czy0126/CZY/hardware/dcx_mech/placement_top.png

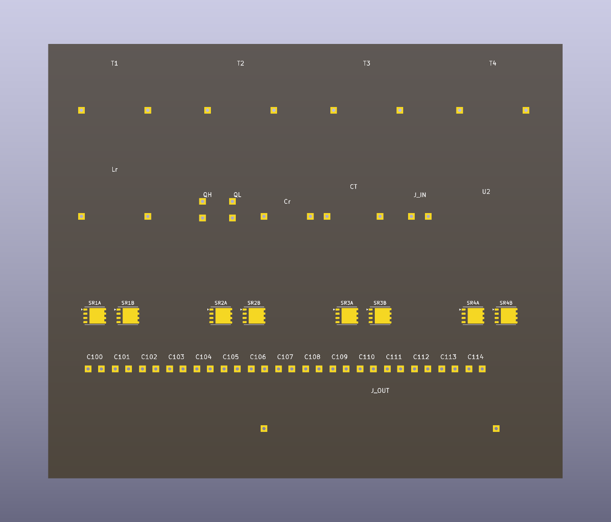
hardware/dcx_mech/placement_top.png
