czy0126/CZY/docs/D1_EXECUTION_KIT/README.md

# D1 可执行工程参考包（更新至 2026-11-05）

**对象**：CZY 48 V→约 2 V、24:1 LLC-DCX、100/120 A 高输出实验样机。**设计取舍（2026-11-04更新）**：成本不设上限；D1首样100A级/总高目标≤16mm，D2 120A级/≤16mm，原≤10mm目标转D3优化；器件SOA、绝缘、保护、制造和证据可信度不放松。

> 本目录是工作指南与可填写模板，不是新一轮同义审核。基准 main@79eee331fa5848ebad91e9712e180345d5f57814。现有 83 逻辑位号、61 个占位位号、五磁件物理脚号/DOT 待签、原生 GUI ERC 与有网络的主 PCB 缺失；制造闸门 NOT_FOR_FAB。仿真不是硬件连续额定。

## 2026-11-05 D0 新增保护原理图实物封装与模拟安全复核

[33 原生保护验证板封装、低电流钳位与十路门极检测评审](33_D0原生保护验证板复核与停工准则.md)：直接修复TL431LP在KiCad生成器、原生原理图、BOM与netlist中的TO-92/SOT-23封装不一致；新增 `tools/test_d0_oem_package_mapping.py` 回归。`tools/d0_analog_preflight.py --require-qualified` 对已知门极SUM残压漏检、BZX84C3V0低电流Zener标称不适用、快速通道灵敏度及模拟时序进行**量化否决**。ERC全绿不等于实物电气过关；D0仍无真正PCB，D1仍NOT_FOR_FAB。

## 五磁件24物理端子供应商回件自动检查（新增工具）

[30 磁件真实端子/DOT/厂图回件校验](30_磁件24端子回件自动审核.md)：新增 `tools/magnetic_vendor_map_audit.py`、可生成的24行完整回件模板、重复/漏报焊盘与极性反例测试；强制保留原生CAD已有黄金网与模型DOT，不得用逻辑端子名代替厂家实体脚号。报告绑定回件与合同的 SHA-256（`input_sha256` / `contract.sha256`），**合同一改旧报告即失效，必须重跑**；审核前还会从原生黄金网表与极性记录重建合同，`golden_net`/`polarity` 对不上即拒绝（`INVALID_PACKET`），报告另存 `contract_sources` 供复核。**自动校验永不等于实际焊盘/CT相位签核或投板许可。**

## D0 十路真实波形采集与自动验收（新增工具）

[29 D0 十路门极同步波形证据验收](29_D0十路门极同步波形证据验收.md)：新增 `tools/d0_gate_capture_audit.py`（严格12列、10路VGS独立检查、采样分辨率、故障后保持/再导通、限值和仪器证据、SHA-256报告），以及错误波形回归测试、待填写限值和列头模板。**只验证输入CSV的数字波形，不证明波形源自实物；制造闸门与器件SOA不会自动升级。** 直接支持 [Issue #36](https://github.com/czy0126/CZY/issues/36) 后续台架工作。

[31 D0 多仪器同步对齐与重采样](31_D0多仪器同步对齐与重采样.md)：新增 `tools/d0_scope_sync_align.py`，把多台示波器的记录按各自触发沿搬到共同时间轴，强制重采样网格不细于最粗原始间隔、不外推、不猜测时轴偏差，输出第29章可直接消费的12列CSV。**只检查声明的同步预算是否被采样分辨率支持；物理同时性、探头skew与波形来源仍为 false。** 模板见 [d0_scope_sync_manifest_TEMPLATE.json](templates/d0_scope_sync_manifest_TEMPLATE.json)。

[32 D0 采集证据链绑定](32_D0采集证据链绑定.md)：新增 `tools/d0_evidence_chain.py`，校验对齐报告、12列CSV、限值配置与门极审计报告确为同一次采集：逐项比对 SHA-256 与 `case_id`，复核网格是否满足审计分辨率/前窗/后窗，检查触发阈值与原点样点不落入迟滞带，并用同一 CSV+配置**重新运行审计**要求提交报告逐项可复现。**链一致不等于波形真实、不等于物理同时性，也不等于硬件通过；`CHAIN_CONSISTENT_AUDIT_REJECTED` 是物理发现而非工具故障。**

## 2026-11-04 本轮程序修补与 D0 实物交付

[28 十路保护引脚/网络反例回归、阶段审批闸门与文献驱动的实物计划](28_保护映射复核与下一轮真实交付.md)：修复交换 SR 缓冲通道、复用输出网、错误芯片管脚及分阶段制造批准伪通过；附可执行的 D0 控制板、ELP38/43 询样、原生 PCB 与100A阶梯实测的验收卡。**这是自动化审计增强，并非硬件已完成。**

## 2026-11-04 活跃阶段目标与不重复阻塞决策

[27 分阶段目标、16mm磁件路线与止损](27_分阶段目标_磁件宽高替代与止损.md)：D0十路控制保护，D1 48V/100A级/≤16mm，D2 120A级/≤16mm，D3 ≤10mm薄型优化。ELP38裸芯最大12.35mm，三匝保守B初筛0.232T，剩余3.65mm**不等于完整装配合格**。Bage配对已运行满320µs，停止反复数值扫参，转到实际保护与磁件询样；制造仍NOT_FOR_FAB。

## 2026-11-04 B组2fF软轨配对首次跑满320µs

[26 2fF软轨配对跑满320µs与v3_3逐位比对](26_B组2fF软轨配对跑满320us与逐位比对.md)：控制与候选都保存320µs、故障前均值差0.000000mV；0–220µs七项指标对v3_3逐位相同，候选在220–320µs仍逐位相同、控制首个差异在228.884µs。候选1.8V比较器早触发29.6725µs，Ipri峰−54.78%、SR正向峰−54.37%、I²t−95.44%。**四条判据中三条满足，独立器件SOA审查未完成，整体不通过，仍NOT_FOR_FAB。**

## 2026-11-03 自动生成的61位号原生CAD ECO施工表

[14 原生CAD操作与封装替换任务](14_原生CAD逐位号ECO执行表.md) · [61位号ECO CSV](templates/vendor_native_cad_eco_61.csv)：依据真实原生网表、临时库、候选料号生成，明确R3的0603→2512、R1/R2功能核对、C5/REG/VDD电容改值和10项特殊物料。脚本 `python tools/vendor_native_cad_eco.py --check` 检查清单与当前资料同步；**全为 NOT_APPLIED，绝非已完成EDA修改**。

## 2026-11-04 B组最新1/2/5fF实跑证据决策

[23 三档B组配对全部不完整，改验证Bage单项机理](23_PROT03三档数值收敛最新审核与下一步.md)：2fF不是未做而是控制264.515µs在Bage求解失败，5fF也仅235.890µs，且效果非单调。机器可读决策源于实际提交的JSON，不再诱导重复上次失败的扫参。

## 2026-11-04 精确定位B组数值停算的行为模型硬轨

[22 一次只修一个Bage硬轨的四份成对诊断deck](22_B组Bage行为源收敛修复与两组配对试验.md)：保留原v3_3历史，新增v3_4单行Bage 9.9–10V软轨与1/2fF的B两侧配对源，生成器硬性约束修改范围。运行脚本默认dry-run。**该实验已于2026-11-04实跑2fF，结果见[第26章](26_B组2fF软轨配对跑满320us与逐位比对.md)。**

## 2026-11-03 50V保护效果与试验优先级审计

[21 A组严格配对零峰值改善、B组下一步必须2fF严格配对](21_50V保护A组无峰值收益与B组优先验证.md)。A组实际320µs/0mV记录显示原边和SR峰值都是0%下降，只减少0.677%的SR正向I²t；B组1fF早触发有潜力，但对照仍是253–255µs的部分记录，严禁直接宣告通过。新增脚本从承诺的JSON自动给出下一步B2fF实跑命令，并恒不放开硬件制造闸门。

## 2026-11-03 磁芯厚度与磁通约束实际排查

[20 TDK五套平面磁芯原厂高度与Lr磁通双约束筛查](20_低矮磁件Lr原厂尺寸磁通双约束审核.md)：ELP32+I32芯体9.5mm但Amin128mm²故障B超0.248T；面积满足的ELP38/ELP43裸芯厚度12.05/13.60mm已超10mm整机目标；标准五套无一同时满足，须定制低矮磁件并取得100℃L(I)、整机叠高及24实物端子。自动检查`python tools/lr_core_geometry_screen.py --check`。

## 2026-11-03 第二轮P0方案完善：SR原生DIS、真实延迟、成对收敛与上电硬保护

[17 NCP4306八只原生DIS控制器替代](17_NCP4306原生停机SR替代及时序计算.md)：onsemi 2026 Rev9官方引脚TRIG/DIS高有效、最大16.5ns传递但最多80ns触发消隐；8路实际SR门极/漏极/回流真实网络映射以及8/10/12V×25/50/100/200pF关断边沿粗估，失压默认高必须有本地10k上拉。*替代* UCC24624，不是额外并联，未画CAD。

[18 50V 12个严格配对收敛诊断deck](18_50V成对数值收敛扫参与执行.md)：2fF、5fF、10fF数值选项在候选/控制中完全一致，使用`run_d1_50v_matched_cases.ps1 -Variant shunt_2f`执行（明确UNRUN）。`--check`核对只改`.options`。

[19 上电硬保护与软启动后快速保护双层状态机](19_冷启动永不屏蔽硬过流与自动化测试.md)：从厂家找到带POR的TI TLV3211DCKR比较器候选，完整11条件故障真值表、4096组合单元测试。硬故障/CT失效/偏置失压必须无条件关闭全部10门；实际比较器、阈值、锁存、PCB仍未实施。

## 2026-11-03 P0 真实保护接口与50V仿真执行包

[15 十路独立故障关断接口及验收卡](15_十路硬件故障关断接口及实施验收.md)：4片TI UCC27524ADR作为8只SR的带EN缓冲方案候选；现有R8从VCC12常上拉RUN会阻止真正失效安全，增加18条故障注入、现有8个门极逐针和默认低判定。**未实际画入原生EDA**。

[16 50V严格配对批量复现和保全](16_50V严格配对故障实跑与归档.md)：`pwsh -File tools/run_d1_50v_matched_cases.ps1`先干跑；安装ADI LTspice后带`-Execute -RunId`再生成原RAW/LOG/SHA。此前匹配控制停在250–255µs，现有结果不满足完整窗口，不能当作已通过。旧批处理另补`-ascii`与ASCII解码器格式一致。

## 2026-11-03 原生功能网表的定量自动复核

发现 **R1/R2 在旧BOM与原生网表的RT/DT位号对应互换**；原生 `U1.1` 为DT、`U1.2` 为RT，因此已按原生连接把`R1`重新定义为5.36kΩ DT、`R2`为976Ω RT，更新61行候选、RFQ和两项测试，加入制造闸门 `controller_rt_dt_roles_match_native_netlist` 防止错误值经纯引脚检查漏过。原生可编辑工程仍未人工GUI审核，保持NOT_FOR_FAB。

## 2026-11-03 专项修复：R3额定功率与耐脉冲选型

旧0805 0.125W方案在48V/120A故障前已消耗0.1257W，**不能再列为可用R3**。新提出 [Vishay CRCW251210R0FKEHHP 1.5W/2512](13_候选器件额定与原厂证据复核.md)，原厂系列PDF和准确订货号已有证据。原候选矩阵51个位号的覆盖数不变，**但R3必须修改封装，故障脉冲、启动、温度与原生PCB未签核**。

启动脉冲已由 `tools/startup_burden_pulse.py` 从冷启动 `I(Lr)` 按 CT 变比推导（峰值 0.579W @ 1.287ms、能量 0.7786mJ，是故障脉冲能量的 6.35 倍；对 1.5W 候选 0.386×P70、超 P70 0 µs）。**这是推导量**：冷启动 deck 不保存负载节点，直接确认仍需一条存 `V(ocd)`/`V(ocm)` 的冷启动 raw，重复故障与板温也未测。

## 2026-11-03 增补：逐器件可核验原厂资源

已提交 [11 原厂标准阻容 51/61 候选](11_原厂实证与逐位号候选.md)（含 15 个准确 MPN、[全 61 位号逐项表](templates/vendor_candidate_matrix_61.csv)、可复现检查脚本）和 [12 高裕量 SR/磁芯替代与官方模型索引](12_高裕量原厂替代与模型下载.md)。**51 个已有原厂料号，只代表候选资料齐全，不代表实测、电路/封装、采购或投板签核。**

```bash
python tools/verify_vendor_candidate_matrix.py --check
python -m pytest tools/test_verify_vendor_candidate_matrix.py -q
```

## 2026-11-03 增补二：原厂 SOA/Zth 数字化与八只 SR 筛查

[11](11_原厂实证与逐位号候选.md) 的第 3 条已从"待确认"推进到"已确认到什么程度"：
`tools/vendor_soa.py` 把 `references/datasheets/bsc010n04ls6.pdf` 第 6 页的 6 条 SOA 曲线和单脉冲 Zth
从矢量数据里读出来（`design/v3/power_priority/vendor_soa_digitized.json`），
`tools/sr_soa_screen.py` 再在三条故障 raw 上逐管比对（`sr_soa_screen.json`）。

结论分三份，不能合并：**第一象限**逐点占用率 ≤6.52 %；**第三象限**是故障应力主体，而原厂图只画
`VDS>0`，**没有判据**，只能记录实测 −292.61 A/15.54 V（48 V）与 −303.50 A/15.46 V（50 V cshunt）；
**热**按管芯探针 190.7/214.2 W 经 Zth 卷积得 1.84–1.88 K 温升，但模型 TJ 钉在 25 °C、无热反馈。
所以本包**仍然不写"已通过器件 SOA"**：缺的是第三象限的厂家判据与逐器件热签核。

## 最短启动路线

1. **先跑检查**（Windows，仓库根目录）：
       python -m pip install -r requirements.txt
       python tools/ci_check.py
       python tools/d1_fabrication_gate.py
       python tools/d1_fabrication_gate.py --require-release
   最后一行当前**应返回非零**，表示不可投板，不是软件 CI 失败。禁止手工把 JSON 的 release_approved 改成 true。
2. **按任务领取输出**：已经存在的 hardware/dcx_main/d1_delivery_tasks.csv 是正式任务卡；此包提供判据/外部资料/数据回填。优先 P0：主桥+八 SR 独立故障关断、真实五磁件端子图、61 个占位件、GUI ERC、有网 PCB。
3. **先拿厂家真数据**：不要拿论文参考 BOM 充作选定料号。将 templates/supplier_reply.csv 和 templates/magnetic_terminal_map.csv 发给供应商。任何未知项填写 PENDING，不允许靠逻辑网名补造真实焊盘。
4. **当天做出可审证据**：每项成果必须有原文件、同版本哈希、可复现步骤、审核人、通过/失败判据。把故障和电压/电流证据写入 templates/simulation_run_register.csv 复制件，原始 RAW 不进入 Git，需妥善存档并记录 SHA256。
5. **以实际门槛流转**：A0 规格→A1 有效原生原理图→A2 带网 PCB/DFM→A3 限能磁件和保护首样→A4 主样机→A5 额定及冷却；允许 RFQ/PCB 规划并行，绝不能绕过 P0 做整机上电。

## 目录导航（按角色，不重复看全部旧审核）

| 最先需要的人 | 第一份文件 | 具体完成物 |
|---|---|---|
| 项目负责人/文献检索 | 01_权威资料与文献索引.md | 证据等级与原厂 URL、论文参数的适用边界 |
| EDA 画板 | 02_嘉立创原生CAD闭环.md | 原生可编辑项目→全网表→ERC→PCB 同步→DRC/投板包 |
| 采购/器件 | 03_器件选型与询样.md | 61 占位签核、原厂规格、供货/尺寸/容差 |
| 磁件/机械 | 04_磁件端子及低矮结构.md | 24 逻辑端→厂家真实脚号、DOT、Z 轴公差链 |
| 电路/保护 | 05_独立硬件故障关断.md | 主桥+8SR fail-low、启动屏蔽/复位与 SOA |
| 仿真 | 06_LTspice批量复现.md | 同窗同源、完整 RAW 与“未收敛”否决规则 |
| 数值/效率 | 07_能量守恒与损耗.md | 统一能量预算、互感储能、可追溯步长 |
| 台架/实验 | 08_首样上电与数据记录.md | 磁件首件、控制验证、限能故障和热稳态矩阵 |
| 架构优化 | 09_性能优先架构对照.md | 现有 V3、平面磁件、堆叠式供电的相同口径 A/B |
| 每天的负责人 | templates/*.csv | 直接填写实际证据，不修改原始模板 |

## 一次交付应当包含

- 实物设计的 EDA 原文件和原生导出网表；每个未核实脚号均在审表显示 PENDING。
- BOM 的唯一 MPN、原厂 PDF 版本/日期、真实焊盘与 3D 高度、额定参数；未获实测或资料的值不能标 VERIFIED。
- 单次试验记录：原 deck SHA、RAW SHA/外部存放位置、log、分析脚本、窗口、求解器、峰值、失压/恢复、审核结论。
- 风险和更改：ECO 说明变比/电容 ESR/Lr 变化对其他工件的影响，不只改一份 CSV。
- **不把文献 40V→1V 或 500A 作为当前 48V→2V 的已达成指标。**

## 当前绝对不能写的结论

- “100/120 A 连续通过”；“投板就绪”；“完整 50 V 基座故障波形”；“已通过器件 SOA”。
- “0.2 W 能量账本闭合”；“10 mm 机械/冷板已签核”；“61 个占位有真实料号”。
- “理想 0.05Ω 门极钳位就是能够量产的关断方式”。

### 文件来源

本目录链接资料均为原厂/论文入口，不复制受版权保护的完整论文、手册。文献与手册规格需按真实已采购料号和修订版二次核对。工程数值来自 CZY 当时受控记录，不是外部事实。

## 一键生成完整 RFQ 请求清单

执行 `python tools/d1_reference_kit.py --check` 检查种子文件是否与当前原生设计记录同步；需要重新生成时使用 `--write`。 [61 位号物料需求](templates/supplier_seed_61.csv) 和 [五磁件 24 脚需求](templates/magnetic_terminal_seed_24.csv) 均自动从现有 JSON 生成，并保留 PENDING；它们是对供应商的请求，不是供应商已提供的证据。真实回件请另存，不要修改此自动生成种子表。
