czy0126/CZY/design/v3/当前候选基线_2026-11-01.md

# 当前候选基线（v3）— 2026-11-01

状态：**单一当前候选，未投板、未硬件验证。** 本文件冻结"现在按什么数字设计"，
并把每个数字的证据等级写清楚；它不是投板批准，也不能替代首样测试。

## 0 证据等级（全文只用这四类）

| 等级 | 含义 | 本基线中的典型来源 |
|---|---|---|
| `SIM_MEASURED` | 同一 deck、同一窗口的 raw 积分/测量 | `energy_ledger_100a.json`、`operating_point_100a.json` |
| `ENG_ESTIMATE` | 由模型/手册推导，未用 raw 签核 | 磁件损耗、热阻矩阵、Cout 选型 |
| `HW_MEASURED` | 首样实测 | **目前 0 条**；上电检查表与首件记录都是空白模板 |
| `UNVERIFIED` | 已知假设，尚无证据 | ESL、瞬态、接点电阻、磁芯热阻 |

规则：任何对外引用必须带等级；`ENG_ESTIMATE` 不得写成 `SIM_MEASURED`，
`HW_MEASURED` 为空时不得宣称"已验证额定"。

## 1 冻结量

| 项目 | 冻结值 | 等级 | 证据 |
|---|---|---|---|
| 拓扑/变比 | 48 V → 2 V，24:1，四只 3:1:1，原边串联 | 设计定义 | `design/v3/magnetics/magnetics_design.json` |
| 连续输入包络 | 46 / 48 / 50 V（100 A 点） | `SIM_MEASURED` | `output_100a`：1.803 / 1.886 / 1.970 V |
| 54 V 边界 | 仅记录 5 min，不作连续额定 | `UNVERIFIED` | `首样验证与额定值判定_2026-10-31.md` §3 |
| 空载输出 | 46/48/50 V → 1.917 / 2.000 / 2.083 V（= Vin/24） | `ENG_ESTIMATE` | 固定比，无闭环 |
| 100 A 输出电压 | 1.887 V @ 48 V，等效 Rout 1.135 mΩ | `SIM_MEASURED` | `operating_point_100a.json:vout_avg_v`；`magnetics_design.json:r_out_equiv_ohm` |
| 200 W 与 100 A 同时成立 | 需 Vin ≥ 50.72 V | `ENG_ESTIMATE` | `magnetics_design.json:vin_for_200w` |
| 输出纹波（冻结 4 mF deck） | **22 周期实测 49.7 mVpp** @100 A/48 V；10 µs 窗口只有 38.3 mVpp（漏掉慢包络，不得引用） | `SIM_MEASURED` | `operating_point_100a.json:vout_pp_mv`；ledger 日志 `VOUT_RIP` |
| 输出纹波（冻结设计 7.05 mF + 0.92 µH） | **22 周期实测 42.8 mVpp**，100.1 A；设计目标 ≤50 mVpp ⇒ 余量 **7.2 mV**。这才是与本表冻结 Cout 同一配置的纹波 | `SIM_MEASURED` | `operating_point_100a_cout7m.json:vout_pp_mv`、`iout_from_v_a` |
| 输出纹波（未配平 1.0 µH 外置 + 7.05 mF） | 22 周期实测 36.1 mVpp，99.7 A；L 越大纹波越小，这是灵敏度点，不是推荐工作点 | `SIM_MEASURED` | `operating_point_100a_phys.json` |
| 负载瞬态 | **未定义、未仿真**（无 ±ΔV/恢复时间判据） | `UNVERIFIED` | — |
| Cout 数量/料号 | 15 × KEMET A720V477M2R5APE003（470 µF/3 mΩ/2.5 V/1.9 mm），7.05 mF，0.2 mΩ | `ENG_ESTIMATE`（检索摘要，未读 datasheet） | `cout_bank.json` |
| Cout 主导约束 | 容量 9 只 / RMS 5 只 / ESR 15 只 ⇒ 由 ESR 决定 | `ENG_ESTIMATE` | 同上 |
| Cout ESR 口径 | 0.2 mΩ 是模型运行值，**不是规格**；按 0.1 mΩ 要 30 只 | 设计决定 | `cout_bank.json:caveats` |
| Cout ESL | **未建模、未选型** | `UNVERIFIED` | — |
| Lr 口径 | **1 µH 是折算总感**（外置 + 变压器漏感）；deck 的 `LR_TOTAL=.92u` 是外置部分，加模型漏感 0.08 µH = 1.00 µH 总感。首件漏感实测后按 `L_ext = 1.00 µH − L_meas` 配平 | 设计定义 + `ENG_ESTIMATE` | `lr_design.json:tank`；`test_lr_design.py` 对回 deck 的 K/LP |
| Lr 选型 | 3 匝（fast/slow OC 都过），气隙 1.444 mm，Isat 120.9 A；物理 deck 实测后 3 匝成为唯一可行，见下面"Lr 饱和结论" | `ENG_ESTIMATE` | `lr_design.json` |
| 谐振腔调谐 | 总感 1.00 µH × 620 nF ⇒ 202.1 kHz，高于 200.6 kHz 时钟 0.75 %；若外置件按名义 1.0 µH 进场（总感 1.08 µH）则 194.6 kHz，**低于时钟** ⇒ 必须配平 | 设计规则（项目自选） | `lr_design.json:tank` |
| Lr 稳态峰值 | 13.88 A（不是 Lr 的电流规格） | `SIM_MEASURED` | `i(Lr)` 窗口峰值的绝对值 |
| 冷启动峰值（冻结 deck：0.92 µH / 4 mF） | 36.07 A | `SIM_MEASURED` | `lr_design.json:peaks_a` |
| 冷启动峰值（物理配置：1.0 µH / 7.05 mF） | 22.53 A | `SIM_MEASURED` | `lr_design.json:physical_peaks` |
| 故障峰值（冻结 deck） | 65 A（OC 13 µs）/ 73.68 A（OC 51.3 µs），线性模型 | `SIM_MEASURED` + 模型限制 | 同上；饱和后 di/dt 更高 |
| 故障峰值（物理配置实测，0–8 ms 全程） | **84.02 A** @外置 1.0 µH（OC 5.5998 ms 动作）；配平窗口另一端 **104.17 A** @外置 0.875 µH（OC 5.5963 ms） | `SIM_MEASURED` + 线性模型 | `lr_design.json:physical_peaks`；`cold_oc_phys.log`、`cold_oc_lrmin.log` |
| Lr 饱和结论 | 2 匝在 84.02 / 104.17 A 下是 0.323 T / 0.351 T，**都越过 Bsat（0.310 T）**，Isat 80.6 A 被超过 ⇒ 不可行；3 匝 0.215 T / 0.234 T ≤ 0.9·Bsat（0.279 T）⇒ 唯一可行 | `SIM_MEASURED`（电流）+ `ENG_ESTIMATE`（判据） | 同上 |
| 饱和判据 | `B = L·I/(N·Ae) ≤ 0.9·Bsat`，用故障峰值 | 设计规则 | `lr_design.json` |
| 输出路径预算 | 设计基准 0.15 mΩ；铜排 34.5 µΩ 后每处接点 ≤57.8 µΩ | `ENG_ESTIMATE` | `connector_budget.json` |
| 接点电阻 | 50 µΩ 只是占位假设；首件四线法实测 | `UNVERIFIED` | `connector_budget.json` |
| 磁件高度（0.5 mm 沉槽） | 标称 9.10 mm，最坏 9.44 mm，余量 0.56 mm | `ENG_ESTIMATE`（用胶/标签最大厚度） | `magnetics_design.json:height` |
| 磁件高度（平铺） | 最坏 9.94 mm，余量 0.06 mm，仅样机 | `ENG_ESTIMATE`（同上，用胶/标签最大厚度） | 同上 |
| 加 0.5 mm 压板 | 最坏 10.44 mm，**超 10 mm，不可用** | `ENG_ESTIMATE`（同上） | 同上 |
| 冷板机械边界 | 总高 ≤10 mm；磁件占位 31.75 × 25.4 mm；**板外形/安装孔未冻结** | 设计约束 + `UNVERIFIED` | `磁件设计包_2026-10-31.md` |
| CT 负载 | 10 Ω，`Rd1` 10 kΩ，实测过流门槛 24.2 A | `SIM_MEASURED` | `ct_design.json`、`oc_network_ct10.json` |
| 100 A 模型端口效率 | 94.47 %（188.258/199.283 W）；**deck 不含磁芯损耗**，不含输出路径与偏置 | `SIM_MEASURED` | `energy_ledger_100a.json` |
| 磁芯损耗估计 | 0.353 W（N97，B²f² 上界，4 只合计） | `ENG_ESTIMATE` | `magnetics_design.json:loss_at_100a/p_core_w` |
| 100 A 变流器效率（含磁芯） | 93.06 %（14.037 W 损耗，仍不含输出路径/偏置） | `ENG_ESTIMATE` | `magnetics_design.json:efficiency_at_converter_pct` |
| 公布效率口径 | 92.33 % 含磁芯估计、0.15 mΩ 输出路径与 0.75 W 偏置 | `ENG_ESTIMATE` | `magnetics_design.json:loss_at_100a/efficiency_pct` |
| 100 A 能量账 | Pin−Pout 11.025 W；逐项损耗 11.117 W；残差 −0.091 W | `SIM_MEASURED` | `energy_ledger_100a.json` |
| 100 A 含储能闭合 | 端口 + 驱动 0.205 W − 损耗 − 储能端点差 0.232 W ⇒ 单点读数 −0.118 W（周期平均读数 −0.222 W），效率 94.31 % | `SIM_MEASURED` | 同上 `balance.closure_residual_w`、`efficiency` |
| 闭合的分辨极限 | 单点：单周期残差 sd 5.02 W ⇒ 16 周期标准误 1.26 W，需约 632 个周期；周期平均：sd 1.96 W ⇒ 标准误 0.506 W，需约 96 个周期（本 raw 只有 24 个） | `SIM_MEASURED` | 同上 `balance.resolution` |
| 100 A 含储能闭合（相位对齐 133 周期） | 单点 **+0.384 W**、周期平均 **+0.326 W**；周期平均标准误 0.157 W ⇒ **这个窗口能分辨 0.2 W，而读数在目标外** | `SIM_MEASURED` | `energy_ledger_100a_phase_aligned.json:balance`，见 §2.3 |
| 时钟/谐振腔相位 | 200.622 kHz vs 202.131 kHz，拍频 1509 Hz；首个相位对齐窗口 133 个门极周期 = 662.9 µs | 设计规则（工具计算） | `balance.resolution.phase_alignment` |
| 5 ns vs 2 ns 步长对照 | 损耗 11.117→11.141 W（+0.22 %）收敛；闭合残差 −0.118→+0.404 W **不收敛**；`V(out)` 端点差 7.6 mV | `SIM_MEASURED` | 同上 `step_check` |

## 2 100 A 能量账的读法（Issue #3 与 #6）

- 窗口：37.52–117.36 µs（raw 轴；显示轴 +880 µs），16 个门极周期，5 ns 最大步长。
- `Pin(source)` 取 48 V × mean(I(Rin))；`Pout = mean(Vout²/RL)`，不是 `Vout_avg²/RL`。
- SR 沟道+体二极管：pair 1 实测 1.835 W/对，×4 = 7.340 W（模型四组对称，硬件未必）。
- CT 整流桥 0.097 W + 负载电阻 0.089 W，合计 0.186 W，是此前缺的最后一项。
- **驱动能量在端口之外**：SR 门极 B 源不取 `Vreg`（I(Vreg)≈0），理想驱动输出约 0.205 W；
  真实偏置必须提供它，但模型没有计。`Vaux` 同理约 0.0002 W。
- **储能端点差 0.232 W 单独报告**，不并入上面那个 −0.091 W 残差；把它计入得到的是
  "含储能闭合残差" −0.118 W。两个数不是同一个量，引用时必须写明是哪一个。

### 2.1 三个效率口径必须分开引用（Issue #6）

| 口径 | 数值 | 包含什么 | 等级 |
|---|---|---|---|
| 端口电气效率 `port_pct` | 94.47 % | 只含 deck 元素；变压器没有磁芯损耗元件 | `SIM_MEASURED` |
| 储能校正诊断比值（**不是效率**） | 94.31 % | 基于端口、驱动、储能端点构造的诊断值；守恒未收敛，不代表设备效率 | `SIM_MEASURED`（仅诊断） |
| 工程损耗预算 | 93.06 %（14.037 W，**已包含 0.75 W 偏置估算**）；92.33 %（再计 0.15 mΩ 输出路径） | 磁件铜损与磁芯损耗、SR、辅助电源等多项独立工程估算；不是从端口效率单独加磁芯损耗得到 | `ENG_ESTIMATE` |

第二行**仅为包含储能项的守恒诊断**，由于原始数据只有 16 周期、窗口端点和步长未收敛，
当前状态为 `NOT_CLOSED`，不得称为“完整守恒验证”，也不得将其当作硬件效率。
唯一有明确端口定义的仿真效率是第一行 94.47 %，但它也不是经硬件验证的效率。

### 2.2 闭合残差没有达到 0.2 W 的分辨率（Issue #6，未关闭）

- 16 周期的含储能闭合残差，**单点读数**是 −0.118 W，落在 0.2 W 目标内——
  但**周期平均读数**是 **−0.222 W，已经超出目标**。两个读数差 0.10 W，说明 −0.118 W 里
  有相当一部分是"恰好停在这个采样点"的运气，状态因此仍是 `NOT_CLOSED`。
  两个读数不一致时，`closure_reason` 会写明是不一致，而不是挑一个好看的引用。
- 单周期残差的标准差是 5.02 W，16 周期的标准误 1.26 W；要把标准误压到 0.2 W
  需要约 632 个周期，而本 raw 只有 24 个门极周期。16 周期的均值落在目标内，
  是正负相消的结果，不是分辨率。
- 原因是时钟与谐振腔**不可通约**：200.622 kHz 对 202.131 kHz，拍频 1509 Hz。
  最短的相位对齐窗口是 **133 个门极周期 = 662.9 µs**（相位误差 <0.1°），
  能量账用的 16 个周期只是它的 12 %。
- 5 ns / 2 ns 对照：损耗 11.117→11.141 W（+0.22 %），而 `V(out)` 在窗口末端的采样值
  差 7.6 mV（4 mF × 1.87 V × 7.6 mV ≈ 57 µJ，折算到 44.9 µs 窗口约 1.3 W），
  闭合残差因此由 −0.118 W 翻到 **+0.404 W，超出目标**。
  **原先这条写的是"问题在端点采样、不在积分"，那是错的**——见 [[#2.4]]：
  端口积分本身在 5 ns 与 2 ns 之间就动了 0.39 W，比损耗清单的 0.02 W 大 16 倍。
- 结论：`closure_status = NOT_CLOSED`。0.2 W 目标不动，**不得为了让状态变绿而放宽目标**。
- **"周期平均端点"已实现进工具**（`averaged_storage_terms()`，见 `tools/energy_ledger_100a.py`）：
  每个储能项在端点所在的那个门极周期内取梯形平均。一个门极周期 4.9845 µs 与一个谐振周期
  4.9473 µs 只差 0.75 %，所以谐振频率分量被 `|sinc(π·f_tank/f_gate)| ≈ 0.0075` 压掉约 130 倍。
  它把单周期残差的 sd 从 5.02 W 降到 **1.96 W**（16 周期窗口、15 个可用点）。
- 于是两件事都变了：16 周期窗口上两个读数一个在目标内、一个在目标外（见上）；
  而分辨 0.2 W 所需的周期数从 632 降到 **96**——相位对齐窗口 133 个周期就够。
  实跑结果是 sd 1.803 W、标准误 **0.157 W**（132 个点），比按 16 周期外推的
  0.171 W 还好一点。这个窗口已经跑过，见 [[#2.3]]。
- 不更新 `thermal_precheck.json` 的 7.338 W：它与本账的 7.340 W 差 0.03 %，
  两者都来自同一 deck；改数字只会引入两套口径。也不改 `magnetics_design.json`
  的 92.33 %，因为那是含磁芯估计、输出路径与偏置的公布口径，与模型端口效率不是同一个量。
- **94.47 % 与 93.06 % 采用不同边界**：前者为当前 deck 的电气端口比值，不含磁芯损耗；
  后者是 14.037 W 的工程损耗预算，除 0.353 W 磁芯损耗外，还包含重新估算的铜损与
  **0.75 W 偏置功率**等项。两者差额不能仅用 0.353 W 磁芯解释，也不能把工程估算当成同一 raw 的直接测量。

### 2.3 相位对齐窗口已跑：残差在目标外（Issue #6）

> **先读 §2.4。** 本节的"分辨得了 0.2 W"指**周期间的随机误差**；步长带来的系统性差异
> 比它大（16 周期窗口上 5 ns 与 2 ns 相差 0.38 W）。本节所有数字都是 **5 ns** 跑出来的。

`ledger_aligned` 变体（`tools/make_physical_decks.py`，只把 `.tran` 的 **Tstop** 从
1000 µs 改到 1550 µs，880 µs 起始点不动）已跑完：LTspice 404 s，raw 2.44 GB。
账本窗口是 raw 轴 2.63–665.61 µs（显示轴 +880 µs），**133 个门极周期 = 663.0 µs**，
相位误差约 0.14°。

| 量 | 133 周期（对齐窗口） | 16 周期（§2.2） |
|---|---|---|
| `Pin(source)` | 199.783 W | 199.283 W |
| `Pout` | 188.894 W | 188.258 W |
| `Pin − Pout` | 10.889 W | 11.025 W |
| 列示损耗合计 | 10.731 W | 11.117 W |
| 简单残差 | **+0.157 W** | −0.091 W |
| 储能端点差 | −0.021 W | +0.232 W |
| 含储能闭合残差（单点） | **+0.384 W** | −0.118 W |
| 含储能闭合残差（周期平均） | **+0.326 W** | −0.222 W |
| 周期平均标准误 | **0.157 W（可分辨 0.2 W）** | 0.506 W（不可分辨） |

- **这次不是"分辨不了随机误差"，是"测到了、而且超了"——但只对 5 ns 成立。**
  周期平均读数 +0.326 W，标准误 0.157 W，分辨 0.2 W 只需 82 个周期；单点读数 +0.384 W
  的标准误是 0.334 W（需 372 个周期），所以两个读数都指向目标外。
  这是相对"周期间散布"的分辨率；**步长没有计入**，见 [[#2.4]]。
- **短窗口的读数由停在哪一相决定。** 同一条 raw 上三种窗口：8 个周期 +0.999 W、
  12 个周期 +0.368 W、133 个周期 +0.384 W（单点）。端点储能差在 8 周期时是
  −0.315 W、12 周期时 +0.279 W、133 周期时 −0.021 W——µs 尺度的摆动就是全部原因。
- **16 周期窗口把损耗算高了 0.386 W（3.5 %）**：11.117 W 对 10.731 W。两者是同一 deck、
  同一区间附近的不同窗口，所以 §1 里 11.117 W 那一行应读作"16 周期窗口值"，
  不能当作稳态损耗。
- **CT 不再"补齐缺口"**：`Pin − Pout − 非 CT 损耗` 在这个窗口是 **0.344 W**，
  而 CT 整流桥 + 负载只有 0.186 W；16 周期窗口上同一量是 0.094 W，所以当时看起来
  CT 正好是最后一块。这是物理结果、随窗口变，已从 `checks` 移到
  `results.ct_terms_account_for_the_gap_before_ct`，并把差值写进 `gap_before_ct_w`。
  **这不是放宽闸门**：`checks` 只留报告不变量（结构、定义、状态与结果的一致性），
  物理量一律进 `results`，否则一次诚实的"没有闭合"会读成"工具坏了"。
- 结论：`closure_status` 仍是 `NOT_CLOSED`，但理由从"窗口分辨不了"变成
  **"窗口分辨得了，残差 +0.33 W 在目标外"**。0.2 W 目标不动；要闭合，
  要么找到这 0.33 W 的去处（模型里未建模的损耗），要么承认模型边界不完整。
- 复算：
  ```bash
  /d/ADI/LTspice/LTspice.exe -b -ascii sim/v3/sr_tank_dual_v33_ss_1ms_100a_aligned.cir
  python tools/energy_ledger_100a.py --raw sim/v3/sr_tank_dual_v33_ss_1ms_100a_aligned.raw \
      --periods 133 --no-step-check --json design/v3/stage_f/energy_ledger_100a_phase_aligned.json
  ```
  该 JSON 已纳入 v3 manifest；raw 2.44 GB（十进制，= 2.27 GiB）不入 Git。

### 2.4 步长检验：周期平均没有消掉 5 ns / 2 ns 的差异（Issue #6）

§2.2 的结论曾经是"5 ns / 2 ns 的差异来自端点采样"。周期平均（`averaged_storage_terms()`）
就是为端点采样做的，但它消掉的是**"窗口停在哪一相"**，不是**步长本身**。
同一个 16 周期窗口、同一副 deck，只改 `.tran` 的最大步长（`ledger` 5 ns 对 `ledger2n` 2 ns），
两边都用当前工具重算，周期平均读数如下：

| 量 | 5 ns | 2 ns | Δ |
|---|---|---|---|
| `Pin − Pout` | +11.0254 W | +10.6355 W | **−0.3898 W** |
| 列示损耗合计 | +11.1168 W | +11.1412 W | +0.0244 W |
| 储能速率（单点） | +0.2321 W | −0.7040 W | −0.9361 W |
| 储能速率（周期平均） | +0.3362 W | −0.4580 W | **−0.7941 W** |
| 驱动（端口外） | +0.2053 W | +0.2057 W | +0.0004 W |
| 闭合残差（单点） | −0.1183 W | +0.4040 W | +0.5223 W |
| 闭合残差（周期平均） | −0.2223 W | +0.1580 W | **+0.3803 W** |

- **端口项才是两个大移动量之一**：它移动 0.3898 W，是损耗清单（0.0244 W）的 **16 倍**。
  原先 `step_check.note` 写"端口与损耗是梯形积分、会收敛；储能项不收敛"——这句只对了一半，
  而错的那一半正好是大项。工具现在不再做这个断言，改为把实测的 Δ 写进 `note`。
- 两项大误差部分相消：端口少 0.39 W、周期平均储能多 0.79 W，闭包因此只移动 0.38 W。
  0.38 W 仍是 0.2 W 目标的近两倍。
- **所以 `sem_w` 只描述周期间的随机散布，不是总不确定度。** §2.3 那句"0.157 W 足以分辨
  0.2 W"在只计随机误差时成立；把步长算进去，同一窗口的读数在 5 ns 与 2 ns 之间差 0.38 W。
  引用"分辨得了"时必须同时说明它没有包含步长。
- 两次运行的窗口端点相差 **67.5 ns**（更小的步长落在不同的点上；跨度只差 0.085 %）。
  端点能量差因此摆动约 0.9 W，这是储能项移动的直接来源。
- `step_check` 现在同时比较单点与周期平均两个读数，并把实测 Δ 写进 `note`；
  `tools/test_energy_ledger_100a.py` 锁住"两者必须都在、且移动量都要出现在 note 里"。

### 2.5 对齐窗口也跑了 2 ns：闭合结论站住，损耗清单没站住（Issue #6）

§2.3 的 +0.33 W 是 5 ns 跑出来的，而 §2.4 说明 16 周期窗口上 5 ns / 2 ns 能让闭合残差
移动 0.38 W。所以 `ledger_aligned2n`（只把 `.tran` 步长改成 2 ns，**同一个 133 周期窗口**）
跑完后，必须重新回答"这个残差是不是步长伪影"。答案是**分裂的**：

| 量 | 5 ns | 2 ns | Δ |
|---|---|---|---|
| `Pin − Pout`（端口项） | +10.8888 W | +11.4228 W | **+0.5340 W** |
| 列示损耗合计 | +10.7313 W | +11.3563 W | **+0.6250 W（5.8 %）** |
| 储能速率（单点） | −0.0213 W | −0.0465 W | −0.0252 W |
| 储能速率（周期平均） | +0.0373 W | −0.0418 W | −0.0791 W |
| 闭合残差（单点） | +0.3844 W | +0.3186 W | −0.0658 W |
| **闭合残差（周期平均）** | **+0.3258 W** | **+0.3139 W** | **−0.0119 W** |
| `V(out)` 终点 | 1.872238 V | 1.868846 V | −3.39 mV |

- **闭合结论加强**：两个步长都在 0.2 W 之外（+0.326 / +0.314 W），相差只有 0.012 W。
  所以"133 周期窗口测到约 +0.33 W 的缺口"不是 5 ns 的伪影，可以照原样引用。
  对比 §2.4：**同一次步长比较在 16 周期窗口上移动 0.38 W**——相位对齐把这个敏感性消掉了，
  这正是它存在的理由。
- **但"损耗清单已收敛"不能一般化**。16 周期窗口上它只移动 0.024 W，133 周期窗口上是
  **0.625 W（5.8 %）**。同一对 deck、同一对步长，结论随窗口翻转。原因未测量（需要逐项
  分解 2 ns 的损耗清单才能定位，尚未做）。**所以任何单个损耗项都不应引用得比 0.6 W 更细**，
  效率 94.47 % 的分子分母因此带约 0.3 个百分点的不确定度——这不会推翻 CAD 方向，
  但足以禁止把它写成"已签核效率"。
- 两个大项**同向且接近相消**：端口 +0.534 W、损耗 +0.625 W，闭合只动 −0.012 W。
  换句话说，闭合残差在这一对步长上"稳"，是因为两个误差互相抵消，不是因为每一项都收敛。
  **不能把"闭合稳定"当成"每一项都准"的证据。**
- 复算：
  ```bash
  python tools/energy_ledger_100a.py --raw sim/v3/sr_tank_dual_v33_ss_1ms_100a_aligned.raw \
      --periods 133 --compare-raw sim/v3/sr_tank_dual_v33_ss_1ms_100a_aligned2n.raw \
      --json design/v3/stage_f/energy_ledger_100a_phase_aligned.json
  ```
  两条 raw 分别是 2.44 GB 与 2.25 GB，都不入 Git。

### 2.6 第三步 1 ns 跑完了：没有平台，而且不收敛的**只有 SR 一项**（Issue #6）

§2.5 留了一个"原因未测量"：2 ns 的损耗清单比 5 ns 高 0.625 W，但闭合只动 0.012 W。
补第三段 `ledger_aligned1n`（`aligned2n` 再只改 `.tran` 步长 2n→1n；**876.993 s、3.78 GB**）
后，同一 133 周期窗口的三段是：

| 量 | 5 ns | 2 ns | 1 ns | 第一段 Δ | **第二段 Δ** |
|---|---:|---:|---:|---:|---:|
| `Pin − Pout`（端口项） | +10.8888 W | +11.4228 W | +10.1261 W | +0.5340 W | **−1.2967 W** |
| 列示损耗合计 | +10.7313 W | +11.3563 W | +9.9804 W | +0.6250 W | **−1.3759 W** |
| 其中 `sr_channel_body_x4` | 6.9540 W | 7.5753 W | 6.2047 W | +0.6213 W | **−1.3707 W** |
| 其余 12 项合计 | 3.7773 W | 3.7810 W | 3.7757 W | +0.0037 W | −0.0053 W |
| 储能速率（周期平均） | +0.0373 W | −0.0418 W | +0.0439 W | −0.0791 W | +0.0857 W |
| 闭合残差（单点） | +0.3844 W | +0.3186 W | +0.2947 W | −0.0658 W | −0.0239 W |
| **闭合残差（周期平均）** | **+0.3258 W** | **+0.3139 W** | **+0.3095 W** | **−0.0119 W** | **−0.0044 W** |

- **没有平台，也不该把它叫"常数误差"**。工具自己的判据是"最后一段远小于第一段才是平台"；
  这里的最后一段是前一段的 **2.2 倍，方向还相反**（+0.625 → −1.376 W）。这是**振荡**，
  所以 1 ns 不是"更准的那个值"，也**不能**由三段外推。**唯一可以说的是：损耗清单在这三个步长上
  没有收敛。**
- **不收敛的全部是 SR 一项。**其余 12 项合计在三段之间只动 0.004 W；`sr_channel_body_x4`
  一段就动了 1.371 W，占损耗移动量的 **99.6 %**。§2.5 那句"原因未测量"到此可以写死：
  步长敏感性来自 SR 通道+体二极管这一个积分，不来自整张清单。
- **闭合结论仍然站住，而且比 §2.5 更强**：周期平均 0.3258 / 0.3139 / 0.3095 W，最后一段只动
  0.0044 W，三段都在 0.2 W 之外。**+0.31…+0.33 W 的缺口照原样引用**，
  `results.closure_period_averaged_within_0p2_w` 仍为 `false`。
- **但"闭合稳"依旧靠两个大项相消**，第三段给的是更硬的证据：端口与损耗在第二段里**同向**移动
  约 1.3 W，剩下 0.004 W。所以：
  - **单个损耗项的可引用精度从 0.6 W 放宽到约 1.4 W**——SR 那项是它自身 7.3 W 的 19 %。
    94.47 % 的效率因此只能引到 **±0.3 个百分点**（1.30 W / 199.8 W ≈ 0.65 %，取半），
    写成"已签核效率"仍然不行。**这两个数只覆盖 5/2/1 三点**；加上 0.5 ns 后是
    **2.3 W / ±1 个百分点**（§2.8）。
  - 反过来说，**12 项里有 11 项是收敛的**（|Δ| ≤ 0.034 W）。只有 SR 这一项不能逐位引用，
    别把整张清单一起判死。
- **"能分辨 0.2 W"必须带限定词**：这 133 周期窗口的单点读数 `window_resolves_0p2_w` 是
  `false`（`sem_w` 0.334 W，需 372 周期）；能分辨的是**周期平均**读数（`sem_w` 0.157 W，
  需 82 周期）。§2.3 起的所有闭合引用用的都是后者。
- 1 ns 那一段的 `V(out)` 终点没有记录（`step_check.terms` 只存 a/b 两端），
  所以本表不列该行；不要拿 §2.5 的 1.8688 V 去代。
- 复算：
  ```bash
  python tools/energy_ledger_100a.py --raw sim/v3/sr_tank_dual_v33_ss_1ms_100a_aligned.raw \
      --periods 133 --compare-raw sim/v3/sr_tank_dual_v33_ss_1ms_100a_aligned2n.raw \
      --also-raw sim/v3/sr_tank_dual_v33_ss_1ms_100a_aligned1n.raw \
      --json design/v3/stage_f/energy_ledger_100a_phase_aligned.json
  ```
  三条 raw 分别是 2.44 GB / 2.25 GB / 3.78 GB，都不入 Git。

> **本条"闭合稳定"只对 5/2/1 三点成立**：第四步 0.5 ns 把它移动了 0.214 W，见 §2.8。
> 单独引用本节的 0.0044 W 会读成一个并不存在的平台。

### 2.7 SR 电流/损耗的量纲、步长与外部驱动功率专项排查（Issue #6）

§2.6 把"不收敛"定位到 `sr_channel_body_x4` 一个积分，但没回答三件事：这个积分的量纲和符号对不对、
它内部到底是哪一段在动、以及闭合式里的外部驱动功率 `drv` 与损耗清单是否同一个边界。
`tools/sr_loss_audit.py` 把三者都测了（`design/v3/stage_f/sr_loss_audit.json`），**没有改预算、没有翻状态**。

**量纲与符号：两条精确恒等式在六个窗口上都成立。**

| 恒等式 | 含义 | 实测残差 |
|---|---:|---:|
| `I(VSa*) = I(Ld)` | 0 V 检测源就是封装漏极电流 | ≤ 1.1e-6 A |
| `v(di,si)·I(Ld) = v·I(Bch) + v·I(Dbd) + v·I(Cds) − v·I(Cgd)` | 导通两支 + 两个电容支 | ≤ 3.7e-4 W（每只 0.91 W） |
| `driver_output = gate_pin + Rgs + Cpin` | 栅极节点 KCL | ≤ 1.5e-4 W |

体二极管正向压降 0.714–0.723 V、六个窗口全部一致——这是量纲合法的独立证据：
平均电流是 `q_fwd/span`，写成 `q_fwd·periods/span` 会读出 5 mV 并**通过所有符号检查**。

**不收敛的是体二极管正向导通，不是沟道**（133 周期窗口，x8）：

| 量 | 5 ns | 2 ns | 1 ns | 跨三步移动 |
|---|---:|---:|---:|---:|
| 沟道 `v·I(Bch)` | 2.8916 W | 2.8642 W | 2.8957 W | **0.0315 W** |
| 体二极管正向 | 4.1923 W | 4.8207 W | 3.4271 W | **1.3935 W** |
| 体二极管反向恢复 | −0.1300 W | −0.1096 W | −0.1182 W | 0.0204 W |
| 合计 | 6.9540 W | 7.5753 W | 6.2047 W | 1.3706 W |

正向项解释了 SR 移动量的 **101.7 %**（沟道反向抵掉一点），且正向电荷每只每周期
3.635 / 4.153 / 2.992 µC 同向摆动——是**断续导通区间的时序伪影**，
不是"梯形积分误差"，也不能再笼统写成"SR 八路都不收敛"。

**闭合式多算了外部驱动功率的两个汇（边界记账错误）。**
`loss_main` 排除 `sr_gate_resistor_x8`，`SR_CH3` 的 `Rgs`（10 kΩ）又从不在任何损耗项里，
而 `driver_w()` 把 `drv` 整个加进闭合式。于是闭合残差里净多出 `Rg + Rgs + Cpin`：

| 量 | 5 ns | 2 ns | 1 ns |
|---|---:|---:|---:|
| `Rg`（器件模型 1 Ω 栅阻，x8） | 0.1815 W | 0.1815 W | 0.1812 W |
| `Rgs`（10 kΩ，x8） | 0.0360 W | 0.0355 W | 0.0372 W |
| `Cpin` 边沿项 | −7.0e-7 W | −8.2e-7 W | −1.7e-7 W |
| **修正量** | **0.2175 W** | **0.2170 W** | **0.2184 W** |
| 原闭合（周期平均） | +0.3258 W | +0.3139 W | +0.3095 W |
| 原闭合（单点） | +0.3844 W | +0.3186 W | +0.2947 W |
| **修正后（周期平均）** | **+0.1084 W** | **+0.0969 W** | **+0.0911 W** |
| 修正后（单点） | +0.1669 W | +0.1016 W | +0.0763 W |

修正量跨三步只差 **0.0014 W**，所以它去掉的是一个**常数性边界错误**，
不改变步长敏感性（修正后周期平均仍跨 0.0173 W，与原 0.0164 W 相当）。
修正后三段都在 0.2 W 内。

**但这不是"数值收敛"，`closure_status` 一律保持 `NOT_CLOSED`：**
- SR 损耗清单本身仍不收敛（上表正向项 1.39 W），所以 §2.5/§2.6 关于逐项精度的结论不变。
- 16 周期窗口修正后仍是 −0.4392 / −0.0591 W，跨步长移动 **0.380 W**，**仍然不能用**。
- 本工具不改 `energy_ledger_100a.py` 的 `loss_main` 定义：那会把已发布的"列示损耗合计"
  整体抬高 0.217 W，连带挪动 94.4 % 一类效率口径，属于需要单独决定的事。

**顺带查出一个候选 deck 的参数绑定缺陷。** 111 A 候选跑的是 `Cout 7.05m`、`LR_TOTAL=1u`，
而 `storage_arrays()` 固定用母 deck 的 `COUT_F=4e-3`、`LR_H=0.92e-6`。
按 deck 实际值修正后 111 A 闭合从 +0.5586 → **+0.6947 W**（单点），
再减驱动汇 0.2186 W 得 **+0.4761 W（周期平均 +0.4884 W）**，仍在 0.2 W 之外。
所以驱动项修正**不是**"让数字变绿"的操作。已发布的 `energy_ledger_48v_110a.json`
仍带未修正的储能项，引用时必须说明。

复算（六条 raw；都要本地存在）：

```bash
python tools/sr_loss_audit.py --json design/v3/stage_f/sr_loss_audit.json
python -m pytest tools/test_sr_loss_audit.py -q
```

### 2.8 第四步 0.5 ns：仍然没有平台，闭合的"稳"塌了（Issue #6 / E6-3）

E6-3 的原话是"再跑一个 ≤0.5 ns 的变体，看最后一段会不会收缩"。`aligned0p5n` 只在
`aligned1n` 上改 `.tran` 的步长（**664.881 s、3.65 GB**；三份 deck 除 `.tran` 行外逐字节相同，
`.save` 块的 md5 也相同）。答案是**不会收缩**：

| 量（133 周期） | 5 ns | 2 ns | 1 ns | 0.5 ns | 第三段 Δ |
|---|---:|---:|---:|---:|---:|
| `Pin − Pout`（端口项） | +10.8888 | +11.4228 | +10.1261 | **+9.4109** | **−0.7152 W** |
| 列示损耗合计 | +10.7313 | +11.3563 | +9.9804 | **+9.0525** | **−0.9278 W** |
| 其中 `sr_channel_body_x4` | 6.9540 | 7.5753 | 6.2047 | **5.2722** | **−0.9324 W** |
| 其余 12 项合计 | 3.7773 | 3.7810 | 3.7757 | 3.7803 | +0.0046 W |
| 储能速率（周期平均） | +0.0373 | −0.0418 | +0.0439 | +0.0430 | −0.0009 W |
| 闭合残差（单点） | +0.3844 | +0.3186 | +0.2947 | **+0.5364** | +0.2418 W |
| **闭合残差（周期平均）** | **+0.3258** | **+0.3139** | **+0.3095** | **+0.5233** | **+0.2138 W** |
| 损耗残差（`residual_w`） | 0.1575 | 0.0665 | 0.1457 | **0.3584** | +0.2127 W |

- **不是平台**：工具判据是"最后一段远小于第一段"。第三段（−0.715 / −0.928 W）虽然比第二段
  （−1.297 / −1.376 W）小，但仍是**第一段（+0.534 / +0.625 W）的 1.34 / 1.49 倍且反向**。
  幅度不随步长单调收缩，所以 0.5 ns 不是"更准的那个值"，四段也**不能外推**。
  **"再减一步就能看到平台"到此证伪**：要判收敛必须**先把工作点钉住**（恒流负载或闭环 Vout）
  再比，不是继续减步长——四档 `V(out)` 窗口均值差 19.2 mV、SR 门极导通时间差 141.7 ns，
  它们不是同一点上的四次离散化；后处理换求积规则也已排除（同一 raw 内 0.80 %
  对跨档 86 %，见 `stage_f/sr_step_operating_point.json`）。
  **恒流负载已经试过，它钉住的是电流不是 `V(out)`**：5 ns 档复现电阻档到 0.3 %（证明替身忠实），
  但同样 100 A 下 0.5 ns 档仍高 **15.1 mV**，5→0.5 ns 的端点损耗差保留 **98.9 %**
  （不是四档 2.3 W 摆幅，恒流只跑了两个端点；`stage_f/sr_step_operating_point_csink.json`）。
  所以"钉住工作点"只剩**闭环 `V(out)`** 一条路，而那是一个新 deck，不是换负载。
- **闭合的"稳"是三点巧合**：5/2/1 三点只差 0.016 W，是因为端口项与损耗项同向移动、
  几乎抵消；第四段这个抵消失败 0.214 W，闭合残差直接到 **+0.5233 W**，
  同时损耗残差第一次越过 0.2 W（**0.3584 W**）。所以 §2.5/§2.6 的 +0.33 W 缺口**不能**
  再写成"稳定"，只能写成"5/2/1 三点读数、步长不确定度不小于 0.21 W"。
- **`sem_w` 与步长误差是两回事**：§2.3 引用的周期平均 `sem_w` 0.157 W 只含周期间随机散布，
  不含步长；而步长这一项在这条 raw 上就有 0.21 W 量级。凡引用"能分辨 0.2 W"必须带这句。
- **不收敛的仍然只有 SR 一项**（其余 12 项四段摆幅合计 0.105 W，最大单项 `cout_esr` 0.048 W），
  但它的摆幅按四段算是 **2.303 W**（7.5753 → 5.2722），因此"单个损耗项的可引用精度约 1.4 W"
  应改为 **约 2.3 W**；损耗合计的四段摆幅也是 2.30 W，约为 200 W 输入的 1.2 %，
  94.47 % 的效率只能引到 **±1 个百分点**。
- `closure_status` 仍是 **NOT_CLOSED**，`aligned_closure_after_within_budget_period_averaged`
  由 `true` 变为 `false`；**0.2 W 门限未改**，这条 run 的效率仍不可引用。
- 第四段的 `V(out)` 终点**没有记录**（`step_check.terms.vout_end_v` 只存 a/b 两端），
  所以上表不列该行，也不要拿 1 ns 的 1.8688 V 去代。

复算：

```bash
python tools/energy_ledger_100a.py --raw sim/v3/sr_tank_dual_v33_ss_1ms_100a_aligned.raw \
    --periods 133 --compare-raw sim/v3/sr_tank_dual_v33_ss_1ms_100a_aligned2n.raw \
    --also-raw sim/v3/sr_tank_dual_v33_ss_1ms_100a_aligned1n.raw \
    --also-raw sim/v3/sr_tank_dual_v33_ss_1ms_100a_aligned0p5n.raw \
    --json design/v3/stage_f/energy_ledger_100a_phase_aligned.json
```

四条 raw 分别是 2.44 / 2.25 / 3.78 / 3.65 GB，都不入 Git。

### 2.9 四组 SR 的对称性只有 pair 1 / pair 4 能测（Issue #6 / E6-4）

`sr_channel_body_x4` 与 `secondary_copper` 都是把 **pair 1 的数字乘 4**。这个缩放能否成立，
取决于四组是否真的均流。ledger deck 只保存了 **pair 1 与 pair 4** 的端子电流
（`I(VSa1)`/`I(VSb1)`/`I(VSa4)`/`I(VSb4)`），pairs 2/3 **没有任何探针**，只能记
**UNKNOWN**。`sr_loss_audit.py:group_symmetry()` 对每一列算 `pair4/pair1` 的 RMS 比与
I²R 比（133 周期对齐窗口，与 §2.8 同一窗口）：

| 列 | a 半 `isa4/isa1` | b 半 `isb4/isb1` | 最大 I²R 偏差 |
|---|---:|---:|---:|
| 5 ns | 1.000000 | 1.000000 | 0 % |
| 2 ns | 1.000000 | 1.000000 | 0 % |
| **1 ns** | **0.979267** | **1.019734** | **4.10 %** |
| 0.5 ns | 1.000000 | 1.000000 | 0 % |

- 四组在 deck 里**逐项相同**（同一 `LP/9`、`Rser=0.15m`、`K=0.999`、同一 `SR_DEVICE` 与
  `SR_TIMING`），所以理想解必须给出 1。三列是**精确的 1.000000**（不是"接近 1"），
  说明那三列在数值上就是对称解；1 ns 列不是。
- 1 ns 列**不是总电流错了**：a 半低 2.1 %、b 半高 2.0 %，两半比值的乘积 0.99859，
  两半的二次平均只比 pair1 低 0.03 %；循环分量 `rms(isa1 − isa4) = 0.71 A`
  （时间加权；对约 20 A 的组电流是 3.6 %）。这是**并联支路之间的电流重分配**，
  不是某组真的多带了负载。
- 为什么会重分配：四组副边在 `out` 上并联，回路电阻只有几个毫欧
  （绕组 0.15 mΩ ×2 + 11 V 下 SR 沟道 0.891 mΩ ×2 ≈ **2.08 mΩ**），而两支路节点都在 ~2 V。
  求解器的相对容差按 2 V 节点算约 2 mV，落到 2.08 mΩ 上就是约 **1 A**——实测 0.71 A
  只对应 **1.49 mV** 的支路差。所以**分配比是数值自由度，不是物理量**；1 ns 列只是没有
  落回对称解，而 5/2/0.5 ns 落回了。旁证：仓库里其余 **7 条 raw**（16 周期 5/2 ns、
  111 A、48 V/50 V 的 110/120 A 候选）`pair4/pair1` **全部**给出 1.000000，
  只有这一条 1 ns 例外。
- 对 x4 缩放的含义：pair1 比两半平均值低 **2.04 %（RMS）**，即 `4 × pair1` 的 I²R 项
  低约 **4.0 %**；1 ns 列该项 6.2047 W 对应约 **0.25 W** 的潜在偏差，与 0.2 W 闭合预算
  同量级。这**不改变** §2.8 的"无平台"结论（SR 项四段摆 2.30 W），但任何逐项引用都要带
  这个界，不能写成"四组均流"。
- **不得**把这行写成"均流已验证"：它只说明"在这个模型里，pair 4 与 pair 1 在 5/2/0.5 ns
  上逐位相同、在 1 ns 上反向差 2 %"。真实板上的漏感、铜阻、门极延迟全部不在 deck 里。
- pairs 2 与 3 仍是 **UNKNOWN**，除非 ledger deck 给全部八路 SR 加电流探针（会改变
  `.save` 的变量数）。E6-4 的"能做的部分"到此为止，结论是**有界的未知**，不是"对称性通过"。

复算：

```bash
python tools/sr_loss_audit.py --json design/v3/stage_f/sr_loss_audit.json
python tools/ledger_issue6_triage.py   # E6-4 记录由前一份 JSON 派生
```

## 3 轻量 CI（Issue #4 关闭项）

```bash
python -m pytest tools -q          # 全量离线测试
python tools/ci_check.py           # 测试 + 重新生成 v3 manifest 并逐项比对
python tools/ci_check.py --skip-tests   # 只查生成文件是否过期
```

- `.github/workflows/ci.yml` 在 `windows-latest` 上跑 `python tools/ci_check.py`。
- raw 文件不入 Git（ledger raw 424 MB）；CI 容忍 `.raw` 缺席，但 raw 存在时
  仍比对 size/mtime，重新生成会失败。`test_energy_ledger_100a` 对 raw 缺席用 `skipif`。
- manifest 的 `generated` 日期不参与比对（换一天不算漂移）。
- 任何生成文件（`board_netlist.csv`、极性 CSV、上电检查表、ledger JSON、manifest）
  被改动后未重跑工具，CI 红。

## 4 未冻结 / 不得引用为结论

1. 负载瞬态（±ΔV、恢复时间）与启动鲁棒性：没有判据，也没有仿真。
2. Cout 的 ESL、偏置/温度/寿命后的容量与 ESR：料号数据是检索摘要，未读 datasheet。
3. 80 K/W 热阻、磁芯/绕组热阻、冷板换热系数：量级估计。
4. 输出路径接点电阻：无数据，首件四线法实测。
5. 四组均流：模型对称，`iout_spread` 近零不是均流证据。
6. 100 A 连续：热预检"可行但取决于铜面积/冷却"，必须首样热稳态签核。
7. 54/60 V 运行：60 V 只作为自举二极管反压假设，不是输入包络。
8. 纹波目标 ≤50 mVpp 是项目自选、不是产品规格，而且模型 49.7 mVpp 只剩 0.27 mV 余量；
   若升为硬指标，Cout 数量/ESR 或开关策略必须重做，不能靠四舍五入"通过"。
9. 100 A 能量账的闭合**尚未在 0.2 W 上被分辨**：−0.118 W 是 16 周期均值，
   而该窗口的标准误是 1.26 W，一旦换步长就变成 +0.404 W。不得引用为"能量账已闭合"，
   也不得把它当作 94 % 效率已被守恒验证。

## 5 阶段状态（Issue #4 的 A–E）

| 阶段 | 交付物 | 仓库中的位置 | 状态 |
|---|---|---|---|
| A 规格与证据 | 输出包络、关键 deck、损耗账本、BOM | 本文件 §1；`manifest_current_candidate.json`；`energy_ledger_100a.json`；`bom_draft.csv` | 软件可完成部分已交付；仍开放：动态响应判据、首件漏感/ESL |
| B 控制板 + 磁件首件 | T1–T7 协议、DOT 极性记录、磁件回填 | `上电检查表.md`、`winding_polarity.csv`、`first_article_polarity_record.csv`（空白模板） | **未开始：硬件** |
| C 主实验板 | 原生原理图/PCB/DRC/装配/热机械剖面 | `board_netlist.csv` 只有逻辑网表，**不是 DRC 结论** | **未开始：硬件** |
| D 额定验证 | 10/25/50/75/100 A × Vin 边界、温度、四组电流、保护恢复、含偏置效率 | `上电检查表.md` 的 S3/S4 步骤 | **未开始：硬件** |
| E 二版优化 | 按实测热源与损耗排序 | — | **未开始：硬件** |

禁止的捷径（与 Issue #4 原文一致）：把 0 映射错误的网表当 PCB/DRC 通过；把理想对称模型的
四组均流当实测；把短时 100 A 当连续额定；把 92.33 % 工程预算当硬件效率。

## 6 变更规则

- 改任何冻结量：先改生成工具/JSON，再重跑本文件引用的工具，最后更新本表。
- 不得为了让测试通过而放宽判据或预算；残差超 0.2 W 时写"数值限制"，不改目标。
- 新增 `HW_MEASURED` 行必须附首件记录路径；没有记录就保持空白。

## 7 对外措辞（Issue #6）

可以写：

> 在 100 A、48 V 的同一窗口内，模型**端口电气效率**为 94.47 %（deck 不含磁芯损耗）。
> 在相位对齐的 133 个门极周期窗口（663 µs）内，**含储能闭合残差**为 +0.33 W
> （周期平均；单点 +0.38 W）。该窗口的周期平均标准误是 0.157 W，**足以分辨 0.2 W，
> 而读数超出目标**——也就是说，模型在这个精度下**没有**闭合，缺口约 0.3 W。
> 16 周期窗口的 −0.118 W 不能作为闭合证据：同一窗口中位相偏 8 个周期就变成
> +0.999 W，它的标准误是 1.26 W。

不得写（都曾出现过，已撤回）：

- "能量账已闭合在 0.2 W 内"——均值落进目标不等于分辨到目标。
- "94.47 % 已通过能量守恒验证"——那是未含磁芯损耗的电气端口值。
- "92.33 % 是变流器效率"——那是含磁芯估计、0.15 mΩ 输出路径与 0.75 W 偏置的工程预算，
  不是测量，也不是硬件效率。
- 把短时 100 A 的模型结果写成"已验证的连续 100 A 效率"。
