czy0126/CZY/design/v3/A6_机械剖面_2026-11-01.md

# A6 机械剖面：10 mm 到底量的是什么 — 2026-11-01

> 数据源：`hardware/dcx_mech/placement_report.json` 的 `section` 块
> 生成器：`tools/main_board_mechanical.py::mechanical_section()`
> 判据：`tools/test_main_board_mechanical.py`（`Issue #12` 一节）
> 上游：`A5_机械布置_2026-11-01.md`（X/Y 摆得下，Z 放不下）

## 1 Issue #12 的第一个问题不是"多高"，是"量到哪"

`A5` 给出三组数字：平面 9.94 mm、加沉槽 9.44 mm、加压块 10.44 mm。三个都对，
但**它们量的不是同一件事**，而"≤10 mm"没有规定量到哪。所以先定基准面：

> **Z 基准：PCB 顶面 Z = 0，向上为正。**
> 本文所有数字都是**模块相对这个面**的高度，不含 TIM、不含冷板、不含紧固件。

这个基准不是新发明的，是摆放表原本就在用的：`PARTS` 里每个 `h_mm_worst` 都是从
PCB 顶面往上量的。把它写出来，只是让"10 mm"从一句口号变成一个可以互相比对的口径。

## 2 剖面上有什么

### 2.1 基准面以上（向上）

| 项 | 标称 | 最坏 | 证据等级 | 说明 |
|----|-----:|-----:|---|---|
| ELP32 磁芯对（B66287 半对 ×2） | 9.50 mm | **9.80 mm** | datasheet | 已含研磨气隙，9.8 是 TDK 的最大值 |
| 胶层 | 0.05 mm | **0.08 mm** | **ASSUMED** | 本仓库没有胶的规格书，最大值是假设 |
| 标签 | 0.05 mm | 0.06 mm | **ASSUMED** | 可选；不做标签直接省掉 0.06 mm |
| 压块 | 0.50 mm | **0.50 mm** | **DESIGN** | 五只裸磁芯不能悬空；形式和厚度都还没定 |

### 2.2 基准面以下（向下）

| 项 | 厚度 | 证据等级 | 说明 |
|----|-----:|---|---|
| 沉槽 | −0.50 mm | **DESIGN** | 尚未与 PCB 厂确认 0.5 mm 沉槽工艺 |
| 沉槽下剩余介质 | 1.10 mm | **DESIGN** | 1.6 mm 板厚减沉槽；FR-4 介质承担结构支撑与绝缘；电流须通过连续铜层、过孔或铜排 |

沉槽不是免费的：1.1 mm 剩余 FR-4 需要承担机械支撑与绝缘，**不能**承担 SR 电流。PCB 厂必须提供沉槽后的铜层与过孔可用性和电气连续性；磁件固定和整机散热详细分析按项目决策暂缓，不等于豁免保护及安全约束。

### 2.3 基准面以上还没有定义的东西

以下四项**在本仓库里不存在任何数据**，报告里列为 `undefined_above_the_stack`，
并在 `definitions` 里把含它们的 D 情形留成 `null`：

- TIM / 导热垫厚度与压缩量
- 冷板或散热器离板面高度
- 紧固件头部 / 螺纹嵌件凸出
- 板弯与压块变形（装配态，不是零件公差）

## 3 结论：沉槽只是把压块买回来

| 情形 | 相对 PCB 顶面最坏高度 | 对 10 mm 的余量 | 含义 |
|---|---:|---:|---|
| A 平面（无沉槽、无压块） | 9.94 mm | **+0.06 mm** | 名义上"过"，实际没有余量 |
| A+ 加压块、不加沉槽 | 10.44 mm | **−0.44 mm** | 超；这是 A5 报的那个失败情形 |
| B 加 0.5 mm 沉槽、不加压块 | 9.44 mm | +0.56 mm | 能过，但磁芯没被压住 |
| C 加 0.5 mm 沉槽、加 0.5 mm 压块 | **9.94 mm** | **+0.06 mm** | 回到原点 |
| D 含 TIM 与冷板 | **未定义** | — | 需要结构专业输入，留空 |

**C = A。** 0.5 mm 的沉槽和 0.5 mm 的压块正好相抵，净余量还是那 60 µm。
这不是巧合可以掩盖的事实：**沉槽不是额外余量，它是让"压住磁芯"这个必要条件
回到原点的代价。**

所以 A5 里那句"必须进沉槽"是对的，但只说了一半。完整的话是：

> 进沉槽能容纳压块，但余量不增反平；要真正拿到余量，只有三条路——
> 减胶/去标签（最多 0.06 mm）、把压块做进磁芯窗口而不是叠在上面、
> 或者接受 >10 mm。

这条由 `test_the_pocket_only_buys_back_the_clamp` 锁死：`C` 与 `A` 之差必须在
1 µm 内相等。如果有人删掉压块让 `C` 变小，这条测试会红。

### 3.1 沉槽本身要什么（Issue #12 第 2 条）

沉槽不是免费的竖直偏移，是一次铣削腔体。它同时**拿走 20 % 的板面积**、把最重零件的
底面压到 **1.1 mm 介质**上、并且只在**一面**开槽——这三点各自都要有人签字。

| 项 | 数值 | 怎么来的 |
|----|-----:|---|
| 单只沉槽面积 | 806.4 mm² | ELP32 外形 31.75 × 25.4 mm |
| 五只合计 | 4032.2 mm² | 板面积 20305.0 mm² 的 **19.9 %** |
| 深 | 0.5 mm | 设计选择 |
| 剩余介质 | **1.1 mm**（1.0–1.2） | 1.6 mm 板厚减 0.5 mm 深、再计 ±0.1 mm 腔体公差 |
| 磁芯占用 y | 7.3–64.7 mm | T1–T4、Lr 的摆放 |
| 100 A 输出通道 y | 82–116 mm | SR 行到 J_OUT |

**沉槽与 100 A 平面不冲突**（64.7 < 82）。这一条是**核对过的非问题**，不是没想过：
把变压器往上挪 20 mm 就会撞上，而现在没有任何东西会提醒下一个人。

### 3.2 还没定义的五件事

- **叠层**：沉槽只削顶层还是进到内层？内层铺铜要不要让开？
- **绝缘**：N97 是 MnZn 铁氧体，不能直接压在裸铜上；需要的绝缘等级没定。
- **绕组引出**：引出方式与沉槽边缘的爬电距离。
- **压块反作用**：压磁芯的力最终落在 1.1 mm 的介质上。
- **板弯**：单面开槽使叠层不对称，而板弯**直接进高度预算**——它正是 §2.3 里
  列为"未定义"的那一项。

### 3.3 要问制造商的三句话

1. 1.6 mm FR4 上 0.5 mm 深、31.75 × 25.4 mm 的腔体能否做，公差多少？
2. 腔体底部的铜（如有）是否保留，最小介质层厚是多少？
3. 单面五处腔体对板弯的典型值是多少？

`pocket_requirements()` 的 `manufacturability.status` 现在是 **"未询问"**，
`gate` 写着"制造商书面确认前不得冻结"。**没有人问过，所以也没有人能说它能做。**

## 4 输出电气路径修正：四组 25 A 不等于一组 100 A

**本轮纠错：旧版“1.333 mΩ、13.33 W”的整机路径结论不成立。** 它把四组 SR 中电阻最大的单组铜路径（1.188 mΩ）当作 100 A 全部流经的串联路径；实际设计有四组并联，各自电流不同。这个错误曾直接推动“必须舍弃当前 PCB 铜方案”的结论，应撤回。

以 **每组恰好 25 A** 的示例，先对支路计功率，再从全机 100 A 折算等效电阻：

\[
P_{\mathrm{plane}} = \sum_{k=1}^4 I_k^2R_k,\qquad
R_{\mathrm{plane,eq}} = \frac{P_{\mathrm{plane}}}{(\sum I_k)^2}
=\frac{\sum R_k}{16}\quad (I_k=25\ \mathrm{A}) .
\]

> 这只是固定等分电流下的等效阻抗。**四组电流均分尚未由 PCB 寄生、控制器时序或实测保证**，且“方块数矩形近似”不是任何任意二维导体的严格上界或下界。

当前 A5 平面按 2 oz、100 °C 的**电阻率场景**（仅用于电气敏感性，热设计本轮暂停）。方块电阻为 **0.324 mΩ/方块**；过去把整机 0.15 mΩ 预算直接换算成 **0.46 个方块**并与*一组*支路相比较，属于错误的同类量比较，现已撤回。每组修正后仍有以下局部模型参数：

| 组 | 电流假设 | 方块数 | 局部支路 R | 支路 I²R |
|---|---:|---:|---:|---:|
| SR1 | 25 A | 3.67 | 1.188 mΩ | 0.743 W |
| SR2 | 25 A | 1.14 | 0.368 mΩ | 0.230 W |
| SR3 | 25 A | 0.94 | 0.304 mΩ | 0.190 W |
| SR4 | 25 A | 0.94 | 0.304 mΩ | 0.190 W |
| **四组总计** | **100 A** | — | **折算 0.135 mΩ** | **1.352 W** |

将**未验证**的铜排约 0.045 mΩ、两个接点占位合计 0.100 mΩ 另计，系统示例为 **0.281 mΩ，约 2.806 W @100 A**。模型中的整机内部输出折算阻抗约为 **1.135 mΩ**，不能与单组局部电阻作直接一比一相加；并不是旧版的 1.333 mΩ / 13.33 W。

### 4.1 版图选项的电气敏感性

| 层铜 / 接点假设不变 | 最差局部支路 R | 平衡电流下整条路径等效 R | 100 A 等效 I²R |
|---|---:|---:|---:|
| 2 oz、现状 80 mm 铜排 | 1.188 mΩ | 0.281 mΩ | 2.81 W |
| 2 oz、铜排覆盖四组 | 0.304 mΩ | 0.221 mΩ | 2.21 W |
| 4 oz、现状 80 mm 铜排 | 0.594 mΩ | 0.213 mΩ | 2.13 W |
| 4 oz、铜排覆盖四组 | 0.152 mΩ | **0.183 mΩ** | **1.83 W** |

“设计路径预算 0.15 mΩ”是旧版自行设置的效率假设，而非器件物理上限。**用户允许在保证电气应力和安全条件的前提下，适当增加损耗以争取更高输出电流/功率。** 因此 0.183–0.281 mΩ 可以作为需要进一步研究的电阻候选，而不是因为超过 0.15 mΩ 就直接否决；不能把增加损耗等同于允许超越 MOS、磁件、CT、Cr、Cout 的额定。

**优先行动**：先把输出铜排覆盖四组 SR，降低最差局部电阻与预计均流差异；再用真实铜层、过孔与 Kelvin 接点数据执行多支路电阻网络计算／PCB 求解。按本阶段证据，**不签核路径电阻、均流、100 A 连续与额定输出功率**。

### 4.2 铜层与介质的功能必须分开

沉槽后的 1.1 mm **FR-4 介质不导电**，其作用是机械支撑与电绝缘；SR 回流经由铜层、过孔或铜排，需明确哪些铜层在 0.5 mm 机械铣槽后仍保持完整，避免切断回流回路。结构/热扩展设计后续处理，但这项基础电气连续性检查不能推迟。

### 4.3 新的更高输出候选

详见 `design/v3/power_priority/scenarios.json` 与 `tools/high_output_sweep.py`。以原 48 V / ~100 A 电气工作点线性化（**并非运行过新的 LTspice**），48 V、110 A、外部路径 0.15 mΩ 估计负载端约 **1.859 V / 204.5 W**；允许路径增至 0.30 mΩ 时会增加损耗并稍减负载功率。50 V、110 A 路径 0.15 mΩ 场景约 **213.6 W**，同样只能视为候选。后续必须进行真实负载扫频、保护、电容纹波及磁件非线性测试。

## 5 未签核声明

Issue #12 的关闭条件是"A6 机械剖面可投产"。**现在不是。** 本轮以电气设计和可制造性为优先，完整热设计**暂缓**；不得据此批准超额定电流或连续额定运行。 具体缺：

| 缺什么 | 影响 | 需要谁 |
|---|---|---|
| TIM / 冷板 / 紧固件定义 | D 列无法填，10 mm 无法对系统签核 | 结构 |
| 0.5 mm 沉槽的工艺确认 | 沉槽可能做不出来或代价很高 | PCB 厂 |
| 剩余介质强度与导电铜层回路连续性 | 可能因热/机械约束而否决沉槽 | PCB 厂 + 结构 |
| 五只磁芯的固定方式（压块 or 灌封 or 支架） | 决定向上那一项的真实厚度 | 结构 |
| CT / Cr / J_IN / QH-QL 的真实 MPN | 高度与形状都还是占位 | 采购/选型 |
| 100 A 输出路径的铺铜与接点 | 与 `connector_budget.json` 的两个口径不一致 | 版图 |

最后一行不是新问题：`CLAUDE.md` 已记着 0.1 mΩ 是自选指标、磁件包按 0.15 mΩ 算，
`connector_budget.py` 报 `feasible: false`。A6 要做的是把这条**在机械剖面上**说清楚——
铜排 80 mm 走完 34.5 µΩ 之后，每处接点上限 57.8 µΩ，而接点电阻在本环境无数据可查。

## 6 这一节能被证伪吗

`tools/test_main_board_mechanical.py` 的四条：

| 测试 | 它防的是什么 |
|---|---|
| `test_the_section_states_a_datum_and_leaves_the_undefined_as_none` | 有人把 D 填上一个想象出来的数，让"≤10 mm"看起来签核过了 |
| `test_the_pocket_only_buys_back_the_clamp` | 有人悄悄删掉压块或放大沉槽，让余量变好看 |
| `test_the_section_agrees_with_the_magnetics_height_stack` | 剖面表与 `magnetics_design.json` 各算各的、悄悄分叉 |
| `test_the_report_carries_the_section` | 文档引用的数不在 `placement_report.json` 里 |

输出路径那一节的五条在 `tools/test_output_path_budget.py`：

| 测试 | 它防的是什么 |
|---|---|
| `test_the_geometry_comes_from_the_placement_not_a_constant` | 挪了 J_OUT 而差距不变——工具已经不再读板，只在重印一个常数 |
| `test_only_the_groups_outside_the_busbar_have_a_neck` | 把"第 1 组没铜排"从散文变成几何断言 |
| `test_a_wider_busbar_equalises_the_groups` | 加宽铜排确实把散布拉到 1.00——这是给版图的指令 |
| `test_no_option_closes_the_design_basis` | 有人把接点项悄悄删掉，让表格变绿 |
| `test_the_joint_term_is_carried_as_unverified` | 占位值被当成实测值引用 |

第三条是**活的**：`mechanical_section()` 自己把胶层/标签/磁芯加一遍，然后与
`magnetics_design.json` 的 `flat_no_pocket` 比对，不一致就 `SystemExit`，而不是
打印一个和 JSON 打架的数。测试里把 `GLUE_MAX_MM` 改大 0.05 mm，必须抛错。
