czy0126/CZY/design/v3/A5_机械布置_2026-11-01.md

# A5 机械布置（1:1 摆放研究）— 2026-11-01

> 产物：`hardware/dcx_mech/power_stage_placement.kicad_pcb`
> 生成器：`tools/main_board_mechanical.py`　判据：`tools/test_main_board_mechanical.py`
> 图：`placement_1to1.svg`（1:1，可按真实尺寸打印）、`placement_top.png`（3D 顶视）

## 1 这是摆放研究，不是布好的板

板上**没有网络、没有走线**，每个焊盘都是悬空的——这是 A5 的预期状态，不是缺陷。
它回答的是加速计划里放在布线之前那个问题：**这些东西到底放不放得下，高度问题落在哪。**

`kicad-cli pcb drc --severity-all` 在提交的板子上给 **0 条违规**，但它只保证摆放能保证的
两件事：外框互不侵占（courtyard 不重叠）、以及没有无法解析的封装库（封装库解析不了时
KiCad 把它当黑盒，连外框都不查）。

## 2 板框与分区

板框 **155.0 × 131.0 mm**，35 个件，最小间隙 **0.9 mm**（C110/C111，输出电容阵内）。
自 0,0 向下五排：

| 排 | 内容 | 位置 | 为什么在这 |
|----|---|---|---|
| 1 | T1–T4 | y ≈ 20，x = 20/58/96/134 | 四组等距，四个副边回路在几何上同构——均流靠对称，不靠调 |
| 2 | Lr、QH/QL、Cr、CT、J_IN、U2 | y ≈ 52 | 原边自左向右按功率流向 |
| 3 | SR1A–SR4B | y ≈ 82 | 每对直接在自己的变压器下方，副边回路短 |
| 4 | C100–C114 | y ≈ 98 | 输出电容排在 SR 与铜排之间 |
| 5 | J_OUT | y ≈ 116 | 100 A 从板边离开 |

排布本身是可读参数：改 `tools/main_board_mechanical.py` 的 `parts()` 一行即可，
板框由最外沿 + 5 mm 自动算出（`board_rect()`），越界由测试报错。

## 3 高度：X/Y 放得下，Z 放不下

这是 A5 唯一的硬结论，也是它值得先做的原因。

| 情形 | 最坏高度 | 对 10 mm 的余量 | 结论 |
|---|---|---|---|
| 平面（无沉槽、无压块） | **9.94 mm** | **+0.06 mm** | 名义上"过"，实际没有余量 |
| 加 0.5 mm 压块 | **10.44 mm** | **−0.44 mm** | 超 |

9.94 与 10 之间的 60 µm 比胶层、标签、磁芯自身平面度**每一项**都小。所以平面方案不是
"刚好过关"，是巧合。而五只散装磁芯不压住不行，压块一加就超。

⇒ **T1–T4 与 Lr 必须进沉槽。** Lr 用的是和变压器**同一只** ELP32 磁芯
（`lr_design.json`），所以只给变压器开沉槽的图纸会在首件上翻车——`test_the_lr_shares_the_transformer_core_so_it_shares_the_pocket`
就是锁这条的。

高度数值不在这里重算：`flat_no_pocket` / `with_0.5mm_clamp` 来自
`design/v3/magnetics/magnetics_design.json` 的 `height`，报告里原样引用，
改母工具而不改本文的 `test_baseline_doc.py` 会红。

第二个用户是 **J_IN**：一个 10.0 mm 的接线端子自己就把预算用光（报告中
`height.at_limit_refs`）。选型时它和磁芯共享同一个 10 mm，而不是各自 10 mm。

## 4 每个外形尺寸的证据等级

| 等级 | 含义 | 本板的件 |
|---|---|---|
| `generated-json` | 读自本仓库工具的 JSON | T1–T4、Lr（ELP32 31.75×25.4×9.5/max 9.8）、Cout 高度 1.9、J_OUT 铜排 80×20×2 |
| `kicad-library` | KiCad 官方封装自带尺寸 | SR1A–SR4B（PG-TDSON-8，courtyard 7.36×5.64，体高 1 mm） |
| `datasheet` | 数据手册的封装表，取**最大值** | QH/QL（CSD19531Q5A / VSONP DQJ）：D1 5.00 × E 6.10 × A 1.10 mm，见 `csd19531q5a.txt` 第 9 页 Q5A Package Dimensions |
| `PROVISIONAL` | **没有人选型**，尺寸是占位 | **CT 20×15×8、Cr 18×6×6、J_IN 10×10×10、U2 控制区 12×12×3** |

`PROVISIONAL` 的四项在 `placement_report.json` 的 `provisional` 里单独列出，
也在板文件的 `title_block` 注释里写死——图看起来完整不等于 BOM 完整。

另有 `land_pattern_provisional`：QH/QL 的体尺寸来自 BOM，但 KiCad 没有 SON 5×6 的
标准封装，板上是画的占位焊盘，**不是可投产的 land pattern**。

### 4.1 唯一借用的官方封装是 vendored 的（Issue #11）

SR1A–SR4B 用 `Package_SON:Infineon_PG-TDSON-8_6.15x5.15mm`。它**不是**由本工具生成，
因此复制进 `hardware/stock_footprints/`，来源/版本/sha256/许可写在同一目录的 `PROVENANCE.md`。
生成器不再指向任何用户目录——写死 `C:\Users\<user>\…\KiCad\10.0` 会让 GitHub Runner 上
"A5 工件能否重建"这条回归测试失败，而板子本身没有问题。
`test_regeneration_needs_no_kicad_install` 把 `KICAD_CLI`、`LOCALAPPDATA`、`PROGRAMFILES`
全部清空后重生成，逐字节比对提交的 `.kicad_pcb`——**没有 KiCad 也能复现**才是修复。

注意这只封装的 `descr` 指向 **BSC520N15NS3**（150 V），BOM 里是 **BSC010N04LS6**（40 V）。
用它只是为了拿到 PG-TDSON-8 外壳的真实外形与 courtyard；`land_pattern_provisional` 这句话
在换器件前必须重新核。

### 4.2 DRC 的"0 条"以前没查 courtyard

KiCad 对 `missing_courtyard` 的默认严重度是**忽略**，所以旧板子的 DRC 报告里
`ignored_checks` 是 5 项，一个 courtyard 都没有也会报 0 条。`project_file()` 现在把它提到
**error**，`test_the_courtyard_check_can_fail` 用一个"删掉一个 courtyard"的变体证明这条检查
真的会红（已验证）；`test_the_committed_drc_report_checked_courtyards` 保证提交的 `drc.json`
出自一次"开着这条检查"的运行。
因此现在这句可以写得更强：**35 个封装全部有 courtyard，且 KiCad 检查过它们**。

## 5 已知缺口（A6 之前必须解决的）

1. CT、Cr、J_IN 未选型 → 外形与高度都可能变，板框和沉槽会跟着变。
2. QH/QL 无官方封装。**体尺寸已按 datasheet 第 9 页取最大值**（5.00×6.10×1.10）；还差
   land pattern——datasheet 的推荐焊盘是图（Figure 2 那类），文本提取不到，板上仍是占位焊盘。
3. 变压器**端子位置**未定：ELP32 封装上的两个焊盘只是"这里要出线"，不是绕组的真实出线位置。
4. 铜排接点电阻仍是 UNVERIFIED 占位（见 `connector_budget.json`），板上宽度按 20×2 画，
   接点方式（螺接/焊接）未定。
5. 全部件都在顶层——若最终需要双面贴装，本布置作废重排。

## 6 复现

```bash
python tools/main_board_mechanical.py            # 只重生成 pcb / 封装库 / 报告
python tools/main_board_mechanical.py --check    # 另出 SVG + PNG，并跑 kicad-cli DRC
python -m pytest tools/test_main_board_mechanical.py -q
```

`--check` 需要本机 KiCad 10.0（`C:\Users\27792\AppData\Local\Programs\KiCad\10.0`，
不在 PATH 里）。CI 无 KiCad 时，`test_the_committed_svg_is_drawn_at_one_to_one` 与
`test_the_committed_board_is_what_the_table_produces` 仍在跑——它们在提交物上判定，不依赖工具链。

## 7 下一步

A6 布线顺序在本布置上确定：**先定 100 A 输出路径**（SR → Cout → 铜排），再定原边换流回路，
最后才是控制。理由与 `connector_budget.py` 一致——输出路径的接点电阻是唯一"算不出来、
只能首件四线法测"的量，它决定铜排长度能不能保住。
