czy0126/CZY/design/v3/power_priority/PROT_SOA表_2026-11-03.md

# 48 V/50 V 逐只 SR 保护/SOA 筛选表（2026-11-03）

> 证据等级：**SIMULATED_ONLY / NOT_RATED / NO_VENDOR_SOA**。
> 本表**不产生新 raw**：每个数字都从已提交的记录里复制，并由工具校验。
> 它是 D4 交付物"完整 48/50 V 保护/反向电流/SOA 表"的**筛选清单**，
> 不是通过/不通过判定，也不是器件 SOA 签核。

## 1. 为什么需要这张表

在它之前，逐器件的 `Vgs`/`Vds`/`Id` 证据分散在三份八探针记录
（`sr_fault_probe_{48v_120a,48v_120a_cshunt,50v_120a_cshunt}.json`）和七份候选对照记录里，
没有一个文件能回答"**哪一只器件、在哪一次运行里承受了最大应力**"。
ELE-10 与 PROT-02 的验收都要求逐只 `Vgs/Vds/Id`，D4 又要求把 48 V 与 50 V 放在同一张表里。

`tools/protection_soa_table.py` 生成
`design/v3/power_priority/protection_soa_table.json`：15 组运行 × 8 只器件。

## 2. 两种窗口，**不能混着差**

| 来源 | `window` | 含义 |
|---|---|---|
| `sr_fault_probe_*.json` | `post_trip` | 只统计 OC 动作**之后**的保存采样 |
| `protection_candidate_*.json` | `saved_window` | 统计**整个**保存窗口 |

所以同一台 deck 的 `min_drain_v` 在两种窗口下不同：48 V 基座探针是 −2.825 V（post-trip），
候选记录里的 `compare_base` 是 −4.890 V（全窗）。**不要拿这两列相减**，也不要把
285.01 A（post-trip 正向峰）与 292.61 A（全窗正向峰）当成"同一台机器跑了两次"。

## 3. 每组运行的最坏器件

| 运行 | 窗口 | 最大正向峰 A | 器件 | 最大反向峰 A | 最低 Vds V | 末端门极高 |
|---|---|---:|---|---:|---:|---|
| 48 V 探针（基座） | post-trip | 285.01 | 4a | 10.602 | −2.825 | 1a–4a |
| 48 V 探针（cshunt） | post-trip | 284.37 | 1a | 9.947 | −2.731 | **1b–4b** |
| 50 V 探针（cshunt） | post-trip | 300.22 | 1a | **11.100** | −3.213 | 无 |
| 48 V 候选 A（对照基座） | 全窗 | 292.61 | 4a | 未记录 | −4.890 | 1a–4a |
| 48 V 候选 A | 全窗 | 292.58 | 4a | 未记录 | −4.899 | 无 |
| 48 V 候选 B（对照基座） | 全窗 | 292.61 | 4a | 未记录 | −4.890 | 1a–4a |
| 48 V 候选 B | 全窗 | **138.25** | 2a | 未记录 | −1.900 | 无 |
| 50 V 候选 A（对照基座） | 全窗 | 303.50 | 1a | 未记录 | −5.005 | 无 |
| 50 V 候选 A | 全窗 | **304.96** | 1b | 未记录 | **−5.127** | 无 |
| 50 V 候选 B（对照基座） | 全窗 | 303.50 | 1a | 未记录 | −5.005 | 无 |
| 50 V 候选 B | 全窗 | 139.35 | 3a | 未记录 | −2.466 | 无 |
| 50 V 候选 A（thrmute 对照基座，**截断**到 250.151 µs） | 全窗（截断） | 304.96 | 1b | 未记录 | −5.127 | 2a/3b/4a |
| 50 V 候选 A（thrmute 对照） | 全窗（截断） | 304.96 | 1b | 未记录 | −5.127 | 无 |
| 50 V 候选 B（thrmute 对照基座，**截断**到 254.980 µs） | 全窗（截断） | **305.01** | 4b | 未记录 | −5.123 | 1b/2b/3a/4a |
| 50 V 候选 B（thrmute 对照） | 全窗（截断） | 139.35 | 3a | 未记录 | −2.466 | 无 |

全局最大正向峰：**305.01 A**，50 V 候选 B 的 thrmute 对照基座、器件 `4b`。
它来自**截断到 254.980 µs** 的记录，但峰值出现在 209.95 µs，落在覆盖段内；
全窗（320 µs）记录的对应最大值是 303.50 A（母 deck 基座）/ 304.96 A（候选 A）。
**这两个数不能相减**：它们来自不同的基座与不同的求解器路径（§5.6）。

## 4. 这张表里能读出的四件事

1. **末端门极状态是运行相关的，不是电路属性**：48 V 基座锁 A 相、48 V cshunt 锁 B 相、
   50 V cshunt 末端全低。候选 A/B 的十只门极末端全部低于 0.1 mV（最大 3.5e-5 V）。
   两个 thrmute 对照基座又给出两种末态：A 停在 2a/3b/4a、B 停在 1b/2b/3a/4a，
   而它们各自的候选仍是全低。这复现了主 CLAUDE.md 已经记录的"同电路加 1 fF 会翻转锁存相位"，
   此处按器件逐只给出。
2. **反向电流只在探针运行里可直接读**：9.95–11.10 A。候选对照工具没有保存反向峰，
   表中为 `null`（`unrecorded_fields` 显式列出），**不是 0**。
3. **候选 B 把最坏正向峰从 ~303 A 压到 139 A**，同时把最低 Vds 从 −5.13 V 收到 −2.47 V；
   这与其 I²t 下降一致，不是单一指标的巧合。
4. **50 V 候选 A 的峰值略高于基座**（304.96 对 303.50 A）：与 §5.2 的结论相同，
   来自故障前工作点偏移（非配对对照），不是钳位造成的。

## 5. 不能从这张表得出的结论

- **没有厂家 SOA 曲线**：`vendor_soa_available = false`。路线图里的 380 A 是
  "单只 303.93 A × 1.25"的**询样筛选目标**，不是本表的判据。没有脉宽、结温、
  封装电流能力与 Vds 工况，峰值本身不能判定器件安全。
- **反向电流不能按门极电压拆成体二极管/沟道**：这是端口测量量。第二轮审核已撤回
  "门压低于 2 V ⇒ 反向电流全走体二极管"的推理；表中 `reverse_current_components_resolved = false`。
- **未屏蔽负对照被有意排除**：`prot_b_unarmed` 在启动冲击就锁死，整窗记录的是停机变换器，
  把它当"故障应力"会显著低估。
- 50 V 全部行来自 `cshunt=1e-15` 子变体；50 V 基座仍在 296.929 µs 塌缩。
- **`50v_prot_{a,b}_ctrl` 两组的基座行是截断记录**：thrmute 对照停在
  250.151 µs（A）/ 254.980 µs（B），候选行是在同一公共切片上重算的，
  所以 `reached_declared_window = false`、`solver_prefix_only = true`，
  `paired_change_can_be_attributed_to_protection` 也是 **false**（配对成立但窗口不完整）。
  这四行是全表里唯一“故障前 0.000 mV 配对”的 50 V 行，但**不能**据此引用全窗收益。
- 所有电流都来自线性/行为模型，不是硬件测量；模型缺 UCC24624 standby 与真实 SOA。

## 6. 复现

```bash
python tools/protection_soa_table.py      # 写 design/v3/power_priority/protection_soa_table.json
python -m pytest tools/test_protection_soa_table.py -q
```

工具不读 raw（只读已提交的 JSON），所以不需要本地有 GB 级波形；
`source_sha256` 记录每份来源的哈希，来源被改动时 `the_committed_table_is_current` 会红。
