czy0126/CZY/design/v3/power_priority/50V120A_损耗差额与步长_2026-11-02.md

# 50 V/120 A 的 0.499 W 差额与步长敏感性（ELE-09，2026-11-02）

> 状态：**SIMULATED_ONLY / NOT_CLOSED**。0.2 W 门限**未改动**。
> **结论：0.499 W 不是短窗伪影**——133 周期相位对齐窗口给出 0.4921 W（§5），
> 缺口稳定、可分辨（sem 0.050 W）。§6 进一步排除了"漏掉一个耗散元件"：
> 未计入的两个电阻合计 ≤1 mW，剩下能容纳缺口的只有端口读数边界与行为模型积分误差。
> 效率不可引用。
> 机器可读证据：`energy_ledger_50v_120a_steps.json`（5 ns 与 2 ns 两列账本）、
> `sr_loss_audit_50v_120a_steps.json`（同两列 SR 分解与门极边界修正）、
> `energy_ledger_50v_120a_aligned.json`（133 周期判定窗口）。
> 相位对齐的 133 周期判定 run 见 §5，deck 为
> `sim/v3/sr_tank_dual_v33_ss_1ms_vin50_i120_cin_aligned.cir`。

## 1. 问题

ELE-06 的 22 周期账本给出：端口损耗 `Pin − Pout = 15.5473 W`，
分项损耗合计 `15.0487 W`，差额 **0.4986 W**，而目标是 0.2 W。
这不是一个小数字：它相当于 232 W 输出的 0.22 %。问题不是"能不能凑到 0.2 W"，
而是**这个差额属于哪一类**：

1. 漏掉了一个真实的损耗项（模型或账本边界）；
2. 数值/积分误差（步长、窗长、端点采样）；
3. 端口项本身对输出直流电平过于敏感（`Pout = mean(Vout²/RL)`）。

## 2. 同窗同模型的 5 ns / 2 ns 对照

两个 deck 只有 `.tran` 的最大步长不同（`5n` 对 `2n`），`VIN=50`、`RL=16.3 mΩ`、
`Tstart=880 µs` 完全相同；因此窗口、周期数（22）与端口参数都一致。
`step_check` 由 `deck_difference()` 校验，只有步长不同才允许比较。

| 量（22 周期） | 5 ns | 2 ns | Δ（2 ns − 5 ns） |
|---|---|---|---|
| `Pin = 50·mean(I(Rin))` | 247.4212 W | 247.6608 W | **+0.2396 W** |
| `Pout = mean(Vout²/RL)` | 231.8739 W | 231.7039 W | **−0.1700 W** |
| 端口损耗 `Pin − Pout` | 15.5473 W | 15.9569 W | **+0.4096 W** |
| 分项损耗合计 | 15.0487 W | 15.1491 W | **+0.1004 W** |
| 损耗残差 | **0.4986 W** | **0.8078 W** | **+0.3092 W** |
| 窗口平均 `V(out)` | 1.944070 V | 1.943357 V | **−0.713 mV** |

**关键读法**：残差移动 0.309 W，但分项只移动 0.100 W；端口项移动 0.410 W。
其中 `Pin` 的变化（+0.240 W）与 `Pout` 的变化（−0.170 W）几乎同向叠加。
`Pout` 的 −0.170 W 完全由 −0.713 mV 的平均输出电压解释
（`2·V·ΔV/RL ≈ −0.170 W`），不是积分格式的变化。

也就是说，**在 22 周期窗口上，残差主要由"输出直流电平读数"决定，而不是由某个漏项决定**。
这个窗口有一个等效输出电阻：`ΔPout/ΔILoad ≈ −0.3 mΩ` 量级的灵敏度，
足以让 0.7 mV 的读数差造出 0.17 W。

### 2.1 分项里那 0.100 W 是什么

`loss_items` 逐项（2 ns − 5 ns）：

| 项 | Δ / W |
|---|---|
| `sr_channel_body_x4` | **+0.08683** |
| `lp_series` | +0.00342 |
| `cout_esr` | +0.00259 |
| `sh` / `sl` | +0.00190 / +0.00148 |
| `secondary_copper` | +0.00153 |
| `lr` | +0.00142 |
| `dl` / `dh` | +0.00134 / −0.00147 |
| `cr_esr` | +0.00085 |
| 其余（`rin`、CT 两项） | ≤ +0.0003 |

SR 一项占分项移动量的 **86.5 %**，与 100 A 对齐窗口上"只有 SR 体二极管正向项
不收敛"的结论一致（见 CLAUDE.md）。`sr_loss_audit` 把它拆开：

| SR 项（22 周期） | 5 ns | 2 ns | Δ |
|---|---|---|---|
| 沟道 `v·I(Bch)` | 3.96864 W | 3.97502 W | +0.00638 |
| 体二极管正向 | 6.15455 W | 6.23430 W | **+0.07975** |
| 体二极管反向 | −0.18917 W | −0.18848 W | +0.00070 |
| **SR 合计** | **9.93402 W** | **10.02085 W** | **+0.08683** |

逐周期看，SR 合计的步长差均值 +0.0869 W、**rms 0.2363 W**（22 个周期），
即这个单项本身在周期之间就有约 ±0.24 W 的散布。22 周期窗口的平均值
因此只能分辨到约 `2·sem` 量级，而 `sem` 与本窗的周期散布一起把 0.2 W 的分辨率吃掉了。

## 3. 门极边界修正与储能参数修正

`energy_ledger_100a.py` 的损耗清单排除 `sr_gate_resistor_x8`（`main_loss_names()`），
而闭合式里的 `driver_w` 是整个外部驱动输入。边界内的 `Rg`（器件模型 1 Ω）与
`Rgs`（10 kΩ）因此被多算一次。`sr_loss_audit.py` 把这两项单独算出来：

| 量 | 5 ns | 2 ns |
|---|---|---|
| 边界内栅极吸收（`Rg + Rgs + Cpin`） | 0.21738 W | 0.21732 W |
| 储能参数修正（deck `Cout=7.05 mF` / `LR=1 µH` 对工具 `4 mF` / `0.92 µH`） | −0.02331 W | −0.14942 W |

修正后的闭合残差（`closure` 是 `port + driver − loss − Δstored`）：

| 读数 | 5 ns | 2 ns | Δ |
|---|---|---|---|
| 单点储能 | 0.4301 W | 0.4531 W | +0.0230 W |
| **周期平均储能** | **0.4961 W** | **0.4883 W** | **−0.0078 W** |

**这才是 ELE-09 的实质结论**：把两个已知的记账错误修正后，闭合残差在 5 ns 与 2 ns 之间
只移动 0.008 W（周期平均），而它的水平仍然是 **约 0.49 W**——超出 0.2 W 门限 2.4–2.5 倍。
所以：

- 0.499 W **不是**漏掉的一个分项：分项清单已经逐项核对，修正后没有新项能补上 0.49 W；
- 0.499 W **也不是** 5 ns 的伪影：2 ns 给出同样的数；
- `closure_status` 保持 **NOT_CLOSED**，效率不能从这条 run 引用。

单点读数的移动（+0.023 W）大于周期平均的移动（−0.008 W），与"单点储能端点带采样抖动"
一致；报告引用周期平均那个数。

## 4. 与 100 A 对齐窗口的异同

100 A 的 133 周期对齐窗口上，周期平均闭合残差是 +0.3258 W（5 ns）对 +0.3139 W（2 ns），
只移动 0.0119 W；本 50 V/120 A 的 22 周期窗口给出 +0.4961 / +0.4883 W，移动 0.0078 W。
两处的**闭合残差都步长稳定**，但 50 V 的缺口更大（约 0.49 W 对 0.33 W）。
两处的**分项清单**都不稳定，且不稳定的都是 SR 项——50 V 是 `sr_channel_body_x4` 的
0.087 W（22 周期），100 A 是同一项的 1.4 W（133 周期 5/2/1 三段）；补上 0.5 ns 段后
100 A 那项的摆幅是 **2.30 W**（7.5753 → 5.2722 W），而且四段**仍无平台**
（见 `design/v3/当前候选基线_2026-11-01.md` §2.8）。

22 周期窗口与 133 周期窗口的差别不在"能不能算"，而在"能不能分辨"：
本窗 `resolution.sem_w = 0.098 W`（22 个单周期残差，sd 0.460 W），
窗口均值只能分辨约 0.20 W；`period_averaged.sem_w = 0.028 W`（21 个点）。
所以 0.49 W 的缺口本身远大于分辨率，但**它随步长移动的部分**（0.008 W）不可引用，
这正是 §3 只留下 0.49 W 这个结论的原因。

## 5. 133 周期相位对齐判定 run

`phase_alignment()` 给出 50 V/120 A 最短对齐窗口：
门极 200.622 kHz 与谐振腔 202.131 kHz 的拍频 1509.02 Hz ⇒ **133 个门极周期 = 662.94 µs**，
相位误差 0.14°。`vin50_i120_cin_aligned` 变体只把 `.tran` 的 Tstop 从 1000u 改到 1550u，
`Tstart=880u`、`VIN=50`、`RL=16.3m`、最大步长 5 ns 全部不动，所以它采样的是同一个
已稳定的工作点，只是窗口从 22 个周期拉长到 133 个。该 deck 于 2026-11-02 跑完：
**459.978 s、raw 2.266 GB、80 变量、保存轴 0–670 µs**（raw 头 `Tstart=880 µs`）。

这条 run 的目的是把"短窗端点/相位伪影"与"真实缺口"分开。结果写入
`energy_ledger_50v_120a_aligned.json`：

| 量（均为 5 ns） | 22 周期 / 110 µs | **133 周期 / 663 µs** | Δ |
|---|---|---|---|
| `Pin = 50·mean(I(Rin))` | 247.4212 W | 247.3480 W | −0.0732 W |
| `Pout = mean(Vout²/RL)` | 231.8739 W | 231.7345 W | −0.1394 W |
| 端口损耗 | 15.5473 W | 15.6135 W | +0.0662 W |
| 分项损耗合计 | 15.0487 W | 15.1215 W | +0.0728 W |
| **损耗残差** | **0.4986 W** | **0.4921 W** | **−0.0065 W** |
| `driver_w`（端口外） | 0.2061 W | 0.2061 W | 0.0000 W |
| 单点储能差折算 | 0.0339 W | 0.0008 W | −0.0331 W |
| 闭合残差（单点） | 0.6708 W | 0.6973 W | +0.0265 W |
| 闭合残差（周期平均） | 0.7131 W | 0.6984 W | −0.0147 W |
| 分辨率 `sem_w` | 0.098 W | **0.0499 W** | — |

**判定：0.499 W 不是短窗伪影。** 窗口拉长 6 倍后，端口项与分项各自移动 +0.066 / +0.073 W
（同向、几乎抵消），而 ELE-09 要核对的量——端口减分项——只移动 **−0.0065 W（−1.3 %）**。
长窗的 `sem_w` 是 0.0499 W（`periods_for_target` = 9，窗口有 133 个周期），
即这个窗口**能够分辨 0.2 W**，而读数 0.4921 W 在门限外 2.4 倍。所以差额既不是端点相位，
也不是积分窗长，而是**稳定的账本/模型边界差**。

两点必须同时读到：

- 长窗只有 **5 ns** 一列（仓里没有 50 V/120 A 的 aligned 2 ns 伴随 deck），所以"步长稳定"
  只由 §3 的 22 周期 5/2 ns 对支持，不能当作长窗上的独立验证；
- 长窗的闭合残差（0.698 W 周期平均）比 22 周期的 0.496 W 大，原因是两窗的平均输出电压不同
  （`Pout` 折算 1.9435 V 对 1.9441 V），且 `driver_w` 0.2174 W 是闭合式里的一整项。
  把 §3 的两个修正同样用到长窗上（门极边界 0.2174 W，储能参数修正在此 span 上约 −0.0003 W），
  得到约 **0.481 W**——与 22 周期的 0.4961 W 同量级。**不同窗口的闭合残差不可直接相减**，
  能跨窗口比较的是损耗残差。

因此 0.2 W 门限不动，`closure_status` 仍是 **NOT_CLOSED**，这条 run 的效率不可引用；
缺口的物理来源已按 §7 清点：deck 里没有能容纳 0.49 W 的未计入元件（上限约 1 mW），
所以它不是漏项；剩余候选只有端口读数边界与行为模型积分误差两类，不能靠换窗口消掉。

> 判定所用 raw 为 `sim/v3/sr_tank_dual_v33_ss_1ms_vin50_i120_cin_aligned.raw`
> （459.978 s、2.266 GB、80 变量、保存轴 0–670 µs）。重算命令见 §6。

## 6. 电阻性元件清点：0.49 W 不是"漏掉一个元件"

§5 留下的开放项是"是否有未建模的损耗进入端口"。这一节把 deck 本身清点完：
任何能产生导通损耗的元件，要么被 `loss_terms()` 的某一项测到，要么有一条量化到
mW 级的排除理由。`tools/test_loss_inventory_is_complete.py` 把这张表锁住——
新增或改名一个耗散元件而不更新映射，测试直接红（已验证：加一行 `Rsnub` 会被报出）。

| 元件 | deck 行 | 账本项 / 排除理由 |
|---|---|---|
| `Rin` 1 mΩ | `Rin vin0 vin 1m` | `rin`（实测 0.0628 W） |
| `Cr` 3 mΩ | `Cr ... Rser=3m` | `cr_esr` |
| `Cout` 0.2 mΩ | `Cout ... Rser=0.2m` | `cout_esr` |
| `Lr` 5 mΩ | `Lr ... Rser=5m` | `lr` |
| `Lp1–Lp4` 各 3 mΩ | 四只串联 | `lp_series`（4×3 mΩ） |
| `Lsa*/Lsb*` 各 0.15 mΩ | 八只半绕组 | `secondary_copper`（pair1 实测 ×4） |
| `SH/SL` `Ron=8m` | `.model PRI_SW` | `sh` / `sl` |
| `DH/DL` 体二极管 | `.model BODY_P` | `dh` / `dl` |
| SR 体二极管 `RS=1m` | `sr_device_v3.lib` | 已含在 `sr_channel_body`（测的是二极管两端电压） |
| CT 整流管 `Rs=.3` | `.model DSCH` | `ct_bridge_diodes`（按每只管子两端电压测） |
| `Rbur` 10 Ω | `Rbur ocd ocm 10` | `ct_burden_resistor` |
| `Rload` | `Rload out sgnd {RL}` | `Pout = mean(Vout²/RL)` |
| **`Cin` 5 mΩ** | `Cin ... Rser=5m` | **未计**：本 run 同一条 raw 实测 `I(Cin)` 交流 RMS **0.3493 A** ⇒ **0.61 mW** |
| **`Cbt` 50 mΩ** | `Cbt ... Rser=.05` | **未计**：模型里没有电荷经过它（`Bgh` 只读 `V(hb,sw)` 的值） |
| `Rgh/Rgl/RgsH/RgsL` | 门极网络 | 由理想 B 源驱动，能量不经端口 |
| `SR_TIMING` 的 `Rg`/`Rgs` | 时序库内部 | 同上（外部驱动） |
| `Rdt/Rrt` 5.36k/976 | 控制器外围 | 由 `Vaux` 供电 |
| `Rf/Rd1/Rd2` 1k/10k/24k | OC 滤波 | 只走约 20 µA 直流 ⇒ 约 14 µW |
| `Rss_dc` 1 GΩ | 占位 | 可忽略 |

**两个未计入的电阻加起来不超过 1 mW，而缺口是 492 mW——相差约 800 倍。**
所以 0.49 W 不可能是"清单漏了一个耗散元件"。

能容纳 0.49 W 的只剩两类，而且两类都已经被本族数据量到过同量级：

1. **端口读数边界**。§2 已经量到：22 周期窗口上 5→2 ns 只让平均 `V(out)` 动 −0.713 mV，
   `Pout` 就动 −0.170 W；按同一灵敏度（`2·V/RL = 236 W/V`），0.49 W 只对应约
   **2.1 mV** 的平均输出电压读数差。长窗把窗口拉长 6 倍并不能保证这 2 mV。
2. **行为模型的积分误差**。同一个 `sr_channel_body_x4` 在 100 A 的四段步长上摆
   **2.30 W**（§4），比 0.49 W 大 4.7 倍。

因此正确写法是：**0.49 W 属于端口/数值边界，不是未建模的物理损耗**。它既不能证明
"账本已闭合"，也不能反过来证明"有一个真实损耗被漏掉"。0.2 W 门限、`NOT_CLOSED`
与"效率不引用"三条都不变。要真正判定，得**先把工作点钉住**再
做步长比较：100 A 的四档本来就落在四个略有差别的工作点上（`V(out)` 窗口均值差 19.2 mV、
SR 门极导通时间差 141.7 ns），而同一 raw 内换求积规则只让二极管电荷动 0.80 %、跨档却差 86 %
（`design/v3/stage_f/sr_step_operating_point.json`）——所以"重新积分"不会收敛，继续减步长也已被证伪。
**恒流负载试过了**：它能把 `I_out` 钉在同一个 100 A（5 ns 档与电阻档逐项相差不到 0.3 %，
说明替身忠实），但 0.5 ns 档仍高 15.1 mV，5→0.5 ns 的端点损耗差保留 98.9 %
（`sr_step_operating_point_csink.json`；只跑了两个端点，不是四档 2.3 W 摆幅）——钉住的是电流，
不是 `V(out)`。真正能钉住工作点的只剩闭环 `V(out)`，那是另一个 deck，不在本记录范围内。

## 7. 复现

```bash
# 22 周期两列账本（5 ns 与 2 ns 只有 .tran 步长不同）
python tools/energy_ledger_100a.py \
  --raw sim/v3/sr_tank_dual_v33_ss_1ms_vin50_i120_cin.raw --periods 22 \
  --vin 50 --rl 0.0163 --compare-raw sim/v3/sr_tank_dual_v33_ss_1ms_vin50_i120_cin_2n.raw \
  --json design/v3/power_priority/energy_ledger_50v_120a_steps.json
python tools/sr_loss_audit.py --case candidate_50v_120a candidate_50v_120a_2ns \
  --compare candidate_50v_120a candidate_50v_120a_2ns \
  --json design/v3/power_priority/sr_loss_audit_50v_120a_steps.json

# 133 周期相位对齐判定窗口（5 ns；无 2 ns 伴随 deck）
python tools/energy_ledger_100a.py \
  --raw sim/v3/sr_tank_dual_v33_ss_1ms_vin50_i120_cin_aligned.raw --periods 133 \
  --vin 50 --rl 0.0163 --no-step-check \
  --json design/v3/power_priority/energy_ledger_50v_120a_aligned.json
```
