czy0126/CZY/design/v3/stage_f/SR步长_操作点_2026-11-02.md

# 100 A 四档步长的 SR 损耗差：工作点漂移，不是积分规则

> 工具 `tools/sr_step_operating_point.py`，记录 `design/v3/stage_f/sr_step_operating_point.json`
> 与 `sr_step_operating_point_csink.json`。
> 数据是本地六条相位对齐 raw（四档电阻负载 + 恒流负载的 5 / 0.5 ns），各 133 个门极周期，
> **raw 不入 Git**，本记录可复算。
> 本文只解释"为什么再减步长看不到平台"，不改变任何效率、闭合或 SOA 结论。

## 1. 要回答的问题

`sr_loss_audit` 的四档结论是：SR 体二极管正向项 6.954 / 7.575 / 6.205 / 5.272 W，
四段摆幅 **2.303 W**，占总损耗摆幅的 137 %；其余 12 项四段合计只动 0.105 W。
当时的下一步建议是"换方法：按门极边沿对齐的定步长积分"。

这个建议隐含一个假设：**差异来自积分**（同一波形、不同求积规则）。本工具直接测这个假设。

## 2. 积分规则不能解释它

对每一条 raw，在同样的门极周期上把 `∫I(Dbd) dt` 用三种规则各算一遍
（梯形用原始采样，中点用相邻点平均，10× 抽取每 10 点取一点），记录同一周期内的最大相对差：

| 步长 | 三种求积规则的最大相对差（电荷） | 同一 raw 的 10× 抽取差（损耗被积函数） |
|---|---|---|
| 5 ns | **0.62 %** | 3.08 % |
| 2 ns | **0.36 %** | 3.17 % |
| 1 ns | **0.80 %** | 8.83 % |
| 0.5 ns | **0.79 %** | 13.16 % |

同一条 raw 内换规则最多动 **0.80 %**；而四条 raw 之间的电荷差是
**3.533 / 4.096 / 2.938 / 2.202 µC，最大/最小 −1 = 86 %**。
两者相差约 **100 倍**。

⇒ 电荷差在**波形本身**，不在积分。把同一批采样点重新求积不会让它收敛。

**一句必须同时说的话**：损耗积分 `∫(−v_ds·I) dt` 的被积函数在换流瞬间有多米诺式的尖峰，
10× 抽取给出的差是 **13.2 %**，所以那一列只能当"粗糙求积很差的探针"，不能当证据；
本条结论立在**电流电荷**上，它的被积函数是平滑的。

## 3. 四条 raw 并不在同一个工作点

100 A 母 deck 是**电阻负载、没有输出电压环**：`V(out)` 落在模型自身损耗平衡给出的位置。
四档里它并不相同：

| 步长 | 窗口平均 `V(out)` | SR A 相门极 >5 V 时间 | 二极管正向电荷（A 相） | 二极管正向损耗（A 相） |
|---|---|---|---|---|
| 5 ns | 1.88943 V | 1943.5 ns | 3.533 µC | 0.4902 W |
| 2 ns | 1.88476 V | 1921.6 ns | 4.096 µC | 0.5795 W |
| 1 ns | 1.89801 V | 2017.9 ns | 2.938 µC | 0.4048 W |
| 0.5 ns | 1.90401 V | 2063.3 ns | 2.202 µC | 0.2950 W |

- `V(out)` 摆幅 **19.2 mV（1.0 %）**，门极导通时间摆幅 **141.7 ns（7 %）**。
- 单相二极管损耗 0.295–0.579 W，×8（四组 × 两半）后 **2.28 W**，与 `sr_loss_audit` 的四段摆幅
  **2.303 W** 同量级——两把独立的尺子量到的是同一个现象。
- 四个点上二极管损耗随 `V(out)` **反向单调**：`V(out)` 最低的 2 ns 档损耗最高，
  `V(out)` 最高的 0.5 ns 档损耗最低。

⇒ 四条 raw 是**四个略有差别的工作点**，不是同一点上的四次离散化。把它们当收敛序列读，
等于把"负载变了 1 %、SR 导通占空变了 7 %"记成"数值不收敛"。

**不确定性必须写明**：这是 4 个点的秩关系，不是因果证明；本工具只量了 pair 1 的 A 相，
B 相没有独立测。它能支持的只是"工作点确实不同、且与 SR 分项的变化方向一致"。

### 3.1 敏感度：这个量级的漂移足以解释整个摆幅

把单相二极管损耗 ×8 的四档摆幅除以 `V(out)` 摆幅，得 **118.3 W/V**；同一个 100 A 负载的
端口灵敏度 `dP/dV = 2V/RL` 是 **200.4 W/V**。两者只差 **1.7 倍**——在这个工作点上，
**SR 体二极管损耗对 `V(out)` 的敏感度和端口功率本身同量级**，1 mV 的平均 `V(out)` 对应
约 **0.12 W** 的 SR 损耗（×8 口径）。

反过来说 50 V/120 A 的账本：那条 deck 的端口灵敏度是 **236 W/V**（`2 × 1.90 V / 16.3 mΩ`），
所以 **0.492 W 的缺口只对应 2.1 mV 的平均 `V(out)` 差**。若把 100 A 上测到的 118 W/V
按同阶搬过去，2.1 mV 就对应约 **0.25 W** 的 SR 损耗变化——**是缺口的一半**。

⇒ 缺口的大小落在"`V(out)` 读数精确到 mV"这个分辨率之内。这不能证明缺口就是读数误差，
但足以说明：**在把工作点钉住之前，任何一项损耗的绝对值都无法被论证到 0.2 W**，
更不能反过来拿四档数据去"证伪"0.2 W 目标。

（118 W/V 是 4 个点定出的斜率，不是因果律；它支持的只是"量与量同阶"。
 端口灵敏度用 deck 自己的 `RL` 算，不是拟合值。）

### 3.2 先把工作点钉住：两种电压式钉法都不成立

按 §4 第 2 条先试了两种"钉住 `V(out)`"的负载，都失败，记录在此以免重复：

| 负载 | 结果 | 读数 |
|---|---|---|
| 理想电压源 `Vload out sgnd 1.88943` | 二次侧**全程未导通** | `V(ga1)` 峰 0.12 V、`I(xsa1:Dbd)` 峰 3 mA、`I(Lr)` ±0.77 A、`I(Rin)` 均值 −0.05 A |
| 调节式电流阱 `I = max(1053·(V−1.889), 0)` | 停在自身拐点，负载电流为 0 | `V(out)` 1.7944 V、`I(Bload)` 0.0000 A、`I(Lr)` ±0.76 A |

原因同一个：**这个 deck 的 SR 控制器是"负载触发"的**——体二极管先导通（漏源反偏）才启动，
而空载时变换器只到 1.794 V（两只体二极管整流，`V(ga1)` 始终不过 0.12 V）。
理想电压源从 t=0 把中心抽头钳在 1.889 V，电流阱则要 `V(out)` 先到 1.889 V 才肯要电流；
两者都让体二极管没有导通机会，SR 不启动、二次侧开路。

⇒ 任何"低压段就要电流"的负载会把工作点拖离 100 A；任何"高压段才要电流"的负载则等不到 SR 启动。
可行的方向只剩下**恒流负载**：它不要求 `V(out)` 先到某个值，而是直接规定电流，
让 `V(out)` 自己落到变换器特性给出 100 A 的位置。

### 3.3 恒流负载：钉住了电流，没有钉住工作点

第三种负载是**斜坡恒流阱**：`Iload out sgnd PWL(0 0 500u 0 750u 100)`——
500 µs 前为 0（冷启动与电阻负载完全一样），750 µs 后把 `I_out` 固定在 100 A。
两档都跑满对齐窗口（133 个门极周期）：

| 步长 | 用时 / raw | `V(out)` 均值 | 门极 >5 V | 二极管电荷 | 二极管损耗 | 窗口内半程漂移 |
|---|---:|---:|---:|---:|---:|---:|
| 5 ns | 325.6 s / 2.42 GB | 1.888874 V | 1943.2 ns | 3.524 µC | 0.48876 W | 4.70 mV |
| 0.5 ns | 695.4 s / 3.64 GB | 1.904006 V | 2057.9 ns | 2.205 µC | 0.29634 W | 0.05 mV |

**先校验替身**：5 ns 档与电阻负载的 5 ns 档相比，`V(out)` 差 **−0.56 mV**、
门极时间差 **−0.34 ns**、电荷差 **−0.25 %**、损耗差 **−0.29 %**——它落在同一条工作点上，
所以两档之间的差别不能归给"换了负载"。这句必须带限定：两个 5 ns 档**自身**的窗口内漂移
是 4.70 / 2.47 mV，所以这是一次一致性校验，不是精度证明。
0.5 ns 档两者甚至逐位接近（1.904006 vs 1.9040058 V，差 0.5 µV，而各自漂移 0.05 / 0.51 mV）
——负载少要 0.74 A 在这个工作点上几乎不动平均值。

**结果**：`I_out` 钉在同一个 100 A，0.5 ns 档的 `V(out)` 仍比 5 ns 档高 **15.13 mV**，
单相二极管损耗低 **0.192 W**（×8 = **1.54 W**）。与电阻家族**同一对步长**（5 → 0.5 ns）
的端点差相比，四项比值是 **1.038 / 0.958 / 0.994 / 0.989**
（`V(out)` / 门极时间 / 电荷 / 损耗）——几乎原样保留。

⇒ 步长之间的损耗差**不是负载电流造成的**：电阻家族的电流差按 `V(out)/RL` 算只有约
**1 A（1.0 %）**，而把它彻底消掉之后，端点差只动了 **1.1 %**（损耗）与 **3.8 %**（`V(out)`）。
在同一个 `I_out` 上，模型的 `V(out)` 自己就随步长移动 15 mV，SR 损耗跟着它移动。

**斜率**：固定电流下 1.539 W / 15.13 mV = **101.7 W/V**；电阻家族四点是 **118.3 W/V**。
两条互相独立的路径（换负载 vs 换步长）给出同量级的敏感度（差 14 %），
支持"损耗跟着 `V(out)` 走、而 `V(out)` 是模型工作点的一部分"这个解释。

**必须一起引用的限定**：

- 恒流阱钉住的是电流，不是工作点。5 ns 档窗口内半程漂移 **4.70 mV**，比它自己的 0.5 ns 档
  （0.05 mV）和电阻 5 ns 档（2.47 mV）都大——负载 750 µs 才到位，输出还在缓慢收敛。
  4.70 mV 小于它要解释的 15.13 mV（`checks` 的门是"漂移 < 效应"，不是绝对阈值），
  但按 101.7 W/V 折算，它给端点比较引入约 **0.5 W** 的不确定度。
- 只跑了两个端点（5 / 0.5 ns）。中间两档没有恒流版本，所以"四档摆幅 2.30 W"
  仍只能由电阻家族给出；恒流家族能说的是**端点差没有被电流解释掉**。
- 单相、pair 1 A 相。B 相与 pairs 2/3 仍无独立测量（同 §3 的限定）。

## 4. 这对下一步意味着什么

1. **后处理不解决问题**：同一批采样的求积规则已经排除（§2）。
2. **恒流负载已经试过，也不解决问题**（§3.3）：它忠实（5 ns 档复现电阻档到 0.3 % 以内），
   但只证明电流不是原因——`V(out)` 仍随步长移动 15 mV、损耗差保留 98.9 %。
3. **钉住电压在当前模型里做不到**：§3.2 的两种电压式负载都因 SR 负载触发启动而失效。
   要真正把 `V(out)` 钉住，得在变换器侧加**闭环**（调频/调占空），那是另一个 deck，不是换负载。
4. 若之后仍要换求解方法，那也是**求解器的定步长**（消除自适应步长对换流事件的时序抖动），
   而不是对现有 raw 重做积分。两者不是一回事。

## 5. 不变的东西

- `sr_loss_audit.json` 的 `NOT_CLOSED`、0.2 W 目标、以及"任何单个损耗项不许引用得比 0.6 W 更细"
  （四档连起来约 2.3 W）全部不变；本记录只是把"不收敛"里的一个可排除项划掉，
  并把剩下的部分指向工作点与 SR 时序。
- 不引用任何效率；不据此改动 `energy_ledger_100a.py` 的定义；不把四档数据当额定证据。
