czy0126/CZY/design/v3/power_priority/50V110A_120A_实测_2026-11-02.md

# 50 V / 110 A 与 50 V / 120 A 的首次 LTspice 仿真测量 — 2026-11-02

> **证据说明：全部数值来自 LTspice 行为模型的波形与端口计算，不是 PCB、样机或器件实测。** 文件名沿用本目录既有的“实测”用词以便检索；对外统一称“仿真测量”。两份 deck 的头注仍是 `UNRUN, NO HW RATING`——生成器每次从母 deck 重建它们，运行证据只存在于本文和 JSON。
> 工作点：`operating_point_50v_110a.json`、`operating_point_50v_120a.json`
> 应力：`stress_50v_110a.json`、`stress_50v_120a.json`
> 效率/闭合：`energy_ledger_50v_110a.json`、`energy_ledger_50v_120a.json`
> 闭合边界审计：`sr_loss_audit_50v_110a.json`、`sr_loss_audit_50v_120a.json`
> Cr：`cr_stress_50v_110a.json`、`cr_stress_50v_120a.json`
> 锁死：`tools/test_operating_point_50v.py`

## 1 这次跑的是什么

两份探针 deck 都以 48 V 高输出母 deck 为母本，**只改 `.param VIN/RL`**，`.save` 块整块换成 100 A 账本 deck 的那一块（80 变量，含 `I(Cin)`/`I(Rin)`）：

| 工况 | deck | `.param` | `.tran` | 运行时长 | raw |
|---|---|---|---:|---:|---:|
| 50 V / 110 A | `sim/v3/sr_tank_dual_v33_ss_1ms_vin50_i110_cin.cir` | `VIN=50 RL=17.8m` | `0 1000u 880u 5n uic` | **208.138 s** | **404 618 104 B** |
| 50 V / 120 A | `sim/v3/sr_tank_dual_v33_ss_1ms_vin50_i120_cin.cir` | `VIN=50 RL=16.3m` | `0 1000u 880u 5n uic` | **213.785 s** | **409 962 124 B** |

提取窗口都是最后 22 个门极周期（raw 时间轴 7.63–117.30 µs；显示偏移 880 µs）：

| 量 | 50 V / 110 A | 50 V / 120 A |
|---|---:|---:|
| 工作点窗口（`extract_op_point`） | 7.6356–117.2976 µs | 7.6380–117.3045 µs |
| 账本/应力窗口（对齐到门极周期） | 7.6292–117.2913 µs | 7.6316–117.2982 µs |
| 频率 | **200.6165 kHz** | **200.6081 kHz** |

两个窗口都是“最后 22 个完整门极周期”，但端点相差几微秒：工作点工具从末尾回推周期边界，账本工具要求窗口两端落在门极边沿上。**同一张表里不要混用两套端点**——算 `Pout`/闭合时用的都是账本窗口。120 A 的 `stress_50v_120a.json` 与 `cr_stress_50v_120a.json` 首次生成时误用了工作点窗口，已在 2026-11-02 按账本窗口重跑；本文 §3 的数值与重跑后的 JSON 一致。

**“110 A”/“120 A”是负载电阻的目标，不是结果。** 17.8 mΩ / 16.3 mΩ 由线性外推选出，实际输出分别是 **109.64 A / 119.27 A**。`test_the_record_carries_the_measured_current_not_the_target` 在这一族上禁止把它们写成 110.0 A / 120.0 A。

`✶ Insight ─────────────────────────────────────`
50 V 下 Vout 比 48 V 高（1.9516 V 对 1.8786 V），所以同一只 17.8 mΩ 负载得到的是 109.6 A 而不是 111 A：LLC 近似定比，输入升 2 V 会把输出也抬起来。选负载电阻时必须用实测 Vout 回代，否则“120 A 目标”会系统性偏低。
`─────────────────────────────────────────────────`

## 2 工作点

| 量 | 48 V / 111.2 A | **50 V / 109.6 A** | 48 V / 121.7 A | **50 V / 119.3 A** |
|---|---:|---:|---:|---:|
| Vout 平均 | 1.8786 V | **1.9516 V** | 1.8737 V | **1.9441 V** |
| Iout（avg(Vout)/RL） | 111.16 A | **109.64 A** | 121.67 A | **119.27 A** |
| Pout（avg(Vout²/RL)） | 208.835 W | **213.992 W** | 227.978 W | **231.874 W** |
| 输出纹波（22 周期） | 41.21 mVpp | **45.41 mVpp** | — | **41.04 mVpp** |
| I(Lr) RMS | 10.267 A | **10.168 A** | — | **11.059 A** |
| I(Lr) 峰值 | 14.351 A | **14.479 A** | — | **15.426 A** |
| 每组 Iout（pair 1） | 27.753 A | **27.357 A** | — | **29.819 A** |
| 每组 Irms（pair 1） | 30.641 A | **30.340 A** | — | **33.022 A** |
| SR 正向峰值 / 只 | 42.99 A | **43.29 A** | — | **46.12 A** |
| SR 反向峰值 / 只 | 5.341 A | **5.422 A** | — | **5.569 A** |

两组仪器之和 ×2 与 `avg(Vout)/RL` 的差：110 A 为 −0.20 %、120 A 为 +0.005 %。**这个差不是均流**，`iout_spread` 只有 5×10⁻⁹ %，因为模型四组结构对称。−0.20 % 的残差里含 CT 整流桥+负载从 `Vout` 取走的约 0.1 A，重建只数了四路 SR 电流，两者本来就不完全同口径。

输出纹波**不是负载的单调函数**：120 A 的 41.04 mVpp 反而低于 110 A 的 45.41 mVpp。四组同相驱动，纹波与门极/谐振拍频的相对相位有关，所以不能按“电流更大→纹波更大”外推。110 A 的 45.41 mVpp 离自选的 50 mV 目标只剩 4.6 mV 余量，这一点在引用时必须写明。

## 3 逐项应力

| 项 | 50 V / 110 A | 50 V / 120 A | 判据 | 结论 |
|---|---:|---:|---|---|
| SR Vds 最大 / 最小 | **+5.699 / −1.292 V** | **+5.516 / −1.290 V** | 40 V | 14 %，不是瓶颈 |
| SR 栅源 | **−0.672 … +10.958 V** | **−0.685 … +10.948 V** | ±20 V | 正常 |
| SR 每只损耗（八只合计 ÷ 8） | **1.094 W** | **1.242 W** | 热设计暂缓 | 通道 0.419 + 体二极管 0.675 |
| SR 八只合计 | **8.754 W** | **9.934 W** | — | 对称假设，只有 pair 1 有仪器 |
| OC 引脚 `V(oc)` 最大 | **0.628 V** | **0.682 V** | Level-1 1 V | 62.8 % / 68.2 % |
| Cr 峰值 | **43.79 V** | **45.00 V** | 100 V | 2.28× / 2.22× |
| Cr 峰峰 | **37.61 V** | **40.05 V** | — | |
| Cr 电流 RMS | **10.168 A** | **11.059 A** | ≤9.67 / 8.18 mΩ 保 1 W | 与 I(Lr) 同 |
| Cout 纹波 RMS | **52.48 A** | **56.75 A** | 15 只 bank 175 A（件数据未核实） | ESR 仍是选型主导 |
| Cout 纹波峰值 | 132.9 A | 143.2 A | — | |
| 原边稳态磁通（2 匝） | **0.0557 T** | **0.0593 T** | 0.9·Bsat = 0.279 T | 稳态，不含故障 |
| 输入平均电流 | **4.543 A** | **4.948 A** | — | 端子/母排按此与峰值校核 |
| 半桥输入电流 AC RMS | **5.826 A** | **6.294 A** | — | `I(Rin) − I(Cin)`，去均值 |
| Cin 自身 AC RMS | **0.336 A** | **0.347 A** | — | **不能当选型依据**：源阻抗 1 mΩ，纹波走电源 |

几点口径必须写清楚：

1. **`sr_vds` 是保存的漏极节点电压**。本族 deck 里每只 SR 的源极都是公共 `sgnd`（`Xsa1 da1 ga1 sgnd SR_DEVICE`），所以 `V(a1)` 就是 Vds；不要把它再减 `V(out)`。`stress_*.json` 里的 `reference` 字段锁住这个前提。
2. **OC 脚不是 `V(ovl1)`**。日志里 `ovl_cur` 读到 1.553 V（110 A）/ 1.311 V（120 A），那是同一组两路 SR 同时正向导通的**安培数**，不是过流脚；真正的过流节点是 `V(oc)`，两个工况都低于 1 V 门槛。
3. **Cin 的 0.336 A 是模型假象**。20 µF 在 200 kHz 是 40 mΩ，而电源串的是 1 mΩ，纹波几乎全走电源。输入电容选型要用半桥电流 AC RMS **5.826 A / 6.294 A**，不是 Cin 支路电流。与 48 V/100 A 的 5.316 A 同一定义。
4. **Cout 纹波由四路 SR 电流重建**，pair 2/3 按对称 ×2。采信 RMS 前已校验重建均值与 `avg(Vout)/RL`（见 §2）。

## 4 效率与闭合

| 量 | 50 V / 110 A | 50 V / 120 A |
|---|---:|---:|
| `Pin = 50 × mean(I(Rin))` | **227.150 W** | **247.421 W** |
| `Pin` 扣 `I(Rin)²·1 mΩ` | 227.097 W | 247.358 W |
| `Pout = mean(Vout²/RL)` | **213.992 W** | **231.874 W** |
| **仿真端口效率** | **94.207 %** | 93.716 %（**不可引用**） |
| 损耗清单合计（含 CT 两项） | 13.104 W | 15.049 W |
| `Pin − Pout` | 13.158 W | 15.547 W |
| 损耗残差（清单 vs 端口） | **+0.054 W** | **+0.499 W** |

**两个工况的损耗残差不是一个量级，不能只报 110 A 那个。** 120 A 的 +0.499 W 超出 0.2 W 目标（`results.loss_residual_within_0p2_w = false`）；它不是闭合残差，而是“已知损耗项加起来还不够解释端口差”。**账本自己的 `limits` 因此写着“loss residual exceeds 0.2 W; do not quote an efficiency from this run”**——表里 93.716 % 只作定位用，不构成可引用的效率。可能的缺口来源是未建模项（磁芯、SR 封装/PCB）或窗口内某项的系统误差；本文不猜。

ELE-09 随后做了同窗 5/2 ns 对照：22 周期残差随**端口项**移动 +0.410 W，分项清单只移动 +0.100 W（其中 SR 项 +0.087 W）；修正门极边界与储能参数后，闭合残差在 5 ns / 2 ns 分别为 **0.496 / 0.488 W（周期平均）**，步长稳定但仍在 0.2 W 外。因此 0.499 W 不是漏掉的某个分项，也不是 5 ns 伪影。详见 `50V120A_损耗差额与步长_2026-11-02.md` 与 `energy_ledger_50v_120a_steps.json`。

含储能的闭合残差按三个边界分别列出（单位 W）：

| 边界 | 50 V / 110 A 单点 / 周期平均 | 50 V / 120 A 单点 / 周期平均 |
|---|---:|---:|
| 账本工具（母 deck 常数 4 mF / 0.92 µH） | **+0.506 / +0.581** | **+0.671 / +0.713** |
| 按 deck 实际 `Cout=7.05m`、`LR_TOTAL=1u` 修正 | **+0.698 / +0.780** | **+0.648 / +0.714** |
| 再扣除门极边界 `Rg/Rgs/CPin`（实测 0.2174 W） | **+0.480 / +0.563** | **+0.430 / +0.496** |

三个边界都远在 0.2 W 之外，`closure_status` 保持 **`NOT_CLOSED`**。修正量由 `sr_loss_audit.py --case candidate_50v_*` 从 deck/raw 读出后线性叠加，不是手算：

```
python tools/sr_loss_audit.py --case candidate_50v_110a \
  --json design/v3/power_priority/sr_loss_audit_50v_110a.json
```

**为什么必须分三行**：账本工具把候选 deck 的储能按母 deck 的 4 mF / 0.92 µH 积分，而候选跑的是 7.05 mF / 1 µH；这一步差 0.19 W 左右，不能忽略。门极边界是另一个记账口径（`loss_main` 不含栅阻，`driver_w` 却计入整个驱动源）。三行不是同一个物理量，引用必须写明是哪一行。

**对外引用：110 A 只写 94.2 %；120 A 不引用效率**（它的损耗残差自己就超 0.2 W）。理由还包括 22 周期窗口的逐周期残差 sd 是 1.871 W / 0.460 W、标准误 0.399 W / 0.098 W，且两个数都不含磁芯损耗、输出铜排/接点、偏置完整归属与结温。

## 5 50 V 专项检查

- **Cr 直流偏置**：`mean(v_Cr) = mean(V(sw))` 实测 **24.98 V / 25.03 V**，正好是 VIN/2。峰值为 43.79 V / 45.00 V。**表里的 100 V 是 `cr_stress.py` 的默认参考耐压 `V_RATED_V`，不是已选器件的规格**；实际件的耐压定下来后必须用 `--v-rated` 重算，2.28× / 2.22× 只是“对 100 V 参考”。约束仍是 200 kHz 的 ESR/发热，不是耐压。
- **输入端子**：平均 4.543 A / 4.948 A，半桥 AC RMS 5.826 A / 6.294 A。50 V 只比 48 V 高 4.2 %，输入端子的电流等级没有跳变，但 120 A 比 110 A 高约 8 %。
- **OC 余量**：0.628 V / 0.682 V 对 1 V 门槛，分别余 37 % / 32 %。这个余量随负载电流近似线性收缩；120 A 已到 68 %。
- **磁通**：按项目口径 `B = L·I/(N·Ae)`，`L` 取 1.0 µH（`lr_design.py` 的 `paired_flux` 用它跑的那只 `external_lr_h`，CORE `Ae=1.3e-4 m²`、2 匝），稳态峰值给出 **0.0557 T / 0.0593 T**，离 0.279 T 判据仍远（约 20 %）。**故障峰值不在本文范围内**——冷启动故障见 `48V120A_冷启动与故障_2026-11-02.md`；50 V 稳态初始化后的故障已跑（9.15×、trip 39.92 µs、原边峰 101.26 A、SR 303.93 A），但**求解器在 296.929 µs 塌缩、只有前缀**，见 `48V120A_稳态初始化故障_2026-11-02.md`。
- **输入电压裕度**：deck 的 `VIN=50` 是理想源；没有输入浪涌、线缆压降或 OVP 行为。50 V 不是额定输入，只是本轮工况。

## 6 不能下的结论

1. **不是硬件效率**：含外部输出路径 0.15 mΩ 时，50 V/119.27 A 会多耗约 2.1 W（换算，不是模型）；磁芯损耗也没有元件。
2. **不是 120 A 额定**：没有热数据、没有故障工况、没有真实均流、没有 SR 结温；SR 八只 9.93 W 仍是 27 °C 参数。
3. **不是 50 V 输入认证**：输入电容、端子温升、浪涌与保持时间都没有模型。
4. **账本未闭合**：三个边界都超 0.2 W；损耗清单在 120 A 自己也没对上（+0.499 W）。

## 7 复现

```bash
python tools/extract_op_point.py sim/v3/sr_tank_dual_v33_ss_1ms_vin50_i110_cin.raw \
  --rl 0.0178 --periods 22 --pairs 1 4 \
  --json design/v3/power_priority/operating_point_50v_110a.json
python tools/steady_stress.py --raw sim/v3/sr_tank_dual_v33_ss_1ms_vin50_i110_cin.raw \
  --from-us 7.629195812563637 --to-us 117.2912676221502 --vin 50 --rl 0.0178 \
  --json design/v3/power_priority/stress_50v_110a.json
python tools/energy_ledger_100a.py --raw sim/v3/sr_tank_dual_v33_ss_1ms_vin50_i110_cin.raw \
  --vin 50 --rl 0.0178 --periods 22 --no-step-check \
  --json design/v3/power_priority/energy_ledger_50v_110a.json
python tools/cr_stress.py --raw sim/v3/sr_tank_dual_v33_ss_1ms_vin50_i110_cin.raw \
  --from-us 7.629195812563637 --to-us 117.2912676221502 \
  --json design/v3/power_priority/cr_stress_50v_110a.json
```

120 A 把 `17.8e-3→16.3e-3`；工作点窗口换成 7.6380–117.3045 µs，账本/应力/Cr 窗口换成 7.6316–117.2982 µs。`.raw` 不入 Git（各约 0.4 GB）。

## 8 这一节能被证伪吗

`tools/test_operating_point_50v.py` 锁住：

| 测试 | 它防的是什么 |
|---|---|
| `test_the_record_carries_the_measured_current_not_the_target` | 把目标 110/120 A 写成结果 |
| `test_output_power_is_the_true_mean_of_the_square` | 用 `Vout_avg²/R` 冒充 `avg(Vout²/R)` |
| `test_the_oc_pin_is_below_the_trip_and_above_zero` | 把 `V(ovl1)` 当过流脚，或把 OC 写成已跳闸 |
| `test_the_cout_ripple_is_rebuilt_with_a_checked_mean` | 重建符号/比例错了还采信 RMS |
| `test_the_closure_is_reported_as_not_closed_at_every_boundary` | 只报账本那一行，或把门极边界当成“已闭合” |
| `test_the_fifty_volt_decks_are_the_mother_deck_plus_vin_and_rl` | 50 V deck 漂变成另一个电路 |
