czy0126/CZY/design/v3/power_priority/48V110A_实测_2026-11-01.md

# 48 V / 110 A 候选的首次 LTspice 仿真测量 — 2026-11-01

> **2026-11-02 数值审核纠错（已重算，替换旧短窗口统计）：** 原 `tools/energy_ledger_100a.py` 的候选工况总窗口正确使用本工况 VIN/RL，但 `window_terms()`、逐周期 `residual_noise()` 和 `averaged_residual_noise()` 没有透传 VIN/RL，误用基准 **18.9 mΩ**。修正版脚本已把 VIN/RL 透传到全部子窗口与统计量，并在保留原始 `.raw` 的本机重跑本记录的 JSON（`diagnostic_integrity.status = RECOMPUTED_WITH_REQUESTED_VIN_RL`）。重算后短窗残差为 **+0.174 W（22 周期）/ +0.715 W（8 周期）/ +0.477 W（12 周期）**，逐周期 sd 0.729 W、sem 0.155 W；旧 +22 W “缺口”是 RL 泄漏造成的假象，作废。端到端口径 `Pin/Pout`、主窗损耗与闭合残差未变，账本仍 `NOT_CLOSED`（+0.559 W，周期平均 +0.591 W）。

> **证据说明：全部数值来自 LTspice 仿真模型的波形/端口计算，并非实际 PCB 或样机测量。文件名保留历史“实测”用词以兼容已有引用；对外统一称“仿真测量”。**
> 记录：`design/v3/power_priority/operating_point_48v_110a.json`
> 提取：`python tools/extract_op_point.py sim/v3/sr_tank_dual_v33_ss_1ms_vin48_i110.raw --rl 0.0169 --periods 22 --pairs 1 4`
> 锁死：`tools/test_operating_point_110a.py`
> 效率记录：`design/v3/power_priority/energy_ledger_48v_110a.json`（探针 deck `..._vin48_i110_cin.cir`，**只差 `.save` 块**，241.213 s、486.8 MB）
> 锁死：`tools/test_energy_ledger_48v_110a.py`
> 上游：`docs/D1_电气优先_增输出与设计整改_2026-11-01.md`（P0-高输出验证）

## 1 这次跑的是什么

deck 是 `sim/v3/sr_tank_dual_v33_ss_1ms_vin48_i110.cir`：以 `_phys` 物理 deck 为母本，
**只改 `.param VIN/RL`**，控制器、SR 行为、Lr/Cr、保护、启动模型一行没动
（`tools/test_make_high_output_decks.py` 锁住这一点）。头注仍写着
`UNRUN, NOT HARDWARE RATED` —— 那不是漏更新，是生成器每次从母 deck 重建该文件，
而测试要求这行必须存在。**运行证据因此只能放在本文与 JSON 里，不能写进 deck 头。**

| 项 | 值 |
|----|----|
| `.tran` | `0 1000u 880u 5n uic`（显示窗口 880–1000 µs，raw 轴 0–120 µs） |
| 运行时长 | **243.053 s** |
| raw | **359 MB**、248 757 点、59 变量（Git 忽略） |
| 提取窗口 | 22 个门极周期，raw 轴 7.643–117.308 µs |
| 频率 | 200.611 kHz |

## 2 仿真工作点

| 量 | 100 A（`_phys`） | **本次** | 比 |
|----|---:|---:|----:|
| Vout 平均 | 1.8844 V | **1.8786 V** | −0.31 % |
| Iout（avg(Vout)/RL） | 99.70 A | **111.16 A** | 1.115× |
| Pout（avg(Vout²/RL)） | 187.89 W | **208.83 W** | 1.111× |
| 输出纹波 | 36.07 mVpp | **41.21 mVpp** | 1.143× |
| I(Lr) RMS | 9.254 A | **10.267 A** | 1.109× |
| I(Lr) 峰值 | 12.979 A | **14.351 A** | 1.106× |
| 每组 Iout | 24.929 A | **27.753 A** | 1.113× |
| 每组 Irms | 27.592 A | **30.641 A** | 1.111× |
| SR 正向峰值 | 38.826 A | **42.986 A** | 1.107× |
| SR 反向峰值 | 5.221 A | **5.341 A** | 1.023× |

**"110 A" 是负载电阻的目标，不是结果。** 16.9 mΩ 由线性外推（假定 1.8586 V）选出，
实际输出 1.8786 V，于是负载电流是 **111.16 A**。要跑正好 110 A 得用 17.08 mΩ；
本记录报的是 111.2 A，`test_the_record_carries_the_target_and_not_just_a_round_number`
不允许把它写成 110.0 A。

两组仪器（pair 1 / pair 4）之和 ×2 = 111.01 A，与独立测量 111.16 A 差 −0.14 %，
这是**对称求和的比例校验**，不是均流结果（`iout_spread` 1e-9 %，模型对称）。

## 3 逐项应力

| 项 | 本次 | 100 A | 判据 | 结论 |
|----|-----:|-----:|---|---|
| SR 正向峰值 / 只 | 42.99 A | 38.83 A | 手册 Table 1 `ID 285 A` | 15 %，不是瓶颈 |
| SR 每半边 RMS | 21.65 A | 19.50 A | — | 进损耗，见下 |
| SR 单只损耗 | **934.6 mW** | 853.3 mW | 热设计暂缓 | 通道 432.3 + 体二极管 479.7 + Rg 22.6 |
| SR 八只合计（×8 对称） | **7.48 W** | 6.83 W | — | `thermal_precheck` 的 7.338 W 来自**冻结 deck** 的 `sr_channel_body_x4`，不是同一个 deck/窗口 |
| SR 漏源电压 | +5.43 / −1.287 V | 同量级 | 40 V | −1.29 V 是换流期体二极管正压 |
| SR 栅源 | −5.905 … +7.705 V | −5.707 / +7.523 | ±20 V | 负压在 110 A 下更负 0.20 V |
| Cr 峰值 / 峰峰 | **42.74 / 37.48 V** | 41.36 / 34.73 | 100 V | 2.34× |
| Cr RMS | 10.267 A | 9.454 A | ≤11.2 mΩ bank ESR 保 1 W | 随电流线性 |
| Cout 纹波 RMS | **52.08 A** | 47.41 A | 15 只 bank 175 A（件数据未核实） | ESR 仍是选型主导 |
| I(Lr) 峰值磁通 | 0.0368 T | 0.0333 T | 0.9·Bsat = 0.279 T | 稳态，不含故障 |
| OC 引脚 V(oc) | **0.636 V** | 0.570 V | Level-1 `VOC` = 1 V | 63.6 %，约 22.5 A 原边峰值触发 |

`✶ Insight ─────────────────────────────────────`
`V(ovl1)` 在日志里读到 **1.510 V**，而 Level-1 过流门槛是 1 V —— 看起来像"110 A 已经跳闸"。
它其实不是过流脚：deck 第 191 行 `Bovl1 ovl1 0 V=min(max(-I(VSa1),0),max(-I(VSb1),0))`，
量的是**同一组两路 SR 同时正向导通的电流（安培）**。真正的过流节点是 `V(oc)`，本次 0.636 V。
两者混读会得出完全相反的结论。
`─────────────────────────────────────────────────`

**SR 损耗为什么要拿同一条工具、逐 deck 比**：`sr_energy_ledger.py` 在**冻结 deck** 的 16 周期窗口上给
单只通道+体二极管 917.5 mW，正是账本里 `sr_channel_body_x4 = 7.338 W` 的八分之一；
同一工具在 `_phys` 的 100 A 窗口上给 830.7 mW，110 A 上给 912.0 mW。三个数差 10 % 是**deck 与窗口的差别**
（4 mF 对 7.05 mF 的换流不同），不是工具不一致。所以 `thermal_precheck` 的 0.917 W/只
不能搬到 110 A 名下，本表的三列必须成对读。

## 4 效率：仿真端口计算值及其精度边界

`_phys` 及其派生 deck 都不保存 `I(Rin)`/`I(Cin)`，所以本轮另做了一份**探针 deck**：
电路与 `..._vin48_i110.cir` 逐字节相同，只有 `.save` 块整块换成 100 A 账本 deck 的那一块
（`test_the_probe_circuit_is_the_candidate_circuit` 比对两份 LTspice 日志的 `.meas` 行，
`vout_avg`/`ipri_pk`/`ifwd_a1` 等逐字相同）。同一 22 周期窗口：

| 量 | 值 |
|----|----:|
| `Pin = 48 × mean(I(Rin))` | **220.914 W** |
| `Pin` 扣掉 `I(Rin)²·1 mΩ`（进桥后） | 220.859 W |
| `Pout = mean(Vout²/RL)`，`RL=16.9 mΩ` | **208.835 W** |
| **仿真端口效率** | **94.53 %** |
| 损耗清单合计（13 项，不含栅阻与 pair 1 重复项） | 11.905 W |
| `Pin − Pout` | 12.079 W |
| 损耗残差 | **0.174 W** |

`Pout` 与 `extract_op_point` 的 208.83494 W 差 3×10⁻⁵ W —— 两个工具、同一窗口，这是窗口与 `RL`
没写错的正向证据。损耗清单按元件拆开：

| 项 | W | 备注 |
|----|----:|---|
| 原边 Lr 铜阻 | 0.527 | 实测 I²R |
| 原边四只串联绕组电阻 | 1.265 | 实测 I²R |
| QH/QL 通道（8 mΩ×2） | 0.930 | 实测导通区间 |
| QH/QL 体二极管 | 0.015 | |
| Cr ESR | 0.316 | |
| Cout ESR（0.2 mΩ） | 0.527 | |
| 副边铜阻（×4 对称） | 0.563 | **对称假设** |
| **SR 八只通道+体二极管** | **7.493** | pair 1 实测 ×4，**对称假设** |
| CT 整流桥 + 负载电阻 | 0.214 | 模型里存在，端口之外也接在 Vout 上 |
| 输入串联电阻 | 0.054 | |

端口之外还有两项：**SR 栅阻八只 0.181 W** 与驱动源输出 0.2075 W，它们由 ideal 源供电、
不经过 `Rin`（与 100 A 账本同一处理）。所以 `loss_total_w` 不含栅阻，`Pin − Pout` 也不含。

**这个 94.53 % 有三条不能跨的口径线：**

1. **94.47 %** 是 100 A 冻结 deck 的端口效率，**不是**本 deck 的效率；本 deck 在 111 A 下的**模型端口计算效率**是 94.53 %。
2. **92.33 %** 是公布的工程预算，含 0.353 W 磁芯估计、0.15 mΩ 输出路径与 0.75 W 偏置。
   deck 里没有磁芯损耗元件，本表也**没有**输出铜排——把 94.53 % 与 92.33 % 并列比较是错的。
3. 若把储能端点差算进来，效率是 94.68 %（`closure_including_storage_pct`），那是另一个数。

**它不能撑到第四位有效数字。**同一窗口逐周期残差 sd 0.729 W、标准误 0.155 W（22 个点），
即窗口只能把 0.2 W 目标分辨到 ±0.31 W（2σ）。所以引用 94.5 %，不要引用 94.532 %。
更要紧的是 **`closure_status` = `NOT_CLOSED`**：含储能的闭合残差 +0.559 W（周期平均 +0.591 W），
在 0.2 W 目标之外。损耗清单那 0.174 W 只说明"本窗口的清单与 `Pin−Pout` 对得上"，
**不说明账本闭合**——一次 0.2 W 内的残差在这条 raw 上可以是正负相消。

SR 单只需要单独说一句：账本给通道+体二极管 **936.7 mW/只**，§3 的 934.6 mW 由另一条路径得
（912.0 + 栅阻 22.6），两者差 2.7 %，落在同族窗口间 16–23 % 的周期离散度内。
**不要把两个工具的分项拆法混用**：本账本的 `sh`/`sl` 是**原边** QH/QL，不是 SR。

## 5 仍然没有测到的两件事

1. **外部输出路径**。deck 里 `RL=16.9 mΩ` 就是全部负载，没有铜排与接点。
   按 0.15 mΩ 补上，111.16 A 会多耗 1.85 W，负载端约 207 W；按 A6 的 0.281 mΩ 示例则为
   111²×0.281m ≈ 3.5 W 额外损耗。这些是**换算**，不是模型结果。
2. **热与故障**。热设计按路线图 P1 暂缓；本 deck 没有跑 110 A 的冷启动或短路，
   故障峰值仍只有 100 A deck 的 84.02 A 那组数据。**94.53 % 不含结温**：SR 八只 7.49 W
   分到各只 0.94 W 是 27 °C 参数下的值，RDS(on) 随温度上升后这一项会更大。

## 6 与线性外推的差别

`scenarios.json` 对 48 V / 110 A / 0.15 mΩ 的线性估计是 **1.8586 V / 204.5 W**。
本次实测 111.16 A 时负载端 **1.8786 V / 208.83 W**（无外部路径）；补上 0.15 mΩ 后约
1.860 V / **207 W**，比外推高约 1.2 %。差别来自外推把电流按目标 110.0 A 固定，
而 LLC 输出近似定比，电流随实际电压一起漂移。**结论方向一致，量级一致，
但这不构成"线性模型已被验证"——只是一次点的吻合。**

## 7 结论

**等级：SIMULATED_ONLY / NOT_RATED。** 48 V、111.16 A、208.835 W、94.53% 不包含外部铜排和接点、磁芯损耗、辅助供电完整归属与实际器件温度；能量账本仍 `NOT_CLOSED`。不得作为整机硬件效率、200 W 连续额定或样机已完成的证据。

- 在**这个行为模型（非硬件）**里，48 V / 111 A 是可运行工作点：SR、Cr、Cout、OC、磁通都没碰到判据线。
- 端口效率 **94.53 %** 现在是由模型输入/输出波形计算得到的仿真量（`Pin` 220.914 W 来自探针 deck），但账本**未闭合**
  （含储能 +0.559 W），且不含磁芯损耗、输出铜排与结温。
- 它**不是额定**：无热数据、无故障工况、无输出路径、无真实均流、无磁芯损耗。
  deck 头注保持 `UNRUN` 的意义就在这里。
- 120 A 候选**当时没有运行**，按路线图的要求应先看 110 A 结果再决定；本结果不构成放行。
  （2026-11-02 补记：48 V / 120 A 候选已跑，负载端 121.67 A / 227.98 W、端口效率 94.227 %、
  账本仍 `NOT_CLOSED`，见 `design/v3/power_priority/48V120A_实测_2026-11-02.md`。）
- 下一个真正卡住 110 A 的是**热**（SR 单只 0.93 W、八只 7.48 W 且只在 pair 1 上有仪器）
  与**输出路径均流**，不是器件电流。

## 8 这一节能被证伪吗

`tools/test_operating_point_110a.py` 的五条：

| 测试 | 它防的是什么 |
|---|---|
| `test_the_record_carries_the_target_and_not_just_a_round_number` | 把目标 110 A 写成实测值 |
| `test_the_two_measured_pairs_scale_to_the_whole_load` | ×2 对称假设被当成独立证据，或符号/比例写错 |
| `test_output_power_is_the_true_mean_of_the_square` | 用 `Vout_avg²/R` 冒充 `avg(Vout²/R)` |
| `test_raising_the_load_current_raises_every_stress_column` | 把 100 A 的应力数字抄到 110 A 名下 |
| `test_the_record_does_not_claim_a_rating` | 往 JSON/deck 里塞 `rating` 或 `efficiency` 字段 |

效率记录另由 `tools/test_energy_ledger_48v_110a.py` 的五条锁住（效率住在**另一个** JSON 里，
所以上一条"不往工作点 JSON 塞 efficiency"仍然成立）：

| 测试 | 它防的是什么 |
|---|---|
| `test_the_ledger_ran_the_candidates_parameters_not_the_mother_decks` | 沿用母 deck 的 48 V / 18.9 mΩ 去乘候选波形，凭空造出损耗 |
| `test_the_output_power_agrees_with_the_independent_extraction` | 窗口或 `RL` 与工作点记录分叉（两工具差 3×10⁻⁵ W） |
| `test_efficiency_is_two_measured_ports_and_not_a_budget` | 把 92.33 % 的工程预算写成端口效率 |
| `test_the_probe_circuit_is_the_candidate_circuit` | 探针 deck 漂变成另一个电路，效率张冠李戴 |
| `test_the_closure_is_reported_as_not_closed` | 0.174 W 的损耗残差被当成"账本闭合" |
