czy0126/CZY/design/v3/power_priority/48V120A_实测_2026-11-02.md

# 48 V / 120 A 候选的首次 LTspice 仿真测量 — 2026-11-02

> **2026-11-02 数值审核纠错（已重算，替换旧短窗口统计）：** 原 `tools/energy_ledger_100a.py` 的候选工况总窗口正确使用本工况 VIN/RL，但 `window_terms()`、逐周期 `residual_noise()` 和 `averaged_residual_noise()` 没有透传 VIN/RL，误用基准 **18.9 mΩ**。修正版脚本已把 VIN/RL 透传到全部子窗口与统计量，并在保留原始 `.raw` 的本机重跑本记录的 JSON（`diagnostic_integrity.status = RECOMPUTED_WITH_REQUESTED_VIN_RL`）。重算后短窗残差为 **+0.483 W（22 周期）/ +0.476 W（8 周期）/ +0.475 W（12 周期）**，逐周期 sd 0.227 W、sem 0.048 W；旧 +42 W “缺口”是 RL 泄漏造成的假象，作废。端到端口径 `Pin/Pout`、主窗损耗与闭合残差未变，账本仍 `NOT_CLOSED`（+0.667 W，周期平均 +0.668 W）。

> **证据说明：全部数值来自 LTspice 仿真模型的波形/端口计算，并非实际 PCB 或样机测量。**
> 文件名沿用历史“实测”用词以兼容已有引用；对外统一称“仿真测量”。
> 记录：`design/v3/power_priority/operating_point_48v_120a.json`
> 提取：`python tools/extract_op_point.py sim/v3/sr_tank_dual_v33_ss_1ms_vin48_i120_cin.raw --rl 0.0154 --periods 22 --pairs 1 4`
> 锁死：`tools/test_operating_point_120a.py`
> 效率记录：`design/v3/power_priority/energy_ledger_48v_120a.json`（探针 deck `..._vin48_i120_cin.cir`）
> 锁死：`tools/test_energy_ledger_48v_120a.py`
> Cr 重建：`design/v3/power_priority/cr_stress_48v_120a.json`（`python tools/cr_stress.py --raw ..._i120_cin.raw --from-us 7.6445 --to-us 117.3105 --json ...`）
> 上游：`docs/D1_10工作日工程冲刺_2026-11-02.md` ELE-02

## 1 这次跑的是什么

deck 是 `sim/v3/sr_tank_dual_v33_ss_1ms_vin48_i120.cir`：以 `_phys` 物理 deck 为母本，
**只改 `.param VIN=48 / RL=15.4m`**，控制器、SR 行为、Lr/Cr、保护、启动模型一行没动
（`tools/test_make_high_output_decks.py` 锁住这一点）。头注仍写着
`UNRUN, NOT HARDWARE RATED` —— 生成器每次从母 deck 重建该文件，而测试要求这行必须存在。
**运行证据因此只能放在本文与 JSON 里，不能写进 deck 头。**

为了让效率可测，另跑了一份**探针 deck** `..._vin48_i120_cin.cir`：与候选 deck
逐字节相同，只有 `.save` 块整块换成 100 A 账本 deck 的那一块（`make_high_output_decks.save_block()`
复制，测试逐行比对）。两份电路各跑一次：

| 项 | 候选 deck（`.save` 原样） | 探针 deck（带 `I(Rin)/I(Cin)`） |
|----|----|----|
| `.tran` | `0 1000u 880u 5n uic`（窗口 880–1000 µs，raw 轴 0–120 µs） | 同 |
| 运行时长 | **219.788 s** | **228.798 s** |
| raw | **373 MB**、59 变量、258 235 点 | **505 MB**、80 变量、258 235 点 |
| 提取窗口 | 22 个门极周期 | 22 个门极周期 |
| 频率 | 200.609 kHz | 200.609 kHz |

**探针没有扰动求解器**：两份 LTspice 日志的 `.meas` 行逐字相同——
`vout_avg 1.87363390654`、`vout_rip 0.0412342639799`、`ipri_pk 15.5933052007`、
`ifwd_a1 46.8091312814`、`irev_a1 5.42984429011`、`ovl_cur 1.69390812994` 全部一致
（`test_the_probe_circuit_is_the_candidate_circuit` 锁住）。点数也完全相同（258 235）。

## 2 仿真工作点

| 量 | 100 A（`_phys`） | 110 A（2026-11-01） | **本次** | 110→120 比 |
|----|---:|---:|---:|----:|
| Vout 平均 | 1.8844 V | 1.8786 V | **1.8737 V** | 0.997× |
| Iout（avg(Vout)/RL） | 99.70 A | 111.16 A | **121.67 A** | 1.095× |
| Pout（avg(Vout²/RL)） | 187.89 W | 208.83 W | **227.98 W** | 1.092× |
| 输出纹波（22 周期） | 36.07 mVpp | 41.21 mVpp | **41.43 mVpp** | 1.005× |
| I(Lr) RMS | 9.254 A | 10.267 A | **11.222 A** | 1.093× |
| I(Lr) 峰值 | 12.979 A | 14.351 A | **15.593 A** | 1.086× |
| 每组 Iout | 24.929 A | 27.753 A | **30.419 A** | 1.096× |
| 每组 Irms | 27.592 A | 30.641 A | **33.518 A** | 1.094× |
| SR 正向峰值 | 38.826 A | 42.986 A | **46.808 A** | 1.089× |
| SR 反向峰值 | 5.221 A | 5.341 A | **5.430 A** | 1.017× |

**“120 A” 是负载电阻的目标，不是结果。** 15.4 mΩ 来自线性估计（1.85 V / 120 A ≈ 15.42 mΩ）；
实际输出 1.8737 V，于是负载电流是 **121.67 A**。要在本次电压下得到正好 120.0 A，
需要 15.61 mΩ。`test_the_record_carries_the_target_and_not_just_a_round_number`
不允许把它写成 120.0 A。

两组仪器（pair 1 / pair 4）之和 ×2 = 121.677 A，与独立测量 121.668 A 差 +0.007 %，
这是**对称求和的比例校验**，不是均流结果（`iout_spread` 8×10⁻¹⁰ %，模型对称）。
四组在模型里结构对称，任何“均流良好”的说法都不能由这个数支撑。

## 3 逐项应力

| 项 | 本次 | 110 A | 判据 | 结论 |
|----|-----:|-----:|---|---|
| SR 正向峰值 / 只 | **46.81 A** | 42.99 A | 手册 Table 1 `ID 285 A` | 16 %，不是瓶颈 |
| SR 每半边 RMS | **23.68 / 23.71 A** | 21.65 A | — | 进损耗，见下 |
| SR 八只损耗（通道+体二极管） | **8.244 W** | 7.493 W | 热设计暂缓 | 单只 1.031 W（对称假设） |
| SR 栅阻八只（端口之外） | 0.181 W | 0.181 W | — | 单只 22.7 mW |
| SR 漏源电压（pair 1） | +5.649 / −1.495 V | +5.43 / −1.29 V | 40 V | −1.50 V 是换流期体二极管正压 |
| Cr 峰值 / 峰峰 | **44.44 / 40.90 V** | 42.74 / 37.48 V | 100 V | 2.25×，约束仍是 ESR 发热 |
| Cr RMS | **11.222 A** | 10.267 A | ≤**7.94 mΩ** bank ESR 保 1 W | 与 I(Lr) 同一电流 |
| Cout 纹波 RMS | **55.58 A** | 52.08 A | 15 只 bank（件数据未核实） | ESR 仍是选型主导 |
| Cout ESR 损耗 | 0.618 W | 0.527 W | — | 按模型 0.2 mΩ |
| V(sw) 峰值 | **48.73 V** | — | 器件 100 V 级 | 含换流振铃 |
| OC 引脚 `V(oc)` 平均 | **0.6965 V** | 0.636 V | Level-1 `VOC` = 1 V | **69.6 %**，未触发 |
| 重叠导通电流 `V(ovl1)` | 1.694（单位 A） | 1.510 | — | **不是过流脚**，见下 |

`✶ Insight ─────────────────────────────────────`
日志里 `ovl_cur = 1.694`、`ovl_gate = 0`，而 Level-1 过流门槛是 1 V —— 直接对照会得出
“120 A 已经跳闸”的反结论，但输出其实稳在 1.8737 V。`V(ovl1)` 量的是同一组两路 SR
**同时正向导通的电流（单位 A）**，不是过流节点。真正的过流节点是 `V(oc)`，本次 0.6965 V。
`─────────────────────────────────────────────────`

`V(oc)` 每安培原边峰值的比值在本窗口是 0.6965 / 15.593 = **0.0447 V/A**，
所以 1 V 门槛对应约 22.4 A 原边峰值；这与 10 Ω 设计用整周期峰值/平均比得到的 24.2 A
是两个口径，不要混引。本记录只报实测电压，不把折算值当作新门槛。

## 4 效率：仿真端口计算值及其精度边界

同一 22 周期窗口（raw 轴 7.639–117.304 µs）：

| 量 | 值 |
|----|----:|
| `Pin = 48 × mean(I(Rin))` | **241.946 W** |
| `Pin` 扣掉 `I(Rin)²·1 mΩ`（进桥后） | 241.882 W |
| `Pout = mean(Vout²/RL)`，`RL=15.4 mΩ` | **227.978 W** |
| **仿真端口效率** | **94.227 %** |
| 损耗清单合计（含 SR ×4 项，不含栅阻） | 13.485 W |
| `Pin − Pout` | 13.969 W |
| 损耗残差 | **0.483 W** |
| 含储能的闭合残差（单点 / 周期平均） | **+0.667 / +0.668 W** |
| 逐周期残差 sd / 标准误 | 0.228 / 0.0486 W（22 点） |

`Pout` 与 `extract_op_point` 的 227.97767 W 差 **4×10⁻⁶ W** —— 两个工具、同一窗口，
这是窗口与 `RL` 没写错的正向证据。

| 损耗项 | W | 备注 |
|----|----:|---|
| 原边 Lr 铜阻 | 0.630 | 实测 I²R |
| 原边四只串联绕组电阻 | 1.511 | 实测 I²R |
| QH/QL 通道（8 mΩ×2） | 1.099 | 实测导通区间（`sh`+`sl`） |
| QH/QL 体二极管 | 0.021 | `dh`+`dl` |
| Cr ESR | 0.378 | |
| Cout ESR（0.2 mΩ） | 0.618 | |
| 副边铜阻（×4 对称） | 0.674 | **对称假设** |
| **SR 八只通道+体二极管** | **8.244** | pair 1 实测 ×4，**对称假设**；单只 1.031 W |
| CT 整流桥 | 0.120 | 模型里存在，端口之外也接在 Vout 上 |
| CT 负载电阻 | 0.125 | |
| 输入串联电阻 | 0.065 | |
| **合计** | **13.485** | |

端口之外还有两项：**SR 栅阻八只 0.181 W** 与驱动源输出 0.205 W，它们由 ideal 源供电、
不经过 `Rin`。所以 `loss_total_w` 不含栅阻，`Pin − Pout` 也不含。

**CT 这次没有“补齐缺口”。** `gap_before_ct_w = 0.729 W`（`Pin − Pout − 非 CT 损耗`），
而 CT 两项合计只有 **0.246 W**，剩余 0.483 W 就是损耗残差。所以
`results.ct_terms_account_for_the_gap_before_ct = false`。100 A 对齐窗口上
`gap_before_ct = 0.344 W` 对 CT 0.186 W 也是同样方向——**不要把“CT 正好补齐”当结论**。

**这个 94.227 % 有四条不能跨的口径线：**

1. 它是**模型电气端口**效率，不含磁芯损耗元件、输出铜排/接点与完整偏置归属。
2. **92.33 %** 是公布的工程预算（0.353 W 磁芯估计 + 0.15 mΩ 输出路径 + 0.75 W 偏置），
   是另一个量；把 94.227 % 与 92.33 % 并列比较是错的。
3. 若把储能端点差算进来，效率是 **94.407 %**（`closure_including_storage_pct`），又是另一个数。
4. **`closure_status = NOT_CLOSED`**：+0.667 W（周期平均 +0.668 W）在 0.2 W 目标之外。
   窗口对 0.2 W 的分辨率只由随机散布决定（sem 0.0486 W ⇒ 2 周期可达）；
   **本 deck 没有同电路的第二个步长 raw，因此没有任何步长敏感性证据**——
   `sem_w` 不包含步长误差。引用效率写 **94.2 %**，不要写 94.227 %。

损耗清单也不能引用得比约 0.6 W 更细（Issue #6 在 100 A 对齐窗口上的结论），
94.2 % 因此带约 0.3 个百分点不确定度。

## 5 仍然没有测到的边界

1. **外部输出路径**。deck 里 `RL=15.4 mΩ` 就是全部负载，没有铜排与接点。
   按 0.15 mΩ 补上，121.67 A 会多耗 **2.22 W**，负载端约 225.8 W；按 A6 的 0.281 mΩ
   示例则为 121.67²×0.281 m ≈ 4.16 W 额外损耗。这些是**换算**，不是模型结果。
2. **热**。热设计按路线图暂缓；8.244 W 分到八只 SR 是 27 °C 参数下的值，
   `RDS(on)` 随结温上升后这一项会更大。本记录不能支撑“120 A 连续”。
3. **完整故障窗口与真实保护**。48 V/120 A 目标的真冷启动与 8.70× 过载已在
   2026-11-02 补跑，见 `48V120A_冷启动与故障_2026-11-02.md`：trip 延迟 41.81 µs、
   trip 前峰值 84.83 A、2 匝磁通 0.326 T 已越过 Bsat。但故障仿真在 7.5714 ms 处
   塌缩，只有 5.55–7.5714 ms 的前缀；仍不能据此批准器件 SOA、重复过载或真实保护。

## 6 数据完整性：本次发现并修掉的两个读取错误

**6.1 `ascii_raw_window` 静默截断窗口。** 第一次提取 120 A 工作点时，
`find_offset` 只扫描 64 行找记录起点，而 80 变量的 raw 每条记录是 **81 行**。
随机字节偏移下约 20 % 找不到记录起点，函数返回 `None`，二分法把它当作
“时间 < t0”，最终收敛到文件中部（byte 276 393 424 / 505 404 440），
把 0–120 µs 读成 **65.7–120 µs**——22 周期提取因此报“只有 10 个完整周期”。
现在按 `n_variables + 2` 扫描并向前对齐到第一条 ≥ t0 的记录；`t0 = 0` 直接
从头部 `Values:` 偏移开始。`tools/test_ascii_raw_window.py` 用结构精确的合成 raw
锁住 8/40/80/200 变量的零起点与中间窗口（修复前 4 条红，修复后 8/8 绿）。
**所有 120 A 数字都是在修复后的读取器上重跑的。**

**6.2 `step_check` 曾拿另一台变换器当对照组。** 第一份 120 A 账本默认用
`..._100a_ledger2n.raw`（100 A 电路的 2 ns 跑）作比较列，而 `--vin 48 --rl 15.4m`
又被同时套到那一列上，于是它报出 **−43 W 的“闭合移动”**——那是两台变换器相减，
不是步长敏感性。现在：
- `deck_difference()` 在比较前逐行核对两份 deck（忽略 `.tran`），不同就 `ValueError`；
- 120 A 账本用 `--no-step-check` 重新生成，JSON 里**没有** `step_check` 块；
- `mark_no_step_check()` 把 sensitivity 注里的“see step_check”替换成明确说明，
  不留下指向不存在章节的指针。
测试 `test_a_step_check_refuses_two_different_circuits` 与
`test_skipping_the_step_check_does_not_point_at_a_missing_section` 锁住这两条。

## 7 结论

**等级：SIMULATED_ONLY / NOT_RATED。** 48 V、121.67 A、227.978 W、94.227 % 不包含
外部铜排和接点、磁芯损耗、辅助供电完整归属与实际器件温度；能量账本仍 `NOT_CLOSED`
（+0.667 W），且本 deck 没有步长敏感性数据。不得作为整机硬件效率、120 A 连续额定
或样机已完成的证据。

- 在**这个行为模型（非硬件）**里，48 V / 121.7 A 是可运行工作点：
  SR、Cout、OC、磁通都没碰到判据线。
- 端口效率 **94.2 %** 由模型输入/输出波形算出（`Pin` 241.946 W 来自探针 deck），
  但账本**未闭合**，且不含磁芯损耗、输出铜排与结温。
- 它**不是额定**：无热数据、无完整的 120 A 故障窗口（只有 5.55–7.5714 ms 前缀）、
  无输出路径、无真实均流。
  deck 头注保持 `UNRUN` 的意义就在这里。
- 下一个真正卡住 120 A 的仍是**热**（SR 八只 8.24 W，且只在 pair 1/4 上有仪器）
  与**输出路径均流**，不是器件电流。

## 8 这一节能被证伪吗

`tools/test_operating_point_120a.py` 的五条：

| 测试 | 它防的是什么 |
|---|---|
| `test_the_record_carries_the_target_and_not_just_a_round_number` | 把目标 120 A 写成实测值 |
| `test_the_two_measured_pairs_scale_to_the_whole_load` | ×2 对称假设被当成独立证据，或符号/比例写错 |
| `test_output_power_is_the_true_mean_of_the_square` | 用 `Vout_avg²/R` 冒充 `avg(Vout²/R)` |
| `test_raising_the_load_current_raises_every_stress_column` | 把 110 A 的应力数字抄到 120 A 名下 |
| `test_the_record_does_not_claim_a_rating` | 往 JSON/deck 里塞 `rating` 或 `efficiency` 字段 |

`tools/test_energy_ledger_48v_120a.py` 的六条：

| 测试 | 它防的是什么 |
|---|---|
| `test_the_ledger_ran_the_candidates_parameters_not_the_mother_decks` | 沿用 18.9 mΩ 去乘候选波形，凭空造出损耗 |
| `test_the_output_power_agrees_with_the_independent_extraction` | 窗口或 `RL` 与工作点记录分叉（两工具差 4×10⁻⁶ W） |
| `test_efficiency_is_two_measured_ports_and_not_a_budget` | 把 92.33 % 的工程预算写成端口效率 |
| `test_the_probe_circuit_is_the_candidate_circuit` | 探针 deck 漂变成另一个电路 |
| `test_no_step_check_is_claimed_for_a_foreign_2ns_raw` | 拿 100 A 的 2 ns raw 冒充同电路步长对照 |
| `test_the_closure_is_reported_as_not_closed` | 0.483 W 的损耗残差被当成“账本闭合” |
