czy0126/CZY/design/v3/stage_f/上电检查表.md

# 上电检查表（首件）— 由设计 JSON 生成

本表由 `tools/powerup_checklist.py` 从分析 JSON 直接渲染，判据数字不手抄；
改分析后必须重跑该工具，否则 `test_the_checklist_matches_a_fresh_render` 会红。

**本表是上电流程，不是额定值证据。** 100 A 连续 / ≤10 mm 只能由 S4 的 Stage F 矩阵实测关闭。

**工况不得跨阶段复用。** 每条判据只在 `test_state` 指定的工况下有效；
额定电流应力（OC 电平、Cr 峰值、36.1 A 冷启动峰值）只出现在 S4，
空载阶段 S3 不引用这些数字。`source_type` 区分 datasheet / model / hardware / design。

## 判据来源

| 项 | 值 |
|---|---|
| 单处接点上限 | 57.8 µΩ |
| 输出铜排 | 长 80 × 宽 20 × 厚 2 mm |
| 铜排电阻 | 34.5 µΩ |
| 冷启动原边峰值（48 V） | 36.1 A |
| 冷启动原边峰值（12 V 线性折算） | 9.0 A |
| 故障峰值（OC 13 µs） | 65 A |
| 输入走线宽度 | 11.2 mm |
| 开关频率 | 200.6 kHz |
| 空载输出 | 2.00 V |
| vout_pp | 49.7 mVpp |
| OC 脚电平（额定点） | 0.573 V |
| 对应原边峰值 | 13.88 A |
| 过流门槛 | 24.2 A |
| CT 合规电压 | 1.14 V |
| 自举二极管反压 | 48 V |
| SR 单管损耗 @100 A | 0.92 W |
| 结温上限 | 125 °C |
| Rth 50 K/W 最高环境 | 79.1 °C |
| Cr 峰值电压 | 41.4 V |
| Cr 电流 RMS | 9.45 A |
| Cr 整组 ESR 上限 | 11.2 mΩ |
| 输出电容只数 | 15 |
| 整组 ESR | 0.20 mΩ |
| 气隙 | 0.121 mm |
| 高度最坏值 | 9.94 mm |
| 网表引脚数 | 193 |

## S0 板前（完全断电，万用表/四线法）

| # | 检查 | 工况 | 测点 | 判据 | 依据 | 类型 | 不合格时 |
|---|---|---|---|---|---|---|---|
| S0-1 | VIN_P 对 PGND 不短路 | `power_off` | J_IN P1–P2 | > 1 kΩ（Cout 充电后） | `netlist` | `hardware` | 查铜排/电容极性/焊接桥 |
| S0-2 | 八只 SR 漏源不短路 | `power_off` | SR1A–SR4B 各 D–S 焊盘 | 二极管档有值、非 0 | `netlist` | `hardware` | 拆管复测 |
| S0-3 | 十只 2.2 Ω 门阻、八只 0 Ω 开尔文链在位 | `power_off` | R4/R5、R20–R27、R28–R35 位号 | 逐位号清点，合计 18 只 | `board_netlist` | `hardware` | 缺 0 Ω 则 SR 关断依赖焊盘 di/dt |
| S0-4 | 输出铜排 长 80 × 宽 20 × 厚 2 mm 的电阻 | `power_off` | J_OUT P–N 四线法 | 34.5 µΩ（20 °C，几何） | `connector_budget` | `hardware` | 改宽度/厚度后重算 |
| S0-5 | 两处接点四线法，单处 ≤ 57.8 µΩ | `power_off` | J_OUT 两处接点 | ≤ 57.8 µΩ | `connector_budget` | `hardware` | 超标则改压接或重算效率口径 |
| S0-6 | 输入走线宽度 ≥ 11.2 mm | `power_off` | 输入铜箔截面（卡尺） | ≥ 11.2 mm（2 oz 或等效） | `connector_budget` | `design` | 改叠层/加铜厚 |
| S0-7 | 输出电容 15 只、整组 ESR ≈ 0.20 mΩ | `power_off` | Cout 组两端（LCR 100 kHz） | 15 只；ESR 主导，不是容量 | `cout_bank` | `hardware` | 少买则 ESR 超标 |
| S0-8 | 整机高度最坏 9.94 mm | `power_off` | 成品最高点（高度规） | ≤ 10 mm | `magnetics_design` | `hardware` | 改沉槽/夹具 |
| S0-9 | 气隙 0.121 mm、四套 Lm 一致性 | `power_off` | 中柱（千分尺）+ 3 匝 LCR | 首件实测回填 | `magnetics_design` | `hardware` | 漏感实测前不冻结 Lr 料号 |
| S0-10 | Cr 整组 ESR ≤ 11.2 mΩ | `power_off` | Cr 两端（LCR 200 kHz） | ≤ 11.2 mΩ（1 W 允许） | `cr_stress` | `hardware` | 换低 ESR 并联 |

## S1 仅偏置（主输入断开，12 V 限流 100 mA）

| # | 检查 | 工况 | 测点 | 判据 | 依据 | 类型 | 不合格时 |
|---|---|---|---|---|---|---|---|
| S1-1 | 12 V 偏置静态电流 | `bias_only` | 12 V 输入串 mA 表 | 记录实测值（模型未建模，无判据） | `CLAUDE.md` | `hardware` | 异常高则查短路 |
| S1-2 | U1 VCC 建立并高于 UVLO | `bias_only` | U1.7–U1.6 | 高于 datasheet UVLO；记录值 | `UCC25600 datasheet` | `datasheet` | 查 12 V 供电/限流 |
| S1-3 | U1 开关频率 200.6 kHz | `bias_only` | U1.8/U1.5 对 U1.6 | 200.6 kHz ± 5 % | `operating_point` | `model` | 查 RT/DT 阻值 |
| S1-4 | UCC24624 VDD 与 REG 静态电平 | `bias_only` | U3–U6 pin7–pin2、pin3–pin2 | VDD=12 V 时 REG≈11 V（datasheet）；记录实测 | `UCC24624 datasheet` | `datasheet` | 查 REG 电容/负载；deck 的 PWL 只是模型设定，不是芯片判据 |
| S1-5 | UCC24624 门极在无次级激励时的安全状态 | `bias_only` | U3–U6 pin1/pin8 对 pin2 | 两路输出均为低；本阶段只查静态安全 | `UCC24624 datasheet` | `hardware` | 若高则查 VD 采样/干扰；动态换流留到有次级激励的 S4 |
| S1-6 | 自举二极管选型 | `bias_only` | D_BT 本体丝印/规格书 | 额定 ≥ 100 V（选型检查；电压应力留到 S3 实测） | `bom_draft` | `datasheet` | 25 V 件会雪崩击穿 |
| S1-7 | OC 脚静态电平 < 0.1 V | `bias_only` | U1.3–U1.6 | < 0.1 V | `ct_design` | `hardware` | 查分压/滤波对地 |

## S2 限能首次上电（10–12 V 主输入，平均限流 0.5 A）

| # | 检查 | 工况 | 测点 | 判据 | 依据 | 类型 | 不合格时 |
|---|---|---|---|---|---|---|---|
| S2-1 | 半桥无直通，SW 波形干净 | `low_bus` | 示波器 GH、GL、SW 对 PGND | 无重叠导通 | `netlist` | `hardware` | 立即断电查门极 |
| S2-2 | 输入源平均限流与 Lr 谐振峰值分开验收 | `low_bus` | 电源读数（平均）+ 电流探头 I(Lr)（峰值） | 平均限流 0.5 A；12 V 下 Lr 峰值 ≈ 9.0 A（由 48 V 冷启动线性折算，模型估计）；电源峰值能力须 ≥ 该值 | `lr_design` | `model` | 平均限流不等于峰值能力；不足则加预充/软启动 |
| S2-3 | OC 在低压下不误跳 | `low_bus` | U1.3–U1.6（差分） | 低于门槛 24.2 A；触发则查 CT 负载/分压 | `ct_design` | `hardware` | 记录 V(ocd) 与 V(OC) |
| S2-4 | 自举电容电压 HB–SW | `low_bus` | HB–SW 差分 | ≈ 12 V，无塌陷 | `UCC27282 datasheet` | `hardware` | 查 D_BT/Cbt 与 QH 开关 |

## S3 升到 48 V、空载（本阶段不引用额定电流应力）

| # | 检查 | 工况 | 测点 | 判据 | 依据 | 类型 | 不合格时 |
|---|---|---|---|---|---|---|---|
| S3-1 | 开关频率 200.6 kHz | `no_load` | SW 上升沿，200 kHz 带宽探头 | 200.6 kHz ± 5 % | `operating_point` | `model` | 查谐振参数 |
| S3-2 | 空载 Vout ≈ 2.00 V | `no_load` | VOUT–PGND（DC 档） | 2.00 V（24:1 固定变比） | `deck .param` | `model` | 查匝比/极性 |
| S3-3 | 半桥与 SR 漏源空载振铃 | `no_load` | SW、SR1A–SR4B D–S | 记录峰值；不超过器件额定 | `datasheet` | `hardware` | 超额定则查吸收/布局 |
| S3-4 | 自举二极管反压（QH 导通时） | `no_load` | D_BT 两端差分 | ≈ 48 V（= VIN） | `model` | `model` | 印证 S1 的 ≥100 V 选型 |
| S3-5 | OC 脚空载电平与纹波 | `no_load` | U1.3–U1.6 交流耦合 | 接近 0；记录纹波峰值 | `board_netlist §6` | `hardware` | 超标则改布局/加共模扼流 |
| S3-6 | Cr 空载摆幅 | `no_load` | Cr 两端差分 | 记录实测；不把额定峰值当空载判据 | `cr_stress` | `hardware` | 异常大则查谐振参数 |
| S3-7 | 48 V 冷启动 Lr 峰值 | `no_load` | 电流探头 I(Lr) | ≤ 36.1 A（模型）；电源峰值能力须 ≥ 该值，平均限流另设 | `lr_design` | `model` | 不足则加预充/软启动 |

## S4 带载与故障（Stage F 矩阵；本表只列判据，不代替矩阵）

| # | 检查 | 工况 | 测点 | 判据 | 依据 | 类型 | 不合格时 |
|---|---|---|---|---|---|---|---|
| S4-1 | 10/25/50/75/100 A 逐级加载 | `rated` | 电子负载 + 输入功率计 | 每级记录再升；见 stage-F 矩阵 | `stage_f 文档` | `hardware` | 每级记录再升 |
| S4-2 | 100 A 时 OC 脚 0.573 V @ 13.88 A | `rated` | U1.3–U1.6（差分） | 0.573 V @ 13.88 A；门槛 24.2 A | `ct_design` | `model` | 偏差大则查 CT 负载/分压 |
| S4-3 | 100 A 时 Cr 峰值 ≤ 41.4 V、RMS ≈ 9.45 A | `rated` | Cr 两端差分 + 电流探头 | ≤ 41.4 V；对 100 V 额定 2.4 倍 | `cr_stress` | `model` | 超则查谐振电容容量 |
| S4-4 | SR 单管损耗 0.92 W @ 100 A → Tj | `rated` | SR 壳温（热电偶/红外） | Tj ≤ 125 °C；50 K/W 是模型假设，不是判据；须用实测壳温与声明 Rth 换算 | `thermal_precheck` | `model` | 实测超标则改散热/降额 |
| S4-5 | 100 A 输出纹波与负载瞬态 | `rated` | VOUT 交流耦合，20 MHz 带宽 | 纹波 22 周期 49.7 mVpp（项目目标 ≤50 mVpp，不是产品规格）；瞬态无判据，只记录 ±ΔV 与恢复波形 | `当前候选基线_2026-11-01` | `design` | 纹波超 50 mV 则加 Cout/改开关策略；瞬态不得宣称合格 |
| S4-6 | OC 13 µs 故障：Lr 峰值 ≤ 65 A | `fault` | 电流探头 I(Lr)、SW、OC | ≤ 65 A；驱动关断 | `lr_design` | `model` | 不关断则查 CT/OC 网络 |
| S4-7 | OC 2 V 闩锁 | `fault` | U1.3–U1.6 | 闩锁并保持，断电复位 | `UCC25600 datasheet` | `datasheet` | 2 V 是闩锁不是关断门槛 |
| S4-8 | 100 A 连续 / ≤10 mm | `rated` | 整机温升 + 高度规 | 只能由本矩阵实测关闭 | `—` | `hardware` | 不得用短时波形替代 |
