czy0126/CZY/design/v3/magnetics/绕组工艺卡_2026-11-01.md

# 变压器绕组工艺卡（T1–T4 通用）

日期：2026-11-01
状态：**工艺草案，未做样件**。数值来自 `磁件设计包_2026-10-31.md`；标注"待确认"的项必须在首件上实测后回填。

## 0. 每只目标

- 3:1:1 中心抽头，3 匝原边、1+1 匝副边；Lm 10.0 µH ±10 %（3 匝，100 kHz）。
- 交错叠层 P1 / S_A / P2 / S_B / P3，绕组总厚 1.10 mm（不含 0.20 mm 载体）。
- 气隙 0.121 mm 只开中柱；外侧两腿贴合。

## 1. 材料与下料

| 材料 | 规格 | 每只用量 | 四只用量（+10 %） |
|---|---|---|---|
| 铜箔 | 0.10 × 18.0 mm | 7 片 × 80 mm = 560 mm | 约 2.5 m |
| Kapton | 0.05 mm | 2 片 20 × 62 mm | 8 片 |
| Kapton | 0.10 mm | 2 片 20 × 62 mm | 8 片 |
| 外层胶带 | 0.10 mm | 1 片 20 × 62 mm | 4 片 |
| 载体 | 0.20 mm，材料待确认 | 1 片 | 4 片 |

- 80 mm = 平均匝长 60 mm + 两端端子各 10 mm。平均匝长取自磁件设计包，**不是**从外形尺寸反推。
- 铜箔宽度 18.0 ±0.2 mm；切口毛刺 ≤0.02 mm，毛刺会刺穿 0.05 mm Kapton。

## 2. 铜箔成形

1. 按**实测中柱轮廓**弯成单匝开口环（内轮廓现场修配，不用图纸名义值下料）。
2. 开口处两端各留 10 mm 搭接端子；弯折半径 ≥0.5 mm，禁止折痕横跨铜宽。
3. 每片用耐高温标签标记：`P1/P2/P3/S_A-1/S_A-2/S_B-1/S_B-2`，并在**起始端**（不是任一端）
   标 DOT；起始端按 §4 端子表：P1/P2/P3 的 IN 端、S_A 的 CTAP 端、S_B 的 SEC_B 端。

## 3. 叠层（自下而上）

| 层 | 材料 | 厚度 | 绝缘要求 |
|---|---|---|---|
| 1 | P1 | 0.10 | — |
| 2 | Kapton 0.05 | 0.05 | 覆盖铜边 ≥1 mm |
| 3 | S_A（两片并联） | 0.20 | 两片对齐，边缘错位 ≤0.5 mm |
| 4 | Kapton 0.10 | 0.10 | 原副边主绝缘 |
| 5 | P2 | 0.10 | — |
| 6 | Kapton 0.10 | 0.10 | 原副边主绝缘 |
| 7 | S_B（两片并联） | 0.20 | 同 S_A |
| 8 | Kapton 0.05 | 0.05 | 覆盖铜边 ≥1 mm |
| 9 | P3 | 0.10 | — |
| 10 | 外层胶带 | 0.10 | 包边 |

叠层完成厚度 **1.10 mm ±0.10**（不含载体），装窗口前用高度规测量并记录。

## 4. 电气连接与极性（端子级定义）

**极性不接受文字推断，以生成文件为准。** 下列三份文件由 `python tools/winding_polarity.py`
从 100 A 仿真 deck 经 `board_netlist.winding_layout()` 导出；改 deck 或改主板引脚顺序后必须重跑：

- `winding_polarity.csv` — 每只 9 个端子的 DOT / 非 DOT 与对应网络；
- `winding_connections.svg` — 带 DOT 的可加工连接图（T1–T4 原边串联 + 副边中心抽头）；
- `first_article_polarity_record.csv` — 首件测量记录表。

DOT 约定：**DOT = 该绕组的起始端**。仿真按 SPICE 耦合电感规则取 `L` 元件的第一个节点为 DOT，
且正的 K 使同名端同相。因此：

| 端子 | 所属 | DOT? | 接到 |
|---|---|---|---|
| P1_IN | 原边第 1 匝 | **DOT** | T1：Lr；T2–T4：上一只的 P3_OUT |
| P1_OUT | 原边第 1 匝 | 非 DOT | P2_IN（内部串接） |
| P2_IN | 原边第 2 匝 | **DOT** | P1_OUT |
| P2_OUT | 原边第 2 匝 | 非 DOT | P3_IN |
| P3_IN | 原边第 3 匝 | **DOT** | P2_OUT |
| P3_OUT | 原边第 3 匝 | 非 DOT | T1–T3：下一只的 P1_IN；T4：PGND |
| CTAP | S_A + S_B | **S_A 的 DOT / S_B 的非 DOT** | 主板 VOUT（四只共用） |
| SEC_A | S_A | 非 DOT | 主板 SECi_A（SRiA 漏极） |
| SEC_B | S_B | **DOT** | 主板 SECi_B（SRiB 漏极） |

由此得到三条硬规则：

1. **原边串联**：P1_OUT→P2_IN、P2_OUT→P3_IN；整体 DOT 在 P1_IN，整体非 DOT 在 P3_OUT。
   T_i 的 P3_OUT 接 T_{i+1} 的 P1_IN（四只同向串联），T1 的 P1_IN 接 Lr，T4 的 P3_OUT 接 PGND。
   串联端子在窗口外侧同一侧交错，不穿过窗口。
2. **副边中心抽头**：S_A 两片并联后从 CTAP 绕到 SEC_A；S_B 两片并联后从 SEC_B 绕到 CTAP。
   **CTAP 是 S_A 的 DOT，同时是 S_B 的非 DOT——不是“两个 DOT 相连”。**
   S_B 的 DOT 在 SEC_B 端。
3. **禁止**把 S_A 的 DOT 与 S_B 的 DOT 接在一起（即禁止把 SEC_B 端与 CTAP 短接）。那样两半相位相同，
   全波整流失效，SR 直通。

端子 10 mm × 18 mm，焊接或压接面积 ≥100 mm²；连接后用四线法测 DCR：
原边 1.72 mΩ ±10 %，副边每半 0.287 mΩ ±10 %（20 °C）。

### 4.1 首件低压极性 / 变比 / 串联相位（连接 SR MOSFET 之前）

1. 只装磁件与端子，**不装 SR MOSFET、不装 QH/QL、不上主功率**；按 §4 把 T1–T4 原边串联。
2. 信号源 1 kHz、1 Vpp 方波经 **100 Ω 限流**接 P1_IN–P3_OUT；用差分探头，禁止用主功率母线做激励。
3. 逐只测极性：V(SEC_A−CTAP) 与 V(PRI_A−PRI_B) **同相**；V(SEC_B−CTAP) 与 V(PRI_A−PRI_B) **反相 180°**。
4. 测变比：|V(SEC_A−CTAP)| / |V(PRI_A−PRI_B)| = 1/3 ±5 %；S_B 同。
5. 测串联相位：V(T_{i+1} PRI_A−PRI_B) 与 V(T_i PRI_A−PRI_B) **同相**（i=1,2,3）。
6. 任一项不符：停止装配，按 `first_article_polarity_record.csv` 记录实测波形与判定，
   返工后重测；**极性记录未全部通过前不得连接 SR MOSFET**。

## 5. 磁芯、气隙与装配

1. 两半 ELP 中柱各磨 0.0605 mm（合计 0.121 mm）；外侧两腿不磨、保持贴合。
2. 装临时 3 匝线圈测 L；补磨到 10.0 µH。验收 9.0–11.0 µH。
3. 粘接：环氧，胶层 0.05 mm 目标、≤0.08 mm；**不得跨顶加金属夹**。
4. 贴标签 0.05 mm（≤0.06 mm）；总高按 `height_stackup.csv` 判定（平铺 ≤9.94 mm；0.5 mm 沉槽 ≤9.44 mm）。
5. 绝缘耐压：500 VDC / 1 s，漏电 ≤1 µA（板级 SELV 检查，不代替系统安规）。

## 6. 磁测量（每只记录）

| 量 | 条件 | 目标/用途 |
|---|---|---|
| Lm | 开路副边，3 匝，100 kHz，25 °C | 10.0 µH ±10 % |
| 漏感 | 短路各副边，测原边 | 记录实测值；外置 Lr 按 `1.0 µH − 折算漏感` 配平 |
| DCR | 四线法，20 °C | 原边 1.72 mΩ，副边半 0.287 mΩ |
| 极性 | 首件按 §4.1 低压法；量产按 §4 端子表抽查 | 与 `first_article_polarity_record.csv` 一致 |
| 高度 | 装配后 | 见 §5.4 |

注意：参数表的总 Lr 目标为 1.0 µH，而 100 A deck 用的是 0.92 µH（模型值）。
两者不混用：**以四只样件实测漏感回填，再决定外置 Lr**；在回填前不冻结 Lr 料号。

## 7. 检验对照

逐项对应 `inspection_spec.csv`（16 项）。本卡新增的可执行步骤：下料尺寸、成形、叠层顺序、
端子级极性（§4）、首件低压极性/变比/串联相位（§4.1）、串联/并联连接方式。

## 8. 未决项（首件前必须关闭）

1. 载体材料与固定方式（0.20 mm，材料未定）。
2. 端子连接工艺（焊接 vs 压接）与对应接触电阻。
3. 气隙边缘磁通对 18 mm 铜宽的实际影响（Dowell 一维模型未含）。
4. 首件实测中柱轮廓与平均匝长；若偏离 60 mm，本卡下料长度随之修正。
