czy0126/CZY/design/v3/magnetics/磁件设计包_2026-10-31.md

# 磁件设计包 — 4×3:1:1 平面变压器阵列（T1–T4）

日期：2026-10-31
状态：**设计估算，不是硬件实测，不是签核值。** 绕组损耗来自一维 Dowell 模型，
磁芯损耗来自以 N97 数据表点为锚的 B²f² 上界；两者都还没有量热或阻抗分析仪数据。
本包补的是第三次独立审核任务书点名的“磁件加工图”缺口。

## 0. 结论先行

| 项目 | 数值 | 依据 |
|---|---|---|
| 磁芯 | TDK ELP32 N97，B66287G0000X197 + B66287K0000X197，4 套 | 数据表 |
| 匝比 | 3:1:1 中心抽头，四组原边串联、副边整流后并联，总比 24:1 | 拓扑 |
| 每只激磁电感 Lm | 10.0 µH（AL = 1111 nH/T²，3 匝） | 参数表 |
| 中柱总气隙 | **0.121 mm**，按电感验收而不是按固定气隙验收 | 计算 |
| 峰值磁密 | 19.17 mT @48 V；19.97 mT @50 V；6.4 % 的 Bsat | 计算 |
| 磁芯损耗 | ≤0.088 W/套 @50 V，四套合计 ≤0.353 W | B²f² 上界 |
| 绕组铜损 @100 A | 原边 0.893 W + 副边 1.241 W = **2.135 W**（四只合计） | Dowell + 实测电流 |
| 磁件总损耗 @100 A | 2.135 + 0.353 + 0.447（Lr）= 2.935 W | 计算 |
| 整机效率 @100 A / 48 V | 变换器端 93.06 %，含输出路径 92.33 % | 损耗预算 |
| 高度（0.5 mm 沉槽，推荐） | 标称 9.10 mm，最坏 **9.44 mm**，余量 0.56 mm | 数据表公差 |
| 高度（平铺、无夹，仅样机） | 标称 9.60 mm，最坏 9.94 mm，余量 **0.06 mm** | 数据表公差 |
| 100 A / 48 V 输出 | **1.887 V / 188.3 W**，不是 200 W | 实测模型工作点 |
| 200 W @100 A 所需输入 | **≥50.72 V**（模型压降），或再降约 3 W 损耗 | 计算 |

最后两行是本轮最重要的负面结论：在 48 V 输入、24:1 固定比下，100 A 时输出
只有 188 W；“100 A 连续 / 200 W”不能同时成立。见 §7。

## 1. 拓扑与磁件角色

四只变压器结构相同。原边四只串联接在半桥谐振腔上，每只原边看到 ±VIN/8
（半桥方波 ±VIN/2 由四只均分）；副边每只两个 1 匝半绕组，经同步整流后并联
汇入输出。每只的匝比 3:1:1，原边 3 匝、副边每半 1 匝，因此整机 24:1。

- 原边电流（实测模型，100 A）：RMS 9.450 A，峰值 13.881 A。
- 副边半绕组电流（实测模型，100 A）：RMS 19.92 A（a 半 19.839 A，b 半 20.005 A）。
- 副边“对”输出电流 RMS 28.178 A，平均 24.938 A/组；四组外推合计 99.75 A，
  与 `average(Vout)/RL = 99.825 A` 一致（差 0.07 %）。
- 频率 200.622 kHz，22 个完整门极周期，窗口 7.705–117.364 µs（原始时间轴；
  对应实际 887.7–997.4 µs，`Tstart=880 µs`）。

## 2. 磁芯与磁密

数据表尺寸（TDK，2022-10，第 4 页）：

- 外形 31.75 ±0.65 mm × 25.4 ±0.5 mm；ELP 半高 6.35 ±0.15 mm；I 片 3.15 ±0.15 mm。
- 窗口高 3.20 ±0.15 mm；中柱宽 20.35 ±0.4 mm；每侧窗口宽 (31.75−20.35)/2 = 5.70 mm。
- Ae = 130 mm²，Amin = 128 mm²，le = 35.1 mm，Ve = 4560 mm³。
- 未开气隙 AL = 6300 nH ±25 %；N97 Bsat = 310 mT @100 °C；PV < 2.20 W/套
  @200 mT、100 kHz、100 °C。

每只原边电压 ±6.0 V（48 V）或 ±6.25 V（50 V），半周期 2.492 µs：

```
ΔB = V·t_on/(N·Ae)
B_pk = ΔB/2
```

| Vin | 每只 Vpri | B_pk | 占 Bsat |
|---|---|---|---|
| 46 V | 5.75 V | 18.37 mT | 5.9 % |
| 48 V | 6.00 V | 19.17 mT | 6.2 % |
| 50 V | 6.25 V | 19.97 mT | 6.4 % |

磁芯远未饱和；选 ELP32 是为了窗口面积和 9.5 mm 高度，不是为了磁通。磁芯损耗按
`P = 2.2 W × (B/0.2 T)² × (f/100 kHz)²` 取上界（B²f² 比 Steinmetz 的
B^2.4·f^1.6 更保守），50 V 时 0.088 W/套、四套 0.353 W。这个上界在低磁密下
偏保守，但即使翻倍也不改变结论。

## 3. 电感与气隙

目标 Lm = 10 µH/只，3 匝 → AL_target = 10 µH/3² = **1111 nH/T²**。

未开气隙时 3 匝电感为 6300 × 9 = 56.7 µH。所需总气隙：

```
g = µ0·N²·Ae·(1/L − 1/L_ungapped) = 0.1211 mm
```

**制造口径：按电感磨气隙，不按固定气隙磨。** AL 的 ±25 % 公差会把所需气隙
推到 0.112–0.126 mm。如果只按 0.121 mm 盲磨，AL 偏下限的批次约 9.44 µH、偏上限
的批次约 10.36 µH——仍在 ±10 % 内，但已经吃掉一半余量。按电感补磨可以把批次
分布收紧到 ±5 %，并且留下可追溯的实测 L。推荐：

1. 两半 ELP 中柱各磨 0.0605 mm（合计 0.121 mm），留 +0.010 mm 余量；
2. 装 3 匝临时线圈，100 kHz 小信号测 L；
3. 补磨到 10.0 µH，记录实测 L 与日期码；
4. 验收 10.0 µH ±10 %；若批次 AL 偏离，按实测 AL 重算气隙，而不是放宽验收。

气隙只开在中柱，外侧两腿保持贴合。0.121 mm 气隙的边缘磁通会扫到 18 mm 宽的
铜箔；一维 Dowell 模型不含边缘磁通，这是本包最大的未验证项（§9）。缓解：
气隙两侧各留 ≥1.5 mm 无铜区，或改用分布式气隙磁芯；前者会牺牲一点铜宽，
后者需要重新选型。

## 4. 绕组

### 4.1 导体

- 原边：0.10 mm × 18 mm 铜箔，3 匝/只，平均匝长 60 mm。
- 副边：每半 1 匝，**两层 0.10 mm × 18 mm 铜箔并联**，平均匝长 60 mm。
- 层间：0.05 mm Kapton（同绕组内），0.10 mm Kapton（原副边之间）。
- 外层：0.10 mm 胶带。

铜宽 18 mm 是设计选择；机械上限是磁芯深度 25.4 mm 减两侧各 1.5 mm = 22.4 mm。
选 18 mm 是为了给气隙边缘磁通留 3.7 mm/侧。若后续把铜宽加到 22 mm，铜损约降
18 %，但边缘磁通风险上升；不要在没有量热数据时同时改宽度和气隙。

### 4.2 交错叠层（自下而上）

见 `winding_cross_section.svg`。

| 层 | 材料 | 厚度 |
|---|---|---|
| 1 | P1 铜箔 | 0.10 mm |
| 2 | Kapton | 0.05 mm |
| 3 | S_A 双层铜箔 | 0.20 mm |
| 4 | Kapton | 0.10 mm |
| 5 | P2 铜箔 | 0.10 mm |
| 6 | Kapton | 0.10 mm |
| 7 | S_B 双层铜箔 | 0.20 mm |
| 8 | Kapton | 0.05 mm |
| 9 | P3 铜箔 | 0.10 mm |
| 10 | 外层胶带 | 0.10 mm |
| — | **合计** | **1.10 mm** |

叠层顺序 P1 / S_A / P2 / S_B / P3 是交错绕组：原边三层被两个副边半夹住，
漏感低于 P1-P2-P3 / S_A-S_B 的简单堆叠。代价是原边三层处于不同窗口位置，
层间电压应力由 0.10 mm Kapton 承担。

窗口净高 3.20 mm；绕组 1.10 mm + 载体 0.20 mm = 1.30 mm，标称剩余 1.90 mm，
最坏窗口（3.05 mm）剩余 1.75 mm。空间不是约束。

### 4.3 电流密度

| 绕组 | 100 A 时 RMS | 铜截面 | 电流密度 |
|---|---|---|---|
| 原边 | 9.450 A | 18 × 0.10 = 1.8 mm² | 5.25 A/mm² |
| 副边每半 | 19.92 A | 2 × 1.8 = 3.6 mm² | 5.53 A/mm² |

5.3 A/mm² 对 100 °C、有限气流的平面绕组属于常规值，但没有热模型；见 §9。

## 5. 铜损：Dowell + 实测电流

Dowell 系数（δ = 0.1676 mm @100 °C、200.6 kHz）：

```
F_R = Δ·(sinh2Δ + sin2Δ)/(cosh2Δ − cos2Δ)
    + (2/3)(m²−1)·Δ·(sinhΔ − sinΔ)/(coshΔ + cosΔ)
```

| 绕组 | 层数 m | R_dc/只 | F_R | R_ac/只 | 100 A 损耗（4 只） |
|---|---|---|---|---|---|
| 原边 3 匝 | 3 | 2.397 mΩ | 1.043 | 2.501 mΩ | 0.893 W |
| 副边每半 2 箔并联 | 2 | 0.371 mΩ | 1.053 | 0.391 mΩ | 1.241 W |
| **合计** | | | | | **2.135 W** |

95 A 时对应 1.766 W。**100 A 的电流是实测的，不是把 95 A 按 I² 放大：**
线性放大会得到 Ipri 9.04 A、Isec 19.05 A，实测是 9.450 A、19.92 A，铜损低估
约 9 %。原因是负载加重后谐振腔电流波形更接近方波，波形因数上升。

## 6. 损耗预算与效率

以 100 A 实测点（48 V、Vout 1.8867 V、Pout 188.345 W）为基准：

| 项目 | 损耗 | 占比 |
|---|---|---|
| 同步整流 8 器件 | 7.338 W | 47.2 % |
| 原边开关 + Cr + 模型磁件 Rser | 3.015 W | 19.4 % |
| 变压器铜损（本设计） | 2.135 W | 13.7 % |
| 输出路径 0.15 mΩ | 1.495 W | 9.6 % |
| 辅助/驱动余量 | 0.750 W | 4.8 % |
| Lr | 0.447 W | 2.9 % |
| 磁芯（四套） | 0.353 W | 2.3 % |
| **合计** | **15.532 W** | 100 % |

- 变换器端（不含 0.15 mΩ 输出路径）：损耗 14.037 W，效率 **93.06 %**。
- 含输出路径的系统效率：**92.33 %**（负载端 Pout 186.85 W）。
- 95 A 对照：总损耗 13.744 W，系统效率 92.82 %，变换器端 93.53 %。

注意：模型自身的整机效率（`round4_summary.json`）是 94.31 %，但它用 0.15 mΩ
副边 Rser、没有磁芯损耗、没有真实偏置电流、没有输出路径。本包的 92.3 % 才是
可用于硬件讨论的估计。两者不是矛盾，是模型边界不同。

## 7. 100 A / 200 W 的可行性结论

24:1 固定比在 48 V 下的理想空载输出是 2.000 V。任何负载压降都会让 100 A 时
的输出低于 200 W：

| Vin | 100 A 时 Vout（模型） | Pout |
|---|---|---|
| 46 V | 1.803 V | 180.3 W |
| 48 V | 1.887 V | **188.3 W** |
| 50 V | 1.970 V | 197.0 W |

实测模型压降 R_out = (2.000 − 1.886686)/99.82464 = **1.135 mΩ**。要达到
200 W @100 A，需要 Vout = 2.000 V，即零压降；用实测压降反推：

```
Vin_required = 24 × (2.000 + 100 × 1.135 mΩ) = 50.72 V
```

即使允许 50 V 上限，100 A 也只有 197 W。结论：

1. **48 V 输入的诚实额定值是 100 A / 188 W**，不是 200 W。
2. 若 200 W 是硬指标，有两条路：输入电压上限提到 ≥50.7 V，或在 50 V 下再降
   约 3 W 损耗（例如把 SR 导通损耗降 40 %，或把输出路径从 0.15 mΩ 降到
   0.05 mΩ 并同步降低磁件铜损）。
3. 若 100 A 是硬指标、200 W 只是“峰值”，则应在路线图里写成
   “100 A 连续 / 188 W @48 V，197 W @50 V”，不要写成“100 A / 200 W”。

这是对路线图远期目标的**证据化降额**，符合任务书允许的“明确降额的已验证额定值”
口径；不是把判据放宽。

## 8. 高度与机械

见 `height_stackup.svg` 与 `height_stackup.csv`。

| 组成 | 标称 | 最坏 |
|---|---|---|
| ELP 半 + I 片 | 9.50 | 9.80（套件最大，不是两件最大值相加） |
| 胶 | 0.05 | 0.08 |
| 标签 | 0.05 | 0.06 |
| **平铺合计** | **9.60** | **9.94** |
| 10 mm 限值 | — | 平铺余量 **0.06 mm** |
| **0.5 mm 沉槽合计** | **9.10** | **9.44** |
| 10 mm 限值 | — | 沉槽余量 **0.56 mm** |

- **平铺方案（9.94 mm）只够样机，不够量产。** 0.06 mm 余量小于 PCB 翘曲和
  焊膏厚度的常见波动；它依赖“磁芯恰好落在 9.80 mm 上限、胶/标签也恰好在上限”
  同时不发生，实际不可控。
- **推荐：PCB 开 0.5 mm 沉槽**，磁芯下沉，最坏 9.44 mm，余量 0.56 mm。这是
  在 10 mm 硬限值下唯一有余量的机械方案，且不改变磁路。
- **不能用跨顶金属夹**：0.5 mm 夹子会把最坏高度推到 10.44 mm。
- 若无沉槽又必须用夹子，只能改小一号磁芯（需重做磁件窗口与铜宽），本包不覆盖。
- 4 只并排的占位约 4 × 31.75 = 127 mm，加间隙；本包不含整机布局。

## 9. 未验证假设（必须单列）

1. **气隙边缘磁通未建模。** Dowell 是一维模型；0.121 mm 气隙在 18 mm 宽铜箔
   附近会产生额外涡流。可能把铜损抬高 10–30 %（+0.2–0.6 W），不改变 §7 的
   结论，但会改变 §6 的效率小数点。需要阻抗分析仪或量热验证。
2. **磁芯损耗是 B²f² 上界，不是 N97 在 20 mT/200 kHz 的实测点。** 数据表只给
   200 mT/100 kHz；低磁密外推的误差方向未知。按上界使用。
3. **没有热模型。** 5.3 A/mm²、每只 0.62 W（铜+芯）的温升未计算；需要热电偶
   或热像仪。若铜箔热点超过 120 °C，Kapton 与胶的寿命要重评。
4. **并联箔之间的环流未建模。** 两层副边箔在两端焊接，长度/电阻不完全对称
   会产生环流；工艺上要求两端同时焊、等长。
5. **没有做爬电距离/电气间隙标准判定。** 0.10 mm Kapton 的耐压与系统安全等级
   有关；本包只给 500 VDC 板级 hipot，不给安规结论。
6. **机械公差只覆盖高度方向。** 未做 31.75 × 25.4 mm 平面公差、焊点应力、
   振动/跌落分析。
7. **磁件参数取自模型，不是硬件。** Lm=10 µH 与模型 `LP=10u` 一致；实际磁芯
   的 AL 公差、温度系数、直流偏置未测。

## 10. 复现与文件

```bash
# 100 A 工作点（读 313 MB ASCII raw，约 20 s）
python tools/extract_op_point.py sim/v3/sr_tank_dual_v33_ss_1ms_100a.raw \
    --rl 0.0189 --periods 22 \
    --json design/v3/magnetics/operating_point_100a.json

# 磁件预算
python tools/magnetics_design.py --json design/v3/magnetics/magnetics_design.json

# 两张 SVG
python tools/draw_magnetics.py --out design/v3/magnetics

# 全部离线测试
python -m pytest tools -q
```

| 文件 | 内容 |
|---|---|
| `magnetics_design.json` | 全部计算值（磁芯、气隙、磁密、铜损、损耗、高度、100 A 输出） |
| `operating_point_100a.json` | 从 raw 提取的 100 A 工作点与窗口 |
| `winding_cross_section.svg` | 窗口内叠层剖面 |
| `height_stackup.svg` | 高度堆叠与 10 mm 限值 |
| `height_stackup.csv` | 高度公差表 |
| `inspection_spec.csv` | 来料/过程/成品检验项 |
| `manifest.json` | 本包与仿真输入的 SHA256 |

100 A deck 由 `sim/v2/sr_tank_dual_v33_ss_1ms.cir` 复制，仅把 `RL=20m` 改为
`RL=18.9m`；LTspice 日志 `Total elapsed time: 176.203 seconds`，无
“time step too small”。raw 头 `No. Variables: 59`，`Offset: 8.8e-04`。
