czy0126/CZY/design/v3/stage_f/首样验证与额定值判定_2026-10-31.md

# 首样验证与额定值判定（路线图 Stage E/F 执行包）

日期：2026-10-31
状态：**测试协议，不是验证结果**。本文件把 Stage F 的门槛（"100 A 热稳定运行，或明确实际可用电流并修改额定"）
变成可执行的测试矩阵和判定规则；在首样测出数据之前，任何"100 A 连续"都只是设计估算。

## 0. 结论先行

- 热预检（`thermal_precheck.json`）：100 A 下 SR 总损耗 7.338 W，8 只 BSC010N04LS6 每只 0.917 W。
  按手册 50 K/W（PCB 6 cm² 铜，手册最大值）：25 °C 环境 Tj = 70.9 °C，40 °C 环境 Tj = 85.9 °C；
  若只有更小的铜面积（按 80 K/W 粗略估计）：25 °C 时 Tj = 98.4 °C，40 °C 时 Tj = 113.4 °C。
- Tj ≤ 125 °C 判据对应的最高环境温度：6 cm² 铜时 79.1 °C，80 K/W 时 51.6 °C。
  **结论：100 A 连续在热上"可行但取决于铜面积和冷却条件"，必须用实测温度定额定，不能由本预检签核。**
- 若首样只能在较低电流热稳定，按 §5 发布该电流为已验证额定；**不用短时冲到 100 A 代替热验证**。

## 1. 被测对象与前置条件

1. 磁件：按 `磁件设计包_2026-10-31.md` 与 `inspection_spec.csv` 的 15 项检验；先单件测 Lm、
   短路漏感、DCR、极性、高度，再四件做分散性。Lr 要测电流下的电感保持率。
2. 板：实验板（丝印必须标"实验板"），偏置外供并单独计量；预留可换栅阻与测点。
3. 冷却条件必须写进记录：自然对流还是强制风冷、风速、环境温度。没有这一列，温升数字不可比。

## 2. 仪器与测量口径

| 量 | 方法 | 要求 |
|---|---|---|
| Pin | 功率分析仪或 6.5 位 DMM + 分流器，输入侧 | 含两路外供偏置功率；偏置不得漏计 |
| Vout | 四线 Kelvin，负载端 | 不计引线与接点压降，或单独记录 |
| Pout | `average(Vout²/R)` 或功率分析仪 | 不得用 `average(Vout)²/R` |
| 电流波形 | 罗氏线圈 / 分流器，四组分别记录 | 四组平均电流、绕组 RMS 都要有 |
| VGS/VDS | ≥100 MHz 示波器 | 记录通道时差、探头地参考 |
| 温度 | 热像仪 ±2 °C + 热电偶；Tj 用 VSD 法或壳温 + RthJC 反推 | 记录测点位置 |

## 3. 分级测试矩阵

| 级 | Iout | Vin | 环境 | 每点稳态时间 |
|---|---|---|---|---|
| 1 | 10 A | 46 / 48 / 50 V | 25 °C | 10 min |
| 2 | 25 A | 46 / 48 / 50 V | 25 °C | 15 min |
| 3 | 50 A | 46 / 48 / 50 V | 25 / 40 °C | 15 min |
| 4 | 75 A | 46 / 48 / 50 V | 25 / 40 °C | 15 min |
| 5 | 100 A | 46 / 48 / 50 V | 25 / 40 °C | 20 min 或到热稳态 |
| 6 | 54 V 边界 | 54 V | 25 °C | 5 min，仅记录，不作连续额定 |

每点记录：Vin、Iin、Pin（含偏置）、Vout、Iout、Pout、四组电流、η、Tj 最大值、磁芯/绕组/电容/端子温度、
VGS/VDS 与四组电流波形快照。上电顺序：先偏置与驱动，再限流主输入，逐级升流。

## 4. 通过判据

- **热稳态**：连续 10 min 内各测点 ΔT ≤ 1 K，才可称"连续"。
- **Tj**：全部 SR 器件 ≤ 125 °C（降额目标，非 175 °C 绝对上限）。
- **绕组**：≤ 105 °C；**磁芯**：≤ 100 °C；**输出电容/端子**：≤ 各自手册上限并留 20 °C 余量。
  105/100 °C 是本项目的暂定值，首样前需确认绝缘等级（Kapton 0.05 mm 无等级声明）。
- **输出**：100 A 点 ±2 %；四组电流偏差 ≤ 10 %。模型四组对称，`iout_spread` 近零不构成均流证据。
- **效率**：记录实测值。设计估算 92.33 %（100 A / 48 V，含 0.15 mΩ 输出路径与 0.75 W 偏置）；
  若实测 < 90 %，先定位损耗项（SR/磁件/铜路/偏置），**不得直接改额定或放宽判据**。
- **高度**：0.5 mm 沉槽方案装配实测 ≤ 9.44 mm；平铺方案 ≤ 9.94 mm（余量仅 0.06 mm，仅样机）。

## 5. 额定值判定树

1. 100 A、40 °C 环境热稳态且 Tj ≤ 125 °C → 发布 **100 A 连续**，注明冷却条件与铜面积。
2. 100 A 仅在 25 °C 可行 → 发布 **100 A @ 25 °C**，或按实测给出 40 °C 下的降额电流。
3. 最高稳定电流 < 100 A → 发布该电流为**已验证额定**，记录瓶颈（最热器件 / 磁件 / 铜路 / 端子）。
4. 200 W 与 100 A 同时成立的条件：模型给出 48 V/100 A 仅 188.3 W（Vout 1.887 V，Rout 1.135 mΩ），
   `200 W @ 100 A` 需 Vin ≥ 50.72 V，或实测 Rout 更低。否则 200 W 与 100 A **不得同时发布**。

## 6. 记录模板（CSV 列）

```
timestamp,build_id,ambient_c,airflow_m_s,vin_v,iin_a,pin_w,bias1_w,bias2_w,
vout_v,iout_a,pout_w,eff_pct,iout_g1,iout_g2,iout_g3,iout_g4,
tj_max_c,core_c,winding_c,cap_c,terminal_c,height_mm,notes
```

## 7. 失败时的处理规则

- 单点失败先记录、再定位，不因一个未校准模型或一次测量改拓扑。
- 不以短时峰值、单次温升或模型积分替代热稳态。
- 首板只标"实验板"；额定值必须有 §3 的完整数据支撑。

## 8. 与现有交付的对应

| 文件 | 作用 |
|---|---|
| `design/v3/magnetics/磁件设计包_2026-10-31.md` | 磁件设计、损耗、高度、100 A/200 W 降额结论 |
| `design/v3/magnetics/inspection_spec.csv` | 磁件 15 项来料/装配检验 |
| `design/v3/magnetics/height_stackup.csv` | 高度公差与 0.5 mm 沉槽方案 |
| `design/v3/stage_f/thermal_precheck.json` | 本文件的 SR 结温预检 |
| `tools/thermal_precheck.py` | 预检复算（`python tools/thermal_precheck.py`） |

## 9. 未验证假设（不得当作结论引用）

1. SR 损耗 7.338 W 是模型估计；二极管反向恢复、沟道与栅阻分摊未经器件实测校核。
2. 50 K/W 是手册"6 cm² 铜"的最大值；实际板铜面积与风速未定。80 K/W 只是量级估计。
3. ELP32 的磁芯/绕组热阻没有数据，本文件不预测磁件温度，只给判据。
4. 效率估算未量化 Dowell 一维近似、气隙边缘磁通、输出电容 ESR 与端子接触电阻的不确定度。
5. 四组均流、启动鲁棒性与故障恢复不在本协议覆盖范围，需按各自测试单独验证。
