czy0126/CZY/docs/D1_保护数据配对与工程修补_2026-11-03.md

# 2026-11-03 最新工程审核与直接修补：PROT-02 对照可信度、SOA 表及性能优先关键路径

> 复核基线：`main@ae956a8579691bf8d474410bd2cfec752315642c`。成本不是约束；电气保护、真实硬件裕量与高度≤10 mm优先。详细冷板/稳态热设计继续暂缓；**不得将暂缓热设计解释为允许未经验证的 100/120 A 连续额定。**

## 1. 当天新证据：不能沿用前几轮审核的“尚未运行”标签

| 试验 | 新结果与实际适用范围 | 可信结论 |
|---|---|---|
| 48 V 八 SR 故障 | 原保护末端四只 A 侧SR高门压，但其末段每只约1.405 A，非持续285 A；cshunt小扰动下末态相位能翻转 | 模型对“最终哪一相门极高”敏感，不能把某相永久锁存写成已证硬件物理机制；仍需外部硬件故障关断 |
| 48 V PROT-A (OC 1V后执行钳位) | Lr峰约97.44→97.44 A，收益仅约0.006%；四组SR和主桥末态被钳低 | 原OC判据晚于电流峰值，单纯增加门极钳位不能明显降低此前峰值 |
| 48 V PROT-B (10µs快滤波+1.8V, arming) | 早约29.75µs动作，Lr峰97.44→45.94 A，SR正向I²t总计下降约95.2% | 同保存窗口/故障前配对的**行为模型**正向候选；不是厂商比较器、FET、实际SOA验收 |
| 50 V PROT-A/B (cshunt=1fF) | 两保护子变体均求解到320µs；候选B Lr峰约45.79 A、SR正向峰约139.35 A | **未能严格配对**：故障前Vout候选比原母模型高约13.238/17.514mV（A/B），所以50V的约55%下降暂时只能作探索性排序，不能直接作为有控制的因果百分比 |
| SR SOA 汇总 | 11组×8器件，最新表中模型最大正向峰约304.96 A，部分回路反向/漏极数据有缺失；暂无原厂SOA曲线 | 单纯“380A询样目标”不证明该器件在实际Vds/脉宽/结温下可承受；需数据手册、实际器件/封装和硬件测试 |
| D1制造 | 五磁件真实pad/DOT、61占位位号真实MPN/封装、GUI ERC、真实带网PCB/DRC仍未齐 | `NOT_FOR_FAB`，不是成本问题，也不能用行为模型通过替代 |

数据来自仓库 `design/v3/power_priority/` 的 `sr_fault_probe_*.json`、`protection_candidate_*.json`、`protection_soa_table.json`，不同窗口（`post_trip`与`saved_window`）不可交叉相减。

## 2. 本轮直接修复的实际工程缺陷

### A. 主分支 CI 失败：SOA 来源哈希与 Git 换行符不一致

`main` 最近一次 Actions run `41583665858` **1 failed / 673 passed / 7 skipped**，失败点是 `test_the_committed_table_is_current`。逐项比对显示源文件字段数值没有新型别变更，SOA表中的7份来源JSON哈希仍为此前生成环境的值，与Linux checkout不同。

- `tools/protection_soa_table.py` 中来源文本以**规范化 LF 后的 SHA256**入档，使 Windows CRLF 与 Linux LF checkout 对同一内容得一致的可复验哈希；原有源内容的数值引用与窗口边界仍然不被改动。
- 重新同步 `design/v3/power_priority/protection_soa_table.json` 中所有11条记录的来源哈希。
- 新增跨操作系统换行符一致性回归测试。**不允许通过跳过pytest或删除原有哈希检查修复红CI。**

### B. 原 SOA 总表将 50 V 非配对候选隐式地放进同一性能排名

新增每次保护对照的 `paired_pre_fault`、`pre_fault_vout_delta_mv`、`paired_change_can_be_attributed_to_protection` 字段；`reached_declared_window` 和 `solver_prefix_only` 不再固定填写，而从原候选JSON的 `coverage` 重算。**50V四行A/B base/candidate现在一律不标配对，48V对照则需<1mV偏移且完整窗口。**

新回归测试专门要求这种“不能宣称因果”的差异保留。即使成本无限，也不以无效实验比较作为器件选型依据。

### C. 直接准备了两份尚未运行的 50 V 同结构对照 deck

`tools/make_paired_protection_controls.py` 根据**已运行的PROT-A和PROT-B源**各生成一份 `*_noclamp_control.cir`：
- 保留独立滤波、锁存、十个保护开关、负载、故障支路、`.tran`、50V所需 `cshunt=1e-15`；
- **只把 `PROT_KILL` 的动作阈值0.5V改为10V**，使 `V(inhib)` 在0–1V间不能闭合钳位，从而形成尽量接近候选数值结构、但不实际发挥保护钳位作用的对照；
- 此对照**故意不具有保护功能，绝不能作为硬件保护方案**。生成器与单测证明没有修改功率网表、控制与故障网络中的其他行；
- 对A/B分别运行真实LTspice到保存轴320µs，比较故障前相同35µs的Vout均值：配对要求候选与自己对应的no-clamp控制差**≤1mV**，二者完整求解，并重算Lr峰、SR峰和八只I²t。若仍无法配对，不应将50V下降幅度用于规格书。

这些是准备好的实验输入，不是宣称已经得到了新对照数据。

**补记（同日稍后运行，不属于本 PR 的文字范围）**：四份控制都跑了，结论是
`noclamp` 这一族**不能**满足配对。它确实跑满 320 µs，但故障前 `V(out)` 仍比候选低
**13.2 mV（A）/ 17.5 mV（B）**——改一个模型参数就换了一条求解器路径；开关本身是
电学开路的（`sim/v3/prot_switch_leak_probe.cir` 实测 `Vt=.5` 与 `Vt=10` 的漏流都是
**1.001e-9 A**），所以差异不是"钳位没关"。

因此追加了第二族 `_thrmute_control.cir`：开关模型**逐字节不变**，只把 `Bprot` 的触发
常数 1.0/1.8 V 抬到 100 V。它做到了**精确配对**（故障前差 **0.000000 mV**，触发前
961 298 / 824 449 个采样点逐位相同），但**求解器塌缩**：A 停在 **250.151 µs**、
B 停在 **254.980 µs**，两窗口都不完整。**PROT-03 的两条判据仍不能同时满足**：
配对成立时窗口不完整，窗口完整时配对不成立。记录在
`design/v3/power_priority/protection_candidate_50v_120a_prot_{a,b}_paired.json`
（截断、配对）与 `..._noclamp_paired.json`（完整、非配对），逐项说明见
`PROT02_独立故障锁存候选对照_2026-11-03.md` §5.6。

## 3. 不受成本约束时，优先增加哪些实质性能

- **保护**：优先将已在48V行为模型上观察到显著应力下降的PROT-B快速支路，转换为**可实际采购和布线的独立比较器+可锁存控制+十门默认关断路径**；要求软启动屏蔽不会让启动电流锁死，又不能让屏蔽期间故障完全失去保护。须核查实际比较器速度、噪声误触发、UVLO重启、栅压控制、驱动能力及八只FET的真实瞬态SOA。
- **磁件**：依照已发布 `high_margin_design_gate.json`，提高有效横截面或采用低矮定制/分布气隙Lr；3匝建议RFQ最小`Amin≥200 mm²`。它是基于故障峰值×1.2、电感偏差×1.1和`B≤0.8Bsat`的**询样目标**，必须经实际`L(I)`、气隙边缘损耗和100°C B-H核验。
- **Cout**：不为省件数使用15只2.5V的模型候选直接投板；供应商目标为≥4V，优先6.3V，真实≥7.05mF、≥78.72Arms，以及包含铜/焊点的总ESR≤0.10mΩ，真实高度/过冲/温度/频率数据必须核验。
- **CAD/磁件端子**：优先买定制磁件首件、可验证pad图、真实器件/封装、低阻铜排和正规EDA审查时间，不应继续用新报告替代带网络PCB。允许增加PCB平面面积和铜材料，仍不得超高。

## 4. 后续路线与完成判据（相对工作日）

| 阶段 | 最有价值的并行动作 | 应交付的原始证据 |
|---|---|---|
| D1 | ~~先运行50V PROT-A/B两份no-clamp控制~~ **已跑（见 §2C 补记）**：no-clamp 完整但差 13.2/17.5 mV，thrmute 精确配对但停在 250.151/254.980 µs；同步把磁件24端图纸和9组性能优先询样表发厂商 | 四份原始.log/.raw及故障前Vout匹配检查（已入 `*_paired.json`）；磁件/料号询样回复责任人 |
| D2 | 按有效配对重新计算PROT-B降峰与I²t，若不匹配，追求再现稳定初态的数值方案；查SR正/反向及VDS同窗 | 可复算的差异/配对报告，不能只有百分比；真实SOA数据来源 |
| D3 | 制定快速比较器与实际十门关断电路的原理图；同时补齐P0关键器件MPN和厂商真实磁件pad | 故障安全路径可编辑原生图、实际原厂引脚及GUI ERC原文 |
| D4 | 磁件首样`L(I)`、高度和DOT验证；完成SR→Cout→端子真实带网络PCB | 高电流/磁件首件测量、真实PCB网表/DRC及大电流回流 |
| D5 | 审查保护与电感极限，执行DFM，检查BOM/封装/装配版本；热设计仍后续处理 | P0全部关闭才申请解除`NOT_FOR_FAB`；连续额定仍须真实热稳态 |

WBS增加 `PROT-03`（50V严格配对保护实验），现共26项；新任务列入 `QA-01` 的制造前验收依赖。估计工作日仅表示执行顺序，**不宣称厂家已回复或真实仿真会按计划完成**。

## 5. 可复验命令

```bash
python tools/make_paired_protection_controls.py
python -m pytest tools -q
python tools/ci_check.py
# 需要真实 Windows LTspice 做新 .cir 求解与 RAW 分析；本PR并非运行者
# （控制已于同日补跑：noclamp A 559.690 s / B 527.175 s 跑满 320 us；
#   thrmute 按 PID 终止，停在 250.151 / 254.980 us）
python tools/d1_fabrication_gate.py --require-release # 未关闭问题时应继续非零
```

**本轮成果边界**：修复CI错误和证据分级，提供新数值对照deck及测试，更新WBS。没有虚构原厂签核、50V严格配对新数据、原生主PCB或硬件100/120A额定。详细热与冷板设计继续暂缓；电气SOA、故障安全与真实可制造性必须先审查。
