czy0126/CZY/docs/D1_性能优先增量审核与高裕量实施路线_2026-11-03.md

# 48 V→约 2 V DCX：性能优先、不设成本上限的增量审核与 D1 工程路线

> 审核基准：仓库 `main@7434abbace7805f8fd1ee89fb941eae4004607c6`，2026-11-03。  
> 用户新的设计取舍：**不在意物料成本**，为提升输出能力、保护可靠性和供货冗余可以增加器件数量、占板面积、铜材和加工复杂度；**不放宽总高≤10 mm、真实器件SOA、原生PCB/制造证据与数据可信度**。详细热/冷板设计暂缓，连续额定仍不能签核。

## 一、本次增量审核（已接入最新八只 SR 故障波形）

| 检查 | 实际证据 | 工程判断 |
|---|---|---|
| 48 V 120 A 稳态初始化后故障 | 八只 SR 原始波形归档 `sr_fault_probe_48v_120a.json`；四只 **A 侧**在 **247.070 µs** 重新抬升并持续高栅压约 **72.93 µs**；B 侧最终关断。此末段 A 器件最大绝对电流 **1.405 A**、每只 I²t **1.039×10⁻⁴ A²s**、四只总计 **4.155×10⁻⁴ A²s** | 先前仅称“SR 持续导通风险”不够准确：**高电平末段并非持续 285 A**；故障最初高峰主要发生在 OC 刚动作前后。仍缺真实 UCC24624 standby/电路级关断证据，不能从“小电流”推出安全 |
| 50 V 120 A 稳态初始化后故障 | 原模型在保存轴 **296.929 µs** 停止，OC 约 **39.92 µs** 延迟、Lr **101.26 A**、单 SR 模型 **303.93 A** 峰值 | 只能把前缀作有界峰值诊断；**50 V 完整 320 µs 八只 SR 波形未提交**，不能签核完整故障 |
| 磁件 | ELP32 / N97 名义 3 匝 / 1µH、Ae≈130mm²；50 V 故障模型峰值 101.26 A 时 B≈0.260 T，而设计限值是 0.279 T | 只剩 **0.019 T 名义余量**；成本不敏感后不应继续把它当充分的供应商定版裕量 |
| 50 V 119.27 A 能量账本 | 133 周期相位对齐损耗清单差 **0.492 W > 0.2 W**，50 V 110/120 A、100 A 仍有独立闭合和步长问题 | `NOT_CLOSED`，**模型端口效率不是已核定硬件效率**；不强制阻塞 CAD 继续设计，但应阻塞输出额定宣称 |
| D1 原生主板 | 已有83逻辑位号/网表映射，五磁件真实端子、61占位真实MPN、GUI/ERC和真实PCB仍未交齐 | **NOT_FOR_FAB** 维持；价格再高也不能替代真实实物引脚或编辑器报告 |

本轮新增的可重生文件：
- [高电气裕量计算与 P0 决议数据](../design/v3/power_priority/high_margin_design_gate.json)；
- [9 组性能优先供应商/工程选型 RFQ](../hardware/dcx_main/performance_first_component_rfq.csv)；
- `tools/performance_first_design.py` 及测试。**所有新推荐均是 RFQ 目标，不是已采购 MPN 或已制造样品**。

## 二、直接修订工程选型：优先买电气裕量与可制造余量，而非价格

### 1. Lr 是性能升级的第一笔预算

继续保持谐振腔总电感及漏感关系：`Lr_external + L_leak ≈ 1µH`，不因“成本无上限”擅自修改频率/谐振参数。用观测到的 50 V 早期故障 **101.263 A** 作为输入，仅为 RFQ 考虑 20% 电流余量与 +10% 电感制造/工况上偏差：

\[
I_{design}=1.20\times101.263=121.515\text{ A},\quad
L_{max}=1.10\ \mu\text{H},\quad
B_{design}\le0.80 B_{sat,100^\circ C}=0.248\text{ T}.
\]
\[
A_{e,min}=\frac{L_{max}I_{design}}{N B_{design}}.
\]

| 候选方案 | 最小有效截面要求 | 参考最坏估计磁通 | 决议 |
|---|---:|---:|---|
| 原 ELP32 / 3 匝，`Amin=128mm²` | 现有128mm² | **0.348 T** | **不满足本轮稳健设计余量** |
| 3 匝 / 自定义低矮大截面磁芯 | 数学下限 **179.66mm²**；建议 RFQ **≥200mm²** | 200mm² 时 **0.223 T** | **首选询价与磁件打样路线** |
| 4 匝 / 低矮分布式气隙备选 | 数学下限 **134.74mm²**；建议 **≥150mm²** | 150mm² 时 **0.223 T** | 只作为备选；需重新验证气隙、AC铜损、邻近效应与高度 |

**以上磁通属于基于常数 L 的工程估算**，不是实测 BH 曲线，也没有定温度后真实 `L(I)`。不建议将原 ELP32 三匝简单改成四匝、保持大单气隙就直接定版；分布气隙或增大有效面积的低矮专用磁芯更值得为性能付费。真正决定选型的是100°C/目标环境温度下的 `L(I)`、漏感、绕组阻抗、DOT、实体焊盘/封装、装配及≤10mm总高。

### 2. Cout 选型不能再由“最少15只、2.5V”主导

现有候选 15×470µF/2.5V 且理想电容组 ESR 0.2mΩ，只能说明模型实现过等效 7.05mF，不说明它能够在真实PCB上承受纹波、瞬态过冲和偏置寿命。

**本轮新 RFQ 目标**：

- 在 200kHz 附近、实际温度/寿命/直流偏置下有效 `C ≥ 7.05mF`；
- **耐压 ≥4V**，能满足高度的前提下优先询问 **6.3V** 产品；过冲必须另测，不是说6.3V一定装得下或寿命一定合格；
- 已仿真输出电容纹波约52.48 A RMS，采购/设计目标 **≥78.72 A RMS**（×1.5余量），按原厂频率/温度校正；
- 电容组 **ESR≤0.07mΩ**，实际 PCB 扩散铜箔与焊点预留 **≤0.03mΩ**，**总≤0.10mΩ**。若目标太严导致无法制造，应由真实封装/阻抗/面积权衡明确提出 ECO，不要暗改模拟 ESR。

代价允许是更多贴片器件、更多电流汇流层、铜嵌件与更大平面尺寸；但必须核查 SR→Cout→输出接口的高频电流环路，**不能只算 N 只理想电容并联的 ESR/N**。

### 3. SR 器件与保护：先做能真正禁止高栅极的路径

50 V 故障模型单 SR 正向电流峰约303.93 A，初步供应商 SOA **筛选电流≈380 A**（×1.25，仅供询问；需真实脉宽、VDS、反向电流、结温及封装电流能力下的 SOA）。不因为成本高就直接并联更多 FET：增大栅极电容可能拖慢关断，甚至加重故障。

**新增结构任务，尚未改动 V3 已运行基线电路**：

- 原边半桥和所有八只 SR 应受**同一故障锁存的独立硬件关断信号**控制；默认欠压关断、无效门控不能变成高电平、重启前必须确认安全状态。与现有 47µs OC 滤波串联的快比较器通道可作为候选，是否需要硬件延时≤10µs应由噪声、负载阶跃和真实故障波形共同确认；
- 对比“现有 UCC25600 OC 闭环停振”与“独立 SR gate inhibit”：实际判据是每只 `Vgs(t), Vds(t), Id(t)`、关断/重启、I²t、硬件供电跌落时的默认门态，而不是只有 `V(oc)>1V`；
- 48 V 的后段高门极实际模型中电流仅约1.41A，这个事实可以缩小故障根因排查，但**不能先签安全后补关断设计**。
- 建议增加与控制验证板相独立的限能保护夹具：在测试前先验证故障信号到SR关断的传播、两路电源失压、控制器复位、CT断线/负载骤变。

### 4. 其他部件按裕量而非成本收紧

- **Cin**：已有约5.316 A RMS桥臂纹波，要求按≥8A RMS 200kHz附近筛选，并在实际电源内阻下重做；不因模型的理想1mΩ母线而选小电容。
- **Cr**：原模型约9.45A RMS/峰压41.36V，首批供应商目标≥15A RMS、≥100V DC额定，优先低ESR/ESL；不得用频率不一致的 ESR 直接估损耗。
- **输出连接器/铜排**：允许更大截面、并行触点、重铜/埋铜、Kelvin 四线采样，首件实测总回路接点及铜损，注意≤10mm上限与机械约束。

## 三、后续五个工作日的最短关键路径

| 阶段 | 保护主线（与其他组并行） | 磁件/选型主线 | EDA/PCB 主线 |
|---|---|---|---|
| **D1** | 分析已运行48V八SR `final_latch` 数据；明确模型缺失的standby/真实栅极输出路径 | 同时发旧的[24端真实脚号表](../hardware/dcx_main/supplier_magnetic_terminal_reply_template.csv)和新的[性能优先RFQ](../hardware/dcx_main/performance_first_component_rfq.csv)，重点找低矮 Ae≥200mm²/3T 的定制 Lr | 完成真实 MPN/封装资料追踪表并识别不可购买的占位件 |
| **D2** | 先修复/明确50V故障在296.929µs停止的求解原因；再跑完整八SR曲线 | 为 Lr 报价之外要求 `L(I)`、3D/DOT、气隙/电感公差，Cout先筛≥4V/6.3V、有效纹波≥78.72A组 | 实物 CT 4逻辑端的焊盘缺口必须由厂家签字图解决 |
| **D3** | 独立锁存关断候选→SPICE对比→根据安全时序再决定硬件关断连接 | 2~3家不同结构的定制磁件及高压低ESR电容样品并行，实际电气数据未有则标PENDING | 原生EDA写入签过字的器件封装，保存重开后导出全ERC及网表 |
| **D4** | 完整48/50V保护/反向电流/SOA表；不能就改模型或换FET/驱动重测 | Lr测`L(I)`、四变压器DOT与漏感，Cr/Cin有效RMS、端子四线法 | 带网主PCB优先布四组SR→Cout→输出接口与Kelvin回流，DRC/大电流铜箔审核 |
| **D5** | 风险闭合评审，不以“峰值变化亚百分点”代替末端关断 | 合格型号与实测首件锁版本/二供可替换性 | 真实GUI ERC/DRC/DFM、Gerber及BOM版次一致，审定能否投板 |

**准入分层：** CAD人员和供应商可以先推进布局/磁件首件；但**主功率板投板**必须由P0保护安全、真实端子/材料、原生ERC/有网PCB/DRC同时通过后才能解开`NOT_FOR_FAB`；而**连续100/120A额定**必须等待后续热稳态及硬件证据。目标工期为任务排序，不构成已获报价或一定交付日期。

## 四、关于48V/2.00V与“追求更高输出”的边界

24:1 固定变比在48V输入下理想输出正好2.00V，现实导通压降只能降低输出。成本无限也**不能在不改变电压比/输入前级的情况下凭空消除所有压降**。现有50V/119.27A模拟输出约1.944V/231.87W；可以作为**更高输出候选**，但不等于48V、2.00V、120A已经达到。

如果硬指标是`48V输入、负载端2.00V`，应另立**变比/前级电压方案的架构ECO**；该实验不覆盖当前24:1候选的CAD或真实保护验证。详细热设计仍后置。

## 五、复现与证据

```bash
python tools/performance_first_design.py
python -m pytest tools -q
python tools/ci_check.py
python tools/d1_fabrication_gate.py --require-release # 尚应明确拒绝
```

本轮并未替厂家签名、也没有凭空生产4V/6.3V Cout或Ae≥200mm²磁芯的真实MPN：这批文件是可验证的**设计候选与询样要求**，不是采购确认或硬件签核。下轮开发优先交付：保护关断候选对照仿真 + 磁件与Cout真厂家数据 + 真正带网PCB。
