czy0126/CZY/docs/D1_最新仿真风险与关键路径_2026-11-02.md

# 2026-11-02 D1 增量审核：稳态后故障、电气风险与最短交付路径

> 审核基准：`main@9c5a40d7eb3de6a6f53572d37491da1a8137e46e`，已有 50 V 和 120 A 真冷/过载新结果。  
> **本轮遵从现有任务取舍：详细热/冷板设计暂缓，可为更高输出承担一定损耗，但不得降低器件电压/电流限值、保护完整性和制造安全要求。**  
> 结论：**仿真工况取得真实进展，主功率板仍 NOT_FOR_FAB；目前最大增量风险不是“没运行”，而是“已运行的故障仍缺稳态后的完整验证”。**

## 1 本轮对最新主线实际证据的审核

| 新证据 | 当前结果（全部为 LTspice 模型） | 审核判断 |
|---|---|---|
| 50 V / 110 A 目标 | 109.643 A，213.992 W，端口效率 94.207% | 已运行；能量闭合 `NOT_CLOSED`；不能当整机硬件效率 |
| 50 V / 120 A 目标 | 119.268 A，231.874 W，端口效率算式得到约 93.716% | 已运行，但损耗端口清单相差 **+0.499 W**，高于 0.2 W 目标；**133 周期相位对齐窗口复算为 0.492 W**（只动 −0.007 W，sem 0.050 W），已排除"短窗伪影"，缺口稳定且根因未定；不得将这个效率标成已核定 |
| 48 V / 120 A 目标真冷启动 | 末端 121.674 A / 228.000 W；到 90% 终值 3.083 ms；原边峰 24.134 A | **8 ms 完整**，Cout 从零起步；不是热/额定认证 |
| 48 V / 120 A 目标 8.70×过载 | 5.55 ms 投入、41.809 µs 过流跳闸、原边峰 **84.827 A**、SR 瞬态正向峰 **255.2 A** | 投入时 `V(ss)=3.7815 V`，**软启动尚未结束**；7.5714 ms 求解器塌缩，记录只是有效前缀，不可证明完整恢复/重启。**cshunt=1 fF 补救无效且更早塌缩**（5.6141 ms，早 1.96 ms）：公共 5.400–5.614 ms 切片上 trip +580 ns、`I(Lr)` 峰 −0.040 %、SR 正向 −0.072 %、0 条电路差异 ⇒ 已发布峰值不是该求解器设置的伪影，但 8 ms 仍无完成记录；F02 仍 blocked |
| 48 V / 50 V 120 A 稳态后过载（ELE-08） | 48 V：8.7×、trip **40.10 µs**、原边峰 **97.443 A**、SR 正向峰 **292.61 A**，跑满 320 µs、求解完成、严格日志校验通过；50 V：9.15×、trip **39.92 µs**、**101.263 A**、**303.93 A**，**基座求解器在 296.929 µs 塌缩，只有前缀证据**；`cshunt=1e-15` 求解器变体（同电路、0 条电路差异）跑满 320 µs，同窗峰值差 −0.164 %（`I(Lr)`）/−0.143 %（SR 正向）、trip 晚 99 ns。两者故障前 `V(ss)=5.0448 V`、`Vout` 半窗漂移 5.5e-5 / 2.2e-4 | **软启动中的故障低估了应力约 15–19 %**；选型与磁通判据必须用这一组。仍只是模型，非硬件 SOA/热证据；50 V 基座数字须标注"前缀"，变体须标注 cshunt 条件 |
| 100 A SR 能量专项 | 133 周期对齐窗口的步长序列 5/2/1/0.5 ns：端口 10.889/11.423/10.126/9.411 W，损耗 10.731/11.356/9.980/9.053 W；闭合周期平均 0.326/0.314/0.309/**0.523** W | **四段无平台**：最后一段仍反向（−0.715 W）且仍大于首段（+0.534 W），SR 体二极管正向项跨段摆 **2.30 W**；0.5 ns 段把损耗残差推到 **0.358 W**（唯一一次越过 0.2 W）。"再减步长看收敛"已被证伪，**数值收敛不通过**。组对称性只有 pair1/pair4 可测：5/2/0.5 ns 的 `pair4/pair1` 恰为 1.000000，1 ns 为 0.979/1.020（反向、数值重分配），给 x4 缩放留约 **4 % I²R / 0.25 W** 的界；pairs 2/3 **UNKNOWN** |
| D1 原生主板 | 83 位号、285 焊盘逻辑映射；五磁件暂无真实实体 pad、61 占位位号、GUI/ERC 和真正有网 PCB 未交付 | **NOT_FOR_FAB** 不变；代码/伪 ERC 不替代原生编辑器与供应商 |

引用：`design/v3/power_priority/50V110A_120A_实测_2026-11-02.md`、`48V120A_冷启动与故障_2026-11-02.md`、`d1_fabrication_gate.json`。机器可重现风险记录见 [unclosed_risk_register.json](../design/v3/power_priority/unclosed_risk_register.json)。

**新增设计层面实质结论：** Lr 当前估算 `Ae=130 mm²`、`L=1 µH`、`Bsat=0.310 T`，90% 限值 0.279 T。用已出现的 **84.827 A** 峰值（非外推）计算：

\[
B_{2\,turns}\approx0.3263\ \mathrm{T}>0.279\ \mathrm{T},
\qquad B_{3\,turns}\approx0.2175\ \mathrm{T}<0.279\ \mathrm{T}.
\]

**两匝方案不放行**。三匝仅是磁通计算上的候选，仍应测 `L(I)`、气隙一致性、材料实际 Bsat（尤其温度）、故障关断延迟与 50 V 故障峰值。不要仅凭模型中 3 匝 B=0.218 T 就宣称磁件已签核。SR 约 255 A 模型峰值也必须结合器件瞬态 SOA/封装互连/真实均流独立审核，暂时不能当作硬件可承受证据。

**ELE-08 之后，84.827 A 只是下限**：稳态故障峰值 97.443 A（48 V）/101.263 A（50 V）对应 2 匝 **0.3748 / 0.3895 T**，均超 0.279 T 判据（超 34 % / 40 %）；3 匝 0.2499 / 0.2596 T，50 V 只剩 **0.0194 T** 余量。MAG-02 的首件验收应按 **101.26 A** 而非 84.83 A 讨论，且所有这些 B 都是线性 L 模型下的下限。记录见 `48V120A_稳态初始化故障_2026-11-02.md`。

## 2 本轮已经直接补充的工程文件

- `tools/d1_unclosed_risks.py`：从实际 JSON 读取原边故障峰值、软启动状态、求解完成标志、Lr 三匝裕量、50 V 端口差与账本状态，生成 [unclosed_risk_register.json](../design/v3/power_priority/unclosed_risk_register.json)。**所有 P0 仍为 BLOCKED，禁止凭空变绿。**
- `tools/make_hot_fault_decks.py`：生成两个**新独立** [48 V](../sim/v3/sr_tank_dual_v33_ss_hotfault_48v_120a.cir)、[50 V](../sim/v3/sr_tank_dual_v33_ss_hotfault_50v_120a.cir) 120 A 目标过载仿真。以运行过的稳态候选为母本，保留 `.ic V(out)=1.89 V(ss)=4`，用 `.tran 0 2320u 2000u 5n` 从 `t=0` 运行到绝对 **2320 µs**，在绝对 **2175 µs** 由受控开关并入 `1m+1m` 故障支路。**开局是 2 ms 而不是 1 ms**：`.ic V(ss)=4` 以 0.5 mV/µs 上升，1 ms 才 4.485 V（低于 PR #20 的 4.8 V 前态门槛），2 ms 自然到 5.045 V——拉长窗口而不是改 `.ic`。**仅为稳态初始化后的短时故障研究，绝非真冷启动。** 48 V 已跑满保存窗并完成；50 V 在 296.929 µs 塌缩，只有前缀。提取记录见 `hotfault_{48v,50v}_120a.json` 与 [48V120A_稳态初始化故障_2026-11-02.md](../design/v3/power_priority/48V120A_稳态初始化故障_2026-11-02.md)。
- 新仿真将 **2000..2320 µs** 保存为 0..320 µs 的时间轴；故障投入在保存后的 **175 µs**。单独 `.meas HOT_* ` 用 120..170 µs 做故障前比较、175..320 µs 做投入后应力，避免误把母 deck 原先 0..120 µs 的稳态 `.meas` 当成故障结论。实测两条判据都过（`V(ss)` 5.045 V、`Vout` 漂移 ≤2.3e-4），但 **trip 后主桥停振、`V(ss)` 跌到 0.088 V，且有一相 SR 门极被重新拉高并保持**——`sr_timing_v3_3` 不实现 UCC24624 的 standby 关断，这是模型边界，不能读成"SR 已安全关断"；但该窗口只有约 0.1 ms，而 `tSTBY_DET` 是 7.5 ms，所以待机既不是锁存的原因，也不是 50 V 塌缩的修法。**"哪一相保持"是数值轨迹选的**：48 V 基座锁存 A 相四只，而同一 48 V 电路只加 `cshunt=1e-15` 后锁存 B 相四只（249.38 µs、1.199 A），故障应力只动 0.04 %（trip +1.9 ns、`I(Lr)` 峰 +0.038 %、SR 正向峰 +0.047 %）。所以末态门极电平只能当"模型在死区里的行为"；能跨变体保留的是锁存的低电流特征（1.2–1.4 A、每只约 1e-4 A²s），它仍不是安全关断证明。

## 3 最短工程推进：把角色和证据分开，三条线同时走

详细任务继续在 [d1_delivery_tasks.csv](../hardware/dcx_main/d1_delivery_tasks.csv) 中追踪，本轮新增 ELE-08、ELE-09、MAG-02，并将原 `ELE-07` 由“已完成”修正为“真冷已完成、故障只完成前缀，仍在推进”。

| 期限（相对工作日） | 原生 PCB / 物料主线（负责：EDA、采购、磁件） | 功率模型 / 保护主线（负责：仿真、电路） | 验收输出 |
|---|---|---|---|
| **D1** | 将 `vendor_terminal_request.json` 发厂商；将 61 位号拆为关键磁件/Cr/Cout/连接器与常用 R/C 两批 | 两个 hotfault deck 用 `make_hot_fault_decks.py` 做生成一致性校验，明确 LTspice 运行人与数据输出目录 | **已完成**：两 deck 入库并已运行；48 V 严格校验通过，50 V 只有前缀 |
| **D2** | 先核对 CT 4 逻辑端/2 实际焊盘的封装冲突，取得临时无造假解决方案（有供应商实体图才能出真实封装） | **已完成**：48 V 稳态后 120 A 故障跑满 320 µs；投入前 `Vss` 5.0448 V、`Vout` 1.8739 V、trip 40.10 µs、Lr 97.44 A、SR 292.61 A、求解完成 | `hotfault_48v_120a.json` + 校验报告 + `.log` |
| **D3** | GUI 中把已确认的真实 footprint 写入 EDA，保存关闭后重新打开检查；普通 R/C 快速完成 MPN 分配 | **收敛已解决**：`cshunt=1e-15` 变体（只改 `.options`，电路差异 0 条）跑满 320 µs（438.604 s / 941.9 MB），前缀比对见 `hotfault_50v_120a_cshunt.json`；八 SR 探针建在该变体上。基座前缀仍保留，二者不可混引 | 完整轴 RAW/LOG + 前缀比对；仍不能算"同口径基座完成" |
| **D4** | 取得有效 GUI/ERC 全错误列表并逐条整改；同步修改真实物料与原生 CAD | 50 V/119.27 A 重新分解 0.499 W 损耗差，重点查 SR 体二极管、门极供能和储能参数；**0.2 W 不放宽** | 逐项 `P_in,P_out,P_loss_i,dE/dt` 和偏置口径，按同一窗口记录 |
| **D5–D6** | 原生图完整带真实 footprint 后开始 PCB 网络导入及四组 SR/Cout/铜排电气回路布线 | Lr 三匝首件从 **101.26 A** 的稳态故障实证峰值逆推验证 `L(I)`/DOT/气隙与潜在安全边界 | 原生 PCB 可打开、有网、无短路/漏连接、磁件/CT pad 真正对得上 |
| **D7–D10** | 完成 DRC、DFM、Gerber/钻孔/装配/BOM、必要的制造前安全核查 | 故障重新运行收敛对比；SR 峰值与 OC 延时完整审查；维持详细热设计暂缓 | 条件评审；所有 P0 未通过时仍 `NOT_FOR_FAB`、不授权投板 |

**开发加速原则**：不要让有厂家依赖的关键封装阻塞 R/C 的常规选型与图纸检查，也不要让高成本的 8 ms 冷启动故障重跑阻塞 1.2 ms 的独立运行研究。大容量 `.raw` 不提交 Git，提交 `.cir`、`.log`（若成功）、来源版本/哈希、摘要 JSON 和可重算命令。详细热仿真后置，但 PCB 需要保留测温、限流与应急关断设计位置。

## 4 可直接执行的验证命令

```bash
python tools/make_hot_fault_decks.py
python tools/d1_unclosed_risks.py
python -m pytest tools -q
python tools/ci_check.py
python tools/d1_fabrication_gate.py --require-release # 仍应返回非零
```

**当前 D1 实施建议**：与其再追加综合“审核建议”，不如下一次 PR 直接交付两个 hotfault deck 的真实求解与波形、厂家图纸回填、关键 R/C MPN/封装，或嘉立创 GUI ERC 原始证据之一。一个没有新可验证证据的文档不计作 D1 工程完成。
