czy0126/CZY/docs/D1_保护与可制造性复核_2026-11-02_夜间.md

# D1 深度复核与保护专项修补：2026-11-02 夜间

> 审核基线：`main@8b8c139932945022ee666dc334c914769a0c756b`。本次根据**已经实际运行**的 48/50 V 稳态后故障、50 V 133 周期损耗账本及原生 CAD 证据复核，避免重复早期“尚未运行”的历史描述。详细热/冷板设计按项目决定暂缓，但这不允许放宽故障关断、磁件饱和、器件应力或制造基本安全要求。

## 1. 最新证据与工程判定

| 项目 | 本轮实际仓库结果 | 必须保持的工程状态 |
|---|---|---|
| 48 V、120 A 目标稳态后故障 | 原始 RAW 分析表明保存轴 0–320 µs **全部完成**。故障约 175 µs 投入，OC 首次 1V 越限在 215.097 µs，延迟约 **40.10 µs**；Lr 先于跳闸峰值 **97.44 A**；SR 模型正向电流峰 **292.61 A**（209.94 µs，trip 前）。**八只 SR 探针已跑满 320 µs**：A 相四只在 247.070 µs 同时锁存 10.890 V，B 相四只关断；锁存段每只 1.405 A / 1.04e-4 A²s | LOG 预检通过≠完整关断通过：**A 相四只 SR 栅极在终点仍高**；但高电平与故障电流不重叠（故障 I²t 全在 trip 后 5.64 µs 释放窗内），保护边界仍需专项审查 |
| 50 V、120 A 目标稳态后故障 | 投入前 Vss≈5.045 V，OC 延迟约 **39.92 µs**，Lr/单 SR 模型峰约 **101.26 A/303.93 A**；**基座 RAW 只到 296.929 µs**。求解器辅助变体（同电路只加 `cshunt=1e-15`，电路差异 0 条）**跑满 320 µs**（438.604 s、941.9 MB），同 0–220 µs 窗口对基座的峰值差是 **−0.164 %（`I(Lr)`）/ −0.143 %（SR 正向）**、trip 晚 99 ns | 基座仍只能作**前缀**引用；变体是 `CONVERGENCE_DIAGNOSTIC`，引用时必须同时写"cshunt 条件 + 前缀比对"。SOLVER_DIAGNOSTIC 与它一起把前缀峰值精度量化到亚百分点，但**都不能代替完整保护验证**。锁存/末端门极状态见八只探针行 |
| 电感 Lr 1µH / Ae≈130mm² | 在 48/50 V 新故障峰 97.44/101.26 A 时，两匝估计 B≈**0.375/0.390 T**，高于项目 `0.279T=0.9Bsat`；三匝约 **0.250/0.260T** | **两匝不能放行**；三匝仅设计候选，尤其 50 V 只余约 0.019 T 名义裕量，需供应商实测 L(I)、气隙、Bsat/温度 |
| 50 V /119.27 A 稳态损耗 | 22 周期损耗差 0.4986 W；133 周期对齐后 0.4921 W；5/2 ns 门极与储能边界修正后闭合约 0.496/0.488 W | `NOT_CLOSED`，**0.2 W 目标不变**。缺口目前指向端口／模型数值边界；不是已经核验的真实物理效率 |
| 主功率板原生 CAD | 83 个逻辑位号已入工程，61 个器件/封装仍占位，五只磁件物理端子未获确认；缺 GUI ERC 与真正带网络 PCB | 继续 `NOT_FOR_FAB`；不得使用只完成逻辑网表的 EDA 工程或无网摆件直接投板 |

核心数据来自：`design/v3/power_priority/hotfault_48v_120a.json`、`hotfault_50v_120a.json`、两份 `hotfault_*_diag.json`、`energy_ledger_50v_120a_aligned.json`、`hardware/dcx_main/d1_fabrication_gate.json`。

## 2. 本轮真正修补的两处保护逻辑与文件

### 2.1 仿真审核不再绕过真实不安全波形

此前 `hotfault_engineering_gate.inspect()` 只要有人提交 `approved=true`、引用一个预检通过的 JSON 和哈希匹配的说明文档，就有可能在**不核对已存档 RAW 结论**时宣告仿真审查通过。这对当前实际结果尤其危险：

- 48 V **已跑满**但末端一只 SR 仍门极高电平；
- 50 V **未跑满**，且记录末端也有门极高电平。

现已把**实际已存档 RAW 分析**作为不可绕过的低层证据：`reached_tstop == true`、`solver_prefix_only == false`、`fault.sr_gate_latched_at_end == false` 以及被引用的 `raw_bytes` 与实际汇总一致。以上任一不满足，**即使有人勾选签核字段也必须 FAIL**；这不是删除历史结果，而是区分已观察的峰值与完整保护认证。新增回归测试对 48 V、50 V 两种实际问题进行验证。

> “SR gate high”表示仿真**最后一个保存时刻**的栅极仍高，不能仅凭这一个样本证明永久锁存，也不能凭 OC=1 V 宣称已关闭同步整流。应检查故障期间全部器件的栅极、VDS、导通电流和损耗。若实际工作方式是允许 SR 暂时导通，必须先量化安全性并独立做工程更改与复核，不能直接豁免此检查。

### 2.2 新增八只 SR 故障后探针版

- `tools/make_sr_fault_probes.py`：以已有 48/50 V hotfault deck 为母本，**只添加 .save 和 .meas**，不改变 VIN/RL、半桥、OC、故障支路和计算设置；
- `sim/v3/sr_tank_dual_v33_ss_hotfault_48v_120a_srprobe.cir`、`...50v_120a_srprobe.cir`：追加全部八只 SR 的门极最终值（319 µs 保存轴）、230–319 µs 门极峰值和模型串联感测元件电流峰值。原始 50 V deck 到 296.929 µs 终止，**因此这套 319 µs 测点必须在真正完成的新运行后才能有结果**（现已由 §3.6 的 cshunt 变体满足，见下）；
- `tools/test_make_sr_fault_probes.py`：检查两份诊断 deck 可重生、共 24 个 SR 故障后测量、原有电路与故障注入网络保持原样。

**48 V 版本已实际运行并出结论**（500.451 s、1.205 GB、保存轴 320.000 µs 跑满，
`design/v3/power_priority/sr_fault_probe_48v_120a.json`）：八只全部有同窗数据，
**A 相四只在 247.0703 µs 同时锁存到 10.890 V 并保持到终点，B 相四只全部关断**；
锁存段每只只走 **1.405 A / 1.0389e-4 A²s**，而 trip 后到驱动释放（A 相 5.64 µs）
这一段每只的正向 I²t 是 **0.03036 A²s**，正向峰 **285.014 A**（整段 raw 的 292.61 A 出现在
trip 前 209.94 µs）。所以末端高电平是**低电流锁存**，不是"大电流直通"；但模型没有
UCC24624 standby、SOA 与热模型，**这仍不是安全关断证明**。**50 V 版本已在 cshunt 变体上跑完**（456.395 s、1.080 GB、94 变量、469 400 点，
`sim/v3/sr_tank_dual_v33_ss_hotfault_50v_120a_cshunt_srprobe.raw`）：`reached_tstop=true`、
`solver_prefix_only=false`。结果与基座前缀**定性不同**：A 相在 235.184–237.577 µs 高
（10.923 V）、B 相在 232.104–233.217 µs 高（10.913 V），**t=320 µs 时八只全低**；
trip 后正向峰 A 相 300.22 A、B 相 126.73 A，都落在释放窗。基座前缀却从 244.47 µs 起把
B 相保持在高电平到 296.929 µs。1 fF 在 200 kHz 是 795 kΩ，不能解释这个差别 ⇒
**死区里的门极末态是求解器敏感量，不是电路属性**，两种末态都不能当作危害或安全的证据。

**48 V 对照把这条钉死**：同一 48 V 电路（`..._48v_120a_cshunt.cir`，只加 `cshunt=1e-15`，
`circuit_differences()` 0 条）跑满 320 µs（549.607 s），八只探针版 **594.263 s**。
0–220 µs 同窗口上故障应力几乎不动（trip **+1.90 ns**、`I(Lr)` 峰 **+0.0375 %**、
SR 正向峰 **+0.047 %**、SR 反向峰 −0.162 %），但末端锁存**从 A 相四只翻到 B 相四只**
（249.38 µs 起，1.1987 A，每只 7.2768e-5 A²s，A 相全低）。四条运行因此给出四个末态：
48 V 基座 A 高、48 V cshunt B 高、50 V 基座前缀 B 高、50 V cshunt 八只全低。
**"高电平在 A 相"是基座数值轨迹的性质**；能跨变体保留的只有锁存的**低电流特征**
（1.2–1.4 A、每只约 1e-4 A²s），它仍然不构成安全关断证明。
详见 `design/v3/power_priority/48V120A_稳态初始化故障_2026-11-02.md` §3.5–§3.8。

## 3. 最短开发关键路径：电气保护和可制造 CAD 并行，不相互空等

| 相对工作日 | 保护/仿真负责人 | EDA、磁件、采购负责人 | 具体完成标志 |
|---|---|---|---|
| **D1** | **48 V 八 SR probe 已完成**：重现末端 10.890 V，基座落到 **A 相四只**在 247.070 µs 同时锁存、B 相四只关断，锁存段仅 1.405 A，故障 I²t 在释放窗。**48 V cshunt 对照把锁存翻到 B 相四只**（应力只动 0.04 %）⇒ 末态相位是求解器选的，不是电路属性。50 V 已在 cshunt 变体上有完整八只记录（末端八只全低），基座仍塌缩、末态与基座前缀定性不同 | 将已生成的 [24 端磁件模板](../hardware/dcx_main/supplier_magnetic_terminal_reply_template.csv) 与 [61 件选型模板](../hardware/dcx_main/supplier_component_selection_template.csv) 发往供应商/采购 | 真实 RAW/LOG、逐只 SR 列表；厂家回填责任人和回复版本 |
| **D2** | **已完成**：`cshunt=1e-15` 求解器变体跑满 320 µs（`CONVERGENCE_DIAGNOSTIC`），前缀比对 −0.164 %/−0.143 %；八 SR 版建在该变体上（见 §2.2） | 先处理 P0 磁件端子、CT 四逻辑端对 2-pad 错配；Cr、Cout、D_BT、J_IN/OUT 真正 MPN/封装，与仿真并行 | 50 V 有完整仿真时长的 RAW/LOG（基座前缀 + 变体完整），磁件图纸版本和 P0 器件可追溯 |
| **D3** | 给每个 SR 建立 `Vgs(t), Vds(t), Id(t)` 同窗，查门极高电平与故障电流的重叠时长、I²t、驱动释放及 OC 行为；无法证明安全则更新模型/控制策略再仿真 | 嘉立创原生 EDA 保存、退出、重新打开，厂家实物磁件 footprint 真实映射，逐引脚审查与 GUI ERC | 模型保护关断/安全例外的**原始波形证据**，以及实际 GUI ERC 清单 |
| **D4** | 审核 3 匝 Lr 在 101.26 A 模型峰值及公差/高温下的 L(I)、饱和裕量；50 V 账本 0.49 W 缺口单独研究，不与缺陷硬件投板打包消化 | 原生 PCB 真正导入全部网络，优先四组 SR→Cout→电流接口回流/检测 Kelvin，保持 ≤10mm 机械候选 | 可编辑带网 PCB、实际网络和铜层、电感首件参数审表 |
| **D5** | 提交 48/50 V 完整关断安全验证；未通过时维持风险 F03；即使模拟改善也不得批准真实硬件 SOA | 主板 DRC、DFM、Gerber/钻孔/装配和厂家叠层/沉槽确认；完成 D1 文件版次与签核 | 所有 P0 证据无缺漏方可运行制造放行；否则 `NOT_FOR_FAB` 与阻塞清单保持 |

**本轮任务表新增 ELE-10（SR 故障后门极持续导通）**，并将其设为 QA-01 制造放行的一个安全依赖；它可在厂家报价、EDA 引脚/布线工作继续进行的同时完成。详细热/冷板优化继续暂缓，但必须保留测温位置、限流和可受控断电条件。

## 4. 命令及证据要求

```bash
# 只检查新诊断 deck 是从最新故障模型派生，实际不运行仿真
python tools/make_sr_fault_probes.py
python -m pytest tools -q
python tools/d1_unclosed_risks.py
python tools/ci_check.py

# 48 V 八 SR probe 已实际运行（500.451 s / 1.205 GB / 跑满 320 µs）
python tools/sr_fault_probe_report.py --case 48v_120a \
  --json design/v3/power_priority/sr_fault_probe_48v_120a.json
# 50 V：基座仍塌缩；完整轴来自 cshunt 变体（438.604 s / 941.9 MB）
/d/ADI/LTspice/LTspice.exe -b -ascii sim/v3/sr_tank_dual_v33_ss_hotfault_50v_120a_cshunt.cir
python tools/hotfault_convergence.py \
  --base-raw sim/v3/sr_tank_dual_v33_ss_hotfault_50v_120a.raw \
  --base-deck sim/v3/sr_tank_dual_v33_ss_hotfault_50v_120a.cir \
  --base-log sim/v3/sr_tank_dual_v33_ss_hotfault_50v_120a.log \
  --variant-raw sim/v3/sr_tank_dual_v33_ss_hotfault_50v_120a_cshunt.raw \
  --variant-deck sim/v3/sr_tank_dual_v33_ss_hotfault_50v_120a_cshunt.cir \
  --variant-log sim/v3/sr_tank_dual_v33_ss_hotfault_50v_120a_cshunt.log \
  --json design/v3/power_priority/hotfault_50v_120a_cshunt.json
python tools/sr_fault_probe_report.py --case 50v_120a_cshunt \
  --json design/v3/power_priority/sr_fault_probe_50v_120a_cshunt.json
# 48 V 对照：同一 1 fF 扰动，用来判定末态相位是不是求解器选的（549.607 / 594.263 s）
/d/ADI/LTspice/LTspice.exe -b -ascii sim/v3/sr_tank_dual_v33_ss_hotfault_48v_120a_cshunt.cir
python tools/hotfault_convergence.py \
  --base-raw sim/v3/sr_tank_dual_v33_ss_hotfault_48v_120a.raw \
  --base-deck sim/v3/sr_tank_dual_v33_ss_hotfault_48v_120a.cir \
  --base-log sim/v3/sr_tank_dual_v33_ss_hotfault_48v_120a.log \
  --variant-raw sim/v3/sr_tank_dual_v33_ss_hotfault_48v_120a_cshunt.raw \
  --variant-deck sim/v3/sr_tank_dual_v33_ss_hotfault_48v_120a_cshunt.cir \
  --variant-log sim/v3/sr_tank_dual_v33_ss_hotfault_48v_120a_cshunt.log \
  --json design/v3/power_priority/hotfault_48v_120a_cshunt.json
python tools/sr_fault_probe_report.py --case 48v_120a_cshunt \
  --json design/v3/power_priority/sr_fault_probe_48v_120a_cshunt.json
# 制造关口目前理应返回非零
python tools/d1_fabrication_gate.py --require-release
```

**下一轮最有价值的新提交，不是另一份审核，而是：**
1. **48/50 V 八只 SR 故障后同窗波形**：48 V 基座已完成（A 相四只锁存、B 相关断、锁存段
   1.4 A），50 V 的完整 320 µs 只能由 cshunt 变体提供，且 48 V 对照已证明**末态相位由求解器
   选择**（同一 1 fF 把锁存从 A 翻到 B，应力只动 0.04 %）。所以剩下的不是"再跑一个更漂亮的
   末态"，而是**独立于模型的**门极复位/standby 与 SOA 上电验证；
2. **五磁件原厂真实端子/DOT/封装，以及 P0 关键 BOM 的 MPN 和原生 EDA ERC**；
3. **真正带网络的主功率 PCB**。三者均不可由 CI 代码测试代替。

这三条能够并行，主板制造验收仍然必须阻止未闭合保护、实物端子或电气设计缺陷进入正式投板。
