czy0126/CZY/docs/D1_外部阻塞解除与测试交付_2026-11-02.md

# 2026-11-02：外部阻塞解除包与下一步工程交付（磁件、MPN、GUI、仿真）

> **后续版本更新：** 本文件反映先前外部准备阶段，50 V 110/120 A、48 V 120 A 真冷启动及故障现均已有模型运行记录。故障求解未完整完成，且发生于软启动途中；请以 [2026-11-02 最新仿真风险与关键路径](D1_最新仿真风险与关键路径_2026-11-02.md) 为准，不要再沿用下面的“尚未运行”描述。

> 当前分支针对主分支 `e6500bab`。本说明重点是**让外部厂家/Windows EDA/本地 LTspice 接手后可立即开展工程**。未收到厂商原始引脚图，不会凭空制造焊盘编号；没有 LTspice 运行环境，不会将未运行的 deck 说成结果；详细热/冷板设计仍暂缓。

## A. Issue #9 已推进到哪里、还差什么

当前原生项目 `hardware/dcx_main/dcx_main_board.eprj2` **已有 83 个位号/285 焊盘的逻辑连线**；旧版“仍缺五磁件、17 外围”的说法现已过期。实际阻塞是：

| 严重度 | 真实外部阻塞 | 仓库已经准备的交接文件 | 能关闭的验收证据 |
|---|---|---|---|
| **P0** | T1–T4 及 CT 的**实物端子号、DOT 和出线位置**未知；现有 CT 符号 4 逻辑脚、示意封装仅 2 焊盘 | [vendor_terminal_request.json](../hardware/dcx_main/vendor_terminal_request.json)（24 个逻辑端、待填的物理端子及极性） | 厂家带版本号的尺寸与引脚图、首件低压极性/匝比记录；EDA 中创建真实封装并证明项目保存后重开仍存在 |
| **P0** | **61 个占位位号**的真实选型/值或封装未全部定版 | [component_decision_register.json](../hardware/dcx_main/component_decision_register.json)（逐位号、BOM 目标值、原备注、证据路径、负责人签字） | MPN/生产工艺图、厂家原始数据、焊盘与实物尺寸复核；同步 BOM/原生 CAD |
| **P0** | GUI ERC 没有可核验的逐项报告 | 下文 B 的 GUI 操作与证据协议 | 原生 GUI 实际 DRC/ERC 列表、问题整改/豁免、工程版次、截图和非临时文件 hash |
| **P0** | 主板 PCB 尚未有带真实网络的完整布局 | 现有原生原理图及 A5 1:1 无网机械摆件；下文 B 的交接验收 | GUI 导入真实原生网表、SR/输出铜路/原边谐振回路布线、铜层/过孔/DRC/钻孔及制造包 |

### A1. 可直接发给磁件供应商的图纸请求

请按 `vendor_terminal_request.json` 的 **每个 T1–T4、CT** 回传实物照片、二维尺寸图、原边/副边实物编号、同名端标记、CTAP 连接方式、气隙尺寸与位置、初次加工公差及高度。工艺目标可参照 `design/v3/magnetics/绕组工艺卡_2026-11-01.md` 和 `winding_polarity.json`；若工艺卡与供应商可实现结构冲突，须先记录 ECO 而非擅自改脚号。

**关键要求：**
- T1–T4：PRI_A/PRI_B/SEC_A/SEC_B/CTAP 是逻辑节点，不是“1、2、3、4、5”实体焊盘。
- CTAP 属于副边 A 同名端与 B 非同名端的连接；确认后回填每个外部引出端的实际焊盘号。CT 自身需做两个绕组的 DOT 检查。
- **现有 CT 占位封装只有两个焊盘，不可能容纳 CT 的四个外部逻辑引脚**；可作为示意图但禁止 PCB 落版。
- 端子未确认前，`physical_pad=null` 必须保持，不能通过自动勾选使 D1 Gate 放行。

### A2. 61 位号选型登记表使用方法

`component_decision_register.json` 每个占位包含本设计 BOM 的参数要求、现有封装名、是否真实料号及待填写 `verified_mpn/manufacturer_datasheet/eda_footprint_verified/reviewer`。**已知阻塞不是所有 61 个值都没有电气目标**：很多 R/C 的电阻、电容数值是冻结的，只缺*可采购 MPN、封装与来源证据*。

处理顺序：**第一批** T1–T4、CT、Lr、Cr、Cin、Cout、J_IN、J_OUT、D_BT；**第二批** MOS 栅阻/采样和控制器 VDD/REG 去耦及其他 0603/0805。Cr 特别要重新考虑 200 kHz 下实际 RMS/ESR（120 A 仿真已约 11.22 A RMS），不能以示意 100 nF/0603 直接当 620 nF 实物。Cout 实际是多颗并联组，不是一个电容本体；真实纹波与 2.5 V 耐压需确认。输出接点、铜排和焊盘需符合更高电流下压降、过流和机械制造要求。

## B. GUI ERC / 带网络 PCB 的立即操作步骤

1. 在嘉立创 EDA Pro 的**实际工作机**用 `--path` 或客户端直接打开仓库原生 `.eprj2`，首先**保存副本并确认再打开可编辑**。注意：当前磁件为自建逻辑符号，网表出自**保存后临时注入占位封装的内存状态**；它并非磁件真实 footprint 已写回 `.eprj2` 的证据。
2. 用供应商回传端子图在 EDA 项目中创建 T1–T4/CT 的**真实器件和 footprint**，明确焊盘编号、位置、DOT 与绕组连接；在原生编辑器里完成关联，保存后关闭重新打开，确认仍正确。特别检查 CT 原先“4 逻辑脚对 2pad”的错配。
3. 按 `component_decision_register.json` 选定真实器件及封装，核查 Cr、Cout、Cin、Lr/CT、MOS、D_BT、电源偏置输入和所有对地钳位/去耦。
4. **原生 GUI 中运行 ERC**，留存错误/警告**完整列表**，逐项处理或写明工程豁免依据。现有 CLI 的 `warn ×5` 直方图经实测会在清空图页后反而上升，**不能当 ERC 通过证据**。
5. 从**保存并重新打开的项目**导出完整 CAD 网表，检查 83 个参考位号及 285 焊盘所属网络；尤其检查实际物理磁件焊盘，单纯逻辑名字一致不算通过。
6. 在 GUI 中真正更新/转换 PCB，继承网络、footprint、板框和层叠，先布 SR→Cout→输出铜排与回流，再布半桥谐振回路、门极/Kelvin、OC/偏置；检查机械沉槽是否切断铜层。原 A5 KiCad 布置板不带网络，不能冒充此交付。
7. 通过 ERC/DRC，产生原生 PCB、网表 diff、BOM、Gerber/钻孔/装配/坐标、供应商 DFM；按 `tools/d1_fabrication_gate.py --require-release` 和独立人工签核放行。

建议将 GUI 证据保存到 `hardware/dcx_main/evidence/`，记录*原生工程文件 SHA256/EDA 版本/操作系统/日期/图纸版本/检查人员*。不要仅提交“approved=true”空 JSON；哈希证明证据文件存在而不是工程本身正确。

## C. 50 V 及 120 A 故障：四份独立 deck 已全部运行

**全部是仿真测量，不是 PCB/样机/器件实测：**

| 工况 | 原生电路区别 | deck | 运行结果 |
|---|---|---|---|
| 50 V / ~110 A | 稳态母本仅 `VIN=50, RL=17.8m`；探针版增加输入/损耗测量保存项 | `sim/v3/sr_tank_dual_v33_ss_1ms_vin50_i110_cin.cir` | 109.64 A / 213.99 W；端口效率 94.21 %；见 `50V110A_120A_实测_2026-11-02.md` |
| 50 V / ~120 A | 稳态母本仅 `VIN=50, RL=16.3m`；探针版保存 80 变量账本测点 | `sim/v3/sr_tank_dual_v33_ss_1ms_vin50_i120_cin.cir` | 119.27 A / 231.87 W；损耗残差超 0.2 W，**效率不可引用** |
| 48 V / 120 A 目标真冷启动 | 从**无 `.ic`、`uic`、Cout 初始 0V** 的 `cold_phys` 母本仅将 `RL=20m` 改为 `15.4m` | `sim/v3/sr_tank_dual_v33_cold_vin48_i120_target.cir` | 8 ms 跑完；末端 121.67 A / 228.00 W；首个采样点 0 V；见 `48V120A_冷启动与故障_2026-11-02.md` |
| 48 V / 120 A 目标过载故障 | 从真正 `cold_oc_phys` 母本仅改为 `RL=15.4m`；仍包含 5.5–5.6ms 的过载开关与原 Level-1 OC | `sim/v3/sr_tank_dual_v33_cold_oc_vin48_i120_target.cir` | 8.70×；trip 延迟 41.81 µs；**7.5714 ms 求解器塌缩，只有前缀** |

`tools/make_high_output_decks.py` 与 `tools/make_120a_transients.py` 可以再生成/检查全部输入。**“120 A”仅是稳态负载目标；冷启动时电流不是恒定 120 A，也不能由 100 A 的故障峰值外推 120 A。** 120 A 故障已记录原边关断前峰值 84.83 A、`V(oc)` 最大 1.207 V、trip 延迟 41.81 µs、SR 峰值 255.22 A；但仿真在 7.5714 ms 塌缩，没有 8 ms 完整窗口。模型里 SR 及偏置仍是行为模型：即使仿真通过，不能自动批准器件 SOA 或实际动态保护。

**热初始化（2 ms 稳态后投入故障）的两组也已实际运行**（`tools/make_hot_fault_decks.py`）：
48 V 通过严格日志校验（trip 40.10 µs、`I(Lr)` 峰 97.443 A、SR 正向峰 292.61 A，跑满 320 µs）；
50 V 在 **296.929 µs** 求解器塌缩，只有前缀（trip 39.92 µs、`I(Lr)` 峰 101.263 A、SR 正向峰 303.93 A），
**引用必须写"前缀"**。前缀内的峰值已用 `SOLVER_DIAGNOSTIC` 变体量化不确定度：同一电路只把
`trtol` 7→1、`abstol` 1e-12→1e-13、保存轴停在 220 µs，重解得 `I(Lr)` 峰 **−0.16 %**、SR 正向峰
**+0.002 %**、trip 早 81 ns（[hotfault_50v_120a_diag.json](../design/v3/power_priority/hotfault_50v_120a_diag.json)）。
48 V 对照组（基座跑满 320 µs 且通过严格日志校验）在同窗口移动 **−0.42 %（`I(Lr)`）/ −0.41 %（SR 正向）**、
trip 早 185 ns（[hotfault_48v_120a_diag.json](../design/v3/power_priority/hotfault_48v_120a_diag.json)）——
两组都因收紧容差而**变小**，方向保守，但量级说明峰值精度是**亚百分点**，不是 0.1 %。
**塌缩本身已有求解器辅助解**：`cshunt=1e-15` 变体（同电路、`circuit_differences()` 0 条）
跑满 320 µs（438.604 s / 941.9 MB），同 0–220 µs 窗口对基座 trip 晚 99.07 ns、`I(Lr)` 峰
−0.164 %、SR 正向峰 −0.143 %（[hotfault_50v_120a_cshunt.json](../design/v3/power_priority/hotfault_50v_120a_cshunt.json)）。它是 `CONVERGENCE_DIAGNOSTIC`，
不是基座重跑：引用完整轴时必须同时写 cshunt 条件与前缀比对；诊断组停在 220 µs 的那条
结论仍然成立。

在 Windows 装有 LTspice 的机器上：

```powershell
pwsh -File tools/run_dcx_pending_cases.ps1
pwsh -File tools/run_dcx_pending_cases.ps1 -LTspice "C:\Program Files\ADI\LTspice\LTspice.exe" -Execute
```

第一行是只读预检，第二行才实际运行。脚本会拒绝覆盖已有同名 `.raw/.log`，以免混用历史数据；会检查运行退出码、日志和波形文件存在。**运行后仍须验证完整求解、实际波形与负载条件并重新计算端口效率**。50 V 的输入电流电源脚位、电压裕度以及各磁件电压/磁通要单独核算；不能只在稳态 48 V 结论上加 2 V。

## D. Issue #6：缩小残差解释范围，但尚未定位所有损耗

原 `sr_loss_audit.json` 已证明：对齐 133 个周期，5/2/1/0.5 ns 的发布账本周期平均闭合残差约 `+0.326/+0.314/+0.309/+0.523 W`。对门极边界计入实测 **0.2175 W** 的 `Rg/Rgs/CPIN` 归属后，残差变为 **+0.108/+0.097/+0.091/+0.304 W**：**只有三档进 0.2 W，0.5 ns 档在外**，四档散布 0.213 W。这**不等于**完整账本已闭合：旧 `energy_ledger_100a.json` 没有相同的损耗边界定义，SR 体二极管正向耗散跨**四档**变化 **2.334 W**（通道项仅 0.052 W），16 周期短窗纠正后残差步长变化约 **0.380 W**。四档已被实测证伪"再减一步就能看到平台"：第二段反向、第三段幅度不随步长收缩，所以收敛不能靠继续减步长得到。

已新增 [issue6_next_experiment.json](../design/v3/stage_f/issue6_next_experiment.json)：E6-1 对 SR 二极管实际导通与功率积分重新分解、E6-2 对 Rg/Rgs/CPIN 与理想 Bdrive 源边界逐项去重、E6-3 同 133 周期 5/2/1/0.5 ns 求收敛（四档均已运行，结论是**没有平台**）、E6-4 原本 SR pair1×4 假设的八只实际器件逐一取值。**0.2 W 目标不变。** 尤其不能因为后处理把 +0.091 W 读成“已定位并修掉 0.09 W 物理耗散”。

E6-3 留下的下一实验是"先把工作点钉住再比"，现已执行：电阻负载换成斜坡恒流阱
（`Iload out sgnd PWL(0 0 500u 0 750u 100)`）后，两档都抽同样的 100 A。5 ns 档复现电阻档到
−0.56 mV / −0.34 ns / −0.29 %（替身忠实），但 0.5 ns 档仍高 **15.13 mV**、单相二极管损耗低
**0.192 W**（×8 = 1.54 W），相对同一对步长的电阻差保留 **98.9 %**。固定电流斜率 101.7 W/V
对电阻四档 118.3 W/V。⇒ 差别不是负载电流、不是求积规则、也不是漏了一个耗散元件；
两种电压式钉法（理想电压源、调节式电流阱）都因 SR **负载触发启动**而失效
（空载只到 1.794 V，体二极管没有导通机会）。要钉住 `V(out)` 只剩闭环，属于新 deck。
记录：[sr_step_operating_point_csink.json](../design/v3/stage_f/sr_step_operating_point_csink.json)
与 [SR步长_操作点_2026-11-02.md](../design/v3/stage_f/SR步长_操作点_2026-11-02.md) §3.3。

## E. 同时修正新的高输出账本诊断错误

本轮另发现并修复 `tools/energy_ledger_100a.py` 在候选 110/120 A 工况中对 `window_terms()`、逐周期 `residual_noise()`、`averaged_residual_noise()` 错用基准 100 A 的 **RL=18.9mΩ**，虽然主窗口本身采用正确 16.9mΩ/15.4mΩ。**修正已用本机保留的 `.raw` 重算并刷新两份 JSON**（`diagnostic_integrity.status = RECOMPUTED_WITH_REQUESTED_VIN_RL`），旧 +22 W/+42 W “缺口”作废。重算后：110 A 损耗残差 **0.1738 W**（0.2 W 内），但闭合残差 **0.5586 W**（周期平均 0.5909 W）仍在外；120 A 损耗残差 **0.4834 W**，闭合残差 **0.6673 W**（周期平均 0.6681 W）。两份都仍是 `NOT_CLOSED`，120 A 的损耗残差自己超目标，因此**不引用其效率**。

## F. 接下来的短期交付安排

| 优先次序 | 可立即做的行动 | 文件/验收 Gate |
|---|---|---|
| **1** | 将厂家 pinout/RFQ 发给定制磁件供应商；同时准备真实器件报价/选型，并优先解决 CT 4 引脚与 2-pad 占位封装冲突 | `vendor_terminal_request.json` 实物引脚图回填，`component_decision_register.json` 61 位号审核 |
| **2（并行）** | 有 Windows GUI 的开发机先完成原生 ERC 整改；用真实封装把磁件 footprint **持久写入**并重开验证 | 原生项目及完整 ERC 明细和 83 位号/285 焊盘双向网表 |
| **3（并行）** | ~~本机一次性运行 50 V 110/120 A、48 V 120 A 真冷启动/过载模型~~ **已完成 2026-11-02** | 四份独立 `.raw/.log` 与报告；过载故障在 7.5714 ms 塌缩，已按前缀记录 |
| **4（并行）** | 从原始 `.raw` 重算此前候选 110/120 A 的错误短窗统计，推进 Issue #6 的二极管/驱动边界专项 | JSON 去隔离状态、0.2 W 保持、波形与模型版本一致 |
| **5** | 原生主板同步 PCB，优先端子与大电流网络，出 ERC/DRC/厂家工艺审查 | 可编辑带网 PCB + Gerber/BOM/钻孔/装配/DFM；详细热设计后续 |

**本轮直接补齐的是工况和供应商交接条件，不是捏造厂商报价、原生 GUI ERC、首件或仿真波形。**
