czy0126/CZY/docs/D1_10工作日工程冲刺_2026-11-02.md

# D1 加速推进：2026-11-02 现状审核与 10 工作日执行计划

> **最新进度覆盖本文件原始工期：** [已完成仿真与新增稳态故障缺口](D1_最新仿真风险与关键路径_2026-11-02.md)；任务表已扩至 21 项，特别新增稳态后故障、50 V/120 A 损耗差及三匝 Lr 首件验收。此文件中的原 D1–D10 只是初始计划，不应覆盖最新实证。

> **2026-11-02 增量执行包：** [外部阻塞解除与测试交付](D1_外部阻塞解除与测试交付_2026-11-02.md)。原生 CAD 已有 83 位号；外部厂商 DOT、61 占位 MPN、GUI ERC 与 PCB 仍为阻塞。50V/110+120A 与 48V/120A 真冷启动已运行；48V/120A 过载故障运行到 7.5714 ms 后求解器塌缩，只有前缀。110/120A 短窗口 SEM 已用请求 VIN/RL 重算（`RECOMPUTED_WITH_REQUESTED_VIN_RL`）。

> 基线：`main@d203977d57d751d538a673fb6ab480796f3be5a3`。本文件只记录本轮**差异、代码修复和可执行工程顺序**；早期报告留在 Git 历史。  
> 当前目标：**尽快形成可审查、带真实网络的 D1 主功率板原生设计及制造候选**。允许在满足器件/保护/绝缘约束时牺牲适当效率探索更高输出；**详细热设计和冷板优化暂缓**，因此尚不可宣告 100 A/120 A 连续额定。  
> 计划时间窗：2026-11-02—11-13，D1–D10 为相对工作日编号，**是并行研发目标而非已确定供应商交期或投板承诺**。如无法取得磁件端子或原厂封装，以阻塞记录替代猜测。

## 一、状态差异（相对上次 PR #16）

| 项目 | 已验证最新状态 | 决策 |
|---|---|---|
| 原生主板 | `dcx_main_board.eprj2` 已存在，原生导出 **83 个位号**（金网表 66 + 真实外围 17）；193 逻辑引脚展开为 **245 焊盘**逐焊盘比对，另 34 个外围焊盘单独计数，`not_placed=[]` | **仍未完成 D1**：BOM 上板位号 0 缺失，但五只磁件物理端子、61 个占位件、ERC、PCB 仍阻塞 |
| CAD 缺失 | T1–T4、CT 符号已画入并逐逻辑焊盘核对，但引脚号是逻辑端子名、物理端子未验证；R7–R10、C13、C101–C112 已画入但值/MPN 仍是占位；合计 61 个占位位号 | 剩余是**物料冻结与厂商端子**，不是再画一遍图；`subset_ok` 不能越级成制造通过 |
| 模型验证 | 已有 48 V / 16.9 mΩ `111.16 A / 208.835 W`（端口效率 `94.53%`）与 48 V / 15.4 mΩ `121.67 A / 227.978 W`（端口效率 `94.227%`），两个账本都 `NOT_CLOSED` | 验证行为模型在高输出工况可跑，**不是硬件功率/效率认证** |
| 数值收敛 | 100 A 同窗 5/2/1 ns 周期平均闭合残差约 `0.326 / 0.314 / 0.309 W`；SR 通道/体二极管合计跨步长振荡 | 继续 Issue #6 的数值专案，但**不阻挡安全前提下的原生绘图** |
| 铜路 | 四支路 25 A/组时用 `ΣI_k²R_k`，2 oz 等流示例整机路径约 0.281 mΩ/2.806 W @100 A；接点与均流仍是假设 | 允许作为探索方案，下一步必须带真实网络、铜层、过孔和接点参数 |
| CI | 上次 main 393 passed、5 skipped，清单一致 | 本次变更加入新测试，合并前必须重新跑绿 |

**重要产品决策未冻结**：固定 24:1 的 48 V 模型在负载下输出约 1.879 V；如果用户坚持 2.00 V±2% 作为*额定负载端*硬约束，就不能只靠加流/容忍损耗解决。需要明确接受“近 2 V 非稳压 DCX 的工作包络”，或修改变比/输入电压/加调压级。**本冲刺不擅自改变变比**。

## 二、本轮直接修复的技术缺陷（对应代码）

### 修复 1：新添真实外围被误报成“意外元件”

旧 `tools/check_main_board_netlist.py` 把任何不在 SPICE 黄金网表的参考位号列入 `unexpected_refs`。当 EDA 工程师**正确补入** R7 等真实外围后，检查反而失败，容易诱导开发者删除必要器件或跳过网表校验。

现改为：
- `SPICE 66 位号` → 仍严格检查金网表展开的 **245 焊盘**网名与裸露焊盘等，未知 `GHOST` 一律失败；
- `BOM 新增 17 位号` → 不在黄金网表、但**必须在 `PERIPHERALS` 与当次 BOM 扫描里**；其 **34 个焊盘**按 `pin_connections.csv` 逐脚核对并单独计数，不混进 245；
- 外围缺席、错网、或出现未知额外位号都直接失败（`test_a_missing_peripheral_fails`、`test_a_miswired_peripheral_fails`、`test_an_unknown_hardware_extra_still_fails_even_with_bom_only_refs`）。

注意：**加入 BOM 不是自动信任其连接**；真实引脚与默认电平必须由元器件手册和实际 EDA 工程核查。当前 17 只外围已全部进入原生导出并逐焊盘通过，但值/MPN 仍是占位件。

### 修复 2：D1 放行错误地依赖旧汇总 JSON

旧 `tools/d1_fabrication_gate.py` 直接加载 `bom_coverage.json`，若 BOM/原生导出变了而开发者未刷新报告，就可能用过期缺漏数判断“无新增器件”。本轮改为：
- 每次直接从 `bom_draft.csv`、`board_netlist.csv` **重新计算 BOM 覆盖**，再从 **真实保存的原生导出 `gen/netlist_export_raw.json`** 按位号核对；
- 将 `all_required_bom_refs_missing_from_native_export` 明列出来：**当时基线为 22 位号**（五磁件＋17 外围），现已全部进入原生导出、该清单为空；PS1 外供接口单独保留为工程接口，不虚构上板；
- `bom_coverage` 与原生导出的缺失位号集合逐项交叉校验，两处不一致直接 `ValueError`，防止报告与实时导出分叉；
- 手工批准文件只有在 repo 内的**真实报告文件存在**且对应 SHA256 匹配时才可能算作证据完整。路径不可越出仓库；即便文件和哈希齐全，仍必须人工核对版次、报告有效性和审核人，**哈希不等于技术签核**；
- 保留 `--require-release` 的**预期失败语义**。本阶段没有真实 ERC/带网络 PCB/制造包，不得通过写假 JSON 解除阻塞。

新增测试锁住 BOM 专用元件、未知器件与报告哈希篡改等反例。

## 三、十个工作日主线：先完成 CAD 输入，再形成真正 PCB

唯一执行板：[`hardware/dcx_main/d1_delivery_tasks.csv`](../hardware/dcx_main/d1_delivery_tasks.csv)（18 个任务，ID、角色、依赖、目标工作日、交付路径和验收条件；`test_d1_delivery_tasks.py` 检查依赖无环）。

### D1–D2：把真实电路边界和器件来源冻结为绘图输入

**主线 A / 原理图**：对照 `bom_coverage.json` 在 EDA 中补 R7–R10、C13、C101–C112；必须先核对控制器厂商引脚、输入默认状态、偏置隔离，六只 IC 的 12 个去耦电容按 1 µF/100 nF 分配并归属到每一个 VCC-GND 对，**不要将 C101–C112 误画成 12 个相同电容**。

**主线 B / 磁件与制造输入**：根据 `magnetics_symbol_contract.json` 与绕组极性工艺卡准备 T1–T4（5 逻辑脚）、CT（4 逻辑脚）真正的 EasyEDA 符号；定下实物焊盘与磁件引出方式。厂商尚未确认的端子号必须标 `UNVERIFIED`，不能臆造编号。

**主线 C / 电气验证**：审阅已实跑 111.16 A 的 SR 正/反向换流、Cr/Cout RMS、OC 波形和故障缺口；准备 120 A 的仿真运行输入与测量表。此工作**不等待**原理图补完。

**阶段成果**：17 个外围位号及其电路节点有厂商依据；磁件符号端子要求可以交给封装/供应商；关键器件的真实选型审表开始流转。

### D3–D4：关闭逻辑和极性，避免直接跳 PCB

- T1–T4 物理同名端/CTAP 与 SPICE DOT 互查。副边中心抽头是 A 同名端和 B 非同名端的连接，不能把两个同名端直接相连。
- 将已批准的 17 外围、5 磁件真正放入 `.eprj2`，导出编辑器原生网表；对**旧 SPICE 部分**跑严格校验，对**新增真实 BOM 部分**逐元件测网/焊盘，不让 `subset_ok` 越级成为 `COMPLETE_PASS`。
- 参数冻结：Cr、Cin、Cout、Lr/CT、D_BT、SR MOS/主开关 footprint 和全部门电阻；不允许 620 nF Cr 由 100 nF/0603 假料直接进入制造 BOM。
- ~~并行推进 48 V/120 A 候选仿真~~ **已完成**：探针 deck 实测 121.67 A / 227.978 W，
  端口效率 94.227 %、含储能闭合残差 +0.667 W（`NOT_CLOSED`）。逐项应力与未测项见
  `design/v3/power_priority/48V120A_实测_2026-11-02.md`；这是仿真候选，不是额定。

**Gate G1**：原生 CAD 中 BOM 所需上板位号齐全，真实磁件脚号与独立电气检查完成，没有未经解释的高风险占位参数。**失败则 PCB 可以研究但不能作为正式布局输入。**

### D5–D7：原生 ERC + 带真实网络的 PCB

- 原生 GUI 输出可复核的 ERC 逐条明细；明确安全豁免的理由，不接受 CLI `warn ×5` 直方图冒充。
- 从完整原理图同步**真实 PCB**，不是把无网络 A5 机械摆件当主板。
- 优先布四组 SR→Cout→铜排/负载正负回流及 Kelvin 检测，再布输入半桥、谐振环和控制/保护。用实际铜厚/过孔/接点和非理想支路电流估计电压降；沉槽不能切断所需铜层。
- PCB 局部封装、功率回路、电气间隙、驱动/检测地、关键接口要完成核对；冷板优化与 CFD 仍暂缓。

**Gate G2**：原生 ERC 完成，主 PCB 真正含网络、封装、层叠和电气回流；无未经解释的 DRC/器件额定阻塞。

### D8–D10：制造候选与风险复盘

- 根据真实 PCB 出制造包（Gerber、钻孔、坐标、装配、BOM、叠层/沉槽）。厂家确认加工可行，尤其五磁件沉槽、最薄介质和铜层存续。
- 磁件首件与控制验证板并行，形成后续实物测试输入（不要求供应商必须在 D10 前寄回首件）。
- 按 `python tools/d1_fabrication_gate.py --require-release` 和人工签核清单逐项关闭可制造性项目。
- 若任何 P0 不满足，**只发布 D1-WIP/NOT_FOR_FAB 和缺口及原因，不能直接放行**；可继续下一轮布线、采购询价与受限仿真，不反复写泛泛的综合审核。

## 四、并行角色与最短关键路径

| 并行线 | 建议责任角色 | 先行任务 | 阻塞关系 |
|---|---|---|---|
| A 原生电路 | EDA + 电路 | CAD-01 → CAD-02、MAG-01、BOM-01 → CAD-03 | **主板关键路径**，真实网表与 ERC 未过不能进入正式 PCB |
| B 主板版图 | PCB + 电气 | 提前讨论 SR/Cout/铜排、电流路径；G1 后正式 PCB-01 | 等完整 A1 输入，但可提前准备库、板框、禁布规则 |
| C 磁件/供应商 | 磁件 + 采购 | MAG-01 → MFG-01 | 可与 A 并行，若实物端子/磁芯截面影响封装要第一时间 ECO |
| D 模型/保护 | 仿真 + 控制 | ELE-01 → ELE-02/03；CTL-01 | 不阻塞绘图，**保护/应力若失败则阻塞上电与实际额定** |

建议在每天一次简短同步中只报告：**昨天新增的可编辑工程文件、实测/仿真证据、仍阻挡下游的 P0、下一天需谁确认**。如果两天没有可交付 CAD/料号/实测文件，就调整任务而不是再生成说明文档。

## 五、最需要补齐的工程文件（不是再建空目录）

| 文件/证据 | 当前 | 预计由什么工作形成 |
|---|---|---|
| `hardware/dcx_main/dcx_main_board.eprj2` | 有，**83 位号**/WIP | BOM-01 物料冻结 + MAG-01 物理端子 |
| `hardware/dcx_main/gen/netlist_export_raw.json` | 有，**0 位号缺失**、245+34 焊盘核对通过 | CAD-03 待 ERC 与 GUI 复核 |
| `hardware/dcx_main/pin_footprint_review.csv` | 有，**61 个位号占位**（39 原有 + 22 新增外围/磁件） | BOM-01 与 EDA 实物器件审表 |
| `hardware/dcx_main/native_erc_approved.json` + 实际 ERC 原文 | **缺** | CAD-03 原生 GUI 检查 |
| `hardware/dcx_main/pcb_to_schematic_verified.json` + 原生 PCB | **缺** | PCB-01 逐焊盘审查 |
| `hardware/dcx_main/fabrication_approval.json` + Gerber/钻孔等 | **缺** | MFG-02/QA-01 |
| 48 V/120 A 真实 LTspice 工作点与故障/应力 | **工作点已有**（121.67 A / 227.978 W、Cr 44.44 V、SR 46.81 A、Cout 55.58 A RMS）；**真冷启动已有**（121.67 A / 228.00 W，首个采样 0 V）；**故障只有 5.55–7.5714 ms 前缀**（8.70×、trip 延迟 41.81 µs、峰值 84.83 A） | ELE-02/ELE-07 已运行；故障在 7.5714 ms 塌缩，不得把前缀报成 8 ms，也不得由 100 A 数据外推 |
| 磁件 DOT/L(I)/漏感/高度与 SR 换流实物波形 | **未有首件实证** | MFG-01、CTL-01，D2 之前需要 |

**热设计边界**：可暂不完成详细热阻模型、CFD 和冷板，但必须保留电气保护、温度传感焊位/测点和安全的受限验证条件；最终“连续 100/110/120 A”与“≤10 mm 含冷板模块”都应等热、机械、实物证据具备再发布。

## 六、复现与放行规则

```bash
python -m pytest tools -q
python tools/ci_check.py
python tools/d1_bom_coverage.py
python tools/check_main_board_netlist.py
python tools/d1_fabrication_gate.py
# 下面命令当前必须返回非零，并明确列出不具备的制造证据
python tools/d1_fabrication_gate.py --require-release
```

**本次最重要的调整不是把新外围“检查豁免”，而是把它们从错误的 SPICE 子集失败改成可追踪的真实制造核对任务。** 下一次 PR 应提交原生 EDA 真正补齐的位号/磁件或正式带网 PCB，而不是再次叠加审核建议。
