czy0126/CZY/docs/D1_电气优先_增输出与设计整改_2026-11-01.md

# D1 电气优先整改及高输出候选（2026-11-01）

> 本阶段执行决定：**详细热设计暂缓**；优先把原生主功率板、完整磁件连接、真实元件规格和电气应力模型做成可验证交付。允许在合理范围内增大损耗，以提高可交付输出电流与功率，但**不允许超器件/磁件安全额定，不批准未经验证的连续额定**。

## 已直接修改的工程内容

1. **原生 A1 工程已移入当前主线候选分支**：完整保留 PR #10 的二进制嘉立创 EDA Pro `.eprj2`、脚位库快照、221 个黄金焊盘核对、示意图、生成器和 2 个测试模块；没有以旧 `CLAUDE.md` 覆盖主分支 A5/A6 资料。这个文件**是可编辑的在制原理图，不是已完成 PCB**。
2. **纠正子集检查口径**：`tools/check_main_board_netlist.py` 增加 `subset_ok`、`readiness=PARTIAL_PASS`、`manufacturing_ready=false`、`manufacturing_blockers`，提供 `--require-complete` 强制闸门。即使有人仅把 T1 放到原生工程，也不会被误判为磁件引脚/DOT 已验证。
3. **为缺失磁件给出逐网逻辑契约**：`hardware/dcx_main/magnetics_symbol_contract.json` 从黄金网表和 DOT 验收数据列出 T1–T4 的每只五个逻辑端子以及 CT 的四个逻辑端子；保留 **physical_pad=null、native_symbol_present=false**，防止制造前凭空假设厂商焊盘/端子号。请继续在原生 EDA 中制作符号，必须验证极性、实物端子后重导网表。
4. **修复 100 A 输出铜损严重高估**：旧版 `output_path_budget.py` 将最差一组路径 R=1.188 mΩ 直接乘以整机 100²，错误得到全机约 13.33 W。新计算使用四组各 25 A，`P_plane=ΣI_k²R_k`、`R_eq=ΣR_k/16`，得平面约 **0.135 mΩ / 1.353 W**；加铜排与接点占位，总路径 **0.281 mΩ / 2.806 W**（2 oz、100 °C 电阻率的等流假设）。测量前不能把这些值当真实电阻。
5. **旧的 0.15 mΩ 并非物理红线**：保留作为历史设计预算，另给 **0.30 mΩ 探索预算**；电气损耗容忍不等于允许真实大电流不均衡、MOS SOA 失效或过热。输出铜排横向覆盖四组 SR 优先于先更换铜厚，可改善最差局部路径的电阻差异；真实层叠/过孔/接点仍需 PCB 求解与首件四线测量。
6. **实际可运行的高输出仿真 deck**：`tools/make_high_output_decks.py` 输出四套 VIN=48/50 V、RL=16.9/15.4/17.8/16.3 mΩ 组合，严格以现有物理 100 A SPICE deck 为母本、仅改 VIN 和 RL。其中 **48 V / 110 A 与 48 V / 120 A 两套已经跑完**：110 A 负载端 1.8786 V / **111.16 A / 208.83 W**（243 s、248 757 点，`48V110A_实测_2026-11-01.md`）；120 A 负载端 1.8737 V / **121.67 A / 227.98 W**（探针 deck 228.8 s、505 MB、258 235 点，`48V120A_实测_2026-11-02.md`）。剩余两套（50 V/110 A、50 V/120 A）**仍未运行**，载流只是目标。两套已跑的都是**仿真候选、不是额定**：无热、无故障工况、无外部输出路径；输入功率与端口效率已由只差 `.save` 块的探针 deck 实测（110 A 端口效率 **94.53 %**、120 A **94.227 %**），但两个账本都未闭合、不含磁芯损耗。
7. **候选电气灵敏度脚本**：`tools/high_output_sweep.py` 生成 `design/v3/power_priority/scenarios.json`，研究 48/50 V × 100/110/120 A × 0.15/0.30/0.45 mΩ。只对 V3 100 A 工作点做增量 R 和理想 24:1 比例外推，状态是 `LOCAL_LINEAR_SENSITIVITY_NOT_SIMULATED`，不得报为 120 A 实测。
8. **机械基础错误修正**：沉槽剩余 **1.1 mm FR-4 只承担结构与绝缘**；SR 回流必须沿连续铜层/过孔/铜排流动。已同步更正机械生成器、报告及 A6 文档；完整冷板/散热结构暂缓，但沉槽切断铜层、超器件电流等基础安全风险不延期。

## 高输出候选（线性化计算，不是新的 LTspice 测量）

| Vin | 假定负载电流 | 外部路径总电阻 | 估计负载端电压 | 估计负载功率 | 路径 I²R |
|---|---:|---:|---:|---:|---:|
| 48 V | 100 A | 0.15 mΩ | 1.8715 V | 187.1 W | 1.50 W |
| 48 V | 110 A | 0.15 mΩ | 1.8586 V | **204.5 W** | 1.82 W |
| 48 V | 120 A | 0.15 mΩ | 1.8458 V | **221.5 W** | 2.16 W |
| 50 V | 110 A | 0.15 mΩ | 1.9420 V | **213.6 W** | 1.82 W |

电流提高的同时，单纯 I²R 项相对基点至少按电流平方上升：120 A 对 ~100 A 为约 1.44 倍，**SR 换流、Cr/Cout 纹波、CT 门槛与 Lr 故障峰值不一定按这个规律**。特别注意 48 V/120 A 的功率可能增加，但输出电压更低；如果“2.00 V±2%”仍是硬约束，应先修改变比或引入调压，不能只靠增流满足。

## 下一次工程提交必须实际完成的内容（优先级）

**P0-A1 — 在原生编辑器中完成主板原理图。** 目前本批改动把 PR #10 的可编辑文件带回开发主线，但尚缺真正的 T1–T4 + CT 符号和厂商**物理端子**；需将本批 JSON 合同落实到原生 EDA，填入真实焊盘与脚号、补 39 个占位参数/封装。重新导出来自编辑器的网表，最终要求 **not_placed=[]**，关键 MPN/值与 BOM 对照通过，原生 ERC 无未解释错误。随后进入**带真实网络**的 PCB 布局，而非把无网 A5 摆件当主板。

**P0-电气路径 — 以各组 25–30 A 设计 SR→Cout→铜排回路。** 确认四组分布铜阻/均流、Kelvin 检测、回流及接点；不要把四个支路 R 简单串成一条 100 A 路。先验证输出铜排覆盖四组和可布线条件，再根据供应商叠层做铜皮/过孔预算。

**P0-高输出验证 — 48 V/110 A 与 48 V/120 A 都已跑；120 A 见 `design/v3/power_priority/48V120A_实测_2026-11-02.md`（121.67 A / 227.98 W / 端口效率 94.227 % / `NOT_CLOSED` +0.667 W），110 A 见 `48V110A_实测_2026-11-01.md`。** 已导出的量：逐组 Iout/Irms、SR 正向/反向峰值与单只损耗、VDS/VGS、Cr 峰值与 RMS、Cout 重建纹波、原边 Ipk、OC 引脚电压、Lr 稳态磁通，以及**输入功率与端口效率**——`_phys` 不存 `I(Rin)`/`I(Cin)`，所以另跑了一份只差 `.save` 块的探针 deck：`Pin` **220.914 W**、`Pout` **208.835 W**、端口效率 **94.53 %**（`design/v3/power_priority/energy_ledger_48v_110a.json`）。**但这个效率只能引到 94.5 %**：账本 `closure_status` 是 `NOT_CLOSED`（含储能 +0.559 W），窗口只把 0.2 W 分辨到 ±0.31 W，且不含磁芯损耗、输出铜排与结温。**仍未导出**：SR 温度、任何故障工况、外部输出路径。以**整机负载端功率**计输出，而非理想节点。110 A 在本模型内未触及任何器件判据线；真正的缺口是热与均流，不是电流。若要发布 110 A，须先补热数据与 120 A 决定；不要因为一次点吻合就外推额定。

**P1-热设计暂缓**：不要求本轮完成 CFD/冷板/稳态热模型，不以既有 10 mm 高度估算强迫结构定版；但新增 110/120 A 只允许作为**仿真候选或严格限能短时实验**，连续电流额定与高功率密度发布必须等待器件温度和散热验证。电路设计仍需要保留测温点、限流和急停。

## 复核执行命令

```bash
python -m pytest tools -q
python tools/check_main_board_netlist.py --require-complete
python tools/magnetics_cad_contract.py
python tools/make_high_output_decks.py
python tools/high_output_sweep.py --json design/v3/power_priority/scenarios.json
python tools/output_path_budget.py --json design/v3/pcb/output_path_budget.json
# 110 A 候选（实跑 111.16 A）的输入功率：探针 deck 与候选 deck 只差 .save 块
/d/ADI/LTspice/LTspice.exe -b -ascii sim/v3/sr_tank_dual_v33_ss_1ms_vin48_i110_cin.cir
python tools/energy_ledger_100a.py \
    --raw sim/v3/sr_tank_dual_v33_ss_1ms_vin48_i110_cin.raw --periods 22 \
    --vin 48 --rl 0.0169 --no-step-check \
    --json design/v3/power_priority/energy_ledger_48v_110a.json
```

其中 `--require-complete` 在现阶段**应该失败**，因为有真实缺口；这正是 Gate 的作用，不要靠删除测试让它变绿。四套 deck 里已跑的一套发布**工作点与端口效率**，但**不发布额定**（未闭合、无热、无故障、无输出路径）；其余三套必须等真实运行并导出日志后才谈性能结论。110 A 的数值由 `tools/test_operating_point_110a.py` 与 `tools/test_energy_ledger_48v_110a.py` 锁住。

**下一个 PR 的成功标准：原生五磁件齐全 + 真实元件值/符号/封装映射 + CAD 网表/有效 ERC，随后开始带网主板 PCB。**
