czy0126/CZY/docs/V3_现阶段技术审核与D1交付路线_2026-11-01.md

# V3 项目现阶段技术审核与 D1 交付路线（2026-11-01）

> 审核基准：`main@f83e3bfc5e74fc2aac1abe9ef34962dc6bf4da58`，以及尚未合并的 [PR #10](https://github.com/czy0126/CZY/pull/10)（头提交 `4a6e6d10ac00f9b15635ce0ea51731822bc5d30c`）。  
> 定位：**变更审查与下一阶段任务排序**，不是另一份重复的总体综述。此前 [工程交付加速执行计划](工程交付加速执行计划_2026-11-01.md) 的 D1/D2/D3 定义保持有效。  
> 证据等级：`REPO_VERIFIED`=已见到仓库文件／CI 日志；`SIM_MEASURED`=现有仿真数据；`ENG_ESTIMATE`=工程计算／暂定参数；`HW_MEASURED`=实物量测。当前没有足以宣告 D2/D3 的实物记录。

## 0. 结论与建议

**结论：从“只有 SPICE/JSON/文档”进入了“原生 CAD 及真实机械摆件”，这是实质进展；但 D1（可制造候选）未完成，主板不应投产。**

本轮最有价值的新交付：
- **A1 原理图有真实成果**：PR #10 提交可编辑嘉立创 EDA Pro `hardware/dcx_main/dcx_main_board.eprj2`、六分区 SVG、真实引脚扫描、`pin_footprint_review.csv`、`netlist_compare.json`。对已放置器件，221 个由黄金网络展开的焊盘匹配，另将 U2 焊盘 11（裸露焊盘）单列接 PGND。
- **A5 机械摆件有真实成果**：主分支的 `hardware/dcx_mech/power_stage_placement.kicad_pcb`、1:1 SVG 与报告：155.0×131.0 mm、35 个对象、0 报告的外形重叠。它是**没有网络、没有走线**的布局研究，不能据此宣称主板 DRC 已通过。
- **控制验证原理图 ERC 已有可检查成果**：`pcb/control_validation/erc.json` 报 0 violations。该原理图不是完整主板，也没有控制验证 PCB／Gerber。
- **能量诊断有进展但未闭合**：133 周期相位对齐、5 ns vs 2 ns 的闭合诊断读数约 +0.326/+0.314 W（周期平均），都在 0.2 W 目标之外；列示损耗合计却由 10.731 W 变为 11.356 W，相差 **0.625 W**。因此某些损耗分项仍未数值收敛，不能把当前电气端口效率或 92.33% 工程预算解释为已硬件验证的效率。
- **最新版主分支 CI 失效**：`main@f83e3bf` 的 Actions [run 41290043962](https://github.com/czy0126/CZY/actions/runs/41290043962) 为 1 failed / 298 passed / 3 skipped。唯一失败：`test_main_board_mechanical.py::test_the_committed_board_is_what_the_table_produces`，因为 `tools/main_board_mechanical.py` 将官方 KiCad 库路径写死为开发者本机 `C:\\Users\\27792\\AppData\\Local\\Programs\\KiCad\\10.0\\share\\kicad`，Runner 找不到 `Package_SON:Infineon_PG-TDSON-8_6.15x5.15mm`。**这是 CI 环境依赖缺陷，不是“电路仿真失败”，但会使新增机械生成一致性验证无法执行。**

## 1. A1 原生主板原理图的严格验收边界（PR #10）

| 已完成 | 尚缺／重要限制 | 处置 |
|---|---|---|
| 61 个位号已进入原生工程；已放置器件中 221 个黄金焊盘比对通过，另 1 个 U2 裸露焊盘接 PGND | **T1–T4 和 CT 共 5 只磁件没有原生符号、未放置**；`netlist_compare.json:ok=true` 的逻辑明确允许这 5 只缺席 | **P0** 定制五引脚变压器符号（含中心抽头、极性 DOT）和四引脚 CT 符号；重新导出原生网表，改验收为 `not_placed=[]` |
| 分区、原生网表、可审查 SVG 和 pad 审表已入 PR | **39 个位号使用占位件**：如 Cr 原理图暂用 100 nF 0603，而目标是 620 nF、约 9.45 A RMS 的谐振电容；SR 门阻/多处 R-C 使用 10 k 等占位值 | **P0** 建立逐位号的元件值、耐压、封装、数量一致性表；消除会误入 BOM/投制文件的占位料。未选 MPN 可显式 `DNP/TO_SELECT`，但不能虚假标为已定 |
| 真实器件的焊盘扩展核对与 U2 EP 单列有价值 | **原生编辑器 ERC 尚未完成**：CLI 的 warning 计数在空白页也出现，不能当有效 ERC；另无主板 PCB | **P0** 通过 GUI 导出有效 ERC 报告（含规则与错误明细）；不以 `ok:true` 代替 ERC、值检查或 PCB 验收 |
| T1–T4/CT 磁件缺口被如实标注 | 黄金网表来自 SPICE，对绝缘距离、热焊盘、实际端子顺序/装配约束覆盖有限 | **P0** 把磁件的 DOT、端子方向、实际封装焊盘与 `winding_polarity.json` 和加工图逐一对照；再次做“原理图→PCB”双向映射 |

**对 PR #10 的审核决定：保留为 A1 的重要在制交付，建议完成磁件符号、核心器件真实值/封装及有效 ERC 后再关闭 Issue #9。** 若选择先合并以便协作，PR/README 必须明确 `WIP / 非可投板`，不能因其 `netlist_compare.ok=true` 宣告 A1 完成。

## 2. A5 机械布置的核心风险

| 项目 | 当前记录 | 审核意见 |
|---|---|---|
| PCB 外形 | 155×131 mm、35 个占位／实际外形对象 | 可用于摆件，**还不是高速回路和 100 A 电流路径的可实现布局**；板框要随真实 SR→Cout→J_OUT 路径与冷板机械边界复核 |
| 5 只磁件 T1–T4、Lr | ELP32，最坏裸磁芯高度 9.8 mm；平铺含胶/标签估计 9.94 mm | 相对 10 mm 仅余 **0.06 mm**。0.5 mm 固定压件时估计 **10.44 mm**，已超限；五只磁件要一起考虑沉槽/固定，不能只给 T1–T4 沉槽 |
| PCB 沉槽 | 现设想下沉约 0.5 mm | 需要 1:1 **剖面**：基板剩余厚度、绝缘/层间铜、焊料/固定件、凸起、冷板/TIM、装配公差与加工许可。先由制造厂确认工艺，再声称 ≤10 mm |
| CT、Cr、J_IN、控制区 | `placement_report.json:provisional` 四项 | **P0** 尽快选出真实外形／封装。J_IN 暂定高度 10 mm，本身已吃满限高；强烈建议优先评估更低接口或把输入端子放到高度约束之外，不能假设现有占位可用 |
| QH/QL | 体尺寸已按 Q5A 数据手册最大值修订 | `land_pattern_provisional` 仍是占位焊盘，**不可制造**；需要按官方推荐焊盘图校对栅漏源与散热焊盘 |
| Cout | 15×470 µF、2.5 V、ESR 理想并联 0.20 mΩ、占位高度 1.9 mm | 候选电容实装最大高度／纹波电流降额应按原厂数据确认；2.5 V 对 50–54 V 输入空载及过冲应留可靠性余量；**PCB 分布 ESR/ESL** 不能被理想 0.20 mΩ 掩盖 |
| DRC=0 | `hardware/dcx_mech/drc.json:violations=[]`；若干检查被忽略 | 无 nets/tracks 的 DRC 不能证明连线、铜宽、电流分布和冷板可制造；仅表明该摆件文件未触发其启用规则下的报错 |

**新阶段核心建议：在 A6 全布线之前，先冻结输出 100 A 铜排/接点、15 只输出电容到 SR 的路径，并画出五只磁件的安装剖面。** 100 A × 0.15 mΩ 输出预算对应 **1.5 W** 损耗；布线需按实际电阻与热路径评估，不能仅凭 0 重叠决定“合理”。

## 3. CI 与项目可复现性：立刻修复，不以跳过测试假装通过

- **P0 软件阻塞**：机械摆件生成器依赖开发者绝对 Windows 路径（见 §0），导致 main CI 红，重复开发会看不到真实退化。
- **推荐方案**：将 KiCad 官方库 footprint 版本作为**可追溯的工程依赖**（本地 vendored / 版本固定的上游数据，核对再分发许可）或让生成器从环境变量／KiCad 官方安装目录定位；在 CI 中安装**匹配版本与库**。生成一致性测试仍应重新渲染并与提交的 `.kicad_pcb` 比较，不宜单纯删掉此测试。
- 将耗时且依赖 KiCad GUI／EDA 客户端的工作拆成明确的 CAD/机械验证 job；轻量 pytest 与 manifest 不应因为未说明的本机绝对路径失效。若只能暂时跳过，必须显式标为“依赖缺失、再生成未验证”，不能报告为完整再现成功。
- 复核生成文件 `drc.json` 的 ignored_checks；`missing_courtyard` 被忽略时，布局不能据此声称外形边界全部通过。
- PR #10 的 A1 验收必须是**真实 LCEDA 项目导出**与真实网表检查；不能只测 Python 生成的模拟期望结果。

**验收**：一次全新 GitHub Runner checkout 不含开发者私有路径，能成功再生 A5 成果并通过 `pytest`；CI 日志说明 KiCad 版本和 footprint 版本；如依赖不可取得则明确 FAIL 而不是静默 PASS。

## 4. 效率与器件物理：精度任务与制造任务分开

- 100 A 当前简化模型端口效率与 92.33% 工程损耗预算**不同核算边界**；所有结果均为 `SIM_MEASURED` 或 `ENG_ESTIMATE`，不允许作为连续硬件效率。
- 相位对齐的 133 周期闭合残差（周期平均）5ns **+0.32585 W**／2ns **+0.31392 W**，目标 ≤0.2 W，因此 `NOT_CLOSED`。
- 同一窗口输入—输出功率差变化 **+0.534 W**，列示损耗变化 **+0.625 W**；闭合残差相近并不代表每项损耗已收敛，两项可能相互抵消。Issue #6 下一步应对端口项和 SR/铜损/驱动项做逐项步长、能量方向、储能端点对照。
- 物理 Lr 故障峰值 84.02 / 104.17 A 来自**线性磁件模型**；三匝 ELP32 是可打样候选，约 1.444 mm 气隙仍需首件的 L(I)、气隙边缘热损耗及加工确认。
- 关键时序/控制和故障硬件测试尚未发生：`HW_MEASURED=0`。**Issue #6 不宜阻塞 A1 真实原理图、可行机械结构和控制板 PCB**；只要仿真发现器件超额定或失去保护能力，立即升级为投板阻塞。

## 5. 后续路线：工作包及放行 Gate

| 排序 | 工作包（执行入口） | 必需交付 | 独立验收 / 不得混淆 |
|---|---|---|---|
| **0 — CI** | 解除 `main_board_mechanical.py` 硬编码路径；固定外部 KiCad 库版本与 CI | 可在干净 Runner 复现的摆件与绿色工作流 | 不能因跳过关键生成验证而把 CI 伪装成完整通过 |
| **1 — A1（现有 PR #10、Issue #9）** | 定制 T1–T4/CT 符号；把 39 个占位器件的值/关键封装落到真实物料；原生 ERC | 新版可编辑 `.eprj2`、完整原生网表、`not_placed=[]`、ERC 明细、制造阻塞表 | 焊盘级 diff + 极性/引脚/焊盘核对；不因 `ok:true` 的子集通过而关闭 |
| **2 — A5 → A6 机械与主板** | 冻结 Cout/Cr/CT/J_IN、QH/QL 焊盘，确认五磁件下沉结构与冷板接口；将 A1 真网表导入 PCB | 实物料号/外形/高差剖面、铜排接点设计、带真实网络的主 PCB | PCB/ERC/DRC/叠层/100 A 电流路径/装配数据全部核对，才进入 D1 |
| **3 — B 磁件首件** | 1 套 3:1:1 变压器、三匝候选 Lr、CT 分别先打样 | DOT/变比/Lm/漏感/DCR/L(I)/温升/绝缘/高度记录 | 实测漏感回填 L_ext；三匝不等于已保证不会饱和 |
| **4 — C 控制验证板** | 已有 `control_validation.kicad_sch` → 真实 PCB、BOM/Gerber、低压限能换流夹具 | SR 的 VGS/VDS/PGD、互锁、体二极管续流、反向电流、关断延迟波形 | 原文 T3/T7“10 mH + ≤20 V”不能在 100–500 kHz 等效产生安培级 SR 换流，需要重设试验 |
| **5 — D1 发布/投板评审** | 原生主板 + 真正机械与电气一致的制造文件；关键额定/封装/保护条件已满足 | 生产 BOM、Gerber、钻孔、坐标、装配图、校验记录、限能上电协议 | 所有 P0 关闭后**才允许制造首版主功率板** |
| **6 — D2/D3 实物闭环** | 低压限能→48 V→10/25/50/75/100 A，温度/效率/纹波/保护；必要时降额 | 实测报告、测试条件、波形和第二版 ECO | 100 A 连续/≤10mm 只以整机真实测量签核，不以“仿真已跑 100 A”签核 |

并行规则：**0 与 1 立即同时做；2 的磁件/铜排 1:1 机械讨论与 1 并行；3、4 可委托并行。** 但 A1 未完成前不能用 A5 无网摆件直接启动正式主板布线。

### 下一批 5 个“能产出文件”的任务

1. **复现性修复 PR**：`tools/main_board_mechanical.py` 的 KiCad 路径和官方封装库依赖，强制再生成测试在 CI 通过。输出：工具修复 + 对应测试/说明。
2. **PR #10 增量**：新增 T1–T4、CT 的原生符号/端子/DOT；按真实模型重新导出网表，移除 `MAGNETIC_GAPS` 的默认豁免。输出：`.eprj2` + `netlist_compare.json`。
3. **物料冻结任务**：选定 Cr、CT、J_IN、Cout 与 QH/QL 焊盘，给完整原厂依据和 3D/land pattern；修复 39 个占位件。输出：`bom_review.csv` 与原生符号/封装。
4. **A5 机械深化**：输出五磁件沉槽、固定、1.6 mm PCB 剩余基材、冷板/TIM、高度最大值与公差的 1:1 剖面；用实际选定料重排铜排、输出电容。输出：有效可审查的机械剖面/修订版 KiCad。
5. **SR 测试板**：从控制原理图建立可布线 PCB、低能量实际换流夹具、测点与限流；完成真实数据回填。输出：控制 PCB/Gerber + 测试工艺，不是新的原理推导。

## 6. 两次短冲刺节奏（目标，不是交付保证）

**冲刺一：封闭 D1 输入。** CI 路径修复；PR #10 补 5 磁件及真实值；核心器件确认封装/采购；高 10 mm、铜排/Cout、开槽的机械剖面；控制板 PCB 工程启动。交付一个可审查的原理图与物料冻结清单。

**冲刺二：完成主 PCB/制造候选。** 在原生原理图导入网表后完成布局布线、铜厚与热路径计算、真实 DRC、BOM/Gerber/坐标/装配图；磁件/控制板首件进入验证；确定哪些数据必须等首件回填才能最终签核。**若 P0 未关闭就明确“不放行投板”，但不再用新增分析报告消耗第二次冲刺。**

## 7. 对外状态和任务管理规则

- 以 [总交付计划](工程交付加速执行计划_2026-11-01.md) 定义 D1/D2/D3；以**本文**记录 2026-11-01 最新增量审查。旧综述不删除。
- 以 PR #10 / Issue #9 管 A1；Issue #6 管能量；新增 GitHub Issue 管 CI 和机械制造阻塞。避免把同一问题拆成十份新综述。
- 下一个 PR 必须交**文件与验收输出**，不是只有“建议继续优化”。
- 发布 D1 前必须：`not_placed=[]`、占位关键器件清零、有效 ERC、真实 PCB 与可制造 DRC、正式 BOM、磁件与输出路径的机械/安全验收。
- 任何硬件指标使用 `HW_MEASURED` 之前必须链接测量记录；模型对称均流≠真实均流，`NOT_CLOSED`≠效率已守恒验证。

## 8. 核心证据索引

- [A1 原生主板 PR #10](https://github.com/czy0126/CZY/pull/10)；在审的 `hardware/dcx_main/README.md`、`netlist_compare.json`、`pin_footprint_review.csv`。
- 已合并 A5 摆件：`hardware/dcx_mech/power_stage_placement.kicad_pcb`、`placement_report.json`、`design/v3/A5_机械布置_2026-11-01.md`。
- 控制验证板：`pcb/control_validation/control_validation.kicad_sch`、`erc.json`。
- 100 A 数值分析：`design/v3/stage_f/energy_ledger_100a_phase_aligned.json`，当前状态 `NOT_CLOSED`。
- 物理配置/磁件：`design/v3/bom/lr_design.json`、`design/v3/magnetics/绕组工艺卡_2026-11-01.md`。
- [最近主分支失败的 CI 运行](https://github.com/czy0126/CZY/actions/runs/41290043962)。

**本次最重要的工程决策：优先把“原生主板原理图缺少 5 磁件与 39 占位”和“机械设计只有无网络摆件”这两项变成真实可制造工程，别再让模型精度打断 CAD 主线。**
