czy0126/CZY/deepseek/review.md

下面给出**一次工程裁决**。我只依据你给出的五篇论文全文做事实抽取；不在未给出处补参数；凡论文没写的，统一写“未提供”。不声称已仿真。首版按你的约束：**48V 标称、固定变比、24:1 标称、约 2V/100A 连续、200W、总高≤10mm、允许风冷、外供控制电源、无医疗/车规/安规隔离认证需求**；输入初评 46~50V，输出随输入与损耗变化，不承诺全输入范围恒 2V。

---

## 1. 五篇论文逐篇抽取

### 1.1 500A Stacked Direct Power converter with standard PCB transformer（APEC 2024，pp. 925–930）

- **拓扑**：DPx（Direct Power Converter）单端“直接导通”变换器；原边串联、副边并联的 stacked 结构；24V→1V 用两个 12:1 模块堆叠；论文明确说可四模块堆叠成 48:1V。副边为同步整流，无输出 Buck 电感，属“变压器直通+复位”类，不是 LLC。
- **实验/仿真**：实验为主；有负载阶跃仿真对比 Buck 与 DPx（Fig. 7）。无 LLC 仿真。
- **连续/峰值电流**：实验到 **500A** 输出；100A、200A、500A 效率点；峰值电流未提供。文中比较图给出 100A 下各拓扑 rms 因子，属计算非实测。
- **效率含哪些损耗**：实测峰值 **97.1%**；100A **96%**、200A **95%**、500A **90.5%**；Fig. 10 给出“含/不含驱动损耗”两条曲线；Fig. 11 给效率与损耗随输出电流；损耗分布指出高频下以 **I²R** 为主，磁芯损耗几乎不变；驱动损耗在 200kHz 下影响不显著。
- **磁芯/层数/铜厚/高度/散热**：磁芯为 **custom extended EI，3C95 铁氧体**；PCB **标准 3oz**，矩阵变压器 **10 层**；变压器实现高度 **6.5mm**（“very flat (6.5mm)”）；整机高度未给；散热为 **风冷**，500A 热像图给出（Fig. 12），环境温度未给；磁芯截面文中提“only 8mm² because 1 turn and 1V”，属 1V 输出场景。
- **控制方法**：**开环**，固定变比，无稳压；文中明确“there is no regulation in this work”；可选 active clamp 用于降低原边开关电压和命令副边电流，但原型主结果按开环给出；开关频率 **200kHz**。
- **对本项目的直接可用点**：原边串联/副边并联的“内在原边电压自平衡、输出电容内在均流”思想；标准 3oz PCB + 商用/定制磁芯可制造；矩阵变压器把大电流分到多个 SR。
- **不能直接照搬点**：其 1V/500A、24:1、200kHz、3C95、10 层、6.5mm 磁件是 1V 场景；本项目 2V/100A/200W，电流小 5 倍，磁芯截面与 SR 数量不能按比例“感觉”缩放；论文没有给 Lr/Cr/Lm 数值。

### 1.2 A 48V-2.2V Matrix Autotransformer Switched-Capacitor DC-DC Converter（ECCE 2024，pp. 2701–2708）

- **拓扑**：**22X-MASC**：高压侧为 switched-tank converter（STC）结构，低压侧为矩阵自耦变压器（2:1:1:2）整流的混合开关电容；不是隔离 LLC；两个变压器与电感合并到一个磁芯；低压侧用 18 个 MOSFET 实现 22X（对比 22X-STC 需 42 个低压侧 MOSFET）。
- **实验/仿真**：**仿真 + 实验**；仿真给出 48V 输入、输出 rms 2.25V、输入 rms 8.10A、输出 rms 161A；实验样机 48V→2.2V，**90W 输入**时 48V/1.8A、2.18V/37.5A，效率 **94.6%**；峰值效率 **96.1%**（不含驱动损耗）；因板卡运输与调试时间，**未推到满载**，论文明确说 further work 要推到最大负载并细调频率/死区。
- **连续/峰值电流**：实验连续只到 **37.5A**（90W）；仿真输出 rms **161A**；峰值电流未提供；论文说最大输出功率主要受低压侧 MOSFET 电流限制。
- **效率含哪些损耗**：峰值 96.1% **不含 gate driver loss**；Fig. 20 给计算效率与损耗分解；Fig. 21 给含/不含驱动损耗实验效率；损耗考虑导通、栅极驱动、Coss（因 ZCS/ZVS，按文中 TSLI 只计导通、驱动、Coss）；磁芯损耗文中说低于低压侧导通损耗，未给完整分解数值。
- **磁芯/层数/铜厚/高度/散热**：整板 **52mm×52mm×7.8mm**；磁芯几何给 a、g、d、气隙 η；PCB 层数未提供；铜厚未提供；绕组为两层绕一匝并牺牲铜厚（“two turns are winding in one PCB layer and sacrifice the thickness of the copper”），具体铜厚未提供；温升计算称 **<40°C**；散热条件未明确写风冷/自然冷；死区 **30ns**；开关频率调到 **91kHz** 以匹配硬件谐振频率。
- **控制方法**：固定频率、互补驱动、最小死区实现 ZVS；ZCS 由谐振参数实现；论文说无需 phase-shifting control 即同时 ZCS/ZVS；不是 PFM 闭环；未给闭环稳压。
- **对本项目的直接可用点**：矩阵磁件+多 SR 均流；ZCS/ZVS 同时实现的谐振支路思想；死区 30ns 量级可作起点；低压侧多管并联的栅极驱动环路要短且对称。
- **不能直接照搬点**：它是 **22X 开关电容+自耦变压器**，不是“半桥 LLC/DCX + 隔离变压器”；其 2:1:1:2 自耦变比不能直接推成 24:1 隔离变比；实验只到 90W/37.5A，不能把 161A 仿真当连续能力；没有给 Lr/Cr 具体值（只给 fr 公式与 C1=C3=0.1C2 关系）。

### 1.3 High Current, High Power-Density Intermediate Bus Converters for Vertical Power Delivery（IEEE TPEL 2025, Vol.40 No.10, pp.14771–14784）

- **拓扑**：**半桥 LLC-DCX**（unregulated LLC）作为第一级 IBC；变压器 **unit-cell**：两个 1:1（半桥）或 2:1（全桥）单元变压器共用 UI/UU 磁芯；原边“serpentine/semi-serpentine”串接多个 unit-cell；副边中心抽头（CT）整流，多 SR 并联；论文明确 HB 适合 <850W，FB 适合更高功率；样机 48V/1.8V、840W、14 个 1:1 变压器（7 个 unit-cell）、14:1。
- **实验/仿真**：**实验 + FEA/热仿真**；样机 **100mm×10mm×5.8mm**（含驱动到 110mm 时 2200 W/in³）；46–52V 输入；峰值效率 **95.6% @46V**，满载 **92.3% @52V**；效率 **不含 device driving losses**；80% 负载、800LFM 风冷、无散热器时热点 **102.3°C**（磁芯，Bmax=300mT），最远 SR **90.8°C**，原边 **71.8°C**；FC 说明满载风冷需散热器。
- **连续/峰值电流**：840W/1.8V 约 **467A** 连续；峰值电流未提供；SR 每变压器约 **60A** ac；14 个 SR 并联（每变压器 2 个 CT SR？文中“28 devices”对应 14 变压器 CT 两只）；初级 HB 用 100V GaN EPC2032；SR 用 15V Si MOSFET，3.3mm×3.3mm。
- **效率含哪些损耗**：效率不含驱动；损耗分解 Fig. 24 给满载 50V/1.8V：变压器绕组损耗与 SR 导通损耗主导；Fig. 14 给原边器件 4.3W、SR 17.1W（满载）；磁芯损耗用 Mu 矩形 AC 模型，材料 ML27D 因高 Bmax 下 Pv 最低；绕组用 Dowell 模型；FEA 热。
- **磁芯/层数/铜厚/高度/散热**：**14 层 PCB**（12 层绕组 + 上下 2 层 SR/电容终止层）；磁芯 **UI/UU**，材料 **ML27D**（Proterial），Bmax 可到 300mT；铜厚未提供；模块高度 **5.8mm**；散热为 **顶部冷却+铝均热板+液冷 h=100 W/m²K**，同时给 800LFM 风冷实验；TIM k=17.8 W/m·K，1mm 铝均热板；Rth,J-A 原边 12.2°C/W、SR 46.4°C/W（用于选型估算）。
- **控制方法**：**LLC-DCX 固定频率在谐振频率 fo**；开环固定变比；ZVS 全负载范围；无 PFM 闭环；驱动 LM5113-Q1（原边 GaN），SR 驱动 FAN3122 放在主板；死区未给具体值；启动/保护未给。
- **对本项目的直接可用点**：**半桥 LLC-DCX + 矩阵变压器 + 中心抽头 SR** 是最接近你“固定频率半桥 LLC/DCX、原边串联副边并联、分布式 SR”的论文；HB 在 <850W 内合理；14 层 PCB 与 5.8mm 高度说明 10mm 总高可行但需要层数/铜厚/热设计；SR 热阻 46.4°C/W 可用于首板 100A 估算（需按实际封装/铜面积修正）。
- **不能直接照搬点**：它是 14:1、1.8V、840W、液冷+顶部冷却；本项目 24:1、2V、200W、风冷、总高含 PCB 和磁芯≤10mm；其 14 层、ML27D、300mT、600–700kHz 是优化结果，不能直接缩放到 200–300kHz；论文没有给 Lr/Cr/Lm 数值；没有给 UCC25600 兼容性。

### 1.4 Low-Profile Direct Power Converter: 350A/48V-1V with Planar Matrix Transformer using standard PCB and commercial cores（APEC 2024，pp. 2172–2177）

- **拓扑**：**DPx 低矮版**：原边半桥 + 有源钳位，副边单整流开关（同步整流），平面矩阵变压器+部分匝（partial turns）；6 个商用 E14/3.5/5 + PLT14/5/1.5 磁芯，每个 4:1，副边 12 个并联；变比由 N_CORES×N_P 决定，D 不影响增益；有源钳位把原边 VDS 降低约 0.63 倍；ZVS 原边、ZCS 副边（副边控制信号相对原边延迟）。
- **实验/仿真**：**实验 + 理论损耗/效率曲线（V2 为理论）**；实验 48V→1V/350A，fsw **150kHz**，D≈75%；峰值效率 **94%**，满载 **85%**；V2 理论效率提升 3%（≤200A）、6%（350A）；功率密度 412 W/in³（实验），V2 理论 683 W/in³；热像：150A 时磁芯 45°C，350A 时副边开关 95°C；风冷两台 Sanyo Denki 67.8CFM。
- **连续/峰值电流**：实验连续到 **350A**；峰值未提供；原边 7 个 GaN 并联（3 个作有源钳位），副边 24 个 Si 并联（V2 为 48 个）。
- **效率含哪些损耗**：效率曲线 **不含 gate drive loss**；损耗分布 Fig. 14：副边导通（绕组+开关）主导；磁芯损耗“practically insignificant”；驱动损耗未计入；有源钳位损耗未单独给。
- **磁芯/层数/铜厚/高度/散热**：磁芯 **Ferroxcube E14/3.5/5 与 PLT14/5/1.5，3C95**；PCB **8 层**；铜厚未提供；整机 **105×40×5mm**（含驱动），V2 为 83×21×5mm；散热为**风冷**（两台 67.8CFM），无散热器；磁芯 AL 容差 ±25%，未平衡磁芯会引起副边 VDS 高频谐振，解决方法是把各开关漏极电气点互连。
- **控制方法**：固定频率 **150kHz**，开环固定变比；有源钳位控制；副边 SR 相对原边延迟实现 ZCS；没有闭环稳压；启动/保护未给。
- **对本项目的直接可用点**：**5mm 高度、标准 PCB、商用磁芯**证明 10mm 总高可行；部分匝/矩阵变压器降低高度与铜损；磁芯 AL 容差与均流问题必须在首板处理（互连漏极或配对磁芯）；DPx 的“直通”占空比高、rms 因子低，但**原边开关电压随 D 升高**，需要钳位或降低 D，这与 LLC-DCX 不同。
- **不能直接照搬点**：DPx 不是 LLC，不能把其 150kHz/D=75% 直接套到半桥 LLC；其 1V/350A 的副边 24 管并联对 2V/100A 过多；有源钳位增加控制与直通风险；论文没有给 Lr/Cr/Lm。

### 1.5 Single-Stage 48V/1.8V Converter With a Novel Integrated Magnetics and 1000 W/in³（IEEE TIE 2024, Vol.71 No.7, pp.6601–6611）

- **拓扑**：**多相半桥 + 电流倍增整流（CDR）**；每相一个变压器+两个输出电感，磁集成把变压器与四相耦合电感做在一个 EI 磁芯里；不是 LLC；原边半桥，副边 CDR；四相耦合，耦合系数 |α|=0.75；用埋孔降低绕组损耗；SR 与输出电容放在副边绕组上。
- **实验/仿真**：**实验 + 3D FEA（Maxwell 磁瞬态）**；样机 48V/1.8V，**120A 连续、300A 峰值（2ms×62Hz）**；峰值效率 **93.1%**，满载 **87.8%**（含 gate driver loss）；功率密度 **1037 W/in³**（含驱动与尺寸）；500LFM 风冷；42.2mm×18.6mm×**4.35mm**；开关频率 **600kHz**；硬开关，100V EPC2204 在 300A 峰值时 Vds 振铃 79.8V；SR 峰值电压 12.6V，选 25V。
- **连续/峰值电流**：连续 **120A**，峰值 **300A/2ms×62Hz**；这是五篇中唯一明确给“连续/峰值”定义的。
- **效率含哪些损耗**：**含 gate driver loss**；损耗分解 Fig. 26：绕组损耗与 SR 损耗主导；磁芯损耗用 FEA；埋孔使总绕组损耗降 10.8%（原边 15.1%、副边 8.8%）；热像 24°C 环境、500LFM、无散热器，满载与 boost 模式最高 95.4°C。
- **磁芯/层数/铜厚/高度/散热**：磁芯为定制 EI + 分离漏感腿（形状 3，DMEGC 材料，具体牌号未提供）；PCB **8 层**（SPPS 排列：S-P-P-S，上下对称）；铜厚未提供；高度 **4.35mm**；散热 **500LFM 风冷、无散热器**；埋孔增加 PCB 成本。
- **控制方法**：多相半桥、恒导通时间/电流模式（文中引用 TI DCAP+ 类控制器与 Infineon XDP），**不是固定变比 DCX**；有闭环稳压能力；相位交错；死区未给；启动/保护未给。
- **对本项目的直接可用点**：**连续/峰值电流定义**可借用；4.35mm 高度、8 层 PCB、风冷 500LFM 说明 10mm 总高与 100A 风冷可行；埋孔/铜厚/绕组排列对 100A 损耗影响大；SR 25V 选型与 12.6V 峰值应力的裕量思路可参考（但本项目 2V 输出，SR 电压应力不同）。
- **不能直接照搬点**：CDR 需要输出电感，磁件数量与体积大于 LLC-DCX；600kHz、四相耦合、120A 连续是 1.8V 场景；其闭环控制不是固定变比开环；不能把 93.1% 直接当本项目效率。

---

## 2. 四路线对比与主案裁决

| 路线 | 首样可制造性 | 与 24:1/2V/100A/200W/≤10mm 的匹配 | 主要风险 | 裁决 |
|---|---|---|---|---|
| **LLC DCX（半桥+矩阵变压器+CT SR）** | 高：标准 PCB、商用/定制磁芯、SR 并联；论文 1.3 已做 14 层/5.8mm/840W | 最匹配：固定频率、固定变比、原边串联副边并联、分布式 SR；HB 在 <850W 合理 | 磁件参数（Lr/Cr/Lm）需从连接与磁路重算；SR 反灌与死区；100A 风冷热 | **主案** |
| **DPx/堆叠** | 中高：5mm、标准 PCB、商用磁芯已演示；但需有源钳位与副边 SR 延迟 | 变比可堆叠，但原边开关电压随 D 升高，钳位增加直通/时序风险；论文 1.4 是 1V/350A，2V/100A 需重新设计 | 有源钳位直通、SR ZCS 延迟、磁芯不平衡谐振 | 仅当 LLC 主案在磁件高度/层数上被否决时启用 |
| **MASC** | 中：22X 开关电容+自耦变压器，18 个低压侧 MOSFET、3 个谐振/非谐振电容；实验只到 90W/37.5A | 变比 22X 接近但非隔离；低压侧管多、电容多；未推到满载 | 电容容差、谐振支路、低压侧管并联均流；不是 24:1 隔离 | 不推荐首样 |
| **移相全桥+倍流** | 中低：全桥 4 管+倍流 2 电感+变压器，磁件多、体积大；ZVS 范围与占空比丢失 | 24:1 需大匝比，副边 100A 倍流电感体积与高度不利 | 磁件多、高度、轻载 ZVS、SR 时序 | 不推荐首样 |

**主案推荐：固定频率半桥 LLC/DCX + 四个 3:1:1 中心抽头磁件（原边串联、副边整流后并联）+ 分布式 SR。**  
**另一方案 DPx/堆叠仅在明确否决条件触发时启用**：若主案磁件在 10mm 总高内无法同时满足 24:1 匝比、Ae/AL、气隙、爬电与 100A 铜厚，或实测 SR 反灌/死区在 200–300kHz 内无法稳定，则转 DPx；否则不并行开发。

**不要追求论文功率密度**：论文 1.3 的 2200 W/in³ 是液冷+顶部冷却+840W；论文 1.5 的 1037 W/in³ 是 600kHz+四相耦合+埋孔。本项目 200W、风冷、10mm 总高，首样目标是**可运行、可测、可制造**，不是密度。

---

## 3. 主案完整文字连接、变比推导、磁件电压电流分摊、Lr/Cr/Lm 设计方法与首轮估值

### 3.1 文字连接

- **原边**：48V 输入 → 输入电容 → 半桥两管 Q1（高侧）/Q2（低侧）组成半桥，桥臂中点 A 接**四个磁件原边绕组串联**（顺序 P1→P2→P3→P4），串联后回到半桥中点？注意：半桥只有一个桥臂中点，串联原边必须从 A 出发，依次串四个原边，最后回到**输入分压电容中点 B**（两个输入电容分压，各承受 Vin/2）。这就是半桥 LLC 的标准连接：Q1/Q2 互补，A 点方波 0~Vin，B 点直流 Vin/2，四个原边串联承受交流方波，每个原边约 Vin/2 的方波幅值（实际由串联分压与磁化电流决定）。**不要**把四个原边并联到半桥，否则变比不对。
- **原边谐振**：Lr 与 Cr 串联在原边回路中。Lr 可用四个磁件的漏感**折算到原边串联**实现，也可外置；Cr 用 Class I 薄膜/COG 电容，放在原边串联回路。**漏感只能计一次**：若 Lr 全部用漏感，则四个磁件漏感按串联相加（每个原边漏感 Lk_i，串联总 Lk=ΣLk_i），不要再把“副边漏感折算”重复加进去；若外置 Lr，则磁件漏感只作为寄生，不重复计入谐振。
- **副边**：每个磁件为**中心抽头**：副边两半绕组 S_a、S_b，中心抽头为输出正/负？按 CT 整流惯例：中心抽头接输出电容中点/地，两个端点各接一个 SR 管到输出正（或反之）。四个磁件副边**整流后并联**到同一输出电容。每个磁件副边两半匝数相等，SR 成对互补（每个磁件两个 SR，四个磁件共 8 个 SR 位置，可多管并联）。
- **SR**：分布式 SR，每个磁件靠近其副边绕组放置 SR 与输出电容；SR 驱动由外供偏置或自举，需与半桥互补时序配合，死区防直通；SR 体二极管在死区导通，需控制反灌。
- **控制**：固定频率（首轮 200–300kHz 起点），半桥 Q1/Q2 互补，固定死区；LLC-DCX 开环固定变比，但**不是完全不需要控制**：需要固定频率振荡、互补死区、软启动、UVLO、过流停机、SR 使能时序。SR 不能简单“常开”或“与 Q1 完全同相”，必须按 CT 整流时序并在死区/轻载防反灌。

### 3.2 变比推导（独立推导，不信候选）

设每个磁件原边匝数 Np，副边每半匝数 Ns（中心抽头两半各 Ns）。半桥原边电压方波幅值为 Vin（A 点 0~Vin，B 点 Vin/2，串联原边总电压为 Vin 的方波？需仔细：半桥 LLC 的谐振腔输入电压为 A-B，幅值 Vin，因为 A 在 0~Vin，B=Vin/2，所以 A-B 在 ±Vin/2？实际半桥 LLC 谐振腔电压为 ±Vin/2 方波，因为桥臂中点相对分压中点。**这是关键**：半桥 LLC 的变压器原边电压幅值为 Vin/2（每个半周期），不是 Vin。全桥才是 ±Vin。论文 1.3 用 HB，14:1 对应 14 个 1:1 变压器，48V/1.8V≈26.7，但 HB 半桥每个变压器原边电压 Vin/2，副边 CT 输出 Vout≈(Vin/2)/(Np/Ns)？若 Np/Ns=1，Vout≈Vin/2=24V，不是 1.8V。所以论文 1.3 的“14:1”是**总匝比 n=14**，HB 的增益是 Vin/(2n)？48/(2×14)=1.71V，接近 1.8V。**对，半桥 LLC-DCX 的电压变比是 Vin/(2n)**，其中 n=Np/Ns（每个变压器原边对副边半绕组的匝比），因为半桥谐振腔电压幅值 Vin/2，CT 整流输出为 (Vin/2)/(Np/Ns)=Vin/(2n)。论文 1.3 说“14:1 turns ratio”实现 48V/1.8V，实际是 n=14，增益 48/(2×14)=1.714V，加上损耗与占空/谐振接近 1.8V。**所以本项目 24:1 标称若指 Vin/Vout=24，则半桥 n 应为 12，不是 24**。你给的候选“四个 3:1:1 中心抽头磁件，总等效原边对半副边 12:1，半桥得到约 24:1 电压变比”——**这个推导是对的**：每个磁件原边:半副边=3:1，四个原边串联，总原边:半副边=12:1；半桥增益 Vin/(2×12)=Vin/24，48V→2V。**独立推导结论：半桥 LLC-DCX 的标称电压变比 = 2×Np_total/Ns_half = 2×12=24**。注意：这里 Np_total=4×3=12 匝（若每个 3 匝），Ns_half=1 匝；总原边对半副边 12:1；半桥因子 2 得到 24:1。**不要**把“24:1”直接当匝比 n=24 去算 Lm，否则 Lm 会差 4 倍。

**每磁件电压**：
- 原边每个磁件承受总原边电压的 1/4。半桥谐振腔总原边电压幅值 Vin（A-B 为 ±Vin/2？再确认：半桥 LLC 谐振腔输入电压为方波，幅值 Vin/2，因为 A 点 0~Vin，B 点 Vin/2，所以 A-B 在 -Vin/2~+Vin/2。**总原边串联电压幅值 Vin/2**。每个磁件原边电压幅值 Vin/(2×4)=Vin/8。48V 时每个原边 6V 方波幅值。副边半绕组电压 = 原边电压/(Np/Ns)= (Vin/8)/3=Vin/24=2V 幅值。CT 整流输出约
