czy0126/CZY/docs/审核结论与后续指南_2026-10-31.md

# 另一 agent 交付审核与后续执行指南

审核日期：2026-10-31。范围：v3 器件/时序/换流台架、Roffset 结论，以及 startup_ct_long / startup_ct_fault 新交付。保留原交付；本审核独立复跑及证据放在 `design/review_20261031/`。本次不是硬件验收。

## 审核结论：部分通过，真实控制与 SR 换流尚未闭环

可接收的是器件行为模型的初步标定、换流台架的可重复性，以及旧版开关模型下长时间启动这一数值进展。不可接收的是“真实整机已经验证”“固定 Roffset 方案已被排除”或“可据此定版投板”。保留 UCC25600 + UCC27282 + UCC24624、四变压器原边串联/次边整流并联的候选路线，暂不因未校准台架而改控制架构。

| 交付 | 审核结果 | 可使用范围 |
|---|---|---|
| v3 器件模型 | 有条件接收 | 数据手册趋势拟合；封装寄生为估计，非厂商签核模型 |
| v3 换流台架 | 代表工况独立复现 | PGD=0、23 ns、2 ns、40 A 受迫正弦工况 |
| 7 ms CT 启动 | 已有完成日志，未独立重跑长仿真 | v2 SR 开关替身下，6.5–7 ms 平均约 1.911 V / 95.56 A（20 mΩ） |
| 故障仿真 | 已独立读取原始波形 | 证明延迟触发及后续重启脉冲；不证明器件可承受 |
| Roffset 全负载结论 | 退回收窄 | 仅适用于给定受迫台架、寄生和控制模型 |
| PCB/100 A 连续/≤10 mm | 未验收 | 还缺实体磁件、损耗温升、机械与布局证据 |

## 必须修正的发现

### P1：长启动和新版换流不是同一套模型

`sim/v2/startup_ct_long.cir`、`startup_ct_fault.cir` 引用 `sr_timing_v2.lib`，SR 仍为固定 Ron 开关、理想化二极管及电容；原边驱动也是行为表达式。新版 v3 校准模型没有进入这两份整机测试。REG 由 130–150 µs 理想斜坡强制供给，尚无对应实际供电时序电路；只输出 PRE1，不能证明四组均符合上电要求。

整改：建立唯一整机候选基线，列清每个模块是官方模型、经校准行为模型还是理想替身。实际偏置/使能电路必须产生合规时序，检查四组 PRE、VD、REG 和门极。不要把“显式 CT 等效电路”称为已选型验证的真实 CT。

### P1：当前 CT 滤波没有证明允许的故障应力

CT 后有 1 kΩ/47 nF 及 10 kΩ、24 kΩ、10 nF 网络。47 µs 是首级标称 RC，后级还带额外动态延迟。源文件把桥后负载电压写成“2 V 减两只二极管压降”，这不适用于理想电流互感器的桥后负载：二极管压降主要增加次级所需端电压；实际误差应由励磁电流、磁芯和整流网络求解。

忽略励磁与整流误差的正弦稳态估算为：

`VOC ≈ Ipri_peak / 100 × 10 × (2/π) × 24/35 ≈ 0.04365 × Ipri_peak`。

所以 1 V 对应约 22.9 A 正弦峰值，而非注释中的 20 A。此式只是估算，不覆盖启动/故障瞬态。

独立原始波形复核：故障在 3.95 ms 生效；3.969717 ms 达到 73.677 A，此时 OC=0.604785 V；4.001255 ms 首次越过 1 V，延迟约 51.25 µs；越阈后直到约 4.979514 ms 仍有原边驱动高电平样点。它符合存在重启脉冲的表现，不能据输出下降宣称持续安全关断。详见 `design/review_20261031/fault_review.json`。

整改：先由 MOSFET 脉冲应力、谐振电感/磁芯饱和及铜箔能力定出允许峰值和持续时间，再选 CT、负载和滤波。不能为获得启动成功而单独加慢滤波。线性耦合电感不证明 CT 不饱和；需核对匝数、有效面积、励磁参数、复位及伏秒。

### P1：栅极模型仍阻断定量换流验收

新版器件含自身栅极电荷/电容，而 `sr_timing_v3.lib` 仍另接 6.7 nF 栅极替身。交付说明承认删除该电容会暴露异常尖峰，因此保留了它。这是待解决的驱动模型问题，不能把额外电容当作已校准器件的一部分，也不能简单删除后接受尖峰。PGD 的 2.6 V 箝位、80 V/V 斜率等仍未独立校准。

独立复跑 `design/review_20261031/comm_review.cir` 得到 IREV=2.17103 A、|QREV|=69.0633 nC、|EBD|=5.85097 µJ，与交付一致；这证明可重复性，不证明物理准确性。原 deck 的积分电流方向令 Q/E 测量为负，报告取幅值；应统一符号，避免自动判定误用。EBD 是门压窗口划分的端口能量代理，不是器件内部二极管损耗的严格分解。

整改：把门极驱动输出阻抗/限流、实际栅阻、封装寄生与器件电荷一起校准。额外 6.7 nF 必须有真实器件/外接电容依据，否则去除并修复驱动数值拓扑。先在小台架验收，再接整机。

### P1：Roffset 和待机结论超出了证据范围

`design/v2/sr_commutation_v3_results.md` §11.4 与 `task1_verification.md` §13/后续结论把受迫正弦、PGD=0 和估计寄生下的结果扩大为“固定电阻方案关闭”。实际芯片 PGD 与实际谐振换流波形尚未验证，不能据此排除 0 Ω Kelvin 基线，更不能立即转向自适应偏置复杂方案。

“最多约 7.5 ms 不关断，随后约 15 ms 极限环”同样不是已验证结论。手册 §8.3.6 描述的是 CH1 平均频率条件及待机恢复，不能据此推出所有故障状态的硬上限或固定周期；当前模型也未实现这些状态。权威本地依据：`references/datasheets/ucc24624.txt` 的 standby 章节（约 1645 行）。

整改：改写为“当前台架下存在不能关断的工况”；保留 0 Ω 默认及 Roffset 调试焊盘。用有真实能量交换的双 SR 谐振台架验证实际 di/dt，再决定是否需要偏置。频率待机只能作为工作模式分析，不用作故障应力兜底。

### P2：故障刺激标注和测量窗口错误

`startup_ct_fault.cir` 注释写“4 ms 加倍负载至 10 mΩ”，实际为 1 mΩ 开关串 1 mΩ 电阻，与 20 mΩ 并联，等效 1.818 mΩ，约 11 倍负载；PWL 在 3.95 ms 越过开关 2.5 V 门限。`IPRI_AFTER FROM 4m` 漏掉最初 50 µs 及 73.7 A 峰值。

整改：保留本案例但重命名为严重过载；另建真实 20→10 mΩ 案例。所有故障测量从实际触发时刻开始，分列峰值、首次停驱动、重启次数、累计能量和恢复状态。

另：v3 off-blank 实现是在 Q 低且 arm 成立后计时，方向符合 VD 再武装语义；其注释却说“从关断沿计时更早所以保守”，表述不对。提前结束封锁并不保守。修注释并用延后跨越 ARM 的刺激确认实现，不因注释单独判模型失败。

## 交给 DeepSeek / 下一 agent 的执行任务书

按下列顺序推进；每步只交一份简短结论、可运行源文件、测量表和必要波形。不得继续追加大段重复扫描报告，不得将数值不收敛称为物理失效。

| 顺序 | 工作与交付 | 验收门槛 |
|---|---|---|
| 1 | 修正文档越界结论、故障刺激/窗口、积分符号；生成唯一基线清单和模型版本哈希 | 参数、日志、报告逐项一致；失败/超时明确标识 |
| 2 | 校准驱动与栅极负载，解决额外 6.7 nF；补充 PGD 依据与边界；验证 ARM、BON/BOFF、双路互锁 | 可解释的 VGS、VDS、门极电流和电荷；1/2 ns 步长关键量变化目标≤2%，达不到则报告原因；延迟增大负对照能被检测 |
| 3 | 实际谐振腔双 SR 联合台架，0 Ω 基线优先；随后只做必要 Roffset 对照 | 统计反向峰值/电荷、正向整流、双路重叠电流和能量；不能只用门压重叠判断直通；阈值由器件应力/损耗预算确定 |
| 4 | 四组整机接入同版本模型；补真实偏置/使能；CT 选型和快速故障链 | 启动至稳态、四组均流/磁通、所有上电顺序；正常启动不误停，故障峰值/能量在已计算允许值内 |
| 5 | 器件、磁件和可生产原理图收敛 | 料号/引脚/封装核对；变压器匝数、气隙、Lm/漏感、损耗、绕组叠层与装配高度；谐振电感和 CT 均有实体方案 |
| 6 | 嘉立创EDA PCB、制造包与低能量样机验证 | ERC/DRC、功率/驱动回路审查、Kelvin 采样、铜损温升、装配干涉；Gerber/钻孔/BOM/贴片文件；限流上电逐级负载测波形后再评估 100 A 连续 |

整机最小矩阵：48 V 额定满载启动；轻载/空载；46/50 V 输入边界；20→10 mΩ 负载阶跃；当前严重过载及解除；辅助电源先后顺序。先跑短窗口排除时序问题，再跑到稳态；含待机的场景需足够长且模型确实实现待机，不能直接把固定 7 ms 当统一合格时长。只对敏感工况追加温度、寄生和阈值角，避免全组合爆炸。

可同时准备的低风险工作：候选器件封装核对、四个磁件及连接器的高度预算、PCB 大电流区布局草图。不能提前冻结的项目：Roffset 最优值、CT 滤波、磁芯气隙、连续电流额定值及最终铜厚/散热。

## 项目目标与放行原则

继续按 48 V 标称、24:1 固定变比、约 2 V 工作；2 V 不是全输入/全负载稳压承诺。100 A 是待验证目标，若损耗/温升不闭合，先降额首版，不靠理想仿真保留额定值。≤10 mm 需实际磁芯、PCB 嵌入和装配公差闭合，不能仅用磁芯名义高度承诺。

允许暂缓通信、遥测、复杂保护与完善 EMI 认证；保留防直通、基本过流限制、偏置时序和首次上电限流，这些直接决定首版是否能运行。完成上述关键闭环后投实验样板，不必为了完整产品化保护拖延。
