czy0126/CZY/docs/第三次独立审核与后续阶段任务书_2026-10-31.md

# 第三次独立审核与后续阶段任务书

审核对象：另一 agent 于 2026-10-31 17:25–17:48 提交的测量工具、支路能量账本、200.6 kHz 初始化工作点和第三轮汇总。此文为独立审核，长期路线承接《第二轮审核与中长期工作指南》，以下意见优先处理。

## 1. 结论与证据

**测量基础设施有实质改善；物理验收、冷启动闭环和额定设计仍未完成。可以推进控制验证小板与磁件样件准备，不应依据当前报告否定整条拓扑，也不能冻结 100 A 连续额定。**

本次执行：

- 运行 `python -m pytest tools -q`：31 项通过。
- 从工作点 RAW 重新执行支路积分：887.6196–997.2764 µs，22 周期，复现 200.626 kHz、沟道约 327.6 mW、二极管支路净能量折合约 504.7 mW、Rg 约 22.6 mW，合计约 854.9 mW/管；账本残差约 0.026%。这些均为模型计算，不是硬件实测。
- 检查实际网表初始化、测量脚本、预算定义及版本清单。未重跑长时间 LTspice 仿真。
- 独立输出：`design/review_20261031_round3/ledger_recheck.json`、`manifest_audit.json`。

已关闭：单管门状态分类错误、变步长样点平均错误、平均峰值冒充全窗峰值、单凭外部门压把全部反向电流归入二极管的旧表述。已改善：内部支路记录、模型假设披露、200.6 kHz 与软启动快照分开报告。

## 2. 必须整改的发现

### P1：所谓冷启动仍然预充 2 V

第三轮汇总 §6 把 `sim/v2/sr_tank_dual_v33.cir` 列为冷启动，实际第 155 行仍是 `.ic V(out)=2`。控制器 SS 从零不等于输出从零。新账本和 1 ms 初始化测试均不能替代空输出启动。

处理：建立独立 cold deck，输出电容初始电压为零，偏置和主输入按真实序列建立；完整记录启动峰值、四组资格/驱动状态与 OC 重启。至少覆盖控制器频率落到目标区间的过程，按稳定性决定结束时间。SS 解析充电时间只能指导仿真时长，不能证明电路能穿过启动过程。

### P1：把反向相关预算换成总 SR 预算后宣布超标

原 0.5%×200 W / 8=125 mW/管是反向相关损耗的临时预算；新报告将全部沟道、正向二极管和栅阻合计 855 mW 与它相比，宣布“超预算 6.8 倍”。没有独立批准或工程推导的总 SR 预算，这个判定不成立。正向死区损耗也不能全部重新命名为“反向相关损耗”。

处理：撤回“总损耗超原预算 6.8 倍”的验收结论，保留约 6.84 W/八管的模型估计及其局限。建立整机损耗分配，再分别讨论总 SR、二极管正向续流、恢复/换流及驱动损耗。不得为通过测试随意放宽预算，也不要用错误预算逼迫更换控制路线。

例如在 200 W 输出下，若选 95% 效率目标，允许总损耗为 `200×(1/0.95−1)=10.53 W`；93% 对应 15.05 W。两者只是候选工程目标，不是本项目已达到的效率。现有约 6.84 W 说明 SR 值得优化，但还缺原边、磁件、铜路、电容及全部偏置损耗，暂不能计算整机效率。

### P1：能量恒等式闭合不等于器件热损耗已验证

脚本将带 TT 的二极管支路 `∫v·i dt` 全部列入耗散，却没有单独记录其内部扩散储能变化。端口与全部支路之和相等，首先验证的是连接、符号和数值积分；不会自动证明每项都是热。尤其当前周期仍有明显波动，不能默认每个窗口边界的二极管内部状态相同。

反向段取绝对值可作为人为敏感性估算，但不是有证明的真实器件损耗上界。把外部反向电荷减去内部二极管反向电荷，也不能直接断言差值全是位移电荷：各支路分别取正部再积分不具备线性相减性质，必须在同一时刻、同一方向窗口做 KCL 分解。

处理：保留二极管“支路净能量”名称；先检查长窗口与边界状态，再建立模型内耗散/储能定义。真实热损耗以经验证器件模型或测量校核。`e_gate_supply` 目前在驱动输出端计算，并不是外部 12 V 电源吸收功率，应改名并另外测偏置输入功率。避免重复加算 Rg 与门极供电。

### P1：尚不能排除数值因素，也没有证明均流

“5 ns 已足够细，因此摆动不是步长问题”不成立。5 ns 与更粗且时长不同的案例不能构成严格收敛比较；当前还有约 23 ns 判决和几十 MHz 振铃。须在相同初始化、时长、窗口下比较至少两个更细设置，以及 CPIN 敏感性。只对关键窗口执行，避免全面重跑。

`steady_state_check.py` 用 pair4/pair1 的反向电荷比例称为均流。它只能说明反向换流指标相似。均流应测四组送往输出的平均电流、各绕组 RMS、器件损耗和磁通；完全对称模型也不能证明公差鲁棒性。`sr_energy_ledger.py` 虽接收 pair 参数，内部路径全部固定为 xsa1，应限制只允许 pair1，或正确支持指定支路，避免日后静默测错对象。

### P2：版本清单未跟上交付

现有 baseline manifest 的 304 项中有 5 项哈希失配：BASELINE、SR 判据、联合台报告、tank_metrics 及其测试；第三轮新增文件也未纳入旧清单。说明它是过期清单，不代表本次结果不可复算。

处理：发布一个精简的当前候选 manifest，包含本次 deck、模型、测量脚本、结果及运行元数据；旧 304 项清单归历史。不必为保持形式上的“唯一”重新运行全部旧台架。原始时间和显示偏移都入 JSON；Pout 用 `平均(Vout²/R)`，避免把 `平均(Vout)²/R` 当精确功率。

## 3. 后续长期路线与决策门槛

目标维持：48 V 标称、固定约 24:1、约 2 V、大电流、薄型；100 A 连续和≤10 mm 是待兑现目标。当前最需要的是减少不确定性并尽快进入可控实物验证，不是继续增加模型版本。

| 阶段 | 重点与交付 | 进入下一阶段的条件 |
|---|---|---|
| A：证据修正 | 修正上述口径；发布一张模型工作点表、一张未验证项表 | 冷启动、初始化工作点、仿真值、实测值不混用；预算不偷换 |
| B：电气方案冻结到实验级 | 实际偏置/使能、驱动、OC 电路；统一整机网表与逐脚原理图 | 空输出启动可运行；故障峰值与器件/磁件允许应力匹配；未验证动态有试验计划 |
| C：控制和磁件验证样件 | 双 SR 控制小板；一件变压器绕组样件；Lr/CT 候选 | 获得真实门极边沿、毛刺响应及磁件测量；能回填模型 |
| D：四组实验主板 | 原生嘉立创EDA原理图/PCB、采购BOM、完整制造包 | 回路、叠层、封装、机械及磁件连接审核通过；具有限能调试条件 |
| E：额定性能验证 | 启动、阶跃、输入边界、均流、损耗/温升、故障恢复 | 在明确冷却/环境下验证可持续电流；额定值有数据依据 |
| F：薄型与制造定版 | 高度公差闭合、散热与铜路优化、装配一致性、修订板 | 多件装配能复现性能；最终高度与连续额定同时成立 |

工作量可按 A 数日、B/C 一至两周有效设计与实验准备、D 一至两周设计加加工采购、E 一至两周调试估算；F 取决于首板暴露的问题。它们不是承诺工期，磁件加工和返板往往决定日历时间。B/C 的资料与样件准备可交错推进，不必等所有行为模型完善才开始。

### 接下来两个任务包：必须直接推动设计

**任务包 1：清理证据与关闭数值疑点。** 修正文档和 pair 参数；给真正冷启动 deck；用相同工作点/窗口比较细步长和 CPIN；记录全机输入/输出及偏置能量、四组平均电流。只交一个结果表，说明哪些量收敛、哪些仍未知。若拒绝毛刺的假设决定成败，不能继续靠修改时序模型解决。

**任务包 2：产出可制作的控制验证板。** 围绕 UCC24624，包含实际 MOS、栅阻、Kelvin 返回、去耦/偏置和检测接口；验证上电资格、双路互锁、PGD、窄脉冲关断响应。门极动态分别在规定电容负载与实际 MOS 条件测量。波形激励和电压电流必须按等效次级工况设计；单组不能直接接 48 V 冒充四组串联的等效输入。嘉立创EDA工具用于原生工程，而不是仅生成示意图。先做低能量试验，不必等待 100 A 主板。

### 磁件与高度：尽早做一次实物闭环

四件 3:1:1 变压器仍为候选，逐件给绕组方向、铜厚/层数、绝缘、气隙、端接和夹具图。用实际电压积分核磁通；用真实频率和纹波核交流铜损、磁芯损耗。Lm 与漏感的测量夹具和频率写清，外置 Lr 与折算漏感只计一次。

先装配一件，测 Lm、短路漏感、DCR、极性和高度，再做四件分散性。Lr 要测电流下的电感保持率，CT 要检查伏秒、励磁误差、带宽及复位。当前首周期大电流和故障峰值必须进入磁件规格，不能继续沿用早期理想稳态峰值。

≤10 mm 用完整装配截面验证：磁芯、绕组板、主板、胶、绝缘、夹持和公差。若不满足，允许首版实验板暂时超高并明确标记；同时完成最终薄型结构候选，避免把明显不可缩薄的结构带入定版。

### PCB与热设计：从总损耗倒推结构

先建立总损耗分配，优先处理最大项。SR 正向二极管能量偏高时，检查导通覆盖、检测参考和驱动行为，不能为了减小某一支路积分盲目延迟关断；以总损耗、峰值和故障裕量共同判断。

正式 BOM 逐项核料号/引脚/封装；Cr 核 RMS，输出电容核偏压后容量/ESR/高度，输出连接器和铜排核接触电阻与温升。100 A 下 0.1 mΩ 即 1 W，铜路损耗必须包括端子和负载接点。按厂商实际可制造层叠设计，不默认所有层都可任意加厚。

四组摆件优先缩短副边整流与输出回路，驱动与检测返回独立规划。预留可换栅阻、0 Ω Roffset、吸收网络和测点。控制保护保留到足够支持实验运行；通信、遥测、自供电和产品化保护可后置。

制造前输出原生工程、Gerber/钻孔、叠层、BOM/坐标、磁件图和装配图，完成 ERC/DRC 及实际网络核对。首板明确标“实验板”，不提前标“100 A 连续已验证”。

### 样机验收与第二版

上电前测磁件与偏置；先检查驱动，再有限能量主输入，再到 48 V；按 10/25/50/75/100 A 逐级测试。每级记录四组输出贡献、绕组/开关电流、VGS/VDS、输出电压、输入和两路偏置功率，以及 MOS/磁芯/电容/端子温度。

探头地参考、带宽和通道时差记录在测试表；低压大电流采用 Kelvin 电压测量。效率计入外供偏置，器件温度稳定后才评连续能力。若首板只能可靠做到 50–75 A，发布该已验证额定和限制项，再据瓶颈修改；不以短时冲到 100 A 代替热验证。

第二版按首板证据排序：最热/最高损耗位置 → 均流和启动鲁棒性 → 高度/装配 → 面积与成本。只有物理证据表明本路线无法达到目标才改拓扑，不因为未校准模型的某一“失败”重新开大项目。

## 4. 后续 agent 的执行约束

每包工作只回答一个可决定下一步的问题，附源文件、单位/符号、测量窗口、模型版本和失败条件。当前不需要再次通读旧项目，也不需要重建一套庞大框架。

下一次审核优先看：真正冷启动结果、相同步长对照、实际输出均流、总损耗预算、控制验证板原生文件及磁件加工图。继续增长的仿真报告页数不计为完成度。保留当前候选/失败对照/历史三层，发布一个可复现的当前清单即可。
