czy0126/CZY/docs/第二轮审核与中长期工作指南_2026-10-31.md

# 第二轮交付审核与中长期工作指南

审核对象：2026-10-31 12:00–14:26 的新增交付，特别是 `design/baseline/BASELINE.md`、`sr_timing_v3_3.lib`、`sr_tank_dual_v33.cir`、`tank_metrics.py` 及 SR 验收判据。此文补充上午审核，不替换原始证据。结论：**工程进展可接收，换流验收“通过”暂不接收；进入实验设计与器件落实阶段，仍不能直接冻结 100 A 产品板。**

## 一、本轮独立审核结果

核对 baseline manifest 中 304 个文件，哈希全部一致；运行现有测量工具测试，15 项通过；独立读取联合台原始 RAW，重算最后 8 周期及相邻时间窗。没有重复运行约 100 秒的整机仿真，也没有实测硬件。复核脚本和 JSON 位于 `design/review_20261031_round2/`。

### 已有实质进展

- 原有积分符号、故障窗口与错误注释已作整改，模型类别和超时状态进入清单。
- 新器件台去掉重复 6.7 nF 栅荷，改为器件自带电容；100 pF 仍是数值正则化，需要敏感性检查。
- 新 SR 器件与时序进入四组谐振腔；A/B 比较找到了模型对漏极振铃的高度敏感性，优于继续扫描受迫正弦台。
- 0 Ω Roffset 重新作为候选基线，不再以旧台架结果排除整条方案。
- 缩短 CT 滤波已改善故障延迟，但仍有约 65 A 等峰值，尚缺器件与磁件应力许可依据。

### P1：单管能量分类用了另一只管的门极

`tools/tank_metrics.py` 的 `pair_metrics()` 中，`on = ga_on | gb_on`，却将其用于 A 管的 `VDS_A × I_A`。B 管开通、A 管关断时，A 管端口能量被归入“沟道”。应使用 A 管自己的状态分类，B 管单独处理；这仍只是门状态分类，不能替代内部支路损耗。

独立重算最后 8 周期，A 管结果：

| 分类 | 原脚本 | 仅按 A 管门压分类 |
|---|---:|---:|
| 关断状态端口能量 | 1.28933 µJ/周期 | 1.26757 µJ/周期 |
| 开通状态端口能量 | 1.04479 µJ/周期 | 1.06654 µJ/周期 |

本例差异不大，但算法错误已确认，现有单元测试未覆盖。新增“B 开 A 关”的反例后修复。输出电压平均也应按时间积分，不能对变步长 RAW 直接算样点平均。

### P1：把关断后反向端口电荷当成二极管导通热损耗

`SR反向电流验收判据_初稿.md` §6 用“门压低于 2 V”推出反向电流全部走体二极管，并称 `0.78 × Qrev × fs` 为实际损耗。此推理不成立。当前 SR_DEVICE 含 Cds、Cgd、带 TT 的二极管及封装电感；端口反向电流可包含电容充放电、恢复电流和沟道分量，不能仅靠外部 VGS 门限分解。二极管的正向导通压降也不能直接乘反向端口电荷得到恢复损耗。

应撤回“0.563 µC 是物理损耗上限、当前已通过 56%”及“反向电流全部走二极管”的确定性表述。Qrev 保留作比较指标。直接保存内部二极管、沟道、Cds/Cgd 支路电流及内部 VGS/VDS，完成能量账本；区分可回收储能和耗散，包含门极供电并避免重复相加。非稳态窗口要计入储能变化，不能将端口净输入直接叫热损耗。

官方依据：[Infineon 同步整流 MOSFET 选型应用笔记](https://www.infineon.com/dgdl/Infineon-MOSFET_OptiMOS_device_selection_for_synchronous_rectification-ApplicationNotes-v01_00-EN.pdf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)将关断换流电荷中的输出电容和反向恢复贡献区分处理。它支持必须分解的原则，不为本项目提供现成损耗值。

### P1：v3.3 是待验证的滤波假设，不能因结果改善而认定为芯片修复

`models/sr_timing_v3_3.lib:126` 要求 VDS 连续超过门限约 TOFF 才关断，相当于加入约 23 ns 的脉冲拒绝。上一版则对一次越阈保持关断请求。v3.3 与 v2 一致只能说明两者采用相近语义，不能证明哪一版更接近硅片。

[TI UCC24624 数据手册](https://www.ti.com/lit/ds/symlink/ucc24624.pdf)给出的关断传播延迟不等同于保证存在同宽度的抗毛刺滤波。要将这项假设单列，查官方模型/应用支持或用控制小板注入窄脉冲验证。未知期间保留两种边界模型；若只有拒绝毛刺版本能正常工作，应处理实际检测寄生/振铃，不能只更换模型判为通过。

### P1：500 µs、284.4 kHz 的预充电窗口不是额定稳态验证

主台使用 `.ic V(out)=2`，停在 500 µs；当前频率约 284.4 kHz，距设计约 200.6 kHz 稳态频率明显不同。输出约 1.664 V、138.5 W，属于这一短窗口的工作点。独立时间平均为：400–450 µs 1.66081 V；450–475 µs 1.66338 V；475–500 µs 1.66535 V。尚有演变，不能凭输出看起来平缓宣称完成软启动或全机稳态。

需要分别保留冷启动测试与稳态初始化测试。后者必须把振荡器/SS、输出电容、谐振状态置于一致工作点，并检查多个窗口的频率、平均电压、储能和均流收敛。前者必须从空输出启动。把 RL 改为 12.6 mΩ 也不能保证恰好 200 W，应按实际 Vout²/R 复算。

### P2：平均峰值和任意比例护栏不能代替最坏应力

报告 5.135 A 是 8 个周期峰值的平均。独立复核这 8 周期最大为 5.18856 A；更宽 450–500 µs 日志最大为 5.41201 A。用于额定/应力判断必须取所声明窗口内最大值，同时提供平均和分布。

“50 A 的 25%=12.5 A”是临时设计护栏，不是 SOA 推导；每管工作电流也需从四组分流、半周期占空与波形 RMS 推出。结合 VDS、脉宽、重复率、结温、封装电流和瞬态热阻判断，不能只与数据手册首页电流比较。

### P2：驱动边沿仍缺一致测试口径

手册已给出 12 V、6.8 nF、10–90% / 90–10% 的边沿条件，不宜继续把这几个条件列作“尚未取得”。但芯片内部动态驱动不能自动等价于固定电阻加硬限流；外部 2.2 Ω 也不能混进芯片本体测试。23/35 ns 是典型值，不能称上界；不能在没有单调性证明时把模型损耗称严格下界。

## 二、项目中长期路线：围绕可测硬件收敛

保持 48 V 标称、24:1 固定变比、约 2 V 输出路线；100 A 连续和≤10 mm 都是验证目标。先获得可工作的实验样板，再逐步兑现连续电流与薄型指标。外部偏置继续允许，不在当前阶段增加自供电复杂度。

时间以下为投入估算，不是交付承诺；采购、磁件加工和返板可能主导日历周期。按阶段出口决定是否推进，不按文档数量决定完成度。

| 阶段 | 预计有效工作量 | 主要交付 | 出口条件 |
|---|---|---|---|
| A：修正验证口径 | 1–3 个工作日 | 一个测量脚本、一张更新的结果表、明确模型假设 | 本轮 P1 算法/物理表述修正；不再用错误 PASS 支撑设计 |
| B：控制与功率级收敛 | 3–7 个工作日 | 真实偏置/使能/驱动原理图、统一整机候选模型、最小工况矩阵 | 冷启动及稳态分开通过；故障应力有器件依据；未知动态行为有试验方案 |
| C：磁件及机械样件 | 与 B 交错，3–7 日设计加加工周期 | 一套变压器样件、Lr、CT 规格与实测表、1:1 截面 | Lm/漏感/铜阻/气隙/极性/高度可制造，参数回填模型 |
| D：实验样板设计与制造 | 约 1–2 周设计，加生产采购 | 原生原理图/PCB、BOM、制造文件、上电检查表 | 电气/封装/回路/机械审核完成，未解决项不影响限能实验 |
| E：样机调试与模型回标 | 约 1–2 周，视返工而定 | 关键波形、损耗/温升/均流数据、问题清单 | 从低能量到目标输入、逐级负载稳定运行；模型误差可解释 |
| F：薄型高电流修订版 | 按首板结果安排，通常需一次迭代 | 机械定版、热设计、额定值、可重复装配资料 | 目标工况持续热稳定、器件裕量成立、制造重复性验证 |

### A/B：仿真只保留能改变决策的工作

1. 修复单管分类、最大值与时间平均；新增反例测试。原始端口量与内部支路量分开命名，禁止用 EBD/ECH 掩盖代理测量。
2. 以一个整机候选版本为主，缺陷版本只作历史。PGD、关断短脉冲响应、100 pF 正则化分别标出未知项；不重新批跑全部历史 304 文件。
3. 先做控制器本体驱动台，外接电阻单列。补 ARM、互锁、欠压、两路偏置顺序及真实 REG 建立过程。每次只改一个可解释因素。
4. 保留最小矩阵：48 V 冷启动/额定；轻载/空载；46/50 V 边界；20→10 mΩ 阶跃；严重过载及解除；偏置先后顺序。对最敏感场景追加参数角，不做笛卡尔全扫描。
5. 保护只做到首板必要程度：防直通、有限故障能量、明确停止/恢复路径。先评估首周期激励/谐振状态能否降低 36 A 启动峰，再确定 CT 检测和允许峰值；不靠加慢滤波掩盖问题。
6. 未知芯片动态若经过一次官方资料核对和一次边界仿真仍不能决定，就转控制验证小板。继续自建复杂“精确芯片模型”不是默认路线。

### C：磁件、铜损与高度必须成为实物任务

- 四个 3:1:1 变压器分别给绕组方向、端点、铜箔/PCB 叠层、绝缘、气隙、夹具和装配图。每件 Lm≈10 µH、合成 Lr≈1 µH 只是当前候选测量目标，须核对漏感折算与外置电感，避免重复计算。
- 用实际绕组电压积分核磁通，包含启动不对称和故障伏秒；不能用谐振总电流直接判励磁饱和。铜损要含交流集肤/邻近效应，磁损按材料、频率、磁通与温度评估。
- 先加工/装配一只样件，测开路 Lm、短路漏感、DCR、频率依赖和极性，再复制四件测分散性。完全对称仿真中 pair1=pair4 不证明实物均流。
- Lr 和 CT 分开出实体规格；CT 需负载、整流压降所需端电压、磁通复位及带宽。Lr 需实际峰值下电感保持率及温升。
- ELP32+I 候选裸磁芯高度已接近 10 mm；必须画完整公差截面，包含绕组、板材、胶、绝缘和夹具。若超高，优先比较嵌板/装配方式与一款更薄磁芯，不同时维护多条磁件路线。
- 同步落实 Cr RMS 电流、输出电容有效容量/ESR/高度和连接器。4 mF 理想电容不能直接变成采购 BOM。

### D：首板以可调试为目标，同时约束最终高度

完整四组板前，必要时制作一块可限能测试的双 SR 控制/功率试验板，回答驱动、关断短脉冲及采样寄生问题。试验板参数按实际等效激励设计，不能把单组直接接 48 V 当作原四组运行条件。

嘉立创EDA 主工程只维护一份原生原理图和一份 PCB。逐脚核对 UCC25600、UCC27282、UCC24624 和 MOS 封装；外供电域、地参考和使能路径必须画清。BOM 有厂家完整料号、数量、封装、额定、官方依据及采购替代规则，采购时重新核库存。

布局先摆磁件、SR、本地电容及输出铜排，再布半桥高 di/dt 回路、驱动和 Kelvin 采样。额定 100 A 不以大面积覆铜作为证明；按实际叠层、过孔、端子、铜带/铜排计算压降和温升。比如总路径 0.1 mΩ 在 100 A 下就是 1 W，连接点必须进入预算。

保留 0 Ω Roffset 及调试位、可换栅阻、阻容吸收焊盘、四组电流/磁芯温度测点。对没有独立 Kelvin 引脚的器件，PCB Kelvin 只能改善外部共源阻抗，不能假定内部封装电感消失。

制造包包含原生文件、版本、叠层、Gerber、钻孔、BOM、贴片坐标、磁件加工图和装配图。完成 ERC/DRC、网络一致性和 1:1 机械检查；任何豁免写明原因。可以投实验板，不把它标为已通过 100 A 连续验收。

### E/F：用测量决定额定值，再做薄型优化

上电顺序：磁件/焊接检查 → 仅偏置测频率和死区 → 有限能量主输入 → 到 48 V 核对换流 → 10/25/50/75/100 A 逐级加载。低输入电压只作为受控调试，不假定它必然比额定输入安全；每级检查工作模式和电流。

每级记录：两路 SR 内外可测门源/漏源电压、原边 SW/自举/谐振电流、四组电流、负载端 Kelvin 电压、主输入与所有偏置功率、磁件/MOS/电容/端子温度。差分探测、探头带宽和时序偏差要记录，避免用测量回路制造的振铃改坏电路。

额定功率验收采用实际环境温度、冷却方式和热稳定条件。建议先把“关键温度在连续 10 分钟内变化≤1 ℃”作为可调整的热稳定观察条件，同时监测是否出现持续漂移；达到稳定后仍需结温估计和规格裕量。效率计入外部偏置，输出功率在负载端测量。

若首板只能可靠运行 50–75 A，明确给出已验证额定及瓶颈，再改铜损、磁件或冷却；不要用短时 100 A 波形替代连续额定。薄型修订优先消除最高损耗和局部热点，随后再压缩面积。只有实际参数表明当前拓扑无法满足目标时才重新选拓扑。

## 三、后续 agent 的工作方式与交接

当前下一包任务限定为：修正 `tank_metrics.py` 和验收判据；补内部支路能量记录；给出冷启动与约 200.6 kHz 工作点的统一验证方案；把 v3.3 毛刺拒绝列为未验证假设。交付一个汇总表和对应源文件，不再新增多份相互覆盖的“最终结果”。

此后每个任务包包含：输入基线、一个待回答的工程问题、允许修改的文件、测量定义、验收门槛、失败时的下一动作。DeepSeek 负责可边界化的计算/网表/引脚整理；审核者核对官方依据和实测结果。没有模型依据时明确未知，不要求它编造精确参数。

模型与证据最多保留三层：当前候选、失败对照、历史归档。一个机器可读结果表记录工况、窗口、模型版本、结果与局限；文档引用该表，停止反复追加几十页历史。设计路线主线始终是：**控制可运行 → 磁件可制造 → 首板可测 → 额定可证明 → 薄型可重复生产。**
