czy0126/CZY/docs/续接任务书_真实控制与SR.md

# 可直接续接的任务书：完成真实控制与SR换流验证
2026-10-31。用户授权继续设计，目标48V→约2V固定变比24:1，100A连续目标，薄型、可外供控制。无需再次询问是否开始。本文件保存当前状态，不表示用户额度已经耗尽。

## 进度快照（2026-10-31 更新）
任务1的阻塞项“把 SR_DEVICE 接进换流台”已完成：`sim/v2/comm_v3/sr_commutation_v3.cir` 用 `Xsr1/Xsr2 ... SR_DEVICE`、删除外部 Cda，重出 1ns/2ns、PGD 开/关、200 ns 负对照，并新增 Qrev/Qg/门耗/体二极管/沟道能量测量；对照台 `sr_commutation_v3_ideal.cir` 用同 v3 时序、同激励。结果见 `design/v2/sr_commutation_v3_results.md`。要点：器件把反向峰值 9.819→2.171 A、Qrev 977.3→69.06 nC，但体二极管能量 1.743→5.851 µJ（封装电感使 OFFTH 在 29.7 A 提前触发，gate<1 V 尾 5.01 µJ/首次导通 5.59 µJ，多出 0.98–1.10 W/SR）；1ns/2ns 差 ≤1.44%；200 ns 方向取决于触发相位。Roffset（VSS 330 µA）已用行为等效补上并实跑：`models/sr_timing_v3_roff.lib` + `sim/v2/comm_v3/sr_commutation_v3_roff.cir`，门槛 43.50/50.10/60.00/80.46 mV 与 `10.5 mV+330 µA×R` 逐位一致；PGD=0 时 **120 Ω 最优**（总 3.712 µJ、EBD 0.820、QREV 48.6 nC、关断尾 0），100 Ω 次之，150 Ω 反弹（QREV 1.20 µC），212 Ω 不关断（IREV 40 A、QREV 63.7 µC）；100–120 Ω 只是 40 A 台架最优，不是手册上限 212 Ω。随后的 10/25/40 A 负载扫描（单案例台，TMAX=10n）显示固定门槛在轻载失效：10 A/25 A 的 VDS 峰值只有 16.47/41.17 mV，低于 43.5/50.1 mV，SR 整周期不关断、QREV 15.9/39.8 µC；只有 40 A 正常关断（120 Ω：EBD 0.824 µJ、总 3.717 µJ；100 Ω：1.022/4.027 µJ）。**本台架内固定 Roffset 不能覆盖 10–40 A，120 Ω 不能作为四组冻结的单一值；这不关闭 0 Ω Kelvin 基线。** 低门槛扫描（0/15/25/50/75/85 Ω，§10）已完成：**最优值 10 A→0 Ω、25 A→50 Ω、40 A→120 Ω**；0 Ω（=无偏置基线）全负载可关断但 40 A 一致口径 9.521 µJ，相对 2 ns 基线 9.362 多 1.7%（步长效应），无收益；15 Ω 也全负载触发但 10 A 已坏 11 倍。数据手册确认无每通道最大导通时间/看门狗（`tONMIN=475 ns` 是最小开通消隐），但有 CH1 频率待机判据（<9 kHz 持续 7.5 ms 进 standby、停门极；>15.6 kHz 持续 7.5 ms 恢复），模型未实现。**§11 规格容差角已完成（12 个实跑角 + 1 个解析角）：VDS 峰值对负载严格线性 1.647 mV/A；40 A/120 Ω 在 18 mV+400 µA 角（66.0 mV > 65.87 mV 峰值）完全不关断、QREV 63.66 µC；25 A/50 Ω 在 18 mV+400 µA 角恶化 15 倍；0 Ω 在 10 A/18 mV 角也救不了——没有任何固定 Roffset 能覆盖全规格散布的 10–40 A。** **决策变量是 `L·di/dt`；本机 LLC 的 di/dt≈2πf·I 随负载变化。** 仍未完成：双 SR 换流台与按真实 Lr/频率算 di/dt、真实 VSS 引脚阻抗、PGD 律校准、自适应 155/275 ns、ARM/OFFTH 窗口、Kelvin 双实例、温度/SOA；5.0 µJ 是慢驱动器+gate<1 V 口径的下界。**任务2已开始并有第一份交付**：真实 CT 替换瞬时代理后，7 ms 冷启动跑通（Vout 1.911 V，OC 0.556 V 未跳），1 mΩ 短路能被 OC 正确切除（51.3 µs、峰 73.68 A、I²t 105.2 mA²s），并定位到“真正决定延迟的是 OC 脚 10k×10n=100 µs”这一缺陷（降 Coc 到 1n → 13 µs / 12.2 mA²s，代价是启动裕量 1.80→1.37×）。**未解**：73.7 A 对 Lr 13 A 设计峰值的 5.7×——SOA 已按 CSD19531Q5A 图10 核对（48 V/10 µs 边界 79.3 A；峰值在 VDS≈0.5 V，窗内沟道能量 0.65 mJ、ΔTJ≤13 °C、仅 IDM 的 22%），MOSFET 非约束；Lr/变压器饱和仍未核（模型线性），但需求已量化为启动 ≥36 A、故障 ≥65–74 A（§14）。真实 UCC27282 已用本地验证行为模型替换自举替身（进展文档 §13）：台架 A 证明 Cboot=0 时 HB UVLO 挡住 HO、首个 HO 7.682 µs 晚于 LO 5.179 µs；台架 B 钳位 HB 后 HO→0、低边刷新后恢复 11.10 V；整机 0–0.2/1.5/7 ms 三段重跑，与行为版差 ≤0.93%（7 ms Vout 均值 1.91101 V、OC 0.55608 V 未跳、SR 反向 12.332 A），80 µs 后 Vboot≥11.08 V。模型非厂商模型，未含延迟匹配/最小脉宽/反向恢复/温度。0–0.2 ms 分段台与停机/再启动轨迹已完成。任务3、4 未开始。数值完成 ≠ 硬件验证。

## 先读这三项
1. design/v2/真实控制与SR验证进展.md：哪些实跑、哪些缺项。
2. design/v2/sr_commutation_v3_results.md：任务1四组数字、机理闭环与限制。
3. models/sr_device_v3.lib、models/sr_timing_v3.lib、sim/v2/integrated_oc_proxy.cir：代码起点。
旧v1功率级和九场数据仍有效于它自身的理想SR模型，不得和v2结果拼成整机通过。v2 理想台的 9.790A/0.978uC/18.085A/0.465% 不得与 v3 器件结果混拼。勿通读circuit_net全部历史。

## 当前不能放过的两个问题
- 启动：**已跑通**。把瞬时 `abs(I(Lr))` 代理换成真实 CT（1:100、桥式整流、10 Ω、1k/47n、10k/24k+Coc）后，7 ms 冷启动 73 s 完成：Vout 6.5–7 ms 均值 **1.911 V**（峰 1.926 V），OC 最大 0.556 V 未触发，原边峰 36.07 A（浪涌），SR 已起（门极 8.36 V、反向 12.33 A）。旧“0.326 V 停滞”是代理 14.7 A 瞬时门槛在浪涌上反复触发，不是启动本身的问题。OC 已证明动作：3.95 ms 投入 1 mΩ 短路，4.0013 ms 触发（51.3 µs），峰值 73.68 A、I²t 105.2 mA²s（0.65 mJ@6.2 mΩ），V(oc) 1.18 V→打嗝不闩锁。**未解**：73.7 A 超 Lr 设计峰值 13 A 的 5.7 倍——SOA 已核（48 V/10 µs 边界 79.3 A，峰值在 VDS≈0.5 V，0.65 mJ、ΔTJ≤13 °C、仅 IDM 的 22%），MOSFET 非约束；Lr/变压器饱和未核（需求见 §14：启动 ≥36 A、故障 ≥65–74 A）；延迟主因是 OC 脚 10k×10n=100 µs 而非 CT 滤波（Cf 10n→30.2 µs，再 Coc 1n→13.0 µs、I²t 12.2 mA²s，但启动裕量 1.80→1.37×）；OC 比较器四角（Level-1 0.9/1.1 V × Td_OC 60/500 ns）已跑：峰值 73.2 A 不变，I²t 89.2–120.4 mA²s，OC 峰≤1.28 V < 1.8 V 闩锁门槛（打嗝不闩锁）；延迟在这两处相位被关断间隔吸收，结论相位相关。手册 Level-1 为 0.9/1.0/1.1 V，0.6 V 是恢复、2.0 V 是闩锁（旧文档误读已改）。原边驱动已换本地验证 UCC27282 行为模型（`models/ucc27282_behaviour.lib`）：台架 A 证明 Cboot=0 时 HB UVLO 挡 HO、首个 HO 7.682 µs 晚于 LO 5.179 µs；台架 B 钳位 HB 后 HO→0、低边刷新后恢复 11.10 V；整机三段重跑与行为版差 ≤0.93%（7 ms Vout 1.91101 V、OC 0.55608 V、SR 反向 12.332 A），80 µs 后 Vboot 11.08–11.41 V；交付图 `design/v2/task2_ct_evidence.png` 已由 `tools/task2_evidence.py` 从驱动版实跑 RAW 重出（a 栏：任何门极脉冲前 Cboot 已充到 11 V，首个 GD2 70.773 µs、GD1 72.491 µs；b/c 栏用 `startup_ct_drv_long`/`startup_ct_fault_drv`），重启图 `task2_restart_evidence.png` 也已切到驱动版（`startup_ct_restart_drv.cir`，101.0 s；撤电期 |HO−HS|≤4.1e−5 V、Cboot 10.31 V；6.1 ms 恢复后首个 LO 6151.166 µs、HO 6152.466 µs；8.5–9 ms 均值 1.84325 V vs 行为 1.85053 V，−0.39%；浪涌 14.0386 A、OC 0.537 V 未跳；最大差异 SR 门极峰 −2.72%）。12.06 V 的最大差分来自 HS 负冲（真实物理），约束是 HB−HS 16 V；模型未对硅片校准。驱动版故障台（`sim/v2/startup_ct_fault_drv.cir`）复现同一路径：OC 触发 4.00131 ms、IPRI 峰 73.18 A、OC 峰 1.183 V，OC 脚到低边门极关断 98 ns（行为版 77 ns，差 +21 ns 来自 TPD 16 ns 与 4 Ω 压摆），打嗝/不闩锁不变，两版门极重叠 ≤0.05 V。启动浪涌单参数实验（§14）：Css 10n→50n 只把首个 GD2 从 70.8 移到 344.8 µs，峰值 36.0046→36.0095 A（+0.014%），前 8 周期峰值一致到 0.163%；36 A 是 SS=1.2 V/291 kHz 第一周期谐振腔阶跃响应，SS 斜率动不了（只把第二个 22.6 A 浪涌压到 6.8 A，代价是 1.5 ms 输出 1.15 V、SR 未起）。Lr Isat 需求据此量化为启动 ≥36 A、故障 ≥65–74 A（随检测 13–51 µs），不是 13 A；选型仍缺磁芯/材料证据。关断/再启动已验：4.5 ms 撤母线+辅助电源，输出降到 0，6.1 ms 恢复后 14.05 A 浪涌、无 OC 跳、8.5–9 ms 回到 1.851 V（驱动版 14.04 A、1.843 V）；0–0.2/0–1.5/0–7 ms 三段逐位一致（驱动版三段 IPRI 逐位 36.0046157837 A；行为版 36.0671844482 A）。
- SR：独立换流台显示关断延迟会导致反向沟道电流。Roffset 已跑完 0–212 Ω 与 10/25/40 A 负载扫描：120 Ω 只在 40 A 最优（总 3.712 µJ、EBD 0.820、QREV 48.6 nC、尾 0），**10/25 A 同一门槛完全不关断**（VDS 峰值 16.47/41.17 mV，QREV 15.9/39.8 µC），212 Ω/PGD=0 在 40 A 也不关断，150 Ω 反弹。**在本受迫正弦台 + 估计寄生 + 未校准 PGD 下固定 Roffset 不足**；0/15/25/50/75/85 Ω 的低门槛扫描（`sr_commutation_v3_results.md` §10）已完成：**最优值 10 A→0 Ω、25 A→50 Ω、40 A→120 Ω**，0 Ω（=无偏置基线）全负载可关断但 40 A 一致口径 9.521 µJ（相对 2 ns 基线 9.362 多 1.7%，步长效应），无收益；15 Ω 也全负载触发但 10 A 已坏 11 倍。§11 容差角：40 A/120 Ω 在 18 mV+400 µA 角完全不关断（QREV 63.66 µC），25 A/50 Ω 在 18 mV+400 µA 角恶化 15 倍，0 Ω 在 10 A/18 mV 角也救不了——**本台架内没有任何固定 Roffset 能覆盖全规格散布**。这**不构成“固定电阻方案关闭”**：0 Ω Kelvin 基线仍为默认候选、Roffset 保留调试焊盘。数据手册确认无每通道最大导通时间/看门狗，但有 CH1 频率待机判据（<9 kHz/7.5 ms 进 standby），模型未实现；`VTHOFF` 2–18 mV 与 330 µA 260–400 µA 已做角分析。决策变量是 `L·di/dt`；本机 LLC 的 di/dt≈2πf·I 随负载变化，固定门槛只在单一负载成立。下一步是双 SR 换流台、按真实 Lr/频率算 di/dt、真实 VSS 引脚，不是继续调单个电阻。未校准 PGD 不能证明真实器件表现。

## 任务1：先把SR替身变成可用于决策的器件模型（主体已完成，校准项待做）
输入：UCC24624官方手册；旧项目D:/workshop/circuit_net/data/g1-r57-sr-2026-10-22/ucc24624_simplis.zip可作为厂商SIMPLIS参照，不能直接include为LTspice库；已下载BSC010N04LS6手册。
工作：优先找官方可用MOS SPICE模型；没有则从手册静态曲线、Qg/Miller、Coss/Qoss、体二极管/Qrr/温度建立明确可追溯替身。在单管测试台核对正向/第三象限I-V、门荷和关断；用分段非线性跨导替换固定Ron开关，真实PGD必须靠VDS反馈使沟道电阻变化。区分内部1.5A/4A限流、6.5Ω/.9Ω源灌阻和外部2.2Ω。封装及Kelvin路径加入可追溯的寄生范围。
实现155/275ns自适应延迟、475/650ns blanking、1.4~1.7V再武装、2~18mV关断门槛和实际比例门驱；明确厂商模型/自建模型界面。既有CH1同时请求优先仅为数值仲裁，不冒充芯片规范。
交付：models/sr_device_v3.lib、校准数据/曲线、与v2单管台同激励对照。不允许仅把反向电流限幅为0使结果好看。
验收：短脉冲被过滤、blanking内保持、两通道不同时充分增强、关断延迟负对照增大反灌。比较1ns/2ns及数值时间常数改变后的指标。给反向峰值、电荷/周期、VDS/VGS、门耗和体二极管导通能量。阈值由SOA/可接受损耗推导，不能随意定“<1A即通过”。

## 任务2：在最小功率闭合上先解决启动
保留48V预先存在、真实CSS10n、RT976Ω/DT5.36k。首先改用一个等效变压器和一个整流单元验证控制，不要一开始四套同时调模型。等效必须保持12:1、原边总Lm和折算负载，写清功率/电流缩放，不能把一组25A当全部100A。
核对约291kHz启动和200.6kHz稳态；按RT基准/振荡器/SS容差与burst最低300k门槛比较。CSS改变斜率不解决起始频率幅值，调RT会改变稳态谐振工作点，必须共同复算。引入真实UCC27282或经过局部验证的自举/延迟模型，证明GD2先起能充自举。
OC由真实电流互感器（独立于中心抽头功率变压器）、整流桥、负载、RC和UCC25600关断路径实现。逐项给传递比、阈值误差、伏秒、复位、总延迟与最坏脉冲能量。不能拿瞬时abs(I)代理结果签核。
逐段跑0~0.2ms、0~1.5ms、0~7ms定位事件；只有有物理依据的初值/测量初态才可跨窗口续跑。保留关断/再次启动轨迹。不得用输出预充到2V冒充冷启动通过。
交付：可完成至少一次完整软启动至稳定运行的.cir/.log/.raw、启动前10个周期放大图、OC与SS/两桥臂同步波形；失败则给具体触发事件和ECO，不再无界增加报告。

## 任务3：落实副边偏置顺序
VD是SR漏极检测电压，不是原边12V！用真实REG2.2uF、厂家内部启动电流/限流和外供12V的上电过程，观察每组VD先超过最坏1.7V，再REG过其启动阈值。不能假定20us线性REG斜坡可以硬件实现。
优先看现有自然充电是否满足；不满足时增加最小偏置开关/受控使能，让体二极管受限导通先建立漏极脉冲，再放行SR偏置。首样可用受控人工步骤和示波器观测，不必立即做庞大资格链，但最终原理图必须描述实现和停止顺序。四组逐一核对，含输入先有、偏置先有、副边晚起/掉电/恢复。反序只标“不满足手册保证条件”，不能断言真实硅片必定锁死。
交付：偏置ECO原理图与BOM、REG/VD/VGS同屏波形、允许上电顺序。验收须证明在容差与额定负载条件下能顺利过渡到SR。

## 任务4：恢复四组并冻结电气方案
任务1~3稳定后恢复四磁件/四SR控制器、实际MOS和寄生。用46/48/50V与约10/50/100A验证稳态；启动、卸载、停机、预偏置、副边偏置丢失各一次必要边界。测四路均流、磁通偏移、VDS/VGS应力、反灌电荷和损耗。所有效率计入外供偏置。
交付嘉立创原生原理图、统一BOM/pad-net、磁件参数和测试点，再进入PCB布局。磁芯裸高最大9.8mm/10mm目标仍是机械问题，不能被电气通过掩盖。

## 直接执行命令（PowerShell，项目根目录）
```powershell
powershell -NoProfile -ExecutionPolicy Bypass -File .agents/skills/ltspice-skill/scripts/run_ltspice.ps1 -LtspicePath D:\ADI\LTspice\LTspice.exe -InputFile sim/v2/sr_commutation_sweep.cir -TimeoutSeconds 60
python tools/summarize_v2.py
```
LTspice返回码为0还需看.log测量是否存在。所有长运行用有界timeout，不残留后台进程。7ms台之前超时/步长失败不能当PASS；当前新版模型修订后需要重新验证长窗。
DeepSeek可用tools/deepseek_run.py，采用默认非thinking模式，单题只给对应手册摘录和当前模型，回复最多1800~3000 tokens。此前thinking两次只消耗推理预算无正文；不重演。所有回复需finish_reason=stop且正文非空。凭据从旧路径读取，不复制到本项目。

## 完成定义
只有真实器件或已校准替身下的完整启动、SR换流、停止和必要边界都有可重现证据，并且器件应力/损耗在允许范围，才可称“控制与SR验证完成”。目前未达到。没有新增物理证据就不要继续扩大保护/日志体系；每轮交电路、模型、波形或制造资料。
