czy0126/CZY/docs/资源索引.md

# 资源索引
- 桌面原始论文：C:/Users/27792/Desktop/48v；本地五篇分页文本：references/paper_text。
- ROHM原始LTspice：本项目c-012_dc-dc_llc_buck_converter_vo=12v_io=250a_ltspice。
- 旧功率图：references/legacy/deliverables/r159_power_stage_200k；参数：references/legacy/deliverables/r159_arm_por/params.csv。
- 旧磁件目录：references/legacy/data/g1-r69-magnetics-2026-10-24/magnetics_2025.pdf。
- 旧制造材料依据：references/legacy/data/g1-r97-manufacturing-2026-10-27/MANUFACTURING_BASIS.md。
- 旧官方器件资料按需读取：D:/workshop/circuit_net/data/g1-r56-llc-2026-10-21、g1-r57-sr-2026-10-22、g1-r66-sr-2026-10-24、g1-r68-driver-2026-10-24、g1-r69-magnetics-2026-10-24。此处是资源位置，不代表器件已选定。
- 项目技能：.agents/skills/matlab-read-documentation；源为旧项目同路径，许可证一并保留，后续回合由技能发现机制加载。
- DeepSeek执行器：tools/deepseek_run.py，沿用旧项目的API调用方法，凭据只从旧位置读取，不复制或打印；只发送任务和显式指定的论文文本。API使用费用按账户计。
- 未迁入历史日志、保护框架、旧AGENTS、凭据及批量仿真产物。
