czy0126/CZY/docs/D1_EXECUTION_KIT/33_D0原生保护验证板复核与停工准则.md

# 33 · D0 保护验证板：实体脚号与模拟安全限制（2026-11-05）

**对象**：`tools/make_d0_protection_board.py` 自动生成的 `pcb/d0_protection/` KiCad 原理图、网表、BOM 与逻辑测试；同时复核 D1 主功率板下一步方案。

**当前决策：不能投保护板，也不能投主功率板。** 原因不是 KiCad ERC，而是独立电气/模拟证据不足。新增的静态审计与修复**不产生真实 PCB 和保护等级认证**。仓库未提交 `pcb/d0_protection/*.kicad_pcb`，只有可编辑原理图、BOM 和导出网表，不能叫“保护样板已完成制造”。

## 1. 已直接修复：U2（TL431LP）实际封装

新 D0 生成器中 U2 原为 `Reference_Voltage:TL431LP`、`value=TL431LP`，但**实例封装被指定 `Package_TO_SOT_SMD:SOT-23`**。这与 TI TL431 **LP = TO-92** 的实物封装不一致；TI TL431 **DBZ = SOT-23-3** 才使用 SOT-23，而且引脚顺序不同。

已把**生成器**、原生 `.kicad_sch` 中的 U2 实例、`BOM.csv` 和导出 `.net` 中的 U2 改为 `Package_TO_SOT_THT:TO-92_Inline`，无其它外围器件脚号修改。特别注意：**TI LP 实际脚号：1=K、2=A、3=REF；KiCad 内置 TL431LP 符号将 1/3 的文本名称反写。** 本电路 pin1 和 pin3 **均固定接 REF_2V5**、pin2接地，所以其功能目前恰好等效；如果未来改为可调参考、K与REF分开，就必须重新制作经过 OEM 核对的正确符号，**不能继续使用这份内置 pin name 作为物理脚号来源**。

交叉回归：`python -m pytest tools/test_d0_oem_package_mapping.py -q`。

原厂依据：[TI TL431/TL432 Rev. S §5 封装与管脚表](https://www.ti.com/lit/ds/symlink/tl431.pdf)。

## 2. 不得用“ERC零错误”代替的模拟问题

| 新增实际发现 | 计算/物理依据 | 安全判定 |
|---|---|---|
| **单路残压仍可被判全关** | 10路经10k求和、GSUM接1k；其余9路被驱动器拉低时单路门极10V仅产生0.500V，同样单路3.0V只有**0.150V**；而比较器参考为0.200V（其余驱动器未通电时单路3V约0.194V） | 不能证明10路逐一都处于可靠关断区域；任何“ALL_OFF”高都不是逐路安全证明 |
| **D9 BZX84C3V0 低电流钳位不保证3V** | 十路门极假定每路12V时，不钳位GSUM约6.0V；R77=10k、假设输入为3V时流过D9最多约(6−3)/10k=**0.30mA**。Diodes Inc. 的3V标称点是在**5mA**测试的，0.30mA下不能由这条参数推断钳位上限 | LM393采用V5=5V时历史保守共模上限约3.5V；D9不能只凭“3V齐纳”符号保证极端GSUM下始终在规格内。需重新设计/计算或供电+温度边界实测 |
| **“快速比较器”并不更灵敏** | R4/R5产生约1.769V的快速门限，高于硬比较器1.000V；R12×C13又引入**10µs**低通时间常数 | 不得把 FAST 通路称为有已证明快速性、不能替代硬保护 |
| **POR/ACK、偏置与输出实际时限未证明** | 4093/4013/LM393/UCC27524A的门槛、门极电流、启动顺序、最差传播延迟不是组合布尔真值表的内容；TL431/C7的稳定性也未验证 | 要求独立低压首件动态试验，不能将本轮自动审计改称实物认证 |

厂商依据：[Diodes Inc. BZX84C3V0 的 Vz@5mA](https://www.diodes.com/part/view/BZX84C3V0) · [TI LM393 数据手册](https://www.ti.com/lit/ds/symlink/lm393.pdf) · [TI UCC27524A 资料](https://www.ti.com/lit/ds/symlink/ucc27524a.pdf)。器件的最差电气门限仍应按实购 MPN 的完整 datasheet 审核。

运行`python tools/d0_analog_preflight.py --require-qualified --output out/d0_analog_preflight.json`，**应退出1**，明确报告无法保证的门极检测、钳位工作点、比较器和器件延迟；`python -m pytest tools/test_d0_analog_preflight.py -q` 是合成参数与一致性回归，**不是**实物波形。

## 3. 下一阶段真正能改变“未认证”的工程交付

**P0-A：完成保护板原理图的安全整改（优先于画PCB）。** 不建议把汇总GSUM直接当“全部十路可靠关断”。优先选择10路彼此独立的VGS阈值检测并作硬件与关系，按 MOSFET 在最差VGS/温度/器差下的关断边界确定门限，考虑比较器偏差、RC延迟、源极 Kelvin 引线和输出驱动失压；如果保留GSUM，必须以故障注入和 OEM 最差参数证明覆盖每一路。D9的钳位应改为在**实际可供电流/温度**下有确定上界的结构，不得使用 BZX84 标称点外推。隔离电源欠压、共同地回路和芯片 POR 必须在电路中核实，不得只由软件逻辑测试代替。

**P0-B：再建立真实 PCB。** 将本目录原生 `.kicad_sch` 导入 KiCad PCB，冻结含真实 MPN/制造封装/完整焊盘号的 BOM；核对每个 comparator、电源监管、driver 与逻辑门每一个物理焊盘。完成布局铜箔、探针地回路、输入偏置限流、ERC/DRC/间距/绝缘与厂家层叠审核。**没有 `.kicad_pcb` 就不把生成原理图称作实体 PCB**。

**P0-C：低能量实物验证。** 用隔离、限压限流电源和全部10路假电容负载，逐条执行[18例硬件故障矩阵](templates/protection_hardware_fault_matrix_18.csv)：硬故障、软启动短路、ACK常高、CT开短路、偏置UVLO、POR先后上电、每路门极失能、门极与使能线短路等。记录实际故障物理注入源、触发时刻、10路 VGS 和电源/复位波形；跨仪器对齐请按[31/32章](31_D0多仪器同步对齐与重采样.md)完成，绝不凭软件合成CSV勾选通过。

**P0-D：主功率板并行。** 主板 `hardware/dcx_main/dcx_main_board.eprj2` 中 R8 的常上拉尚未做真实 ECO；旧主板83位号、61占位器件、T1–T4/CT厂家24个真实焊盘与DOT、GUI ERC、有网PCB仍阻塞制造。完成这些文件及真实实测后，才进入D1 48V/100A级≤16mm的低压→25/50/75/100A阶梯调试；120A与≤10mm是后续D2、D3，不要把机械≤10mm强行作为D0开板阻塞。

## 4. 严格停止条件

1. **通过 KiCad ERC** 只代表软件原理图没有相应语法/连接违规，不能越过模拟钳位、片内延迟和实物验证。
2. **仅匹配软件逻辑状态机** 不算复现 POR、比较器缓慢跨阈值、时钟抖动与源极振铃。
3. **报告中的 `ANALOG_SAFETY_NOT_QUALIFIED`** 必须保持到有可核实、可复算的方案级整改和台架测试，不可由人工把布尔字段手改为true。
4. **完整保护样板并非功率级投板许可**；制造闸门继续 `NOT_FOR_FAB`，器件SOA、磁件L(I)/DOT、热设计、铜损须独立满足各自关卡。
