czy0126/CZY/docs/D1_EXECUTION_KIT/28_保护映射复核与下一轮真实交付.md

# 28 · 保护连接反例校验与 D0→D1 真实交付指令（2026-11-04）

> 工程状态：**NOT_FOR_FAB**。本章的代码修复只阻止「接错线/误授权却能通过自动检查」，没有更改原生 `.eprj2`、真实磁件、PCB 或实验数据。执行目标为低能量十门保护样板，而不是再次重复 LTspice Bage 扫参。

## 1. 本轮直接修复的两类假通过

**P0 十路 SR 候选驱动映射不完整**：`tools/d1_protection_precheck.py` 原来校验八路数量、控制器输出和门极电阻，但对 UCC27524ADR 的 `INA/INB`、`OUTA/OUTB`、`ENA/ENB`、供电及回流引脚没有严格的已知手册映射，也只校验输出网络以 `SRBUF` 开头；两个通道交换缓冲编号、复用输出网名或将 pin2 写成 pin4，部分情况仍能通过。现锁定每路的预期控制器、真实驱动器 U7–U10、SOIC-8 实际引脚及唯一输出网络；更换 MPN 必须重新审核引脚表，不能只改候选字符串。加入通道交换、输出别名、错误管脚与不受控 MPN 的反例测试。

当前方案八路映射（**仅候选接口，不是原生板已放置**）：

| SR | 源控制器/VG脚 | 缓冲器 / INA或INB | OUT脚 → 原门阻 | EN脚（默认低） |
|---|---|---|---|---|
| SR1A/B | U3.1 / U3.8 | U7.2 / U7.4 | U7.7→R20 / U7.5→R21 | U7.1 / U7.8 |
| SR2A/B | U4.1 / U4.8 | U8.2 / U8.4 | U8.7→R22 / U8.5→R23 | U8.1 / U8.8 |
| SR3A/B | U5.1 / U5.8 | U9.2 / U9.4 | U9.7→R24 / U9.5→R25 | U9.1 / U9.8 |
| SR4A/B | U6.1 / U6.8 | U10.2 / U10.4 | U10.7→R26 / U10.5→R27 | U10.1 / U10.8 |

其中每片 UCC27524ADR 的 **6=VDD、3=GND**；八路各自测量门极 VGS 而不是只测 `SR_SAFE_PERMIT`。此候选会把 UCC24624 的**比例模拟栅压**变成缓冲器逻辑输出，具有实质损耗和误导通风险，不能不经新测试直接替换。参见 [TI UCC24624](https://www.ti.com/product/UCC24624)、[UCC27524A 数据手册](https://www.ti.com/lit/ds/symlink/ucc27524a.pdf)。

**P0 阶段批准信息可被覆盖**：`tools/d1_staged_rebaseline.py` 以前仅拒绝全局 `hardware_approved/production_approved`，而不拒绝 D0/D1/D2/D3 某一 `fab_release=true`；生成屏幕始终写 `fabrication_approved=false` 可能掩盖输入审批状态已变。现拒绝任何阶段未明确设置 `fab_release=false`，附四阶段逐项篡改测试。此代码**不授予**任何制造或保护签核。

## 2. 下一轮真正改变工程状态的交付，按可并行工作包

| 路径 | 先做什么（具体工件） | 必须留下的独立证据 |
|---|---|---|
| **D0 / 控制保护样板（最高优先）** | 制作带真实比较器、故障锁存、上下电 UVLO、硬故障不屏蔽、ACK 低→上升沿复位、U2.EN 默认低以及八路 SR 单独关断的*低能量板*；去掉现有 R8 常上拉；A/B 比较缓冲方案与 8×NCP4306 TRIG 原生停机方案，**二者不混用** | CAD 原始工程和全网表、ERC、BOM；10 路独立电容假负载的 VGS(t)，对 CT开路、偏置丢失、卡高 ACK、启动短路、失效 EN 的原始波形；验证关断总延迟而非只量锁存输出 |
| **磁件/机械** | 向至少两家供应商询问 ELP38/I38 与 ELP43/I43 的三匝 Lr 可行性和 T1–T4/CT 完整物理映射；按16mm目标绘出五磁件、PCB、绕组/焊点、夹具、TIM 和冷板公差链。ELP38裸芯最坏12.35mm，剩余3.65mm只是理论差额 | 24 个端子对实际焊盘/DOT 签章图；100℃的 `L(I)`、漏感、热损耗；可制造装配剖面；未收到回件标记 PENDING |
| **原生 PCB 与关键器件** | 对照 `vendor_native_cad_eco_61.csv` 将61个占位逐一迁移，R3改 2512 耐脉冲物料，Cout选额定电压与 RMS/ESR 有证据的真实件；所有源极 Kelvin 与八路门阻无跨组混接 | EDA 真实导出逐脚/逐焊盘 CSV、GUI ERC、带网 PCB DRC、叠层/接口和原始 Gerber 核对；只有真实签核后再申请 D1 投板 |
| **安全功率爬坡** | D0 保护真实通过后，48V按 25→50→75→100A 逐档测试，另外独立覆盖46/50V；保留120A为 D2，≤10mm为D3 | 精确 Vin/Vout/Iout/Pin/Pout、热稳态、门极/谐振/磁件与第三象限峰值、Cout纹波和效率测量数据；任何 SOA/保护不合格即停止上调 |

**明确放弃重复无成果路径**：已经有2fF+Bage的320μs严格配对分析，因此不要用另一轮同构扫参替代原生 PCB；没有原厂 third-quadrant SOA/温度失效判据时不得宣布器件过流能力通过；不强求所有 D1 目标先实现≤10mm，不以降低安全余量换取推进。

## 3. 以文献决定备选架构，不把论文数据冒充本设计

- [IEEE OJPEL 2024, DOI 10.1109/OJPEL.2024.3490601](https://doi.org/10.1109/OJPEL.2024.3490601)：40V→1V/200A、1MHz 的集成平面变压器+SR+Cout器件布局，展示缩短副边导电长度、低 AC 铜损与低高度设计方向。**不是本项目48→2V的效率实测。**
- [IEEE COMPEL 2023, DOI 10.1109/COMPEL52896.2023.10221067](https://doi.org/10.1109/COMPEL52896.2023.10221067)：48V→1V/300A的绕组串联与整流器并联，提供极薄结构的 **参考方案**；先核实其电压/电流/散热窗口，不直接按面积缩放到当前 24:1。
- [APEC 2024, DOI 10.1109/APEC48139.2024.10509493](https://doi.org/10.1109/APEC48139.2024.10509493)：24:1、500A 堆叠标准 PCB 变压器，输入串/输出并与电流均衡的架构备选；可作为 D2/D3 架构对照，**不能在没有绝缘/保护/控制重设计的情况下直接替换当前 LLC**。
- [IEEE ECCE-Asia 2025, DOI 10.1109/ECCE-Asia63110.2025.11112272](https://doi.org/10.1109/ECCE-Asia63110.2025.11112272)：24:1 与集成输出端子的平面变压器布局；适合当前100A低阻铜路设计，不代表24:1一律带载精确2.0V。
- 原厂约束优先于论文可迁移性：[TDK ELP38/I38](https://www.tdk-electronics.tdk.com/inf/80/db/fer/elp_38_8_25.pdf)、[TI UCC27282](https://www.ti.com/product/UCC27282)、[onsemi NCP4306](https://www.onsemi.com/download/data-sheet/pdf/ncp4306-d.pdf)。UCC27282的 EN 禁止延时不能按理想ns处理；NCP4306 TRIG/DIS 需验证关断消隐、TRIG默认态与真实源极回路。

## 4. 最少运行命令与不可伪造的交付边界

```powershell
python -m pytest tools/test_d1_protection_precheck.py tools/test_d1_staged_rebaseline.py -q
python tools/d1_protection_precheck.py --check
python tools/d1_staged_rebaseline.py --check
python tools/d1_fabrication_gate.py --require-release
```

前三项在已有受控样例下应成功；**最后一项在没有真实物料、原生ERC、带网PCB、独立故障保护签核的情况下必须拒绝**。任何 CI 通过不等于D0已实物组装，更不等于D1可投板。未来 CAD 修改后必须同步重新导出网表，不能拿本章中静态候选引脚表冒充 GUI ERC 结果。
