czy0126/CZY/docs/D1_EXECUTION_KIT/27_分阶段目标_磁件宽高替代与止损.md

# 第27章：D1实际交付优先——分阶段目标、16mm磁件路径与止损规则

**2026-11-04生效，模型/项目管理目标，不代表已实物额定。** 目前不要再把 48V→2V、120A、整机≤10mm、五磁件定制、可靠硬件关断全部捆绑为首台必须同时合格的单一目标。目标可以分级，**SOA、故障关断、绝缘、真实磁件高温L(I)、带网PCB、ERC/DRC不能降低。**

权威来源：[分阶段政策JSON](../../design/v3/power_priority/d1_staged_target_policy.json) · [自动关联实测/仿真/原厂磁芯证据的筛选](../../design/v3/power_priority/d1_staged_target_screen.json) · `python tools/d1_staged_rebaseline.py --check`。

## 一、把工程从“追指标”转为“逐级成功样机”

| 阶段 | 目标 | 当前已拥有的证据 | 真正交付的条件 |
|---|---|---|---|
| D0 保护控制板 | 不接百安功率级，验证比较器/复位/原边2路+SR8路真实独立关断 | 十路接线草案和失效逻辑模型，**没有完成实物板** | 真实器件和驱动电源的掉电、锁存、复位卡高、双域故障注入，全部观察10路门极或等效电容 |
| D1 首台可测试电源 | **48V/24:1、100A级、整机目标≤16mm**；实际负载电压按模型约1.89V，不要求本级稳压到2.000V | 48V/99.825A模型，Vout≈1.8867V，功率≈188.35W；无硬件额定 | 完整保护、100℃磁件L(I)、24真实端子及DOT、焊盘/ERC/DRC、冷板间隙、效率/温度/负载阶跃实测 |
| D2 同结构功率升级 | **48V/120A级、目标≤16mm**，仅在D1硬件可靠后扩大 | 48V/121.668A模型，Vout≈1.8737V，P≈227.98W | 升级后的持续热试验、50V故障与启动、全部8SR第三象限SOA和器件验证 |
| D3 冷板薄型化 | **≤10mm**作为优化版本，不阻塞D1/2 | 标准磁芯高度/磁通双筛证明10mm难度大 | 定制低矮绕组/沉槽/磁芯，反复复验损耗、绝缘、制造、保护 |

为什么先100A再120A？同一路径的纯电阻损耗比例随电流平方变化，从100A到120A为 **1.44倍**。从现有仿真输出功率算增量约40W，但这不能外推真实效率或热稳态，100A级仍是高功率硬件设计目标，目前没有已验证的实物样机。

**固定24:1 DCX不是精确2.000V稳压器**：理想48V/24=2V，模型负载后约1.887V（100A）和1.874V（120A级），未来需要精确2V时可研究前级输入适度调节或有损耗代价的后级调节；不能拿“标称2V”标为实测带载2V。46V/50V应分别表征，不能用48V数据冒充全输入范围合格。

## 二、调整16mm目标后，立即可询样的磁件路线

现有三匝、121.515A设计情景、`B_limit=0.248T`及TDK原厂ELP资料（第20章）：

| Lr初选 | Amin | 故障时近似B | 裸芯+I片最坏高度 | 16mm剩余装配空间 | 决策 |
|---|---:|---:|---:|---:|---|
| ELP32 + I32 | 128mm² | 0.348T | 9.80mm | 6.20mm | 磁通初筛不通过，不因为薄而盲用 |
| **ELP38 + I38** | **192mm²** | **0.232T** | **12.35mm** | **3.65mm** | **D1首选询样**：面积过0.248T最低筛选，未达到偏好200mm²；需要工艺、气隙与完整尺寸 |
| ELP43 + I43 | 217mm² | 0.205T | 13.90mm | 2.10mm | 备用：磁通更宽裕，但装配余量更紧 |
| 定制薄型 | 厂家计算 | 需厂家签核 | 按整机边界设计 | 不可预设 | D3研发，与D1并行且不拖住D1 |

**临时结构预留：** 在筛选16mm方案时先保留≥2mm给非磁芯装配要素，纯属早期设计缓冲，不是厂家或冷板已确认尺寸。ELP58/ELP64标准组合剩余不足2mm，不列为当前可实施的首选；ELP38/ELP43仍必须提交完整叠层确认。

**特别说明：** 这里的“3.65mm剩余”只是16mm减去*单个未装绕组磁芯组合*最大高度；PCB、磁件是否穿板、支架、紧固件、焊接浮高、TIM、冷板、垫片与公差都尚未计算。面积/磁通只是`L*I/(N*Amin)`近似；100℃时真实增量L(I)、BH/气隙、绕组层叠、损耗与绝缘缺一不可。**不是说已存在满足16mm的实物磁件。**

对厂家提交[16mm阶段磁件RFQ](templates/staged_magnetics_16mm_rfq.csv)，同时复用[24端子/DOT映射空表](templates/magnetic_terminal_seed_24.csv)。优先收ELP38完整装配叠高和100℃ L(I)，不是反复向厂家坚持ELP32必须在10mm承载所有故障裕量。

## 三、阻塞必须有出口：工程止损机制

- **Bage数值收敛**：2fF+Bage修订模型的B组控制/候选**均已到320µs**；新旧模型0–220µs关键数据相同。此模拟阻塞标记为“已取得可分析配对证据”。除非实际门级/器件模型发现新问题，否则不再重复同样的1/2/5/10fF扫参。下一个真正的D0任务是**真实硬件10路关断**，而不是再做相似RAW。
- **10mm磁件**：对低矮几何并行取得两套真实供应商/独立结构方案；若都无法在额定温度、电流、冷板安装下满足，**D1直接走16mm ELP38/ELP43路径**，D3继续薄型化。没有供应商答复不能当作尺寸合格。
- **功率爬坡**：D0通过后用25→50→75→100A逐档实测，热/过流/安全任一不达标立即停止更高档。可以保留75A受控工程评估样机作阶段成果，但不能把它宣称为100A级已交付，更不能跳过故障保护。
- **CAD/磁件物理端子**：再多自动生成网表也不会替代五磁件的真实脚号及DOT图、完整ERC/DRC。必须将明确的24端子请求、逐位号61个ECO交给供应商/EDA执行者；这里不再做未授权猜测。
- **交付标准**：每项开发必须产生至少一种可检验证据：真实原生工程/波形原始RAW/LOG和哈希/原厂图纸/测试记录/厂商准确MPN；同义内容翻写不计进度。

旧的[10mm高裕量方案](../../design/v3/power_priority/high_margin_design_gate.json)保留为D3参考，不改动已经发布的V3历史仿真和校验。正式生产准入仍按[真实制造闸门](../../hardware/dcx_main/d1_fabrication_gate.json)执行，所有阶段均明确为`NOT_FOR_FAB`。

## 四、分阶段验收和现在的具体工作

[测试爬坡卡](templates/staged_first_article_test_steps.csv)定义：D0对真正的十路门极模拟负载注入健康与故障电平；D1按25/50/75/100A递进；D2 120A仅在D1完整签核后进行。每步记录Vin/Vout/Iout、效率、十路Vgs、MOS Vds/Id、100℃ L(I)首件、Cout RMS与温度、供电丢失和人机复位逻辑，不允许在未知发热或器件应力下盲目升流。

```powershell
python tools/d1_staged_rebaseline.py --check
python -m pytest tools/test_d1_staged_rebaseline.py -q
python tools/d1_fabrication_gate.py --require-release  # 缺真实硬件时应拒绝
```

**本次调整后的立即工作优先级：** D0硬保护控制样板 → 同时询样ELP38/43尺寸/电感/实物端子 → D1的原生PCB和可选电容值 → 100A分档台架 → 120A升级 → D3薄型化。
