czy0126/CZY/docs/D1_EXECUTION_KIT/26_B组2fF软轨配对跑满320us与逐位比对.md

# 第26章：B组2fF软轨配对首次跑满320µs，以及与v3_3的逐位比对

**2026-11-04 实跑**：按[第22章](22_B组Bage行为源收敛修复与两组配对试验.md)的单一变量实验，2fF B组控制与候选在 `sr_timing_v3_4_age_rail.lib` 下**都保存到320µs**，且**故障前140–175µs的V(out)均值差为0.000000mV**。这是1fF/2fF/5fF三档中第一次出现两侧完整的B组配对。

运行入口与归档（raw不入Git）：

```powershell
python tools/run_prot03_bage_diagnostic.py --variant shunt_2f --execute --run-id bage_2f_001 --ltspice 'D:/ADI/LTspice/LTspice.exe'
```

| 角色 | 尾时刻 | LTspice用时 | raw | 故障前V(out)均值 |
|---|---:|---:|---:|---:|
| B_CONTROL | 320.000µs | 1548.102s | 2.79GB | 1.9593454V |
| B_CANDIDATE | 320.000µs | 1553.307s | 2.14GB | 1.9593454V |

## 一、与v3_3的冻结窗口比对（0–220µs）

工具：`tools/prot03_bage_model_check.py`（先逐行验证父/子deck只差 `.include`，且模型文件与生成器逐字节一致）。两份记录的7项指标——故障点、Ipri峰、SR正/反向峰、`V(oc)`峰、故障后`V(out)`最低、故障前均值——**差值全部恰好为0.0**；采样点数也相同（控制1,007,575点，候选836,708点）；故障点同为215.0358924845205µs。

| 角色 | 0–220µs采样 | 首个差异时刻 | 差异类型 |
|---|---:|---:|---|
| B_CONTROL | 1,007,575 | 228.884000µs | 时间轴（下一步长不同） |
| B_CANDIDATE | 836,708 | 无（220–320µs共23,540点逐位相同） | — |

**恰好为零不是缓存或工具复用**：`read_window`/`window_peaks`无缓存，两条raw的标题与时间戳不同（各102个变量）。当模型改动在窗口内函数值完全不变时，LTspice给出逐位相同的轨迹；这一点由窗口后的扫描独立证实——**候选在220–320µs整段仍逐位相同**，说明其`V(age)`从未进入9.9V软轨；控制则在trip后13.85µs（228.884µs）开始分岔，正是v3_3此后压步长、最终停在264.515µs的死区。因此**软轨只改变了控制组停摆后的数值路径，候选的电路行为不受影响**。

## 二、320µs成对分析

记录：`design/v3/power_priority/protection_candidate_50v_120a_prot_b_paired_agefix_2f.json`（窗口175–320µs，两侧同模型、同`cshunt`）。

| 指标 | 控制（无保护） | 候选（1.8V比较器） | 变化 |
|---|---:|---:|---:|
| Ipri峰 | 101.060A | 45.704A | −54.78% |
| SR正向峰 | 304.878A | 139.109A | −54.37% |
| SR正向I²t合计 | — | — | −95.44% |
| `V(out)`故障后最低 | −2.09mV | +0.071mV | +2.163mV |
| `V(oc)`峰 | 1.2693V | 0.7058V | — |

候选自身1.8V比较器（`V(ocdf)−V(ocm)`）于**185.3634µs**触发、**185.4327µs**闩锁（延时0.0693µs），比基座1V过流点（215.0359µs）早**29.6725µs**。两份模型比对记录里`trip_s`为`null`（候选原边电流未把CT负载推到1V，1V判据从未满足），这是设计使然而非缺测。

## 三、判据核对

[第23章](23_PROT03三档数值收敛最新审核与下一步.md)的四条成功判据：

- 两侧都保存320µs：**满足**；
- 故障前140–175µs输出均值差≤1mV：**满足**（实测0.000000mV）；
- 与v3_3在0–220µs共享窗口的关键峰值/门极定时偏差在预算内：**满足**（全部0.0）；
- 真实器件第三象限SOA、原边EN与八路SR禁能延时、磁件L(I)：**未完成**。

十路门极钳位存在性、父子故障网络不变、候选在故障前已arming，均由成对记录逐项检查为true。**因此整体仍不判通过**，`NOT_FOR_FAB`保留。

## 四、边界（不得越过）

- `sr_timing_v3_4_age_rail.lib`是**数值替代模型**，只把Bage的10V硬轨改成9.9–10V连续软轨；它不是原厂半导体行为，也不证明真实UCC24624会这样收敛。
- `run_manifest.json`的`both_320us_qualified`/`pre_fault_1mv_qualified`/`fabrication_approved`是**按设计恒为false**的保守旗标；配对资格只在上述分析记录里成立，不要反过来说运行清单"通过了"。
- 候选的1.8V门槛是模型选择的阈值，不是已认证比较器规格；比较器容差、延时、噪声与十路EN链的实物时序仍需台架确认。
- 模型没有UCC24624 standby/轻载关断，trip后SR门极的末态仍由求解器选择；锁存不等于安全关断。
- 2fF成功**不能外推到1fF/5fF或其他cshunt**：三档停点非单调，软轨只作用于Bage这一个实例。
- 50V基座（v3_3）仍在296.929µs塌缩；本章的320µs证据只属于v3_4派生deck。

## 五、机器可读记录与复现

```powershell
python tools/prot03_50v_evidence_decision.py --check   # 决策JSON已含 B_2fF_agefix 段
python tools/prot03_bage_model_check.py --variant shunt_2f --role B_CONTROL ...
python tools/prot03_bage_model_check.py --variant shunt_2f --role B_CANDIDATE ...
python tools/protection_candidate_compare.py --case prot_b_fast10u_1p8v_50v ...
```

- [决策JSON](../../design/v3/power_priority/prot03_50v_protection_evidence_decision.json)：`B_2fF_agefix`段，`numeric_solver_next_step.status`现为`COMPLETE_BOTH_320US`，`hardware_gate_passed`与`manufacture_approved`仍为false。
- [控制比对](../../design/v3/power_priority/prot03_bage_agefix_2f_B_CONTROL_vs_v3_3.json)、[候选比对](../../design/v3/power_priority/prot03_bage_agefix_2f_B_CANDIDATE_vs_v3_3.json)：含`post_window_scan`。
- [320µs成对记录](../../design/v3/power_priority/protection_candidate_50v_120a_prot_b_paired_agefix_2f.json)。
- 运行归档：`out/d1_50v/bage_2f_001/{B_CONTROL,B_CANDIDATE}/`（含deck、log、raw与sha256）。
