czy0126/CZY/docs/D1_EXECUTION_KIT/11_原厂实证与逐位号候选.md

# 2026-11-03 原厂器件资料及真实候选料号增量包

> **本包已查到原厂明确存在的器件，不等于选型完成。** 正规厂家来源、器件标称值、封装类别已逐项映射；**真实焊盘尺寸、CAD 库、回路时序、温度和实物 SOA 均未签核**。主工程维持 `NOT_FOR_FAB`。本包不覆盖原 `hardware/dcx_main/component_decision_register.json`，也不改写 61 个 RFQ 的 PENDING 初始记录。

## 交付文件
- `vendor_parts_official.json` — 16 款具有原厂资料入口（含1款已判不适合R3的旧0805、1款新的Vishay官方系列+授权分销商具体订货料号），实际位号采用15款标准阻容候选的标准阻容候选及规格；来源带真实网址。
- `vendor_ref_assignments.json` — **51 / 61** 个原生占位位号已绑定真实可检索器件型号，另外 10 项明确留空而不是填假料号。
- `templates/vendor_candidate_matrix_61.csv` — 一位号一行，**61 行完整**，保留所有原设计要求和未决项，机械/EDA 均为 NO。
- `templates/power_stage_candidate_options.csv` — Cout 的 2.5V 基准器件与 6.3V 候选的理想并联对比、D_BT 重复/拓扑核查、Lr/Cr/Cin 开放项。
- `vendor_official_assets.json` — 已有控制与功率器件的原厂资源及仿真文件名（不声称已下载或兼容 LTspice）。
- `vendor_design_findings.json` — 6 条可闭环的 P0/P1 设计核查记录。
- `../../design/v3/bom/cout_bank_path.json` 与 `tools/cout_bank_path.py` — Cout 整组的铜箔/接点项：由摆放派生的支路方块数、整组 ESR 抬升、允许量表与均流份额（SOURCE-04 的 "spreading copper" 一半）。
- `../../design/v3/power_priority/vendor_soa_digitized.json` 与 `sr_soa_screen.json` — 原厂 SOA/Zth 的几何数字化及其在八只 SR 故障波形上的逐点筛查（同一目录下 `48V120A_…` 系列文档引用这两个文件）。
- `tools/verify_vendor_candidate_matrix.py` 和测试 — 保证候选表与原始 61 位号同步、禁止将候选标记为验收。

## 几个不可省略的技术结论

1. **UCC27282DRCR 有内部 bootstrap diode**。此前 BOM 的 `D_BT` 可能与内部器件共存、作为外接快速通道，也可能是遗留占位。必须在原生 EDA 核查 HB/VDD/HS 连线、压降及反向应力，再判断保留与否；不能凭产品页直接删除。
2. **CSD19531Q5A 的 5.3 mΩ 为典型值，TI 产品页当前列的 10 V 最大值为 6.4 mΩ**。现有 BOM 仍写 6.2 mΩ，必须与真实原厂 Rev.B、器件批次和温度条件做一次损耗交叉校对。 `VERIFIED` 仅表示旧版器件信息，**不表示热损耗已验证**。
3. **BSC010N04LS6 的 40 V、1.0 mΩ max、285 A /1140 A 等额定数字不是当前 300A 故障 SOA 的通行证**。现已按原厂图做过逐管动态确认：`tools/vendor_soa.py` 从 vendored PDF 数字化出 6 条 SOA 曲线与单脉冲 Zth（锚点：1 µs 平台 1125 A 对文件里的 1140 A、右沿 41.07 V 对 40 V 额定、`Zth(1 s)` 0.994 K/W 对 `Rth(j-c)` 1 K/W），`tools/sr_soa_screen.py` 在三条故障 raw 上逐点比对八只 SR：**第一象限占用率 ≤6.52 %**；但**主要应力在第三象限，而原厂 SOA 图只画 `VDS>0`**，所以没有曲线可判——实测 −292.61 A / 15.54 V（48 V）与 −303.50 A / 15.46 V（50 V cshunt），管芯峰耗 190.7 / 214.2 W，经 Zth 卷积结温升 **1.84–1.88 K**（模型 TJ 钉在 25 °C，无热反馈，不是额定）。八路 SR fail-low 保护仍为 P0。
4. **Cout 标称 2.5 V 与 48→~2 V 的动态上冲并不宽裕**；可作为既有模型对照，不宜直接定案。6.3 V、470 µF、5 mΩ 的 T530 候选最高 4.3 mm（授权代理商数据），30 只理想并联约 0.167 mΩ、14.1 mF。**"铜箔"这一半已量化**：`tools/cout_bank_path.py` 把每只电容与它自己那段铜串联后再并联（`1/Σ 1/(ESR+R_branch)`，零铜时退化为 `ESR/N`，与 sizing 同源），几何直接读摆放（15 只、8.20 mm 间距、距 SR 行 16.0 mm，2 oz / 100 °C、0.3237 mΩ/方块），把已摆放那组的整组 ESR 从 0.200 抬到 **0.269 mΩ（+34.4 %）**——比"再降 0.1 mΩ 就翻倍买件"那个变化还大；最差支路 C103 1.408 mΩ，是 +10 % 允许量 0.300 mΩ 的 **4.7 倍**，均流份额 7.22 % 对 6.67 %。允许量 `target·N − ESR` 随 N 线性增长，这正是 30 只 6.3 V 选项的量化理由（同一 10 % 下允许 0.6 mΩ/支路，翻倍）。**仍未闭环**：200 kHz 下的 ESR/纹波降额、焊盘与过孔几何（没有过孔阵列，50 µΩ 是接头占位值）、交流集肤/邻近效应（方块数是直流模型，故 +34.4 % 是**下界**）、以及热失衡（份额是电阻比，不是温度）；竖直段与 `output_path_budget.json` 的 SR→铜排路径共用同一块铜，**两个电阻不能相加**。另一条是单向结论而不是开放项：已在档的 **42.76 mVpp**（`operating_point_100a_cout7m.json`，7.05 mF）是用理想 0.200 mΩ 整组 Rser 算的，而抬高任何支路阻抗都不会让纹波变小，所以那个纹波数同样只是**下界**。目标若为整组 0.07 mΩ，理想情况下要至少 72 只，不能直接采纳。
5. **R3 10 Ω 已从不达标的0805改为候选2512耐脉冲器件，但尚未验收。** 旧 Panasonic ERJ6ENF10R0V 的125mW额定不足以覆盖48V/120A故障前125.7mW，故在**候选映射**中撤回。新候选为 [Vishay CRCW251210R0FKEHHP](https://www.digikey.com/en/products/detail/vishay-dale/CRCW251210R0FKEHHP/5079191)，10Ω、1%、**1.5W P70、2512、最高0.70mm**。原厂 [CRCW-HP e3 Rev.2026-03-17](https://www.vishay.com/docs/20043/crcwhpe3.pdf) 已有单次/重复脉冲曲线，**不能凭非方波的13µs等效能量宽度就宣布通过**。脚位和焊盘必须从旧0805改2512，真实温度、启动脉冲、重复故障和板级热阻需要单独检查。当前仅为 P70 连续功率筛查：1.5/0.1257≈11.9倍，不能替代热/脉冲签核。数值与门禁见 [R3评级记录](r3_vendor_rating_screen.json) 和 [新审核](13_候选器件额定与原厂证据复核.md)。
6. **TDK MLCC 的容量需要按工作电压和温度读取 DC-bias 曲线**；额定 2.2µF、1µF 是标称值，不应原样放进含偏压的时序/电压跌落计算。

## 快速命令（不会执行任何制造签核）
```bash
python tools/verify_vendor_candidate_matrix.py --check
python -m pytest tools/test_verify_vendor_candidate_matrix.py -q
python tools/cout_bank_path.py --json design/v3/bom/cout_bank_path.json
```

## 来源说明
本轮逐条查核的网址保存在 JSON/CSV 中，原则：官方厂家页面 > 厂家完整规格表 > 授权分销商（须标注 SECONDARY）。原厂的模型和 CAD 按原厂使用许可下载，**本包仅提供可核查索引，不擅自镜像版权材料**。后续要求供应商的只有定制磁件端子图、真 L(I)、高频损耗/温度、出货与完整机械测量，以及实际板厂 ERC/DRC。
