czy0126/CZY/docs/D1_EXECUTION_KIT/13_候选器件额定与原厂证据复核.md

# 2026-11-03 D1 候选器件技术复核与具体修补

## 本轮确实更正的项目（可追溯代码与数值）

**P0：R3旧选型在120A工况不满足持续功率额定。** `design/v3/bom/oc_burden_pulse.json` 源自受控仿真 `mean(V(ocd)-V(ocm))²/R` 的正确实现；48V/120A故障前 **125.701 mW** 已超过旧0805/125mW名义值。故障脉冲峰 **10.08 W**，最大已记录故障窗口能量 **0.1310 mJ**；脉冲宽度等效值约13µs。旧方案在 [Panasonic官方页](https://industrial.panasonic.com/ww/products/pt/general-purpose-chip-resistors/models/ERJ6ENF10R0V) 明确0.125W，**现标记 REJECTED，不再映射到R3**。

**新建未验证候选：** [CRCW251210R0FKEHHP 精确订货号（DigiKey授权渠道）](https://www.digikey.com/en/products/detail/vishay-dale/CRCW251210R0FKEHHP/5079191) 和 [Vishay CRCW-HP e3 原厂Rev.17-Mar-2026](https://www.vishay.com/docs/20043/crcwhpe3.pdf)。10Ω±1%、2512、1.5W@70℃、最高0.70mm；与旧10Ω工作值相同，**只解决连续功率候选的明显不合格**。P70相对于当前最坏仿真持续值比值 **11.93倍**；按原厂p6简单线性环境温度曲线（有条件、未实测）：125℃≈0.529W、140℃≈0.265W、150℃≈0.088W。该曲线不是实际器件结温、温升的测量。

**脉冲判定仍 OPEN。** 原厂p5给出了2512的单次与重复脉冲曲线，p6给出了脉冲电压限制，当前约10W的瞬时峰值和0.13mJ的积分能量均须与**真实时序、温度、重复周期、波形**配对后判断。13µs等效宽度不能代替实际非方波的热应力卷积，也不能由<1次初样故障就推广到反复故障。原厂资料存在，不再写“脉冲图厂家无法获取”，但**不能自动写已通过**。

**CAD脚号/机械修订**：旧标注“0805”的PCB位号R3必须改为2512，建议贴近CT整流网络、避免增加高频寄生回路。维持CT变比100:1及负载电阻10Ω，不擅自重改OC时延/分压。原生`.eprj2`、完整网络及图形ERC/DRC、焊盘等未处理，后续实际修改前仍然禁止投板。

## 2026-11-03 新增P0回归修复：R1/R2 的 RT / DT 功能标注反了

**原生导出网表** `hardware/dcx_main/gen/netlist_export_raw.json` 明确显示 `R1 = DT→PGND`、`R2 = RT→PGND`、`U1.1 = DT`、`U1.2 = RT`。原 BOM/61件选型将R1标注976Ω RT、R2标注5.36kΩ DT；**只要按上一版候选把料号装进原生PCB就会把两个功能阻值装反**，而原来的子网一致性报告不会发现。

现已 **以原生接线为实物连接定义，统一更正物料对应**：`R1=DT=5.36kΩ→ERJ3EKF5361V`，`R2=RT=976Ω→ERJ3EKF9760V`；同步更新 `component_decision_register.json`、BOM draft、61行候选矩阵、RFQ种子、回归断言。UCC25600原有推荐时序阻值 **5.36kΩ DT、976Ω RT均保持不变**，这次只改工程位号对应，不冒险编辑原生原理图。新增 `tools/d1_functional_net_audit.py` 并把 `controller_rt_dt_roles_match_native_netlist` 纳入D1制造闸门，下一次即使网络数量全部匹配，只要功能/阻值映射错也会直接失败。

## 2026-11-03 补充：R3 启动脉冲（先推导，后直接测量）

冷启动 deck（`sr_tank_dual_v33_cold_vin48_i120_target.cir`）不保存 `V(ocd)`/`V(ocm)`，直接重跑需 2294 s / 13 GB。`tools/startup_burden_pulse.py` 因此用**已保存的 `I(Lr)`** 走 deck 自己的 CT 变比推导：`V_burden = Rbur·|i_pri|/N`，`Rbur`=10 Ω、`N`=sqrt(20 mH / 2 µH)=100。

- **传递比是量出来的，不是假设的**：在 hotfault srprobe raw（同时保存 `V(ocd)`、`V(ocm)`、`I(Lr)`）的 150–175 µs 与 205–216 µs 两个窗口上，2–97 A 共 75 459 点，中位 **0.0997355 V/A**（p05–p95 0.0993–0.1023，标称 0.1），线性到约 3 %。
- **不是自证**：同一传递比把冷启动 7–8 ms 稳态推成 **0.1253 W**，与 `oc_burden_pulse.json` 独立实测的 0.1257 W 只差 **0.319 %**。
- **结果**：峰值 **0.579361 W @ 1.28698 ms**（`|I(Lr)|` 24.1338 A，Vout 1.1664 V），8 ms 能量 **0.778649 mJ**（均值 97.33 mW），前 2 ms 占 0.0944709 mJ（12.1 %）。
- **与故障脉冲的对比改变了选型重点**：启动能量是故障脉冲 0.1226 mJ 的 **6.35 倍**，峰值却只有其 1/16 ⇒ 封装决定由**启动能量**主导。
- **对 1.5 W/2512 候选**：推导峰值 0.386×P70、直接测量 0.382×P70，超 P70 **0 µs**；对 125/140/150 °C 降额值 0.529/0.265/0.088 W，直接测量分别是 1.081/2.162/6.487 倍，超出 0.412/10.88/4080 µs。这些是**筛选比**，不是合格判据：deck 是 10 ns 步长，厂商 p5 的单次/重复脉冲击穿曲线仍须按真实波形与板温套用。

**直接测量已经完成**：`tools/make_startup_burden_probe.py` 从母 deck 只追加一行 `.save`（`V(ocd) V(ocm) I(Rbur)`；电路、`.tran`、`.meas` 与求解器选项逐字节相同，`tools/test_make_startup_burden_probe.py` 锁住）。8 ms raw **14.13 GB / 14 433 895 点**、约 39 min。实测峰 **0.572401 W @ 1.28698 ms**、能量 **0.779570 mJ**（均值 97.45 mW），对推导值 **−1.201 % / +0.118 %** ⇒ CT 传递比那条推导链经直接测量确认。桥是四只 `Cjo=20 pF` 的 `DSCH`，电流过零处 burden 电压反向 **−1.32 mV**（0.5437 ms），但反向区间只占能量 **6.1e-11**，电阻仍按 `v²/R` 耗散。**仍未闭合**：重复故障周期、板温与厂商 p5 单次/重复曲线均未测；记录仍是 `SIMULATED_ONLY / BURDEN_MEASURED_NOT_RATED`。记录在 `design/v3/bom/{startup_burden_pulse,startup_burden_direct}.json`，回归由 `tools/test_startup_burden_pulse.py` 与 `tools/test_startup_burden_direct.py` 锁住。

## 资料本身的复核

- Panasonic [976Ω](https://industrial.panasonic.com/ww/products/pt/general-purpose-chip-resistors/models/ERJ3EKF9760V) 与 [5.36kΩ](https://industrial.panasonic.com/ww/products/pt/general-purpose-chip-resistors/models/ERJ3EKF5361V)：原厂型号值、1%和0603相符。
- TDK [2.2µF/25V X7S 0603](https://product.tdk.com/en/search/capacitor/ceramic/mlcc/info?part_no=C1608X7S1E225K080AB) 与 [1µF/50V X7R 0603](https://product.tdk.com/en/search/capacitor/ceramic/mlcc/info?part_no=C1608X7R1H105K080AB) 的标称规格匹配。但X7S温度变化±22%，X7R ±15%，也都需要实际DC bias曲线。
- [TDK 220nF/50V/0805 bootstrap](https://product.tdk.com/en/search/capacitor/ceramic/mlcc/info?part_no=C2012X7R1H224K125AA) 厚度1.25±0.20mm；必要的HB-HS bootstrap容量要按VCC12偏置和低温/高温重算。
- [Panasonic 0Ω 0603](https://industrial.panasonic.com/ww/products/pt/general-purpose-chip-resistors/models/ERJ3GEY0R00V)：官网该型号未给出额定功率，它是jump-link而不是理想0Ω；八个SR感测电路需评估最大电阻/取样偏移和回路布局。
- Yageo [2.2Ω/0603](https://www.yageogroup.com/component-documentation/download/specsheet/RC0603FR-072R2L)：官方零件表支持2.2Ω、1%、0.1W@70℃，用于门极时应关注瞬态电流，不可把0.1W DC规格当门极脉冲额定。

## 新增自动防回退

`tools/verify_vendor_candidate_matrix.py` 的 `r3_minimum_rating` 会从 `oc_burden_pulse.json` **实时读取各基座仿真最坏故障前功率**，要求标称P70至少为其三倍，并拒绝0805及意外变更的状态；测试注入0.125W旧方案和0.1W不足方案应抛错。不绕过器件选型/制造闸门。定量结果另见 [r3_vendor_rating_screen.json](r3_vendor_rating_screen.json)（区分“连续功率初筛”和“脉冲、原生PCB、真实热条件未过”）。

## 尚不能由本轮自动完成

1. 导入带正确引脚焊盘的2512原生器件，替换R3旧封装，执行完整原生ERC、同步带网PCB并做DRC；缺少图形工具中的有效审核。
2. R3 启动脉冲已**直接测量**（`startup_burden_direct.json`：0.572401 W / 0.779570 mJ，与推导差 −1.201 % / +0.118 %，见上节）。重复故障脉冲仍须按厂商 p5 单次/重复曲线对实际波形做卷积，而不是用等效宽度代替；若上电硬件不能安全反复注入，首样先限能。
3. T1–T4、Lr、CT五磁件24脚真实厂家物理端子、DOT、实物L(I)，以及主桥+8SR独立故障关断，均未闭合。
4. 50V/120A对照仿真的同源/同求解器全窗验证、额定热、输出电容组实测100–200kHz ESR/电流、整机能量守恒误差，仍需独立执行。

**判定**：本轮消除一个明确的额定不合格候选，并给出有真实原厂脉冲资料的新候选及回归守护；**D1仍NOT_FOR_FAB**。
