czy0126/CZY/docs/D1_EXECUTION_KIT/01_权威资料与文献索引.md

# 权威资料、论文索引与使用顺序

**选择规则**：①厂家原版 Datasheet/应用笔记（引脚、额定、保护、温度）；②会议/期刊论文（架构和测量方法）；③PCB/EDA 厂商当前工艺能力（制造约束）；④开源模型（仅供方法参考）。**绝不把论文中的器件/性能直接写成 CZY 验收。** 看不到 datasheet 的参数列必须 PENDING。

| ID | 原始资料（已核对入口） | 应当提取的内容 | 对应任务 |
|---|---|---|---|
| TI-01 | [UCC24624 Datasheet Rev.C](https://www.ti.com/lit/ds/symlink/ucc24624.pdf) | VDD/REG UVLO、VG1/VG2 下拉状态、VDS 感测、启动/待机行为、绝对额定 | PROT-02, SR 首样 |
| TI-02 | [UCC25600 Datasheet](https://www.ti.com.cn/lit/gpn/UCC25600) | OC 典型 1 V 关断、2 V 锁存与上下限；SS 拉低的控制作用；UVLO/复位 | 原边关断和 OC |
| TI-03 | [UCC27282 Datasheet 产品资料](https://www.ti.com/product/UCC27282) | EN/HI/LI/HO/LO/HB/HS 和 EP 实际封装、UVLO/死区/输入交叉互锁 | 原边驱动电路 |
| TI-04 | [半桥自举设计应用说明 SLUA887A](https://www.ti.com/lit/an/slua887a/slua887a.pdf) | Qg、驱动静态电流、自举电容、二极管反压/恢复、HB-HS 负向振铃 | 自举与真实供能 |
| TI-05 | [UCC24624 产品资料与应用笔记](https://www.ti.com/product/UCC24624) | SR 电路连接示例、感测回路、standby 与误导通 | SR Layout |
| EDA-01 | [EasyEDA Pro 官方用户文档](https://prodocs.easyeda.com/) | 编辑器版本、真实 ERC/DRC、工程保存与 PCB 同步步骤 | A1 / A2 |
| FAB-01 | [JLCPCB 当前制造能力](https://jlcpcb.com/capabilities/pcb-capabilities/) | 铜厚、钻孔/槽、压合、盲槽/铜边、公差，仅作询价前初筛 | 10mm机械/铜路 |
| IEEE-01 | [Integrated Planar Transformer for High-Voltage-Ratio LLC DCX With High Current and Ultra-Low Voltage Output](https://ieeexplore.ieee.org/document/10741344/)；IEEE OJPEL, 2024, DOI 10.1109/OJPEL.2024.3490601 | 平面副边与 SR/Cout 紧耦合、6层板、绕组长度及寄生损耗优化；论文原型 40V→1V/200A,1MHz | ARCH-B |
| IEEE-02 | [500A Stacked Direct Power Converter with Standard PCB Transformer](https://apec2024.eventscribe.net/fsPopup.asp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)；APEC2024, DOI 10.1109/APEC48139.2024.10509493 | 24:1、原边串/副边并、3oz标准 PCB 变压器、分模块均流；论文不同应用点 | ARCH-C |

## 文献中能借鉴、不能照搬的量

- IEEE-01 的文献实验点：40 V→1 V、200 A、1 MHz，报告峰值效率 97%，功率密度 1394 W/in³；**不能**视作该 CZY 模型在 48V→2V 的效率。借鉴的是“缩短大电流副边绕组并靠近 SR+Cout”的布局物理。
- IEEE-02：APEC 2024 报告 24:1 的高增益 500 A 演示，200 A 时效率 >95%、500 A 时 >90%、峰值 97.1%（为论文声称的测试条件）；借鉴“级联原边、并联次级、标准 PCB 变压器”，但必须重新确认新旧拓扑可否满足 10 mm、故障保护和主隔离。
- 工艺官网参数会随工厂、层数、板厚变化；特别是 **五磁件沉槽、盲槽离铜层剩余介质厚度和压紧结构**，必须取得 PCB 制造商对具体 stack-up/开槽图的书面 DFM 答复，而不是只引用网站上某项最小能力。

## 建议每份参考的提取表

| 字段 | 目的 |
|---|---|
| source_id / exact_url / document_title / revision / retrieved_date | 可追溯，不随浏览器跳转丢失版本 |
| applicable_pin_or_rating / condition / min_typ_max / temperature | 不偷换典型值与绝对最大值 |
| design_ref / selected_MPN / difference_from_existing_model | 确认对哪个 PCB/BOM 位号生效 |
| evidence_path / reviewer / status | 关闭条件（PENDING / REVIEWED / REJECTED） |

用 templates/reference_traceability.csv 逐项填写；此目录不自动下载厂商 PDF，也不把未审核网页摘要当成器件数据。
