czy0126/CZY/deepseek/v2/final_actions.md

**一、完成/未完成判定**

已完成（仅限所列实测点）：
- UCC25600替身+实际CSS/RT参数下控制台稳态频率200609.86Hz；
- 100µs时SS=1.218V、f≈290.4kHz，与SS≈1.2V→约291kHz一致；
- 确认276k是SS≈1.67V时的频率，此前“276k起始”为算术错误；
- SR正序g1=10.89V台架状态、REG负序被资格逻辑阻止的现象已记录；
- <155ns脉冲过滤通过；
- 模型级CH1仲裁后门极无重叠（仅模型收敛手段，非厂家保证）。

未完成：
- 350k burst门槛与300k最小频率的容差裕量未实测标定；
- 真实功率联合VDMOS版本88µs附近及后续未通过，不计入；
- 双向开关+电容/体二极管简化版仍在跑，非原厂MOS模型，不计入；
- 原副边偏置上电次序未按VD先于REG闭环观测验证；
- 无完整验证结论。

**二、偏置上电次序修改**

保持并强制：VD（原边偏置）先建立并稳定，再释放REG（副边/同步侧偏置）；REG释放必须以VD就绪的观测信号为条件，不得以固定延时替代。资格逻辑应锁存“VD_PG有效”后才允许REG使能；若REG先起，保持负序阻止并记录事件，不解释为硅片失败。副边偏置不得反灌原边使能路径。

**三、CSS/RT是否该变**

暂不变。现有CSS/RT已给出SS≈1.2V→约291kHz，落在300k最小频率附近，需用容差裕量评估而非直接改值。先做293–300kHz区间容差与burst门槛实测；若最小频率裕量不足，再微调RT（提高最小频率）或CSS（调整SS斜率），每次只改一个参数并复测100µs点与稳态频率。

**四、最多4个任务及交付验收（非输出稳压前提）**

1. **偏置时序闭环**：VD_PG→REG使能锁存；验收：示波器同时捕获VD、REG、SR g1，REG上升沿不早于VD_PG有效，重复≥20次无违例。
2. **频率/容差标定**：测SS=1.2V对应频率、300k最小频率裕量、350k burst门槛；验收：给出291kHz±容差表及burst进入/退出点，注明测试条件。
3. **SR资格与脉冲过滤复核**：正/负序、<155ns过滤在台架重复；验收：无重叠门极，负序被阻止事件可复现记录。
4. **真实功率联合VDMOS推进**：仅在该版本上复测88µs附近；验收：给出通过/未通过结论及波形，未通过则明确不计通过。

**禁止**：以任意等待时间代替VD先于REG的观测；不得声称完整验证完成。
