czy0126/CZY/deepseek/v2/final_actions_task.md

基于最新实测只给能落地的ECO及下一任务（800字以内）。已实现：UCC25600自建替身+实际CSS10n和RT976/DT5.36k，LTspice控制台稳态200609.86Hz，100us时SS1.218V、f290425Hz；所以此前约276k起始频率是算术错误，276k是在SS约1.67V，不是刚启动。正式式SS1.2V应约291kHz。350k典型burst门槛，最小300k需容差裕量。SR状态台正序g1=10.89V，REG先起负序被资格逻辑阻止，不代表硅片必定失败。连续短于155ns脉冲过滤通过。同时请求先前使模型收敛失败，增加模型级CH1仲裁后门极无重叠，该仲裁不是厂家内部保证。真实功率联合VDMOS版本在88us附近/后续进展慢，尚不计通过；双向开关+电容/体二极管简化版本正在跑，不属于原厂MOS模型。请明确：哪些完成/未完成、原副边偏置上电次序该怎么改、CSS/RT是否该变、以非输出稳压为前提的最多4个任务及交付验收。不能建议用任意等待时间代替VD先于REG的观测。禁止声称完整验证完成。
