czy0126/CZY/deepseek/v2/model_review.md

# SR_TIMING 逻辑审查

## 1) blanking 起点
`Bton` 的计时门控是 `tarm`（armstate 下降后开始计 BOFF），并非从 D 低于 ONTH 起算；但真正决定 blanking 结束的是 `tarm>BOFF` 与 `OK>0.5` 的与项。问题是：`tarm` 在 armstate 为低时持续累加，若 D 长期低于 ARM，blanking 实际是“最后一次 ARM 事件后固定等待”，**新一次 D 下穿 ONTH 并不会重置 blanking**。连续短脉冲场景下这会让第二个脉冲的 blanking 被前一个脉冲“吃掉”一部分，过滤不对称。

## 2) off 计时从 ARM 事件起算
`Btoff` 用 `age`（Q 低电平持续时间）而非 ARM 事件作门控；`age>BON` 才允许 off 计时。这意味着 **TOFF 的起点是 Q 变低（或上电）后 BON 时刻**，与 ARM 事件无直接绑定。若 D 在 ARM 后很快升高，off 计时起点被 BON 推迟，存在 TOFF 被拉长的窗口；反之若 Q 刚置位，age 尚小，D 升高不启动 off，**存在“Q=1 期间 D 超 OFFTH 但不计时”的盲区**。

## 3) 互锁
`Bq` 中 `OTHER>0.5` 时强制 Q 放电，且 `Bton` 要求 `OTHER<0.5`。互锁是**电平型、单向优先**：一旦对方置位，本通道立即被拉低，无最小导通保持，存在两通道在边界抖动下**交替抢占**（chattering）的可能。同组两通道同时请求时：`Bton` 对两者同时满足条件，`Bq` 各自在 TON 后置位——**可能同时置位**，因为互锁只在“对方已 >0.5”时生效，而两路 Q 同时从 0 上升时彼此都看不到对方 >0.5，`OTHER>0.5` 条件不成立。这是本模型最实质的缺陷：**无先到先得仲裁/无交叉耦合延迟**，同时请求可双置位。

## 4) 连续短脉冲过滤
`Bton` 要求 D<ONTH 且 OTHER<0.5 且 tarm>BOFF 且 OK>0.5，TON 为最小导通；`Btoff` 要求 age>BON。短脉冲若 D 在 TON 内回升到 OFFTH 以上，`toff` 因 age 未过 BON 不启动，Q 保持——**短脉冲被“吞掉”而非滤除**，行为偏向保持导通，与“过滤”语义不符。

## 5) REG 先升
`Buv` 在 REG>4.5 置位、REG<4 复位；`Bok` 需 PRE>0.5 且 uv>0.5。REG 先升时 PRE 仍为 0（REG<1 时 Bpre 保持），OK=0，Q 被强制放电，**负例 g1=0 合理**。但 REG 先升到 4.5 后 PRE 的充电路径依赖 D>ARM 且 REG 在 1~4.5 区间，若 REG 快速穿过该区间，PRE 可能来不及置位，存在**上电窗口内 PRE 漏判**。

## 6) PGD 未校准
`Bdrv` 中 PGD=1 用 `limit(3+(-V(D)-.035)*80,2.6,10.9)` 平滑律，斜率 80、偏置 0.035 均无数据支撑；正例 g1 峰值 10.89V 只是该律在 D 最低点的饱和值，**不能作为驱动能力或关断速度证据**。

## 优先补测（≤3）
1. **同时请求仲裁测试**：两通道 D 同时下穿 ONTH，验证是否双置位；应加入先到先得或交叉禁止延迟。
2. **功率级反向导通验证**：在 G 关断、D 被外部强行拉到负压/低电位时，测体二极管/沟道反向导通电流，确认关断态无反向通路（必须项）。
3. **REG 快速上电 + PRE 窗口扫描**：扫 REG 斜率与 D 时序，确认 PRE 在 1~4.5V 窗口内不漏判。

**结论**：模型作为合规门控自检可用，但互锁无仲裁、off 计时起点与 ARM 脱钩、blanking 不随新脉冲重置、PGD 律未校准，均需在签核前修正或明确标注为不可用于硬件判定。
