czy0126/CZY/deepseek/v2/model_review_task.md

请审查附带SR时序替身的具体逻辑，最多800字。此模型不是TI模型，PRE是上电时序合规性资格，不声称违规芯片必定关断。指出：blanking起点、off计时从ARM事件、互锁、连续短脉冲过滤、REG先升的处理、PGD未经校准的风险。不得只说总体正确。当前正例g1峰值10.89V，REG先升负例g1=0；这只是合规门控模型自检。提出最多3个必须优先补的测试，其中必须一个允许反向导通的功率级验证。特别审查同组两通道同时请求时是否可能同时置位。
