czy0126/CZY/deepseek/v2/sr_task.md

本轮只推进UCC24624真实SR行为，不再泛泛设计。根据附带官方文字输出精简状态转移表（状态/进入/退出/输出）和验证清单，1000字以内。特别注意：REG升过UVLO前VD必须先升过VTHARM，原版两路12V偏置先上后开PWM可能违反手册。给最少改动的上电方案：先原边工作、二极管整流建立VD，再使能SR偏置；不要说随便延迟就保证。候选负载100A，SR每组两个40V MOS。阈值turnon -265mV、turnoff+10.5mV、ARM1.5V；onblank475ns、offblank650ns、tondelay155/275ns、toff23ns。VSS0ohm，比例门驱必须纳入，允许将未完全建模的部分标明。不能把正向导通开关或理想二极管代替可反向导通MOS。指出测试必须同时有安全正例和必定失败的时序负例。最后给不依赖具体仿真器的可执行算法伪代码。
