czy0126/CZY/deepseek/correction_review.md

**唯一连接链**  
48V输入→半桥两开关构成桥臂、两分压电容构成另一桥臂→谐振腔（外置Lr+等效漏感+Cr）→四个3:1:1磁件原边串联（各磁芯独立，同名端顺序串联）→各磁件中心抽头副边两组SR整流→四路整流输出并联→输出电容跨VOUT+/VOUT-。SR接法固定：中心抽头接VOUT+；两端分别接两SR漏极；两SR源极接VOUT-；体二极管方向须使中心抽头为正时对应SR导通整流。外供偏置只给驱动/控制，不改变功率链。

**变比关系与适用条件**  
半桥谐振腔交流激励幅度为Vin/2；每个变压器原边电压不是Vin/2，而是总原边电压按串联均分，需由谐振腔增益解出。理想DCX极限下，单磁件中心抽头全波整流输出约Vout≈(Vin/2)·(Np/Ns)·(1/2?)——此处必须以实际匝比和整流拓扑重新定义：对3:1:1中心抽头，单路整流输出与半匝比相关，四路并联不改变电压、只增电流。适用条件：四磁件参数与漏感对称、原边串联电流相同、整流并联均流靠对称与SR控制；轻载/死区/漏感压降会使实际Vout偏离理想式。

**最低控制模块**  
固定频率或窄频DCX开环（200~300kHz待定）+半桥死区管理+SR同步整流时序（含体二极管续流窗口）+原边电流/输出电流保护+外供偏置欠压/驱动互锁。先不引入闭环调压，除非实测Vout不足需微调频。

**磁件必须算的6项**  
1. 单磁件原边匝数/匝比与中心抽头半匝定义；2. 单磁件激励电压（总原边电压/4）及伏秒；3. 各磁件Lm与四者串联等效Lm（对称时相加）；4. 漏感（含外置Lr计入总有效谐振电感，不能排除漏感）；5. 峰值/有效电流与SR电流分配；6. 窗口/损耗/温升与≤10mm机械约束下的磁芯尺寸校核。

**下一交付件**  
一页设计表：四磁件匝数、Lm/漏感目标、Lr与Cr取值、200~300kHz工作点、理想与实际Vout定义对照、SR时序表、并联均流对称性检查表；附未验证项清单。不声称仿真或硬件已通过。
