czy0126/CZY/deepseek/correction_task.md

你此前学习了本次提供的五篇论文，但原始回复被截断，以下是本项目已知事实和裁决，请做一次短工程复核（不超过900中文字）：用户要48V到约2V固定变比，100A连续为目标，≤10mm机械目标，外供偏置；主案半桥LLC DCX、四个3:1:1磁件原边串联，各中心抽头副边整流后并联，频率200~300kHz待设计。不要重复文献综述。
你的上次错误需纠正：1. 每个原边不是Vin/2，应均分总原边电压；Vin/2是半桥谐振腔交流激励幅度，实际变压器电压需解谐振腔。2. 外置Lr时磁件漏感仍计入总有效谐振电感；并不是排除漏感。3. 请固定常见低侧N沟道SR接法：每个中心抽头接VOUT+，两端分别接两个SR漏极，SR源极接VOUT-，极性要让体二极管正确整流；输出电容跨VOUT+/VOUT-。4. 原边串联独立磁芯，在对称条件下等效Lm相加，不能写并联又乘4。5. 损耗不会把48/(2*14)=1.714V抬成1.8V，差异须检查输入点/谐振增益和定义。
请给：唯一连接链；变比关系与适用条件；最低控制模块；磁件必须算的6项；下一交付件；不写未经核实的器件型号与论文页码，不声称仿真或硬件已通过。
