czy0126/CZY/deepseek/task.md

# 48V固定变比DCX：论文学习与首版设计裁决
用户明确：固定变比而非2V闭环稳压，电流和高度由我们选择可行指标。首版暂选48V标称、24:1标称变比、约2V/100A连续目标、200W、总高含PCB和磁芯≤10mm机械目标，允许风冷，外供控制电源；无医疗/车规/安规隔离认证需求。不要默认要求36~60V输入下始终2V。输入范围初评46~50V，输出随输入及损耗变化。
你必须学习下面五篇完整文本，给出一次中文工程裁决，不要泛泛综述，不要声称已做仿真。优先路线：固定频率半桥LLC/DCX、原边串联副边整流后并联的平面磁件、分布式同步整流。候选四个3:1:1中心抽头磁件，总等效原边对半副边12:1，半桥得到约24:1电压变比。必须独立推导而不是相信这个候选。频率200~300kHz仅是起点。
交付：
1. 每篇论文：页码、拓扑、实验或仿真、连续/峰值电流、效率含哪些损耗、磁芯/层数/铜厚/高度/散热条件、控制方法；未提供写未提供。
2. 对比LLC DCX、DPx/堆叠、MASC、移相全桥+倍流，按首样可制造性只推荐一个主案，另一方案仅在明确否决条件触发；不要追求论文功率密度。
3. 给主案完整文字连接、变比推导、每磁件电压和电流分摊、Lr/Cr/Lm设计方法及首轮估值依据；解释Lm的串并联折算，漏感只能计一次。
4. 固定频率振荡/互补死区、原边驱动、SR控制、外部偏置、启动过程的最简实现。候选UCC25600需要核对能否固定设频并软启动及频率边界，不必强行采用；禁止行为PFM模型充当芯片。不要误认为固定变比完全不需要控制。
5. MOSFET、驱动、SR、谐振电容、磁芯的候选型号或筛选指标，缺手册证据的全部标待核；给磁件加工需要的尺寸/材料/Ae/AL/气隙/绕组/铜厚/连接/绝缘/引出/测量项目。
6. 首板PCB关键结构、100A损耗与散热估算，以及下一个应交付的电路而不是新路线报告。
只保留避免直通、磁饱和、SR反灌失控所需的基本死区/软启动/UVLO/电流停机。不扩展复杂监控、冗余基准、通信和自动恢复体系。不能为赶进度把明显不可运行的开环/SR时序当完成。
厂商本地ROHM C-012示例真实参数800V到12V250A，50~100kHz、18V驱动、SiC器件、行为PFM，不能直接缩放照搬。
旧项目146个控制器件仍未整机闭合，不继承保护网络；旧200kHz Lr=0.9285uH Cr=675nF Lm总=5.5725uH仅候选未验证，尤其旧README有串并联术语矛盾。请从连接和磁路重算。
