czy0126/CZY/deepseek/审核说明.md

# DeepSeek 首轮审核
首次API已成功，发送了任务和五篇完整分页文本，总token计数63082；review.md为原始未编辑输出。回复在第3节中途截断，后续器件/磁件/PCB任务尚未完整回答。不得当设计成果或已核实文献表。
不接受项：原边每单元电压与总激励混淆；中心抽头连接含问号；外置Lr时忽略磁件漏感；用损耗解释输出电压上升；将特定论文的功率范围扩展成一般半桥边界。论文层数/效率/散热等详细数值仍须逐页复核。
工程纠正：半桥经串联谐振腔驱动四原边串联；每磁件CT接VOUT+、两绕组末端各接低侧N沟道SR漏极，源极接VOUT-，按点标核整流极性；每组本地电容跨输出。四组整流输出并联。理想对称且谐振附近n等效=4×3=12，Vo≈Vin/(2n)，实际变压器电压受谐振腔与负载影响。总谐振电感包括外置电感和折算漏感，不重复不遗漏。
已完成第二次窄范围纠错，见correction_review.md；回复改善了连接与漏感处理，但变比式仍出现Np/Ns乘反和“1/2?”，因此第二轮变比推导也不接受。正确近似应为Vo≈(Vin/2)×(1/4)×(Ns/Np)=Vin/24（谐振增益约1且对称）。DeepSeek仅作资料提取助手，不能负责电路签核；后续以独立计算和实际仿真检查，停止无效问答扩张。文献精细数据继续待核。
