czy0126/CZY/docs/后续详细路线图.md

# V1之后的执行路线（2026-10-31）
当前入口design/v1/初版设计说明.md；用户要求继续完成，以下是执行依赖，不另设许可门槛。固定变比24:1，100A连续目标，允许风冷/外供控制，初版非投板版。

## 1 当前进度
已完成：两个技能安装、LTspice实际启动及RAW导出验证、DeepSeek分块初稿和纠错、官方芯片手册下载与引脚图复核、修正功率网表及9场输入/负载扫描、逐脚连接表、磁芯候选尺寸和独立计算。
未完成：真实控制和功率联合模型、原生嘉立创原理图、制造级完整BOM、磁件加工图、PCB与热验证。不得把这些列为已完成。

## 2 下一轮：把初版变成可编辑的完整原理图
直接以pin_connections.csv建六页：输入/半桥；谐振腔及四磁件；四组SR；UCC25600/UCC27282；外供偏置/EN/OC；端口/测试点。确认两个MOS封装不同脚号及裸焊盘，原厂引脚图是唯一依据。输出嘉立创原生工程与导出网表，逐项核对CSV与原生网表。
先查本项目easyeda-api的桥连接，选中本项目工程；没有连接时先完成离线设计数据和符号/封装映射，不修改其他项目。技能已安装不代表桌面桥已连接：本轮扫描49620~49629未找到在线桥。运行前读技能并按其文档启动；后台进程用隐藏窗口，客户端需run-api-gateway扩展。
交付：dcx_v1原生原理图、可审阅图、器件脚号/封装核对表。原则：先画现有完整方案，不为额外监控扩页。

## 3 同期最高优先：真实SR与启动验证
从现有.cir派生器件级版本，不替换原始证据。原边引入官方MOS模型及门阻、Coss、自举电容、UCC27282 UVLO和延迟。UCC25600按公式做最小行为实现时必须标自建模型，验证200.6kHz稳态、约276kHz软启动、148.6ns死区及容差；不得以输入电压斜坡冒充实际频率软启动。
SR从单向理想二极管替换成MOS体二极管＋栅极控制：至少含VDS检测、再武装、on/off blanking、延迟、互锁及比例门驱。厂商SIMPLIS模型不能直接当LTspice模型；如必须自建，公开其覆盖和缺失。
场景：标称稳态约10/50/100A，46/50V边界；48V母线先存在再开EN；原副边偏置先后；启动到空输出；轻载停机。输出每只SR VGS/VDS/反向电流、原边VGS/VDS/谐振峰值、输出过冲及自举电压。关断延迟应对照实测di/dt计算反灌，不只看波形好看。
通过条件：无桥直通、无持续反灌、启动不过器件脉冲能力、最小偏置下不误触发；发现具体问题修改电路，不添加泛化故障体系。若UCC24624在此电流/寄生下不可用，再评估更快SR或源极检测，不预先长期维护多路线。

## 4 磁件与采购冻结
T1~T4：先把ELP32+I的窗口尺寸和PCB开槽截面画出来，测量最大9.8mm裸高叠加胶/夹具是否≤10mm。做一件3:1:1绕组工艺样件或加工图，给Np/Ns极性、铜箔展开、端子、绝缘和目标AL。若大磁芯浪费面积或机械超限，只做一次更薄磁芯替换，重新算磁通/窗口/铜损。
把Lm10uH每件、Lr总1uH定义为测量目标：开路副边测Lm，短路各副边测漏感，频率和夹具写清。记录四件分散度；仿真带±10%初评后改成供应商实际公差。Lr独立器件按>13A峰值及饱和裕量设计，计入温升与交流损耗。过流CT单独完成型号、带宽、复位、隔离和引脚核对。
BOM逐行给MPN、厂家、封装、数量、额定、官方依据和嘉立创/立创商城来源；库存需当时查询，缺货替代重新核封装。Cr要核RMS电流，输出电容组合给偏压后容量、总ESR、RMS及高度；否则4mF不能转制造BOM。
交付：正式BOM、四变压器/谐振电感/检测CT三类磁件图及检验表；不是只给磁芯料号。

## 5 PCB布局及制造包
先出1:1机械图和摆件：四磁件一排或2×2，SR紧邻副边、每组本地电容、输出铜排最短。板尺寸按这些器件确定，先不强压面积。外部供电接口远离热区。
嘉立创叠层按其实际可制造选项选择，不能默认4/6层所有层都3oz。绕组可先独立薄板/铜箔模块，主板4/6层候选；在真实层叠里复算窗口、过孔电阻及高度。低压100A主回路可预留焊接铜带/铜排，明确尺寸，不把任意覆铜当100A证明。
走线顺序：半桥高di/dt环路、谐振电流、SR/输出、驱动回路、Kelvin检测、低速EN/OC。逐个检查栅回路和检测回路是否共用功率寄生。预留每组电流及磁芯温度测量位置。
交付：原生PCB、叠层、装配、BOM、坐标、Gerber、钻孔、磁件图、测试规范；ERC/DRC无未解释错误、pad-net与原理图一致。未做真实元件/磁件冻结前可以摆件，但不称可投板。

## 6 实物上电
先测磁件与偏置；无主输入测主驱动频率/死区及EN关断；有限输入电压和限流电源检查SW/自举。逐步到48V，10/25/50/75/100A。每级记录输出、源输入功率、两路偏置功率、MOS/磁芯/电容温度及四组均流。
连续100A必须热稳定并有器件结温余量。负载端用Kelvin量2V左右，输出铜排与负载接点也计损耗。效率=负载功率/(48V输入功率+所有外供偏置功率)。发现额定达不到则报实测可用额定，不用峰值电流替代连续能力。

## 7 DeepSeek后续工作约束
每次只交一个可核对产物：逐脚连接/单一磁件计算/一个模型/一个BOM补全表。传官方手册对应页和当前参数，要求输出有单位及计算式。正文finish_reason=length或为空立即标未完成；不重复长思考消耗。AI给出的网表先静态检查再运行，不能让错误模型生成的PASS替代物理证据。当前重点是元件级模型和原生图，不再要求通读旧项目。
