czy0126/CZY/docs/技能安装与工具链.md

# 技能与工具链
- easyeda-api：项目.agents/skills/easyeda-api，来自本机官方仓库检出D:/workshop/jlc/vendor/easyeda-api-skill，origin https://github.com/easyeda/easyeda-api-skill ，commit d5a0b1c68304ec60fc9387570ffb912764f937b1，版本1.1.56。npm ci --ignore-scripts完成，node --check通过。为Codex发现兼容性将顶层compatibility移入metadata，功能脚本未改。桥连接本轮未检测到；并未创建原生EDA工程。
- ltspice-skill：项目.agents/skills/ltspice-skill，使用系统skill-installer从https://github.com/ZhangHanyu/ltspice-skill安装。runner加WindowStyle Hidden；其余沿用。原仓库许可证保留。
- LTspice实机：D:/ADI/LTspice/LTspice.exe，日志版本26.0.2。smoke.cir、dcx_v1.cir、dcx_v1_sweep.cir运行完成，功率级9场扫描已提取测量结果。转换器以Python源程序运行，PyLTSpice/numpy依赖安装完成；没有伪称编译了EXE。
- 两个技能已进入本项目可发现目录，后续回合可使用。原理图/CAD工具规则不自动扩展成旧项目的流程门槛。
