czy0126/CZY/docs/D1_EXECUTION_KIT/23_PROT03三档数值收敛最新审核与下一步.md

# 第23章：PROT03最新1/2/5 fF审核决策与收敛路线

自动计算：`python tools/prot03_50v_evidence_decision.py --check`，输出 [当前决策JSON](../../design/v3/power_priority/prot03_50v_protection_evidence_decision.json)。本次只分析已经提交的结果，没有创建新的LTspice RAW。

**三种B组控制全部不满足320µs完整配对。** 原控制1fF尾254.980µs；2fF尾264.515µs（日志在xsr3:x2:Bage报收敛失败）；5fF尾235.890µs（超时被杀）。三个cshunt结果不单调，继续建议B2fF“还未运行”属于过时操作。1fF与5fF候选各自跑满，5fF故障前均值0mV偏差；这不改变被杀的控制不完整这一事实。

| B组Cshunt | 控制最后保存 | 是否有完整320µs两侧 | 实际故障 |
|---|---:|---|---|
| 1 fF | 254.980µs | 否 | 1800s超时 |
| 2 fF | 264.515µs | 否 | `xsr3:x2:Bage`数值收敛失败 |
| 5 fF | 235.890µs | 否 | 1800s超时，记录有75次`tolerance relaxed` |

**A组2fF则属于“证据完整而保护峰值无效”**：两边320µs且0mV故障前偏差，但晚于Ipri峰5.074µs才触发，原边、SR的峰值均无下降，I²t减少不足1%。它可以诊断逻辑，但不满足真实削峰保护目标。

既然2fF出错的实际实例名为Bage，应优先用 [第22章的唯一单行行为模型变动](22_B组Bage行为源收敛修复与两组配对试验.md) 做1fF/2fF严格配对与冻结窗口交叉验证。仍不保证该修改就能使控制跑满：如果Bton或Btoff继续停算，需要单独的后续实验，不得在一个版本中同时平滑多个器件而失去因果解释。

**成功判据**：新Bage控制与候选都保存320µs、故障前140–175µs输出均值差≤1mV，同一cshunt、同一模型；与原始v3_3在0–220µs共享窗口的各项关键峰值和门极定时偏差满足明确误差预算；真实原边EN和八SR禁能延时、MOS第三象限SOA及磁件L(I)仍单独认证。任何一个失败都保留`NOT_FOR_FAB`。
