czy0126/CZY/docs/D1_EXECUTION_KIT/21_50V保护A组无峰值收益与B组优先验证.md

# 第21章：50V保护设计决策——A组可配对但对峰值无效，先补B组2fF

这份决策从**已提交的JSON**逐次重算，不声称在本轮运行新的LTspice：`python tools/prot03_50v_evidence_decision.py --check`；结论和数值存于 [可追溯决策JSON](../../design/v3/power_priority/prot03_50v_protection_evidence_decision.json)。

## A组：2fF两侧均320µs、故障前0mV偏差，但不减少初始峰值

- 保护A在 215.023151µs 才触发；同数值辅助条件下对照的原边峰值出现在 209.94941µs，峰值已过去 **5.073741µs**。
- I(Lr)峰在控制和候选均为 **101.069A**；单只SR最大正向峰均 **303.411A**；八SR正向I²t总量只减少 **0.676%**。
- 因此A组可以用于逻辑锁存/保护接口诊断，但**不能按当前阈值与监测时序作为保护高峰值的最终方案**，也不能因为“七项检查全绿”就判为硬件安全。

## B组：1fF旧数据有明显削峰潜力，但严格对照仍不完整

- 1fF行为模型B组候选达到320µs、对照仅到**254.980482µs**；旧报告给出的SR峰值相对下降约 **54.312%**，只是**被截断对照上的仿真改善提示**，不能写成完整故障窗口的定论。
- 必须在同一个2fF参数下完整运行B_CONTROL、B_CANDIDATE，保证双方320µs与140–175µs故障前Vout差≤1mV，并记录8SR与原边门极；即使通过也仍是0.05Ω行为级钳位模型。

## 可直接执行的优先命令

```powershell
python tools/run_d1_50v_matched_cases.py --variant shunt_2f --cases B_CONTROL B_CANDIDATE
python tools/run_d1_50v_matched_cases.py --variant shunt_2f --cases B_CONTROL B_CANDIDATE --execute --run-id solver_2f_B_001 --ltspice 'D:/ADI/LTspice/LTspice.exe'
```

保存新RAW、LOG和运行散列，按 [第18章](18_50V成对数值收敛扫参与执行.md) 和 `tools/protection_candidate_compare.py` 的严格输入参数生成**新命名**的B2fF分析结果；不要覆盖A2fF、旧B1fF或1fF历史报告。真实硬件方案还需对UCC27282 EN延迟、NCP4306 TRIG默认关断和消隐延迟、主副侧偏置失压、MOS SOA独立完成实物验证。
