czy0126/CZY/design/v1/初版设计说明.md

# V1工程初版（2026-10-31）
状态：功率腔可运行仿真＋真实芯片逐脚连接候选；非投板版。DeepSeek原稿经过人工/公式/手册审核，不是原样采用。参数唯一入口parameters.json，逐脚表pin_connections.csv。

## 功率连接
VIN→QH.D；QH.S与QL.D为SW，QL.S→PGND。SW→Cr620nF→Lr总1uH→T1.P→T2.P→T3.P→T4.P→过流电流互感器原边→PGND。Cr提供隔直，不另加输入中点。每个T=3:1:1，各中心抽头接OUT+，两端分别接SR_A/B漏极，各SR源极接OUT-（SGND），四组输出并联。每组就近电容，OUT+与OUT-为同一输出端口。PGND/SGND保持分开；两个12V外供偏置必须能分别浮地。模拟的1G参考电阻不是硬件BOM。

## 控制
U1 UCC25600D：RT976Ω、DT5.36kΩ、SS10nF。GD直接接UCC27282DRCR HI/LI，无栅变。U2用带EN的DRC10脚，不能换成D8脚而沿用引脚号。EN默认下拉、手动RUN跳线，SS短接关断触点。首次启动操作：先保持SS低/EN低，外供偏置稳定，再使能EN并释放SS；首次高侧自举充电行为须实测或建模。
每组UCC24624DR双通道控制SR，12V_S供电，REG2.2uF。VSS经0Ω回本组源极Kelvin点；91Ω提前关断说法已撤回，增加Roffset实际提高关断门槛。每只MOS预设2.2Ω门阻、10kΩ G-S下拉；门阻待真实Qg调节。
最小过流候选：1:100电流互感器→肖特基全桥→6.8Ω负载（整流桥直流端）→100Ω/220pF→OC。理想峰值14.7A约1V触发、29.4A约2V锁存，但CT本体、伏秒、复位和延迟尚未验证；不宣称已实现可靠过流。停止触点同时拉SS低和EN低，初版不自动重启。

## 器件初选
原边CSD19531Q5A×2（100V、5×6mm），SR BSC010N04LS6×8（40V、TDSON-8）。已取得官方手册；热态导通、Coss/Qg和真实SR延迟待联合验证。注意两种5×6封装脚序不同：不能复用同一个通用MOS封装映射。逐个看官方封装图再建嘉立创器件。
谐振电容总620nF可由2×310nF或其他标准组合实现，耐压初评100V，优先低损耗且有RMS电流能力的器件；型号和焊盘尚未冻结。输入20uF/100V低ESR为仿真假设，硬件另配低矮储能电容。输出4mF/0.2mΩ只是模拟等效，需用实际聚合物+MLCC的容量、ESR和RMS电流核算，未选定具体MPN，不得按4mF理想电容下板。

## 磁件初版
T1~T4候选每套TDK B66287G0000X197（E）+B66287K0000X197（I），N97，Ae130mm²。四个均3:1:1，Lm各10uH，AL目标1111nH/T²，无隙件6300nH不能直接使用，需定制研磨/调隙后测量。以μ0*Ae/AL估有效气隙约0.147mm仅作磁路起点，实际包含磁芯磁阻、边缘磁通且不等于垫片厚度。
裸E+I名义9.5mm、最大约9.8mm，10mm目标余量非常小；必须让绕组板进入窗口，不能在磁芯下再叠整块PCB。若夹具/胶层/气隙使总高超标，转更薄磁芯或放宽首样高度，不能宣称已满足10mm。
铜箔首版工艺候选：原边3T，0.1mm铜箔；各半副边1T，可两片0.1mm并联，各层100um左右绝缘起评；宽度必须受实际窗口约束，不采用上轮凭空20mm宽度。加工图需包含展开长度、接头、极性、中心抽头、绝缘和夹紧。漏感实测后，Lr外置=目标总Lr−实测折算漏感；若结果≤0，必须改绕组或谐振参数。
谐振电感是独立需要完成的磁件：约13A工作峰值，目标1uH总量对应峰值能量约85uJ；独立Lr料号、饱和和损耗目前未定。过流CT也是独立磁件，不能与四个功率CT（中心抽头）混淆。

## 目前证据与局限
sim/dcx_v1.cir已实跑；sim/dcx_v1_sweep.cir覆盖46/48/50V与0.2/0.04/0.019Ω共9场。48V/19mΩ下1.89288V、99.625A；不是2V稳压失败，而是固定变比带损耗结果。详细结果见simulation_summary.csv。
采用理想开关、单向SR二极管等效、K=1以及输入0.5ms斜坡，因此不能证明ZVS、SR负电流、芯片启动、自举、保护或热稳定。两只原边MOS Coss未计入，功率比不能称整机效率。测量日志已核对，早期缺保存I(Rload)的测量错误已修复并重跑。
100A设计正弦近似：Ip_RMS9.256A，Ip_pk13.09A，每半副边RMS19.635A。SR热态1.5mΩ时八只总导通约4.63W；原边热态8mΩ合计约0.69W。只为预算，尚未包含驱动、磁芯、铜箔、死区二极管与输出端子损耗。

## 审核退回记录
DeepSeek原版设频电阻、绕组RMS、电压分配、驱动链和网表语法错误已退回；原始回复留在deepseek/v1/。两次thinking调用用完token却无正文，均finish_reason=length，不视为交付；普通模式已完成修订回复，但仍漏脚号，本项目逐脚表依据官方图另行整理。后续不再无界扩展同类问答。
