czy0126/CZY/design/v2/启动OC矛盾_初稿.md

# 启动与峰值过流保护的结构性矛盾（初稿）

日期 2026-10-31。状态：**ENGINEERING_DRAFT / SIMULATION_OBSERVATION**。不是硬件结论，也不主张提高或删除保护。

## 1 实测冲突

| 工况 | 原边 `|I(Lr)|` 峰值 | 来源 |
|---|---|---|
| 额定 48 V / 19 mΩ / 99.6 A 稳态 | 13.23 A | `design/v1/simulation_summary.csv` 第8场（理想SR模型） |
| v2 启动（REG 推迟、SR 已工作）0~1.5 ms | 18.87 A | `sim/v2/startup_seq_long.raw` |
| v2 启动（基线）0~150 us | 17.53 A | `sim/v2/integrated_oc_proxy.log` |
| 7 ms 长跑 | 18.27 A | `sim/v2/integrated_oc_long.raw`（6.706 ms 截断） |
| OC 代理门槛 | 14.7 A（1.0 V / 0.068 V/A） | `integrated_oc_proxy.cir` 的 `Bct` 与 UCC25600 模型 1.0 V 门限 |

结论：启动循环电流峰值比门槛高约 28%，OC 必然在软启动过程中反复触发。7 ms RAW 中 `SS` 在 1.08~1.20 V 反复、`en` 翻转、输出停在约 0.5 V，正是这一极限环，而不是数值发散。**（2026-10-31 更新：换成真实 CT + UCC27282 驱动后，冷启动峰值为 36.00 A（1.5 ms 台）/36.07 A（7 ms 台），见进展文档 §12/§14；本节的 18.9 A 属旧代理台，不可与当前结果混用。）**

## 2 为什么不能简单调门槛

1. `|I(Lr)|` 是谐振腔电流，包含**无功循环分量**；低输出电压/启动段增益低、循环电流大。固定峰值门槛必须同时覆盖额定与启动，否则启动必跳。
2. 提高门槛会削弱真实短路/磁饱和保护。是否可提高到 19 A 以上，必须由以下证据决定，不能由"仿真想通过"决定：
   - 原边 MOSFET CSD19531Q5A 在 48~50 V、对应电流下的 SOA（脉宽按总检测延迟）；
   - 变压器/谐振电感的伏秒与饱和裕量（Lr 目标 1 uH、约 13 A 峰值，18.9 A 已超设计峰值 45%）；
   - CT 传递比、门槛容差、整流桥压降、RC 时间常数与 UCC25600 OC 比较器 60/200/500 ns 传播延迟的最坏组合；
   - 最坏脉冲能量：`E=0.5*Lr*Ipk^2`。取 `Lr=0.92 uH`，若总延迟 0.3/0.5/0.7 us、ON 期间 `di/dt≈Vin/Lr≈52 A/us`，则在实测 18.9 A 之上再叠加 16/26/36 A：
     - 0.3 us → Ipk≈35 A，E≈0.56 mJ
     - 0.5 us → Ipk≈45 A，E≈0.93 mJ
     - 0.7 us → Ipk≈55 A，E≈1.39 mJ
     这些是**上界估算**，需用实际 CT/比较器延迟与 Lr 饱和特性复算。
3. 设计上更优先的方向是**降低启动循环电流**：核对 291 kHz 起始频率是否真的把增益压住、SS 斜率是否让频率过快穿过高增益区、输出电容 4 mF 的充电电流预算是否与 100 A 负载叠加。不得用"输出预充到 2 V"冒充冷启动。

## 3 可选路径（按优先级）

1. **先量化**：真实 CT + 整流桥 + 负载 + RC + UCC25600 关断路径，逐项给传递比、阈值误差、伏秒、复位、总延迟与最坏脉冲能量（交接书任务2原文）。
2. **再降流**：在不改保护门槛的前提下，用起始频率/SS 斜率/死区把启动峰值压到 14.7 A 以下；每次只改一个参数并复测 0~0.2/1.5/7 ms。**2026-10-31 实测否证 SS 斜率：Css 10n→50n 只把首个 GD2 从 70.8 移到 344.8 µs，峰值 36.0046→36.0095 A（+0.014%）；36 A 是 SS=1.2 V/291 kHz 的首周期谐振腔阶跃响应。SS 斜率只压住第二个 22.6 A 浪涌（→6.8 A），代价是输出建立变慢、SR 推迟。见进展文档 §14。**
3. **最后才评估门槛/检测方式**：若降流后仍无法兼顾额定与启动，评估把检测改为平均电流/输入电流或增加启动屏蔽窗；任何改动都要有 SOA 与伏秒证据。

## 4 不能据此声称

- 18.9 A 是 v2 替身 + 理想 OC 代理的结果，不是 BSC010N04LS6/CSD19531Q5A 的实测应力。
- 7 ms 未出现 `Total elapsed time`，不能称"启动完成"或"启动失败已定位到唯一原因"；目前只证明 REG 修复不能单独解决启动。
- `|I(Lr)|` 峰值不是输入平均电流，也不是变压器励磁电流；不能拿它直接推断磁饱和。
