czy0126/CZY/design/v2/启动时序证据_REG延后实验.md

# 启动时序定点实验：REG 推迟使能可恢复 SR 预武装

日期 2026-10-31。状态：**SIMULATION_EVIDENCE_NOT_HARDWARE_VALIDATED**。本文件只记录可复跑的仿真事件，不作为硬件签核。

## 为什么做这个实验

交接书任务3指出：UCC24624 要求 REG 上升穿过 VREGON（4.1/4.5/4.8 V）之前，至少一路 VD 相对 VSS 超过 VTHARM（1.4/1.5/1.7 V）；而 `integrated_oc_proxy.cir` 用理想 PWL 在 110~130 us 之间把 REG 从 0 拉到 11 V，没有证明这个顺序在允许窗口内发生。先前的 `verification_results.json` 记录：该台 `pre_end=0`、`sr_gate_max=0`、`vout_avg=0.326 V`，即 SR 完全没有启动。

## 实验设计与复现

- 基线：`sim/v2/integrated_oc_proxy.cir`，REG PWL `(0 0 110u 0 130u 11 1m 11)`。
- 处理：`sim/v2/startup_seq_test.cir`，只改 REG 时序为 `(0 0 130u 0 150u 11 1m 11)`，其余功率级、控制、SR 替身、OC 代理完全相同。
- 运行：直接批处理 `D:/ADI/LTspice/LTspice.exe -b sim/v2/startup_seq_test.cir`，`.log` 含 `Total elapsed time: 2.236 seconds`，全部 `.meas` 有值。
- 波形：`design/v2/startup_sequencing_evidence.png`（`tools/plot_startup_evidence.py` 可重绘）。

## 实测

| 量 | 基线 110~130 us | 处理 130~150 us |
|---|---|---|
| REG 1 V 时刻 | 111.83 us | 131.83 us |
| REG 4.5 V 时刻 | 118.18 us | 138.18 us |
| REG 1~4.5 V 窗口内 max VD | a1 1.155 V / b1 1.158 V | 窗口前 VD 已超过 1.5 V |
| `PRE1` @140 us | 0 | 0.99999 |
| `ga1` 最大值 | 0 V | 6.936 V |
| `VOUT_AVG` 250~300 us | （基线只跑到 150 us） | 0.493 V |
| `IPRI_PK` | 17.53 A | 18.96 A |
| `SR_REVERSE` | ~0 A（SR 未开） | 9.06 A |

关键时间点（基线 RAW）：b1 首次 >1.5 V 在 80.16 us，a1 在 103.47 us，均在 REG 开始爬升（110 us）之前；但在 REG 的 1~4.5 V 窗口内，VD 峰值只有 1.155/1.158 V，因此 `SR_TIMING` 的预武装逻辑在整个窗口内看不到合格脉冲，`PRE1` 永不置位。

## 解释

1. **REG 顺序是决定性变量**：同一功率级、同一 OC 代理，仅把 REG 使能推迟到 VD 已经反复超过 1.5 V 之后，`PRE1` 即锁存，SR 门极开始开关。这支持任务3的 ECO 方向：用"VD 合格"作为 SR 偏置使能条件，而不是固定等待时间。
2. **SR 启动不是输出达不到 2 V 的原因**：处理组 SR 已经工作，但 250~300 us 输出仍只有 0.493 V，原边峰值 18.96 A。7 ms 长跑 RAW（实际写至 6.706 ms，无完成标记）显示输出在约 0.5 ms 冲到 1.245 V 后跌回约 0.5 V 并进入极限环：`SS` 在 1.08~1.20 V 之间反复、`xctl:en` 在 0/1 之间翻转、OC 代理峰值约 1.21 V（按 `6.8/100` 比例约 17.8 A，超过模型 1.0 V/14.7 A 门槛）。这是**过流/软启动重启极限环**，与 SR 预武装是两个独立问题。
3. v1 稳态数据（`design/v1/simulation_summary.csv`，48 V/19 mΩ/99.6 A）给出 `ipri_pk=13.23 A`，因此 14.7 A 门槛只比额定峰值高约 11%。启动峰值 18~19 A 必然触发该代理；不能靠删保护或直接抬高门槛解决，需按任务2用真实 CT/复位/延迟与软启动电流预算处理。

## 1.5 ms 有界续跑（判断 REG 修复能否独立解决启动）

`sim/v2/startup_seq_long.cir`：同一 REG 推迟方案，`.tran 0 1.5m 0 30n uic`，15.851 s 完成，全部 `.meas` 有值。

| 量 | 实测 |
|---|---|
| `PRE_AT_1M` | 0.99913 |
| `VOUT_AVG` 1.2~1.5 ms | 0.53965 V |
| `VOUT_MAX` 0~1.5 ms | 0.62583 V |
| `IPRI_PK` | 18.868 A |
| `SR_REVERSE` 1.2~1.5 ms | 9.200 A |
| `SR_GATE_MAX` | 6.689 V |

轨迹：输出在 0.1 ms 后一直停在约 0.48~0.57 V；`SS` 在 0.96~1.20 V 之间振荡（0.2 ms 后 max 1.203/min 0.964），原边峰值稳定在 18.0~18.9 A。说明 **SR 预武装修好后，启动仍被 OC/软启动极限环卡住**，两个问题必须分开处理，不能把 REG 延后当成启动方案的全部。

## 不能据此声称

- 两个电路都用 v2 替身：固定 Ron 双向开关、未校准 PGD、理想 `abs(I(Lr))` OC 代理；`REG` 是外部理想 PWL，不代表 12 V→内部 REG 的真实启动电流与 2.2 uF 动态。
- 9.06 A 的反向沟道电流只说明"SR 已开且替身模型会反灌"，不是 BSC010N04LS6 的定量预测。
- 0.493 V 不是"启动失败"的最终结论；它只定位到 OC/软启动极限环，尚需最小功率闭合与真实 CT 才能判定。
- 未证明四组共用同一许可有效；本实验只观察了第1组（`pre1/ga1`）。

## 下一步（与交接书任务2/3对齐）

1. 做最小功率闭合（单组 12:1 等效、真实 CSS10n/RT976/DT5.36k、自举、真实 CT），先把"有限电流启动进入正常工作"跑通。
2. 偏置 ECO：VD 合格→REG 使能的最小开关/受控使能，逐组核对，含输入先有、偏置先有、副边晚起/掉电/恢复。
3. 用 `models/sr_device_v3.lib`（本轮工作流产出，待验证）替换固定 Ron，复测反向峰值/电荷/损耗。
