czy0126/CZY/design/v2/真实控制与SR验证进展.md

# V2：真实控制行为与SR换流验证进展
日期2026-10-31。结论：从理想整流推进到了器件手册约束的控制替身、双向SR换流台与150us启动联合仿真；**未完成真实器件全流程签核，不可投板**。

## 本轮实际交付
- models/ucc25600_legacy_behaviour.lib：从旧项目选择性复用的UCC25600自建行为模型，有来源和明确缺项，不是TI模型。未迁入旧项目保护网络。
- models/sr_timing_v2.lib：新建SR时序替身，含预启动资格、UVLO迟滞、每路再武装、连续开通延时、on/off blanking、关断延时、双通道请求仲裁与有限门极电容。驱动标称源6.5Ω/灌0.9Ω加2.2Ω外阻，源/灌电流限幅1.5A/4A。
- sim/v2/controller.cir：真实RT976Ω、DT5.36kΩ、CSS10nF的控制模型台。
- sim/v2/sr_good.cir、sr_bad_order.cir、sr_simultaneous.cir：正常时序、反序、同时请求及短脉冲过滤台。
- sim/v2/sr_commutation_sweep.cir：40A峰值、200kHz正弦强迫电流、双向MOS通道＋体二极管＋电容，扫描5.5/23/40ns关断延时、PGD关/开共6场。
- sim/v2/sr_timestep_check.cir：最大步长2ns→1ns对照；sr_slow_off_negative.cir：200ns异常关断延迟负对照。
- sim/v2/integrated_pgd_sweep.cir：48V母线预先存在，控制、自举、双向SR和四磁件功率链0~150us启动联合模型；两场PGD敏感度。
- sim/v2/integrated_oc_proxy.cir：加入理想CT幅值+RC滤波的过流代理。CT真实磁路/桥压降/复位尚未建模。
- tools/summarize_v2.py：从实际.log/.raw汇总，检查电流符号，输出verification_results.json、sr_commutation_results.csv及sr_commutation.png。

## 2026-10-31 追加：v3 真实器件接入换流台（任务1阻塞项已解）

审核方 §7 阻塞项 1 要求把 `SR_DEVICE` 接进换流台、删除外部 `Cda 2n`、重出 1ns/2ns、PGD 开/关、200 ns 负对照四组数字。已完成，详见 `design/v2/sr_commutation_v3_results.md`。

- 台架：`sim/v2/comm_v3/sr_commutation_v3.cir`（sha256 `8ba8a77e…`），`Xsr1 da gda 0 SR_DEVICE` / `Xsr2 db gdb 0 SR_DEVICE`，外部 `Cda/Cdb` 已删；时序模型未改动。新增 17–22 µs 干净窗口及 Qrev/Qg/门耗/体二极管/沟道能量 `.meas`。
- 对照：`sr_commutation_v3_ideal.cir`（同 v3 时序、同激励，只把器件换成理想开关＋体二极管＋2 nF），用于把器件效应与 v2→v3 时序模型差异分开。
- 器件 vs 理想（PGD=0、23 ns）：反向峰值 **2.171 vs 9.819 A**，Qrev **69.06 vs 977.3 nC**，体二极管能量 **5.851 vs 1.743 µJ**，沟道 2.894 vs 3.061 µJ，门耗 0.617 µJ（理想侧 0），合计 9.362 vs 4.804 µJ。
- 机理：封装电感使 OFFTH 在 29.7 A 提前触发（I·Rds=−26.6 mV，`(Ld+Ls)·di/dt`=+37.1 mV）；沟道在 25.45 A 关断，gate<1 V 口径体二极管尾 5.01 µJ/事件（首次二极管导通口径 5.59 µJ），若沟道承担仅 0.113 µJ，多出 0.98–1.10 W/SR@200 kHz。
- PGD=1（未校准律）：40 A 时 Rds 0.8956→1.1931 mΩ，触发 6.61 A，尾 0.085 µJ，总 4.452 µJ/周期；这是敏感性示例，不能用于选型。
- 1ns/2ns 最大差 1.44%（EBD，200 ns+PGD1），其余 ≤1.17%；200 ns 负对照方向随触发相位改变，不是无条件“延迟越大越差”。
- 限制：5.0 µJ 是 gate<1 V 口径、慢驱动器（3.1 Ω RC、94 ns 下降）下的**下界**；完整端电压约 5.59 µJ，真实控制器门边沿外推约 6–6.5 µJ。Roffset（VSS 330 µA）已用行为等效实跑（详见 `sr_commutation_v3_results.md` §8）：PGD=0 时 **120 Ω 最优**（总 3.712 µJ、EBD 0.820、QREV 48.6 nC、关断尾 0），100 Ω 次之（3.989/0.995/68.3），**150 Ω 反弹**（5.228/1.771/1.20 µC），**212 Ω/PGD=0 完全不关断**（IREV 40 A、QREV 63.7 µC）；100–120 Ω 只是 40 A 台架最优，不是手册上限 212 Ω，也不是全负载单一值——10/25/40 A 扫描（`sr_commutation_v3_results.md` §9）显示 10/25 A 下 VDS 峰值仅 16.47/41.17 mV，达不到 43.5/50.1 mV，SR 整周期不关断（QREV 15.9/39.8 µC）。低门槛扫描（§10）进一步给出最优值随负载移动：**10 A→0 Ω、25 A→50 Ω、40 A→120 Ω**；0 Ω（=无偏置基线）在全负载可关断，但 40 A 一致口径 9.521 µJ，比 2 ns 基线 9.362 多 1.7%（步长效应），没有收益；15 Ω 也全负载触发但 10 A 已坏 11 倍。数据手册确认无每通道最大导通时间/看门狗，但有 CH1 频率待机判据（<9 kHz/7.5 ms 进 standby、停门极），模型未实现；`VTHOFF` 2/10.5/18 mV 与 330 µA 260–400 µA 的角分析见 §11，10 A 角更差。**330 µA 仍是行为等效，不是 VSS 引脚；260–400 µA 与 `VTHOFF` 2–18 mV 容差已在 §11 做角分析（本台架内无固定 Roffset 可覆盖，不据此关闭 0 Ω 基线），真实 VSS 阻抗、双 SR 换流台/Kelvin 未做。** PGD 律未校准；封装寄生为 ESTIMATE；Kelvin 因时序模型单 S 引脚未跑；无温度/SOA。数值完成 ≠ 硬件验证。

### 2026-10-31 追加：Roffset 行为等效扫描（任务1第一优先实验）

审核 A1 的 330 µA 缺项已用 `models/sr_timing_v3_roff.lib` 补上：浮置 `330 µA + Roff` 回路把检测节点 sv 抬高，比较器用 `V(D,sv)`，栅极回路仍回 S；冻结 `sr_timing_v3.lib` 未改。台架 `sr_commutation_v3_roff.cir` 扫 1 µΩ/100/120/150/212 Ω × PGD0/1，57 项测量、10 场、3.641 s、无错误；1 µΩ 复现冻结 v3 到 4 位。详见 `sr_commutation_v3_results.md` §8。

- 门槛律：实测 43.50/50.10/60.00/80.46 mV 与 `10.5 mV+330 µA×R` 逐位一致。
- PGD=0：**120 Ω 最优**，总 3.712 µJ（基线 9.362）、EBD 0.820（5.851）、QREV 48.6 nC（69.1）、关断尾 0；100 Ω 尾 0.161、总 3.989、QREV 68.3；150 Ω 总 5.228、QREV 1.20 µC；212 Ω 不关断（IREV 40 A、QREV 63.7 µC）。
- 结论：40 A 台架下可用点是 **100–120 Ω**（仅此负载；§9–§10 已证明它不是 10–40 A 的单一设计值）；212 Ω 是 VSS 偏置绝对上限，不是 40 A 工作点。约 0.69 µJ 的关断前段用 Roffset 压不掉，0.5 µJ 只是“关断尾”目标。

### 2026-10-31 追加：Roffset 负载扫描（10/25/40 A）

固定门槛的负载依赖性必须实测，不能只靠 40 A 台架。单案例台（无 `.step`，`TMAX=10n`，每场 0.19–0.29 s）跑 10/25/40 A × 100/120 Ω，PGD=0。详见 `sr_commutation_v3_results.md` §9。

- 10 A：VDS 峰值 16.47 mV、VGS 保持 10.89 V，**不关断**，QREV 15.9 µC，ECH 0.263 µJ。
- 25 A/100 Ω：VDS 峰值 41.17 mV，**不关断**，QREV 39.8 µC，ECH 1.642 µJ；25 A/120 Ω 数值未跑完，由 25 A/100 Ω 推断同样不关断。
- 40 A：正常关断，100 Ω QREV 68.5 nC/EBD 1.022 µJ/总 4.027 µJ；120 Ω QREV 48.5 nC/EBD 0.824 µJ/总 3.717 µJ，与 §8 的 2 ns 结果一致。
- 机理：可用端电压由 `L·di/dt` 主导并随负载线性下降，43.5/50.1 mV 在 10/25 A 达不到，比较器不翻转；`SR_CH3` 无最大开通时间/看门狗，`Btoff` 只在 `V(D,sv)>OFFTH` 时提交关断，于是 SR 整周期导通。
- 结论：**固定 Roffset 不能覆盖 10–40 A，120 Ω 不能作为四组冻结的单一值。** 轻载 Etot（0.265 µJ）低只是“没有关断事件”的假象，属功能失效，不是低损耗工作点。数值结果不是硅片行为断言。

### 2026-10-31 追加：低门槛扫描与 di/dt 机理（§10）

§9 只测了 100/120 Ω；本节扫 0/15/25/50/75/85 Ω（补齐 10/25/40 A），并用固定斜率梯形电流做机理探针。详见 `sr_commutation_v3_results.md` §10。

- **最优 Roffset 随负载移动**：10 A→0 Ω（IREV 0.92 A、QREV 42.5 nC、总 1.188 µJ）；25 A→50 Ω（总 2.314、EBD 0.688）；40 A→120 Ω（总 3.717、EBD 0.820）。Etot 统一含门耗（EBD+ECH+EGE）。
- 10 A 的可用窗口极窄：15 Ω 名义触发但 IREV 3.32 A/QREV 476 nC，比 0 Ω 差约 11 倍；≥25 Ω 完全不触发（QREV 15.9 µC）。25 A 也有“能触发但坏触发”的窄带：75 Ω IREV 3.83 A/QREV 264 nC，85 Ω 8.12 A/1.13 µC。
- 全负载可关断的固定值不止 0 Ω（15 Ω 也触发，但 10 A 已坏 11 倍；≥25 Ω 在 10 A 失效）。0 Ω 是质量最好的，且它**就是无偏置基线**：一致口径 40 A = 9.521 µJ，比 2 ns 基线 9.362 多 1.7%（步长效应），即没有任何 Roffset 收益。（初版表漏加 0.618 µJ 门耗，曾误记 8.903 µJ“好 5%”。）
- 数据手册只给出 CH1 平均频率待机判据：`tONMIN=475 ns` 是最小开通消隐，关断只由 VDS 越过 `VTHOFF` 触发；§8.3.6 的 <9 kHz/7.5 ms 进 standby、停门极与 >15.6 kHz/7.5 ms 恢复，**不能推出所有故障状态的硬上限或固定周期**，本模型也未实现待机。`VTHOFF` 规格 2/10.5/18 mV，在本台 1.647 mV/A 斜率下最坏 18 mV 的片子即使 0 Ω 在 10 A（峰值 16.47 mV）也不关断；真实 LLC 须用自己的 `L·di/dt` 重算。
- 梯形探针（固定 50 A/µs）显示 120 Ω 在 10 A 也能关断，但该台关断后被 4 V 钳位吸收电流、且 0 Ω/120 Ω 结果几乎相同，只能作 di/dt 机理提示，不能定量。
- 结论：**决策变量是 `L·di/dt`；本机 LLC 的 di/dt≈2πf·I 又随负载变化**，所以固定 Roffset 只在单一负载成立，只能在轻载功能与重载收益之间二选一。门槛律 `OFFTH_opt≈(0.76–0.91)·(Ld+Ls)·di/dt`（由 10/25/40 A 三点反推）。下一步需要双 SR 换流台、按真实 Lr/频率/负载算 di/dt。

### 2026-10-31 追加：`VTHOFF`/330 µA 规格容差角（§11）

§8–§10 全用 typ 值；本节把手册的 `VTHOFF` 2/10.5/18 mV 与 VSS 偏置 260/330/400 µA 组成 12 个实跑角（10 A/18 mV 为解析判定，见下）。详见 `sr_commutation_v3_results.md` §11。

- **VDS 峰值对负载严格线性：1.647 mV/A**（10/25/40 A 实测 16.47/41.17/65.87 mV）。由此 `I_min = VTHOFF_eff / 1.647 mV/A`。
- **40 A/120 Ω 的 worst-case 角完全不关断**：18 mV + 400 µA×120 Ω = **66.0 mV**，比实测峰值 65.87 mV 高 0.2%；IREV 40 A、QREV **63.66 µC**（typ 角 48.5 nC，差 1300 倍）、EBD 0。
- **25 A/50 Ω 的 worst-case 角**（38.0 mV vs 41.17 mV 峰值，裕量 3.2 mV）仍关断但 IREV 1.60→7.16 A、QREV 56→874 nC，恶化 15 倍。
- **0 Ω 也救不了 10 A/18 mV**：峰值 16.47 mV < 18 mV，而 Roffset 只能抬高门槛；0 Ω 的最小可关断负载是 10.9 A（max 片）/ 6.4 A（typ 片）。
- **降门槛不等于更安全**：10 A 从 10.5 降到 2 mV，EBD 0.357→1.665 µJ（4.7×）；40 A 5.999→7.992 µJ。最优门槛在内部，不是越低越好。
- 结论：**在本受迫正弦台 + 估计寄生 + 未校准 PGD 下，没有任何固定 Roffset 能在规格散布下覆盖 10–40 A**；0 Ω 与 120 Ω 分别在轻载、重载以“完全不关断”失效。这**不构成“固定电阻方案关闭”**，0 Ω Kelvin 基线仍为默认候选、Roffset 保留调试焊盘；是否改检测方式或控制律，须由双 SR 真实换流台决定。数值完成 ≠ 硬件验证。

### 2026-10-31 追加：任务2 真实CT启动与过流动作（§12）

台架：`sim/v2/startup_ct.cir`（0–1.5 ms）、`startup_ct_long.cir`（0–7 ms）、`startup_ct_fault.cir`（0–5 ms，3.95 ms 投入 1 mΩ 硬短路）；变体 `*_f10`（Cf 47n→10n）、`*_f10_c1`（再改 Coc 10n→1n）。全部 `uic`、输出电容从 0 V 起，是冷启动，无预充。**数值结果，非硬件验证。**

CT 设计：原边 1 匝（`Lct1=2 µH`）、副边 100 匝（`Lct2=20 mH`）、K=0.9999，串在 Cr 与 Lr 之间；桥式整流 DSCH；10 Ω 负载；1k/47n 滤波；10k/24k 分压 + 10n 送 UCC25600 OC 脚。折算到原边负载 10 Ω/100²=1 mΩ，不改变功率级。副边只经 `Vctg` 接原边地，不主张隔离。

**结果1：7 ms 冷启动跑通。** Vout 1 ms 1.739 V、3 ms 1.869 V、5 ms 1.908 V、6.5–7 ms 均值 **1.911 V**（峰 1.926 V）。OC 最大 **0.556 V**（<1.0 V 门槛，未触发），CT 副边峰 0.361 A（×100=36.1 A），原边峰 **36.07 A**（启动浪涌），SR 门极 8.36 V、反向 12.33 A，PRE1 0.993（资格已建立）。**2026-10-31 独立重跑**（`python tools/run_decks.py sim/v2/startup_ct_long.cir`，73.3 s 完成，无错误标记）：`vout_1m` 1.7388497591、`vout_3m` 1.86940090296、`vout_5m` 1.90780159359、`vout_avg` 1.91113883461、`vout_max` 1.92622435093、`oc_max` 0.556017756462、`ict_pk` 0.360634893179、`ipri_pk` 36.0671844482、`sr_gate_max` 8.35616874695、`sr_reverse` 12.3310022354、`pre_at_7m` 0.993161678314——与上文逐项一致；旧的“未独立重跑长仿真”保留意见据此撤销。对照：同功率级、瞬时 `abs(I(Lr))` 代理的旧台停在 0.326 V、SR 未起——**结构性矛盾出在代理的 14.7 A 瞬时门槛，不在启动本身**。

**结果2：OC 确实动作（1 mΩ 短路 @3.95 ms）。** 4.0013 ms 触发（延迟 **51.3 µs**），门极在同一个时间步拉低（模型不含比较器/驱动传播延迟，见下）。峰值 **73.68 A**（3.9697 ms，即触发前 20 µs 已达峰）；fault→trip 的 **I²t=105.2 mA²s**，按 CSD19531Q5A 6.2 mΩ 折算 **0.65 mJ**，>50 A 持续 21.8 µs。V(oc) 峰 1.18 V<2.0 V→**打嗝不闩锁**，之后 4.3496/4.6637/4.9795 ms 重复触发（周期约 314 µs），输出跌到 0.35 V。5 ms 内 CT 副边 0.7367 A×100=73.67 A，与 `I(Lr)` 逐位一致，传递比成立。

**结果3：关断/再启动。** `startup_ct_restart.cir`：4.5 ms 撤母线、4.6 ms 撤辅助电源，6.0/6.1 ms 恢复，跑到 9 ms。Vout 4.4 ms 1.879 V → 5 ms、6 ms 均 ≈0（4 mF×20 mΩ，τ=80 µs，完全放电）；再启动后 8.5 ms **1.843 V**、8.5–9 ms 均值 **1.851 V**（SS 从 0.18 V 重新爬坡、尚未到顶，故比冷启动的 1.911 V 低 3%）。再启动浪涌峰 **14.05 A**（冷启动 36.07 A），OC 最大 0.539 V 未跳，SR 门极 5.18 V、PRE1 0.991——SR 重新建立资格。注意 SS 放电到 0.18 V 而非 0 是模型的 `RDIS` 建模选择（O-R184-SSDIS），不是手册值。

**驱动版复跑（`sim/v2/startup_ct_restart_drv.cir`，9 ms，101.0 s，exit=0）。** 同一激励、同一测量，只把自举替身换成 UCC27282 行为模型（EN=VDD=aux，撤辅助电源即停驱动）。撤电期间驱动确实关断：|V(ho,sw)| ≤4.1×10⁻⁵ V、V(lo)=0，Cboot 保持 10.31 V；6.1 ms 恢复后首个 LO 6151.166 µs、首个 HO 6152.466 µs（再次 GD2 先起），6.2–9 ms Vboot 11.09–11.32 V。量化对比（驱动/行为）：Vout@4.4 ms 1.88407/1.87886 V（+0.28%）、@8.5 ms 1.83373/1.84294 V（−0.50%）、8.5–9 ms 均值 **1.84325/1.85053 V**（−0.39%）、峰 1.90415/1.90979 V、再启动浪涌 **14.0386/14.0538 A**（−0.11%）、OC 峰 0.53701/0.53926 V（未跳）、SR 门极峰 5.0425/5.1835 V（−2.72%，最大差异）、PRE1@9 ms 逐位相同 0.991177；5/6 ms 输出两者均 ≈0。重启轨迹与故障台因此统一到同一驱动基线；2.72% 最大差异出现在 SR 门极恢复瞬态，不是功率级。

**分段一致性。** `startup_ct_02.cir`（0–0.2 ms，1.4 s 跑完）与 1.5 ms 台（同激励、同模型，仅停止时间不同）的**峰值指标逐位相同**：`ipri_pk` 36.0671844482 A、`ict_pk` 0.360634893179 A、`ocd_max` 3.57188892365 V；0.2 ms 时 Vout 1.71819 V、OC 0.41037 V、PRE1 0.99994。但**逐采样并非逐位相同**（停止时间不同会改变步长控制）：0–0.2 ms 公共段 `I(Lr)` 最大差 13.8 mA（峰值的 3.8×10⁻⁴）、`V(out)` 最大差 24.8 µV、`V(pre1)` 相同。因此只能主张“指标一致、波形在 0.04% 内一致”，不能主张逐位一致。0–0.2/0–1.5/0–7 ms 三段不互相矛盾。

**发现A：决定延迟的是 OC 脚网络，不是 CT 滤波。** 触发瞬间 `V(oc1)=2.92 V`，而 10k/24k 直流分压只该对应 1.42 V——10 kΩ 经 10 nF 的 τ=100 µs 在事件期内根本没建立。改 Cf 47n→10n：延迟 51.3→**30.2 µs**；再把 Coc 10n→1n：**13.0 µs**。三档峰值 73.7/73.2/**65.0 A**，I²t 105.2/55.6/**12.2 mA²s**（0.65/0.34/**0.08 mJ**），>50 A 21.8/13.9/5.3 µs（时长按右端点采样计数，即在 `t[k+1]` 处判阈；左端点法会少算 0.2–0.3 µs，复核时须用同一约定）。**峰值由短路瞬间谐振腔的 di/dt 决定，检测快慢只改变持续时间与 I²t。** 启动裕量随检测加快变薄：V(oc) 峰 0.556/0.556/**0.731 V**，对 1.0 V 门槛裕量 1.80/1.80/**1.37**。

**发现B：CT+RC 是平均值检测，不是峰值检测。** 设计稿“20 A 峰值→1 V”不成立：实测触发时前 5 µs 的周期均值 `|I(Lr)|` 为 **44.2/42.4/39.0 A**，而瞬时峰值 20–65 A 随触发相位与滤波变化。启动浪涌因 SR 导通接近方波（均值≈峰值），短路电流是脉冲波形（均值/峰值≈0.6），同一门槛在两种波形下对应的峰值差约 1.6×——**这是阈值误差的主因，远大于电阻/二极管容差**。门槛必须按“周期均值”定义并给出波形系数，不能写成峰值 20 A。

**发现C：73.7 A 超过 Lr 设计峰值 13 A 的 5.7 倍。** 故障前 3.80–3.95 ms 的稳态原边峰值只有 **11.6 A**（RMS 4.4 A），短路把它推到 73.7 A（**6.4×**）；>30 A 持续 115 µs。模型 Lr 线性；真实磁件在 65–74 A 下很可能饱和，di/dt 更大，实际峰值应更高。把检测缩到 13 µs 后峰值仍有 65 A（累计 >30 A 115 µs 含打嗝重试，主事件是 3.95–4.001 ms）。**SOA 已按 CSD19531Q5A 图10 数字化核对（单脉冲、TC=25 °C、RθJC max 1.0 °C/W，±10%）：48 V 处 10 µs 边界 79.3 A、100 µs 15.5 A、1 ms 4.0 A、DC 0.4 A（56 V：62.8/12.1/3.0/0.3 A），平台 ≈308 A ≈ IDM 337 A。** 73.7 A 峰值落在 VDS≈0.5 V 的导通段（台架 8 mΩ→0.59 V；真实 6.2 mΩ→0.46 V，手册 25 °C max 6.4 mΩ 时各项差 3%，不改变结论）：51.3 µs 窗内沟道能量 **0.65 mJ**、均值 12.7 W，以 RθJC 直流值作保守上界 **ΔTJ≤13 °C**；73.7 A 仅为 IDM 的 22%。48 V/73.7 A 只在换流交叠期出现：交叠 100 ns 折 **0.18–0.35 mJ**，是 10 µs 边界能量（38 mJ）的 0.5–0.9%；但 73.7 A 距 10 µs 边界 79.3 A 只差 ~7%，在数字化误差内，**不能把 73.7 A 当成可在 48 V 下持续 10 µs 的点**。**结论：在这条模型波形下 MOSFET 的 SOA 不是约束，约束是 Lr/主变压器的饱和电流。** 模型 Lr 线性 0.92 µH（73.7 A 储能 2.5 mJ，是 13 A 设计点的 32 倍）；真实磁件按 13 A 峰值设计，65–74 A 大概率饱和，饱和后 di/dt=V/L_sat，峰值与 I²t 都高于台架。台架主开关是行为开关（Ron=8 mΩ、无 VDS/IDS 交叠），**仿真本身不能证明 SOA**；以上是手册解析核对 + 波形能量核算，不是器件级验证；Lr 的 Isat 规格未定，但 §14 已把需求下界量化为启动 ≥36 A、故障 ≥65–74 A。

**CT 链逐项（任务2要求）。** 传递比：1:100；V(oc)=0.706·(0.1·I_pri,mean−2Vf)（直流），Vf≈0.63 V（DSCH @0.2 A）→ 直流门槛 ≈**27 A 均值**；故障瞬态因上述分压滞后，实际推到 ≈**42 A 均值**。阈值误差：负载电阻 ±1%、分压 ±1%、Vf 两颗 0.5–0.8 V（温度/批次）在 1 V 门槛处折算约 ±6 A（±15%），加上波形系数 0.6–0.9 → 峰值口径 ±25%；UCC25600 OC 规格：Level-1 跳闸 **0.9/1.0/1.1 V**（上升），恢复 **0.5/0.6/0.7 V**（下降），Level-2 闩锁 **1.8/2.0/2.2 V**，比较器延迟 **60/200/500 ns**（均手册 min/typ/max）；此前把 0.6/2.0 当作门槛容差是误读。四角实跑见本节末。伏秒：副边峰压 3.6 V（20 A 设计点）/7.3 V（故障），半周 2.5 µs，取 Ae=10 mm²、N=100 → ΔB≈9/18 mT，对铁氧体 0.4 T 有 ≥20× 裕量（**设计校核，磁芯未选型**）。复位：谐振腔电流为交流，每半周自然复位，桥后单向负载不应有磁通累积（需实测确认）。总延迟：CT+整流 <1 µs（模型）、Cf 47 µs（或 10 µs）、Rd1·Coc 100 µs（或 10 µs）、UCC25600 OC 比较器 60/200/500 ns（手册，模型未含）、驱动关断约 0.1 µs——**仿真的 51 µs 在真实器件上还要再加 ~0.2–0.7 µs**。最坏脉冲能量：0.65 mJ（慢检测）/0.08 mJ（快检测），按 6.2 mΩ 折算的沟道部分，未含体二极管与磁件。

**结论与ECO顺序。** 真实 CT 解掉了“启动必跳 OC”的结构性矛盾，OC 也确实动作；但 (a) 65–74 A 峰值远超声明的 Lr 13 A 设计峰值；MOSFET 的 SOA 已核、不构成约束（发现C），未核的是 Lr/主变压器饱和，这是当前真正的电气上限；(b) 加快检测（Coc≤1n、Cf≤10n）把 I²t 降到 1/8.6，代价是启动裕量从 1.80× 降到 1.37×。**原定的“先按 `启动OC矛盾_初稿.md` 路径2 用 SS 斜率降浪涌”已被 §14 否决：首周期 36 A 与 Css 无关（5× 慢扫峰值 +0.014%）。剩余降流手段只有控制器起始频率或启动机理，而起始频率被芯片 SS 钳位固定、RT 被 24:1 锁死；若不能降，就必须按故障峰值 ≥65–74 A 选 Lr，或先加快检测（13 µs → 65 A）。任何顺序都不是提高门槛。** 原边驱动已换成本地验证的 UCC27282 行为模型并重跑三段（§13）：0–0.2/1.5/7 ms 与行为版差 ≤0.93%（7 ms Vout 6.5–7 ms 均值 1.91101 V vs 1.91114 V，OC 峰 0.55608 V 未跳，IPRI 36.005 A，SR 反向 12.332 A；稳态 Vboot 11.08–11.41 V，80 µs 后无样本低于 3.7 V）。分段台（0–0.2/1.5/7 ms）与关断/再启动轨迹均已完成，并且都已切到驱动版（§12 重启、§13）。

**OC 比较器容差角（2026-10-31 追加，`startup_ct_fault_oc_*.cir`）。** 用外部 `Bocp ocp 0 V=delay(V(oc),TD)±0.1` 把模型固定的 1.0 V 比较器搬移到 0.9/1.1 V，并加 60/500 ns 延迟；其余网络不变，每角 77 s 跑完。四角 + 标称：

| 角 | V(oc) 过阈 | 末次门极关断 | 峰值 | OC 峰 | I²t | E@6.2 mΩ |
|---|---|---|---|---|---|---|
| 1.0 V / 0 ns（标称） | 4.0013 ms | 4.0013 ms | 73.18 A | 1.183 V | 105.3 mA²s | 0.653 mJ |
| 0.9 V / 60 ns | 3.9945 ms | 3.9943 ms | 73.23 A | 1.085 V | 89.2 mA²s | 0.553 mJ |
| 0.9 V / 500 ns | 3.9945 ms | 3.9943 ms | 73.23 A | 1.085 V | 89.2 mA²s | 0.553 mJ |
| 1.1 V / 60 ns | 4.0080 ms | 4.0075 ms | 73.23 A | 1.279 V | 120.4 mA²s | 0.747 mJ |
| 1.1 V / 500 ns | 4.0080 ms | 4.0075 ms | 73.23 A | 1.282 V | 120.4 mA²s | 0.747 mJ |

峰值对四个角完全不变（73.2 A），**Lr 饱和判定不因门槛容差改变**；I²t 在 −15%/+14%（89.2–120.4 mA²s），比滤波档位（105.2→12.2 mA²s）的影响小一个量级。60 与 500 ns 延迟在这两处相位上结果相同：过阈时门极已处于关断间隔，延迟只推迟“封锁下一脉冲”的决定，而 500 ns 仍早于下一次预定开通（0.9 V 角 3.9950 < 3.9966 ms；1.1 V 角 4.0085 < 4.0099 ms）；**这是相位相关的，不能推广为“比较器延迟不影响关断”**。四角 OC 峰 ≤1.28 V，仍低于 Level-2 闩锁最小值 1.8 V，打嗝不闩锁成立。模型用外部激励模拟比较器，未实现芯片内部动态；数值结果，非硬件验证。

### 2026-10-31 追加：真实 UCC27282 与自举验证（§13）

**模型。** `models/ucc27282_behaviour.lib` 是本地行为验证模型，不是 TI 厂商模型。按 SNVSAQ5B 实现：VDD UVLO 5.0/4.5 V；HB UVLO 3.7/3.3 V（对 HS）；EN 2.0/1.21 V、T_EN 18 µs、T_DIS 1.5 µs；HI/LI 2.1/1.1 V；TPD 16 ns；3 A 峰值驱动（4 Ω 图腾柱）；集成自举二极管（VF≈0.55 V@100 µA、RD≈2.5 Ω）；HB 泄漏 240 kΩ（12 V 时 50 µA）；VDD 静态 30 kΩ。未建模：延迟匹配 1/7 ns、最小输入脉宽 20 ns、二极管反向恢复 50 ns、输入下拉 250 kΩ、温度、HB 工作电流 0.1 mA@500 kHz（Cboot 选型应另计）。迟滞状态用 ±1 mA B 电流源注入 1 kΩ∥10 pF 节点实现——B 电压源读自身节点在 LTspice 中是奇异矩阵（首版因此报 Singular matrix，已改）。

**台架A：GD2 先起（`sim/v2/ucc27282_boot_bench.cir`）。** 冷启动用电气钳位等效（HS 钳在母线、Cboot 钳 0 V，4.5 µs 释放；该版本 LTspice 对本 deck 的 `.ic` 不生效，故用开关钳位）。HI 从 t=0 就请求：3 µs 时 V(hi)=12 V 而 V(ho,sw)=0、V(hb,sw)=0 → **HB UVLO 在 Cboot=0 时确实挡住 HO**。LI 5.149 µs、LO 5.179 µs；低边把 HS 拉低后二极管充电，7.5 µs Vboot=11.095 V；**首个 HO 7.682 µs，晚于 LO 2.50 µs**；2–5 µs 窗口 HO 均值 1.3×10⁻⁷ V（无假触发）。稳态 Vboot 10.98–11.54 V、HO 峰 11.33 V；每周期跌落与 Qg/Cboot（4 nF、≈44 nC、0.2 V）加泄漏一致。

**台架B：UVLO 是真实门控（`sim/v2/ucc27282_boot_bench_lowcb.cir`）。** 33–34 µs 把 HB 短到 HS（模型验证激励，不是故障机理主张）：钳位前 HO=11.31 V；钳位期 V(hb,sw)≈0.63 mV、HO≈4 µV；释放后低边重新充电，36.8 µs Vboot=10.81 V，37.6–39.9 µs HO 恢复 11.10 V。**HB UVLO 会真正关断 HO，且只能由低边刷新复位。** 曾试 4.7 nF 小 Cboot 自然跌落到 UVLO，solver 在 4.654 µs 以 1e-18 s 步长卡死（UVLO 边缘高频抖动），不能作为数值结果，已弃用。

**启动集成（`startup_ct_drv_02.cir` / `startup_ct_drv.cir` / `startup_ct_drv_long.cir`）。** 用 `Xdrv aux hb sw lo ho gd1 gd2 aux 0 UCC27282` 替换 `Dbt/Bgh/Bgl`，EN 接 VDD（18 µs 使能延迟生效）。三段与行为参考对比：0.2 ms Vout@200 µs **1.71462 vs 1.71819 V**、OC 0.40971 vs 0.41037 V、IPRI 36.0046 vs 36.0672 A；1.5 ms Vout 1.2–1.5 ms 均值 **1.77905 vs 1.78393 V**、峰 1.79383 vs 1.80218 V、OC 峰 0.51716 vs 0.51997 V、SR 反向 11.6227 vs 11.6280 A；7 ms Vout 0–7 ms 各点 1.73964/1.86862/1.90706 V（参考 1.73885/1.86940/1.90780）、**6.5–7 ms 均值 1.91101 vs 1.91114 V**、峰 1.92653 vs 1.92622 V、**OC 峰 0.55608 vs 0.55602 V（未跳）**、IPRI 36.0046 vs 36.0672 A、ICT 峰 0.36000 vs 0.36063 A、SR 反向 12.33156 vs 12.33100 A、PRE1 逐位相同。**全部差 ≤0.93%**（最大是 SR 门极 8.278 vs 8.356 V，−0.93%；7 ms 运行 99.2 s，无收敛警告）。驱动时序：GD2 70.773 µs→LO 70.804 µs；GD1 72.491 µs→HO 72.526 µs，复现控制器 GD2 先起 1.72 µs。

**7 ms 自举统计。** 80 µs 之后 Vboot 最小 **11.084 V**（3.822 ms）、最大 11.408 V；6.5–7 ms 为 11.183–11.408 V（均值 11.221 V）；**212 万采样中无一个低于 3.7 V**。9.869 µs 的 12.057 V 最大值不是数值假象：该时刻 HS 从 −0.70 V 振到 +0.90 V，Cboot 保持 HB−HS 不变；当 HS 为负且 HB 绝对电位仍低于 VDD−VF 时（如 9.759 µs：HB=11.356 V、VDD−HB=0.644 V > VF≈0.48 V）集成二极管继续充电，因此**差分电压可以高于 VDD−VF**。真正的约束是手册 HB−HS 绝对最大 16 V，本次最大 12.06 V；若 HS 负冲更深须按 16 V 重核。启动台本身不证明 GD2 先起（HS 从 0 起、首脉冲前 Cboot 已充满），该结论由台架 A 给出。

**驱动版故障台（`sim/v2/startup_ct_fault_drv.cir`，5 ms，77.0 s）。** 与行为版逐项：OC 触发 **4.00131 vs 4.00125 ms**（+57 ns）、OC 峰 1.18261 vs 1.18283 V、IPRI 峰 **73.177 vs 73.677 A**（−0.68%）、ICT 峰 0.7317 vs 0.7367 A、SR 反向 12.625 vs 12.777 A（−1.2%）、Vout@5 ms 0.0204 vs 0.0202 V、4.5–5 ms 均值 0.25566/0.25574 V、SR 门极@5 ms 2.598 V（逐位相同）、PRE1@5 ms 0.99515（逐位相同）。触发时低边门极 11.99 V 导通，OC 脚到低边门极跌破 2.5 V 为 **98 ns**（行为版 77 ns，+21 ns，来自 TPD 16 ns 与 4 Ω 输出级压摆）；高边门源在触发前 1 µs 内已关断；两版同时导通重叠 ≤0.05 V。**打嗝重试、不闩锁与 SR 关断行为不变。**

**结论与限制。** 任务2“引入真实 UCC27282 或经局部验证的自举/延迟模型，证明 GD2 先起能充自举”在模型层面闭合：GD2 先起→LO→低边拉低 HS→二极管充 Cboot→HB UVLO 放行 HO，顺序与压降被台架 A/B、整机启动与驱动版故障台同时复现。仍不能主张：硅片时序（延迟匹配、最小脉宽、反向恢复、温度）、真实负 HS 瞬态幅度、Cboot 长期老化。EN 的 18 µs 延迟在本启动台不是约束（控制器首个 GD 脉冲在 70.8 µs），但若上电时序更早请求 HO 则必须计入。数值完成 ≠ 硬件验证。

**交付图（实跑 RAW 出图，`python tools/task2_evidence.py`）。** `design/v2/task2_ct_evidence.png` 四栏：a) 驱动版 7 ms 台前 130 µs，已是驱动模型出图——Cboot 经集成二极管在**任何门极脉冲之前**充到 11 V（3.34 µs 过 3.7 V、6.43 µs 到 11 V），控制器首个 GD2 70.773 µs→LO 70.804 µs、GD1 72.491 µs→HO 72.526 µs，VBoot 稳态 11.1–12.06 V；b) 7 ms 冷启动 Vout/SS/OC 同屏（OC 0.556 V 未跳）；c) 驱动版故障台 3.90–4.10 ms 的 I(Lr)、V(oc)、低边门极同屏（触发 4.0013 ms、峰 73.18 A）；d) OC 脚 RC 三档延迟对照。b/c 栏使用 `startup_ct_drv_long.raw`/`startup_ct_fault_drv.raw`，a 栏的 HO 画的是 **V(ho)−V(sw)**：模型 HO 以 HS 为参考，直接画对地 V(ho) 会把浮动 HS 电位叠上去（早期出图因此错成 60 V）。`design/v2/task2_restart_evidence.png` 为撤母线+辅助电源 4.5–6.1 ms 与再启动轨迹，已由 `startup_ct_restart_drv.raw`（驱动版）出图：右栏可见 4.6 ms 电流截止、撤电期门极全关、6.1 ms 恢复后的 14.04 A 浪涌与门极重新建立。

### 2026-10-31 追加：启动浪涌单参数实验与 Lr Isat 需求（§14）

**实验。** `sim/v2/startup_ct_drv_css50.cir`：只把 `Css 10n` 改成 `50n`，其余与 `startup_ct_drv.cir` 逐字相同（驱动版、1.5 ms、uic），6.5 s 跑完。首个 GD2 70.8→**344.8 µs**（按 1.2 V/175 µA×Css 缩放）；**IPRI 峰 36.0046→36.0095 A（+0.014%）**；前 8 个周期的峰值两版一致到 **0.163%**（逐周期 25.59/36.00/31.58/19.46/20.37/18.64/16.16/14.74 A vs 25.57/36.01/31.55/19.43/20.34/18.64/16.14/14.72 A），只是整体后移 274 µs。图：`design/v2/task2_css_surge.png`。

**机理。** 模型频率律 f=1/[2(6 ns·1 A/I_TOT+150 ns)]、I_TOT=I_RT+1.81 mA−V_SS/2.2 kΩ。首个门极脉冲恰好出现在 SS 穿过 1.2 V 使能门限时；此时 I_TOT=3.825 mA → **291 kHz，与 Css 无关**（Css 只决定“何时”跨过 1.2 V 和之后的扫描速率）。36 A ≈ 2×291 kHz 下谐振腔稳态电流（48 V 方波基波/2πfLr≈18 A）——冷启动第一周期的阶跃响应，不是软启动斜率造成的。

**第二个浪涌是斜率相关的。** 快扫（10n）在 SS≈1.238 V（0.143 ms）还有 22.58 A；慢扫（50n）在 SS≈1.25 V（0.865 ms）只有 **6.82 A**——慢扫避开了一次频率穿越激起的谐振。但代价是 1.5 ms 时 Vout 只有 1.15 V（快扫 1.78 V）、SR 未起（门极 0 vs 8.28 V）。**Css 只能压第二个浪涌，动不了第一个。**

**对 Lr Isat 的直接含义。** 启动要求 **Isat≥36 A**（每次冷启动必现）；故障要求 **≥73.7 A**（51 µs 检测）或 **≥65 A**（13 µs 检测）。两者都远高于稳态设计峰值 13 A。路径2的“SS 斜率”对第一个浪涌无效；起始频率由芯片 SS 钳位固定（291 kHz），RT 又被 24:1 固定变比锁在 200.6 kHz，没有免费的高频起点；启动屏蔽窗（路径3）只推迟保护、不降峰值。因此 Lr 的 Isat 应由“故障峰值+饱和裕量”决定，检测延迟必须先定。模型 Lr 线性；若真实 Isat 低于故障峰值，di/dt 升高、峰值更高，故 65–74 A 是**乐观下界**。**具体 Isat 数值仍未定（没有磁芯/匝数/材料证据），本节只把需求下界量化。**

**结论修正。** §12 的“73.7 A 对 Lr 13 A 设计峰值的 5.7×”现在有两条独立证据：启动 36 A（不依赖保护）与故障 65–74 A（随检测延迟）。13 A 只是稳态峰值，不能再当作 Lr 的电流规格。

## 测到什么（均为仿真，不是硬件实测）
1. 控制台稳态200609.86Hz；100us时SS≈1.218V、频率290425Hz。SS=1.2V的公式值约291kHz；此前约276kHz的说法是算术错误，已修parameters.json。CSS主要改软启动时间，不能拿改CSS代替起始频率裕量计算。300kHz是burst进入门槛的最小规格附近，不是控制器最低频率。
2. SR独立台正常顺序产生约10.89V门极，反序由模型资格禁止；100ns负脉冲未产生门极脉冲。同时请求经模型级优先仲裁后未见>2V门极重叠。这里是替身状态机检查，不是硅片时序保证。
3. （**v2 理想开关台，非 v3 器件**）40A/200kHz换流台、23ns关断延迟：关闭PGD时沟道反向峰值9.790A、每周期反向电荷约0.978uC；未校准PGD开时8.332A、约0.706uC。1ns与2ns最大步长扫描中反向峰值相差不超过0.465%。200ns异常延迟反向峰值18.085A，证明台架对关断延迟敏感。**这组数字只能标“v2 理想替身”，不得作为 v3 器件结果引用；v3 器件 headline 见上一节（2.171A / 69.06nC）。**
4. 联合启动短窗口原边峰值36.396A；120~150us窗口SR沟道反向峰值16.808A（PGD关）/11.599A（PGD开）。这是暴露问题的替身结果，不是实际器件反灌定量预测；不能当正常工作通过。
5. 接入理想14.7A门槛电流检测代理后，原边峰值约17.526A；120~150us输出约0.326V，SR门极为0，预启动资格尚未建立。因此没有反灌不代表验证通过，而是SR尚未工作。需要完成整个启动过程。
6. 7ms启动尝试未完成：早版在约1.09ms req2处步长失败；修正状态保持后受限时运行超时。长窗口未随最终驱动修订重跑成功，禁止引用旧RAW尾部当稳态。当前汇总把它标INCOMPLETE_OR_NUMERICAL_FAILURE。**（§12 更正：把 OC 代理换成真实 CT 后，7 ms 冷启动 73 s 跑完，Vout 6.5–7 ms 均值 1.911 V；旧失败的原因是代理门槛 14.7 A 在启动浪涌上反复触发，不是数值发散。）**

## 关键设计纠正
UCC24624官方p20要求：REG上升穿过VREGON前，至少一路VD相对VSS先超过VTHARM。**VD是SR漏极检测电压，不是原边12V偏置。**“两路偏置先长期上电、然后主功率启动”可能不满足条件。具体电路需要用启动时波形证明，而不是任意固定等待时间。可先保持SR偏置关闭、主功率用体二极管受限启动，观察合格漏极脉冲后释放SR偏置；所有四组都要满足，未证明整组共用许可有效前不能只看第一组。也要评估REG自然充电过程是否已满足条件，避免无必要加逻辑。
VSS偏移电阻不能固定为0 Ω，但也不能固定为 100–120 Ω：行为等效扫描在 40 A 下 120 Ω 最优（尾 0、总 3.712 µJ），10/25 A 下同一门槛完全不关断（VDS 峰值 16.47/41.17 mV < 43.5/50.1 mV），212 Ω 在 40 A 下也不关断。固定 Roffset 不足以覆盖 10–40 A；§11 的规格容差角进一步显示 0 Ω 在 10 A/18 mV、120 Ω 在 40 A/18 mV+400 µA 均以“完全不关断”失效，即**没有固定值能覆盖全规格散布**。真实 VSS 引脚仍未验证，不能把行为等效当选型签核。真实比例门驱与封装寄生仍是当前反灌结果最大的未定因素。
不立即提高过流门槛以放行36A启动尖峰：SOA 已按 CSD19531Q5A 手册核对（§12 发现C，非约束）；仍需变压器/Lr 饱和与检测总延迟证据。不能为让模拟通过删除保护。

## 模型覆盖与缺项
| 模块 | 已包含 | 不能据此声称 |
|---|---|---|
| UCC25600旧替身 | 频率律、SS、UVLO/OC状态、死区 | 传播延迟全容差、burst/TSD、真实芯片已验证 |
| 原边驱动 | 本地验证 UCC27282 行为模型（`models/ucc27282_behaviour.lib`）：VDD/HB UVLO、EN 18 µs/1.5 µs、HI/LI 2.1/1.1 V、TPD 16 ns、3 A 图腾柱、集成自举二极管、HB 泄漏 240 kΩ；台架证明 HB UVLO 门控与低边刷新，整机 0–0.2/1.5/7 ms 与行为版差 ≤0.93% | TI 厂商模型、延迟匹配/最小脉宽/反向恢复/输入下拉/温度、HB 工作电流、真实负 HS 幅度；模型未对硅片校准 |
| SR替身 | 主要门槛、定时、互锁、有限源灌、Roffset 行为等效（330 µA×R，`sr_timing_v3_roff.lib`）、`VTHOFF`/260–400 µA min/max 角 | 真实 VSS 引脚阻抗/合规电压、角值未必同片共存、自适应155/275ns全部切换、standby、实际PGD曲线和硅片仲裁 |
| SR功率器件 | v3 替身：双向沟道、Rds(VGS) 非线性拟合、体二极管（IS/N/TT/RS）、电荷定义 Cgd/Cds、Cgs、封装电感（ESTIMATE，`Rser=0`） | 硅片实测、Qrr 温度依赖、封装寄生实测、Kelvin 双实例验证、SOA/自热；温度仅 TJ=25 °C |
| REG | 作为外部测试激励施加 | 12V→内部REG启动电流与2.2uF动态；快速斜坡不是硬件实现 |
| OC | 真实CT（1:100、桥式整流、10 Ω负载、RC、10k/24k分压），§12 三档滤波实跑：启动不误跳、1 mΩ 短路 13–51 µs 触发；四角容差（0.9/1.1 V × 60/500 ns，外部 offset+delay 激励）：I²t 89.2–120.4 mA²s、峰值不变、打嗝不闩锁 | 磁芯选型与饱和实测、芯片内部比较器动态（外部激励非内部实现）、Level-2 闩锁实测、真实关断时间；Lr 在 65–74 A 下仍按线性建模 |
| 磁件 | 耦合电感、K=.999试探寄生 | 已量得漏感或可加工磁芯；.92u外置是近似分摊，不是磁件冻结；Lr Isat 需求已量化为 ≥36 A（启动）/≥65–74 A（故障，随检测延迟），但未选型、无磁芯/材料证据（§14） |

v3 器件已用 Rds(VGS) 非线性拟合再现“降低 VGS → 提高 Rds”的机制（40 A 时 10.892 V→0.8956 mΩ，4.133 V→1.1931 mΩ）；但 PGD=1 的 VDS→VGS 调压律仍未校准（2.6 V 箝位、80 V/V 斜率、35 mV 偏置均为行为拟合），PGD 开/关只能做敏感性示例，不能据此选择/否决芯片。v2 理想替身的固定 Ron 限制已不再适用于 v3 台。
联合模型用UIC表示全部初态从零开始、48V已存在；为避免副边数值公共电位漂移，将SGND通过0V电压源固定为求解器参考。它不代表原副边硬件接地，也不验证隔离/共模电流。不能用全局cshunt隐藏收敛问题。

## DeepSeek协作审核
deepseek/v2/保留三轮任务、原始回复及API完成状态。采纳其状态覆盖建议和同时请求测试建议；拒绝它把idt复位条件读反、把VD误称原边偏置、建议提高工作频率以远离上侧burst门槛等错误。最终结论以手册、可复算公式和运行结果为准。
源文件：TI UCC24624 SLUSD48C p3/p6/p17/p20（references/datasheets/ucc24624.pdf）；UCC25600 SLUS846D p10/11/17；UCC27282 SNSVAQ5B。官方链接：https://www.ti.com/lit/ds/symlink/ucc24624.pdf 。
