czy0126/CZY/design/v2/第四轮_证据修正与数值疑点关闭_2026-10-31.md

# 第四轮：证据修正与数值疑点关闭

日期 2026-10-31。状态：**DELIVERED_SUMMARY**。
对应 `docs/第三次独立审核与后续阶段任务书_2026-10-31.md` 的 P1（冷启动、预算撤回、
能量恒等式、数值收敛与均流口径）、P2（manifest）与任务包 1。任务包 2（控制验证板）
见 `pcb/control_validation/控制验证板_设计与测试说明_2026-10-31.md`。

本文是**本轮唯一的汇总表与结论**；第三轮文档如与本文冲突，以本文为准（已回改链接）。

## 0 结论

1. **撤回"SR 耗散约为 125 mW/器件预算 6.8 倍"**。6.84 W/8 只保留为**带不确定度的
   模型估计**：数值步长网格 6.30–6.84 W，CPIN 网格 5.96–6.84 W，逐周期
   SEM ±0.23 W。整机分配见 §4：Pin 189.790 W、Pout 178.987 W、总损耗 10.8035 W、
   η 94.31 %，SR 支路 6.6582 W 占**总损耗的 61.63 %**。旧预算从未与整机能量闭合，
   不能直接相除。
2. **端口量收敛，支路能量只收敛到约 ±8 %**。同一 1 ms deck、同一 880–1000 µs 窗口、
   同样 22 周期下，5/2/1 ns 的门极频率、Vout、Pout 变化 ≤0.91 %（`V(sw)` 中位数
   频率在 2 ns 上偏 +2.0 %，是边沿抖动；`q_port_rev` 偏 +15–17 %，本来就不是收敛
   指标）；`e_diss` 变化
   −5.1 %/−7.9 %，与逐周期 SEM（3.4–4.7 %）同量级，不能宣称收敛到 3 %。
   引用 SR 损耗必须给区间，不能给单点。
3. **CPIN 是模型正则参数，不是器件电容**。1 ms 设计点上 50 pF 使 `e_diss` −3.6 %
   （在噪声内），200 pF 使 −12.9 %（约 2.1σ，显著）。这是模型敏感度，不是器件结论。
4. **四组均流在本模型中为 7.97e-9 %，不构成均流证据**。四组平均输出电流
   23.7329 A、和 94.9317 A、绕组 RMS 26.8413 A、每端口 1.66054 W、磁通
   −2.0180e-8 Vs；器件损耗只有 pair 1 有内部仪器，不能分到四组。
5. **真实冷启动完成**（无 `.ic`，Cout 从 0 V）。峰值 Vout 1.9167 V、原边 23.06 A、
   SR 正向 69.58 A、输入 326.39 A（48 V 阶跃灌入放电输出电容）；基线冷启动
   OC 最大 0.545 V，**未触发**（1.0 V 门槛）。**另跑 `cold_oc` 变体**（同一冷 deck
   + 5.55 ms 注入 11 倍过载）：44.4 µs 后跳闸、原边峰 98.0 A、**4 次门极重启**、
   持续过载下不恢复；记录在 7.3066 ms 因求解器步长塌缩被终止（见 §6.4）。
   四组门极首高 1.2820/1.2840 ms；频率按软启动律落点：276→265→247→(缺口)→
   200.9→201.0 kHz，末窗 201.01 kHz vs 律值 200.61 kHz（+0.2 %）。
6. **修正了一个会产出假数据的工具缺陷**：`primary_freq_khz()` 原先用整个 raw 的
   `V(sw)` 边沿取中位数，8 ms 冷启动上四个窗口都返回 248.86 kHz。现已按窗口
   限定边沿，并有回归测试；旧 JSON 的该列作废。
7. 离线工具 **52 例测试全通过**；manifest 已改为"当前候选"清单。

## 1 证据链

- deck（`tools/make_round4_decks.py` 从已验收的 1 ms deck 生成，功率级逐字节一致）：
  `sr_tank_dual_v33_ss_1ms.cir`、`..._full.cir`、`..._cold.cir`、
  `..._conv1ms_{2n,1n}.cir`、`..._cpin1ms_{50p,200p}.cir`、
  `..._cold_oc.cir`（冷 deck + 5.55 ms 过载注入）、
  200 µs 族的 `..._conv_{5n,2n,1n}.cir` 与 `..._cpin_{50p,200p}.cir`（后者作废）。
- raw：上列同名 `.raw`。冷启动 raw 10,697,092,991 B、31 变量、14,026,531 点；
  `cold_oc` raw 13,059,374,780 B、37 变量，写到 t=7.3066 ms（求解器塌缩后按 PID
  终止，头部仍是 `No. Points: 0`——PyLTSpice 拒绝这种 raw，故用
  `tools/ascii_raw_window.py` 流式只取 5.4 ms 之后的窗口）。
- 结果：`design/v2/round4_summary.json`（本文全部数字）、
  `design/v2/period_variance_cpin1ms.json`、`design/v2/period_variance.json`、
  `design/v2/fault_metrics_sr_tank_dual_v33_cold_oc.json`。
- 工具修正：`tools/round3_summary.py`（窗口参数）、`tools/task_package1_summary.py`
  （冷启动与 22 周期 1 ms 族、作废族注记）、`tools/test_round3_summary.py`
  （新增窗口回归测试）、`tools/make_round4_decks.py`（`cold_oc()` 变体）、
  `tools/fault_metrics.py`（故障时刻/门极迹线参数化，支持流式窗口）、
  `tools/ascii_raw_window.py`（大 raw 流式取窗，已对 105 MB raw 与 PyLTSpice 逐点
  比对：点数一致、最大差 6e-8 V）。
- 复现与哈希：`design/v2/manifest_current_candidate.json`。

## 2 唯一结果表

同一 1 ms deck、同一 `.ic`、同一保存窗口 880–1000 µs（raw 轴 0–120 µs，下同）、
同样 22 个完整 SR 周期。`Pout = average(Vout²/0.020 Ω)`，梯形时间加权。

| # | 工况 | f 门 kHz | Vout V | Pout W | e_diss µJ | 8 只 W | 相对参考 |
|---|---|---:|---:|---:|---:|---:|---|
| 1 | 设计点 5 ns（参考） | 200.626 | 1.89199 | 178.987 | 4.2612 | 6.839 | — |
| 2 | 2 ns | 200.589 | 1.89578 | 179.705 | 4.0428 | 6.488 | e_diss −5.1 % |
| 3 | 1 ns | 200.639 | 1.90054 | 180.609 | 3.9258 | 6.301 | e_diss −7.9 % |
| 4 | CPIN 50 pF（5 ns） | 200.617 | 1.89534 | 179.621 | 4.1082 | 6.593 | e_diss −3.6 % |
| 5 | CPIN 200 pF（5 ns） | 200.766 | 1.89574 | 179.698 | 3.7114 | 5.961 | e_diss −12.9 % |
| 6 | 整机 I/O（同 #1） | 200.626 | 1.89199 | 178.987 | — | SR 支路 6.658 | Pin 189.790；η 94.31 % |
| 7 | 冷启动 7–8 ms | 201.01 | 1.8963 | — | — | — | 律值 200.61 |

脚注：

- `f 门` = SR 门极周期均值（22 周期）。`V(sw)` 边沿中位数在 #2 读到 204.86 kHz
  （+2.0 %），是边沿抖动敏感度，不是频率漂移；见 §3。
- `e_diss` = 沟道 + 体二极管 + Rg，单器件；`8 只` = ×8。该量逐周期离散
  16–31 %，SEM 0.14–0.24 µJ（±0.23–0.39 W/8 只），必须按区间引用。
- #6 的 SR 支路 6.658 W 已剔除 Rg 的 0.1812 W（Rg 热量来自理想驱动源，
  不进入 Vbus 输入功率，混算会重复计数）。
- #7 的 f 取 7–8 ms 窗口内 `V(sw)` 边沿；独立复测（门极边沿，7.5–8 ms）
  为 201.194 kHz，与表内一致。冷启动未做整窗 `e_diss` 账本，故置空。

## 3 数值收敛与 CPIN 敏感性

### 3.1 同工作点、同窗口、同周期数

- **端口量**：f 门 −0.02 %/+0.01 %（2n/1n），f 主（`V(sw)` 中位数）+1.99 %/−0.04 %，
  Vout +0.20 %/+0.45 %，Pout +0.40 %/+0.91 %。能量恒等式残差 0.020–0.049 %。
- **支路能量**：`e_diss` −5.1 %/−7.9 %；`q_port_rev` +17.2 %/+15.3 %。
  `q_port_rev` 逐周期相对标准差 32.5 %，本来就不是收敛指标（第三轮 §0 已定）。
- **判读**：5n→1n 的 −7.9 % 约为 5n 与 1n 合成 SEM（≈4.9 %）的 1.6 倍，
  趋势单调但未过 2σ。结论只能是：**支路损耗收敛到约 ±8 %**，不是收敛到 3 %，
  也没证明发散。故 8 只 SR 损耗引用为 **6.3–6.9 W（数值网格）**。
- 200 µs 族（150–200 µs）**作废**：该窗口 Vout 为 1.948–1.954 V，而设计点是
  1.892 V，仍在启动过冲段；改步长改变的是轨迹，不只是数值。JSON 保留但标
  `invalid_200us`，不作证据。

### 3.2 CPIN

- 50 pF：`e_diss` −3.6 %、Pout +0.35 %、f 主 +0.21 %（f 门 −0.004 %）。
- 200 pF：`e_diss` −12.9 %、Pout +0.40 %、f 主 +0.61 %（f 门 +0.07 %）。
- 逐周期：50 pF 4.148±0.142 µJ（6.66±0.23 W），100 pF 4.300±0.146
  （6.90±0.23 W），200 pF 3.708±0.242（5.96±0.39 W）。
- 判读：50 pF 端点在噪声内；200 pF 端点差 0.94 W ≈ 2.1σ，显著。CPIN 是
  SR 器件模型的数值正则参数（不是数据手册 `Coss`），因此**模型对 SR 损耗的
  预测有约 −13 % 的参数敏感度**，这是"未知"而非"已收敛"。

### 3.3 仍未知

- 真实器件的 `Coss`/`Qrr`/门极电荷与模型 CPIN/CGATE 的映射。
- 体二极管反向恢复段的分配（第三轮 §7 第 6 条）：本模型把回馈段计入支路净能量，
  逐周期离散 28–58 % 正来自这里。
- 179 W ≠ 200 W 额定点；冷启动 8 ms 末窗仍比稳态高 0.2 %。

## 4 整机损耗分配与"6.8 倍"撤回

### 4.1 分配（#6，同一 22 周期窗口）

- 输出：`Pout = average(Vout²/R) = 178.9869 W`。
- 输入：`Pin = average(−V(vin0)·I(Vbus)) = 189.7903 W`。
- 偏置源：`p_aux = 31 µW`、`p_reg = 0`——**是模型的残差，不是真实偏置功率**：
  UCC25600 模型无 VCC 静态电流，SR 驱动是理想 B 源、不取自 VDD/REG。
- 总损耗：`10.8035 W`（占 Pin 5.69 %）；效率 `94.3077 %`（不含未建模的
  偏置与驱动供电，真实效率会再低）。
- SR 支路（沟道 + 体二极管，8 只）：`6.6582 W` = **总损耗的 61.63 %**、
  Pin 的 3.51 %。其中沟道 1.6330 µJ、体二极管 2.5154 µJ（单器件每周期）。
- Rg：`0.1812 W`，由理想驱动源供给，**不计入** Pin，也不计入上面的 6.6582 W。
- 其余（原边开关、谐振腔/变压器 ESR、输出电容 ESR 等）：`4.1453 W`，未逐项拆分。

### 4.2 撤回

第三轮 §0.4/§2 的"855 mW/器件、8 只 6.84 W ≈ 125 mW/器件预算的 6.8 倍"**撤回**，
理由：

1. 6.84 W 是一次模型积分，逐周期离散 16–23 %，且对 CPIN 有 −13 % 敏感度，
   不能当作可签核的器件损耗；
2. 125 mW/器件是旧的分立预算，从未与整机 Pin/Pout 闭合。按本轮整机账本，
   8×125 mW = 1.0 W 只占总损耗 10.8 W 的 9.3 %，其余 9.8 W 没有分配对象——
   这个预算本身就不完整，不能用来判"超 6.8 倍"；
3. 正确口径是整机分配（§4.1）。SR 支路确实是**最大单项**（61.6 %），
   这一点保留；但"超出预算 6.8 倍"的表述不成立。

### 4.3 仍然成立 / 不成立

- 成立：SR 支路是整机最大单项损耗；沟道与体二极管都要计入；Rg 与门极供电
  不能重复计入端口损耗。
- 不成立：SR"超出 125 mW/器件预算 6.8 倍"；把 6.84 W 当测量值；
  把 179 W 工况外推到 200 W 额定。

## 5 四组均流

- 整机 deck（#6）：四组平均输出电流 23.732931 A（组间离散 7.97e-9 %），
  和 94.931724 A；绕组 RMS 26.841271 A（波形因数 1.131）；每端口
  1.660536 W；磁通 −2.017981e-8 Vs（四组一致到 1e-7 相对）。
- 冷启动 7–8 ms：冷 deck 只保存 pair 1/4 电流，两组 `iout` 23.707773 A、
  RMS 26.730602 A、离散 1.17e-10 %；这是**两组**，不是四组。
- **这不是均流证据**：模型四组结构完全对称，且器件损耗只有 pair 1 有内部
  仪器（`xsa1:*`/`xsr1:*`），无法把损耗分到四组。真实均流需要样件公差、
  磁件分散性与布局不对称，属于硬件阶段。

## 6 真实冷启动

### 6.1 时序与峰值（8 ms，10 ns 步长，`uic`，**无任何 `.ic`**）

时序（建模选择，非数据手册主张）：VCC/aux 0→12 V（50–350 µs，约 262 µs 过 UVLO）
→ 主电 0→48 V（400–800 µs）→ SR REG 0→11 V（1.2–1.4 ms，放在主电之后，
使预置资格窗口可满足）。

| 量 | 值 |
|---|---|
| Vout 峰值 | 1.91670 V |
| Vout 2 / 4 / 6 ms | 1.72246 / 1.83590 / 1.87329 V |
| Vout 7–8 ms 均值 | 1.89630 V（比稳态 1.892 高 0.23 %） |
| 原边 `|I(Lr)|` 峰值 | 23.063 A |
| SR 正向峰值 | 69.584 A |
| SR 反向峰值 | 6.048 A |
| 输入 `−I(Vbus)` 峰值 | 326.39 A（48 V 阶跃灌入 0 V 输出电容） |
| `V(oc)` 最大 | 0.5449 V（门槛 1.0 V） |

### 6.2 门极/驱动状态

- 首高：ga1–ga4 = **1.282048 ms**，gb1–gb4 = **1.283958 ms**（四组在同一
  采样点，模型对称）；对应 REG 爬升穿过约 4.1 V 的时刻。
- 末 1 ms 占空比：ga 40.325 %，gb 40.330 %；四组相同。
- 没有出现"先于 REG 的门极脉冲"，即预置资格（VD>1.5 V 早于 REG>4.1 V）未违例。
- `V(pre1..4)` 的内部预置状态**未保存**（见 §6.5），只能从门极时序间接判读。

### 6.3 频率落点（按窗口限定边沿后；旧 248.86 kHz 列作废）

| 窗口 ms | 实测 kHz | 律值 kHz |
|---|---:|---:|
| 0.5–1.0 | 无有效区间 | 285.07 |
| 1.0–1.5 | 276.23 | 277.13 |
| 1.5–2.5 | 265.24 | 265.14 |
| 2.5–4.0 | 247.02 | 244.96 |
| 4.0–5.5 | 无有效区间 | 220.40 |
| 5.5–7.0 | 200.90 | 200.61 |
| 7.0–8.0 | 201.01 | 200.61 |

落点判据：末窗 201.01 kHz 与律值 200.61 kHz 差 **+0.2 %**；独立复测
（门极边沿，7.5–8 ms）201.194 kHz，`V(sw)` 中位数 205.5 kHz（10 V 门槛抖动）。
两个"无有效区间"是数据缺口（带内没有可信的 `V(sw)` 上升沿），不是"频率为零"。

### 6.4 OC 与重启

- **基线冷启动**：`V(oc)` 最大 0.545 V，从未过 1.0 V，`oc_episodes_above_1v = []`，
  `ss_restart_count = 0`。即这条运行本身没有激发 OC，不能据此宣称"重启已验证"。
- **`cold_oc` 变体**（`sr_tank_dual_v33_cold_oc.cir`：与冷 deck 逐字节相同的功率级，
  只加 5.55 ms 的 11 倍过载——1 mΩ 开关 + 1 mΩ 电阻并联 20 mΩ 负载）：
  跳闸 **5.5944 ms**，即注入后 **44.4 µs**；原边峰值 **97.99 A**（5.578 ms），
  是启动峰值 23.06 A 的 4.2 倍；`i²t` 到跳闸 150.6 m·A²s（即 0.151 A²s）。
  门极低电平间隔依次为 5.599–5.616、5.954–6.115、6.272–6.430、6.911–7.062 ms，
  即 **4 次重启簇**；持续过载下输出跌到 −0.013 V（最小值），末段均值 0.041 V，
  `recovered = false`——故障不撤，控制器就在"跳闸—软启动重试"之间循环，符合预期。
- **记录终止**：本次 raw 在 t=7.3066 ms 处求解器步长塌缩到 ~1e-17 s（37 s 只推进
  1.6e-13 s），按 PID 终止仿真。故障与 4 次重启都在 7.062 ms 前完成，结论只用
  5.55–7.31 ms 内健康推进的数据；记录末端的第 5 个关断区间是未完成态。
- 旁证（**另一 deck，不可混算**）：`fault_metrics_startup_ct_fault*.json` 在旧
  startup_seq 冷 deck 上给出 51 µs 跳闸、3 次重启（10 ms 变体 283 µs、1 次）。
  两套 deck 的 REG 时序不同（130 µs vs 1.2 ms），跳闸延时量级一致但数值不可互换。

### 6.5 证据完整性

冷启动 raw 生成于 19:02–19:38，而 `sr_tank_dual_v33_cold.cir` 的 mtime 是 19:26
（运行期间被重新生成）。raw 头缺 `.save V(pre*)`，说明运行开始时 deck 尚无该行；
行为序列可由 raw 自身交叉验证（门极首高 1.282 ms 对应 REG 1.2–1.4 ms 爬升，
输入峰值 326 A 对应 400–800 µs 的 48 V 阶跃），但**内部预置状态不可得**。
不为此重跑 35 分钟；如实记为缺口，不用别处数字填充。

## 7 模型限值（不能宣称什么）

- **偏置能量未被测量**：`p_aux`/`p_reg` ≈ 0 是模型缺省（无 VCC 静态电流、
  理想 SR 驱动），不是"偏置损耗为零"。真实效率低于 94.31 %。
- CPIN/CGATE 是数值正则参数；SR 器件模型是行为模型，不是 BSC010N04LS6 的
  厂商模型。
- 原边是理想开关（Ron 1.5 mΩ）+ 理想体二极管；无磁芯损耗、无 PCB 寄生、
  无死区校准。
- 四组完全对称是结构假设，不是公差鲁棒性。
- 冷启动只到 8 ms，末窗仍高 0.23 %；不构成热稳态或长期稳定性结论。
- **持续严重过载下求解器会塌缩**：`cold_oc` 在 7.3066 ms 后步长跌到 ~1e-17 s，
  记录被截断。这不是电路失效的结论，而是刚性网络的数值极限；故障段结论限于
  塌缩之前的 1.75 ms，长期"跳闸—重试"循环无法用这个 deck 表征。
- 所有结论均为仿真；控制验证板 T1–T7 尚未做（见任务包 2 文档）。

## 8 复现

```bash
python tools/make_round4_decks.py
python tools/task_package1_summary.py \
  --op sim/v2/sr_tank_dual_v33_ss_1ms.raw \
  --full sim/v2/sr_tank_dual_v33_ss_1ms_full.raw \
  --cold sim/v2/sr_tank_dual_v33_cold.raw \
  --conv1ms 2n=sim/v2/sr_tank_dual_v33_conv1ms_2n.raw \
            1n=sim/v2/sr_tank_dual_v33_conv1ms_1n.raw \
  --cpin1ms 50p=sim/v2/sr_tank_dual_v33_cpin1ms_50p.raw \
            200p=sim/v2/sr_tank_dual_v33_cpin1ms_200p.raw \
  --conv 5n=sim/v2/sr_tank_dual_v33_conv_5n.raw \
         2n=sim/v2/sr_tank_dual_v33_conv_2n.raw \
         1n=sim/v2/sr_tank_dual_v33_conv_1n.raw \
  --cpin 50p=sim/v2/sr_tank_dual_v33_cpin_50p.raw \
         200p=sim/v2/sr_tank_dual_v33_cpin_200p.raw \
  --json design/v2/round4_summary.json
python tools/period_variance.py 5n=sim/v2/sr_tank_dual_v33_ss_1ms.raw \
  2n=sim/v2/sr_tank_dual_v33_conv1ms_2n.raw 1n=sim/v2/sr_tank_dual_v33_conv1ms_1n.raw \
  --json design/v2/period_variance.json
# 冷启动 OC 重启（先跑 deck，约 90 min，7.3 ms 后求解器塌缩需按 PID 终止）
/d/ADI/LTspice/LTspice.exe -b -ascii sim/v2/sr_tank_dual_v33_cold_oc.cir
python tools/fault_metrics.py --fault-start-ms 5.5 --fault-end-ms 5.6 \
  --gate "V(ga1)" --ascii-window-from-ms 5.4 sr_tank_dual_v33_cold_oc
python tools/current_manifest.py
python -m pytest tools -q      # 52 例
```

冷启动 raw 约 10.7 GB，完整加载约 15–20 分钟；只看尾部时按 `CLAUDE.md`
的 ASCII 记录格式 seek 解析，不要整文件 `load()`。
