czy0126/CZY/deepseek/v1/corrected_constraints.md

独立审核已确认以下错误，必须修正：
1. UCC25600: fs=1/[2*(6e-9/IRT+150e-9)]。200kHz得到IRT=2.55319mA、RRT=979.167ohm，选976ohm；不是1.56k。RDT=5.36k约148.64ns。CSS10n内部充电约5.6ms，不得把SS上拉12V改变充电。正常用开集电极拉SS关断。GD1直接接UCC27282DRC的HI，GD2接LI，不要插入栅变；电平容许需查手册。
2. 软启动额外电流1.81mA-VSS/2.2k，VSS=1.2V约+1.2645mA，合成频率约276kHz向200.6kHz下降，142.5kHz是特定RT测试条件，不是本案恒定启动频率。不能保证容差下burst边界，需要预算。
3. UCC24624D PGND是2，VSS是5。每单元VSS共用一个Roffset，不是每MOS一个；取91ohm候选，使实际turnoff约10.5mV-330uA*91=-19.53mV提前关断（需容差评估）。VD用Kelvin直接测D（预留0~10ohm，不随意1k）。关断的SR漏极约2Vo约4V，不是2V；1.7V再武装门槛启动期间待验证。475ns blanking影响轻载和启动，不能说不影响。
4. Ip谐振负载分量峰值=pi*100/(2*12)=13.09A，有效值9.256A；每SR/每半副边RMS=pi*25/4=19.635A，峰值39.27A。RMS已含导通占空比，不能再乘0.5。原边每MOS RMS约9.256/sqrt(2)=6.545A（另计励磁）。每Lm10u单元近6V/200kHz -> Im_pk=6/(4*f*Lm)=0.75A，不是1.5A；Ae临时100mm2、Np3 -> Bpk=25mT，不是50mT。
5. 串联Lr总1u、Cr620n、Lm总40u（四个10u）是统一首次候选；禁止控制稿又写10u+63n。四组原边独立磁芯串联，Lm同值对称时相加；K=1且外置1u为零漏感计算模型，硬件外置值必须扣除实测漏感。
6. 不用INA180单向低带宽放大+100us/1u滤波监测双向200kHz谐振电流，且20A*12不是240W。选择原边穿过1:100电流检测CT→副边肖特基全桥→6.8ohm负载→100ohm/220p→OC，约14.7A峰值对应1V，约29.4A对应2V，门槛含CT/二极管/负载影响须实测。CT为独立磁件，具体型号未核前写候选，非已验证保护。
7. 原边PGND和副边SGND分离，两个外供12V有各自回路，不能暗接一起。

追加纠正（覆盖第3项Roffset）：TI UCC24624 8.3.3明确电流从VSS流出，Roffset提高关断门槛，91ohm不是提前关断。SON5x6低寄生封装不需要Roffset。V1用0ohm直接Kelvin连接VSS到源极；此前负号推导撤回。
