czy0126/CZY/deepseek/v1/final_review_completed.md

1) RRT=976Ω：IRT=6n/[(1/(2×200k))-150n]≈2.553mA；但按976Ω复算稳态fs≈200.6kHz。SS=1.2V时额外电流≈(1.2/2.2k)=0.545mA？按审核式1.81mA−VSS/2.2k=1.2645mA，合成IRT≈3.817mA，fs≈276kHz，随后向≈200.6kHz下降；142.5kHz不是本案恒频。  
2) 半桥4×3:1:1，目标100A时每半副边RMS=π×25/4=19.635A；Ae=130mm²、每单元6V、Np=3、Lm=10µ、f≈200kHz：Bpk=6/(4fLm)·Lm/(NpAe)=6/(4×200k×3×130e−6)=19.2mT（若Np=3、Ae=130mm²；不再乘占空比）。  
3) 网表：四原边Lp1~Lp4确为串联；无重复Lm（仅Lp1~Lp4各10µ）；两半副边Lsa/Lsb按同名端与二极管方向成中心抽头整流；体二极管DH/DL方向为sw→vin、0→sw，需对照实际半桥体二极管复核；PWM周期由FS式给定、死区149ns，属理想功率腔。  
4) 控制简表：UCC25600D作LLC/DCX主控，GD1→UCC27282 HI、GD2→LI；UCC27282DRCR驱动半桥；UCC24624DR×4控8只SR，PGND=2、VSS=5，VSS共用91Ω候选Roffset，VD Kelvin至D；CT穿原边→1:100→肖特基全桥→6.8Ω→100Ω/220p→OC。不加栅变、不加SS上拉。  
5) 未完成：芯片联合闭环、SR时序/再武装/blanking、OC容差、磁复位与热/EMC验证。下份应交付可制造资料：原理图、BOM、磁件图、PCB、装配与测试规范。
