czy0126/CZY/deepseek/v1/magnetics_reply.md

以下为工程初版可计算稿，未仿真、未热验证；型号/参数未核实者均标候选。

**1. 拓扑与变比**
四单元CT，原边串联，每单元Np:Ns:Ns=3:1:1，单元n=3，总n=12。半桥DCX，Vo≈Vin/(2n)=Vin/24。Vin=48V→Vo=2.0V；46V→1.917V；50V→2.083V。目标100A/200W时Vo=2.0V。谐振增益按≈1设计，不精密闭环。

**2. 谐振腔首轮候选**
候选A：Lr总=1µH，Cr=620nF。fr=1/(2π√(LrCr))=1/(2π√(1e-6×620e-9))≈202kHz，符合200kHz起点。Lm总=40µH（每单元10µH）为独立候选，则Lm/Lr=40。若Lm/Lr过大使励磁电流偏小、SR关断裕量不足，可降至20µH总（每单元5µH）候选，不采用旧项目5.57µH作唯一结论。

反射负载：Po=200W，Vo=2V，Io=100A，Ro=20mΩ。全桥整流折射到原边（总n=12）：Rac=8n²Ro/π²≈8×144×0.02/9.87≈2.33Ω。Q=√(Lr/Cr)/Rac=√(1e-6/620e-9)/2.33≈1.27/2.33≈0.545。Q偏低但DCX可接受；若需更高Q，可增Lr或减Cr，标候选。

**3. 电流与磁通**
正弦整流假设，每单元副边半绕组电流：每单元输出25A平均，半周导通，副边半绕组RMS≈25A×√(π/2)/2？按全波：Io_unit=25A，半绕组RMS≈Io_unit×√(π/2)/2≈25×0.886/2≈11.1A。四单元每SR管对应一个半绕组，故每SR RMS≈11.1A（每半周一管，非8管全时并联）。总副边铜流四单元合计RMS≈4×2×11.1≈88.8A（两半周合计），折算原边总RMS≈Io/n×√(π/2)? 更直接：原边总RMS≈Po/(Vin×η)近似，48V/200W→4.17A平均；正弦近似原边RMS≈4.17×√2/2? 取原边总RMS≈4.6A候选。每单元原边RMS≈4.6A（串联同流）。

励磁峰值：每单元Lm=10µH，半桥施加±Vin/2? 原边每单元电压≈Vin/4? 四单元串联，总原边电压Vin，每单元Vin/4=12V。ΔILm=(V×Ton)/Lm，Ton≈T/2=2.5µs，V=12V，Lm=10µH→ΔILm=3A，峰值≈1.5A（对称）。总原边电流峰值≈4.6×√2/2? 取交流分量+励磁，标候选。

Bpk：每单元6V、200kHz、Np=3T、Ae临时100mm²。Bpk≈V×Ton/(2NpAe)? 半桥方波：Bpk≈Vin_unit×D/(2NpAe f)? 用ΔB=V×Ton/(NpAe)，Ton=2.5µs，V=12V? 注意每单元原边电压12V，Np=3，Ae=100e-6m²：ΔB=12×2.5e-6/(3×100e-6)=0.1T，Bpk≈0.05T（若双向对称）。此值很低，Ae=100mm²为保守临时算例，不是ELP32/6/20+I32/3/20实测数据；该型号Ae未给，不编造。若实际Ae更小，Bpk升高，需按图纸重算。

AL=10µH/9=1.111µH/T²（每单元Lm=10µH，Np=3）。有效气隙简化：Lm=µ0N²Ae/lg（忽略磁芯磁阻），lg≈µ0N²Ae/Lm=4πe-7×9×100e-6/10e-6≈1.13e-4m≈0.113mm，标简化候选。

**4. 铜损预算**
100A输出铜损预算初版：副边总铜损目标≤8W（候选），每单元副边两半周合计≤2W。每SR RMS≈11.1A，若每半绕组等效电阻≤8mΩ，则每管铜损≈0.99W，四单元八半周合计≈7.9W。原边总RMS≈4.6A，原边铜损目标≤3W，等效总电阻≤0.14Ω。MOS导通：SR热态1.5mΩ，每半周一管，单管导通损耗≈11.1²×0.0015≈0.185W，八管合计≈1.48W（按占空比半周已含RMS，实际再乘D≈0.5则≈0.74W，取保守1.5W）。原边MOS 8mΩ，总原边电流RMS≈4.6A，若半桥两管交替，单管损耗≈4.6²×0.008×0.5≈0.085W，两管≈0.17W。总导通预算≈1.7W，加磁件铜损≈11W，标预算非实测。

**5. 输出铜箔绕组初版**
原边3T，副边各1T。厚度/宽度/长度暂定：原边铜箔0.2mm×8mm×每匝约60mm；副边0.2mm×20mm×每匝约50mm。200kHz铜趋肤δ≈√(ρ/(πfµ))≈0.147mm，0.2mm略超趋肤，候选用0.1mm×2层或0.15mm。端子损耗按每单元副边端子2mΩ候选，100A总端子损耗≈100²×总端子电阻，需并联均流，标待图纸。窗口能否塞入ELP32/6/20+I32/3/20必须待图纸验证，不编造。

**6. 实测Lr**
实际Lr=外置Lr+四单元折算漏感。测量：短路所有副边绕组，测原边串联两端电感即为Lr_total（含外置），再减去外置Lr得四单元折算漏感；每单元可单独短路副边测原边电感后折算。Cr用LCR测620nF候选，fr用扫频确认≈202kHz。

**7. 待定项**
磁芯Ae/窗口/AL曲线、铜箔尺寸与端子、SR具体型号、原边MOS型号、气隙加工图、风冷风道、绝缘与爬电、≤10mm高度优先牺牲面积。保护仅过流、UVLO、关断、软启动、死区。以上为计算预算，非效率承诺，未仿真/热验证。
