czy0126/CZY/deepseek/v1/netlist_task.md

你为48V→2V固定变比DCX完成首版可运行LTspice功率网表。只输出一个spice代码块，限200行。基于附带已审核约束，不输出叙述。
参数Vin48 Rload20m Lr1u Cr620n Lm每10u，fs=1/(2*(6n/(2.5/976)+150n))，deadtime149n，四个3:1:1耦合磁件原边串联，K=1，Lsec=10u/9。半桥用两个电压受控开关Ron8m和体二极管，有限边沿PWM，串Cr后Lr，四原边接至PGND。副边各CT接out，两个端点a/b各用低侧理想二极管等效SR（D从SGND到端点，.model DSR D(Ron=1.5m Roff=1G Vfwd=0.02)，明确其不是UCC24624模型）。Lsa out a Lsb b out 极性相反，K全部正。每原边Rser3m，每半副边Rser0.15m，输出C4m Rser0.2m，20m电阻负载。SGND用1G连接PGND只为数值参考。初始Vin在0.5ms线性升到48，固定fs，明确这是功率腔检验激励，不是实际芯片软启动。PWM延迟至少5us，QH和QL不重叠，用PH,PL独立地参考控制S开关；负载两端out SGND。保存V(out,SGND)、I(Lr)、4路半绕组电流、SW、PWM。tran 0 3m 0 30n，.meas最后0.5ms Vout平均/纹波、IpRMS/peak、每半绕组Irms。无全局cshunt。给节点名避免SPICE大小写冲突和输出参考错误。
