czy0126/CZY/deepseek/v1/release_reply.md

## A. 主控8脚（UCC25600，实际为8脚；约束以追加项为准）
1. RT→GND：976Ω（1%，200kHz标称；fs=1/[2(6ns/IRT+150ns)]，IRT=2.55319mA）。
2. DT→GND：5.36kΩ（≈148.64ns）。
3. SS：10nF到GND，仅内部约5.6ms充电；禁止上拉12V；关断用开集电极拉SS。
4. GD1→UCC27282DRC HI，GD2→LI，直连，不插栅变；电平须查手册。
5. 额外SS电流1.81mA−VSS/2.2k；VSS=1.2V约+1.2645mA，启动频率约276k→200.6kHz；142.5kHz仅为特定RT测试条件。burst边界需容差预算。
6. 原边CS：待定，与CT过流分开。

## B. 驱动DRC10脚（UCC27282DRC）
1. VDD/UVLO：12V_P经RC去耦；EN默认低，手动跳线到12V_P启动（跳线不称闭环）。
2. HI←GD1，LI←GD2，直连；HS→原边MOS源/半桥中点；HO→上管栅；LO→下管栅。
3. PGND为原边功率地；两个12V偏置域独立回路，不与副边SGND暗接。
4. 栅阻/二极管待热与驱动验证后定；初版BOM预留位置。

## C. 每个SR 8脚（UCC24624D，双通道；每单元两MOS）
1. PGND=2脚，VSS=5脚；V1每单元VSS经0Ω Kelvin到SR源极；SON5x6低寄生封装不用Roffset（91Ω方案撤回）。
2. VD Kelvin直测D，预留0~10Ω，不随意1k；关断SR漏极约2Vo≈4V，非2V。
3. 1.7V再武装门槛启动期间待验证；475ns blanking影响轻载/启动，不能说不影响。
4. 每SR RMS=19.635A、峰值39.27A（已含导通占空比，不再乘0.5）；原边每MOS RMS≈6.545A+励磁。Lm=10µ、Np=3、Ae≈100mm²时Bpk≈25mT，Im_pk=0.75A。

## D. 最小硬件接口/磁件/初版BOM
1. 功率级统一候选：Lr总1µ（外置值扣实测漏感）、Cr=620n、Lm总40µ（四组10µ独立磁芯串联，K=1零漏感模型）。禁止控制稿写10µ+63n。
2. 谐振负载：Ip峰值13.09A、有效值9.256A。
3. 原边MOS：CSD19531Q5A×2（待热/驱动验证）；副边：BSC010N04LS6×8（待热/驱动验证）。
4. CT：3:1:1四件；过流检测桥+6.8Ω，约14.7A→1V、29.4A→2V；CT复位/带宽/20A额定待核验，非已验证保护。
5. 磁芯候选：B66287G0000X197+B66287K0000X197，每套Ae=130mm²；裸磁芯名义6.35+3.15=9.5mm，尺寸上限9.8mm；不得宣称加板≤10mm，需嵌板窗口及气隙机械核算。目标AL=1111nH/T²需加工，非无隙料直接10µ。
6. Cout：4m仅为仿真假设；实体建议多颗低矮聚合物+MLCC，不伪造型号。
7. 偏置：原边PGND与副边SGND分离，两路外供12V各自回路。

## 状态明示
九场LTspice理想SR功率模型：48V/19m负载Vout=1.89288V、I=99.625A，不是2.000V稳压；最终芯片联合仿真未完成。固定变比，不称闭环。
