czy0126/CZY/deepseek/v1/release_task.md

请完成工程初版最后一份可落实连接清单，不要泛泛路线。附带约束已修正包括最新VSS错误，以最后追加项为准。仅输出markdown，1200中文字以内。
按A主控8脚、B驱动DRC10脚、C每个SR8脚、D最小硬件接口/磁件/初版BOM五部分。数字遵循约束，SS不外部上拉，GD直接驱动HI/LI，EN默认低，可通过手动跳线到12V_P启动，两个偏置域分开，SR VSS=0ohm Kelvin。推荐原边CSD19531Q5A两只，副边BSC010N04LS6八只（均待热/驱动验证）。Cr共620n，Lr总1u，Lm每10u，CT3:1:1四件；Cout4m只是仿真假设，实体建议多颗低矮聚合物+MLCC但不伪造型号。磁芯候选B66287G0000X197+ B66287K0000X197，每套Ae130mm2，裸磁芯名义6.35+3.15=9.5mm，尺寸上限9.8mm；不能宣称加板就≤10mm，需嵌板窗口结构及气隙机械核算。目标AL1111nH/T2需加工，并非无隙料直接10u。CT过流检测桥+6.8ohm尚待具体CT复位/带宽/20A额定核验。明示当前九场LTspice理想SR功率模型中48V/19m负载Vout1.89288V、I99.625A，不是2.000V稳压；最终芯片联合仿真未完成。
不要把下一步称闭环，用户明确固定变比。
