czy0126/CZY/design/v2/第三轮_测量口径与能量账本_2026-10-31.md

# 第三轮：测量口径与能量账本

日期 2026-10-31。状态：**DELIVERED_SUMMARY**。本文是第三轮**唯一**的汇总表与结论；
数字只从这里引用，其他文档如与之冲突，以本文为准（冲突处应改为链接本文）。

第二轮指南 §三 限定的四件事全部落在本文：修正 `tank_metrics.py` 与验收判据、
补内部支路能量记录、给出冷启动与 200.6 kHz 工作点的统一验证方案、把 v3.3 毛刺拒绝
列为未验证假设。

## 0 结论

1. **测量口径已修正**：每通道按自身门极分类、`Vout` 改梯形时间加权、峰值取整窗最大；
   新增内部支路账本与收敛检查。离线工具 31 例测试通过（`python -m pytest tools -q`）。
2. **284.4 kHz 是软启动快照，不是稳态**：由控制器频率律反推 `V_SS≈1.41 V`，与
   `Css=10 nF / 5 µA` 的解析充电一致。设计点 200.6 kHz 已用独立 deck 单独运行
   （1 ms，取 887.6–997.3 µs 的 22 个 SR 周期）。
3. **能量恒等式闭合**：残差 0.048 %（快照）/ 0.026 %（工作点），均 < 0.5 % 判据。
4. **初稿"56 % 通过 / 70 mW"撤回**。工作点 SR 支路总耗散（沟道 + 体二极管 + Rg）
   为模型估计 **855 mW/器件、8 只 6.84 W = 179 W 的 3.82 %**；软启动快照 689 mW/器件
   （5.51 W、3.98 %）。SR 损耗不是"可忽略"项。
   **但"约为 125 mW/器件预算的 6.8 倍"这一结论已撤回**（2026-10-31 第四轮）。
   撤回理由有三：(a) 6.84 W 是一次模型积分，逐周期离散 16–23 %，不能当可签核的器件
   损耗；(b) 125 mW/器件是旧的分立预算，从未与整机输入/输出能量做过分配，直接相除
   不构成"超预算"证据；(c) 正确口径是整机损耗分配，见
   `第四轮_证据修正与数值疑点关闭_2026-10-31.md` §4。撤回后的陈述是：
   **SR 支路是整机最大单项损耗，但其绝对值应带不确定度引用，不得表述为"超出预算
   6.8 倍"。** 任何预算结论都必须先在整机 Pin/Pout 上闭合。
5. **`Qrev` 不能作判据**：工作点逐周期摆动 3–96 %（§3.4），窗口均值 314–462 nC。
   判据落在**体二极管支路耗散**上（§4），`Qrev` 只保留为比较/均流指标。
6. **v3.3 的 23 ns 毛刺拒绝仍是未验证假设**（§7 第 1 条），不得作为签核依据。

## 1 源文件（证据链）

| 文件 | 作用 | 验证 |
|---|---|---|
| `tools/tank_metrics.py` + `test_tank_metrics.py` | 端口量、逐通道分类、时间加权、整窗极值 | 13 例 |
| `tools/sr_energy_ledger.py` + `test_sr_energy_ledger.py` | 沟道/体二极管/Rg/储能 支路积分 | 4 例 |
| `tools/steady_state_check.py` + `test_steady_state_check.py` | 分窗收敛：f、Vout、Qrev、均流 | 4 例 |
| `tools/round3_summary.py` + `test_round3_summary.py` | 生成 §2 汇总表与 JSON；主频从 `V(sw)` 取中位数 | 5 例 |
| `sim/v2/sr_tank_dual_v33_internal.cir` | 284.4 kHz 软启动快照（450–500 µs，8 周期） | `round3_energy_ledger_284k.json` |
| `sim/v2/sr_tank_dual_v33_ss.cir` / `_fine.cir` | 工作点初始化；5 ns 步长 60 µs | 收敛检查（不足，见 §3.4） |
| `sim/v2/sr_tank_dual_v33_ss_1ms.cir` | 工作点 1 ms 收敛对照（887.6–997.3 µs，22 周期） | **§2 设计点行** |
| `design/v2/round3_energy_ledger_284k.json` / `_ss.json` | 两支路账本 | 残差 0.048 % / 0.026 % |
| `design/v2/round3_summary.json` | §2 表的机器可读副本 | 由上述 raw 自动生成 |
| `design/v2/SR反向电流验收判据_初稿.md` | 判据正文（第三轮修订版） | 本文 §4 是其数据来源 |

## 2 唯一汇总表

由 `tools/round3_summary.py` 直接从 raw 生成，单位见脚注。

| 案例 | f主 kHz | f门 kHz | Vout V | Pout W | Qrev nC | Qbd_rev nC | Ipk A | E_ch µJ | E_bd µJ | E_Rg µJ | P_dev mW | 8只 W | %Pout | 残差 % |
|---|---:|---:|---:|---:|---:|---:|---:|---:|---:|---:|---:|---:|---:|---:|
| 软启动快照 | 284.55 | 284.44 | 1.6649 | 138.6 | 328.6 | 236.1 | 5.44 | 0.9361 | 1.3727 | 0.1136 | 689.0 | 5.51 | 3.98 | 0.048 |
| **设计点** | **200.86** | 200.63 | **1.8920** | **179.0** | 388.1 | 114.0 | 4.78 | 1.6330 | 2.5154 | 0.1129 | **854.9** | **6.84** | **3.82** | **0.026** |

脚注：

- **f主** = `V(sw)` 上升沿间隔的中位数（±35 % 带内，剔除漏边与半周期混叠）；
  **f门** = SR 门极周期；控制器律 `1/[2(6 ns·1 A/2.5615 mA+150 ns)] = 200.609 kHz`。
- 快照 8 周期（450–500 µs）；设计点 22 周期（887.6–997.3 µs，1 ms deck）。
- `Pout = Vout²/0.020 Ω`；`P_dev` 为单器件，8 只 = 4 对 × 2 器件，假设四对对称。
  **`P_dev`/8只 是模型估计，逐周期标准差 16–23 %（第四轮 §3）；引用时必须带此不确定度。**
- `Ipk` 为整窗最大反向电流。设计点 179 W ≠ 200 W 额定，额定点损耗只会更高。
- 快照的 Vout 1.665 V 不是设计点电压，本行只用于口径对照与历史对照。

## 3 口径修正

### 3.1 每通道按**自身**门极分类

旧实现按一对中的一个门极划分 A/B 通道；当 B 先导通时，B 的电流被记到 A 名下。
现在 `pair_metrics()` 对每个通道用 `V(ga{n})`/`V(gb{n})` 各自判据。回归测试
`test_tank_metrics.py` 中的 "B on, A off" 用例固定了该行为。

### 3.2 `Vout` 用梯形时间加权

采样均值在步长不均匀（LTspice 自适应步长）时偏向点数密集的区段；改为
`time_average()` 的梯形积分除以窗口长度。

### 3.3 峰值取整窗真实极值

旧口径把"每周期峰值的平均"当极值，低估瞬态；`span_extremes()` 返回整窗 min/max
以及时间加权平均，键名显式带 `span_`。

### 3.4 频率从 `V(sw)` 取，门极不是频率基准

SR 门极的开通是**漏极振铃上的阈值事件**，周期本身抖动；在 1 ms deck 上分 6 窗
（各 20 µs）实测：

| 窗口 µs | f门 kHz | Vout V | Vpp mV | Qrev nC | 窗内 Qrev 摆幅 |
|---|---:|---:|---:|---:|---:|
| 880–900 | 200.592 | 1.88693 | 37.09 | 338.9 | 3.4 % |
| 900–920 | 200.318 | 1.88984 | 36.12 | 313.8 | 17.0 % |
| 920–940 | 200.607 | 1.88921 | 40.73 | 462.3 | 53.7 % |
| 940–960 | 200.685 | 1.89468 | 38.73 | 384.0 | 95.6 % |
| 960–980 | 201.566 | 1.89450 | 38.14 | 414.2 | 73.0 % |
| 980–1000 | 201.016 | 1.89482 | 37.75 | 352.5 | 77.4 % |

末两窗：f 差 0.27 %（容差 0.5）、Vout 差 0.016 %（0.1）、**Qrev 差 14.9 %（3.0）**。
即 `steady_state_check.py` 对 Vout 与频率判"收敛"，对 Qrev 判**不收敛**——这不是步长
问题（5 ns 已是细步长），而是 v3.3 门极与谐振腔不相锁的固有行为。因此：

- 频率只报 `V(sw)` 主边沿（表 §2 的 f主），门极周期仅作旁证；
- 能量与电荷一律取 **22 个周期**（偶数）的支路积分均值，不用单周期值；
- `Qrev` 的窗口均值带 ±25 % 量级的不确定度，不能当通过/不通过的门槛。

## 4 工作点支路账本（200.6 kHz）

证据：`sim/v2/sr_tank_dual_v33_ss_1ms.raw`，887.6–997.3 µs，22 周期，
`design/v2/round3_energy_ledger_ss.json`。残差 0.026 %。

| 支路 | µJ/周期/器件 | mW/器件 | 8 只合计 mW |
|---|---:|---:|---:|
| 沟道 | 1.6330 | 327.6 | 2621 |
| 体二极管（合计） | 2.5154 | 504.7 | 4038 |
| — 死区正向 | 2.5851 | 519.1 | — |
| — 反向恢复（模型回馈） | −0.0697 | −14.0 | — |
| 栅极电阻 Rg | 0.1129 | 22.6 | 181 |
| **合计耗散** | **4.2612** | **854.9** | **6839** |
| 栅极供电（含 100 pF 正则） | 0.1278 | 25.6 | 205 |

- 反向段取绝对值（保守，判据 §2.3：`fwd + |rev|`）：体二极管 **532.6 mW**，合计
  **882.9 mW/器件**、8 只 **7.06 W**、**3.95 %**。
- 端口反向电荷 388.1 nC 中：体二极管支路 114.0 nC（29.4 %）、沟道 0 nC、
  其余约 274.1 nC（70.6 %）是 Cds/Cgd 位移电流。**"反灌 100 % 走体二极管"不成立**，
  与 284.4 kHz 快照的 71.8 % 同样不成立。
- 正向电荷：沟道 55.8 µC/周期（约 11.2 A 平均）、体二极管 3.60 µC/周期。
  二极管的 0.72 A 平均电流全部落在门极未覆盖的窗口，这是 505 mW 的来源。
- 与快照对比：工作点体二极管损耗从 390 mW 升到 505 mW（+29 %），沟道从 266 mW
  到 328 mW（+23 %）。频率降低并没有带来损耗下降——软启动快照曾被误读为"更好的点"。

## 5 证据分层（恰好三层）

| 层 | 文件 | 用途 |
|---|---|---|
| 当前候选 | `sr_tank_dual_v33_internal.raw`（快照）、`sr_tank_dual_v33_ss_1ms.raw`（工作点） | §2 表全部数字 |
| 失败对照 | `sr_tank_dual_v33_ss.raw`（30 ns 步长，仅 3 个完整周期，均值有偏）；`sr_tank_dual_v33_ss_fine.raw`（60 µs 仅 10 个可用周期，Qrev 摆幅 49 %）；`_probe/ss_ic_b.cir`（`.ic V(ss)=4` 配 VCC 斜坡 → 232.1 kHz） | 证明"细步长/长窗口/电源常开"三项都是必需的 |
| 历史存档 | `design/v2/sr_tank_dual_results.md` §5/§6、初稿 §3 的 v2 替身表、`sr_tank_dual_v33.raw` 1.5 ms 长跑 | 只作追溯，不得再作证据引用 |

## 6 冷启动与工作点的统一验证方案（摘要）

完整步骤见 `SR反向电流验收判据_初稿.md` §7，要点：

| 运行 | deck | 初始化 | 回答 |
|---|---|---|---|
| A 冷启动 | `sr_tank_dual_v33.cir` | VCC 0→12 V 斜坡，SS 从 0 | 启动时序、软启动期 SR 行为、无直通 |
| B 工作点 | `sr_tank_dual_v33_ss_1ms.cir` | VCC=12 V 常开，`.ic V(out)=1.89 V(ss)=4` | 额定点电荷、支路损耗、均流、峰值 |

- **陷阱**：B 若保留 VCC 斜坡，FAULT 期间模型 SS 放电 FET（`RDIS=500 Ω`，τ=5 µs）
  把 `.ic` 的 4 V 泄到 3.03 V，实测 232.1 kHz 而非 200.6 kHz（`_probe/ss_ic_b.cir`）。
- **桥接**：`Css=10 nF` 下 SS 到 3.982 V 需 5.63 ms（解析值），因此 500 µs / 1 ms 的
  工作点运行只代表"初始化到的工作点"，冷启动真正到达设计点需 ≥6 ms 长跑；在此之前
  两者用该解析式连接，并标注为**外推**。
- 统一口径：每项结论必须同时给 f主、Vout 时间加权、支路账本（残差 <0.5 %）、
  均流；均流 100.000 % 是模型对称性结果，不是鲁棒性证据。

## 7 未验证假设（按风险排序）

1. **v3.3 的 23 ns 毛刺拒绝**——无器件/台架证据；数据手册传播延迟不等于滤波。
2. **SR 门极与谐振腔不相锁**（§3.4）——本模型的自激行为；真实驱动器是否同样
   逐周期摆动未知，若是，`Qrev` 类指标的批次离散会很大。
3. **PGD=1** 的等效驱动阻抗未校准（全部结论只测 PGD=0）。
4. **CPIN=100 pF** 是数值正则，不是器件电容，灵敏度未扫。
5. **封装电感** `Ld=0.3 nH / Ls=0.8 nH / Lg=2.5 nH` 是估计值。
6. **TT 反向恢复段回馈能量**（−14.0 mW）是本模型行为，判据已取绝对值保守处理。
7. **四路完全对称**——均流 100.000 % 是建模结果。
8. **179 W ≠ 200 W 额定点**；本表不能外推到额定电流。

**第四轮（2026-10-31）对本表的更新**：第 4 条已扫（1 ms 设计点，CPIN 50/100/200 pF，
见第四轮 §3：50 pF 使 `e_diss` −3.6 %、200 pF −12.9 %，仍在模型参数敏感度内）；
第 7 条确认是建模结果，**不构成均流证据**（四组 `iout` 离散 8e-9 % 只是对称性）；
第 1、3 条仍未验证，判据落在控制验证板的 T4（窄脉冲）与 T3（PGD）试验上。

## 8 复现

```bash
python tools/sr_energy_ledger.py sim/v2/sr_tank_dual_v33_internal.raw --periods 8 \
    --json design/v2/round3_energy_ledger_284k.json
python tools/sr_energy_ledger.py sim/v2/sr_tank_dual_v33_ss_1ms.raw --periods 22 \
    --t-offset-us 880 --json design/v2/round3_energy_ledger_ss.json
python tools/steady_state_check.py sim/v2/sr_tank_dual_v33_ss_1ms.raw --windows 6 --t-offset-us 880
python tools/round3_summary.py --snapshot sim/v2/sr_tank_dual_v33_internal.raw \
    --design sim/v2/sr_tank_dual_v33_ss_1ms.raw --design-deck sr_tank_dual_v33_ss_1ms.cir \
    --design-periods 22 --json design/v2/round3_summary.json
python -m pytest tools -q          # 31 例
```

LTspice 运行：`"/d/ADI/LTspice/LTspice.exe" -b -ascii sim/v2/sr_tank_dual_v33_ss_1ms.cir`
（约 2–3 min，raw 约 105 MB）。

## 9 范围（明确不做）

- 不重跑 304 个历史台架文件；不新增第二份"最终结果"文档。
- 不修改 `models/sr_timing_v3_3.lib` 与 `sr_device_v3.lib`（假设清单而非修模型）。
- 不下"通过器件签核"的结论；本文只给测量口径与实测账本。

## 10 变更记录

- 2026-10-31：建立本文。取代初稿 §6 的四条实测结论与 `sr_tank_dual_results.md`
  §5/§6 的替身表结论；`README.md`、`design/baseline/BASELINE.md` 已指向本文。
