czy0126/CZY/deepseek/v1/control_task.md

工程初版，不是路线报告。用户确认固定变比48V→约2V，100A连续/200W设计目标、46~50V初评输入、总高≤10mm、可风冷、外供原副边12V偏置。主功率半桥LLC DCX，四个独立磁芯3:1:1 CT变压器原边串联，每组CT接VOUT+，两个端点分别接低侧SR漏极，SR源极接VOUT-，四路整流后并联。总n=12，Vo≈Vin/(2n)=Vin/24（谐振增益约1）。不要重复上次错误公式。不需要精密闭环调压，保护只保留基本过流、UVLO、关断、软启动和死区。不得写已通过仿真/热验证，未核实型号或参数标候选。给可执行的初版而非再写研究计划。
任务：依据附带TI原厂完整手册，给包含实际器件和阻容的控制与功率初版，限2400中文字，勿文献综述。输出：
A 唯一文字功率连接，半桥开关节点→Cr→Lr→P1→P2→P3→P4→PGND，Cr隔直使平均偏置Vin/2，无需再堆两分压电容。磁件与负载节点明确。
B UCC25600D逐个引脚连接表（1~8，不得漏）：固定RT设频约200kHz用手册精确公式，DT先150ns，CSS先10nF；实际起始频率和burst边界计算，说明此方案软启动是否可用，不凭记忆。UCC27282选带EN的D/DRC具体封装，从手册取每脚号/电平/自举；不得混不同封装。UCC24624D每磁件一颗四颗，12V_S外供偏置，给全部脚号及REG/VS电阻/检测连接，确认1.7V最坏再武装和475ns blanking在2V应用含启动的影响。默认下拉和手动EN清楚。
C 最小过流路径：原边串联电流检测CT或分流+放大，给阈值计算与OC接法，不得仅写采样电流而无实现。可选初版硬件限流停机，区别保护候选与可验证电路。
D 候选BOM：原边100V MOS 2个，SR低压MOS8个，所有控制阻容、输入/输出/谐振电容数量和值；不伪造LCSC编码。磁件和MOS具体选择可列候选待手册核实。标出需要下一步确认的最多5个关键点。
