czy0126/CZY/deepseek/v1/final_review_task.md

请完成初版修订并检查附带网表。仅回答800中文字以内，先算再答。不要再产生新网表。前两轮错误已被独立审核纠正，corrected_constraints是本轮约束。
输出5项：1. 用已给精确公式复算RRT976ohm下稳态和SS=1.2V起始频率；2.确认半桥4x3:1:1的变比、100A目标每半副边RMS、Ae=130mm2每单元6V下Bpk，禁止再乘占空比；3.检查附带可运行网表四原边是否串联、有没有重复Lm、两半副边极性、体二极管方向、半桥PWM周期，逐项明确；4. 给完整芯片控制方案简表（UCC25600D、UCC27282DRCR、UCC24624DR四颗、CT+桥检测），不要添加栅变和SS上拉；5.界定还未完成的硬件验证（该网表是理想SR功率腔，不是芯片联合验证），下一份应交可制造资料而不是更多路线报告。
