czy0126/CZY/deepseek/v1/magnetics_task.md

工程初版，不是路线报告。用户确认固定变比48V→约2V，100A连续/200W设计目标、46~50V初评输入、总高≤10mm、可风冷、外供原副边12V偏置。主功率半桥LLC DCX，四个独立磁芯3:1:1 CT变压器原边串联，每组CT接VOUT+，两个端点分别接低侧SR漏极，SR源极接VOUT-，四路整流后并联。总n=12，Vo≈Vin/(2n)=Vin/24（谐振增益约1）。不要重复上次错误公式。不需要精密闭环调压，保护只保留基本过流、UVLO、关断、软启动和死区。不得写已通过仿真/热验证，未核实型号或参数标候选。给可执行的初版而非再写研究计划。
任务：给磁件/谐振腔/损耗的可计算初版，限1700中文字。频率以约200kHz为起点，Lr总=1uH和Cr=620nF为首次候选，Lm总40uH、每个10uH为另一独立候选，不能把旧项目5.57uH当唯一结论。计算n、反射负载Rac、Q、fr、Lm/Lr，正弦整流假设下每个SR/半绕组RMS、总原边RMS、励磁峰值、100A铜损预算。若估计不合理明确修改。
磁芯首轮可评估TDK ELP32/6/20+I32/3/20（不是两个E叠起来！），必须明确Ae尺寸未给不编造，给Ae=100mm2的保守临时算例并标不是该型号数据；Np:Ns:Ns=3:1:1，每单元约6V、200kHz，计算Bpk、AL=10u/9、简化有效气隙。输出铜箔绕组初版：原边3T，副边各1T，厚度/宽度/长度暂定、交流趋肤和端子损耗，是否能塞入磁芯窗口必须待图纸验证。给实际Lr=外置+四个折算漏感的测量法。用计算预算而非伪造效率。给明确材料/加工图待定项，目标≤10mm优先，可牺牲面积。MOS暂按热态SR 1.5mohm、原边8mohm估导通，副边一组每半周一管，不要当8管全时并联。
