czy0126/CZY/design/v1/simulation_summary.csv

step | Vin_V | Rload_ohm | vout_avg | iout_avg | vout_pp | ipri_rms | ipri_pk | isa1_rms | isb1_rms
1 | 46 | 0.2 | 1.89066298315 | 9.45331491472 | 0.0033156874124 | 0.9710843179 | 1.36707806587 | 1.87168159381 | 1.87817457137
2 | 48 | 0.2 | 1.97369428486 | 9.86847142538 | 0.00344668794423 | 1.01474205033 | 1.42811763287 | 1.95456490766 | 1.96011485703
3 | 50 | 0.2 | 2.05672575353 | 10.2836287667 | 0.00358462356962 | 1.0583858804 | 1.48930323124 | 2.03438259576 | 2.04508860964
4 | 46 | 0.04 | 1.85665570438 | 46.4163926094 | 0.0152998408303 | 4.34937754796 | 6.18233108521 | 9.12617893805 | 9.16450014619
5 | 48 | 0.04 | 1.9382420563 | 48.4560514004 | 0.0159468709026 | 4.54065864081 | 6.45422315598 | 9.51972133832 | 9.5753252444
6 | 50 | 0.04 | 2.01981976413 | 50.4954941118 | 0.0165685435059 | 4.73176911499 | 6.72399425507 | 9.92665728962 | 9.97199846651
7 | 46 | 0.019 | 1.81320951537 | 95.4320797558 | 0.0318549070507 | 8.91871186301 | 12.6759195328 | 18.7938957976 | 18.8875443816
8 | 48 | 0.019 | 1.89288001996 | 99.6252642282 | 0.0332827400416 | 9.31052047453 | 13.2340717316 | 19.6265374412 | 19.7105194551
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
