czy0126/CZY/references/datasheets/bsc010n04ls6_p1.png

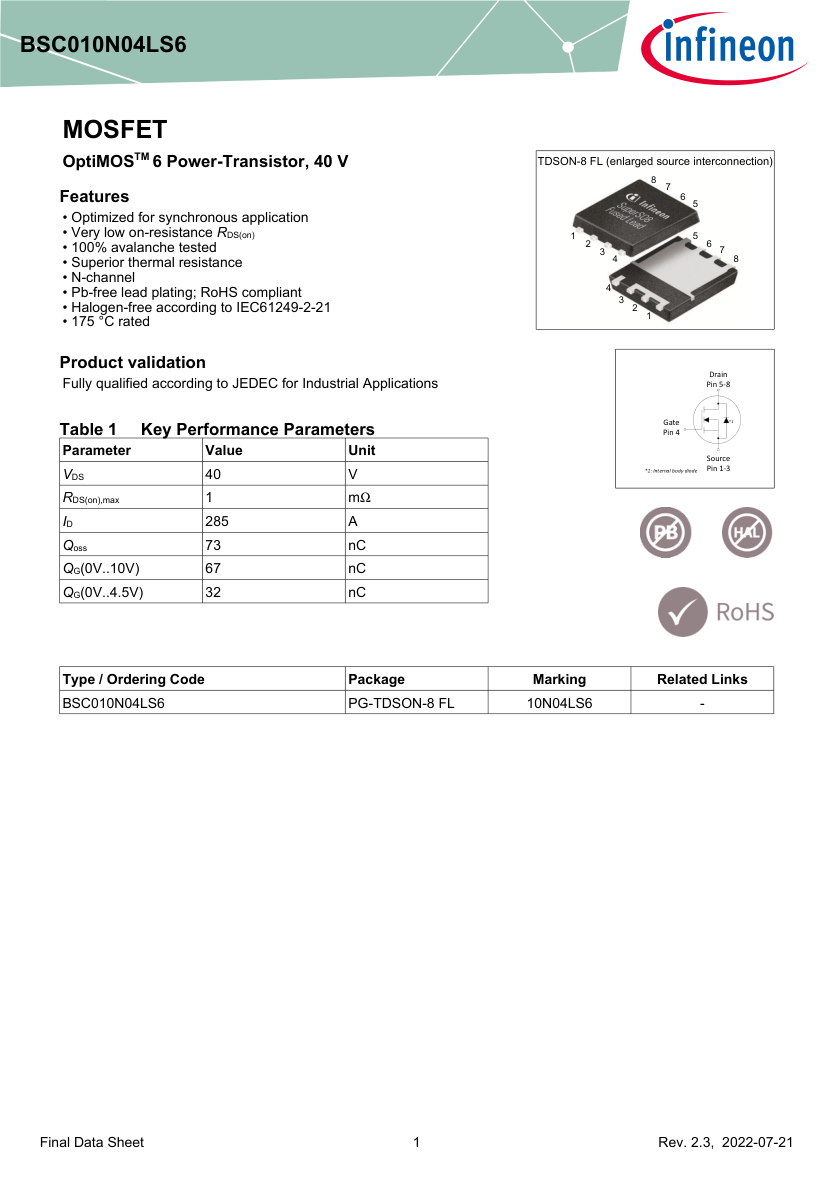
references/datasheets/bsc010n04ls6_p1.png
