czy0126/CZY/references/datasheets/csd19531q5a_p1.png

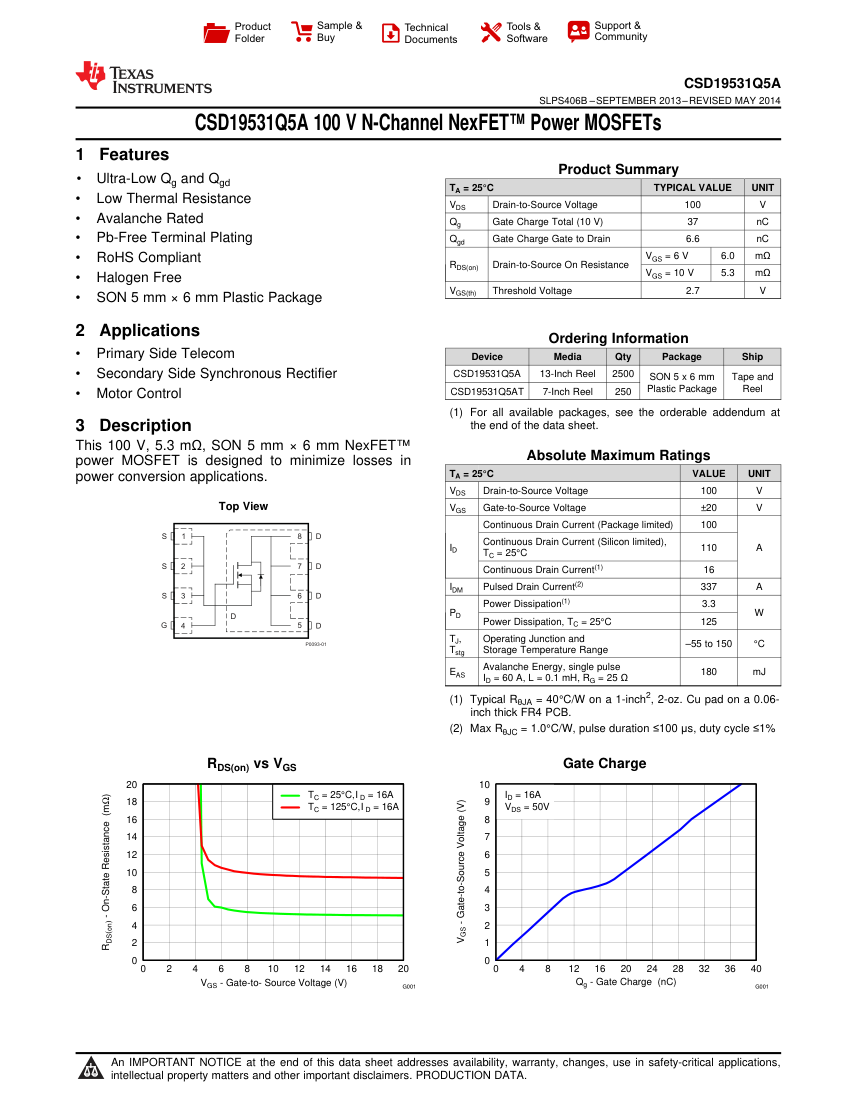
references/datasheets/csd19531q5a_p1.png
