czy0126/CZY/references/datasheets/csd19531q5a_p6_soa_zoom.png

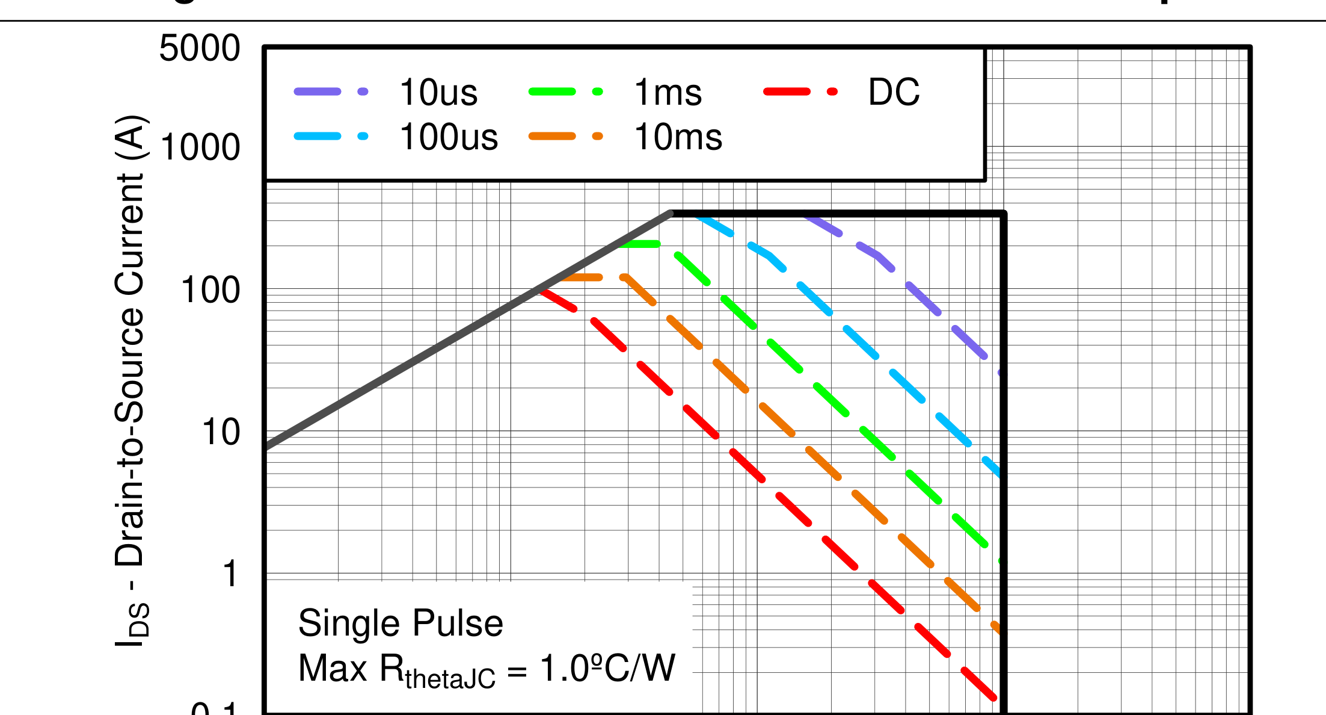
references/datasheets/csd19531q5a_p6_soa_zoom.png
