czy0126/CZY/references/datasheets/elp32_p4.png

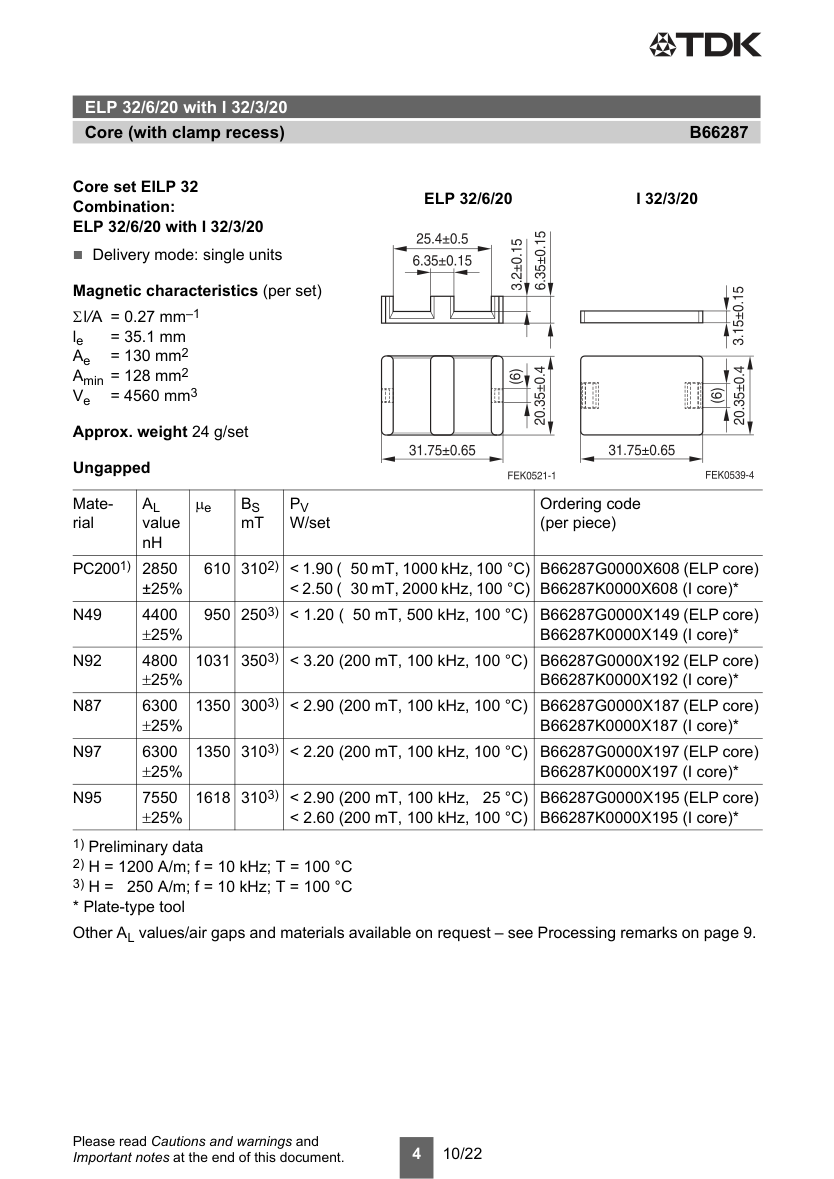
references/datasheets/elp32_p4.png
