czy0126/CZY/references/datasheets/ucc24624_p3.png

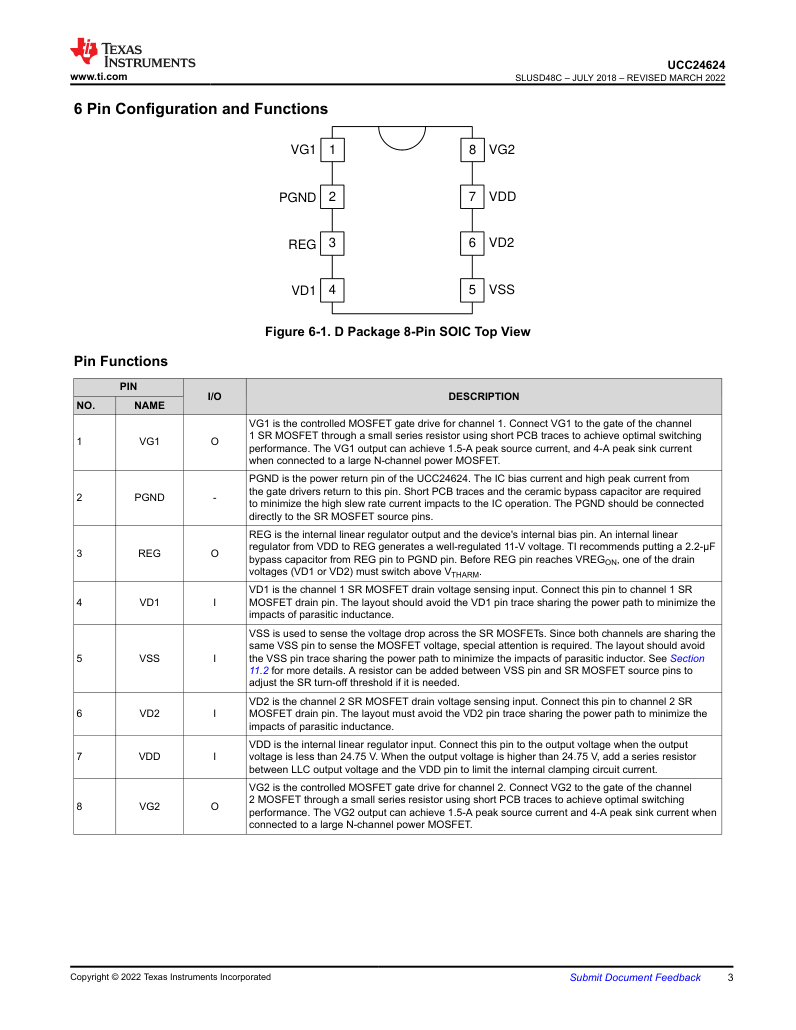
references/datasheets/ucc24624_p3.png
