czy0126/CZY/references/datasheets/ucc24624_p6.png

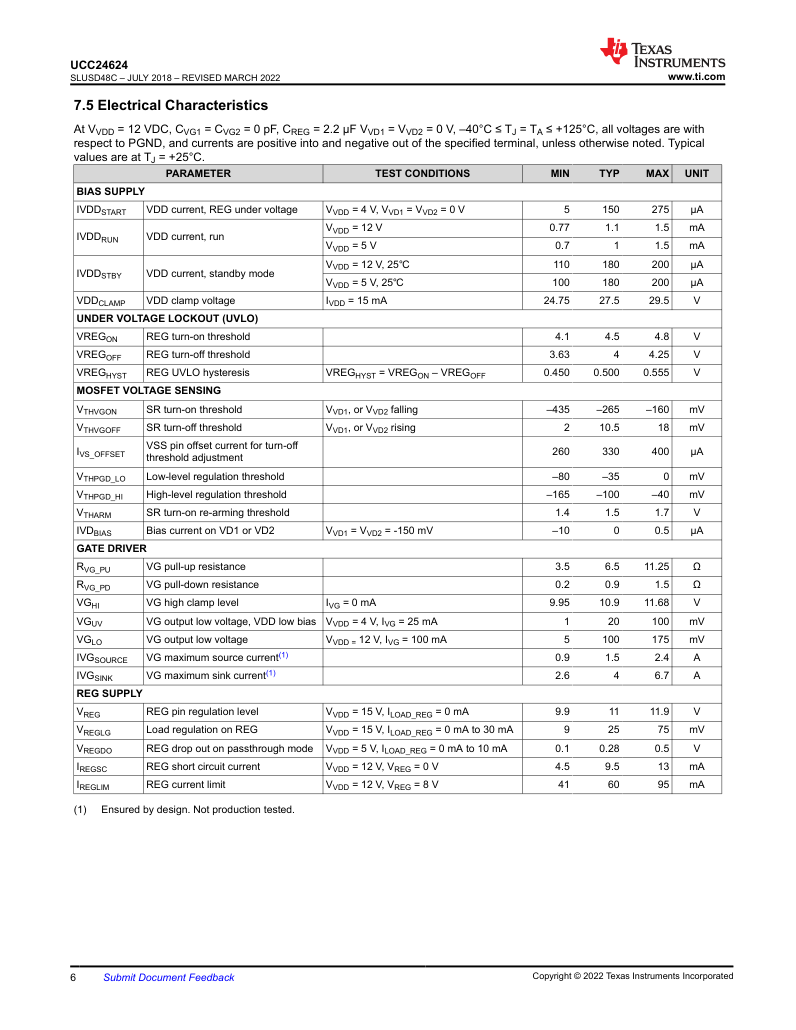
references/datasheets/ucc24624_p6.png
