czy0126/CZY/references/datasheets/ucc24624_p20.png

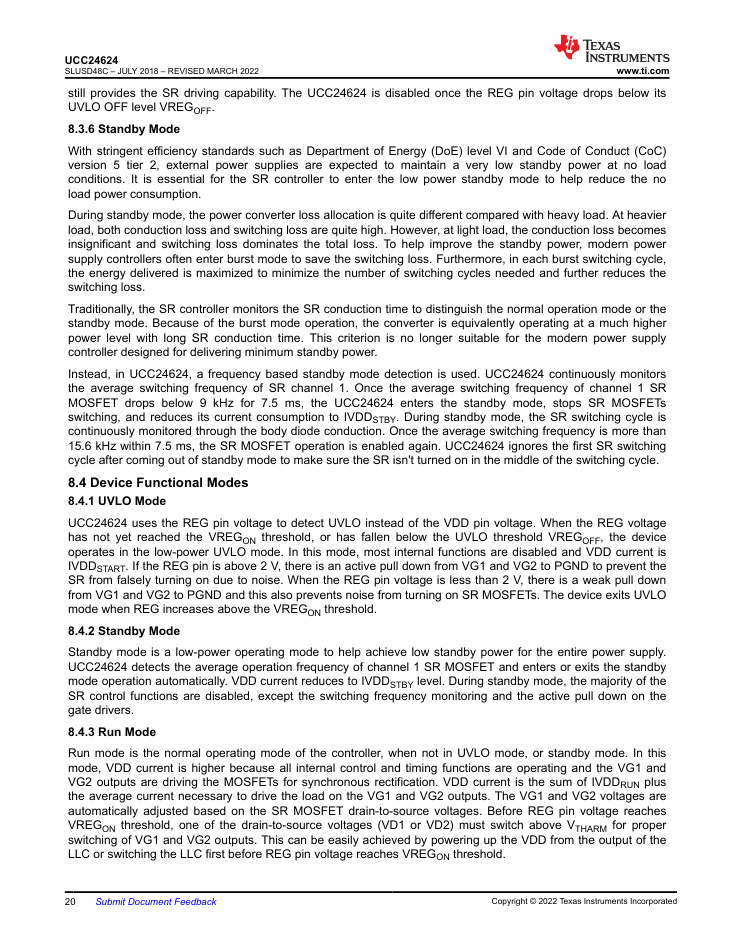
references/datasheets/ucc24624_p20.png
