czy0126/CZY/references/datasheets/ucc25600_p3.png

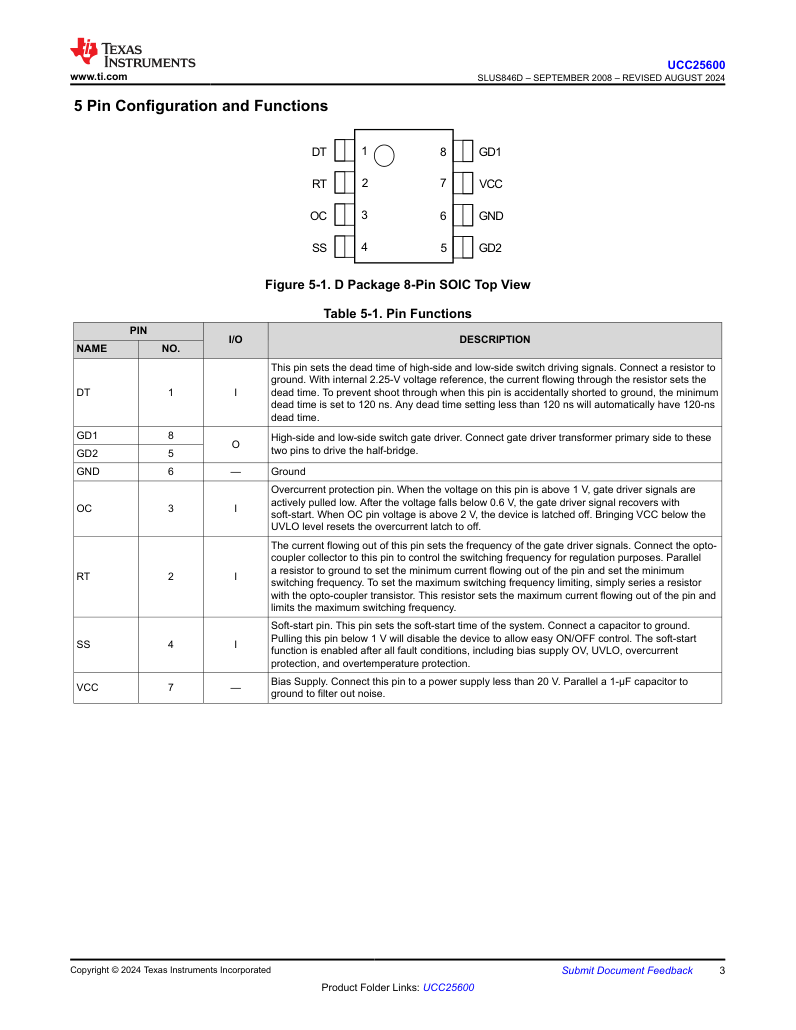
references/datasheets/ucc25600_p3.png
