czy0126/CZY/references/datasheets/ucc25600_p10.png

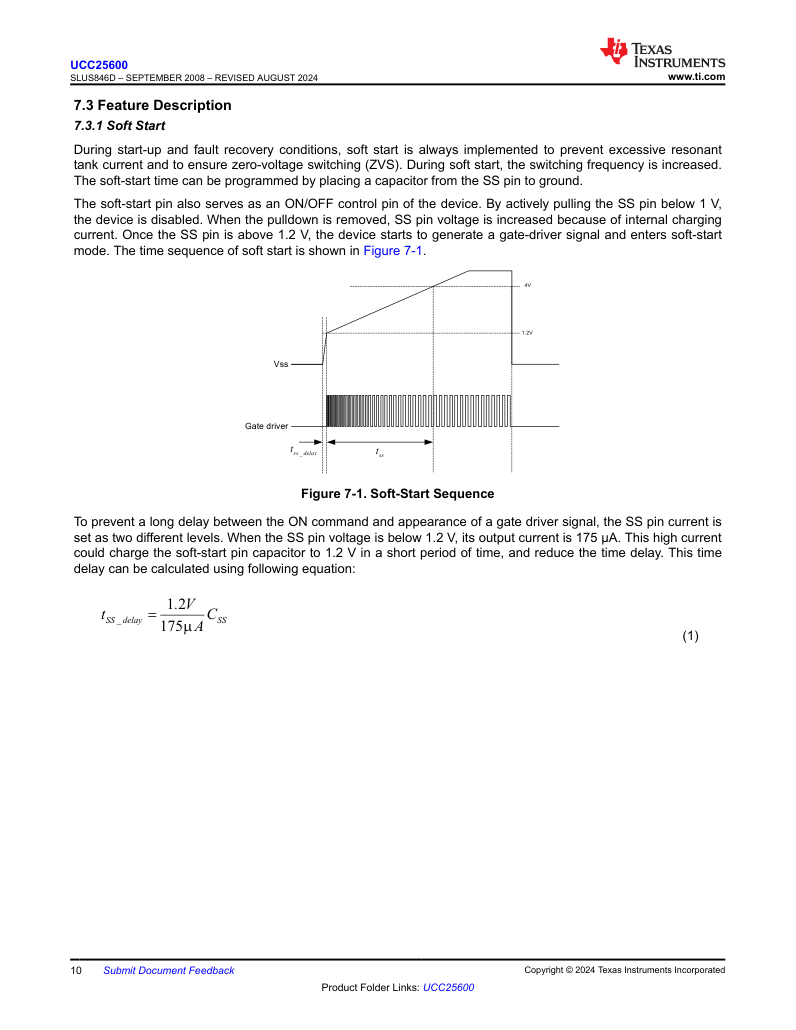
references/datasheets/ucc25600_p10.png
