czy0126/CZY/references/datasheets/ucc25600_p17.png

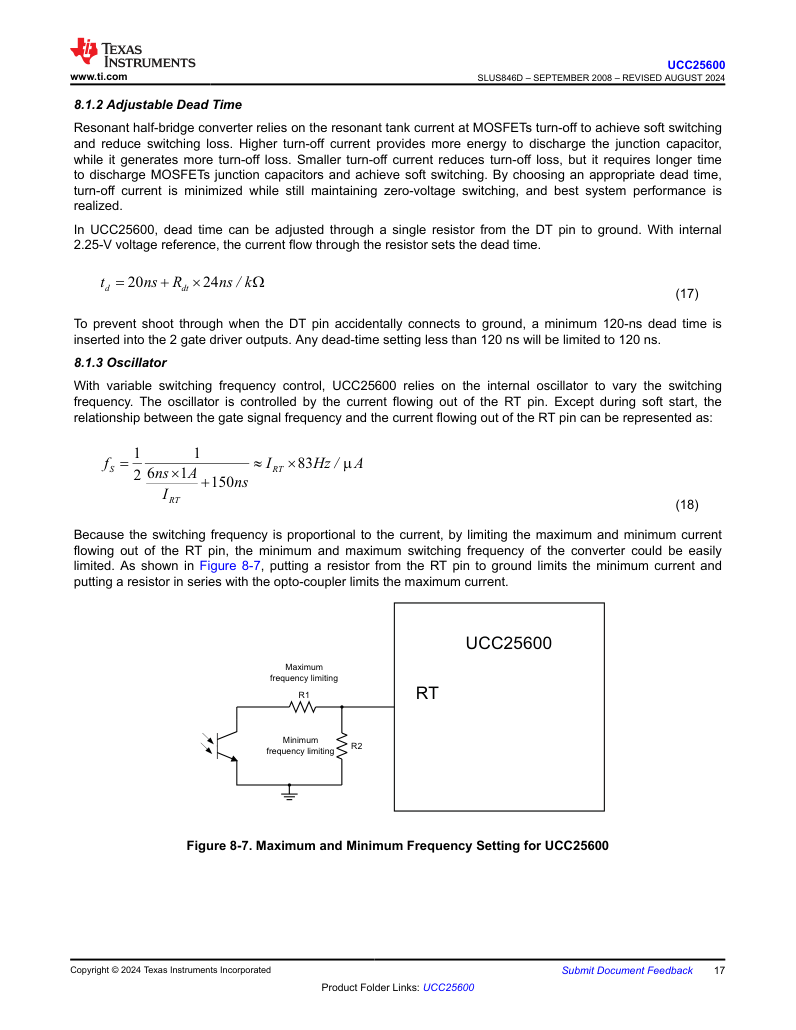
references/datasheets/ucc25600_p17.png
