czy0126/CZY/references/datasheets/ucc27282_p3.png

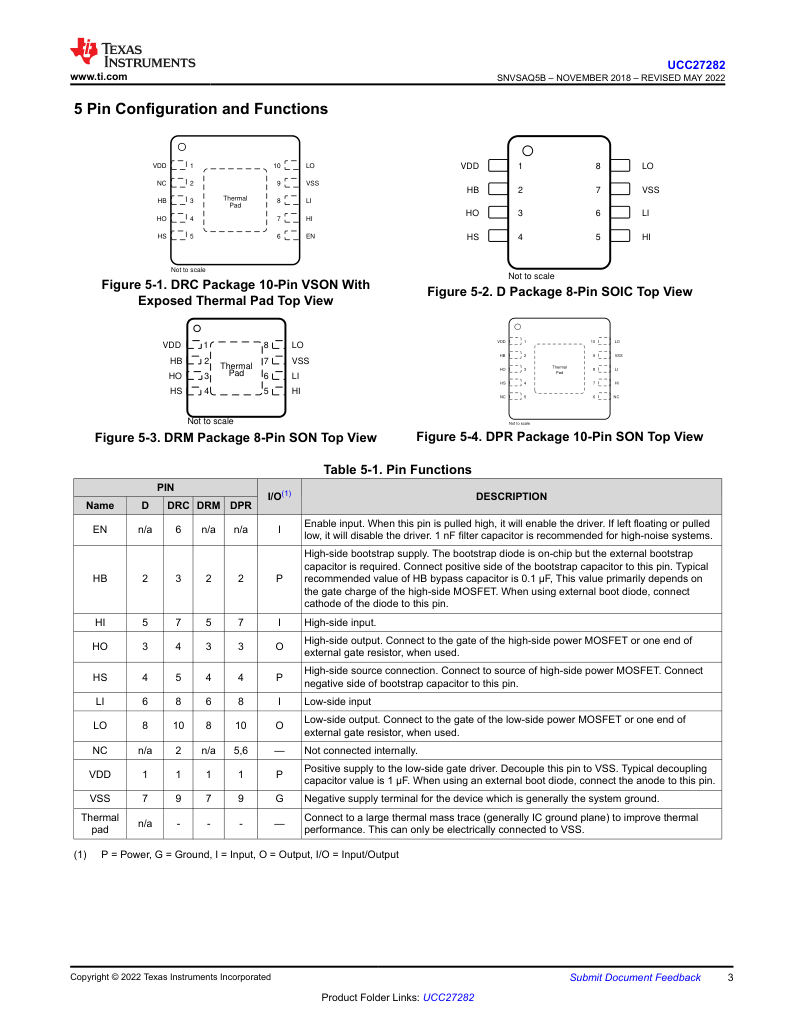
references/datasheets/ucc27282_p3.png
