czy0126/CZY/design/v3/bom/功率级元件需求与BOM草案_2026-11-01.md

# 功率级元件需求与 BOM 草案（Stage D 输入）

日期：2026-11-01
状态：**BOM 草案 + 由模型工作点推算的元件需求，不是冻结 BOM，不是硬件验证。**
本文件补的是路线图 §4/§5 与第三次审核 Stage D 要求的"正式 BOM"中最缺的定量部分。

## 0. 本轮新增的可核对数字

| 量 | 值 | 来源与校验 |
|---|---|---|
| 输出电容纹波电流（RMS） | **52.48 A**（峰峰 189.84 A，峰值 122.93 A） | 由 100 A raw 的四路 SR 电流按 KCL 重建；重建平均 99.7516 A vs `average(Vout)/RL` 99.8246 A，偏差 **−0.073 %** |
| Cr / Lr 串联电流 | 9.450 A RMS，13.881 A 峰值；峰值储能 96.35 µJ | `operating_point_100a.json` 的实测原边电流 |
| 输出路径损耗 | 0.05 / 0.10 / 0.15 mΩ → 0.50 / 1.00 / 1.49 W | 99.82 A² × R |
| 48 V 母线输入电流 | 平均 **4.1532 A**（Pin 199.35 W），半桥侧 RMS **6.746 A** / 交流 RMS **5.316 A** | 专用探针 deck 实测，见 §3.4 |
| Lr 匝数/气隙 | ELP32 N97：**3 匝 1.444 mm**（Isat 120.9 A）。2 匝 0.628 mm（Isat 80.6 A）已被实测故障峰值淘汰，见 §3.3 | `tools/lr_design.py`，见 §3.3 |
| Cout 数量 | 470 µF/3 mΩ 料号需 **15 只**，由 **ESR** 决定（容量只需 9 只、电流只需 5 只） | `tools/cout_bank.py`，见 §3.1 |
| Cr 电压应力 | 直流 23.89 V、**峰值 41.36 V**、峰峰 34.73 V → 100 V 额定裕量 **2.42×** | 由 `I(Lr)` 积分重建，见 §3.2 |
| Cr 的 ESR 上限 | 允许 1 W → 整组 ESR ≤ **11.2 mΩ**（这才是 Cr 的选型约束） | 同上 |

四组副边同相驱动，纹波电流相加而不是交错抵消：单组交流分量 13.12 A RMS，四组相关叠加为 52.48 A。
若布局/驱动偏斜使相关性下降，下限为 √4 × 13.12 = 26.2 A；**52.48 A 是相关最坏值，选型按此做。**

## 1. BOM 状态图例

- `VERIFIED`：手册在 `references/datasheets/`，封装与额定已在手册中核对。
- `VALUE FROZEN`：`design/v1/pin_connections.csv` 或参数表已定值，但料号/封装未选。
- `TO SELECT`：只有电气需求，尚未选型。
- `TO BUILD`：自制件（变压器绕组）。

完整清单：`bom_draft.csv`（27 行，含 IC 6 只、MOS 10 只、磁件 3 类、无源与连接器）。

## 2. 已核实的器件（不得随意替换）

| 器件 | MPN | 封装 | 依据 |
|---|---|---|---|
| LLC 控制器 | UCC25600D | SOIC-8 | `ucc25600.txt` p3 |
| 半桥驱动 | UCC27282DRCR | SON-10 3×3 mm | `ucc27282.txt` p3、p10 引脚 |
| 双 SR 控制器 ×4 | UCC24624DR | SOIC-8 | `ucc24624.txt` p6 |
| 原边 MOS ×2 | CSD19531Q5A | SON 5×6 mm，100 V，5.3 mΩ typ | `csd19531q5a.txt` |
| SR MOS ×8 | BSC010N04LS6 | PG-TDSON-8，40 V，~0.9 mΩ @10 V | `bsc010n04ls6.txt`；行为模型已对齐 15 项手册目标 |
| 磁芯 ×4 套 | B66287G0000X197 + B66287K0000X197 | ELP 32/6/20 + I 32/3/20，N97 | `elp32.txt`；磁件设计包 |

注意：CSD19531Q5A 与 BSC010N04LS6 同为 5×6 类封装但**脚序不同**，不能共用同一封装映射（`design/v1/初版设计说明.md`）。

## 3. 待选型项及其判据

### 3.1 输出电容 Cout（最大缺口）

需求同时有三条，缺一不可：

1. **容量 ≥ 4 mF**：模型用 4 mF 电容，100 A 下 Vout 峰峰 49.73 mV。
2. **ESR**：模型 Cout **已带 `Rser=0.2 mΩ`**（`sim/v3/sr_tank_dual_v33_ss_1ms_100a.cir` 第 184 行），
   因此 49.73 mV 峰峰**已经包含** ESR 压降（0.2 mΩ × 189.84 A ≈ 38 mV 量级，与容性部分部分抵消）。
   硬件整组 ESR 目标 ≤0.2 mΩ 与模型一致；更低的 ESR 只会减小纹波，但不能假设 49.7 mV 是纯容性纹波。
3. **RMS 电流 ≥ 52.5 A**。

三条**不成比例**：一只典型的 470 µF / 2.5 V 聚合物电容 ESR 是 3–6 mΩ，是整组目标 0.2 mΩ 的
15–30 倍，而容量只要 9 只就够。所以**数量由谁也不由容量决定，而是由 ESR 决定**：

| 候选料号（检索摘要，**未读原厂 datasheet**） | 单只 C / ESR / RMS | 容量需 | ESR 需 | RMS 需 | **取** | 整组 C | 整组 ESR | 高度 |
|---|---|---|---|---|---|---|---|---|
| KEMET A720V477M2R5APE003（2917，7.3×4.3 mm） | 470 µF / 3 mΩ / 11.69 A | 9 | **15** | 5 | **15** | 7.05 mF | 0.200 mΩ | 1.9 mm |
| KEMET A798D477M2R5PTE006 | 470 µF / 6 mΩ / 6.46 A | 9 | **30** | 9 | **30** | 14.1 mF | 0.200 mΩ | 3.1 mm |
| Chemi-Con APSF2R5ELL471MF08S（径向 6.3×8） | 470 µF / 5 mΩ / 5.9 A | 9 | **25** | 9 | **25** | 11.75 mF | 0.200 mΩ | 8.0 mm |

计算见 `tools/cout_bank.py`（测试 `tools/test_cout_bank.py`），输出 `cout_bank.json`。

**三条结论：**

- **ESR 是主导约束，且余量悬殊**：3 mΩ 料号下 ESR 要 15 只、容量只要 9 只、电流只要 5 只。
  任何"4 mF 凑够就行"的判断会少买 6 只，整组 ESR 变成 0.33 mΩ——单是 ESR 压降
  （189.84 A × ESR）就从 38 mV 升到 63 mV。
- **低 ESR 的贴片件在面积和高度上都赢**：15 × 31.4 mm² ≈ **471 mm²** 占位（另加间距/禁布区），
  1.9 mm 高；径向件虽然只贵 10 只，但 8.0 mm 高几乎吃掉整个 10 mm 高度预算，**在薄型机里不可用**。
  6 mΩ 的贴片件要 30 只、842 mm²，等于用面积换 ESR。
- **0.2 mΩ 这个目标本身没有规格背书**：它只是模型里 `Rser` 跑的值。BOM 早先写的
  "≤0.1–0.2 mΩ"若取 0.1 mΩ，3 mΩ 料号要 **30 只**——数量直接翻倍。项目至今**没有定义 Vout 纹波规格**，
  所以 0.2 mΩ 是"与模型一致"而不是"满足某个要求"。定纹波规格是产品决策，定完这个表才有意义。

**并联定律的边界**：整组 ESR = 单只 / N 只对**电容本体**成立，不含 PCB 铺铜与过孔的分布电阻。
15 只并联时这部分不可忽略，实际整组 ESR 会高于 0.200 mΩ，除非双面铺铜、多点过孔、电容紧贴功率级。

结论：Cout 不是"4 mF 随便凑"，它是面积、高度和温升的主要驱动项之一。**选型前不要冻结叠层**，
也**不要在没有纹波规格的情况下冻结数量**。

### 3.2 Cr（谐振电容）

0.62 µF、≥9.45 A RMS @200.6 kHz、峰值 13.9 A。薄膜电容优先；RMS 额定必须按 200 kHz 降额核对。

**电压应力原来是个空白，现在测出来了。** `V(Cr)` 没有保存，但 Cr 与 Lr 串联，所以它的电压由
串联电流积分决定：

```
v(t) = v(0) + (1/C)·∫i dt
```

积分常数不是自由的。稳态下变压器原边平均电压为零（磁通平衡）、电感平均电压为零（伏秒平衡），
于是半桥中点上的直流只能落在隔直电容上：**mean(v_Cr) = mean(V(sw))**。
两路都用本 raw 实测，结果：

| 量 | 实测 | 说明 |
|---|---|---|
| mean(V(sw)) = v_Cr 直流 | **23.893 V** | = 48 V × 占空比 0.4977，与 DT 设的略微小于 50 % 一致 |
| v_Cr 峰值 | **41.36 V** | |
| v_Cr 谷值 | 6.63 V | 不会反向，隔直正常 |
| 峰峰摆幅 | **34.73 V** | ±17.4 V 叠在 23.9 V 上 |
| 100 V 额定裕量 | **2.42×** | |
| 22 周期积分残差 | −0.366 V（1.05 %） | 等价平均电流偏 2.1 mA / 9.45 A ≈ 0.02 %，说明窗口与周期对齐良好 |

计算见 `tools/cr_stress.py`（测试 `tools/test_cr_stress.py`），输出 `cr_stress.json`。

**所以"≥100 V"这条站得住**：41.36 V 对 100 V 是 2.42 倍，63 V 也有 1.52 倍但没必要为省一点体积去冒险。
**真正卡选型的不是电压，是 ESR。** 薄膜电容在这个电压下不缺耐压，缺的是 200 kHz 下的纹波电流能力，
而那是发热问题：

- 允许 1 W 耗散（约为 188 W 输出的 0.5 %）→ **整组 ESR ≤ 11.2 mΩ**；
- 1 mΩ 的整组 ESR 只耗 0.089 W，余量很大；
- 因此并联几只不是由电压或容量决定，而是由"整组 ESR 与散热"决定，选型时按 200 kHz 的 ESR 额定核对。

**未验证**：只重建了稳态 100 A 点；冷启动（36 A）与短路（65/74 A）的 v_Cr 未重建，
摆动会更大但直流分量仍由占空比决定。重建用**标称** C = 0.62 µF，电容容差按比例直接进入 v_pp——
±10 % 的容差就是 ±10 % 的摆幅，但 2.42 倍裕量吃得下。

### 3.3 Lr（谐振电感）

1.0 µH（外置，计入四只变压器折算漏感后配平），稳态峰值 13.9 A，峰值储能 96.3 µJ。
真正的约束不是稳态而是**必须不饱和地通过的电流**：

| 工况 | 峰值 | 来源 |
|---|---|---|
| 稳态 100 A | 13.88 A | `operating_point_100a.json` |
| 每次冷启动（冻结 deck 0.92 µH / 4 mF） | 36.07 A | `真实控制与SR验证进展.md` §14（实跑） |
| 短路，OC 13 µs（Coc 1 nF） | 65 A | 同上 |
| 短路，OC 51.3 µs（Coc 10 nF） | 73.68 A | 同上 |
| 冷启动，**物理配置**（1.0 µH 外置 / 7.05 mF） | 22.53 A | `lr_design.json:physical_peaks` |
| 短路到 OC 动作，**物理配置** | **84.02 A** @1.0 µH（5.5998 ms 动作）、**104.17 A** @0.875 µH（5.5963 ms） | `cold_oc_phys.log`、`cold_oc_lrmin.log` |

前四行是冻结 deck 的旧台账；后两行是 2026-11-01 按实际配置（外置 Lr 1.0 µH、15 × 470 µF）
重跑冷启动与过流 deck 的实测。**峰值必须和它跑的那个 L 配对**——`L·I` 不是常数，
把 1.0 µH 的 84.02 A 按 1/L 折算到 0.875 µH 得 96.0 A，实测是 104.17 A（低 8.5 %）。

判据取 `B = L·I/(N·Ae) ≤ 0.9·Bsat`，Bsat(N97) = 0.310 T。对 ELP32（Ae = 130 mm²）逐项算：

| 匝数 | 气隙 | B@65 A | B@73.7 A | Isat（到 Bsat） | 铜损 @9.45 A | 13 µs OC | 51 µs OC |
|---|---|---|---|---|---|---|---|
| 1 | 0.137 mm | 0.500 T | 0.567 T | 40.3 A | 0.067 W | 失败 | 失败 |
| **2** | **0.628 mm** | **0.250 T** | 0.283 T | **80.6 A** | **0.140 W** | **通过** | 失败（0.91 Bsat） |
| 3 | 1.444 mm | 0.167 T | 0.189 T | 120.9 A | 0.223 W | 通过 | 通过 |
| 4 | 2.588 mm | 0.125 T | 0.142 T | 161.2 A | 0.324 W | 通过 | 通过 |

**结论（2026-11-01，物理 deck 实测后重写）：选 3 匝，保留已冻结的 51 µs OC。**
"二选一"被实测关掉了——2 匝不是"差 1.5 %、可以靠漏感救回来"，而是已经越过 Bsat 本身：

| 实测点 | 峰值 | 外置 Lr | B(N=2) | B(N=3) |
|---|---|---|---|---|
| 冷启动 | 22.53 A | 1.0 µH | 0.087 T | 0.058 T |
| 故障到 OC 动作 | 84.02 A | 1.0 µH | 0.323 T | 0.215 T |
| 故障到 OC 动作（配平窗口另一端） | 104.17 A | 0.875 µH | **0.351 T** | **0.234 T** |
| 判据线 0.9·Bsat / Bsat | — | — | 0.279 / 0.310 T | 0.279 / 0.310 T |

- **2 匝的 Isat 是 80.6 A，两个实测峰值都超过它**：B 到 0.323 T / 0.351 T，比 Bsat 本身
  还高 4 % / 13 %。此前"首件漏感 ≥20 nH 即可把 2 匝压回 0.9 判据"的推论基于 73.68 A 的
  冻结 deck，现在不成立：判据线的电流上限是 80.6 A，而实测已经越过去了。
- **3 匝在两端分别是 0.215 T / 0.234 T**，判据余量换算成电流：1.0 µH 端 0.9·Bsat 对应
  108.8 A（34 % 余量），0.875 µH 端对应 124.3 A（19 %）。两个配平端点都过。
- 代价不变：气隙 **1.444 mm**（2 匝方案 0.628 mm 的 2.3 倍），边缘磁通对 18 mm 铜箔的影响
  不可忽略（Dowell 一维模型未含），能否做成预开气隙件仍须向厂商确认。
- 选 3 匝意味着**不动已冻结的控制值**（`Coc` 10 nF / 51 µs），也不再需要 13 µs 那条
  "用 OC 速度换气隙"的路线；启动裕量保持 1.80×，不吃 CT 变比与比较器容差。

因此 BOM 中 Lr 定为 **ELP32 N97、3 匝、气隙 1.444 mm、`Isat` 120.9 A**；外置电感量按
首件漏感实测配平到 `L_ext = 1.00 µH − L_meas`（见 §3.3 上文与 `lr_design.json:tank`）。
计算见 `tools/lr_design.py`（测试 `tools/test_lr_design.py`）。

**未验证**：Isat 用的是"B 到 Bsat"的一阶判据，不是实测 B-H 曲线；84/104 A 峰值来自**线性** Lr
模型，饱和后 di/dt 升高、峰值会更大，0.9 裕量正是为此留的；边缘磁通损耗未计。

### 3.4 输入电容 Cin

已测。专用探针 deck `sim/v3/sr_tank_dual_v33_ss_1ms_100a_cin.cir` 与 100 A 母 deck **只差一行**
（`.save` 末尾加 `I(Cin) I(Rin)`，`diff` 可验证），运行 197 388 点、22 个周期，窗口与母 deck 相同。

| 量 | 实测 | 说明 |
|---|---|---|
| I(Cin) 平均 | **4.25 µA** | 稳态自检：\|均值\|/RMS = 1.9×10⁻⁵，说明窗口确实是稳态、探针符号无错 |
| I(Cin) 交流 RMS | **0.227 A** | **这是模型的假象，不是选型依据** |
| I(Rin) 平均（母线输入电流） | **4.1532 A** | → 输入功率 199.35 W |
| I(Rin) 交流 RMS | 5.262 A | |
| 半桥输入电流（KCL：`I(Rin) − I(Cin)`） | 均值 4.1532 A，RMS **6.746 A**，交流 RMS **5.316 A** | 这才是输入滤波要供给的电流 |

**为什么不能拿 0.227 A 去选 Cin**：模型电源是 48 V 理想源串 1 mΩ，而 20 µF 在 200.6 kHz 的容抗是
39.7 mΩ（外加 5 mΩ ESR），电源阻抗比电容阻抗低约 40 倍，纹波自然走电源、不走电容。真实 48 V 母线
是电缆供电，源阻抗远大于 45 mΩ，纹波几乎全部由本地电容承担。

**判据**：Cin 按**半桥输入电流**选，≥5.32 A RMS @200 kHz，并承受 13.9 A 的重复峰值脉冲。
若实际源阻抗 Z_s 与电容阻抗可比，可按 I_cap ≈ I_bridge · Z_s/(Z_s+Z_cap) 折算；只有确认源阻抗
远低于 45 mΩ（本地大电容/电池）时才允许下调。

**独立交叉校验**（同一 raw，`I(Lr)` 也在保存列表内）：

- 本 raw 的 I(Lr) RMS = 9.4502 A，与 `operating_point_100a.json` 的 9.45014 A 一致；
- 半桥输入电流在 **47.6 %** 的采样点上与 I(Lr) 相等、在 **48.9 %** 上约等于 0——正是半桥单臂导通/
  关断的占空图样；
- RMS 6.746 A ≈ √D·Ipri_rms = √0.51 × 9.4502 = 6.75 A。即**输入电流 RMS 是 √D 倍原边 RMS，不是原边 RMS**。

**顺带的口径说明**：由实测 I(Rin) 平均值算得模型级 Pin = 48 × 4.1532 = 199.35 W，对应模型效率
188.345/199.35 = **94.46 %**。这与 `magnetics_design.json` 的 92.33 % **不是同一口径**：后者含
0.75 W 辅助电源、1.495 W 输出路径（两者都不在模型里），且用 Dowell 计算铜损 2.135 W，
而模型绕组 Rser 只给出 1.548 W（原边 4×3 mΩ、副边 8×0.15 mΩ）。两个数各自成立，不得互相引用。

### 3.5 CT（过流检测）

**先纠一处口径错误**：`design/v1/pin_connections.csv` 的 OC 脚写"CT_RECT → 100 Ω → OC；220 p → PGND"，
这是 v1 旧值，v2 起已被下面的网络取代，**不得再用于选型或画原理图**。

实际链路（`sim/v3/sr_tank_dual_v33_ss_1ms_100a.cir` 第 118–123 行，与 v2 一致）：
CT 1 匝（Lm 2 µH）/ 100 匝（20 mH，K = 0.9999）串在 Cr 与 Lr 之间 → 肖特基桥 → 负载电阻 10 Ω →
`Rf` 1 k / `Cf` 47 n（τ = 47 µs）→ 分压 `Rd1` 10 k / `Rd2` 24 k → OC 脚，`Coc` 10 n 到分压中点。

- **门槛口径**：UCC25600 Level-1 `VOC` = **1 V 关驱动**，Level-2 = **2 V 闩锁**
  （`ucc25600.txt` p.215–218）。2 V 是闩锁门槛，**不是**过流门槛；本文件早先版本把两者混用了。
- **延迟**：51.3 µs；瓶颈是 `Rd1 × Coc` = 10 k × 10 n = 100 µs。`Coc` = 1 nF 后 13 µs，
  代价是启动裕量 1.80× → 1.37×（均见 `docs/续接任务书_真实控制与SR.md`）。
- **链路是线性的：CT 副边是电流源，整流桥不削波**。副边串在谐振腔里，安匝平衡强制
  `i_sec = i_pri/N`，与桥是否导通无关；`2Vf` 是 CT 必须提供的**合规电压**（compliance），
  进磁通，不进信号。所以 `V(ocd)` 的平均就是 `R_b·mean(|i_sec|)`，**没有导通下限，也没有"42 mV"这回事**。
  这一条是本文件早先版本最大的错误，见下。

- **deck 头注的 0.04365 V/A 与 22.9 A 可以精确复现**：`10 × (2/π) / 100 × 24/35`。
  其中 2/π 是 47 µs RC 对整流波取平均（**不是**峰值）；分压分母是 35 k 而不是 34 k，
  因为 `Rf` 1 k 串在抽头之前，属于上臂。这两点漏掉任何一个，门槛就算错。
  头注的 22.9 A 同时假定谐振电流是正弦（峰值/平均 = π/2 = 1.571）；实跑是 **1.660**，
  所以真实门槛比头注高 5.7 %。

- **实测校核（新增两个 deck 变体，只改 `Rbur`/`Rd1` 并补存 `V(ocd)` 等节点）**：

  | 变体 | 负载 | `Rd1` | OC 脚@额定 | 代数预测 | 实测门槛 |
  |------|------|-------|-----------|---------|---------|
  | `..._ct10.raw` | 10 Ω | 10 k | **0.5731 V** | 0.5724 V（+0.1 %） | **24.18 A** |
  | `..._ct47.raw` | 47 Ω | 110 k | **0.6904 V** | 0.6997 V（−1.3 %） | **19.65 A** |

  两个点跨 4.7 倍负载同时对上，才算把模型钉死；单点吻合可能是误差相消。

- **本文件早先版本的"削波 / 42 mV / 41.5 A / 需 219 % 增益 / 建议 47 Ω + 110 k"全部作废**。
  当时的模型假设"桥只在 `R_b·|i_sec| > 2Vf` 时导通"，predicted 0.061 V 而 deck 实测 0.834 V，
  差 13.7 倍；`V(ocd)` 实测从 0.004 V 连续升到 1.382 V、无死区，证明没有削波。
  错误模型不仅算错了门槛，还导出了一个会把变流器在 37 % 额定负载就关断的"修正"。

- **结论：10 Ω / 10 k 保持不变（`R3`、`R16` 已由 `TO SELECT` 改为 `VALUE FROZEN`）**。
  与 22.9 A 精确对应的负载是 **10.58 Ω**，板上的 10 Ω 只差 5.5 %，落在 CT 变比
  （通常 ±1–3 %）与分压 1 % 电阻的容差之内；换成 47 Ω 反而把门槛压到 19.7 A，
  且功耗从 89 mW 涨到 0.42 W。

  **2026-11-03 修正**：这里的 89 mW 与下表 0.089 W 是 **100 A** 工况的数（`ct_design.json`
  用 `R_b·(I_rms/N)²`，口径本身正确），不是 120 A；把 120 A 的实测波形代入同一口径得到
  **125.7 mW**（`tools/oc_burden_pulse.py` → `oc_burden_pulse.json`），已达 0.125 W 0805
  标称的 **100.6 %**，故障脉冲峰 9.36–10.08 W / 0.123–0.131 mJ。（SOURCE-05 里另一个
  **103 mW** 变体才是 `mean(V)²/R`，比 RMS 口径低 form factor² = 1.21 倍。）所以
  **10 Ω 的阻值仍然冻结，但器件必须重选**：BOM `R3` 保持 `VALUE FROZEN`，MPN 与封装改成
  `TO SELECT`。

| 负载 | OC 脚@额定 | 实测/代数门槛 | 对额定峰值 | 负载功耗 | B/Bsat |
|---|---|---|---|---|---|
| **10 Ω** | **0.573 V** | 24.2 A | 1.75× | 0.089 W | 0.0072 |
| 22 Ω | 1.261 V | 11.0 A | 0.79×（误动作） | 0.20 W | 0.0109 |
| 47 Ω | 2.693 V | 5.2 A | 0.37×（误动作） | 0.42 W | 0.0185 |
| 100 Ω | 5.730 V | 2.4 A | 0.17×（误动作） | 0.89 W | 0.0346 |

  （22/47/100 Ω 行是"负载改而分压不变"，与上表两个实测变体不是同一组条件；
  功耗按 `R_b·(I_rms/N)²`（100 A 窗口；120 A 的同口径实测是 125.7 mW，见上面的修正）。
  磁芯始终不是瓶颈，最高 3.5 % Bsat；
  注意合规电压 `2Vf` ≈ 1.14 V 在 10 Ω 时已**大于**负载自身的伏秒，磁通里它是主项。）

- **仍未验证**：CT 的励磁支路（20 mH）在故障电流下的分流、core reset、以及 47 µs RC 的
  相位滞后对**实际关断时刻**的影响（24.2 A 是直流等效门槛，不是观察到跳闸的峰值）。
  **51.3 µs 延迟不变**（瓶颈仍是 `Rd1×Coc`），它只影响模拟侧。

- 仍须台架实测，不能只信代数：建模假设（正弦副边、Vf 取单点、忽略 20 mH 励磁支路）写在
  `ct_design.json:caveats`；故障电流有直流偏置时磁芯会单边走，本模型不覆盖。
- 选型需覆盖：额定电流、带宽（含 200 kHz 纹波）、复位、隔离、副边负载电阻容差。

### 3.6 连接器与铜排

100 A 下每 0.1 mΩ 即 1.0 W。`tools/connector_budget.py` 把这条路径拆成三项，其中两项可精确算、
第三项**算不出来**。

**铜排（可精确计算）**：20 × 2 mm 铜排、80 mm 长，20 °C 电阻 **0.034 mΩ**，100 A 下 **0.345 W**；
40 °C 环境下的温升 **13.9 K（h = 8 W/m²K）～29.2 K（h = 4 W/m²K）**。自然对流系数本身是手册区间，
所以温升只能给区间。这就是全部能确定的部分。

**接点（算不出来）**：螺栓压接或焊接的接触电阻取决于镀层、力矩、表面粗糙度与压接方式，
本环境读不到原厂数据。工具把它作为**显式输入**（默认 50 µΩ/处 × 2 处），并标 `UNVERIFIED`。
关键是这个占位值一放进去，结论立刻变了：

| 单处接触电阻 | 整条路径 | 功耗 | 占 188 W 输出 |
|---|---|---|---|
| 20 µΩ | 0.074 mΩ | 0.74 W | 0.40 % |
| 50 µΩ | 0.134 mΩ | 1.34 W | 0.71 % |
| 100 µΩ | 0.234 mΩ | 2.34 W | 1.25 % |

**所以"0.1 mΩ = 1.0 W"这个预算本身是做不到的**：两处各 50 µΩ 的接点就已经把 0.1 mΩ 用光，
留给铜排的长度是 0。工具因此返回 `feasible: false`，而不是把预算截断到 0 再印一个好看的铜排长度。

**但 `feasible: false` 判的是一个没有来由的数字。** 0.1 mΩ 是自选的（项目没有 Vout 跌落规格），
而**磁件包公布的 92.33 % 整机效率是按 0.15 mΩ / 1.495 W 算的**——两份文件用的不是同一个口径。
用 0.1 mΩ 判连接器、用 0.15 mΩ 算效率，两边互相矛盾；这不是接点的错，是预算没统一。
工具现在同时报告两个数，并把**设计基准取在 0.15 mΩ**：

| 项 | 值 |
|----|-----|
| 设计基准 | 0.15 mΩ → 100 A 下 1.50 W（与 92.33 % 的 1.495 W 同口径） |
| 铜排 20×2×80 mm | 34.5 µΩ |
| 留给两处接点 | 115.5 µΩ |
| **单处接点上限** | **57.8 µΩ** |

这就是首件四线法要对照的判据——**57.8 µΩ/处**，不是占位值 50 µΩ。50 µΩ 落在这个上限以内
（余量 7.8 µΩ/处），所以按占位值算是有余量的；一旦实测超过 57.8 µΩ，要么改接点、要么缩铜排长度、
要么重算效率（每超 10 µΩ/处，100 A 下多 0.2 W，约 0.1 % 效率）。
严格口径的 0.1 mΩ 仍然报告出来，供愿意付 20 µΩ 接点代价的方案对照：
接点做到 ≤20 µΩ 时整条路径 0.074 mΩ / 0.74 W。

三条出路仍然摆着（**尚未决定**）：

1. 接点做到 ≤20 µΩ（提高力矩/增大接触面积/压接），把 0.1 mΩ 留给铜排；
2. 减少接点数量（铜排直接焊到板/端子压铸一体），把两处并成一处；
3. 接受设计基准 0.15 mΩ（57.8 µΩ/处），效率按 92.33 % 兑现。

BOM 中 `J_OUT` 因此仍为 `TO SELECT`，但已从"未选型"变成"**几何已定、接点待实测，判据 57.8 µΩ/处**"。

**输入侧**同样不能想当然：实测半桥输入 RMS **6.746 A**，2 mm 宽 2 oz 铜箔每 100 mm 耗散 **0.56 W**。
按 0.1 W/100 mm 反解，需要 **11.2 mm 宽**（或等效加厚/铺铜）。端子本身 ≥10 A 额定绰绰有余，
**卡住的是走线宽度，不是端子**。

首件必须做四线法测接点电阻，否则上表只是一个占位符展开的三行。

## 4. 控制与无源值（已冻结，料号待分配）

`pin_connections.csv` 给出控制脚位与阻容值：RT 976 Ω、DT 5.36 kΩ、SS 10 nF、REG 2.2 µF、
门阻 2.2 Ω、VDD 1 µF+100 nF+10 µF、HB 220 nF。BOM 中标记 `VALUE FROZEN`，
料号/封装（0603/0805/1206）在摆件前统一分配，并逐项核对额定电压（HB 电容 ≥25 V）。

**同一句"HB ≥25 V"不能套到自举二极管上。** 两者跨接的节点不同（deck 第 125–126 行）：

```
Dbt aux hb DBOOT        ; 阳极 aux = VCC12 = 12 V，阴极 hb
Cbt hb sw 220n Rser=.05 ; 电容跨在 hb 与 sw 之间
```

| 件 | 承受的应力 | 最坏值 |
|----|---|---|
| `Cbt` / `C5` 220 nF | `hb − sw` = 自举电压，恒 12 V | 12 V（≥25 V 是对的） |
| `Dbt` / `D_BT` | `hb − aux`，QH 导通时 60 V − 12 V | **48 V** |

`D_BT` 行原写 "≥25 V"，只有实际反压的一半，每次 QH 开通都会雪崩击穿。已改为 `≥100 V`。
平均电流 `Qg·f = 48 nC × 200.6 kHz = 9.63 mA`（`Qg` 取手册 max；deck 的 `Cgh = 4 nF` 在 12 V 下同为 48 nC），
每周期压降 218 mV，所以约束是**耐压**不是电流。
**这几个数不能从 deck 测出**：`Bgh` 是接在 `gh0`–`sw` 之间的电压源，门极电荷不经过 `Cbt`，
模型里的自举电容只是恒定 12 V 偏置，`I(Dbt)` 除启动充电外为零。9.63 mA 与 218 mV 是代数值，
峰值 ~0.4 A 是推导值，全部**未实测**。结构锁
`test_the_deck_does_not_load_the_bootstrap_capacitor` 保证这条前提不被悄悄改掉。
这条值错误是**人工复核**抓到的，不是 `bom_gaps()`——那个工具只查位号在不在网表里，不查值。
回归锁见 `test_the_bootstrap_diode_holds_off_the_full_input_voltage`（已验证旧值下为红）。

两处**不能照抄 CSV**：

1. **OC 网络已被 v2 取代**（见 §3.5）：CSV 的"100 Ω + 220 pF"过时，实际是 10 Ω 负载 + 1 k/47 n +
   10 k/24 k 分压 + `Coc` 10 nF。照 CSV 画会把 51.3 µs 的检测延迟改掉。
2. **门阻的两种数字已解释清楚（2026-11-01 结案）**：CSV 的 2.2 Ω 是**外置电阻**，
   deck 的 `Rgh`/`Rgl` = 3.2 Ω 是**集总阻抗**，两者不是同一个量。
   证据来自两份手册与模型的三方对齐（`tools/test_gate_drive_calibration.py` 逐条锁死）：

   | 器件 | 内部上拉 | 内部下拉 | + 外置 2.2 Ω | 模型里的值 |
   |---|---|---|---|---|
   | UCC24624（SR） | 6.5 Ω typ | 0.9 Ω typ | **8.7 / 3.1 Ω** | `sr_timing_v3.lib` 正是 8.7/3.1 |
   | UCC27282（半桥） | 1.3 Ω typ | 0.85 Ω typ | **3.5 / 3.05 Ω** | deck 用单个 3.2 Ω |

   UCC24624 的两个 typ 值（RVG_PU 6.5、RVG_PD 0.9）加上 2.2 Ω **逐位等于**时序模型的 8.7/3.1，
   所以 2.2 Ω 就是模型校准时用的外置电阻，也就是要上板的那个值。
   UCC27282 的 1.3/0.85 Ω 由手册 `VLOH = 0.13 V @ −100 mA`、`VLOL = 0.085 V @ +100 mA` 反算；
   加 2.2 Ω 后是 3.5/3.05 Ω，deck 的单个 3.2 Ω 落在两者之间，因此作集总近似是合理的，
   **不构成矛盾**——但也说明 deck 没有区分开通/关断的非对称性（差约 0.45 Ω）。
   BOM 的 `R4 R5` 与 `R20-R27` 因此统一按 **2.2 Ω 外置**冻结。
   注意 `VLOH/VLOL` 在提取文本里只有两列（无 MIN 列），按 TYP/MAX 读，这条解读本身也写进了测试。

已在 v3 deck 里逐项对上的：RT 976、DT 5.36 k、SS 10 n、HB 220 n。REG 2.2 µF 与 VDD 的
1 µF+100 nF+10 µF 在 UCC25600/UCC24624 行为模型内部，**不在 deck 网表里，本轮未核**。

## 5. 与现有交付的关系

| 输入 | 用途 |
|---|---|
| `design/v3/magnetics/operating_point_100a.json` | 原边电流、频率、Vout |
| `sim/v3/sr_tank_dual_v33_ss_1ms_100a.raw` | 四路 SR 电流 → Cout 纹波重建 |
| `design/v1/pin_connections.csv` | 控制脚位与阻容值 |
| `references/datasheets/*.txt` | 器件封装/额定核对 |
| `design/v3/magnetics/磁件设计包_2026-10-31.md` | 磁件 MPN、绕组、高度 |

## 6. 复算

```bash
python tools/passive_requirements.py --json design/v3/bom/passive_requirements.json
python tools/passive_requirements.py --cin-raw sim/v3/sr_tank_dual_v33_ss_1ms_100a_cin.raw \
    --json design/v3/bom/passive_requirements.json     # 追加 §3.4 的输入电流
python tools/lr_design.py --json design/v3/bom/lr_design.json   # §3.3 的匝数/气隙表
python tools/cout_bank.py --json design/v3/bom/cout_bank.json   # §3.1 的并联数量表
python tools/cr_stress.py --json design/v3/bom/cr_stress.json   # §3.2 的 v_Cr 重建（读 313 MB raw，约 2 s）
python -m pytest tools -q
```

## 7. 未验证假设（不得当结论引用）

1. pair 2/3 未记录，Cout 纹波按模型对称性由 pair 1/4 推得；硬件四组若不同相，纹波介于 26.2–52.5 A。
2. 模型输出电容为 4 mF + 0.2 mΩ 串联电阻，49.73 mV 已含 ESR 分量；ESL 与负载线未建模。
   **0.2 mΩ 不是规格，只是模型参数**——项目没有定义 Vout 纹波上限，取 0.1 mΩ 数量翻倍（§3.1）。
   §3.1 的候选料号来自检索摘要，**未读原厂 datasheet**；2 V 偏压下的实际容量、ESR 随温度与寿命的
   变化、以及 15 只并联的铺铜分布电阻都未计入，整组 ESR 实际会高于"单只/N"。
3. Cin 的 0.227 A 只是在 1 mΩ 理想源下的值；§3.4 的 5.32 A 是按"电缆供电、源阻抗 ≫45 mΩ"推的，
   真实源阻抗未定。CT 与连接器未选型。
4. Lr 的饱和判据是 `B = L·I/(N·Ae) = 0.9·Bsat` 的一阶式，不是实测 B-H 曲线；而 65/74 A 峰值本身
   来自**线性**模型，真实饱和后峰值更高。气隙边缘磁通损耗未计，匝数最终由首件漏感实测决定。
5. §3.2 的 v_Cr 是**重建值**不是实测值：`V(Cr)` 未保存，波形由 `I(Lr)` 积分得到，直流分量靠
   "mean(v_Cr) = mean(V(sw))"这条磁通平衡关系定。重建用标称 C，容差按比例进入摆幅（§3.2）。
   冷启动与短路工况的 v_Cr 未重建；11.2 mΩ 的 ESR 上限用 1 W 这个**自选**预算，不是给定规格。
6. 本 BOM 没有 LCSC 料号与库存核对；**在逐项分配编号并核库存前，不得称为可采购 BOM**。
7. 全部数字来自模型与手册计算，未做硬件测量。
