czy0126/CZY/hardware/dcx_main/supplier_component_selection_template.csv

ref | priority | function | required_value_or_rating | existing_package | previous_mpn | proposed_mpn | manufacturer_datasheet_uri | actual_package | pad_map_reviewed | electrical_stress_accepted | lead_time_or_stock | owner | reviewer | decision
CT | P0 | over-current CT | 100:1; 1 V Level-1 VOC; as built 10 ohm burden + 24/35 divider reads 0.573 V at 13.86 A and trips at 24.2 A (measured); core B/Bsat 0.7 % | - | TO SELECT |  |  |  | NO | NO |  |  |  | PENDING
Cin | P0 | 48 V input capacitor bank | 48 V bus; >=5.32 A RMS at 200 kHz (bridge ripple); 13.9 A pulses | - | TO SELECT |  |  |  | NO | NO |  |  |  | PENDING
Cout | P0 | output capacitor bank | 15 x 470 uF 2.5 V 3 mohm (ESR-driven: cap needs 9, RMS needs 5); >=4 mF; >=52.5 A RMS; bank ESR <=0.2 mohm; part data unverified | polymer SMD | TO SELECT |  |  |  | NO | NO |  |  |  | PENDING
Cr | P0 | resonant capacitor | 0.62 uF; peak v_Cr 41.4 V (reconstructed) vs 100 V rated = 2.42x; 9.45 A RMS at 200.6 kHz; bank ESR <=11.2 mohm for 1 W | film | TO SELECT |  |  |  | NO | NO |  |  |  | PENDING
D_BT | P0 | bootstrap diode | >=100 V reverse - HB is 60 V against VCC12 12 V when QH is on, so 48 V; If avg 9.6 mA (Qg 48 nC datasheet max x 200.6 kHz; the deck's 4 nF Cgh gives the same 48 nC); droop 218 mV on 220 nF; peak ~0.4 A recharge spike is derived, NOT measured - the deck's Bgh is a source to sw, so Cbt is never loaded | 0603 | TO SELECT |  |  |  | NO | NO |  |  |  | PENDING
Lr | P0 | resonant inductor | 1.0 uH external (trim to 1.00 uH tank total minus measured leakage); 13.9 A steady, 22.5 A startup (physical deck), 84.0 A @1.0 uH and 104.2 A @0.875 uH fault-to-trip; ELP32 N97 3 turns 1.44 mm gap (2 turns gives 0.351 T > Bsat 0.310 T, eliminated) | - | TO SELECT |  |  |  | NO | NO |  |  |  | PENDING
T1 | P0 | transformer winding | 3:1:1 centre-tapped; Lm 10 uH; gap 0.121 mm | foil 0.10 x 18 mm | TO BUILD |  |  |  | NO | NO |  |  |  | PENDING
T2 | P0 | transformer winding | 3:1:1 centre-tapped; Lm 10 uH; gap 0.121 mm | foil 0.10 x 18 mm | TO BUILD |  |  |  | NO | NO |  |  |  | PENDING
T3 | P0 | transformer winding | 3:1:1 centre-tapped; Lm 10 uH; gap 0.121 mm | foil 0.10 x 18 mm | TO BUILD |  |  |  | NO | NO |  |  |  | PENDING
T4 | P0 | transformer winding | 3:1:1 centre-tapped; Lm 10 uH; gap 0.121 mm | foil 0.10 x 18 mm | TO BUILD |  |  |  | NO | NO |  |  |  | PENDING
C10 | P1 | REG capacitors | 2.2 uF each | 0603 | TO ASSIGN |  |  |  | NO | NO |  |  |  | PENDING
C101 | P1 | VDD decoupling | 1 uF + 100 nF at each of the six ICs; the 10 uF bulk cap is NOT in this row | 0603/0805 | TO ASSIGN |  |  |  | NO | NO |  |  |  | PENDING
C102 | P1 | VDD decoupling | 1 uF + 100 nF at each of the six ICs; the 10 uF bulk cap is NOT in this row | 0603/0805 | TO ASSIGN |  |  |  | NO | NO |  |  |  | PENDING
C103 | P1 | VDD decoupling | 1 uF + 100 nF at each of the six ICs; the 10 uF bulk cap is NOT in this row | 0603/0805 | TO ASSIGN |  |  |  | NO | NO |  |  |  | PENDING
C104 | P1 | VDD decoupling | 1 uF + 100 nF at each of the six ICs; the 10 uF bulk cap is NOT in this row | 0603/0805 | TO ASSIGN |  |  |  | NO | NO |  |  |  | PENDING
C105 | P1 | VDD decoupling | 1 uF + 100 nF at each of the six ICs; the 10 uF bulk cap is NOT in this row | 0603/0805 | TO ASSIGN |  |  |  | NO | NO |  |  |  | PENDING
C106 | P1 | VDD decoupling | 1 uF + 100 nF at each of the six ICs; the 10 uF bulk cap is NOT in this row | 0603/0805 | TO ASSIGN |  |  |  | NO | NO |  |  |  | PENDING
C107 | P1 | VDD decoupling | 1 uF + 100 nF at each of the six ICs; the 10 uF bulk cap is NOT in this row | 0603/0805 | TO ASSIGN |  |  |  | NO | NO |  |  |  | PENDING
C108 | P1 | VDD decoupling | 1 uF + 100 nF at each of the six ICs; the 10 uF bulk cap is NOT in this row | 0603/0805 | TO ASSIGN |  |  |  | NO | NO |  |  |  | PENDING
C109 | P1 | VDD decoupling | 1 uF + 100 nF at each of the six ICs; the 10 uF bulk cap is NOT in this row | 0603/0805 | TO ASSIGN |  |  |  | NO | NO |  |  |  | PENDING
C11 | P1 | OC filter (Cf) | 47 nF; tau with Rf = 47 us | 0603 | TO ASSIGN |  |  |  | NO | NO |  |  |  | PENDING
C110 | P1 | VDD decoupling | 1 uF + 100 nF at each of the six ICs; the 10 uF bulk cap is NOT in this row | 0603/0805 | TO ASSIGN |  |  |  | NO | NO |  |  |  | PENDING
C111 | P1 | VDD decoupling | 1 uF + 100 nF at each of the six ICs; the 10 uF bulk cap is NOT in this row | 0603/0805 | TO ASSIGN |  |  |  | NO | NO |  |  |  | PENDING
C112 | P1 | VDD decoupling | 1 uF + 100 nF at each of the six ICs; the 10 uF bulk cap is NOT in this row | 0603/0805 | TO ASSIGN |  |  |  | NO | NO |  |  |  | PENDING
C12 | P1 | OC hold (Coc) | 10 nF (51.3 us OC delay); 1 nF gives 13 us | 0603 | TO ASSIGN |  |  |  | NO | NO |  |  |  | PENDING
C13 | P1 | EN filter | 1 nF to PGND at U2.6 | 0603 | TO ASSIGN |  |  |  | NO | NO |  |  |  | PENDING
C5 | P1 | HB bootstrap | 220 nF; >=25 V | 0805 | TO ASSIGN |  |  |  | NO | NO |  |  |  | PENDING
C6 | P1 | SS capacitor | 10 nF | 0603 | TO ASSIGN |  |  |  | NO | NO |  |  |  | PENDING
C7 | P1 | REG capacitors | 2.2 uF each | 0603 | TO ASSIGN |  |  |  | NO | NO |  |  |  | PENDING
C8 | P1 | REG capacitors | 2.2 uF each | 0603 | TO ASSIGN |  |  |  | NO | NO |  |  |  | PENDING
C9 | P1 | REG capacitors | 2.2 uF each | 0603 | TO ASSIGN |  |  |  | NO | NO |  |  |  | PENDING
R1 | P1 | DT resistor | 5.36 kohm; 1% | 0603 | TO ASSIGN |  |  |  | NO | NO |  |  |  | PENDING
R10 | P1 | U2 control pull-downs and run jumper | R7 10k EN->PGND; R8 1k RUN jumper->12V_P; R9 10k HI->PGND; R10 10k LI->PGND | 0603 | TO ASSIGN |  |  |  | NO | NO |  |  |  | PENDING
R15 | P1 | OC filter series (Rf) | 1 kohm; 47 us with Cf | 0603 | TO ASSIGN |  |  |  | NO | NO |  |  |  | PENDING
R16 | P1 | OC divider top (Rd1) | 10 kohm; 1%; as built - kept | 0603 | TO ASSIGN |  |  |  | NO | NO |  |  |  | PENDING
R17 | P1 | OC divider bottom (Rd2) | 24 kohm | 0603 | TO ASSIGN |  |  |  | NO | NO |  |  |  | PENDING
R18 | P1 | QH gate-source pull-down | 10 kohm | 0603 | TO ASSIGN |  |  |  | NO | NO |  |  |  | PENDING
R19 | P1 | QL gate-source pull-down | 10 kohm | 0603 | TO ASSIGN |  |  |  | NO | NO |  |  |  | PENDING
R2 | P1 | RT resistor | 976 ohm; 1% | 0603 | TO ASSIGN |  |  |  | NO | NO |  |  |  | PENDING
R20 | P1 | SR gate resistor | 2.2 ohm; UCC24624 6.5/0.9 ohm + 2.2 = the model's 8.7/3.1 | 0603 | TO ASSIGN |  |  |  | NO | NO |  |  |  | PENDING
R21 | P1 | SR gate resistor | 2.2 ohm; UCC24624 6.5/0.9 ohm + 2.2 = the model's 8.7/3.1 | 0603 | TO ASSIGN |  |  |  | NO | NO |  |  |  | PENDING
R22 | P1 | SR gate resistor | 2.2 ohm; UCC24624 6.5/0.9 ohm + 2.2 = the model's 8.7/3.1 | 0603 | TO ASSIGN |  |  |  | NO | NO |  |  |  | PENDING
R23 | P1 | SR gate resistor | 2.2 ohm; UCC24624 6.5/0.9 ohm + 2.2 = the model's 8.7/3.1 | 0603 | TO ASSIGN |  |  |  | NO | NO |  |  |  | PENDING
R24 | P1 | SR gate resistor | 2.2 ohm; UCC24624 6.5/0.9 ohm + 2.2 = the model's 8.7/3.1 | 0603 | TO ASSIGN |  |  |  | NO | NO |  |  |  | PENDING
R25 | P1 | SR gate resistor | 2.2 ohm; UCC24624 6.5/0.9 ohm + 2.2 = the model's 8.7/3.1 | 0603 | TO ASSIGN |  |  |  | NO | NO |  |  |  | PENDING
R26 | P1 | SR gate resistor | 2.2 ohm; UCC24624 6.5/0.9 ohm + 2.2 = the model's 8.7/3.1 | 0603 | TO ASSIGN |  |  |  | NO | NO |  |  |  | PENDING
R27 | P1 | SR gate resistor | 2.2 ohm; UCC24624 6.5/0.9 ohm + 2.2 = the model's 8.7/3.1 | 0603 | TO ASSIGN |  |  |  | NO | NO |  |  |  | PENDING
R28 | P1 | SR drain Kelvin link | 0 ohm; VD1/VD2 must sense at the SR drain, not at the pad | 0603 | TO ASSIGN |  |  |  | NO | NO |  |  |  | PENDING
R29 | P1 | SR drain Kelvin link | 0 ohm; VD1/VD2 must sense at the SR drain, not at the pad | 0603 | TO ASSIGN |  |  |  | NO | NO |  |  |  | PENDING
R3 | P1 | OC burden resistor | 10 ohm (kept: the ideal 10.58 ohm is inside the CT's own tolerance); continuous 125.7 mW at 48 V/120 A from mean(V^2)/R = 100.6 % of the 0.125 W 0805 nominal before 70-155 C derating (SOURCE-05); fault pulse 9.36 W peak / 0.123 mJ, t_eq 13.1 us at 48 V and 10.08 W / 0.131 mJ at 50 V, cut to 2.07 W / 0.0060 mJ by PROT-B; no vendor pulse-derating curve is vendored, so a larger or pulse-rated 10 ohm part must be selected | - | TO SELECT |  |  |  | NO | NO |  |  |  | PENDING
R30 | P1 | SR drain Kelvin link | 0 ohm; VD1/VD2 must sense at the SR drain, not at the pad | 0603 | TO ASSIGN |  |  |  | NO | NO |  |  |  | PENDING
R31 | P1 | SR drain Kelvin link | 0 ohm; VD1/VD2 must sense at the SR drain, not at the pad | 0603 | TO ASSIGN |  |  |  | NO | NO |  |  |  | PENDING
R32 | P1 | SR drain Kelvin link | 0 ohm; VD1/VD2 must sense at the SR drain, not at the pad | 0603 | TO ASSIGN |  |  |  | NO | NO |  |  |  | PENDING
R33 | P1 | SR drain Kelvin link | 0 ohm; VD1/VD2 must sense at the SR drain, not at the pad | 0603 | TO ASSIGN |  |  |  | NO | NO |  |  |  | PENDING
R34 | P1 | SR drain Kelvin link | 0 ohm; VD1/VD2 must sense at the SR drain, not at the pad | 0603 | TO ASSIGN |  |  |  | NO | NO |  |  |  | PENDING
R35 | P1 | SR drain Kelvin link | 0 ohm; VD1/VD2 must sense at the SR drain, not at the pad | 0603 | TO ASSIGN |  |  |  | NO | NO |  |  |  | PENDING
R4 | P1 | primary gate resistor | 2.2 ohm external; the deck's 3.2 ohm lump = UCC27282 1.3/0.85 ohm + 2.2 - same design, different quantity | 0603 | TO ASSIGN |  |  |  | NO | NO |  |  |  | PENDING
R5 | P1 | primary gate resistor | 2.2 ohm external; the deck's 3.2 ohm lump = UCC27282 1.3/0.85 ohm + 2.2 - same design, different quantity | 0603 | TO ASSIGN |  |  |  | NO | NO |  |  |  | PENDING
R7 | P1 | U2 control pull-downs and run jumper | R7 10k EN->PGND; R8 1k RUN jumper->12V_P; R9 10k HI->PGND; R10 10k LI->PGND | 0603 | TO ASSIGN |  |  |  | NO | NO |  |  |  | PENDING
R8 | P1 | U2 control pull-downs and run jumper | R7 10k EN->PGND; R8 1k RUN jumper->12V_P; R9 10k HI->PGND; R10 10k LI->PGND | 0603 | TO ASSIGN |  |  |  | NO | NO |  |  |  | PENDING
R9 | P1 | U2 control pull-downs and run jumper | R7 10k EN->PGND; R8 1k RUN jumper->12V_P; R9 10k HI->PGND; R10 10k LI->PGND | 0603 | TO ASSIGN |  |  |  | NO | NO |  |  |  | PENDING
