czy0126/CZY/pcb/control_validation/BOM.csv

Reference | Value | Footprint | Rating | Note | DNP | MPN | LCSC | Qty
J1 | VBIAS 15V | TerminalBlock:TerminalBlock_MaiXu_MX126-5.0-02P_1x02_P5.00mm | 15 V, 0.5 A | bias input, polarity marked |  |  |  | 1
F1 | 0.5A | Fuse:Fuse_1206_3216Metric | 0.5 A | bias fuse |  |  |  | 1
D1 | SMBJ15A | Diode_SMD:D_SMB | 15 V standoff | bias TVS |  |  |  | 1
D2 | SS34 | Diode_SMD:D_SMA | 40 V 3 A | reverse-polarity block; VDD = 15 V - 0.5 V |  |  |  | 1
C1 | 10uF/35V | Capacitor_SMD:C_1210_3225Metric | 35 V X7R |  |  |  |  | 1
C2 | 1uF/35V | Capacitor_SMD:C_0805_2012Metric | 35 V X7R |  |  |  |  | 1
C3 | 100nF/50V | Capacitor_SMD:C_0603_1608Metric | 50 V X7R | at pin 7 |  |  |  | 1
U1 | UCC24624DR | Package_SO:SOIC-8_3.9x4.9mm_P1.27mm | 230 V VD pins | SR controller, SOIC-8 |  |  |  | 1
C4 | 2.2uF/25V | Capacitor_SMD:C_1206_3216Metric | 25 V X7R | REG bypass, <=1 cm |  |  |  | 1
C5 | 100nF/50V | Capacitor_SMD:C_0603_1608Metric | 50 V X7R |  |  |  |  | 1
Q4 | 2N7002 | Package_TO_SOT_SMD:SOT-23 | 60 V | REG hold-low for power-on qualification test |  |  |  | 1
R4 | 100k | Resistor_SMD:R_0603_1608Metric | 1/10 W | Q4 gate pulldown |  |  |  | 1
R1 | 0R | Resistor_SMD:R_0805_2012Metric | <=212 R option | Roffset: VTHOFF = 10.5 mV + 330 uA * R |  |  |  | 1
R2 | 0R | Resistor_SMD:R_0603_1608Metric | 100 R option | VD1 link |  |  |  | 1
R3 | 0R | Resistor_SMD:R_0603_1608Metric | 100 R option | VD2 link |  |  |  | 1
Q1 | BSC010N04LS6 | Package_SON:Infineon_PG-TDSON-8_6.15x5.15mm | 40 V 1.0 mR | SR1; source Kelvin to VSS |  |  |  | 1
Q2 | BSC010N04LS6 | Package_SON:Infineon_PG-TDSON-8_6.15x5.15mm | 40 V 1.0 mR | SR2; source Kelvin to VSS |  |  |  | 1
Rg1 | 0R | Resistor_SMD:R_0805_2012Metric | 2.2-10 R option | gate resistor |  |  |  | 1
Rg2 | 0R | Resistor_SMD:R_0805_2012Metric | 2.2-10 R option | gate resistor |  |  |  | 1
Rgs1 | 10k | Resistor_SMD:R_0603_1608Metric | 1/10 W | gate-source pulldown |  |  |  | 1
Rgs2 | 10k | Resistor_SMD:R_0603_1608Metric | 1/10 W | gate-source pulldown |  |  |  | 1
CGL1 | 6.8nF DNP | Capacitor_SMD:C_0603_1608Metric | 50 V | specified gate-load test | yes |  |  | 1
CGL2 | 6.8nF DNP | Capacitor_SMD:C_0603_1608Metric | 50 V | specified gate-load test | yes |  |  | 1
Rsh1 | 1mR 1% | Resistor_SMD:R_2512_6332Metric | 2 W | current sense 10 A -> 10 mV |  |  |  | 1
Rsh2 | 1mR 1% | Resistor_SMD:R_2512_6332Metric | 2 W | current sense |  |  |  | 1
Rsn1 | 10R DNP | Resistor_SMD:R_0603_1608Metric | 1/10 W | RC snubber | yes |  |  | 1
Csn1 | 1nF DNP | Capacitor_SMD:C_0603_1608Metric | 50 V | RC snubber | yes |  |  | 1
Rsn2 | 10R DNP | Resistor_SMD:R_0603_1608Metric | 1/10 W | RC snubber | yes |  |  | 1
Csn2 | 1nF DNP | Capacitor_SMD:C_0603_1608Metric | 50 V | RC snubber | yes |  |  | 1
J3 | SEC A/CT/B | TerminalBlock:TerminalBlock_MaiXu_MX126-5.0-04P_1x04_P5.00mm | 20 V peak, 10 A | isolated low-voltage centre-tapped source |  |  |  | 1
C6 | 100uF/6.3V | Capacitor_SMD:C_1210_3225Metric | 6.3 V X5R |  |  |  |  | 1
C7 | 10uF/10V | Capacitor_SMD:C_0805_2012Metric | 10 V X7R |  |  |  |  | 1
J2 | LOAD 0.2-2R | TerminalBlock:TerminalBlock_MaiXu_MX126-5.0-02P_1x02_P5.00mm | 2 A max | load / electronic load |  |  |  | 1
R5 | 1k | Resistor_SMD:R_0603_1608Metric | 1/10 W | VD1 injection |  |  |  | 1
R6 | 1k | Resistor_SMD:R_0603_1608Metric | 1/10 W | VD2 injection |  |  |  | 1
JP1 | FORCE1 low | Connector_PinHeader_2.54mm:PinHeader_1x02_P2.54mm_Vertical | shunt = force VD1 low |  |  |  |  | 1
JP2 | FORCE2 low | Connector_PinHeader_2.54mm:PinHeader_1x02_P2.54mm_Vertical | shunt = force VD2 low |  |  |  |  | 1
TP1 | VDD | TestPoint:TestPoint_Pad_D1.0mm | 1 mm pad | scope probe / Kelvin point |  |  |  | 1
TP2 | REG | TestPoint:TestPoint_Pad_D1.0mm | 1 mm pad | scope probe / Kelvin point |  |  |  | 1
TP3 | VSS | TestPoint:TestPoint_Pad_D1.0mm | 1 mm pad | scope probe / Kelvin point |  |  |  | 1
TP4 | VD1 | TestPoint:TestPoint_Pad_D1.0mm | 1 mm pad | scope probe / Kelvin point |  |  |  | 1
TP5 | VD2 | TestPoint:TestPoint_Pad_D1.0mm | 1 mm pad | scope probe / Kelvin point |  |  |  | 1
TP6 | VG1 | TestPoint:TestPoint_Pad_D1.0mm | 1 mm pad | scope probe / Kelvin point |  |  |  | 1
TP7 | VG2 | TestPoint:TestPoint_Pad_D1.0mm | 1 mm pad | scope probe / Kelvin point |  |  |  | 1
TP8 | PGND | TestPoint:TestPoint_Pad_D1.0mm | 1 mm pad | scope probe / Kelvin point |  |  |  | 1
TP9 | SR_SRC | TestPoint:TestPoint_Pad_D1.0mm | 1 mm pad | scope probe / Kelvin point |  |  |  | 1
TP10 | PGND | TestPoint:TestPoint_Pad_D1.0mm | 1 mm pad | scope probe / Kelvin point |  |  |  | 1
TP11 | VOUT | TestPoint:TestPoint_Pad_D1.0mm | 1 mm pad | scope probe / Kelvin point |  |  |  | 1
TP12 | PGND | TestPoint:TestPoint_Pad_D1.0mm | 1 mm pad | scope probe / Kelvin point |  |  |  | 1
