czy0126/CZY/docs/D1_EXECUTION_KIT/templates/supplier_seed_61.csv

ref | priority | part_role | required_value_or_rating | existing_placeholder_mpn | existing_placeholder_package | source_path | requested_decision | verified_mpn | manufacturer | official_datasheet_url | datasheet_revision | physical_pad_map | height_mm | measured_ac_loss | reviewer | status
C10 | P1 | REG capacitors | 2.2 uF each | TO ASSIGN | 0603 | pin_connections.csv | select real purchasable part or approved designed assembly; verify footprint/pad/voltage/current | PENDING | PENDING | PENDING | PENDING | PENDING | PENDING | PENDING | PENDING | PENDING
C101 | P1 | VDD decoupling | 1 uF + 100 nF at each of the six ICs; the 10 uF bulk cap is NOT in this row | TO ASSIGN | 0603/0805 | pin_connections.csv | select real purchasable part or approved designed assembly; verify footprint/pad/voltage/current | PENDING | PENDING | PENDING | PENDING | PENDING | PENDING | PENDING | PENDING | PENDING
C102 | P1 | VDD decoupling | 1 uF + 100 nF at each of the six ICs; the 10 uF bulk cap is NOT in this row | TO ASSIGN | 0603/0805 | pin_connections.csv | select real purchasable part or approved designed assembly; verify footprint/pad/voltage/current | PENDING | PENDING | PENDING | PENDING | PENDING | PENDING | PENDING | PENDING | PENDING
C103 | P1 | VDD decoupling | 1 uF + 100 nF at each of the six ICs; the 10 uF bulk cap is NOT in this row | TO ASSIGN | 0603/0805 | pin_connections.csv | select real purchasable part or approved designed assembly; verify footprint/pad/voltage/current | PENDING | PENDING | PENDING | PENDING | PENDING | PENDING | PENDING | PENDING | PENDING
C104 | P1 | VDD decoupling | 1 uF + 100 nF at each of the six ICs; the 10 uF bulk cap is NOT in this row | TO ASSIGN | 0603/0805 | pin_connections.csv | select real purchasable part or approved designed assembly; verify footprint/pad/voltage/current | PENDING | PENDING | PENDING | PENDING | PENDING | PENDING | PENDING | PENDING | PENDING
C105 | P1 | VDD decoupling | 1 uF + 100 nF at each of the six ICs; the 10 uF bulk cap is NOT in this row | TO ASSIGN | 0603/0805 | pin_connections.csv | select real purchasable part or approved designed assembly; verify footprint/pad/voltage/current | PENDING | PENDING | PENDING | PENDING | PENDING | PENDING | PENDING | PENDING | PENDING
C106 | P1 | VDD decoupling | 1 uF + 100 nF at each of the six ICs; the 10 uF bulk cap is NOT in this row | TO ASSIGN | 0603/0805 | pin_connections.csv | select real purchasable part or approved designed assembly; verify footprint/pad/voltage/current | PENDING | PENDING | PENDING | PENDING | PENDING | PENDING | PENDING | PENDING | PENDING
C107 | P1 | VDD decoupling | 1 uF + 100 nF at each of the six ICs; the 10 uF bulk cap is NOT in this row | TO ASSIGN | 0603/0805 | pin_connections.csv | select real purchasable part or approved designed assembly; verify footprint/pad/voltage/current | PENDING | PENDING | PENDING | PENDING | PENDING | PENDING | PENDING | PENDING | PENDING
C108 | P1 | VDD decoupling | 1 uF + 100 nF at each of the six ICs; the 10 uF bulk cap is NOT in this row | TO ASSIGN | 0603/0805 | pin_connections.csv | select real purchasable part or approved designed assembly; verify footprint/pad/voltage/current | PENDING | PENDING | PENDING | PENDING | PENDING | PENDING | PENDING | PENDING | PENDING
C109 | P1 | VDD decoupling | 1 uF + 100 nF at each of the six ICs; the 10 uF bulk cap is NOT in this row | TO ASSIGN | 0603/0805 | pin_connections.csv | select real purchasable part or approved designed assembly; verify footprint/pad/voltage/current | PENDING | PENDING | PENDING | PENDING | PENDING | PENDING | PENDING | PENDING | PENDING
C11 | P1 | OC filter (Cf) | 47 nF; tau with Rf = 47 us | TO ASSIGN | 0603 | sim/v2/startup_ct_fault_drv.cir | select real purchasable part or approved designed assembly; verify footprint/pad/voltage/current | PENDING | PENDING | PENDING | PENDING | PENDING | PENDING | PENDING | PENDING | PENDING
C110 | P1 | VDD decoupling | 1 uF + 100 nF at each of the six ICs; the 10 uF bulk cap is NOT in this row | TO ASSIGN | 0603/0805 | pin_connections.csv | select real purchasable part or approved designed assembly; verify footprint/pad/voltage/current | PENDING | PENDING | PENDING | PENDING | PENDING | PENDING | PENDING | PENDING | PENDING
C111 | P1 | VDD decoupling | 1 uF + 100 nF at each of the six ICs; the 10 uF bulk cap is NOT in this row | TO ASSIGN | 0603/0805 | pin_connections.csv | select real purchasable part or approved designed assembly; verify footprint/pad/voltage/current | PENDING | PENDING | PENDING | PENDING | PENDING | PENDING | PENDING | PENDING | PENDING
C112 | P1 | VDD decoupling | 1 uF + 100 nF at each of the six ICs; the 10 uF bulk cap is NOT in this row | TO ASSIGN | 0603/0805 | pin_connections.csv | select real purchasable part or approved designed assembly; verify footprint/pad/voltage/current | PENDING | PENDING | PENDING | PENDING | PENDING | PENDING | PENDING | PENDING | PENDING
C12 | P1 | OC hold (Coc) | 10 nF (51.3 us OC delay); 1 nF gives 13 us | TO ASSIGN | 0603 | docs/续接任务书_真实控制与SR.md | select real purchasable part or approved designed assembly; verify footprint/pad/voltage/current | PENDING | PENDING | PENDING | PENDING | PENDING | PENDING | PENDING | PENDING | PENDING
C13 | P1 | EN filter | 1 nF to PGND at U2.6 | TO ASSIGN | 0603 | pin_connections.csv | select real purchasable part or approved designed assembly; verify footprint/pad/voltage/current | PENDING | PENDING | PENDING | PENDING | PENDING | PENDING | PENDING | PENDING | PENDING
C5 | P1 | HB bootstrap | 220 nF; >=25 V | TO ASSIGN | 0805 | pin_connections.csv | select real purchasable part or approved designed assembly; verify footprint/pad/voltage/current | PENDING | PENDING | PENDING | PENDING | PENDING | PENDING | PENDING | PENDING | PENDING
C6 | P1 | SS capacitor | 10 nF | TO ASSIGN | 0603 | pin_connections.csv | select real purchasable part or approved designed assembly; verify footprint/pad/voltage/current | PENDING | PENDING | PENDING | PENDING | PENDING | PENDING | PENDING | PENDING | PENDING
C7 | P1 | REG capacitors | 2.2 uF each | TO ASSIGN | 0603 | pin_connections.csv | select real purchasable part or approved designed assembly; verify footprint/pad/voltage/current | PENDING | PENDING | PENDING | PENDING | PENDING | PENDING | PENDING | PENDING | PENDING
C8 | P1 | REG capacitors | 2.2 uF each | TO ASSIGN | 0603 | pin_connections.csv | select real purchasable part or approved designed assembly; verify footprint/pad/voltage/current | PENDING | PENDING | PENDING | PENDING | PENDING | PENDING | PENDING | PENDING | PENDING
C9 | P1 | REG capacitors | 2.2 uF each | TO ASSIGN | 0603 | pin_connections.csv | select real purchasable part or approved designed assembly; verify footprint/pad/voltage/current | PENDING | PENDING | PENDING | PENDING | PENDING | PENDING | PENDING | PENDING | PENDING
CT | P0 | over-current CT | 100:1; 1 V Level-1 VOC; as built 10 ohm burden + 24/35 divider reads 0.573 V at 13.86 A and trips at 24.2 A (measured); core B/Bsat 0.7 % | TO SELECT | - | design/v2/真实控制与SR验证进展.md | manufacturer terminal/pad and DOT signoff | PENDING | PENDING | PENDING | PENDING | PENDING | PENDING | PENDING | PENDING | PENDING
Cin | P0 | 48 V input capacitor bank | 48 V bus; >=5.32 A RMS at 200 kHz (bridge ripple); 13.9 A pulses | TO SELECT | - | measured model | select real purchasable part or approved designed assembly; verify footprint/pad/voltage/current | PENDING | PENDING | PENDING | PENDING | PENDING | PENDING | PENDING | PENDING | PENDING
Cout | P0 | output capacitor bank | 15 x 470 uF 2.5 V 3 mohm (ESR-driven: cap needs 9, RMS needs 5); >=4 mF; >=52.5 A RMS; bank ESR <=0.2 mohm; part data unverified | TO SELECT | polymer SMD | computed | select real purchasable part or approved designed assembly; verify footprint/pad/voltage/current | PENDING | PENDING | PENDING | PENDING | PENDING | PENDING | PENDING | PENDING | PENDING
Cr | P0 | resonant capacitor | 0.62 uF; peak v_Cr 41.4 V (reconstructed) vs 100 V rated = 2.42x; 9.45 A RMS at 200.6 kHz; bank ESR <=11.2 mohm for 1 W | TO SELECT | film | computed | select real purchasable part or approved designed assembly; verify footprint/pad/voltage/current | PENDING | PENDING | PENDING | PENDING | PENDING | PENDING | PENDING | PENDING | PENDING
D_BT | P0 | bootstrap diode | >=100 V reverse - HB is 60 V against VCC12 12 V when QH is on, so 48 V; If avg 9.6 mA (Qg 48 nC datasheet max x 200.6 kHz; the deck's 4 nF Cgh gives the same 48 nC); droop 218 mV on 220 nF; peak ~0.4 A recharge spike is derived, NOT measured - the deck's Bgh is a source to sw, so Cbt is never loaded | TO SELECT | 0603 | sim/v3/sr_tank_dual_v33_ss_1ms_100a.cir | select real purchasable part or approved designed assembly; verify footprint/pad/voltage/current | PENDING | PENDING | PENDING | PENDING | PENDING | PENDING | PENDING | PENDING | PENDING
Lr | P0 | resonant inductor | 1.0 uH external (trim to 1.00 uH tank total minus measured leakage); 13.9 A steady, 22.5 A startup (physical deck), 84.0 A @1.0 uH and 104.2 A @0.875 uH fault-to-trip; ELP32 N97 3 turns 1.44 mm gap (2 turns gives 0.351 T > Bsat 0.310 T, eliminated) | TO SELECT | - | docs/续接任务书_真实控制与SR.md | select real purchasable part or approved designed assembly; verify footprint/pad/voltage/current | PENDING | PENDING | PENDING | PENDING | PENDING | PENDING | PENDING | PENDING | PENDING
R1 | P1 | RT resistor | 976 ohm; 1% | TO ASSIGN | 0603 | pin_connections.csv | select real purchasable part or approved designed assembly; verify footprint/pad/voltage/current | PENDING | PENDING | PENDING | PENDING | PENDING | PENDING | PENDING | PENDING | PENDING
R10 | P1 | U2 control pull-downs and run jumper | R7 10k EN->PGND; R8 1k RUN jumper->12V_P; R9 10k HI->PGND; R10 10k LI->PGND | TO ASSIGN | 0603 | pin_connections.csv | select real purchasable part or approved designed assembly; verify footprint/pad/voltage/current | PENDING | PENDING | PENDING | PENDING | PENDING | PENDING | PENDING | PENDING | PENDING
R15 | P1 | OC filter series (Rf) | 1 kohm; 47 us with Cf | TO ASSIGN | 0603 | sim/v2/startup_ct_fault_drv.cir | select real purchasable part or approved designed assembly; verify footprint/pad/voltage/current | PENDING | PENDING | PENDING | PENDING | PENDING | PENDING | PENDING | PENDING | PENDING
R16 | P1 | OC divider top (Rd1) | 10 kohm; 1%; as built - kept | TO ASSIGN | 0603 | sim/v2/startup_ct_fault_drv.cir | select real purchasable part or approved designed assembly; verify footprint/pad/voltage/current | PENDING | PENDING | PENDING | PENDING | PENDING | PENDING | PENDING | PENDING | PENDING
R17 | P1 | OC divider bottom (Rd2) | 24 kohm | TO ASSIGN | 0603 | sim/v2/startup_ct_fault_drv.cir | select real purchasable part or approved designed assembly; verify footprint/pad/voltage/current | PENDING | PENDING | PENDING | PENDING | PENDING | PENDING | PENDING | PENDING | PENDING
R18 | P1 | QH gate-source pull-down | 10 kohm | TO ASSIGN | 0603 | sim/v3/sr_tank_dual_v33_ss_1ms_100a.cir | select real purchasable part or approved designed assembly; verify footprint/pad/voltage/current | PENDING | PENDING | PENDING | PENDING | PENDING | PENDING | PENDING | PENDING | PENDING
R19 | P1 | QL gate-source pull-down | 10 kohm | TO ASSIGN | 0603 | sim/v3/sr_tank_dual_v33_ss_1ms_100a.cir | select real purchasable part or approved designed assembly; verify footprint/pad/voltage/current | PENDING | PENDING | PENDING | PENDING | PENDING | PENDING | PENDING | PENDING | PENDING
R2 | P1 | DT resistor | 5.36 kohm; 1% | TO ASSIGN | 0603 | pin_connections.csv | select real purchasable part or approved designed assembly; verify footprint/pad/voltage/current | PENDING | PENDING | PENDING | PENDING | PENDING | PENDING | PENDING | PENDING | PENDING
R20 | P1 | SR gate resistor | 2.2 ohm; UCC24624 6.5/0.9 ohm + 2.2 = the model's 8.7/3.1 | TO ASSIGN | 0603 | pin_connections.csv | select real purchasable part or approved designed assembly; verify footprint/pad/voltage/current | PENDING | PENDING | PENDING | PENDING | PENDING | PENDING | PENDING | PENDING | PENDING
R21 | P1 | SR gate resistor | 2.2 ohm; UCC24624 6.5/0.9 ohm + 2.2 = the model's 8.7/3.1 | TO ASSIGN | 0603 | pin_connections.csv | select real purchasable part or approved designed assembly; verify footprint/pad/voltage/current | PENDING | PENDING | PENDING | PENDING | PENDING | PENDING | PENDING | PENDING | PENDING
R22 | P1 | SR gate resistor | 2.2 ohm; UCC24624 6.5/0.9 ohm + 2.2 = the model's 8.7/3.1 | TO ASSIGN | 0603 | pin_connections.csv | select real purchasable part or approved designed assembly; verify footprint/pad/voltage/current | PENDING | PENDING | PENDING | PENDING | PENDING | PENDING | PENDING | PENDING | PENDING
R23 | P1 | SR gate resistor | 2.2 ohm; UCC24624 6.5/0.9 ohm + 2.2 = the model's 8.7/3.1 | TO ASSIGN | 0603 | pin_connections.csv | select real purchasable part or approved designed assembly; verify footprint/pad/voltage/current | PENDING | PENDING | PENDING | PENDING | PENDING | PENDING | PENDING | PENDING | PENDING
R24 | P1 | SR gate resistor | 2.2 ohm; UCC24624 6.5/0.9 ohm + 2.2 = the model's 8.7/3.1 | TO ASSIGN | 0603 | pin_connections.csv | select real purchasable part or approved designed assembly; verify footprint/pad/voltage/current | PENDING | PENDING | PENDING | PENDING | PENDING | PENDING | PENDING | PENDING | PENDING
R25 | P1 | SR gate resistor | 2.2 ohm; UCC24624 6.5/0.9 ohm + 2.2 = the model's 8.7/3.1 | TO ASSIGN | 0603 | pin_connections.csv | select real purchasable part or approved designed assembly; verify footprint/pad/voltage/current | PENDING | PENDING | PENDING | PENDING | PENDING | PENDING | PENDING | PENDING | PENDING
R26 | P1 | SR gate resistor | 2.2 ohm; UCC24624 6.5/0.9 ohm + 2.2 = the model's 8.7/3.1 | TO ASSIGN | 0603 | pin_connections.csv | select real purchasable part or approved designed assembly; verify footprint/pad/voltage/current | PENDING | PENDING | PENDING | PENDING | PENDING | PENDING | PENDING | PENDING | PENDING
R27 | P1 | SR gate resistor | 2.2 ohm; UCC24624 6.5/0.9 ohm + 2.2 = the model's 8.7/3.1 | TO ASSIGN | 0603 | pin_connections.csv | select real purchasable part or approved designed assembly; verify footprint/pad/voltage/current | PENDING | PENDING | PENDING | PENDING | PENDING | PENDING | PENDING | PENDING | PENDING
R28 | P1 | SR drain Kelvin link | 0 ohm; VD1/VD2 must sense at the SR drain, not at the pad | TO ASSIGN | 0603 | pin_connections.csv | select real purchasable part or approved designed assembly; verify footprint/pad/voltage/current | PENDING | PENDING | PENDING | PENDING | PENDING | PENDING | PENDING | PENDING | PENDING
R29 | P1 | SR drain Kelvin link | 0 ohm; VD1/VD2 must sense at the SR drain, not at the pad | TO ASSIGN | 0603 | pin_connections.csv | select real purchasable part or approved designed assembly; verify footprint/pad/voltage/current | PENDING | PENDING | PENDING | PENDING | PENDING | PENDING | PENDING | PENDING | PENDING
R3 | P1 | OC burden resistor | 10 ohm (kept: the ideal 10.58 ohm is inside the CT's own tolerance); continuous 125.7 mW at 48 V/120 A from mean(V^2)/R = 100.6 % of the 0.125 W 0805 nominal before 70-155 C derating (SOURCE-05); fault pulse 9.36 W peak / 0.123 mJ, t_eq 13.1 us at 48 V and 10.08 W / 0.131 mJ at 50 V, cut to 2.07 W / 0.0060 mJ by PROT-B; no vendor pulse-derating curve is vendored, so a larger or pulse-rated 10 ohm part must be selected | TO SELECT | - | design/v3/bom/oc_burden_pulse.json | select real purchasable part or approved designed assembly; verify footprint/pad/voltage/current | PENDING | PENDING | PENDING | PENDING | PENDING | PENDING | PENDING | PENDING | PENDING
R30 | P1 | SR drain Kelvin link | 0 ohm; VD1/VD2 must sense at the SR drain, not at the pad | TO ASSIGN | 0603 | pin_connections.csv | select real purchasable part or approved designed assembly; verify footprint/pad/voltage/current | PENDING | PENDING | PENDING | PENDING | PENDING | PENDING | PENDING | PENDING | PENDING
R31 | P1 | SR drain Kelvin link | 0 ohm; VD1/VD2 must sense at the SR drain, not at the pad | TO ASSIGN | 0603 | pin_connections.csv | select real purchasable part or approved designed assembly; verify footprint/pad/voltage/current | PENDING | PENDING | PENDING | PENDING | PENDING | PENDING | PENDING | PENDING | PENDING
R32 | P1 | SR drain Kelvin link | 0 ohm; VD1/VD2 must sense at the SR drain, not at the pad | TO ASSIGN | 0603 | pin_connections.csv | select real purchasable part or approved designed assembly; verify footprint/pad/voltage/current | PENDING | PENDING | PENDING | PENDING | PENDING | PENDING | PENDING | PENDING | PENDING
R33 | P1 | SR drain Kelvin link | 0 ohm; VD1/VD2 must sense at the SR drain, not at the pad | TO ASSIGN | 0603 | pin_connections.csv | select real purchasable part or approved designed assembly; verify footprint/pad/voltage/current | PENDING | PENDING | PENDING | PENDING | PENDING | PENDING | PENDING | PENDING | PENDING
R34 | P1 | SR drain Kelvin link | 0 ohm; VD1/VD2 must sense at the SR drain, not at the pad | TO ASSIGN | 0603 | pin_connections.csv | select real purchasable part or approved designed assembly; verify footprint/pad/voltage/current | PENDING | PENDING | PENDING | PENDING | PENDING | PENDING | PENDING | PENDING | PENDING
R35 | P1 | SR drain Kelvin link | 0 ohm; VD1/VD2 must sense at the SR drain, not at the pad | TO ASSIGN | 0603 | pin_connections.csv | select real purchasable part or approved designed assembly; verify footprint/pad/voltage/current | PENDING | PENDING | PENDING | PENDING | PENDING | PENDING | PENDING | PENDING | PENDING
R4 | P1 | primary gate resistor | 2.2 ohm external; the deck's 3.2 ohm lump = UCC27282 1.3/0.85 ohm + 2.2 - same design, different quantity | TO ASSIGN | 0603 | pin_connections.csv | select real purchasable part or approved designed assembly; verify footprint/pad/voltage/current | PENDING | PENDING | PENDING | PENDING | PENDING | PENDING | PENDING | PENDING | PENDING
R5 | P1 | primary gate resistor | 2.2 ohm external; the deck's 3.2 ohm lump = UCC27282 1.3/0.85 ohm + 2.2 - same design, different quantity | TO ASSIGN | 0603 | pin_connections.csv | select real purchasable part or approved designed assembly; verify footprint/pad/voltage/current | PENDING | PENDING | PENDING | PENDING | PENDING | PENDING | PENDING | PENDING | PENDING
R7 | P1 | U2 control pull-downs and run jumper | R7 10k EN->PGND; R8 1k RUN jumper->12V_P; R9 10k HI->PGND; R10 10k LI->PGND | TO ASSIGN | 0603 | pin_connections.csv | select real purchasable part or approved designed assembly; verify footprint/pad/voltage/current | PENDING | PENDING | PENDING | PENDING | PENDING | PENDING | PENDING | PENDING | PENDING
R8 | P1 | U2 control pull-downs and run jumper | R7 10k EN->PGND; R8 1k RUN jumper->12V_P; R9 10k HI->PGND; R10 10k LI->PGND | TO ASSIGN | 0603 | pin_connections.csv | select real purchasable part or approved designed assembly; verify footprint/pad/voltage/current | PENDING | PENDING | PENDING | PENDING | PENDING | PENDING | PENDING | PENDING | PENDING
R9 | P1 | U2 control pull-downs and run jumper | R7 10k EN->PGND; R8 1k RUN jumper->12V_P; R9 10k HI->PGND; R10 10k LI->PGND | TO ASSIGN | 0603 | pin_connections.csv | select real purchasable part or approved designed assembly; verify footprint/pad/voltage/current | PENDING | PENDING | PENDING | PENDING | PENDING | PENDING | PENDING | PENDING | PENDING
T1 | P0 | transformer winding | 3:1:1 centre-tapped; Lm 10 uH; gap 0.121 mm | TO BUILD | foil 0.10 x 18 mm | magnetics package | manufacturer terminal/pad and DOT signoff | PENDING | PENDING | PENDING | PENDING | PENDING | PENDING | PENDING | PENDING | PENDING
T2 | P0 | transformer winding | 3:1:1 centre-tapped; Lm 10 uH; gap 0.121 mm | TO BUILD | foil 0.10 x 18 mm | magnetics package | manufacturer terminal/pad and DOT signoff | PENDING | PENDING | PENDING | PENDING | PENDING | PENDING | PENDING | PENDING | PENDING
T3 | P0 | transformer winding | 3:1:1 centre-tapped; Lm 10 uH; gap 0.121 mm | TO BUILD | foil 0.10 x 18 mm | magnetics package | manufacturer terminal/pad and DOT signoff | PENDING | PENDING | PENDING | PENDING | PENDING | PENDING | PENDING | PENDING | PENDING
T4 | P0 | transformer winding | 3:1:1 centre-tapped; Lm 10 uH; gap 0.121 mm | TO BUILD | foil 0.10 x 18 mm | magnetics package | manufacturer terminal/pad and DOT signoff | PENDING | PENDING | PENDING | PENDING | PENDING | PENDING | PENDING | PENDING | PENDING
