czy0126/CZY/hardware/dcx_main/supplier_magnetic_terminal_reply_template.csv

ref | logical_terminal | expected_circuit_net | design_dot_convention | supplier_physical_pad | supplier_pinout_drawing_uri | drawing_revision | measured_dot_result | measured_turns_or_ratio | terminal_footprint_verified | reviewer | decision
CT | PRI_A | CR_CT | UNVERIFIED_FROM_CT_VENDOR |  |  |  |  |  | NO |  | PENDING
CT | PRI_B | CT_LR | UNVERIFIED_FROM_CT_VENDOR |  |  |  |  |  | NO |  | PENDING
CT | SEC_A | CS1 | UNVERIFIED_FROM_CT_VENDOR |  |  |  |  |  | NO |  | PENDING
CT | SEC_B | CS2 | UNVERIFIED_FROM_CT_VENDOR |  |  |  |  |  | NO |  | PENDING
T1 | PRI_A | PRI_T1 | DOT |  |  |  |  |  | NO |  | PENDING
T1 | PRI_B | PRI_12 | NON_DOT |  |  |  |  |  | NO |  | PENDING
T1 | SEC_A | SEC1_A | NON_DOT |  |  |  |  |  | NO |  | PENDING
T1 | SEC_B | SEC1_B | DOT |  |  |  |  |  | NO |  | PENDING
T1 | CTAP | VOUT | S_A_DOT_AND_S_B_NON_DOT |  |  |  |  |  | NO |  | PENDING
T2 | PRI_A | PRI_12 | DOT |  |  |  |  |  | NO |  | PENDING
T2 | PRI_B | PRI_23 | NON_DOT |  |  |  |  |  | NO |  | PENDING
T2 | SEC_A | SEC2_A | NON_DOT |  |  |  |  |  | NO |  | PENDING
T2 | SEC_B | SEC2_B | DOT |  |  |  |  |  | NO |  | PENDING
T2 | CTAP | VOUT | S_A_DOT_AND_S_B_NON_DOT |  |  |  |  |  | NO |  | PENDING
T3 | PRI_A | PRI_23 | DOT |  |  |  |  |  | NO |  | PENDING
T3 | PRI_B | PRI_34 | NON_DOT |  |  |  |  |  | NO |  | PENDING
T3 | SEC_A | SEC3_A | NON_DOT |  |  |  |  |  | NO |  | PENDING
T3 | SEC_B | SEC3_B | DOT |  |  |  |  |  | NO |  | PENDING
T3 | CTAP | VOUT | S_A_DOT_AND_S_B_NON_DOT |  |  |  |  |  | NO |  | PENDING
T4 | PRI_A | PRI_34 | DOT |  |  |  |  |  | NO |  | PENDING
T4 | PRI_B | PGND | NON_DOT |  |  |  |  |  | NO |  | PENDING
T4 | SEC_A | SEC4_A | NON_DOT |  |  |  |  |  | NO |  | PENDING
T4 | SEC_B | SEC4_B | DOT |  |  |  |  |  | NO |  | PENDING
T4 | CTAP | VOUT | S_A_DOT_AND_S_B_NON_DOT |  |  |  |  |  | NO |  | PENDING
