czy0126/CZY/pcb/control_validation/lceda/UCC24624_bom.csv

No. | Quantity | Comment | Designator | Footprint | Value | Manufacturer Part | Manufacturer | Supplier Part | Supplier
1 | 1 | 10uF | C1 | C1210 | 10uF | CL32B106KBJNNNE | SAMSUNG(三星) | C138687 | LCSC
2 | 1 | 1uF | C2 | C0805 | 1uF | CL21B105KBFNNNE | SAMSUNG(三星) | C28323 | LCSC
3 | 2 | 100nF | C3,C5 | C0603 | 100nF | CL10B104KB8NNNC | SAMSUNG(三星) | C1591 | LCSC
4 | 1 | 2.2uF | C4 | C1206 | 2.2uF | CL31B225KAHNNNE | SAMSUNG(三星) | C170102 | LCSC
5 | 1 | 100uF | C6 | CAP-SMD_BD6.3-L6.6-W6.6-LS7.2-FD-1 | 100uF | UWT1E101MCL1GS | Nichicon(尼吉康) | C87067 | LCSC
6 | 1 | CL21A106KAYNNNE | C7 | C0805 |  | CL21A106KAYNNNE |  | C2980800 | LCSC
7 | 2 | 6.8nF | CGL1,CGL2 | C0603 | 6.8nF | CL10B682KB8NNNC | SAMSUNG(三星) | C84723 | LCSC
8 | 2 | 1nF | Csn1,Csn2 | C0603 | 1nF | CL10B102KB8NNNC | SAMSUNG(三星) | C1588 | LCSC
9 | 1 | SMBJ15A | D1 | SMB_L4.6-W3.6-LS5.3-RD |  | SMBJ15A | DOWO(东沃) | C357961 | LCSC
10 | 1 | SS34 | D2 | SMA_L4.3-W2.6-LS5.2-RD |  | SS34 | MDD(辰达半导体) | C8678 | LCSC
11 | 1 | 1206L050/15YR | F1 | F1206 |  | 1206L050/15YR | Littelfuse(美国力特) | C151162 | LCSC
12 | 2 | MX126-5.0-02P-GN01-Cu-S-A | J1,J2 | CONN-TH_2P-P5.00_MX126-5.0-GN01-02P-CU-S-A |  | MX126-5.0-02P-GN01-Cu-S-A | MAX(迈旭) | C5188434 | LCSC
13 | 1 | XY128V-A-5.08-4P | J3 | CONN-TH_4P-P5.08_KF128-5.08-4P |  | XY128V-A-5.08-4P | XINLAIYA(新莱亚) | C22450485 | LCSC
14 | 2 | PZ254V-11-02P | JP1,JP2 | HDR-TH_2P-P2.54-V-M |  | PZ254V-11-02P | XFCN(兴飞) | C492401 | LCSC
15 | 2 | BSC010N04LS6 | Q1,Q2 | PG-TDSON-8-FL_L5.0-W6.0-P1.27-LS6.2-BL |  | BSC010N04LS6 |  | C534278 | LCSC
16 | 1 | 2N7002 | Q4 | SOT-23-3_L2.9-W1.3-P1.90-LS2.4-BR |  | 2N7002 | TWGMC(迪嘉) | C727149 | LCSC
17 | 1 | 0Ω | R1 | R0805 | 0Ω | RC0805FR-070RL | YAGEO(国巨) | C100045 | LCSC
18 | 4 | 0Ω | R2,R3,Rg1,Rg2 | R0603 | 0Ω | RC0603FR-070RL | YAGEO(国巨) | C100044 | LCSC
19 | 1 | 100kΩ | R4 | R0603 | 100kΩ | RC0603FR-07100KL | YAGEO(国巨) | C14675 | LCSC
20 | 2 | 1kΩ | R5,R6 | R0603 | 1kΩ | 0603WAF1001T5E | UNI-ROYAL(厚声) | C21190 | LCSC
21 | 2 | 10kΩ | Rgs1,Rgs2 | R0603 | 10kΩ | RC0603FR-0710KL | YAGEO(国巨) | C98220 | LCSC
22 | 2 | 1mΩ | Rsh1,Rsh2 | RES-SMD_L6.4-W3.2-R2512 | 1mΩ | HoJLR2512-2W-1mR-1%-75ppm | Milliohm(毫欧) | C2924520 | LCSC
23 | 2 | 10Ω | Rsn1,Rsn2 | R0603 | 10Ω | RC0603FR-0710RL | YAGEO(国巨) | C109318 | LCSC
24 | 12 | TP-黄色测试点 | TP1,TP2,TP3,TP4,TP5,TP6,TP7,TP8,TP9,TP10,TP11,TP12 | TESTPOINT-TH_BD3.2 |  | TP-黄色测试点 |  | C9900007422 | LCSC
25 | 1 | UCC24624DR | U1 | SOIC-8_L4.9-W3.9-P1.27-LS6.0-BL |  | UCC24624DR | TI(德州仪器) | C2862446 | LCSC
