czy0126/CZY/docs/D1_EXECUTION_KIT/templates/protection_test_matrix.csv

test_id | vin_v | iout_a | fault_timing | controller_bias_state | ct_state | protection_variant | deck_or_fixture | expected_safe_state | raw_waveform_path | raw_sha256 | pre_fault_matched_mv | full_window_observed | peak_primary_a | peak_sr_a | peak_vds_v | peak_vgs_v | gate_off_latency_us | device_soa_reference | reviewer | status | blocking_reason
P0-48-120-HOT | 48 | 120 | steady_fault | normal | normal | INDEPENDENT_HARDWARE | PENDING | primary and all 8 SR gates low after latch | PENDING | PENDING | PENDING | PENDING | PENDING | PENDING | PENDING | PENDING | PENDING | PENDING | PENDING | PENDING | requires physical gate inhibit not ideal clamp
P0-50-120-HOT | 50 | 120 | steady_fault | normal | normal | INDEPENDENT_HARDWARE | PENDING | primary and all 8 SR gates low after latch | PENDING | PENDING | PENDING | PENDING | PENDING | PENDING | PENDING | PENDING | PENDING | PENDING | PENDING | PENDING | 50V base has solver prefix
P0-START-FAULT | 48 | 0 | startup_mask_active | normal | normal | INDEPENDENT_HARDWARE | PENDING | independent safe shutdown during masking | PENDING | PENDING | PENDING | PENDING | PENDING | PENDING | PENDING | PENDING | PENDING | PENDING | PENDING | PENDING | mask must not defeat all overcurrent protection
P0-REG-UVLO | 48 | 0 | controller_bias_loss | REG_UVLO | normal | INDEPENDENT_HARDWARE | PENDING | no SR false turn on under supply loss | PENDING | PENDING | PENDING | PENDING | PENDING | PENDING | PENDING | PENDING | PENDING | PENDING | PENDING | verify actual UCC24624 UVLO gate pull down
