czy0126/CZY/pcb/control_validation/控制验证板_设计与测试说明_2026-10-31.md

# UCC24624 SR 控制验证板：设计与测试说明

日期 2026-10-31。状态：**SCHEMATIC_VERIFIED / PCB_NOT_BUILT**。

本文对应任务书（`docs/第三次独立审核与后续阶段任务书_2026-10-31.md`）任务包 2：
围绕 UCC24624 做一块**低能量**控制验证板，验证上电资格、双路互锁、PGD 比例驱动、
窄脉冲关断，并在规定电容负载与实际 MOS 条件下测门极动态。

**这不是 100 A 主板的替代品，也不宣称已通过功率、热或 EMI 验证。**
本板只验证控制器与 SR 驱动行为；任何"可制造"结论只覆盖原理图与 BOM，
不覆盖 PCB 布局、Gerber、叠层与装配（见 §7 的明确缺口）。

---

## 1 交付物与状态

| 交付物 | 路径 | 状态 |
|---|---|---|
| 原生嘉立创 EDA 工程 | `pcb/control_validation/lceda/native/UCC24624 SR Validation.eprj2` | 已完成：49 个真实库器件、107 段命名导线 |
| 工程内网表（EDA 自出） | `pcb/control_validation/lceda/lceda_pin_nets.json` | 已导出 |
| 网络逐脚核对 | 本文 §4 | **49/49 器件、0 处不一致** |
| 原生 BOM（xlsx/csv） | `pcb/control_validation/lceda/UCC24624_bom.xlsx` / `.csv` | 已导出，24 行、49 只 |
| KiCad 原理图（对照） | `pcb/control_validation/control_validation.kicad_sch` | 已完成，ERC 0 error |
| KiCad 网表（黄金对照） | `pcb/control_validation/control_validation.net` | 21 个网络 |
| PCB / Gerber / 坐标 / 钢网 | — | **未产出**，原因与手工步骤见 §7 |
| 测试计划 | 本文 §5 | 可执行 |

ERC 报告 `pcb/control_validation/erc.rpt` 只有 3 条符号库路径告警
（`lib_symbol_issues`），0 error；这 3 条是工程符号库未加入全局库表，不是电气问题。

---

## 2 电气定义与硬限值

| 端口 | 网络 | 额定 | 绝对限值 | 说明 |
|---|---|---|---|---|
| J1 | VBIAS → F1 → VIN_F | 15 V / 0.5 A | 26 V（U1 VDD 上限） | 偏置输入，丝印标极性 |
| J3 pin1 / pin3 | SEC_A / SEC_B | ±10 V 对中心抽头 | **20 V 峰值** | 隔离低压中心抽头源 |
| J3 pin2 | VOUT | 中心抽头正端 | — | 输出正 |
| J3 pin4 | PGND | 输出负/功率地 | — | 输出负 |
| J2 | VOUT / PGND | 0.2–2 Ω 负载 | 2 A | 负载或电子负载 |
| JP1 / JP2 | FORCE1/2 → PGND | 短接 = 强制对应 VD 低 | — | 互锁试验 |

**硬限值（写在板上和测试记录里，不得放宽）：**

1. **J3 绝不接 48 V。** 本板是单组等效次级工况；把单组接 48 V 冒充四组串联
   会同时超出 MOS、连接器、走线和人身安全边界。
2. J1 偏置不得超过 26 V；推荐 15 V，经 F1 0.5 A 与 D1 SMBJ15A 钳位。
3. 首次上电必须用**隔离 SELV 电源 + 限流 + 串联保险**，不能直接接实验室大电源。
4. 任何改动后先断电放电（C1/C6 储能），再动线。

---

## 3 电路分块

| 块 | 器件 | 功能 |
|---|---|---|
| 偏置入口 | J1, F1, D1, D2 | 15 V 输入、0.5 A 保险、TVS 钳位、反接保护（VDD ≈ VIN_F − 0.5 V） |
| VDD 去耦 | C1 10 µF, C2 1 µF, C3 100 nF | U1 pin7 就近去耦 |
| 控制器 | U1 UCC24624DR | 双通道 SR 驱动，SOIC-8 |
| REG | C4 2.2 µF, C5 100 nF, Q4, R4 | REG 11 V 旁路；Q4 把 REG 拉低做上电资格试验 |
| VD 检测 | R2/R3 0 Ω, R5/R6 1 k, JP1/JP2 | VD1/VD2 可断开、可注入、可强制拉低 |
| VSS 偏置 | R1（0/100/212 Ω 选项） | VTHOFF = 10.5 mV + 330 µA × R1 |
| SR 主开关 | Q1/Q2 BSC010N04LS6, Rg1/2, Rgs1/2 | 40 V 1 mΩ，源极 Kelvin 到 VSS 网络 |
| 门极负载 | CGL1/2 6.8 nF **DNP** | 规定电容负载试验时再装 |
| 电流检测 | Rsh1/2 1 mΩ 2512 | 1 A → 1 mV，四线 Kelvin 测量 |
| 缓冲 | Rsn1/2 10 Ω + Csn1/2 1 nF **DNP** | 需要时再装 |
| 输出 | C6 100 µF, C7 10 µF | 输出储能 |
| 测试点 | TP1–TP12 | VDD/REG/VSS/VD1/VD2/VG1/VG2/PGND/SR_SRC/VOUT |

### 3.1 U1 引脚（与网表一致）

| 脚 | 名 | 网络 | 脚 | 名 | 网络 |
|---|---|---|---|---|---|
| 1 | VG1 | VG1 | 8 | VG2 | VG2 |
| 2 | PGND | PGND | 7 | VDD | VDD |
| 3 | REG | REG | 6 | VD2 | VD2 |
| 4 | VD1 | VD1 | 5 | VSS | VSS |

### 3.2 关键网络

`VBIAS` `VIN_F` `VDD` `REG` `REG_HOLD` `PGND` `VOUT` `SEC_A` `SEC_B`
`SR_SRC` `G1` `G2` `VG1` `VG2` `VD1` `VD2` `FORCE1` `FORCE2`
`SN1` `SN2` `VSS`，共 21 个网络。

- `R1` 接在 `VSS` 与 `SR_SRC` 之间：VSS 相对 SR 源极抬高 330 µA × R1，
  这是 UCC24624 的关断阈值偏置方式，不是普通分压。
- `Rsh1` 从 `SR_SRC` 到 `PGND`，`Rsh2` 同；Kelvin 取样点必须在焊盘内缘
  （TP9 对 TP10），不能从走线中途取。
- `R2` 把 `VD1` 连到 `SEC_A`，`R3` 把 `VD2` 连到 `SEC_B`；`R5/R6` 把
  `FORCE1/2` 注入 `VD1/2`，`JP1/JP2` 短接 `FORCE` 到 `PGND`。

---

## 4 网络核对方法与结果

**方法**：以 KiCad 网表 `control_validation.net` 为黄金参照（ERC 0 error），
解析每个 `(ref, pin) → net`；再从原生工程导出 EasyEDA 网表，解析
`components[].pinInfoMap[pin].net`；逐脚比较。

**结果（2026-10-31）：**

```
expected components 49  actual 49
problems 0
```

49 个器件全部存在，所有引脚网络名一致，包括：

- U1 按引脚编号的映射（VG1=1 … VG2=8）；
- Q1/Q2 的 1–3 脚 = SR_SRC、4 脚 = G1/G2、5–8 脚 = SEC_A/SEC_B；
- Q4 的 1=REG_HOLD、2=PGND、3=REG；
- D1/D2 的 K/A 方向；
- J1/J2/J3/JP1/JP2/F1/C/R/TP 全部网络；
- Kelvin 对：`Csn1.1–Rsn1.2 = SN1`，`Csn1.2 = SR_SRC`；`TP9 = SR_SRC`。

复现脚本：`pcb/control_validation/lceda/step10_check.js`（导出网表），
比较代码见本文附录 A。

---

## 5 测试计划（低能量，逐项可执行）

设备：隔离 SELV 直流电源（≤20 V，≤10 A，带限流与快速关断）、函数/脉冲发生器
（50 Ω 输出）、≥100 V 差分探头、电流探头或 1 mΩ 同轴分流、4½ 位万用表、
示波器 ≥200 MHz。**所有试验默认 J3 不接 48 V；需要等效次级工况时只用隔离低压源。**

### 5.0 固定夹具、测点与通用停机条件

| 夹具 | 组成 | 用途 |
|---|---|---|
| F-VDD | 隔离 0–20 V → 100 Ω 1 W → F1 0.5 A → J1；C1 10 µF 在板 | T1–T6 偏置 |
| F-PULSE | 发生器 0–5 V 方波，源阻抗 50 Ω，再串 100 Ω 注入 VD | T2、T4 |
| F-SEC | 隔离 0–20 V → 10 Ω 5 W → 10 mH 电感 → J3 SEC_A/CT；J2 接 0.2–2 Ω | T3、T5、T7 |

测点以丝印标签为准：`TP(VDD)` `TP(REG)` `TP(VSS)` `TP(VD1)` `TP(VD2)`
`TP(VG1)` `TP(VG2)` `TP(PGND)` `TP(SR_SRC)` `TP(VOUT)`。
差分探头的地夹接 `TP(PGND)`；Kelvin 测量用 `TP(SR_SRC)` 与 `TP(PGND)` 两处焊盘内缘。

**通用停机条件（任一即切断 J1 与 J3，记录后分析）：**

1. `VG1` 与 `VG2` 同时高于 2 V（直通）；
2. 任何电源电流超过该试验限流值并持续 >100 µs；
3. Q1/Q2 壳温 >60 °C，或 U1 表面 >70 °C；
4. `REG` >13 V 或 <3.5 V（异常），或出现可见烟雾/异味。

### T1 上电资格（REG 保持低）

| 步骤 | 激励（波形 / 源阻抗） | 限流 / 停机 | 观测端口 | 通过判据 |
|---|---|---|---|---|
| 1 | `REG_HOLD` 经 1 kΩ 接 3.3–5 V；J1 由 F-VDD 以 1 V/ms 升到 15 V | 限流 50 mA；REG >13 V 停机 | TP(VDD)、TP(REG)、TP(VG1)、TP(VG2) | REG <0.5 V；VG1/VG2 <0.5 V；无门极脉冲 |
| 2 | 断开 `REG_HOLD`（Q4 关断），J1 保持 15 V | 同上 | 同上 + TP(VD1)、TP(VD2) | REG 升到 11 V ±5 %；门极只在 VD 条件满足后出现 |
| 3 | 重复上电/断电 3 次，0→15→0 V，每次间隔 1 s | 同上 | 六通道同屏，1 ms/格 | 时序一致；无锁死、无随机首脉冲 |

### T2 双路互锁

| 步骤 | 激励（波形 / 源阻抗） | 限流 / 停机 | 观测端口 | 通过判据 |
|---|---|---|---|---|
| 1 | 仅 JP1 短接；VD1 经 F-PULSE 注入 5 V/1 kHz 方波（100 Ω） | J1 限流 50 mA；直通即停机 | TP(VG1)、TP(VG2)、TP(VD1) | VG1 保持低；VG2 不受影响 |
| 2 | 仅 JP2 短接；VD2 同样注入 | 同上 | TP(VG1)、TP(VG2)、TP(VD2) | VG2 保持低；VG1 不受影响 |
| 3 | JP1、JP2 同时短接 | 同上 | 四通道同屏 | 两路都低；无交替脉冲 |
| 4 | 在 VD1 注入 5 V 脉冲，观察 VG2 | 同上 | TP(VD1)、TP(VG2) | VG2 不响应 VD1；反之亦然 |
| 5 | 移除短接 | 同上 | 四通道 | 空白时间后恢复，无窄脉冲、无直通 |

核心判据：**任何时刻 VG1 与 VG2 不得同时高于 2 V**；交叉通道响应必须为 0。

### T3 PGD 比例驱动（真实负 VDS / 换流条件）

**前置**：按 T7 的 F-SEC 夹具建立电流；**不得用 VD 正电压静态扫描代替**。
UCC24624 的 PGD 是依据 SR 导通期间的负 VDS 调节门极，目标是 −35 mV；
若在上一导通时间的 90 % 内未达到，则强制 −100 mV 档。

| 步骤 | 激励（波形 / 源阻抗） | 限流 / 停机 | 观测端口 | 通过判据 |
|---|---|---|---|---|
| 1 | Q1 门极先保持低；F-SEC 以 10 mH 电感把电流从 0 升到 1 A（di/dt≈20 A/ms），持续 1 ms、占空比 ≤1 % | F-SEC 限流 2 A；电流 >3 A、壳温 >60 °C 停机 | TP(VD1)、TP(SR_SRC)、TP(VOUT)、电感电流探头 | Q1 体二极管续流，V(VD1)−V(SR_SRC) ≈ −0.7 V |
| 2 | 释放 U1，让 VG1 正常驱动 Q1，同一 1 A 电流 | 同上 | TP(VG1)、TP(VD1)、TP(SR_SRC) | VG1 上升后 VDS 被调节到 −35 mV ±10 mV；门极电压 ≤VDD |
| 3 | 电流改为 0.5 A / 2 A 两点，重复步骤 2 | 同上 | 同上 | 两点都向 −35 mV 收敛；记录偏离与 PGD 等效阻抗 |
| 4 | 把电流上升时间缩短到 100 µs（仍 ≤2 A） | 同上 | 同上 | 若 90 % 上一导通时间内未达 −35 mV，观察 VG 升到 −100 mV 档 |
| 5 | 记录 VGS 平台与米勒段 | — | TP(VG1)、TP(SR_SRC) | 无过冲超过 VDD+0.3 V；无负压低于 −0.3 V |

**注意**：PGD 的等效驱动阻抗此前未校准（第三轮 §7 第 3 条）；本试验就是校准它。
没有 F-SEC 电流时，T3 只能记录静态电平，不能给出 PGD 结论。

### T4 窄脉冲关断 / TOFF / 空白时间

| 项目 | 数据手册/模型口径 | 可执行激励 | 观测端口 | 通过判据 |
|---|---|---|---|---|
| 最小导通 TON | 155 ns | F-PULSE 5 V 方波，脉宽从 50 ns 递增到 1 µs，100 Ω 注入 VD1 | TP(VD1)、TP(VG1) | 与口径差 ≤±20 %，且不出现半脉冲 |
| 关断延迟 TOFF | 23 ns | F-PULSE 5 V/10 kHz，下降沿 <10 ns | TP(VD1)、TP(VG1) | ≤50 ns（含探头） |
| 开通空白 on-blank | 475 ns | 关断后 100 ns 再注入一个 5 V 脉冲 | TP(VD1)、TP(VG1) | 空白内不再开通 |
| 关断空白 off-blank | 650 ns | 开通后 100 ns 撤销 VD | TP(VD1)、TP(VG1) | 空白内不误关断 |
| ARM 阈值 | 1.5 V | VD 以 0.1 V/ms 慢扫 | TP(VD1)、TP(VG1) | 记录实际跳变点 |
| ONTH | −265 mV | 用 F-SEC 建立负 VDS（同 T3，≤0.5 A），缓慢增减 | TP(VD1)、TP(SR_SRC) | 记录实际阈值 |
| OFFTH | 10.5 mV + 330 µA·R1 | 换 R1=0/100/212 Ω 三点，其余同 ONTH | TP(VD1)、TP(SR_SRC)、TP(VSS) | 三点线性，斜率 330 µA ±10 % |

限流：F-PULSE 支路串 100 Ω，电流 <50 mA；F-SEC 限流 2 A。出现直通或壳温 >60 °C 即停机。

### T5 Kelvin 与门极负载

| 步骤 | 激励（波形 / 源阻抗） | 限流 / 停机 | 观测端口 | 通过判据 |
|---|---|---|---|---|
| 1 | 隔离源经 Rsh1 注入 1 A 直流 1 s（四线） | 限流 2 A；1 s 后断开 | TP(SR_SRC)、TP(PGND) | 与 1 mΩ×1 A 偏差 <1 %；走线压降不计入 |
| 2 | 装 CGL1/2 6.8 nF；Rg=0/2.2/10 Ω 三档；F-PULSE 5 V/10 kHz 激励 VD1 | 限流 50 mA；驱动器过热停机 | TP(VG1)、TP(SR_SRC)、TP(VD1) | 记录 VGS 上升/下降时间与峰值门极电流；不过热、不误关断 |
| 3 | 比较装/不装 CGL 的 TON/TOFF | 同 T4 | TP(VD1)、TP(VG1) | 量化 6.8 nF 影响；超 T4 判据则记为设计约束 |

### T6 偏置、REG 跟随与 UVLO（按 datasheet 真实工作模式）

UCC24624 的 REG 只在 VDD 高于约 11 V 后才稳压到 11 V；**低于该电压时 REG 跟随 VDD**
（不是 11 V）。UVLO 监视 REG：开通阈值 VREGON 典型 4.5 V（4.1–4.8 V），
关断阈值 VREGOFF 典型 4.0 V（3.63–4.25 V）。因此 **VDD=4.25 V 时不得要求 REG=11 V**。

| 步骤 | 激励（波形 / 源阻抗） | 限流 / 停机 | 观测端口 | 通过判据 |
|---|---|---|---|---|
| 1 | F-VDD 以 0.1 V/ms 从 0 升到 26 V | 限流 50 mA；REG >13 V 停机 | TP(VDD)、TP(REG)、TP(VG1)、TP(VG2) | VDD<11 V 时 REG≈VDD（跟随）；≥11 V 后 REG=11 V ±5 % |
| 2 | 记录门极首次活动的 REG 电压 | 同上 | TP(REG)、TP(VG1)、TP(VG2) | VREGON 落在 4.1–4.8 V |
| 3 | VDD 从 12 V 降到 0，0.1 V/ms | 同上 | TP(VDD)、TP(REG)、TP(VG1)、TP(VG2) | 门极在 REG 降至 VREGOFF 前关断；VREGOFF 落在 3.63–4.25 V；无窄脉冲 |
| 4 | VDD=4.25 V 稳态 | 同上 | TP(VDD)、TP(REG) | REG≈4.25 V（跟随），**不要求 11 V**；门极状态按 VREGON 判定 |
| 5 | VDD=12 V 与 26 V 两点 | 同上 | TP(VDD)、TP(REG) | REG=11 V ±5 %；记录静态电流 |

### T7 低能量开关试验（T3 的前置夹具，需隔离中心抽头源）

| 步骤 | 激励（波形 / 源阻抗） | 限流 / 停机 | 观测端口 | 通过判据 |
|---|---|---|---|---|
| 1 | F-SEC：隔离源 ≤20 V 峰值，10 Ω + 10 mH 串入 SEC_A/CT/SEC_B；J2 接 0.2–2 Ω；1 kHz / 1 % 占空比初测 | 限流 ≤10 A；>10 A 或直通即切断 J3 | TP(VD1)、TP(VD2)、TP(VG1)、TP(VG2)、TP(VOUT)、电感电流 | SR 导通与体二极管续流可辨；无直通 |
| 2 | 同一夹具升到 100 kHz，占空比仍 ≤10 % | 同上；壳温 >60 °C 停机 | 同上 | 死区内无两路同时导通；波形与 1 kHz 一致 |
| 3 | 升到 100–500 kHz 扫描，每次只改一个频率点 | 同上；每次升频前确认无直通 | 同上 | 无窄脉冲、无直通；记录频率上限 |

**仍不得接 48 V，不得把单组当四组串联。** 任一通路电流 >10 A 或出现直通即切断 J3。

---

## 6 BOM 与装配状态

- 原生 BOM：24 行、49 只，全部有 LCSC 编号（见 `UCC24624_bom.xlsx`）。
- **DNP（首板不装）**：`CGL1` `CGL2`（6.8 nF 门极负载）、`Rsn1` `Rsn2`
  （10 Ω）、`Csn1` `Csn2`（1 nF）。这些是测试选项，不是默认装配。
- `R1` 首板装 0 Ω；`Rg1/Rg2` 首板装 0 Ω，备 2.2–10 Ω 选项。
- `R2/R3` 首板装 0 Ω（VD 直连）；需要断开检测时再改。
- 连接器 J1/J2/J3 为 5.0 mm 螺钉端子；JP1/JP2 为 2.54 mm 排针。
- 所有测试点为 1 mm 焊盘，便于差分探头与 Kelvin 夹。

---

## 7 嘉立创 EDA 原生工程：已做、未做、怎么做

### 7.1 已用 headless API 完成（可复现）

工具版本 LCEDA Pro 4.1.60.198f38ab，CLI：

```bash
lceda-pro open --path "<工程>.eprj2" --headless true
lceda-pro session list
lceda-pro invoke --session <id> --ext-uuid eda --timeout 60000 --code "<async body>"
```

已成功：

1. `dmt_Project.createProject` 建原生工程（EPRJ3 默认格式，落盘为 `.eprj2`）；
2. `sch_PrimitiveComponent.create` 放置 49 个系统库真实器件；
3. `sch_PrimitiveWire.create([x1,y1,x2,y2], net)` 逐脚建 107 段命名导线
   （扁平数组；并发创建会串网，必须顺序）；
4. `sch_ManufactureData.getNetlistFile(name, 'EasyEDA')` 导出网表并逐脚核对；
5. `sch_ManufactureData.getBomFile(name, 'xlsx')` 导出 BOM（xlsx 二进制经
   base64 取回，避免控制台编码损坏中文厂商名）。

脚本：`lceda/step1_create_proj.js` … `step10_check.js`。

### 7.2 headless 下**不能**完成（实测证据）

| 尝试 | 返回 | 结果 |
|---|---|---|
| `pcb_Document.importChanges(schUuid)` | `true` | PCB 器件数 0（静默无操作，疑似模态确认框在 headless 自动取消） |
| `pcb_Document.importChanges()`（默认关联） | `true` | 同上，0 |
| `dmt_Pcb.createPcb('Board1')` | `undefined` | 新 PCB 未创建 |
| `pcb_PrimitiveComponent.create(device/footprint, …)` | 异常 `[object Object]` | 未放置 |
| `lib_Device.get(devUuid)` | `undefined` | 取不到完整器件项 |
| `sys_FileSystem.saveFileToFileSystem('D:/…')` | `{"error":"路径不允许"}` | 文件系统沙箱拒绝任意路径 |

结论：**原生原理图与 BOM 是真实产物；PCB 尚未产出。** 不把"有原理图"说成
"有可制造 PCB"，也不伪造 Gerber。

### 7.3 剩余手工步骤（GUI，约 1–2 小时）

1. 用 LCEDA Pro 打开 `lceda/native/UCC24624 SR Validation.eprj2`；
2. 打开 `PCB1` → 菜单 **设计 → 导入变更** → 全选 → 应用（49 只应全部进入）；
3. 画板框（建议 60 × 45 mm，四角 R2），叠层默认 2 层 1.6 mm；
4. 布局：J1/F1/D1/D2/C1–C3 靠一侧；U1 居中；Q1/Q2 靠近 J3；
   Rg/Rgs/CGL 紧贴门极；Rsh 与 Kelvin 对走四线；C6/C7 靠 J2；
5. 布线（或导出 DSN 交 JRouter）：功率回路短而宽，Kelvin 单独走，
   门极回路最小；
6. DRC（间距 ≥0.2 mm，线宽按电流；本板 ≤2 A，1 mm 足够）；
7. 导出 Gerber、钻孔、BOM、坐标（`pcb_ManufactureData.getGerberFile` 等
   在 GUI 内可用）、装配图；
8. 把导出件放回本目录，并在本文 §1 更新状态。

---

## 8 明确不做 / 不能宣称

- 不做 100 A、不做热、不做磁件、不做 EMI/安规；本板不承载主功率。
- 不宣称"可制造"已覆盖 PCB、Gerber、叠层、装配——只覆盖原理图网表与 BOM。
- 不把单组试验结果外推为四组串联整机。
- 不在未做 T1–T4 前宣称 UCC24624 行为已被硬件验证；本板之前只有行为模型。

---

## 附录 A 网络核对复现

```python
import json, re
t = open('pcb/control_validation/control_validation.net', encoding='utf-8').read()
i = t.find('\t(nets')
expected = {}
for chunk in re.split(r'\n\t\t\(net\n', t[i:])[1:]:
    name = re.search(r'\(name "([^"]+)"\)', chunk).group(1).lstrip('/')
    for ref, pin in re.findall(r'\(ref "([^"]+)"\)\n\s*\(pin "([^"]+)"\)', chunk):
        expected.setdefault(ref, {})[pin] = name
actual = json.load(open('pcb/control_validation/lceda/lceda_pin_nets.json',
                        encoding='utf-8'))['value']
problems = [(r, p, n, actual.get(r, {}).get(p))
            for r, pins in expected.items() for p, n in pins.items()
            if actual.get(r, {}).get(p) != n]
print(len(expected), len(actual), len(problems))
```

期望输出：`49 49 0`。
