czy0126/CZY/design/v2/gate_load_calibration.md

# 驱动与栅极负载标定：6.7 nF 的来历、量化与处置

日期 2026-10-31。对应审核步骤 2 的第一项：“校准驱动与栅极负载，解决额外 6.7 nF”。
状态：**SIMULATION EVIDENCE / MODEL CORRECTION（已量化，已参数化，尚未全台架铺开）**。
所有台架均为行为模型，**不是硬件验证**。

## 0 结论摘要

1. `sr_timing_v3.lib` 里的 `Cgate G S 6.7n` 不是电路里的任何器件，它是**理想开关台**时代替
   MOSFET 栅荷的集总替身（手册 Qg(0–10 V)=67 nC ≈ 6.7 nF×10 V）。
2. `SR_DEVICE` 已经带有 `Cgs=5.1 nF` 与非线性 `Cgd`，再并 6.7 nF 等于**把栅荷翻倍**。
   实测：驱动侧电荷 58.23 nC → 129.58 nC（+122%），每周期栅极能量 609 → 1407 nJ（+131%），
   器件内部栅压上升沿 90.3 → 214.3 ns（+137%）。
3. 在 40 A 头条换流台上，去掉替身后 **Qrev 69.06 → 95.16 nC（+37.8%）**、
   **EBD 5.851 → 6.788 µJ（+16.0%）**、总损耗 9.362 → 9.898 µJ（+5.7%）。
   这不是新缺陷，而是**印证了报告 §3.5 自己的外推**（“真实器件 Ciss≈4.6 nF 时关断尾约 6–6.5 µJ，
   比本台的 5.0 µJ 更大”）；实测 6.79 µJ 略高于该区间上界。
4. 处置：新增 `models/sr_timing_v3_1.lib`，把集总电容变成参数
   `CGATE`（默认 6.7n，保持旧台架逐位兼容）并新增 `CPIN`（默认 0）。
   与 `SR_DEVICE` 配对时用 `CGATE=0 CPIN=100p`；`CPIN` 只作数值正则化，
   对器件栅沿与电荷的影响 ≤2%（实测 +1.9%）。
5. **仍未闭环**：驱动边沿本身与手册对不上。手册 tr/tf = 23/35 ns @6.8 nF，
   而模型的 8.7 Ω 源 / 3.1 Ω 灌 + 1.5 A/4 A 限流在 6.8 nF 上给出 127.9/45.6 ns。
   这组电阻/限流与 23/35 ns **数学上不可同时成立**，需要手册实测条件或硅片数据才能定案。

## 1 6.7 nF 的来历与它为什么是“额外”

| 事实 | 出处 |
|---|---|
| 手册 Qg(0–10 V) = 67 nC（83 max） | `design/v2/official_model_report.md:40` |
| 旧台架用理想开关（无栅极电容），用集总 6.7 nF 代表栅荷 | `models/sr_timing_v3.lib:106`；`sr_commutation_v3.cir` 头注 |
| 器件模型自带 `Cgs 5.1 nF` + 非线性 `Cgd`（0 V 时约 736 pF） | `models/sr_device_v3.lib:87,95` |
| 手册 tr/tf 测试负载 6.8 nF | 审核指南行 12；`sr_timing_audit.md:128` |

理想开关台：6.7 nF 是**唯一**的栅荷来源，合理。
器件台：栅荷已由 `SR_DEVICE` 提供，6.7 nF 变成**并联的额外电容**——

- 它不在 BOM 里（唯一的外接栅阻是 2.2 Ω，已并入 8.7/3.1 Ω）；
- 它把驱动电荷从 58.2 nC 推到 129.6 nC（器件 Qg 的 2.2 倍）；
- 因此所有“门极能量”“栅极电流”“关断沿”都被它主导。

## 2 门极标定台架

三支小台，均用 `SR_DEVICE` 的封装 `Lg=2.5 nH`、`Rg=1 Ω`，Vds 固定 4 V（换流台母线），
驱动 0→10.9 V（与 `Bdrv` 的上限一致）。

### 2.1 `sim/v2/gate_bench/gd_drv_only.cir`：只有驱动与集总电容

| CG | tr(10–90%) | tf(90–10%) | 对照 |
|---:|---:|---:|---|
| 6.7 nF | **127.9 ns** | **45.6 ns** | 手册 23/35 ns typ @6.8 nF → 慢 5.6× / 1.3× |

与 `sr_timing_audit.md:128` 的 127.9/45.6 ns 逐位一致，说明本台复现了被审核的驱动拓扑。

### 2.2 `sim/v2/gate_bench/gd_with_dev.cir`：驱动 + 真实器件栅

`Vig` 为 0 V 感测源，积分器给出**驱动侧**电荷与能量（不是器件 Qg 定义）。
`V(x1:gi)` 是器件内部栅极（封装 Lg、Rg 之后）。

| CG | 引脚沿 tr/tf | 器件栅 tr/tf | 驱动侧电荷 | 栅耗/周期 | 峰值电流 |
|---:|---|---|---:|---:|---:|
| 0 | 4.4 ps（代数节点，非物理） | **90.3 / 26.9 ns** | **58.23 nC** | **609 nJ** | 2.42 A |
| 6.7 nF | 215.5 / 70.8 ns | **214.3 / 66.8 ns** | **129.58 nC** | **1407 nJ** | 3.51 A |
| 差值 | — | +124% / +148% | **+71.35 nC（+122%）** | **+798 nJ（+131%）** | — |

+71.35 nC ≈ 6.7 nF × 10.65 V，与“额外电容”的解释吻合。

### 2.3 `sim/v2/gate_bench/gd_thevenin.cir`：拓扑替换试验与 CPIN 正则化

把理想电流源换成“理想电压源 + 行为电阻 8.7/3.1 Ω”后，**器件栅沿逐位不变**
（90.3/26.9 ns），说明差异来自负载而非驱动源类型；但 `CGATE=0` 时引脚仍是代数节点，
上升 3.9 ps。加 `CPIN=100p` 后：

| CG | 引脚 tr | 器件栅 tr | 器件栅 tf | 影响 |
|---:|---:|---:|---:|---|
| 0 | 3.9 ps | 90.3 ns | 26.9 ns | 代数节点，数值代价大 |
| 100 p | 92.1 ns | **92.0 ns** | **27.4 ns** | 栅沿 +1.9%，电荷不变 |
| 6.7 n | 216.2 ns | 214.9 ns | 66.7 ns | 旧行为 |

`CPIN=100p` 的定位：**数值正则化**，不是器件参数。它的影响被上表界定在 2% 以内；
若将来有封装/探针实测值，应直接替换而不改结论。

## 3 对 40 A 头条换流台的影响

`sim/v2/comm_v3/sr_gate_load_test.cir`：与 `sr_commutation_v3.cir` 同激励、同测量、同窗口，
只把 `CGATE/CPIN` 步进（PGD=0、TOFF=23 ns、TMAX=2 ns）。

| 量 | CGATE=6.7n（旧头条） | CGATE=0, CPIN=100p | 变化 |
|---|---:|---:|---:|
| `IREV_CYC` | 2.1965 A | 2.1963 A | −0.01% |
| `QREV_CYC` | 69.06 nC | **95.16 nC** | **+37.8%** |
| `EBD_CYC` | 5.851 µJ | **6.788 µJ** | **+16.0%** |
| `ECH_CYC` | 2.894 µJ | 2.507 µJ | −13.4% |
| `EGE_CYC` | 0.617 µJ | 0.602 µJ | −2.5% |
| 合计 Etot | 9.362 µJ | **9.898 µJ** | **+5.7%** |
| `QG_CYC`（器件侧） | 66.73 nC | 64.62 nC | −3.2% |
| `VGS_MAX` | 10.8927 V | 10.8928 V | — |

数值稳健性：`CPIN=0` 时 QREV 95.33 nC、EBD 6.771 µJ；`CPIN=100p` 时 95.16 nC、6.788 µJ
（0.2% / 0.25%），说明结论不是正则化带来的伪影。反向对照（CGATE=6.7n、CPIN=100p）
给 69.28 nC / 5.848 µJ，与旧头条 69.06 / 5.851 相差 <0.4%，证明参数传递本身没有副作用。

**交叉验证**：`sr_commutation_v3_results.md §3.5` 已按“真实器件 Ciss≈4.6 nF、门压下降 20–35 ns”
外推关断尾能量 **6–6.5 µJ**，并明确说本台 5.0 µJ 偏小。去掉额外电容后实测 **6.79 µJ**，
落在预测区间上沿之上；方向与幅度都支持“旧头条低估关断尾”的判断。

**这意味着旧头条不是保守值**：QREV 低估 38%，EBD 低估 16%。凡引用 9.362 µJ / 69.06 nC 的
结论，都必须注明是“含 6.7 nF 额外栅荷”的口径。

两条变化的机理已分开核实（详见 `sr_commutation_v3_g0_results.md` §5）：

- **EBD +0.94 µJ 是真实的时间效应**：替身把 VGS 10.9→1.0 V 的关断沿从 48.5 ns 拖到 94.0 ns，
  器件晚 46.2 ns 才离开增强区，体二极管少续流 46 ns ≈ 27 A × 0.71 V × 46 ns ≈ 0.89 µJ。
- **QREV +26 nC 不是电荷变多**：过零后 67 MHz 振铃的首个脉冲两版相差 0.3%（53.41 vs 53.25 nC），
  差异全在衰减（τ 20.7 → 57 ns）。QREV 不可用作损耗代理。
- 两版经感测源移除的门极电荷**逐位相同**（59.78 / 59.79 nC）：替身在感测源的驱动侧，
  所以 comm 台的 QG_CYC / EGE_CYC 从不含它——替身只改变边沿时刻，不改变电荷账本。

## 4 驱动边沿与手册的矛盾（未闭环）

手册：UCC24624 tr/tf = 23/35 ns typ @6.8 nF（40/40 ns max）。
模型：8.7 Ω 源 / 3.1 Ω 灌（6.5/0.9 Ω 内部 + 2.2 Ω 外接）、1.5 A/4 A 限流。

- 6.8 nF×8.7 Ω = 59 ns 时间常数 → 10–90% 至少 2.2τ = **130 ns**，不可能是 23 ns；
- 即使把 1.5 A 限流打满，68 nC/1.5 A = **45 ns**，也到不了 23 ns；
- 手册 tr<tf（23<35），而模型的源阻 > 灌阻，必然 tr>tf（127.9>45.6）——**方向相反**。

因此“6.5/0.9 Ω + 2.2 Ω + 1.5/4 A 限流”与“23/35 ns @6.8 nF”**不可能同时成立**。
在拿到手册的测试条件或硅片波形之前，不能靠调参把它“对上”；只能：

1. 固定电阻/限流的口径（当前取设计笔记的 8.7/3.1 Ω），并如实报告边沿偏慢；
2. 把手册 23/35 ns 作为**上界指标**单列，不宣称模型满足；
3. 关断尾按“偏慢的驱动”给出的是**偏小的下界**——本次修正后 6.79 µJ 仍是下界，
   真实器件（更快关断）可能更高。这一点必须写进任何引用 9.898 µJ 的结论。

## 5 模型改动

`models/sr_timing_v3_1.lib`（新文件，`sr_timing_v3.lib` 的严格超集）：

- `SR_CH3` / `SR_TIMING` 增加参数 `CGATE=6.7n CPIN=0`；
- `Cgate G S 6.7n` → `Cgate G S {CGATE}`，新增 `Cpin G S {CPIN}`；
- 其余网表行逐字未改；**默认值与 `sr_timing_v3.lib` 完全等价**，
  旧台架不传参时结果逐位不变（`sr_gate_load_test` 的 6.7n/0 档已对照）。

采用规则（写入基线）：

| 台架类型 | 参数 | 理由 |
|---|---|---|
| 理想开关台（无栅极电容） | 默认 `CGATE=6.7n CPIN=0` | 6.7 nF 是器件栅荷替身 |
| `SR_DEVICE` 台 | `CGATE=0 CPIN=100p` | 栅荷由器件提供；100 pF 仅正则化 |

## 6 复现

```bash
cd D:/workshop/design_48v-2v
for f in gd_drv_only gd_with_dev gd_thevenin; do
  ( cd sim/v2/gate_bench && "D:/ADI/LTspice/LTspice.exe" -b $f.cir )
done
( cd sim/v2/comm_v3 && "D:/ADI/LTspice/LTspice.exe" -b sr_gate_load_test.cir )
grep -iE "tr_10_90|tf_90_10|q_rise|e_cycle|ig_peak" sim/v2/gate_bench/*.log
grep -iE "irev_cyc|qrev_cyc|ebd_cyc|ech_cyc|ege_cyc|qg_cyc" sim/v2/comm_v3/sr_gate_load_test.log
```

## 7 未闭环项

- 手册 23/35 ns 的测试条件（负载、供电、测量点）——决定驱动模型能否校准；
- 驱动源/灌电阻与限流的口径（6.5/0.9 Ω 与 1.5/4 A 是否同一测试条件）；
- `CPIN` 的真实值（封装引脚 + PCB 走线）——当前 100 pF 是正则化值；
- 全 `comm_v3` 器件台尚未批量切到 `CGATE=0 CPIN=100p`；切换后所有引用旧头条的
  文档都要重出数字（见 §3 的新值）。
