czy0126/CZY/design/v2/sr_commutation_v3_g0_results.md

# 换流台修正基线（g0）：移除 6.7 nF 栅极替代电容后的八档结果

日期 2026-10-31。对应审核步骤 2：“校准驱动与栅极负载，解决额外 6.7 nF”“补充 PGD 依据与边界”
“1/2 ns 步长关键量变化目标 ≤2%，达不到则报告原因”“延迟增大负对照能被检测”。
状态：**SIMULATION EVIDENCE**。行为模型，不是硬件验证。

## 1 这版只改了什么

`sim/v2/comm_v3/sr_commutation_v3_g0.cir` 与 `sr_commutation_v3.cir` 逐行相同，只有两行不同：

```diff
-.include ../../../models/sr_timing_v3.lib
+.include ../../../models/sr_timing_v3_1.lib
-Xsr d1 d2 ga gb reg 0 pre SR_TIMING PGD={PGD} TOFF={TDELAY}
+Xsr d1 d2 ga gb reg 0 pre SR_TIMING PGD={PGD} TOFF={TDELAY} CGATE=0 CPIN=100p
```

依据见 `design/v2/gate_load_calibration.md`：6.7 nF 是理想开关台的栅荷替身，而本台的栅荷由
`SR_DEVICE` 提供（Cgs 5.1 nF + 非线性 Cgd），两者并联等于把驱动电荷翻倍。
`CPIN=100p` 只是把 `CGATE=0` 时代数化的门极引脚变成有定义的节点，对电荷 <0.25%、栅沿 +1.9%。

旧 deck 原样保留，随时可复现旧数字；两版差异因此**只归因于栅极负载**。

## 2 八档总表（直接从 `sr_commutation_v3_g0.log` 的 `.meas` 读取）

| # | PGD | TDELAY | TMAX | IREV (A) | QREV (nC) | EBD (µJ) | ECH (µJ) | EGE (µJ) | QG (nC) | VGS_max (V) |
|--:|--:|--:|--:|--:|--:|--:|--:|--:|--:|--:|
| 1 | 0 | 23n | 2n | 2.18928 | 95.155 | **6.7884** | 2.5074 | 0.6017 | 64.615 | 10.8928 |
| 2 | 1 | 23n | 2n | 2.16109 | 93.221 | 1.0381 | 3.2284 | 0.1955 | 36.400 | 5.6364 |
| 3 | 0 | 200n | 2n | 2.19509 | 95.361 | 3.7955 | 2.4047 | 0.6021 | 64.628 | 10.8928 |
| 4 | 1 | 200n | 2n | 3.96669 | 233.57 | 1.1932 | 3.3293 | 0.2014 | 36.235 | 5.6360 |
| 5 | 0 | 23n | 1n | 2.17180 | 94.641 | 6.7570 | 2.5140 | 0.6017 | 64.586 | 10.8928 |
| 6 | 1 | 23n | 1n | 2.13615 | 92.423 | 1.0328 | 3.2259 | 0.1955 | 36.354 | 5.6364 |
| 7 | 0 | 200n | 1n | 2.17075 | 94.591 | 3.7811 | 2.4070 | 0.6021 | 64.581 | 10.8928 |
| 8 | 1 | 200n | 1n | 4.04116 | 240.70 | 1.2065 | 3.3302 | 0.2015 | 36.261 | 5.6360 |

主档（#1）Etot = 6.788 + 2.507 + 0.602 = **9.897 µJ/周期/管**，即 1.979 W（200 kHz）。
8 档全部 `Total elapsed time` 正常、无 `Measurement failed`、无 time-step 警告，整批 5.3 s。

### 2.1 与旧头条主档的对照

| 量 | 旧（6.7 nF） | 新（g0） | 变化 | 归因 |
|---|---:|---:|---:|---|
| IREV_CYC | 2.17103 A | 2.18928 A | +0.84% | 关断沿变快，反向峰值相位略移 |
| QREV_CYC | 69.06 nC | 95.16 nC | **+37.8%** | 67 MHz 振铃衰减变慢（§6.3），非开关电荷 |
| EBD_CYC | 5.8510 µJ | 6.7884 µJ | **+16.0%** | 体二极管续流多 46 ns（§6.4） |
| ECH_CYC | 2.8943 µJ | 2.5074 µJ | −13.4% | 通道导通期相应缩短 |
| EGE_CYC | 0.6171 µJ | 0.6017 µJ | −2.5% | 同器件、同电荷，仅沿形不同 |
| QG_CYC | 66.73 nC | 64.62 nC | −3.2% | 器件侧电荷；替身从不进入该账本（§6.2） |
| Etot | 9.362 µJ | 9.897 µJ | +5.7% | |

## 3 步长灵敏度（TMAX 2 ns vs 1 ns）

判据：同一条 PGD/TDELAY 下 2 ns 与 1 ns 关键量相对变化 ≤2%。取 #1/#5、#2/#6、#3/#7、#4/#8 四对。

| 角 | IREV | QREV | EBD | ECH | EGE |
|---|---:|---:|---:|---:|---:|
| PGD=0, 23n | −0.80% | −0.54% | −0.46% | +0.26% | +0.002% |
| PGD=1, 23n | −1.15% | −0.86% | −0.51% | −0.07% | −0.01% |
| PGD=0, 200n | −1.11% | −0.81% | −0.38% | +0.10% | +0.001% |
| PGD=1, 200n | +1.88% | **+3.05%** | +1.11% | +0.03% | +0.04% |

**结论**：基线角（PGD=0，两种延迟）全部 ≤1.2%，达标。
**未达标**：PGD=1 + TDELAY=200n 的 QREV 达 3.05%，超过 2%。原因：该角 SR 被 PGD 定律压在 2.6 V
钳位上直到电流尾段，关断发生得晚且与电流过零点只差几十纳秒；QREV 是 4 A / 240 nC 的大事件，
其**起点**对亚纳秒对齐极敏感。参比：旧 deck 同角为 QREV 1.16%、IREV 0.94%——
修正后的栅沿从 214 ns 缩到 90 ns，事件更短，因此对步长更敏感，这是物理上的预期方向。
该角属于未标定的 PGD 分支（§7），不进入基线；若要分析它，必须用 1 ns 或更细步长。

## 4 负对照：延迟增大必须被检测到

| 角 | TDELAY 23n → 200n | 变化 | 检出 |
|---|---|---:|---|
| PGD=0 | EBD 6.788 → 3.795 µJ | −44.1% | ✔ 显著 |
| PGD=0 | QREV 95.16 → 95.36 nC | +0.2% | ✘（该量对此不敏感） |
| PGD=1 | IREV 2.161 → 3.967 A | +83.6% | ✔ |
| PGD=1 | QREV 93.2 → 233.6 nC | +150.6% | ✔ |
| PGD=1 | GATE_OVERLAP 29.5 → 52.2 mV | +76.6% | ✔ |

结论：延迟增大在 **EBD / IREV / QREV / 门极重叠** 上都能被检出，负对照成立。
注意 PGD=0 的 QREV 对该故障不敏感——引用 QREV 作健康指标时必须配 EBD。
`GATE_OVERLAP` 是电压（`MAX min(V(gda),V(gdb))`），52 mV 远低于阈值，本模型未出现直通。

## 5 可解释的 VGS / VDS / 门极电流 / 电荷

### 5.1 导通点（19.25 µs，负载 40 A）

| | VGS | VDS | RDS | 与 PGD 定律的偏差 |
|---|---:|---:|---:|---|
| PGD=0 | 10.8928 V | −35.79 mV | 0.8949 mΩ | 驱动到 REG 轨（10.9 V 上限） |
| PGD=1 | 4.0994 V | −48.10 mV | 1.2026 mΩ | 定律要求 Vds=48.74 mV 对应 4.099 V，实测 48.10 mV，伺服误差 0.64 mV |

PGD=1 的读数直接由定律 `limit(3 + (−Vds − 35 mV)·80, 2.6, 10.9)` 复算得出，不是拟合。

### 5.2 关断沿（主档，gate 在 19.8565 µs 开始下降）

| 量 | 旧（6.7 nF） | 新（g0） | 说明 |
|---|---:|---:|---|
| 峰值灌电流 | 1.475 A | **2.511 A** | 旧值恰好贴住驱动的 −1.5 A 限流 |
| 经感测源移除的电荷 | 59.78 nC | **59.79 nC** | **两版逐位相同** |
| VGS 10.9→1.0 V 用时 | 94.0 ns | **48.5 ns** | |
| VGS 经过 4–8 V（Miller 窗） | 26.8 ns | **16.3 ns** | 同期 Vds 过零 |
| 门极电流 >50 mA 的时长 | 139.4 ns | 88.6 ns | |

“移除电荷两版相同”是这条账本的关键证据：`Vg1` 感测源位于时序模型门极与器件门极之间，
`Cgate` 在感测源的**驱动侧**，所以 **QG_CYC / EGE_CYC 从来不含替身电容**。
替身对本台的影响**只通过边沿时刻**，不通过电荷记账——这与 §3 的差异全部落在时间上相符。

### 5.3 QREV 的构成：53 nC 的换流脉冲 + 41 nC 的振铃尾巴

20.5005 µs 电流过零后，开关进入 67 MHz 振铃（周期约 15.0 ns）。

| | 首个脉冲 | 每周期衰减比 | 时间常数 τ | 20.55–21.6 µs 尾巴 |
|---|---:|---:|---:|---:|
| 旧（6.7 nF） | 53.25 nC | 0.485 | 20.7 ns | 15.4 nC |
| 新（g0） | 53.41 nC | 0.77 | 57 ns | 40.6 nC |

首个脉冲相差 **0.3%**，全部差异来自衰减。机理：漏极振铃经 Cgd 注入门极，门极节点就是它的阻尼路径；
67 MHz 下 11.8 nF 的阻抗 0.20 Ω，5.1 nF 时 0.46 Ω。
**因此 QREV 不是开关电荷，不能当损耗代理**；损耗以 EBD/ECH/EGE 为准。

### 5.4 EBD 的来源与自洽检验

VGS 穿过 1 V 的时刻：旧 19.9512 µs，新 19.9050 µs（差 **46.2 ns**）；此后体二极管从 ~27 A 续流到
20.50 µs 电流过零。按 46.2 ns × 约 27 A × 0.71 V 估算增量 ≈ 0.89 µJ，实测 EBD 增量 0.94 µJ，
偏差 5% 以内。

### 5.5 VDS 的量程说明

`VDS_MAX_CYC` = 5.000 V 不是器件应力：d1 被 `Dcl1` 钳到 4 V 母线，峰值电流 40 A 通过钳位二极管
（Vfwd 0.2 V、Ron 20 mΩ）得到 4 + 0.2 + 40×0.02 = 5.0 V。该数是台架钳位的上限。

## 6 PGD 定律：依据、边界与实测

定律（`models/sr_timing_v3.lib:103`，两版逐字相同）：

```
Bdrv drv S V = if(Q>0.5, if(PGD, limit(3 + (−Vds − 0.035)·80, 2.6, 10.9), min(10.9, V(REG))), 0)
```

- **依据**：无。文件头自述 “PGD is the same uncalibrated smooth law as v2; do not sign off”。
  它不是 UCC24624 数据手册中的任何一条；是“预测栅压/自适应栅压”概念的一个静态替身。
- **形式边界**：只有 Vds→Vgs 的静态映射，没有动态、没有温度、没有 BON/BOFF 感知；
  钳位 [2.6, 10.9] V，增益 −80 V/V，偏置 35 mV。
- **实测边界**：40 A 时把 Vgs 压在 4.10 V（Rds 1.20 mΩ），随电流下降滑到 2.6 V 钳位。
- **对时序的副作用（未预料）**：被压在 2.6 V 时器件仍处于增强态，漏极电压升不起来，
  Vds>OFFTH 的关断提交被推迟 **约 0.39 µs**，于是体二极管续流几乎消失：
  EBD 6.788 → 1.038 µJ（**6.5×**），而 200 ns 延迟角下 QREV 翻 2.5 倍、门极重叠翻 1.8 倍。

结论：PGD=1 给出的“少损耗”是**未标定定律的产物，不可作为设计结论**。
基线固定 PGD=0；任何引用 PGD=1 的结论必须同时给出该定律的标定来源。

## 7 复现

```bash
cd D:/workshop/design_48v-2v/sim/v2/comm_v3
"D:/ADI/LTspice/LTspice.exe" -b sr_commutation_v3_g0.cir
cd D:/workshop/design_48v-2v
python tools/meas_table.py sim/v2/comm_v3/sr_commutation_v3_g0.log \
    --only irev_cyc qrev_cyc ebd_cyc ech_cyc ege_cyc qg_cyc vgs_max_cyc
```

`tools/meas_table.py` 按日志自己的 `.step` 头重建行序（不按 `.step` 声明顺序猜测）。

## 8 未闭环

- 驱动边沿与手册 23/35 ns 的矛盾（`gate_load_calibration.md` §4），决定本节所有时间量的绝对刻度；
- PGD 定律的标定来源；在标定前 PGD 分支不进基线、不进整机；
- `CPIN` 的真实值（当前 100 pF 是正则化值）；
- 本表只到 40 A 单点；角点与轻载仍用旧 deck，尚未切换（切换后 `sr_commutation_v3_results.md`
  的 69.06 nC / 5.851 µJ / 9.362 µJ 三组数字全部作废，需按本文系数重出）。
