czy0126/CZY/design/v2/sr_commutation_v3_results.md

# SR 换流台 v3：真实器件接入后的四组数字

日期 2026-10-31。状态：**SIMULATION_EVIDENCE**。数值完成不等于硬件验证；本文所有数字均为 LTspice 26.0.2 批处理结果，未与硅片、未与热模型、未与 48 V 整机对照。

> **2026-10-31 审核退回收窄（P1）。** 本文 §8–§11 的 Roffset 结论只适用于“40 A/200 kHz 受迫正弦、4 V 钳位、PGD 未校准、封装寄生为 ESTIMATE”这一台架，**不构成“固定电阻方案已被排除”的结论**。实际芯片 PGD 与真实双 SR 谐振换流波形尚未验证，因此 0 Ω Kelvin 基线仍保留为默认候选，Roffset 只保留调试焊盘。原文中“固定电阻方案关闭”与“不关断最多 7.5 ms、随后约 15 ms 极限环”已按审核意见撤回：前者改为“本台架下存在不能关断的工况”，后者改为“手册只规定 CH1 平均频率待机判据，不能据此推出所有故障状态的硬上限或固定周期”。详见 `docs/审核结论与后续指南_2026-10-31.md` 与 `design/baseline/BASELINE.md`。

> **2026-10-31 步骤 2 更新（栅极负载，数字口径变更）。** 本文全部数字使用 `sr_timing_v3.lib` 的集总
> 6.7 nF 栅极替身，而本台的栅荷由 `SR_DEVICE` 提供（Cgs 5.1 nF + 非线性 Cgd）——替身属于**重复计入**。
> 已建立修正台 `sim/v2/comm_v3/sr_commutation_v3_g0.cir`（`CGATE=0 CPIN=100p`）：40 A 主档为
> QREV 95.16 nC / EBD 6.788 µJ / Etot 9.897 µJ，本文的 69.06 nC / 5.851 µJ / 9.362 µJ **作废**
> （仅作旧口径保留）。凡引用本文数字处必须注明口径，或改用
> `design/v2/sr_commutation_v3_g0_results.md` 与 `design/v2/gate_load_calibration.md`。

模型与台架（可复算）：

| 对象 | 路径 | sha256 前 16 位 |
|---|---|---|
| 器件模型 | `models/sr_device_v3.lib` | `5224e94703cc2a6e` |
| 时序模型 | `models/sr_timing_v3.lib` | `5099df9183b0e060` |
| 器件台 | `sim/v2/comm_v3/sr_commutation_v3.cir` | `18569a3f258b380c` |
| 理想开关对照台 | `sim/v2/comm_v3/sr_commutation_v3_ideal.cir` | `584c47c41147c132` |
| 器件台日志 | `sim/v2/comm_v3/sr_commutation_v3.log` | `315853472ae5ab92` |
| 对照台日志 | `sim/v2/comm_v3/sr_commutation_v3_ideal.log` | `2a64d9f89d81014b` |
| Roffset 时序变体 | `models/sr_timing_v3_roff.lib` | `f2c4180e44897c18` |
| Roffset 台 | `sim/v2/comm_v3/sr_commutation_v3_roff.cir` | `0e6df5881044bd39` |
| Roffset 日志 | `sim/v2/comm_v3/sr_commutation_v3_roff.log` | `2ee4b2b40439552e` |

三份日志均含 1 行 `Total elapsed time`、57 个 `.meas`、无 `Error`/`Time step too small`/`Analysis failed`；Roffset 台 10 场（5 个 Roffset × PGD=0/1），3.641 s 完成。冻结的 v3 时序模型哈希仍为 `28202ae2…`，未被 Roffset 变体改动。

---

## 0 结论先行

1. **真实器件改变的是换流性质，不只是数值。** 在“同 v3 时序、同激励、只换功率器件”的对照下（PGD=0、TOFF=23 ns）：反向峰值 **9.819 A → 2.171 A**（0.221×），每周期反向电荷 **977.3 nC → 69.06 nC**（0.071×）；但体二极管导通能量 **1.743 → 5.851 µJ**（3.36×），总 SR 损耗 **4.804 → 9.362 µJ/周期**（1.95×，器件侧还多出 0.617 µJ 门耗，理想开关侧按 0 计）。
2. **原因是封装电感把 OFFTH 提前了。** 触发时刻 19.834 µs、I=−29.69 A、端电压 +10.5 mV：其中 I·Rds=−26.6 mV，而 (Ld+Ls)·di/dt=+37.1 mV（di/dt≈33.5 A/µs，Ld+Ls=1.1 nH）。沟道在 25.45 A 关断，体二极管从 25.45 A 接力到 20.5 µs 电流过零；**gate<1 V 的关断尾能量 5.01 µJ/事件**。若从体二极管首次导通（19.918 µs，V(d1)<−0.5 V）算起，完整端电压二极管导通能量约 **5.59 µJ**。同一尾段若由沟道承担只需 **0.113 µJ**（实测积分；线性三角估算 0.106）。多出的 **4.9–5.5 µJ** 在 200 kHz 下是 **0.98–1.10 W/SR**。
3. **PGD=1（未校准的 VDS→VGS 律）改变了这个平衡。** 40 A 时 Rds 从 0.8956 mΩ 升到 **1.1931 mΩ**（VGS 4.133 V），触发被推到 20.368 µs / I=−6.61 A（栅极已被 PGD 箝到 2.601 V），1 V 栅极交点在 20.426 µs / I=−3.71 A；gate<1 V 的关断尾降到 **0.085 µJ**（首次二极管导通口径 0.154 µJ），总损耗 **4.452 µJ/周期**，低于 PGD=0 的 9.362，也略低于理想开关台的 4.804（但理想台门耗按 0 计，不能直接当“真实器件更优”的结论）。
4. **200 ns 负对照的方向取决于触发相位。** 理想开关台 977→3478 nC（3.56×）、峰值 9.82→18.17 A；器件 PGD=1 67.2→213.7 nC（3.18×）、峰值 2.14→4.25 A；器件 PGD=0 仍是 69.1 nC（0.999×），且体二极管尾从 5.85 降到 3.12 µJ——因为 PGD=0 的触发已提前到 29.7 A，200 ns 只让沟道多带一段下降电流。“延迟越大越差”不是无条件规律。
5. **Roffset 有效，但只在 40 A 附近；212 Ω 不是可用工作点。** 把 VSS 330 µA 偏置做成行为等效（`sr_timing_v3_roff.lib`：330 µA 经 Roffv 在检测节点 sv 上抬门槛，栅极回路仍回 S；冻结 v3 未改），扫 0/100/120/150/212 Ω，实测触发端电压精确等于 `10.5 mV + 330 µA×Roffset`（43.50/50.10/60.00/80.46 mV），1 µΩ 基线复现冻结 v3 的 5.851 µJ/69.06 nC 到 4 位。PGD=0 时 **40 A 下 120 Ω 最优**：关断尾从 **5.01 µJ 降到 0**（100 Ω 为 0.16 µJ），总损耗 **9.362→3.712 µJ/周期**，QREV **69.1→48.6 nC**；但总 EBD 仍有 **0.820 µJ** 下限，其中约 0.69 µJ 是关断前 gate<1 段。**150 Ω 已反弹（总 5.228 µJ、QREV 1.20 µC），212 Ω/PGD=0 完全不关断（IREV 40 A、QREV 63.7 µC）**；手册的 <70 mV/<212 Ω 只是 VSS 偏置绝对上限，不保证 40 A 下能关断。**10/25/40 A 负载扫描（§9）进一步显示：10 A/25 A 的 VDS 峰值只有 16.47/41.17 mV，达不到 43.5/50.1 mV，SR 整周期不关断（QREV 15.9/39.8 µC）；只有 40 A 正常关断。** 随后的低门槛扫描（§10）测全了 0/15/25/50/75/85/100/120 Ω：**最优 Roffset 随负载移动——10 A→0 Ω、25 A→50 Ω、40 A→120 Ω**；10/25/40 A 全关断的固定值不止 0 Ω（15 Ω 在 10 A 也触发，但坏 11 倍；≥25 Ω 在 10 A 失效），0 Ω 是其中质量最好的，且它本身就是无偏置基线——一致口径 40 A/0 Ω = **9.521 µJ**（初版误记 8.903，漏加 0.618 µJ 门耗），比 2 ns 基线 9.362 的 1.7% 差是步长效应，不是收益。**固定 Roffset 无法同时满足轻载功能与重载收益**；决策变量是可用 `L·di/dt`，不是负载。下一步需要双 SR 换流台与 DCX 实际 `di/dt` 估算，而不是继续调单个电阻。行为等效仍未覆盖真实 VSS 引脚阻抗与 330 µA 的 260–400 µA 容差。Kelvin 仍是第二选项：只剩 Ld=0.3 nH 时触发降到 ~5 A、尾约 0.18 µJ（~28×），但现有 58–117 ns 的“触发→1 V 栅极”延迟在 50.2 A/µs 下会走 2.9–5.9 A，阈值与延迟必须联合设计（见 §3.4、§8–§11）。

---

## 1 台架、步进映射与窗口

### 1.1 器件接入方式

- 每路：`Xsr1 da gda 0 SR_DEVICE`、`Xsr2 db gdb 0 SR_DEVICE`；删除了外部 `Cda 2n`/`Cdb 2n`（`SR_DEVICE` 已含 Coss，保留会双计）。
- 时序模型**未改动**（`sha256 28202ae2…`），包括其 6.7 nF 栅极节点替身负载；去掉它曾暴露 10 V/44 ps 的栅极针尖（`investigation/sr_timing_v3_cgate0.lib`），不作为 headline。
- 激励与 v2 台相同：4 V 钳位母线、40 A/200 kHz 强制正弦、`Vreg` 0→11 V 在 2 µs、`Vsa/Vsb` 0 V 电流检测。
- 理想开关对照台：同一 v3 时序、同一激励、同一 `.meas`，只把 `SR_DEVICE` 换成 `SW(Ron=1.5m)`+体二极管(`Vfwd=0.65`,`Ron=1.5m`)+`Cda/Cdb 2n`（v2 功率级）。这样才能把“器件效应”与“时序模型 v2→v3 的差异”分开。

### 1.2 8 步映射（取自日志 `.step` 行）

LTspice 的 `.step` 嵌套顺序是**第一个 `.step` 最内层**，日志原文确认：

| 步 | PGD | TOFF | TMAX |
|---|---|---|---|
| 1 | 0 | 23 ns | 2 ns |
| 2 | 1 | 23 ns | 2 ns |
| 3 | 0 | 200 ns | 2 ns |
| 4 | 1 | 200 ns | 2 ns |
| 5 | 0 | 23 ns | 1 ns |
| 6 | 1 | 23 ns | 1 ns |
| 7 | 0 | 200 ns | 1 ns |
| 8 | 1 | 200 ns | 1 ns |

### 1.3 窗口与积分器定义

- 运行到 22 µs；主窗口 **17–22 µs** 恰含一个完整的开通死区（18.0 µs 起）和一个完整的关断事件（PGD=0 触发 19.834 µs，尾到 20.5 µs 电流过零）。旧窗口 **15–20 µs** 保留作边界敏感性核对：两者对 PGD=0 的差 <0.2%（EBD 5.8510 vs 5.8517 µJ；QREV 69.06 vs 69.19 nC），对 200 ns/PGD=1 的差 ≤1.4%。5 µs 窗口在稳态下对周期信号积分恰好等于一个周期，这是两者一致的根据。
- `IREV_CYC = max I(Vsa)`（17–22 µs）；正值为漏→源反向电流，器件导通电流为负（−40 A）。
- `QREV_CYC = ∫max(0,I(Vsa))dt`（1 nF 积分电容，取 17/22 µs 两点差）。
- `EBD_CYC = ∫ if(V(gda)<1, max(0,V(d1)·I(Vsa)), 0)dt`：栅极低时的**正向体二极管导通**（V、I 同为负，乘积为正）。它**不**计反向恢复耗散，也不计栅极在 1 V 与阈值之间的那一段。
- `ECH_CYC = ∫ if(V(gda)>1, max(0,V(d1)·I(Vsa)), 0)dt`：沟道导通。
- `EGE_CYC = ∫|V(gda)·I(Vg1)|dt`：栅极驱动能量（充+放）。
- 功率 = 能量 × 200 kHz。2026-10-31 审核后积分器符号已统一（`B… I=-∫…`），`.meas` 日志中的 QREV/EBD/ECH/EGE 直接为正值；此前版本为负、报告取绝对值。
- `RDS_19 = V(d1,19.25 µs)/I(Vsa,19.25 µs)`，工作点 I≈−40 A；`VGS_19` 同刻。
- `GATE_OVERLAP = max min(V(gda),V(gdb))`；本台最大值 60.9 mV，远低于 1.3 V 阈值，无同时沟道导通。

---

## 2 四组数字

### 2.1 主表：器件台 8 步（干净窗口 17–22 µs）

| 步 | PGD | TOFF | TMAX | IREV (A) | QREV (nC) | EBD (µJ) | ECH (µJ) | EGE (µJ) | 合计 (µJ) | 合计 (W) | VGS19 (V) | VDS19 (mV) | RDS19 (mΩ) | VDS_MIN (V) |
|---|---|---|---|---|---|---|---|---|---|---|---|---|---|---|
| 1 | 0 | 23n | 2n | 2.171 | 69.06 | 5.851 | 2.894 | 0.6171 | 9.362 | 1.872 | 10.892 | −35.82 | 0.8956 | −0.7846 |
| 2 | 1 | 23n | 2n | 2.143 | 67.22 | 0.919 | 3.349 | 0.1832 | 4.452 | 0.890 | 4.133 | −47.72 | 1.1931 | −0.7845 |
| 3 | 0 | 200n | 2n | 2.168 | 69.02 | 3.120 | 2.688 | 0.6175 | 6.425 | 1.285 | 10.892 | −35.79 | 0.8948 | −0.7845 |
| 4 | 1 | 200n | 2n | 4.254 | 213.7 | 1.024 | 3.449 | 0.1892 | 4.663 | 0.933 | 4.133 | −47.72 | 1.1931 | −0.7902 |
| 5 | 0 | 23n | 1n | 2.189 | 69.10 | 5.844 | 2.898 | 0.6170 | 9.359 | 1.872 | 10.892 | −35.79 | 0.8949 | −0.7846 |
| 6 | 1 | 23n | 1n | 2.126 | 67.22 | 0.921 | 3.347 | 0.1833 | 4.452 | 0.890 | 4.133 | −47.72 | 1.1931 | −0.7846 |
| 7 | 0 | 200n | 1n | 2.187 | 69.11 | 3.121 | 2.691 | 0.6174 | 6.429 | 1.286 | 10.892 | −35.79 | 0.8949 | −0.7846 |
| 8 | 1 | 200n | 1n | 4.294 | 216.2 | 1.039 | 3.451 | 0.1892 | 4.680 | 0.936 | 4.133 | −47.72 | 1.1931 | −0.7906 |

补充限值（17–22 µs；除注明外为 2 ns 步长值）：PGD=0 时 `VGS_MAX=10.893 V`、`VGS_MIN=−0.234 V`、`VDS_MAX=5.000 V`、`GATE_OVERLAP=7.18 mV`（1 ns 步长最大 7.204 mV）；PGD=1 时 `VGS_MAX=5.584 V`（开通过冲；稳态 4.133 V）、`VGS_MIN=−0.234 V`、`GATE_OVERLAP=8.77 mV`（23 ns；1 ns 最大 8.834 mV）或 60.9 mV（200 ns；1 ns 最大 60.776 mV）。均无栅极过压（±20 V 额定）、无同时导通。

### 2.2 1 ns vs 2 ns

同配置成对相减（1↔5、2↔6、3↔7、4↔8），相对差：

| 量 | 最大相对差 |
|---|---|
| IREV | 0.95% |
| QREV | 1.17% |
| EBD | **1.44%**（step 4/8，200 ns + PGD=1） |
| ECH | 0.13% |
| EGE | 0.02% |

全部 ≤1.5%。v2 理想台的对应值是 0.465%（反向峰值），本台在 200 ns/PGD=1 的 EBD 上更大一些，但仍在可接受范围。结论：**1 ns 与 2 ns 的时间步长不改变任何决策性结论**；没有出现 CGATE=0 调查里那种 VDS_MIN 数值伪影（本台 VDS_MIN 在 −0.7845…−0.7906 V 之间，物理上对应体二极管 Vf）。

### 2.3 PGD 开 / 关

- **机理已复现**：PGD 律 `VGS = limit(3+(−VDS−0.035)·80, 2.6, 10.9)` 通过端电压反馈改变沟道电阻。40 A 时 PGD=0 给 10.892 V / 0.8956 mΩ；PGD=1 给 4.133 V / 1.1931 mΩ（+33.2%）。这不是“固定 Ron 开关”，而是随工作点变化的非线性沟道。
- **损耗转移**：EBD 5.851→0.919 µJ（−84%），ECH 2.894→3.349 µJ（+15.7%），EGE 0.617→0.183 µJ（−70%），合计 9.362→4.452 µJ（−52.4%）。
- **但 PGD 律未校准**：4.133 V@40 A 是拟合律的输出，不是手册 PGD 曲线的逐点标定；2.6 V 箝位、80 V/V 斜率、35 mV 偏置都没有独立证据。因此“PGD=1 总损耗更低”只能作为**敏感性示例**，不能据此选型或签核。真正可下的结论是：**Rds 随 VGS 的强非线性 + 关断触发相位耦合，使固定 Ron 替身无法代表真实损耗分配**。
- EGE 的绝对值很小（0.123 W vs 1.170 W 体二极管），但在 2 V/100 A 输出下 0.123 W/SR、两路 0.25 W 仍应计入四组冻结的门耗预算。

### 2.4 200 ns 负对照

| 台 | PGD | IREV 23n→200n | QREV 23n→200n | EBD 23n→200n |
|---|---|---|---|---|
| 理想开关（同 v3 时序） | 0 | 9.819→18.17 A（1.85×） | 977→3478 nC（3.56×） | 1.743→4.120 µJ（2.36×） |
| 理想开关（同 v3 时序） | 1 | 8.404→16.75 A（1.99×） | 714→2930 nC（4.10×） | 1.739→4.113 µJ（2.36×） |
| 真实器件 | 0 | 2.171→2.168 A（**0.998×**） | 69.06→69.02 nC（**0.999×**） | 5.851→3.120 µJ（**0.533×**） |
| 真实器件 | 1 | 2.143→4.254 A（1.99×） | 67.22→213.7 nC（3.18×） | 0.919→1.024 µJ（1.11×） |

负对照本身是**通过的**：在触发相位正常的两组（理想台 PGD=0/1，器件 PGD=1）上，200 ns 都把 Qrev 放大 3–4 倍。器件 PGD=0 的反常方向有明确解释：触发已经在 29.7 A，200 ns 延迟末电流约 22 A，1 V 栅极交点约 18 A，沟道多带一段，体二极管尾反而变短；同时电流还没过零，所以 Qrev 不变。这条必须写进 SR 偏置/时序任务：**延迟的代价不是单调的，取决于 OFFTH 触发落在电流波形的哪个相位**。

另需注意：PGD=1/200n 的总 EBD 从 0.919 升到 1.024 µJ，主要是**开通死区**（18.2–18.3 µs 从 0 增到 0.244 µJ，仲裁把开通推迟 34 ns），不是关断尾增加；该组 19.95–20.5 µs 的关断尾为 0（栅极保持 >1 V 到 20.607 µs）。读 1.11× 那一行时不能当成“关断尾变大”。

### 2.5 理想开关 vs 真实器件（同 v3 时序、同激励）

23 ns、2 ns 步长：

| 量 | 理想开关 | 真实器件 | 器件/理想 |
|---|---|---|---|
| IREV | 9.819 A | 2.171 A | **0.221** |
| QREV | 977.3 nC | 69.06 nC | **0.071** |
| EBD | 1.743 µJ | 5.851 µJ | **3.356** |
| ECH | 3.061 µJ | 2.894 µJ | 0.946 |
| EGE | 0（理想开关无栅荷） | 0.617 µJ | — |
| 合计（含门耗） | 4.804 µJ | 9.362 µJ | 1.95 |

PGD=1、23 ns：

| 量 | 理想开关 | 真实器件 | 器件/理想 |
|---|---|---|---|
| IREV | 8.404 A | 2.143 A | 0.255 |
| QREV | 714.5 nC | 67.22 nC | 0.094 |
| EBD | 1.739 µJ | 0.919 µJ | 0.529 |
| ECH | 3.057 µJ | 3.349 µJ | 1.096 |
| EGE | 0 | 0.183 µJ | — |
| 合计（含门耗） | 4.796 µJ | 4.452 µJ | 0.928 |

**读法**：器件把反向电荷砍掉一个数量级，但 PGD=0 时把损耗推进体二极管；PGD=1 时又把它拉回来。两张表必须成对看，不能只引用“反向电流降低 4.5×”或“总损耗降低 52%”中的一句。

---

## 3 过早关断：封装电感的定量闭环

### 3.1 触发点与电压分解（PGD=0、23 ns、步长 2 ns）

- 触发：t=19.834 µs，I=−29.69 A，V(d1)=+10.5 mV，VGS=10.892 V。
- I·Rds = −29.69 × 0.8956 mΩ = **−26.59 mV**。
- 电感项 = 10.5 − (−26.59) = **+37.09 mV**；(Ld+Ls)=1.1 nH → di/dt=**33.7 A/µs**。
- 波形独立差分（19.82–19.84 µs）：I 从 −30.17 到 −29.50 A，di/dt=**33.5 A/µs**。闭合误差 <1%。
- 若只有电阻项，10.5 mV 应在 I=11.7 A 才出现；电感项把它提前到 29.7 A。
- 触发取**第一次锁存关断**的 +10.5 mV 上穿（19.834 µs）；栅极下降过程中 19.867 µs 还有一次 +10.5 mV 上穿（I=−28.56 A，VGS=7.87 V），那是关断沿本身，不是比较器锁存点。用后者会得到 32.8 A/µs，与 33.5 A/µs 的局部差分不符。

### 3.2 关断尾与代价

- 1 V 栅极交点：19.951 µs，I=**−25.45 A**，V(d1)=−702 mV（体二极管已在导通）。
- 电流过零：20.500 µs。尾时长 **549 ns**。
- EBD 分解（同为 17–22 µs 窗口）：
  - 开通死区 18.0–18.3 µs：**0.695 µJ**（SR 开通前体二极管先导，属于固有开销）；
  - 关断尾（gate<1 V）19.95–20.5 µs：**5.014 µJ**（过早关断造成）；
  - 过零后 20.5–22.0 µs：**0.143 µJ**（对应 IREV 峰值 2.171 A 的反向恢复/充电电流，d1 被钳到 +4–5 V；积分器定义会算进去，不是正向体二极管尾）。
  - 合计 5.851 µJ。
- **定义边界**：体二极管在 19.918 µs（V(d1) 越过 −0.5 V，I=−26.71 A，VGS≈2.27 V）就已开始导通，比 gate=1 V 早 33 ns；从该点到过零的端电压积分为 **5.593 µJ**。所以 5.014 是 gate<1 V 的下界，5.593 是“从首次二极管导通算起”的端电压读数；两者都含 L·di/dt 的无功部分，不是纯管芯二极管耗散。诚实的范围是 **5.0–5.6 µJ/事件**。
- 反事实：同一 549 ns 若沟道保持导通，∫I²Rds dt 的实测积分是 **0.113 µJ**（线性三角估算 0.106；衰减在过零附近是凸的，均值 I²=230.8 A² 而非 I0²/3=215.9 A²）。
- 代价：5.014 − 0.113 = **4.90 µJ/事件**（用 5.593 则 5.48）；200 kHz 下 **0.98 W/SR**（用 5.593 则 1.10 W），两路约 1.96–2.20 W。相对 2 V/100 A=200 W 输出，这是 **~1.0–1.1% 的效率项**，且集中在一次换流事件上。

### 3.3 PGD=1 的相位变化

- 触发：20.368 µs，I=**−6.61 A**，V(d1)=+10.5 mV，VGS=**2.601 V**（PGD 律已到 2.6 V 箝位）。
- 1 V 栅极交点：20.426 µs，I=**−3.71 A**，V(d1)=−617 mV；尾到 20.5 µs，能量 **0.085 µJ**。
- 开通死区仍是 **0.693 µJ**（与 PGD 无关）；过零后 0.141 µJ；合计 0.919 µJ。
- 同一“首次二极管导通”口径下 PGD=1 的尾是 **0.154 µJ**（比 gate<1 V 的 0.085 高 82%，但仍远小于 PGD=0 的 5.59 µJ），结论不变。
- 也就是说：PGD=1 把“关断尾”几乎消掉，但**开通死区的 0.69 µJ 不动**；剩下的体二极管损耗主要来自开通死区，而不是关断。要再降，得缩短 155 ns 开通延迟或提高开通边沿，而不是继续压关断阈值。注意 0.69 µJ 只是“与 TON=155 ns 一致”，没有做 TON 扫描；PGD1/200n 的开通死区升到 0.975 µJ（仲裁把开通推迟 34 ns），说明它不是普适常数。

### 3.4 阈值能从“可接受损耗”推出来吗

以“关断尾 ≤0.5 µJ”为例（不是手册限值，是设计目标）。台架是 40 A/200 kHz 正弦，过零斜率实测 **50.2 A/µs**（解析 2π·200k·40=50.27）；尾段 25.45 A→0 的平均斜率约 46 A/µs。下面的估算用 50.2 A/µs；旧稿用 44 A/µs 会低估约 10–14%。

- Vf≈0.7 V，尾能量 ≈0.5·Vf·I₀²/(di/dt)。令其 ≤0.5 µJ → I₀≤**8.5 A**（用 46 A/µs 则约 8.1 A）。
- 端电压在 I₀=8.5 A 时为：−8.5×0.8956 mV + 1.1 nH×50.2 A/µs = −7.6 + 55.2 = **+47.6 mV**（用 46 A/µs 约 +43.5 mV）。
- 模型固定 OFFTH=10.5 mV；基础窗口 2–18 mV 的顶端 18 mV。**基础阈值本身不够。**
- UCC24624 的 VSS 330 µA 偏置把有效门槛抬到 10.5 mV+330 µA×Roffset。已做成行为等效并实跑（§8）：43.50/50.10/60.00/80.46 mV 与公式逐位吻合；PGD=0 时 **120 Ω 最好**（总 3.712 µJ、EBD 0.820 µJ、QREV 48.6 nC、关断尾 0），100 Ω 次之（3.989 µJ、0.995 µJ、68.3 nC、0.161 µJ），150 Ω 反弹（5.228 µJ、1.771 µJ、1.20 µC），212 Ω/PGD=0 完全不关断（40 A、63.7 µC）。**100–120 Ω 只在 40 A 台架可用，不是手册上限 212 Ω，也不能当 10–40 A 的单一值。** 10/25/40 A 负载扫描（§9）显示轻载 VDS 峰值只有 16.47/41.17 mV，达不到 50.10 mV，SR 整周期不关断（QREV 15.9/39.8 µC）；低门槛扫描（§10）进一步给出最优值随负载移动（10 A→0 Ω、25 A→50 Ω、40 A→120 Ω），0 Ω 虽可全负载关断但 40 A 收益几乎归零。总 EBD 的 ~0.82 µJ 下限里约 0.69 µJ 是关断前 gate<1 段，Roffset 压不掉；50 mV 已接近 40 A 过零电感项 55 mV，轻载/低 di/dt 下必然越过。**在本台架内**固定 Roffset 不足以覆盖全负载；是否改用负载相关门槛、更低 Roffset 或 Kelvin+自适应延迟，须先由双 SR 真实换流台决定，不能由本台关闭 0 Ω 基线。
- Kelvin 源只去掉 Ls（0.8 nH），剩 Ld=0.3 nH → 0.3 nH×50.2 A/µs=15.1 mV；同 10.5 mV 阈值下触发点降到 I≈5.1 A，尾能量估算 **~0.18 µJ**（约 28× 降低）。但现有“触发→1 V 栅极”延迟 58–117 ns，在 50.2 A/µs 下会走 2.9–5.9 A，5 A 触发在两端都会过零，产生反向导通。**阈值必须和延迟联合设计**；单改 Kelvin 不自动成立。
- 这条推导只覆盖损耗，不覆盖 SOA：本台 VDS_MAX=5.0 V（4 V 钳位+二极管），体二极管 25 A，栅极 10.9 V，均在 40 V/285 A/±20 V 内，**没有打到 SOA**；48 V 整机的 SR 关断应力要另行核。

### 3.5 驱动器速度是单向偏差（必须写进限制）

- 本台关断不是“1.5 A 限流”：`Bdrive` 的关断分支是 **3.1 Ω**、+4 A 钳位（10.9 V 时约 3.5 A），−1.5 A 钳位是开通分支（审核 A7）。栅极总电容约 6.7 nF（时序模型替身）+5.1 nF（器件 Cgs）≈11.8 nF；RC 时间常数 36.6 ns，10.9→1 V 约 2.4τ≈88 ns，实测 94 ns。器件栅极电流峰值 1.475 A（6.7 nF 替身分走约 57%）。
- 触发→1 V 实测 117 ns（PGD=0）/58 ns（PGD=1）。UCC24624 的关断延迟是 **23 ns**（手册 p7，模型 TOFF 与之一致），门驱 tf 35 ns typ @6.8 nF（审核行 12）；真实器件 Ciss≈4.6 nF 时门压下降约 20–35 ns，总触发→沟道关断约 **45–60 ns**，而不是本台的 117 ns。按 33.7 A/µs（触发点斜率）外推，handoff 电流约 **27–28 A**，尾能量按 I₀² 约 **6–6.5 µJ**，比本台的 5.0 µJ **更大**。
- 注意：`task1_verification.md` 里的 td(on)/tr/td(off)/tf=7/5/29/8 ns 是 **MOSFET 漏极电流**的开关时间（Table 5），不是控制器门压边沿，也没有进模型；不能把它直接当成 8 ns 的门压下降。上述 6–6.5 µJ 是带假设的外推（触发电流 29.7 A、di/dt、Vf 不变），不是仿真结果。
- 所以 **5.0 µJ 是“慢驱动器”下的下界，不是上界**；真实芯片的快速关断会让过早关断的代价更重。反过来，开通死区的 0.69 µJ 只是“与 155 ns 的 TON 一致”，没有做 TON 扫描；PGD1/200n 的开通死区升到 0.975 µJ，是仲裁把开通推迟 34 ns 造成的，说明它不是普适常数。

---

## 4 与 v2 台的关系（避免混用）

- v2 理想台的数字要拆开引用：`sim/v2/sr_commutation_sweep.cir`（`sr_timing_v2.lib`）的 23 ns/PGD=0 反向峰值是 **9.790 A**，但该台没有 QREV 测量，也没有 200 ns 步。**18.085 A** 来自另一个 200 ns 负对照台 `sr_slow_off_negative.log`；**0.465%** 是 1/2 ns 扫描的反向峰值差。这些是**不同 v2 台**的数字，不能拼成“同一组 v2 结果”；它们只用于说明“v2 理想替身”的量级，不是 v3 器件结果。
- 本报告的“理想开关对照台”用 **v3 时序模型**，23 ns/PGD=0 给 **9.819 A / 977.3 nC**，200 ns 给 **18.17 A / 3478 nC**，1/2 ns 最大差 0.95%（IREV）/1.44%（EBD）。反向峰值与 v2 sweep 的 9.790 A 相差 0.3%，说明 v2→v3 时序模型对反向峰值影响很小；QREV 977.3 nC 是 v3 对照台自己的值，v2 台没有对应测量，不能做“978 vs 977”的比较。器件 vs 理想对照（0.221×/0.071×）才是主因。
- 因此：**9.790 A / 0.978 µC / 18.085 A / 0.465% 这组数字只能标“v2 理想台”，不能标“v3 器件”。** v3 器件的对应 headline 是 2.171 A / 69.06 nC / 4.254 A / 1.44%。

---

## 5 限制与未做（按重要性排序）

1. **数值完成 ≠ 硬件验证。** 没有硅片、没有双脉冲实测、没有热像/热电偶；所有“能量/功率”是模型积分，不是量热结果。
2. **台架是 4 V 钳位、40 A 强制正弦**，不是 48 V→2 V 整机；SR 的关断电压应力只有 5 V，SOA 未受考验；真实 LLC 的 SR 电流波形、di/dt、死区与台架不同。
3. **PGD 律未校准。** 4.133 V@40 A、2.6 V 箝位、80 V/V 斜率、35 mV 偏置都是行为拟合；PGD=1 的“总损耗更低”不能当选型依据。
4. **封装寄生是 ESTIMATE。** LD=0.3 nH、LS=0.8 nH、LG=2.5 nH 来自封装量级估计，不是本板实测；过早关断的结论强依赖 LS。Kelvin 变体存在（`SR_DEVICE_KELVIN`，LK=0.4 nH），但时序模型只有一个 S 检测脚，单路 Kelvin 会让另一路仍按封装源检测，结果不对称；**本次没有跑**，只给了估算。按 50.2 A/µs 修正后的估算是触发 ~5 A、尾 ~0.18 µJ、~28×，不是旧稿的 3 A/0.07 µJ/70×。
5. **时序模型是固定 TON=155 ns、TOFF=23 ns**；没有实现自适应 155/275 ns、1.4–1.7 V ARM 窗口、2–18 mV OFFTH 窗口的逐点标定。冻结的 v3 时序模型仍不含 VSS 330 µA 源（审核 A1）；`sr_timing_v3_roff.lib` 用浮置 330 µA+Roff 回路把检测节点 sv 抬高，是**行为等效，不是 VSS 引脚模型**（没有引脚阻抗、合规电压、260–400 µA 容差）。6.7 nF 栅极替身保留；关断分支是 3.1 Ω RC（约 3.5 A），不是 1.5 A 限流。手册 td(on)/tr/td(off)/tf=7/5/29/8 ns 是 MOSFET 漏极电流的开关时间，不是控制器门压边沿，也没有进模型。§3.5 已说明这使关断尾偏小。
6. **EBD 定义**只计栅极 <1 V 时的正向体二极管导通；不含反向恢复耗散，也不含栅极 **1 V–约 2.3 V** 之间沟道/二极管共同导通的段（体二极管从 19.918 µs、V(d1)<−0.5 V 起已导通，这段约 0.58 µJ）。所以 5.014 µJ 是 gate<1 V 的下界，完整端电压读数约 5.593 µJ；两者都含 L·di/dt 的无功部分，不是纯管芯耗散。过零后的 0.143 µJ 是反向恢复/充电电流（峰值 2.171 A）被积分器计入，不是正向体二极管尾，读表时要按 §3.2 剔除。Roffset 台沿用同一分解：PGD=0 的 1 µΩ/100/120 Ω 分别是 0.695+5.009+0.143、0.692+0.161+0.142、0.690+0.000+0.131 µJ，说明 Roffset 只压“关断尾”，压不动约 0.69 µJ 的关断前段。
7. **理想开关对照台的门耗为 0**（无栅荷），所以“合计”列不能跨台直接比；要比就比 EBD+ECH，门耗单列。
8. **没有温度、自热、Qrr 温度依赖、SOA 退额**；TJ=25 °C。
9. 没有做四组之间的相互影响（本台只有一组 SR 对）；四组冻结时仍需整机联合仿真。
10. **Roffset 结论的行为等效边界。** 330 µA 源、Roffv 与 sv 节点是等效电路；真实芯片的 VSS 引脚经封装/PCB 阻抗返回，偏置电流的合规电压和 260–400 µA 容差未建模。212 Ω/PGD=0 “不关断”是 40 A 台架结果，不是硅片断言；150 Ω/PGD=0 的关断前段升到 1.727 µJ，说明该段还受上一周期相位/再武装影响，不是常数。PGD 与 Roffset 都改触发相位，本台 PGD=1/120 Ω 的 3.645 µJ 不能当校准后的联合最优。ROFF=1 µΩ 复现冻结 v3 的 5.851 µJ/69.06 nC 到 4 位，只证明等效回路在零偏置时中性。**以上均不构成“固定 Roffset 已排除”；0 Ω Kelvin 基线仍是默认候选，Roffset 仅保留调试焊盘。**

---

## 6 复现

```bash
cd D:/workshop/design_48v-2v
rm -f sim/v2/comm_v3/sr_commutation_v3.log sim/v2/comm_v3/sr_commutation_v3.raw
timeout 180 "D:/ADI/LTspice/LTspice.exe" -b sim/v2/comm_v3/sr_commutation_v3.cir
grep -c "Total elapsed time" sim/v2/comm_v3/sr_commutation_v3.log   # 1
grep -c "Measurement:" sim/v2/comm_v3/sr_commutation_v3.log          # 57
grep -E "^(Error|Fatal|Analysis failed|Time step too small)" sim/v2/comm_v3/sr_commutation_v3.log  # 空

rm -f sim/v2/comm_v3/sr_commutation_v3_ideal.log sim/v2/comm_v3/sr_commutation_v3_ideal.raw
timeout 180 "D:/ADI/LTspice/LTspice.exe" -b sim/v2/comm_v3/sr_commutation_v3_ideal.cir
# 同样检查：1 行 Total elapsed time、57 个 Measurement、无错误行

rm -f sim/v2/comm_v3/sr_commutation_v3_roff.log sim/v2/comm_v3/sr_commutation_v3_roff.raw
timeout 180 "D:/ADI/LTspice/LTspice.exe" -b sim/v2/comm_v3/sr_commutation_v3_roff.cir
grep -c "Total elapsed time" sim/v2/comm_v3/sr_commutation_v3_roff.log   # 1
grep -c "Measurement:" sim/v2/comm_v3/sr_commutation_v3_roff.log          # 57
grep -c "^\.step" sim/v2/comm_v3/sr_commutation_v3_roff.log               # 10（5 Roffset × PGD 0/1）
grep -E "^(Error|Fatal|Analysis failed|Time step too small)" sim/v2/comm_v3/sr_commutation_v3_roff.log  # 空
```

关键 `.meas`：`irev_cyc`、`qrev_cyc`、`ebd_cyc`、`ech_cyc`、`ege_cyc`、`rds_19`、`vgs_19`、`vds_min_cyc`、`gate_overlap_cyc`。旧窗口 `*_c`（15–20 µs）保留作边界核对。

§3 的触发点、1 V 栅极交点、尾能量**不是** `.meas` 直接给出的，而是从 `.raw` 波形复算的。用仓库里的探针脚本核对：

```bash
python -c "from tools.comm_v3_probe import Case; c=Case(0); print(c.at('I(Vsa)',19.834399e-6), c.at('V(d1)',19.834399e-6))"
# 期望 ≈ -29.69 A, +0.0105 V（case 0 = 步 1 PGD=0/23n/2n）
python -c "from tools.comm_v3_probe import Case; c=Case(0); print(c.integral('V(d1)','I(Vsa)',19.951204e-6,20.499991e-6))"
# 期望 ≈ -5.009e-6 J（gate<1 V 尾，取绝对值 5.01 uJ）
```

Roffset 台用同一个探针，传入第二个参数：

```bash
python -c "from tools.comm_v3_probe import Case; c=Case(2,'sim/v2/comm_v3/sr_commutation_v3_roff.raw'); print(c.at('V(d1,sv)',20.395e-6), c.max_between('I(Vsa)',17e-6,22e-6))"
# case 2 = 步 3（PGD=0, ROFF=120）→ 期望 ≈ +0.0501 V 门槛、IREV ≈ +0.66 A 附近
```

`Case(i)` 的 i 是 `.step` 执行顺序（0→步 1），不是日志里的 step 列；先用 `V(gda)` 最大值区分 PGD=0（≈10.9 V）和 PGD=1（≈5.58 V）。Roffset 台的顺序是 **ROFF 内层、PGD 外层**：case 0–4 = PGD0 的 1u/100/120/150/212 Ω，case 5–9 = PGD1 的同序列。

---

## 7 对后续任务的影响

- **任务 3（SR 偏置时序）**：不能再假设 SR 在电流过零时关断。PGD=0 时它在 25.5 A 就交给体二极管；偏置释放/预充电的时序必须按“换流尾 0.55 µs、体二极管先导”设计。200 ns 负对照说明延迟的代价与触发相位耦合，不能用一个固定延迟覆盖所有工况。
- **四组冻结**：本报告的 5.0 µJ 关断尾是**慢驱动器下的下界**（真实 tf 更短会更差），0.69 µJ 开通死区受 155 ns TON 主导；两者方向相反，冻结前必须用校准后的驱动边沿重跑。
- **PGD 选型**：在 PGD 律校准前，只能用“0.8956 vs 1.1931 mΩ @40 A”证明机理，不能用“4.45 vs 9.36 µJ”选芯片。
- **下一步最有价值的实验（按性价比排序）**：
  - (a) **已完成，但结果否定了固定值方案**：`sr_timing_v3_roff.lib` 的行为等效实跑 0/100/120/150/212 Ω，门槛逐位吻合 §3.4；PGD=0 的 120 Ω 在 40 A 下把总损耗从 9.362 降到 3.712 µJ/周期。**但 212 Ω/PGD=0 不关断、150 Ω 已反弹**；随后的 10/25/40 A 负载扫描（§9）又显示 **100/120 Ω 在 10/25 A 下完全不关断**（VDS 峰值 16.47/41.17 mV < 43.5/50.1 mV，QREV 15.9/39.8 µC）。**低门槛扫描（§10）已完成**：最优值 10 A→0 Ω、25 A→50 Ω、40 A→120 Ω；0 Ω（即无偏置基线）在全负载可关断，但 40 A 为 9.521 µJ，相对 2 ns 基线 9.362 多 1.7%（步长效应），没有收益。**固定 Roffset 不能同时满足两端**，下一步是双 SR 换流台、DCX 实际 `di/dt` 与 330 µA 容差，而不是继续调电阻。见 §8–§10。
  - (b) 用双实例时序模型 + `SR_DEVICE_KELVIN` 跑单路 Kelvin，验证 ~5 A/~0.18 µJ 估算和延迟耦合；本台仍未跑。
  - (c) 做驱动器边沿扫描（或把 UCC24624 的 23 ns td + 35 ns tf 接进驱动），重出关断尾的上界；不要再用 MOSFET 的 8 ns tf 当门压边沿。
  - (d) 校准 PGD 律并实现自适应 155/275 ns、1.4–1.7 V ARM 窗口；本报告的 PGD=1 只是相位敏感性示例。
  - (e) 温度/Qrr 温度依赖/SOA 退额，以及四组联合仿真；这些直接改变四组冻结的损耗预算。

---

## 8 追加实验：Roffset 扫描（2026-10-31）

### 8.1 目的、模型与台架

§3.4 只给出了“有效门槛 = 10.5 mV + 330 µA×Roffset”的设计推导，审核 A1 指出冻结的 v3 时序模型没有 330 µA 源。本节把该偏置做成**行为等效**并实跑，回答两个决策问题：Roffset 能否把关断尾压到 0.5 µJ 以下；手册上限 212 Ω 是否是可用的工作点。

- 模型：`models/sr_timing_v3_roff.lib`，是冻结 `sr_timing_v3.lib` 的逐字节副本加参数。每个通道内加浮置回路
  `Roffv sv S {ROFF+1u}`、`Ioff S sv {IOFF}`，于是 `V(sv)=V(S)+330 µA×ROFF`；比较器改用 `V(D,sv)`，栅极回路仍回 S。这样 330 µA 只流过 Roffv，不会让安培级栅极电流穿过 Roffset。`ROFF=1 µΩ` 是零偏置基线（0.33 nV）。
- 台架：`sim/v2/comm_v3/sr_commutation_v3_roff.cir`，激励、器件、17–22 µs 窗口与 `sr_commutation_v3.cir` 相同；只换时序模型。`.step param ROFF list 1u 100 120 150 212` 为内层，`.step param PGD list 0 1` 为外层，共 10 场，`TMAX=2n`，`tran 0 22u`。
- 规模：57 个 `.meas` × 10 场，`Total elapsed time` 约 3.8 s（2026-10-31 重跑 3.800 s；运行时间随负载变化），日志无 `Error`/`Fatal`/`Time step too small`/`Analysis failed`。
- 中性校验：`ROFF=1u` 复现冻结 v3 的 PGD0（QREV 69.06 nC、EBD 5.851 µJ、ECH 2.894 µJ、EGE 0.617 µJ、Rds 0.8956 mΩ）与 PGD1（67.25 nC、0.920 µJ、3.349 µJ、0.183 µJ、1.1931 mΩ）到 4 位。

### 8.2 门槛律逐位吻合

实测触发点（第一次在栅极仍开启时上穿有效门槛）与公式对比：

| Roffset | 公式 OFFTH | 实测触发 V(d1) | 触发时刻 | 触发电流 |
|---:|---:|---:|---:|---:|
| 1 µΩ | 10.50 mV | 10.50 mV | 19.835 µs | −29.69 A |
| 100 Ω | 43.50 mV | 43.50 mV | 20.282 µs | −10.82 A |
| 120 Ω | 50.10 mV | 50.10 mV | 20.396 µs | −5.21 A |
| 150 Ω | 60.00 mV | 60.00 mV | 20.619 µs | +5.96 A |
| 212 Ω | 80.46 mV | 80.46 mV | 未触发 | — |

（PGD=0；PGD=1 的触发时刻随 Roffset 改变：1 µΩ 晚 0.53 µs，100/120 Ω 晚 0.18/0.09 µs，150 Ω 反而早 0.11 µs，见下表。）五项与 `10.5 mV + 330 µA×Roffset` 逐位一致，说明等效回路按预期工作；这不是芯片 VSS 引脚的验证。

### 8.3 全表

时间/电流（PGD=0 为决策组，PGD=1 为未校准敏感性组）：

| 步 | PGD | Roff Ω | OFFTH mV | t_trig µs | I_trig A | t_g1 µs | IREV A | QREV nC |
|---:|---:|---:|---:|---:|---:|---:|---:|---:|
| 1 | 0 | 1 µ | 10.50 | 19.835 | −29.69 | 19.951 | 2.171 | 69.06 |
| 2 | 0 | 100 | 43.50 | 20.282 | −10.82 | 20.399 | 2.158 | 68.27 |
| 3 | 0 | 120 | 50.10 | 20.396 | −5.21 | 20.514 | 1.748 | 48.59 |
| 4 | 0 | 150 | 60.00 | 20.619 | +5.96 | 20.741 | 10.53 | 1199.3 |
| 5 | 0 | 212 | 80.46 | 未触发 | — | — | 40.00 | 63662 |
| 6 | 1 | 1 µ | 10.50 | 20.368 | −6.60 | 20.427 | 2.128 | 67.25 |
| 7 | 1 | 100 | 43.50 | 20.465 | −1.75 | 20.530 | 1.629 | 43.41 |
| 8 | 1 | 120 | 50.10 | 20.485 | −0.76 | 20.546 | 1.880 | 54.64 |
| 9 | 1 | 150 | 60.00 | 20.514 | +0.72 | 20.578 | 2.834 | 108.64 |
| 10 | 1 | 212 | 80.46 | 20.578 | +3.89 | 20.640 | 5.740 | 357.10 |

能量（µJ/周期；E_dead 是 17–19.5 µs 内栅极 <1 V 的开通死区/关断前段，E_tail 是 1 V 栅极交点到 20.5 µs 零点，E_post 是零点后到 22 µs；EBD=E_dead+E_tail+E_post，与日志 `.meas` 的差 <0.01 µJ 来自积分窗口）：

| 步 | PGD | Roff Ω | E_dead | E_tail | E_post | EBD | ECH | EGE | Etot |
|---:|---:|---:|---:|---:|---:|---:|---:|---:|---:|
| 1 | 0 | 1 µ | 0.695 | 5.009 | 0.143 | 5.851 | 2.894 | 0.617 | 9.362 |
| 2 | 0 | 100 | 0.692 | 0.161 | 0.142 | 0.995 | 2.376 | 0.618 | 3.989 |
| 3 | 0 | 120 | 0.690 | 0.000 | 0.131 | 0.820 | 2.271 | 0.621 | 3.712 |
| 4 | 0 | 150 | 1.727 | 0.000 | 0.043 | 1.771 | 2.833 | 0.624 | 5.228 |
| 5 | 0 | 212 | 0.000 | 0.000 | 0.000 | 0.000 | 4.204 | 0.009 | 4.213 |
| 6 | 1 | 1 µ | 0.695 | 0.084 | 0.141 | 0.920 | 3.349 | 0.183 | 4.452 |
| 7 | 1 | 100 | 0.693 | 0.000 | 0.088 | 0.782 | 2.518 | 0.368 | 3.668 |
| 8 | 1 | 120 | 0.691 | 0.000 | 0.041 | 0.732 | 2.498 | 0.414 | 3.644 |
| 9 | 1 | 150 | 0.728 | 0.000 | 0.051 | 0.778 | 2.466 | 0.490 | 3.734 |
| 10 | 1 | 212 | 1.275 | 0.000 | 0.030 | 1.305 | 2.511 | 0.645 | 4.461 |

### 8.4 结论

1. **PGD=0 在 40 A 下的可用最优是 120 Ω。** 关断尾 5.009→0 µJ，总损耗 9.362→3.712 µJ/周期（−60%），EBD 5.851→0.820，QREV 69.1→48.6 nC，IREV 2.171→1.748 A。100 Ω 次之：尾 0.161 µJ、总 3.989、QREV 68.3 nC；若更看重反向电荷，100 Ω 与 120 Ω 都在同一量级。
2. **150 Ω 已反弹，212 Ω/PGD=0 完全不关断。** 150 Ω 触发时电流已过零（+5.96 A），IREV 10.53 A、QREV 1.20 µC、总 5.228 µJ；212 Ω 的 80.46 mV 在 40 A 台架里根本达不到，SR 整周期保持导通，IREV=40 A、QREV=63.7 µC。其 Etot 4.213 µJ 看似低于基线，但这是“沟道一直导通、没有关断事件”的数字，功能上不可接受——**总损耗不能单独作为关断策略的安全指标。**
3. **212 Ω 失败的机理是门槛与可用端电压的比较。** 过零附近端电压由 `L·di/dt` 主导：40 A/200 kHz 下 `(Ld+Ls)·di/dt≈55 mV`，再减去 `I·Rds`；80.46 mV 高于该窗口内可达的峰值，所以比较器永不翻转。60 mV 档（150 Ω）在过零后靠反向电流的 `I·Rds` 才达到 60 mV，因此晚关断、QREV 大。**手册的 <70 mV/<212 Ω 是 VSS 偏置的绝对上限，不是 40 A 工作点。**
4. **Roffset 只压关断尾，压不动 ~0.69 µJ 的关断前段。** 120 Ω 的 EBD 仍有 0.820：0.690（开通死区/关断前）+0.131（过零后反向充电）。要再降 EBD，得缩短 155 ns 开通延迟或改检测点；继续加 Roffset 会先遇到 150/212 Ω 的失效。0.5 µJ 是“关断尾”目标，不是总 EBD 目标。
5. **PGD=1 的联合最优点是 120 Ω（总 3.644 µJ），但这不是选型结论。** PGD=1 把栅压降到 4.1–8.9 V，Rds 升到 0.90–1.19 mΩ，ECH 反而比 PGD=0 高 0.2–0.5 µJ；QREV 最小在 100 Ω（43.4 nC），212 Ω 仍有 357 nC。PGD 律与 Roffset 都改触发相位，必须先校准 PGD 再谈联合优化。
6. **负载依赖已实跑证实（§9–§10）。** 固定 mV 门槛，可用 `L·di/dt` 随负载线性下降：10 A/200 kHz 时 `di/dt≈12.6 A/µs`，电感项仅约 13.8 mV。实测 10/25 A 的终端 VDS 峰值只有 16.47/41.17 mV，低于 50.10 mV，SR 整周期不关断（QREV 15.9/39.8 µC）；40 A 才正常关断。**120 Ω 已确认只在 40 A 附近成立。** §10 的低门槛扫描给出最优值 10 A→0 Ω、25 A→50 Ω、40 A→120 Ω：0 Ω（=无偏置基线）在全负载可关断，但 40 A 一致口径 9.521 µJ，比 2 ns 基线 9.362 多 1.7%（步长效应），没有收益；15 Ω 也全负载触发但 10 A 已坏 11 倍。**在本受迫正弦台 + 估计寄生 + 未校准 PGD 下，固定 Roffset 不能既保轻载功能又保重载收益**；这不足以关闭真实硅片上的 0 Ω Kelvin 基线。决策变量是 `L·di/dt`，下一步需要双 SR 换流台与 DCX 实际 di/dt，并把 330 µA 的 260–400 µA 容差、真实 VSS 引脚阻抗一起算进去。

### 8.5 限制

- 330 µA 源、Roffv、sv 节点是行为等效；没有真实 VSS 引脚阻抗、合规电压、260–400 µA 容差、温度漂移。
- 40 A/200 kHz 强制正弦、4 V 钳位、TJ=25 °C；不是 48 V→2 V 整机，SR 关断应力只有 ~5 V，SOA 未受考验。
- PGD 律未校准；PGD=1 只用于展示相位敏感性，不能据此选芯片。
- 负载扫描见 §9（100/120 Ω）与 §10（0/15/25/50/75/85 Ω）；25 A/120 Ω 数值上未跑完，结论由 25 A/100 Ω 推断。§10 的梯形台是单管受迫台，关断后受迫电流被钳位吸收、且 0 Ω 与 120 Ω 结果几乎相同，**只能作 di/dt 机理提示，不能用于定量或选型**。Kelvin、温度/Qrr 温度依赖、四组联合未做；212 Ω “不关断”和轻载“不关断”都是台架结果，不是硅片断言——数据手册确认无最大开通时间/看门狗，`tONMIN=475 ns` 是最小开通消隐，因此“比较器不翻转就保持导通”是芯片行为；但 `VTHOFF` 的 2/10.5/18 mV spread 与 330 µA 的 260–400 µA 容差未扫。
- 数值完成 ≠ 硬件验证。

### 8.6 复现

```bash
cd D:/workshop/design_48v-2v
rm -f sim/v2/comm_v3/sr_commutation_v3_roff.log sim/v2/comm_v3/sr_commutation_v3_roff.raw
timeout 180 "D:/ADI/LTspice/LTspice.exe" -b sim/v2/comm_v3/sr_commutation_v3_roff.cir
grep -c "Total elapsed time" sim/v2/comm_v3/sr_commutation_v3_roff.log   # 1
grep -c "Measurement:" sim/v2/comm_v3/sr_commutation_v3_roff.log          # 57
grep -c "^\.step" sim/v2/comm_v3/sr_commutation_v3_roff.log               # 10
grep -E "^(Error|Fatal|Analysis failed|Time step too small)" sim/v2/comm_v3/sr_commutation_v3_roff.log  # 空
```

探针（`Case` 的第二个参数选另一份 raw；case 0–4=PGD0，5–9=PGD1，内层是 1µ/100/120/150/212 Ω）：

```bash
python -c "from tools.comm_v3_probe import Case; c=Case(2,'sim/v2/comm_v3/sr_commutation_v3_roff.raw'); print(c.at('V(d1,sv)',20.396e-6))"
# 期望 ≈ +0.0501 V（120 Ω 的有效门槛）
```

产物哈希见 `design/baseline/baseline_manifest.json`（2026-10-31 符号修正后全部重算）。`sr_timing_v3.lib` 在审核后仅改 off-blank 起点注释，现值 `5099df9183b0e060`，网表行未变（与 `sr_timing_v3_roff.lib` 的 diff 只剩注释和 roff 自身新增网络）。

---

## 9 追加实验：Roffset 负载扫描（10/25/40 A，2026-10-31）

### 9.1 目的与做法

§8 的 120 Ω 只在 40 A 台架成立；§8.4 第 6 条预判固定 mV 门槛在轻载会失效。本节实跑 10/25/40 A × 100/120 Ω，PGD=0，`TMAX=10n`。为避开多场次“运行结束才写测量”的问题，改用单案例台（无 `.step`，参数直接写进 `.param`），每个案例独立有界运行。

- 已完成：10/100、10/120、25/100、40/100、40/120；每场 0.18–0.29 s，无 `Error`/`Time step too small`/`Analysis failed`。
- 25/120：在 `TMAX=10/20/50 ns`、30 s 有界超时内均未完成（raw 17–18 MB，求解器步长塌缩）。**这不是物理结果。** 由 25 A/100 Ω 的 `VDS_max=41.17 mV` 低于 43.5/50.1 mV 可推断 25/120 同样不触发（提高门槛不可能产生更低的触发），但这是推断，不是完成场次。
- 40 A 交叉校验：40/100 的 10 ns 结果 QREV 68.50 nC（2 ns 为 68.27）、EBD 1.022 µJ（0.995）；40/120 为 48.50 nC（48.59）、0.824 µJ（0.820）。10 ns 足够看负载趋势，不替代 §8 的 2 ns 头条。

### 9.2 结果

| ILOAD | Roff | VDS_max | VGS_min | 触发? | IREV | QREV | EBD | ECH | EGE | Etot |
|---:|---:|---:|---:|---|---:|---:|---:|---:|---:|---:|
| 10 A | 100 Ω | 16.47 mV | 10.890 V | 否 | 10.000 A | 15.916 µC | ~0 | 0.2628 | 0.00228 | 0.2650 |
| 10 A | 120 Ω | 16.47 mV | 10.890 V | 否 | 10.000 A | 15.916 µC | ~0 | 0.2628 | 0.00228 | 0.2651 |
| 25 A | 100 Ω | 41.17 mV | 10.889 V | 否 | 25.000 A | 39.789 µC | ~0 | 1.6423 | 0.00571 | 1.6480 |
| 25 A | 120 Ω | 41.17 mV* | 10.89 V* | 否* | — | — | — | — | — | — |
| 40 A | 100 Ω | 5.000 V | −0.234 V | 是 | 2.172 A | 68.50 nC | 1.0224 | 2.3856 | 0.6188 | 4.0268 |
| 40 A | 120 Ω | 5.000 V | −0.234 V | 是 | 1.747 A | 48.50 nC | 0.8238 | 2.2714 | 0.6216 | 3.7168 |

能量单位 µJ/周期；带 `*` 的 25/120 行不是完成场次：VDS_max 取自 25/100（同一电流、门槛只改比较器偏置；未触发时主电路波形相同），因此只能作推断。

### 9.3 结论

1. **固定 100/120 Ω 只在 40 A 附近关断。** 10 A 的终端 VDS 峰值 16.47 mV、25 A 为 41.17 mV，均低于 43.5/50.1 mV；VGS 全周期保持 10.89 V，SR 不关断，整周期导通，QREV 15.9/39.8 µC。10/25 A 的 Etot（0.265/1.648 µJ）数值上低于 40 A，但那是“没有关断事件、沟道一直导通”的数字，**不是低损耗工作点，是功能失效**。
2. **40 A 两档与 §8 一致**：120 Ω 总 3.717 µJ、QREV 48.5 nC；100 Ω 总 4.027 µJ、QREV 68.5 nC（10 ns，略高于 2 ns）。
3. **固定 Roffset 不能覆盖 10–40 A。** 可用窗口被 `L·di/dt` 随负载缩小夹住：40 A 时电感项约 55 mV，终端 VDS 能越过 43.5/50.1 mV；25 A 时只剩约 34.6 mV，峰值 41 mV；10 A 时约 13.8 mV，峰值 16.5 mV。Kelvin 只去掉 Ls（0.8 nH），把 40 A 的提前触发降到约 5 A，但不改变“固定门槛 vs 变 di/dt”的矛盾；它仍需与自适应延迟/更低门槛联合。
4. **模型边界：** 本时序模型没有最大导通时间；比较器不翻转时 Q 会一直保持（`Btoff` 只在 `V(D,sv)>OFFTH` 时置位）。数据手册只给出 CH1 平均频率待机判据（<9 kHz 持续 7.5 ms 进 standby、>15.6 kHz 持续 7.5 ms 恢复），本模型未实现；该判据不能推出所有故障状态的硬上限或固定周期。所以本台只回答“比较器何时翻转”，不回答“芯片在轻载如何收场”；**不能由本台断言硅片失效，也不能断言 7.5 ms 后必然进入某个固定周期。** 25/120 的数值超时是求解器问题，不是物理结果。2026-10-31 12:37–12:47 实测确认：`run_decks.py --timeout 600` 对
`sr_load_25_120.cir` 与 6 档 `sr_commutation_v3_roff_load.cir` 均返回 **TIMEOUT**（600.03 / 600.02 s，raw 约 100 MB），
与上述判断一致，原始记录在 `design/baseline/deck_runs_extra.json`。
5. **下一步优先级：** 数据手册已确认无每通道最大开通时间/看门狗（`tONMIN=475 ns` 是最小开通消隐），轻载只靠 `VTHOFF` 比较器加上述频率待机判据；§10 已补做 0/15/25/50/75/85 Ω 扫描，结论是最优门槛随负载移动（10 A→0 Ω、25 A→50 Ω、40 A→120 Ω），0 Ω（=无偏置基线）在 40 A 没有 Roffset 收益。**固定 120 Ω 不能作为四组冻结的单一值。** 下一步是双 SR 换流台与 DCX 实际 `di/dt`，再谈负载相关门槛或 Kelvin + 自适应延迟。

### 9.4 复现

```bash
cd D:/workshop/design_48v-2v
for f in sr_load_10_100 sr_load_10_120 sr_load_25_100 sr_load_40_100 sr_load_40_120; do
  rm -f sim/v2/comm_v3/$f.log sim/v2/comm_v3/$f.raw
  timeout 30 "D:/ADI/LTspice/LTspice.exe" -b sim/v2/comm_v3/$f.cir
  grep -E "Total elapsed|irev_cyc|qrev_cyc|ebd_cyc|ech_cyc|ege_cyc|vgs_min_cyc|vds_max_cyc" sim/v2/comm_v3/$f.log
done
```

产物哈希（前 16 位）：

| 文件 | sha256 前缀 |
|---|---|
| `sr_load_10_100.cir` | `c760e3a389e491f9` |
| `sr_load_10_100.log` | `5386c76fd5599008` |
| `sr_load_10_120.cir` | `fdf843529b797129` |
| `sr_load_10_120.log` | `01d54d9fe2dbe037` |
| `sr_load_25_100.cir` | `46f0a902416dc18b` |
| `sr_load_25_100.log` | `f6b0e73fb78ec907` |
| `sr_load_40_100.cir` | `d9d98480296d92b2` |
| `sr_load_40_100.log` | `18e6bebd6302ea61` |
| `sr_load_40_120.cir` | `f8af25c286c5f07e` |
| `sr_load_40_120.log` | `5b117f8c9d63d29d` |
| `sr_load_25_120.cir`（未完成） | `5bbc3188fe2dd983` |
| `sr_commutation_v3_roff_load.cir`（6 场扫描定义） | `3bc6c4a064acd12f` |

## 10 追加实验：轻载门槛扫描与 di/dt 机理探针（2026-10-31）

### 10.1 目的

§9 只测了 100/120 Ω，结论是“10/25 A 不关断”。本节回答两个决策问题：

1. **更低 Roffset 能否在轻载关断，同时不毁掉 40 A 的关断尾？** 扫 0/25/50/75/85 Ω × 10/25/40 A。
2. **失败到底是“负载”问题还是“di/dt”问题？** 正弦台的 `di/dt=2πfI` 随负载线性变化。用固定周期、固定过渡时间的梯形电流把两者解耦，做机理探针。注意本机是 LLC（UCC25600、Lr≈0.92–1 µH），实际 di/dt 仍由谐振电流斜率决定、随负载变化，见 10.5。

### 10.2 台架

- 正弦台：同 §9 的单案例台，`TMAX=10n`，PGD=0，17–22 µs 干净窗口；`ILOAD` 10/25/40 A，`ROFF` 0/25/50（40 A 另加 100/120 来自 §9），边界点 10/15、25/75、25/85。共 12 个新场次，每场 0.18–0.43 s（实测 0.183–0.428 s），无 `Error`/`Time step too small`/`Analysis failed`。
- 梯形台：`sr_tr_*.cir`，5 µs 周期、过渡时间 `TR`（0.4 µs 或 1.6 µs）、峰值 ±ILOAD；`di/dt=2·ILOAD/TR`，与负载幅值解耦。5 场，仅作机理探针（限制见 10.5）。

### 10.3 正弦台结果（PGD=0，µJ/周期）

**Etot 统一口径 = EBD + ECH + EGE（含门耗），与 §2/§8 的 9.362 µJ 基线一致。** 初版本表对新跑的 12 场漏加了 EGE（约 0.62 µJ），导致 40 A/0 Ω 被记成 8.903 µJ；下表的 9.521 µJ 是修正值。

| ILOAD | Roff | OFFTH | 触发 | IREV | QREV | EBD | ECH | EGE | Etot |
|---:|---:|---:|---|---:|---:|---:|---:|---:|---:|
| 10 A | 0 Ω | 10.5 mV | 是 | 0.921 A | 42.51 nC | 0.357 | 0.214 | 0.617 | 1.188 |
| 10 A | 15 Ω | 15.5 mV | 是（坏） | 3.315 A | 476.5 nC | 0.558 | 0.350 | 0.625 | 1.533 |
| 10 A | 25 Ω | 18.8 mV | 否 | 10.000 A | 15.916 µC | ~0 | 0.263 | 0.0023 | 0.265 |
| 10 A | 50 Ω | 27.0 mV | 否 | 10.000 A | 15.916 µC | ~0 | 0.263 | 0.0023 | 0.265 |
| 10 A | 100 Ω | 43.5 mV | 否 | 10.000 A | 15.916 µC | ~0 | 0.263 | 0.0023 | 0.265 |
| 10 A | 120 Ω | 50.1 mV | 否 | 10.000 A | 15.916 µC | ~0 | 0.263 | 0.0023 | 0.265 |
| 25 A | 0 Ω | 10.5 mV | 是 | 1.585 A | 56.22 nC | 2.860 | 1.254 | 0.617 | 4.731 |
| 25 A | 25 Ω | 18.8 mV | 是 | 1.600 A | 56.17 nC | 1.513 | 1.137 | 0.617 | 3.267 |
| 25 A | 50 Ω | 27.0 mV | 是 | 1.575 A | 55.93 nC | 0.688 | 1.008 | 0.618 | 2.314 |
| 25 A | 75 Ω | 35.3 mV | 是（坏） | 3.827 A | 263.9 nC | 0.526 | 1.090 | 0.625 | 2.241 |
| 25 A | 85 Ω | 38.6 mV | 是（坏） | 8.121 A | 1.130 µC | 1.407 | 1.325 | 0.622 | 3.354 |
| 25 A | 100 Ω | 43.5 mV | 否 | 25.000 A | 39.789 µC | ~0 | 1.642 | 0.0057 | 1.648 |
| 40 A | 0 Ω | 10.5 mV | 是 | 2.197 A | 69.26 nC | 5.999 | 2.904 | 0.618 | **9.521** |
| 40 A | 25 Ω | 18.8 mV | 是 | 2.196 A | 69.27 nC | 4.342 | 2.792 | 0.618 | 7.752 |
| 40 A | 50 Ω | 27.0 mV | 是 | 2.197 A | 69.21 nC | 2.739 | 2.647 | 0.618 | 6.004 |
| 40 A | 100 Ω | 43.5 mV | 是 | 2.172 A | 68.50 nC | 1.022 | 2.386 | 0.619 | 4.027 |
| 40 A | 120 Ω | 50.1 mV | 是 | 1.747 A | 48.50 nC | 0.824 | 2.271 | 0.622 | 3.717 |

40/100、40/120、10/100、10/120、25/100 来自 §9（同一 10 ns 台架，数值一致）。EGE 在“不触发”场次只有约 2 nJ，是因为门极在整个窗口内不充放电；触发场次约 0.617 µJ，与负载基本无关。**不触发场次的 Etot 低是假象，不能与触发场次比大小。**

### 10.4 结论

1. **最优 Roffset 随负载移动，固定值无解。** 10 A 的最优点是 0 Ω（唯一给出可接受关断的实测点：IREV 0.92 A、QREV 42.5 nC、Etot 1.188）；25 A 的最优点是 50 Ω（Etot 2.314、EBD 0.688）；40 A 的最优点是 120 Ω（Etot 3.717、EBD 0.820）。0→50→120 Ω 与 10→25→40 A 近似同步，说明门槛应与可用 `L·di/dt` 成比例。
2. **10 A 的可用窗口比“能触发”窄得多。** 15 Ω（15.5 mV）名义上触发，但 IREV 3.32 A、QREV 476 nC，比 0 Ω 差约 11 倍——它只是在 VDS 峰值附近勉强翻转，栅极还没拉低电流就进入反向。≥25 Ω（18.8 mV）则完全不触发，QREV 15.9 µC，SR 整周期导通。
3. **25 A 同样存在“能触发但坏触发”的窄带。** 50 Ω 最好；75 Ω 触发时 IREV 已到 3.83 A、QREV 264 nC；85 Ω 为 8.12 A/1.13 µC；≥100 Ω 不触发。只用 Etot 会把 75 Ω 误判为优于 50 Ω（2.241 vs 2.314），必须同时看 IREV/QREV。
4. **40 A 的单调段到 120 Ω 为止，但 0 Ω 没有任何 Roffset 收益。** 0 Ω 就是“无 VSS 偏置”的基线本身（`Roffv=1 µΩ` 时复现冻结 v3 到 4 位），所以它不可能“比基线好 5%”：一致口径下 40 A/0 Ω = **9.521 µJ**，与 2 ns 基线 9.362 的 1.7% 差来自步长/收敛扰动（§9.2 已记 40 A/100 Ω 的 EBD 从 0.995 升到 1.022 µJ），不是偏置的作用。120 Ω 的 3.717 µJ 才是真实收益（−60%）；150 Ω 反弹、212 Ω 不关断（§8）。
5. **“全负载可关断”的固定值不止 0 Ω。** 15 Ω 在 10 A 也触发（但 IREV 3.32 A、QREV 476 nC，已坏约 11 倍），且按单调性在 25/40 A 也会触发（25 Ω 已触发）。0 Ω 是这些值里质量最好的；≥25 Ω 在 10 A 完全不触发。所以固定 Roffset 只能在“轻载功能”与“重载收益”之间二选一，不能两者兼得——但“唯一值”的说法不成立。
6. **数据手册只给出 CH1 平均频率待机判据，不足以做故障应力兜底。** `tONMIN=475 ns` 是最小开通消隐；关断只由 VDS 越过 `VTHOFF` 触发。**手册 §8.3.6 描述的是 CH1 平均开关频率 <9 kHz 持续 7.5 ms 进入 standby、>15.6 kHz 持续 7.5 ms 恢复；它不规定所有故障状态的硬上限或固定周期，当前模型也未实现这些状态。** 因此本台只回答“比较器何时翻转”，不能据此写“不关断最多持续 7.5 ms 后进入约 15 ms 极限环”。轻载的设计缺陷仍然存在（比较器不翻转时沟道保持导通），但具体时间行为必须由实现了待机状态的模型或实测确认。另外 `VTHOFF` 18 mV 是手册上限，16.47 mV 是本台架的峰值；真实 LLC 的峰值必须用自己的 `L·di/dt` 重算（§11），不能把它当硅片断言。
7. **主变量是 di/dt；本 LLC 里 di/dt 又随负载变化，所以固定门槛只在单一负载成立。** 正弦台的 `di/dt=2πfI` 与负载绑定；梯形探针在固定 50 A/µs 下，120 Ω 在 10 A 也能关断（IREV 2.14 A、QREV 64.5 nC），而固定 12.5 A/µs 下 120 Ω 在 10 A 不关断（QREV 17.0 µC）。定性支持“门槛必须与 `L·di/dt` 匹配”。**但梯形场的 0 Ω 与 120 Ω 结果几乎相同（IREV 2.17 vs 2.14），说明该场的关断可能由双通道互锁/受迫电流阶跃耦合决定，而不是 OFFTH 比较器单独决定；能量值不可与正弦台或真实 DCX 比较。**

### 10.5 限制与设计含义

- 梯形台的受迫电流在 SR 关断后被 4 V 钳位吸收（探针：18.04 µs 关断后 `I(Vsa)≈0`、`V(d1)≈5 V`），没有“另一个 SR 接手”，因此 EBD/Etot 不代表真实换流；它只能提示“di/dt 足够大时门槛可达”。
- 真实 DCX 的换流是两管之间的电流交接，需要**双 SR 换流台**（电流在两管间换流、互锁参与）才能定量。单管受迫台无法回答轻载/重载的真实关断点。
- 本机是 LLC：SR 端电压 `VDS=(Ld+Ls)·di/dt − I·Rds`，`di/dt` 是副边谐振电流在关断点的斜率（近过零约 `2πf·I`，随负载变化）；`Ld+Ls=1.1 nH` 只是封装/检测回路电感，不含谐振电感。需要按真实 `Lr`、开关频率和各负载点算出 `di/dt`，再代入门槛律：`OFFTH_opt ≈(0.76–0.91)·(Ld+Ls)·di/dt`（由本节 10/25/40 A 三点反推）。若所需门槛超过 212 Ω 能提供的 80.46 mV，则固定 Roffset 不可行，必须改检测方式/加延迟/选别的控制律。
- Kelvin 只去掉 `Ls=0.8 nH`，不改变“固定门槛 vs 可变 di/dt”的矛盾。
- 数值完成 ≠ 硬件验证；`VTHOFF` 的 2–18 mV spread 与 330 µA 的 260–400 µA 容差已在 §11 做角分析（结论：无固定 Roffset 可覆盖）。

### 10.6 复现与哈希

```bash
cd D:/workshop/design_48v-2v
# 正弦台 12 场（单案例，无 .step）
for f in sr_ls_10_0 sr_ls_10_15 sr_ls_10_25 sr_ls_10_50 \
         sr_ls_25_0 sr_ls_25_25 sr_ls_25_50 sr_ls_25_75 sr_ls_25_85 \
         sr_ls_40_0 sr_ls_40_25 sr_ls_40_50; do
  timeout 30 "D:/ADI/LTspice/LTspice.exe" -b sim/v2/comm_v3/$f.cir
done
# 梯形探针 5 场
for f in sr_tr_40_120_1.6u sr_tr_40_120_0.4u sr_tr_10_120_0.4u \
         sr_tr_10_0_0.4u sr_tr_10_120_1.6u; do
  timeout 30 "D:/ADI/LTspice/LTspice.exe" -b sim/v2/comm_v3/$f.cir
done
```

哈希（sha256 前 16 位）：

| 文件 | 前缀 | 文件 | 前缀 |
|---|---|---|---|
| `sr_ls_10_0.cir/log` | `3fba90df3b8c4042` / `d95e6ad06efe4467` | `sr_ls_10_15.cir/log` | `5ba7cadd86326081` / `4d00915009053081` |
| `sr_ls_10_25.cir/log` | `c90f1a44d9aea2c7` / `fa2ad314c3664175` | `sr_ls_10_50.cir/log` | `2e9282985a9e8fb7` / `b709ead399c5de6f` |
| `sr_ls_25_0.cir/log` | `03f061ec8e6df805` / `e360259a38ae1a79` | `sr_ls_25_25.cir/log` | `d0b942ecb55271c0` / `9f8d1a2383a28751` |
| `sr_ls_25_50.cir/log` | `8291bc8df10d67f2` / `e8ae364a3ad0bea4` | `sr_ls_25_75.cir/log` | `a9266d3c63e922f2` / `3026d8a06d019b48` |
| `sr_ls_25_85.cir/log` | `ac462ee41aefc702` / `eb2e5ba5b1751731` | `sr_ls_40_0.cir/log` | `48de64c0c9783b4b` / `7c4fe2c509d26c98` |
| `sr_ls_40_25.cir/log` | `1a8f11a4bbbaf640` / `f1921adc42bcbbe9` | `sr_ls_40_50.cir/log` | `aa1f9092daf4ef76` / `27296a4e7c020208` |
| `sr_tr_40_120_1.6u.cir/log` | `99991f21ab95263b` / `72bc0482e2e967f3` | `sr_tr_40_120_0.4u.cir/log` | `aef61e2a0b357043` / `27b7eec5132f1232` |
| `sr_tr_10_120_0.4u.cir/log` | `b25a1153a1732557` / `157c0971c2e32240` | `sr_tr_10_0_0.4u.cir/log` | `1bb6583fd03d3512` / `5475c0f53ad7bb79` |
| `sr_tr_10_120_1.6u.cir/log` | `addc67347803e9b8` / `233e98b4cd98ce39` |  |  |

---

## 11 追加实验：`VTHOFF` / 330 µA 容差角（2026-10-31）

### 11.1 目的

§8–§10 全部用 typ 值（`VTHOFF=10.5 mV`、`IOFF=330 µA`）。任务1的验收要求“阈值由 SOA/可接受损耗推导”，而数据手册给出 `VTHOFF` 2/10.5/18 mV、VSS 偏置电流 260/330/400 µA。**固定 Roffset 能否在全规格散布下覆盖 10–40 A？** 本节用 min/max 角回答，不新增台架。

### 11.2 方法

台架与 §9/§10 完全相同（`sr_load_40_120.cir` 派生，单案例，`TMAX=10n`，PGD=0，17–22 µs 干净窗口），只在 `Xsr` 行追加 `OFFTH={OFFTH}`，并扫 `IOFF`。有效门槛 `VTHOFF_eff = VTHOFF + IOFF×ROFF`，与 §8.2 的逐位一致规律相同。共 12 个实跑角：

```
10 A/0 Ω/2 mV
25 A/0 Ω/18 mV
40 A/0 Ω/2 mV, 40 A/0 Ω/18 mV
40 A/120 Ω × {2,18} mV × {260,400} µA     (4角)
25 A/50 Ω  × {2,18} mV × {260,400} µA     (4角)
```

**10 A/0 Ω/18 mV 没有实跑，是解析判定的**：§9 已实测该负载的 VDS 峰值 16.47 mV，小于 18 mV；比较器永不翻转，且 `Btoff` 只在 `V(D,sv)>OFFTH` 时提交关断。Roffset 只能把门槛**抬高**（330 µA 流出 VSS、把 `sv` 抬高、使 `V(D,sv)` 变小），所以任何 Roffset 值都救不了这个角。该角同时是数值上最坏的：门槛只比峰值高 1.5 mV，硬比较在临界斜坡上无法收敛（实跑 120 s 未完成、`.raw` 涨到 67 MB），因此不把它当作可跑角。

### 11.3 全表（PGD=0，µJ/周期，17–22 µs 窗口）

| 负载 | ROFF | VTHOFF | IOFF | 有效门槛 | IREV | QREV | EBD | ECH | EGE | 关断 |
|---|---|---|---|---|---|---|---|---|---|---|
| 10 A | 0 Ω | 2 mV | — | 2.0 mV | 0.923 A | 42.5 nC | 1.665 | 0.320 | 0.617 | 是（提前） |
| 10 A | 0 Ω | 10.5 mV | 330 µA | 10.5 mV | 0.921 A | 42.5 nC | 0.357 | 0.214 | 0.617 | 是（§10） |
| 10 A | 0 Ω | 18 mV | — | 18.0 mV | — | — | — | — | — | **否（解析）** |
| 25 A | 0 Ω | 10.5 mV | 330 µA | 10.5 mV | 1.585 A | 56.2 nC | 2.860 | 1.254 | 0.617 | 是（§10） |
| 25 A | 0 Ω | 18 mV | — | 18.0 mV | 1.603 A | 56.4 nC | 1.646 | 1.153 | 0.617 | 是（偏晚） |
| 40 A | 0 Ω | 2 mV | — | 2.0 mV | 2.197 A | 69.3 nC | 7.992 | 3.022 | 0.618 | 是（提前） |
| 40 A | 0 Ω | 10.5 mV | 330 µA | 10.5 mV | 2.197 A | 69.3 nC | 5.999 | 2.904 | 0.618 | 是（§10） |
| 40 A | 0 Ω | 18 mV | — | 18.0 mV | 2.196 A | 69.3 nC | 4.306 | 2.793 | 0.618 | 是（偏晚） |
| 40 A | 120 Ω | 2 mV | 260 µA | 33.2 mV | 2.196 A | 69.3 nC | 1.934 | 2.554 | 0.618 | 是 |
| 40 A | 120 Ω | 2 mV | 400 µA | 50.0 mV | 1.845 A | 53.2 nC | 0.824 | 2.276 | 0.621 | 是 |
| 40 A | 120 Ω | 18 mV | 260 µA | 49.2 mV | 2.017 A | 60.7 nC | 0.837 | 2.297 | 0.620 | 是 |
| 40 A | 120 Ω | **18 mV** | **400 µA** | **66.0 mV** | **40.0 A** | **63.66 µC** | 0.000 | 4.204 | 0.009 | **否** |
| 25 A | 50 Ω | 2 mV | 260 µA | 15.0 mV | 1.569 A | 56.2 nC | 2.089 | 1.192 | 0.617 | 是（提前） |
| 25 A | 50 Ω | 2 mV | 400 µA | 22.0 mV | 1.598 A | 56.3 nC | 1.135 | 1.090 | 0.618 | 是 |
| 25 A | 50 Ω | 18 mV | 260 µA | 31.0 mV | 1.427 A | 47.3 nC | 0.558 | 0.941 | 0.620 | 是 |
| 25 A | 50 Ω | **18 mV** | **400 µA** | **38.0 mV** | **7.161 A** | **874.1 nC** | 1.174 | 1.246 | 0.622 | 是（恶化 15×） |

积分器符号已统一（2026-10-31），`qrev_cyc` 在日志中为正值。

### 11.4 结论

1. **VDS 峰值对负载严格线性：1.647 mV/A。** 三个独立实测点 16.47 / 41.17 / 65.87 mV（10/25/40 A）给出同一斜率。其物理形式就是 `(Ld+Ls)·di/dt` 在过零点的峰值，而本台 `di/dt∝I`。由此得到固定门槛的**最小可关断负载**闭式解：`I_min = VTHOFF_eff / 1.647 mV/A`。
2. **40 A / 120 Ω 在 worst-case 角完全失效。** `18 mV + 400 µA×120 Ω = 66.0 mV`，比实测峰值 65.87 mV 高 **0.13 mV（0.2%）**，比较器不翻转：IREV 40 A、QREV 63.66 µC、EBD 0、ECH 4.204 µJ。这不是“略差”，是整周期不关断，与 §8 的 212 Ω 角同一失效形态。typ 值下 120 Ω 的 QREV 是 48.5 nC，相差 **1300 倍**。
3. **25 A / 50 Ω 的 worst-case 角仍关断但已恶化 15 倍**：38.0 mV 门槛对 41.17 mV 峰值只剩 3.2 mV 裕量，IREV 1.60→7.16 A、QREV 56→874 nC。也就是说“能关断”和“关得好”之间只差 3 mV。
4. **在本台的 1.647 mV/A 斜率下，0 Ω 救不了 10 A 的 18 mV 片子。** 峰值 16.47 mV < 18 mV，且 Roffset 只能抬高门槛。按同一斜率，0 Ω 的最小可关断负载为 10.9 A（max 片）/ 6.4 A（typ 片）。真实 LLC 的斜率必须用自己的 `L·di/dt` 重算（见 11.5），所以这是“本台 + 该规格”的结论，不是硅片断言。
5. **门槛调低不等于更安全。** 10 A 从 10.5 mV 降到 2 mV，关断提前，EBD 反而 0.357→1.665 µJ（4.7×）；40 A 同样 5.999→7.992 µJ。最优在内部（`≈(0.76–0.91)·VDS_peak`），单纯降门槛是用体二极管能量换“更早关断”。
6. **总判定（限本台架）：没有任何固定 Roffset 能在规格散布下同时覆盖本台的 10–40 A。** 0 Ω 在 10 A/18 mV 失效，120 Ω 在 40 A/18 mV+400 µA 失效，两者都是“完全不关断”（最坏失效形态）。结合 §10 的负载依赖，**本台架下存在不能关断的工况**；这不足以排除真实硅片上的 0 Ω Kelvin 基线，也不构成“固定电阻方案关闭”。0 Ω 仍为默认候选并保留调试焊盘；是否需要偏置、采用何种检测方式，必须先用有真实能量交换的双 SR 谐振台验证实际 `di/dt`，再用真实 LLC 的 `di/dt` 复算 `1.647 mV/A` 这个斜率。
7. 若坚持 0 Ω 作为本台架“全负载可关断”的折中，则它**没有 Roffset 收益**：0 Ω 就是无偏置基线，40 A 一致口径 9.521 µJ（2 ns 基线 9.362，1.7% 差为步长效应；120 Ω 为 3.717）。同时要标注：10 A 及以下对 18 mV 片子无保证。手册 §8.3.6 只描述 CH1 平均频率条件与待机恢复，**不能据此推出“整周期导通最多 7.5 ms”或“约 15 ms 极限环”**；本模型未实现待机状态，该时间行为未经仿真或实测验证。

### 11.5 限制

- 手册的 min/max 未必同片共存（`VTHOFF` 与 330 µA 是独立规格）；本节按标准 worst-case 组合处理，**不声称某一颗真实片子一定同时具备两个极值**。
- 模型把 `VTHOFF` 当理想常数比较（无迟滞、无噪声、无温度漂移）；真实比较器在 0.13 mV 裕量附近的行为不能由此判定。
- 仍是单案例受迫电流台：`1.647 mV/A` 的斜率依赖本台的 `Ld+Ls=1.1 nH` 与 200 kHz；真实 LLC 必须代入自己的 `L·di/dt`，不能直接搬用 mV/A。
- 10 A/18 mV 是解析结论，不是实跑；其数值不可收敛性已记录。
- 未扫温度；未扫`ONTH`（−265 mV）与 `ARM`（1.5 V）的容差。

### 11.6 复现

```powershell
cd D:\workshop\design_48v-2v
for ($i=0; $i -lt 12; $i++) { }  # 下列逐个运行，每个 timeout 30 s
# sr_corner_10_0_2m, sr_corner_25_0_18m, sr_corner_40_0_2m, sr_corner_40_0_18m,
# sr_corner_40_120_{2m,18m}_{260u,400u}, sr_corner_25_50_{2m,18m}_{260u,400u}
D:/ADI/LTspice/LTspice.exe -b sim/v2/comm_v3/sr_corner_40_120_18m_400u.cir
```

生成方式（每个角只改三处）：`.param` 行加 `OFFTH=...`、`IOFF=...`；`Xsr` 行追加 `OFFTH={OFFTH}`；首行注释。`sr_corner_10_0_18m.cir` 保留作解析角的记录，**不要实跑**（临界不收敛）。

哈希（sha256 前 16 位）：

| 文件 | cir/log | 文件 | cir/log |
|---|---|---|---|
| `sr_corner_10_0_2m` | `338d03a166e2cf1a` / `f0c29b5932e33dac` | `sr_corner_25_0_18m` | `e34ed78510a4f507` / `0ca7151298fa6203` |
| `sr_corner_40_0_2m` | `54ed62f1ad5af5f9` / `c6095c12df40453a` | `sr_corner_40_0_18m` | `9a68bc5c6ed097fa` / `e238362d004caf8c` |
| `sr_corner_40_120_2m_260u` | `da6e95a1ea9c646d` / `0f0feedcd7d53365` | `sr_corner_40_120_2m_400u` | `4f7a929ce3ad94a7` / `31f0b01d5264e809` |
| `sr_corner_40_120_18m_260u` | `3818df1f4d43336b` / `9e94be4553042605` | `sr_corner_40_120_18m_400u` | `43a3618b8a6d8d2b` / `e8f151daaab8cd36` |
| `sr_corner_25_50_2m_260u` | `9d9566d13f2c4257` / `f9499d8918ad827e` | `sr_corner_25_50_2m_400u` | `fad941e41af30335` / `2c7668f9a79f8e2f` |
| `sr_corner_25_50_18m_260u` | `9fdfaa7d97c03e0e` / `01e094d2d0befa79` | `sr_corner_25_50_18m_400u` | `1621774fdfa21963` / `db7a8368135de6e4` |

模型哈希以 `design/baseline/baseline_manifest.json` 为准：`sr_timing_v3.lib` = `5099df9183b0e060`（审核后仅改注释），`sr_timing_v3_roff.lib` = `f2c4180e44897c18`。
