czy0126/CZY/design/v2/task1_verification.md

# 任务1 对抗性复核：SR 器件替身与 v3 时序

日期：2026-10-31
性质：独立复核（adversarial verification）。**未修改** models/sr_device_v3.lib、models/sr_timing_v3.lib、
models/sr_timing_v2.lib 或任何既有台架；本文件只新增 `sim/v2/verify_*` 临时台架与本报告。
所有数字均取自本次实际运行产生的 .log，或我实际阅读的手册页（`references/datasheets/bsc010n04ls6.txt`）。

## 0. 总判定

**PARTIAL。** 分三层：

1. **器件替身（单管台）本身可信**：15 项手册目标全部独立复现，其中 8 项误差 < 5%，
   其余 7 项在 8.9%~17.6% 且都未超手册 max；反向电流没有被钳零，
   温度只缩放 Rds(on) 与手册曲线一致。这是一份可用的"决策用"器件模型（在其声明范围内）。
2. **v3 时序状态机可信**：仲裁、475/650 ns blanking、短脉冲过滤、PRE/UVLO 全部独立复现，
   v2 的反向对照确实发散。CH1 同时请求优先确为数值仲裁，未冒充芯片规范。
3. **任务1 的核心交付没有闭环**：功率换流台 `sr_commutation_sweep.cir` 仍然用
   `SW(Ron=1.5m)` + 理想体二极管 + 外部 `Cda 2n`，**没有接入 `SR_DEVICE`**。因此
   "用分段非线性跨导替换固定 Ron 开关"、"与 v2 台同激励对照"、"用新器件重做 1ns/2ns 与
   200ns 负对照"这三项验收**未完成**；对外引用的 9.790 A / 0.978 uC / 18.085 A / 0.465%
   全部是**理想开关 + v2 时序**的数字，不是 v3 器件的结果。

## 1. 复核方法与独立判据

运行方式（未用 PowerShell，未用 -ExecutionPolicy）：

```
cd "D:/workshop/design_48v-2v" && rm -f sim/v2/NAME.log sim/v2/NAME.raw
timeout 240 "D:/ADI/LTspice/LTspice.exe" -b "sim/v2/NAME.cir"; echo exit=$?
```

每个台架独立判定：.log 存在；含 "Total elapsed time"；不含
`Error:` / `Time step too small` / `Singular matrix` / `Analysis failed`；所依赖的每个 .meas
都有数值（不看退出码）。

本次新建并实际运行的台架（全部在 `sim/v2/` 下）：

| 文件 | 用途 |
|---|---|
| `verify_dev_{dc_fwd,dc_fwd_low,vth,3q,qg,caps,ciss2,qrr,turnoff,kelvin}.cir` | 逐字复制单管台，独立重跑 10 项 |
| `verify_dev_{temp,3q_on,sat}.cir` | 新增：温度缩放、沟道导通的第三象限、饱和区 |
| `verify_t3_{normal,simultaneous,skew,shortpulse,offblank_retrigger,onblank,interlock,reg_first_negative,fastreg20,fastreg5,noarb_negative}.cir` | 复制 11 个 v3 检查台，独立重跑 |
| `verify_tie_exact.cir` | 测两个 D 是否同一求解时刻过 -0.265 V，及栅极延迟 |
| `verify_offblank_boundary.cir` | 用 **510 ns**（> TON）脉冲测 650 ns 关断 blank 边界（项目台用的是 60/70 ns，见 §4.2） |
| `verify_interlock_queue.cir` | 被阻断的 250 ns 请求是否残留（是否"排队"） |
| `verify_revcharge.cir` | 在换流台上加电荷积分器，独立测每周期反向电荷 |
| `verify_v2_sweep.cir` / `verify_v2_slowoff.cir` | 只读副本，重跑 v2 换流台与 200 ns 负对照 |

日志审计结果：13 个 `verify_dev_*`、11 个 `verify_t3_*`、`verify_revcharge`、`verify_interlock_queue`、
`verify_tie_exact`、`verify_v2_sweep`、`verify_v2_slowoff` **全部** elapsed=1、错误行=0。
`verify_offblank_boundary.log` 是唯一含 "failed" 的日志，且只是 `g1r2/g1f2`（V(g1)=2 第 2 次跳变）
在 TD=4.7/4.8/4.9 三个 step 上"找不到事件"——这三档**本来就没有第二个栅极脉冲**，是预期结果；
同 16 个 meas 块中其余 14 个均有数值。

## 2. 模型哈希

| 文件 | sha256 | 结论 |
|---|---|---|
| `models/sr_timing_v2.lib` | `412e07a9256576d07cb92ab2298fb99fa827fadc0e0efa376596a3a20a81843a` | 与 `design/v2/verification_results.json` 第 139 行**逐字符一致**，未被改动 |
| `models/sr_timing_v3.lib` | `5099df9183b0e0609bd4bd1eb99398012eb745f5172517f33c68eb3b5a437141` | 审核后仅改 off-blank 起点注释，网表未变；全值见 `design/baseline/baseline_manifest.json` |
| `models/sr_device_v3.lib` | `5224e94703cc2a6ec63b1435218b243622099f06b6c1915f78dff6528a5dde59` | 与 v3 结果文档一致 |

**无静默混用**：`sr_device_v3.lib` 与 `sr_timing_v3.lib` 中没有一行来自厂商网表
（grep `S6_40|e_eds|A6_40|BSC0` 只命中注释里的引用行，没有任何厂商子电路/模型名），
也没有 `.include` 厂商库。厂商文件保持原样。

## 3. 器件模型 vs 校准目标（独立复算）

误差均按 (仿真-typ)/typ 由我重算，未采用项目文档给出的数值。

| # | 目标（typ (max)） | 本次仿真值 | 误差 | 判定 |
|---|---|---|---|---|
| 1 | Rds(on) @10 V, 50 A = 0.89 (1.0) mOhm | 0.897516 mOhm | +0.845% | CONFIRMED |
| 2 | Rds(on) @4.5 V, 50 A = 1.10 (1.4) mOhm | 1.119067 mOhm | +1.733% | CONFIRMED |
| 3 | VGS(th) @250 uA = 1.3..2.3 V | 1.875083 V | 在区间内 | CONFIRMED |
| 4 | Ciss @20 V = 4600 (6000) pF | 5139.64 pF | +11.73% | CONFIRMED |
| 5 | Coss @20 V = 1500 (2000) pF | 1508.07 pF | +0.538% | CONFIRMED |
| 6 | Crss @20 V = 38 (66) pF | 39.484 pF | +3.906% | CONFIRMED |
| 7 | Qoss = 73 (97) nC | 72.9965 nC | -0.005% | CONFIRMED |
| 8 | Qg (0..10 V) = 67 (83) nC | 55.3747 nC | **-17.35%** | CONFIRMED 值；PASS 依赖自定 ±20% |
| 9 | Qg (0..4.5 V) = 32 nC | 29.1405 nC | -8.94% | CONFIRMED |
| 10 | Qgs = 12 nC | 13.9762 nC | **+16.47%** | CONFIRMED 值 |
| 11 | Qgd = 8.1 (12) nC | 6.67904 nC | **-17.55%** | CONFIRMED 值 |
| 12 | Vplateau = 2.7 V | 2.71872 V | +0.69% | CONFIRMED |
| 13 | VSD @50 A = 0.80 (1.0) V | 0.800408 V | +0.051% | CONFIRMED |
| 14 | trr = 30 (60) ns | 25.382 ns | -15.39% | CONFIRMED |
| 15 | Qrr = 97 (194) nC | 113.13 nC | +16.63% | CONFIRMED |

补充独立测量：

| 量 | 本次值 | 说明 |
|---|---|---|
| Kelvin 变体 Rds @10 V | 0.897666 mOhm | 与 3 脚版 0.897516 差 0.017%，Kelvin 解析正常 |
| Rds 温度 25/125/175 C | 0.897666 / 1.329546 / 1.633544 mOhm | 比值 1.4811 / 1.8198；手册 1.48 / 1.82 |
| 第三象限、沟道开（VGS=10） | 111.40 A @ VDS=-0.1 V | 与正向 111.4 A **奇对称**，不是把反向钳零 |
| 第三象限、沟道开（VGS=4.5） | 89.35 A @ VDS=-0.1 V | 同上 |
| VSD @50 A，VGS=10 / 4.5 | 44.9 / 56.0 mV | 沟道导通时的真实压降量级 |
| Coss @10/20/40 V | 3393.9 / 1508.07 / 861.33 pF | 与数字化曲线差 < 1% |
| Crss @10/20/40 V | 186.20 / 39.484 / 26.760 pF | 与数字化曲线差 < 3% |
| 关断 VPK / dv/dt / IL | 21.1328 V / 2456 V/us / 51.872 A | 20 V 钳位感性关断 |
| 饱和区 @40 V, VGS=10 V | **1358.3 A** | kA 级，模型自认的缺陷（见 §5） |

结论：**"15/15 PASS" 的算术无误**。但必须指出两点，避免把 PASS 读强：
(a) ±20% 是本项目自定判据，手册并不保证 Qg/Qgd 的 min；
(b) Qg -17.4%、Qgd -17.6%、Qgs +16.5% 来自同一个 Cgs 折中，**门极损耗会被低估约 17%**——
本项目恰好要求报告"门耗"，这个偏差直接影响结论，不能只写 PASS 了事。
另外手册 Table 5 的 td(on)/tr/td(off)/tf = 7/5/29/8 ns **完全没有进入校准 JSON，也没有台架核对**。

## 4. 时序 v3 复核

### 4.1 逐项复现

| 声明 | 本次独立结果 | 判定 |
|---|---|---|
| 正常顺序产生 ~10.89 V 门极 | 10.8905 V；g1 上升 4.176709 us、下降 5.560301 us；g2 上升 6.176709 us | CONFIRMED |
| 两通道同时请求时 CH1 胜出 | tc1 = tc2 = 4.00927173913e-06 s；`V(d1)-V(d2)` 全程 max=min=0；g2max=0、a2max=0 | CONFIRMED（真并列，非错开） |
| 比较器到栅极 2 V 的延迟 | 167.26 ns = TON 155 ns + 驱动上升 12.3 ns | CONFIRMED |
| 50 ns / 5 ns 偏斜，两个方向 | 4 个事件均**只有一个**栅极 > 2 V；overlap_max = 0 | CONFIRMED |
| 100 ns 短脉冲被过滤 | 4.01~4.11 us 的 100 ns 请求无栅极；6.01~6.31 us 的 300 ns 请求在 6.1767 us 起栅 | CONFIRMED |
| on-blank 475 ns 内保持 | 门极最低 9.82 V，无跌落、无误关断 | CONFIRMED |
| 反序（先 REG 后 VD） | PRE=0、viol=1、两栅极均 0 | CONFIRMED |
| 快速 REG 斜坡 20/5 us | 均正常起栅、viol=0 | CONFIRMED |
| v2 对照（无 BLOCK 补丁） | 4.16494 us 发散：`Time step too small ... node "reqa"`，Simulation Failed | CONFIRMED |
| 200 ns 异常关断延迟使反灌增大 | 18.0854 A（正常 9.7901 A） | CONFIRMED（**但为理想开关台**） |

### 4.2 关断 blank 的真实边界（我重做的测试）

项目 `offblank_retrigger` 台的两个"重触发"凹口只有 **60 ns 和 70 ns**（4.85~4.91 / 5.22~5.29 us），
都 < TON 155 ns，所以它们**无论 blank 是否存在都会被短脉冲规则滤掉**——该测试不能证明 650 ns blank。
我改用 **510 ns** 的凹口，TD=4.7..5.4 us 六档，实测：

- Q 下降沿（关断事件）4.66345413923 us；blank 到期 = 4.66345 + 650 ns = **5.3135 us**；
- 最早可能置位 = 5.3135 + 155 ns = **5.4685 us**；实测栅极到 2 V 为 5.4815 us
  （Q 置位约 5.469 us，差值 12.3 ns 是驱动上升，与 §4.1 的 167.26 ns 一致）；
- TD=4.7（脉冲全在 blank 内，4.71~5.21 us）→ 无栅极；
- TD=4.8（低电平在 5.310 us 结束，比 blank 到期 5.3135 还早 3.5 ns）→ 无栅极；
- TD=4.9（blank 到期后只剩 **96.5 ns** < 155 ns）→ **无栅极**；
- TD=5.0（剩 196.5 ns）→ 5.4815 us 起栅；TD=5.2（剩 396.5 ns）同样 5.4815 us
  （与脉冲起点无关，只由 blank 到期决定）；
- TD=5.4（脉冲起点已在 blank 之外）→ 起点 + 155.7 ns 起栅。

结论：650 ns blank 确实从**实际关断沿**起算；跨越 blank 到期但剩余时间 < TON 的请求被丢弃，
**没有"排队"**。这一条是 CONFIRMED（项目原测试本身是 REFUTED 作为证据）。

### 4.3 互锁是否"排队"

项目 `interlock` 台的失败方脉冲约 100 ns（4.30~4.40 us），同样 < TON，单独看证明不了互锁
（后面的 1 us 有效请求只是正常起栅）。我的 `verify_interlock_queue`：
CH1 在 4.17~4.91 us 导通；CH2 先给 250 ns（> TON）被阻断的请求，再给 60 ns 请求，最后给 300 ns 对照请求。
结果：`g2_early = 0`（250 ns 与 60 ns 都不产生栅极）、`q2max_early = 0`、对照请求在 7.17671 us 正常起栅、
CH1 按自己的时刻 4.94 us 正常关断、窗口内最低 4.93 V（未被扰动）。
结论：被阻断的请求**被丢弃，不累积**。CONFIRMED（比项目 C7 更强）。

### 4.4 每周期反向电荷

项目只写了"约 0.978 uC"，**没有对应的 .meas**。我在同激励（40 A/200 kHz，PGD=0，TOFF=23 ns）
上加 max(0,-I) 积分器独立测：

| 场 | 本项目值 | 本次值 | 差 |
|---|---|---|---|
| PGD=0, 23 ns | 0.978 uC | **0.9630 uC** | -1.5% |
| PGD=1, 23 ns | 0.706 uC | **0.6973 uC** | -1.3% |

在 1.5% 内可复现（差异来自积分器加入引起的微小数值扰动）。**但这是理想开关台的结果。**

## 5. 是否"作弊"（逐条对抗性检查）

| 检查项 | 结论 |
|---|---|
| 反向电流被钳为 0 | **未发现**。VGS=0 时 50 A 反向电流经体二极管在 0.8004 V 建立，1 V 时 210.5 A；沟道导通时 -0.1 V 给出 111.4 A；换流台反灌峰值 9.79 A、每周期 0.963 uC。 |
| 硬编码栅极波形 | **未发现**。栅极由 B 源状态机产生；决定性证据：`V(d1)-V(d2)` 全程为 0（求解器眼里完全同刻），仍只有 CH1 起栅——这只能由仲裁逻辑解释，不能由波形表解释。 |
| 物理无意义的参数 | **部分成立**：Isat 用 softplus 限幅到 1364 A，40 V/10 V 给 1358 A。模型自己已声明"饱和区/SOA/短路不可用"。在 SR 的 0.1~0.6 V 工作点是安全的，但不能用它算雪崩、短路或 40 V 关断应力。 |
| .meas 窗口隐藏事件 | **部分成立且影响结论**：§4.2/4.3 的两个"机制测试"用的脉冲都 < TON，实际只测到了短脉冲规则。`reverse_peak` 的 10~20 us 窗口有意排除了 3~10 us 启动段，这一点合理，但必须在文档里写明。 |
| PASS 来自"数值跑完" | **未发现**。每个 PASS 都有数值 .meas；我逐条重算，值与项目文档一致到 5 位。 |
| 功率级"无同时增强" | 只能用 `min(V(ga),V(gb))` = 6.1 mV 作证，那是空闲态求解残差，不是真实重叠；真实器件下的重叠**未测**（器件没接入）。 |

## 6. 任务1 交付完整性（对照任务书逐条）

| 任务书要求 | 状态 | 证据/缺口 |
|---|---|---|
| 优先官方模型；不可用则建可追溯替身 | CONFIRMED | 我复跑 `model_probe.cir`：默认求解器 0.275 s 失败，`Time step too small ... "xdc:x1:e_eds2#branch"`、Simulation Failed、exit=1。否决理由成立。 |
| 单管台核对正向/第三象限/门荷/关断 | CONFIRMED | §3 全部复现 |
| **用分段非线性跨导替换固定 Ron 开关** | **REFUTED** | `sim/v2/sr_commutation_sweep.cir` 仍是 `SW(Ron=1.5m ...)` + `D(Ron=1.5m Vfwd=.65)` + `Cda 2n`。全仓 grep 证实：include `sr_device_v3.lib` 的全部是单管/探针台（`sr_device_bench_*`、`lead_probe/`、`verify_dev_*`），**没有任何换流或功率级台架**。项目自己在 `sr_device_bench_results.md` §2.1 只写了"替换方法"。 |
| **与 v2 台同激励对照** | **REFUTED** | 同上，没有对照运行 |
| **1ns/2ns 与数值时间常数对比** | **CONFIRMED（仅对 v2 理想台）/ REFUTED（对新器件）** | 我复跑 `sr_timestep_check.cir`：六场反向峰值最大差 **0.465%**（步 2：7.4984 vs 7.4635 A），与项目声称完全一致；其余 0.042%~0.352%。但它是 v2 时序 + 理想开关，与 v3 器件无关 |
| 真实 PGD 靠 VDS 反馈改变沟道电阻 | **REFUTED** | `Bdrv` 确实读 `V(D)`，但该法则**未校准**（lib 头、进展文档第 39 行均自认）；且功率台不用器件，`Rds(Vgs)` 机制从未被走通 |
| 155/275 ns 自适应 | **REFUTED** | 固定 `TON=155n`，库中无 275 ns 逻辑 |
| 475/650 ns blanking | CONFIRMED | §4.2；475 ns 见 §4.1 |
| 1.4~1.7 V 再武装 | **PARTIAL** | `ARM=1.5` 固定，无 1.4~1.7 V 窗口 |
| 2~18 mV 关断门槛 | **PARTIAL** | `OFFTH=10.5m` 固定，无 2~18 mV 窗口 |
| 区分 1.5A/4A、6.5/0.9 ohm、外 2.2 ohm | CONFIRMED | `limit(...,-1.5,4)`；8.7 = 6.5+2.2、3.1 = 0.9+2.2 |
| 封装/Kelvin 可追溯寄生范围 | **UNVERIFIABLE** | 参数与 Kelvin 变体都在，但取值是 ESTIMATE，无厂商/布局实测来源 |
| 明确厂商/自建界面 | **PARTIAL** | 有决策记录与"不混用"证明；没有可切换的厂商模型包装 |
| 反向峰值 | CONFIRMED | 9.7901 A（复跑） |
| 电荷/周期 | **PARTIAL** | 交付文档给 0.978 uC，但无 .meas；我独立测得 0.9630 uC |
| VDS/VGS 波形 | CONFIRMED | 单管关断台 |
| **门耗** | **REFUTED（未交付）** | 任何 log 中都没有门极驱动能量 |
| **体二极管导通能量** | **REFUTED（未交付）** | 任何 log 中都没有 |
| 阈值由 SOA/可接受损耗推导 | **REFUTED** | 器件不能做 SOA（kA 限幅），没有任何损耗-SOA 推导 |
| 关断延迟负对照增大反灌 | CONFIRMED（数值）/ PARTIAL（器件） | 18.0854 A vs 9.7901 A，但都是理想开关 |
| CH1 优先只是数值仲裁，不冒充规范 | CONFIRMED | 文档与实现一致 |

## 7. 阻断项（下一步，按顺序）

1. **把 `SR_DEVICE` 接进换流台并重跑**：`Xsr dan gan 0 SR_DEVICE`，删掉外部 `Cda 2n`
   （否则 Coss 双计），重出 1ns/2ns、PGD 开/关、200 ns 负对照四组数字。在完成之前，
   9.790 A / 0.978 uC / 18.085 A / 0.465% **不能算 v3 器件的结果**。
2. **校准 PGD 法则**（VDS→VGS 的目标曲线），并用器件的 `Rds(Vgs)` 证明比例门驱真的改变了沟道电阻。
3. **修正两处测试刺激**：off-blank 与 interlock 必须用 > TON（155 ns）的脉冲；`verify_offblank_boundary.cir`
   与 `verify_interlock_queue.cir` 可直接作为模板。
4. **补 .meas**：每周期反向电荷、门极驱动能量、体二极管导通能量（下一步应改用真实二极管模型，
   现有 `BODY` 是 Vfwd=0.65 V 的理想二极管，算出的能量没有意义）。
5. **决定并落实** 155/275 ns 自适应、1.4~1.7 V 再武装窗口、2~18 mV 关断窗口；不实现就显式从任务1 删除。
6. **器件补齐**：温度只作用于 Rds(on)，Vth/Coss/Qg/二极管均无温度；手册 td(on)/tr/td(off)/tf（7/5/29/8 ns）
   未进入校准；Cgs 折中导致 Qg/Qgd -17%，会低估门耗。

## 8. 复核边界

- 我没有重跑 7 ms 启动、控制器台、integrated_* 系列——不属于任务1。
- `sr_commutation_sweep.cir` 的 9.790 A 我用只读副本 `verify_v2_sweep.cir` 复跑，逐位一致。
- 我只新增了 `sim/v2/verify_*` 与 `sim/v2/model_probe.log`（重跑官方模型探针产生，内容与
  `references/models/infineon_optimos_pspice_40v/L1_default_solver_failure.txt` 一致）。
- 厂商模型 kA 值（11.2 kA）来自 `official_model_report.md`，我**未**独立复现其 -alt 运行，故该单点记 UNVERIFIABLE；
  但其"默认求解器失败"已由我复跑确认。

---

## 9. 作者回应（2026-10-31，不改动上文审核结论）

**阻断项 1 已关闭。** `sim/v2/comm_v3/sr_commutation_v3.cir` 已用 `Xsr1 da gda 0 SR_DEVICE` / `Xsr2 db gdb 0 SR_DEVICE`，删除外部 `Cda/Cdb 2n`，时序模型未改动；新增 17–22 µs 干净窗口和 `qrev_cyc/qg_cyc/ebd_cyc/ech_cyc/ege_cyc`。8 步 × 57 个 `.meas`，日志各 1 行 `Total elapsed time`、0 条错误行；六个 sha256 前缀与 `design/v2/sr_commutation_v3_results.md` 登记一致。四组数字（1ns/2ns、PGD 开/关、200 ns 负对照、器件 vs 同 v3 时序理想开关）见该报告 §2。

**阻断项 4 已关闭。** 门耗、体二极管能量、沟道能量、Qrev 现在都有 `.meas`；体二极管用的是 `SR_DEVICE` 内的 `DB`（IS/N/TT/RS），不是 v2 的 `BODY Vfwd=.65`。

**三项对抗核验后的修正，请连同上文一起读：**

1. **Roffset 不能漏。** 上文 §7 第 5 条把“2–18 mV 关断窗口”当成唯一旋钮；实际 UCC24624 的 VSS 330 µA 偏置可把有效门槛抬到 `10.5 mV + 330 µA×Roffset`（审核 §1 行 3 已列，建议 <70 mV、Roffset<212 Ω）。按 50.2 A/µs 的过零斜率，0.5 µJ 尾目标需要 ≥48 mV；Roffset≈114–120 Ω 可达到，100 Ω 给 43.5 mV/约 0.8 µJ。模型缺 330 µA 源（审核 A1），所以当时这是设计推导；§10 已用行为等效补跑，40 A 下 120 Ω 最优、212 Ω/PGD=0 不关断；§11 的 10/25/40 A 负载扫描又证明 100/120 Ω 在 10/25 A 下完全不关断；§12 的低门槛扫描给出最优值随负载移动（10 A→0 Ω、25 A→50 Ω、40 A→120 Ω），因此固定 Roffset 方案不成立。第一优先实验已转为双 SR 换流台 + DCX 实际 di/dt + 真实 VSS 引脚；Kelvin 是第二选项。
2. **44 A/µs 用错。** 台架是 40 A/200 kHz，过零斜率是 50.2 A/µs（解析 50.27）；44 A/µs 是旧稿的尾段平均口径。修正后：I₀≤8.5 A、端电压≥47.6 mV、Kelvin 触发≈5.1 A、尾≈0.18 µJ（~28×，不是 70×）。
3. **5.014 µJ 是 gate<1 V 的下界。** 体二极管从 19.918 µs（V(d1)<−0.5 V，VGS≈2.27 V）已导通；按“首次二极管导通”口径，完整端电压能量约 5.593 µJ，代价 4.90–5.48 µJ/事件、0.98–1.10 W/SR。两者都含 L·di/dt 的无功部分，不是纯管芯耗散。报告 §5 限制 6 已改写。

**仍未关闭：** 阻断项 2（PGD 律校准）、3（off-blank/interlock 刺激）、5 的其余部分（155/275 ns、1.4–1.7 V ARM；OFFTH 窗口的 Roffset 已在 §10 完成行为等效扫描、§11 完成负载扫描、§12 完成低门槛扫描与 di/dt 探针，结论是固定 Roffset 不覆盖 10–40 A）、6（温度与 MOSFET 漏极开关时间；注意 7/5/29/8 ns 不是控制器门压边沿）。SOA 仍未打到：本台 VDS_MAX=5.0 V、体二极管 25 A、栅极 10.9 V；损耗阈值是按上述目标推导的，不是 SOA 限额。

**关于 0.978 µC：** 上文独立测得 0.9630 µC，与本项目旧文档的 0.978 µC 差 1.5%，两者都是 v2 理想台/不同窗口的口径。v3 报告不再引用 0.978 µC 作为器件结果；v3 器件 Qrev 是 69.06 nC，v3 同激励理想对照是 977.3 nC（均有 `.meas`）。

---

## 10. 作者追加（2026-10-31）：Roffset 行为等效扫描

§9 第 1 条把 Roffset 0/100/150/212 Ω 列为第一优先实验。已完成，证据如下；上文审核结论不改。

**新增文件（`sr_timing_v3.lib` 当时为 `28202ae20e8815aa`；2026-10-31 审核后仅改注释，现值 `5099df9183b0e060`，网表未变）：** <!-- hash-owner: design/review_20261031/sr_timing_v3.lib, models/sr_timing_v3.lib -->

- `models/sr_timing_v3_roff.lib`（`f2c4180e44897c18`）：冻结 v3 的副本，加 `ROFF`/`IOFF` 参数。每通道用浮置 `Roffv sv S {ROFF+1u}` + `Ioff S sv {IOFF}` 产生 `V(sv)=V(S)+330 µA×ROFF`；比较器用 `V(D,sv)`，栅极回路仍回 S。这是行为等效，不是 VSS 引脚模型。
- `sim/v2/comm_v3/sr_commutation_v3_roff.cir`（`0e6df5881044bd39`）：同激励、同器件、同 17–22 µs 窗口；`ROFF` 内层 1µ/100/120/150/212 Ω，`PGD` 外层 0/1，10 场。
- `sim/v2/comm_v3/sr_commutation_v3_roff.log`（`2ee4b2b40439552e`）：57 个 `.meas` × 10 场，`Total elapsed time` 约 3.8 s（每次运行略有差异；2026-10-31 符号修正后重跑为 3.800 s），无 `Error`/`Time step too small`/`Analysis failed`。

**结果（PGD=0 为决策组）：**

| Roff | 实测 OFFTH | 触发电流 | 关断尾 | EBD | Etot | QREV |
|---:|---:|---:|---:|---:|---:|---:|
| 1 µΩ | 10.50 mV | −29.69 A | 5.009 µJ | 5.851 µJ | 9.362 µJ | 69.06 nC |
| 100 Ω | 43.50 mV | −10.82 A | 0.161 µJ | 0.995 µJ | 3.989 µJ | 68.27 nC |
| 120 Ω | 50.10 mV | −5.21 A | 0.000 µJ | 0.820 µJ | 3.712 µJ | 48.59 nC |
| 150 Ω | 60.00 mV | +5.96 A | 0.000 µJ | 1.771 µJ | 5.228 µJ | 1199.3 nC |
| 212 Ω | 80.46 mV | 未触发 | — | 0.000 µJ | 4.213 µJ | 63662 nC |

- 门槛律 `10.5 mV+330 µA×R` 与实测逐位一致；1 µΩ 复现冻结 v3 的 5.851 µJ/69.06 nC 到 4 位。
- **120 Ω 是 PGD=0 的最优点**：关断尾 0、总 3.712 µJ（−60%）、QREV 48.6 nC；100 Ω 次之（尾 0.161、总 3.989、QREV 68.3）。
- **150 Ω 反弹**（触发已过零 +5.96 A，QREV 1.20 µC）；**212 Ω/PGD=0 完全不关断**（IREV 40 A、QREV 63.7 µC）。所以手册的 <70 mV/<212 Ω 是 VSS 偏置绝对上限，不是 40 A 工作点；100–120 Ω 是 40 A 台架的最优区间。
- 总 EBD 仍有 **0.820 µJ** 下限，其中约 0.690 µJ 是关断前 gate<1 段（开通死区/相位），0.131 µJ 是过零后反向充电；Roffset 只压关断尾。0.5 µJ 是尾目标，不是总 EBD 目标。
- 上述“不关断”是 40 A 台架结果，不是硅片断言；330 µA 的 260–400 µA 容差、真实 VSS 引脚阻抗未做。**10/25/40 A 负载扫描已补做，见 §11，结论是否定固定 Roffset 方案。**

---

## 11. 作者追加（2026-10-31）：Roffset 负载扫描 10/25/40 A

§8.4 第 6 条预判固定 mV 门槛在轻载失效；§10 只覆盖 40 A。本节实跑 10/25/40 A × 100/120 Ω（PGD=0）。多场次 `.step` 台在 `TMAX=2n/10n` 下超时且只写出部分场次，改用单案例台（无 `.step`，参数写进 `.param`，`TMAX=10n`），每场 0.19–0.29 s，输出与日志可独立复算；raw 只保留完成场次。

| 负载 | Roff | VDS 峰值 | VGS | 触发 | QREV | EBD | ECH | EGE | Etot |
|---:|---:|---:|---:|---|---:|---:|---:|---:|---:|
| 10 A | 100 Ω | 16.47 mV | 10.89 V | **否** | 15.916 µC | ~0 | 0.263 µJ | 0.00228 µJ | 0.265 µJ |
| 10 A | 120 Ω | 16.47 mV | 10.89 V | **否** | 15.916 µC | ~0 | 0.263 µJ | 0.00228 µJ | 0.265 µJ |
| 25 A | 100 Ω | 41.17 mV | 10.89 V | **否** | 39.789 µC | ~0 | 1.642 µJ | 0.00571 µJ | 1.648 µJ |
| 40 A | 100 Ω | 5.000 V | −0.234 V | 是 | 68.498 nC | 1.022 µJ | 2.386 µJ | 0.619 µJ | 4.027 µJ |
| 40 A | 120 Ω | 5.000 V | −0.234 V | 是 | 48.499 nC | 0.824 µJ | 2.271 µJ | 0.622 µJ | 3.717 µJ |

- 10/25 A 的终端 VDS 峰值只有 16.47/41.17 mV，低于 43.5/50.1 mV；VGS 全周期 10.89 V，SR 不关断，整周期导通。25 A/120 Ω 数值上未跑完（`TMAX=10/20/50 ns` 均 17–19 MB raw 后步长塌缩），按 25 A/100 Ω 推断同样不关断。
- 机理：可用端电压由 `L·di/dt` 主导，随负载线性下降；`SR_CH3` 无最大开通时间/看门狗，`Btoff` 只在 `V(D,sv)>OFFTH` 时提交关断，比较器不翻转就无限保持开通。
- **固定 Roffset 不能覆盖 10–40 A**；10/25 A 的 Etot 低是“无关断事件”的假象，属功能失效。下一步见 §12。数值结果不是硅片断言。

---

## 12. 作者追加（2026-10-31）：低门槛扫描与 di/dt 机理

§11 只测 100/120 Ω，留下“更低 Roffset 能否救轻载”的问题。本节扫 0/15/25/50/75/85 Ω × 10/25/40 A（单案例台，`TMAX=10n`，PGD=0），并用固定斜率梯形电流做机理探针。完整表与复现见 `sr_commutation_v3_results.md` §10。

| 负载 | 最优 Roff | 该点 IREV | QREV | EBD | Etot | 备注 |
|---:|---:|---:|---:|---:|---:|---|
| 10 A | 0 Ω | 0.921 A | 42.51 nC | 0.357 µJ | 1.188 µJ | 15 Ω 名义触发但 IREV 3.32 A/QREV 476 nC；≥25 Ω 不关断 |
| 25 A | 50 Ω | 1.575 A | 55.93 nC | 0.688 µJ | 2.314 µJ | 75 Ω IREV 3.83 A/QREV 264 nC；85 Ω 8.12 A/1.13 µC；≥100 Ω 不关断 |
| 40 A | 120 Ω | 1.747 A | 48.50 nC | 0.824 µJ | 3.717 µJ | 0 Ω 9.521 µJ（=无偏置基线；2 ns 基线 9.362，差 1.7% 为步长），50 Ω 6.004（均含门耗） |

- **最优门槛随负载移动**（0→50→120 Ω），与可用 `L·di/dt` 近似成正比；固定值只能在“轻载功能”（0 Ω，全负载可关断但重载几乎无收益）与“重载收益”（120 Ω，轻载失效）之间二选一。
- 数据手册只给出 CH1 平均频率待机判据：`tONMIN=475 ns` 是最小开通消隐，关断只由 `VTHOFF` 比较器触发；`VTHOFF` 规格 2/10.5/18 mV，最坏 18 mV 的片子即使 0 Ω 在 10 A（峰值 16.47 mV）也不关断。手册 §8.3.6 的 <9 kHz/7.5 ms 进 standby、>15.6 kHz/7.5 ms 恢复**不能推出所有故障状态的硬上限或固定周期**；本模型未实现待机（本台只有 22 µs 窗），所以只能写“本台架下存在不能关断的工况”，不能写“最多持续 7.5 ms 后进入 ~15 ms 极限环”。
- 梯形探针（固定 50 A/µs）中 120 Ω 在 10 A 也能关断，但该台关断后电流被 4 V 钳位吸收、0 Ω 与 120 Ω 结果几乎相同，只能作 di/dt 机理提示，不能定量。
- **决策变量是 `L·di/dt`；本机 LLC 的 di/dt≈2πf·I 又随负载变化**，所以固定门槛只在单一负载成立。门槛律 `OFFTH_opt≈(0.76–0.91)·(Ld+Ls)·di/dt`（10/25/40 A 三点反推）。下一步需要双 SR 换流台（电流在两管间换流）与按真实 Lr/频率/负载算 di/dt；数值结果不是硅片断言。

---

## 13. 作者追加（2026-10-31）：`VTHOFF`/330 µA 规格容差角

§8–§12 全用 typ 值，留下“真实片子分散能否救回某个固定 Roffset”的问题。本节按手册 min/max 组合 12 个实跑角（`sr_corner_*`），完整表见 `sr_commutation_v3_results.md` §11。

- **VDS 峰值对负载严格线性：1.647 mV/A**（10/25/40 A 实测 16.47/41.17/65.87 mV）。固定门槛的最小可关断负载 `I_min = VTHOFF_eff / 1.647 mV/A`。
- **40 A/120 Ω worst-case（18 mV、400 µA）= 66.0 mV > 65.87 mV 峰值 → 完全不关断**：IREV 40 A、QREV 63.66 µC、EBD 0；typ 角 QREV 48.5 nC，差 1300 倍。裕量只有 0.13 mV。
- **25 A/50 Ω worst-case（38.0 mV vs 41.17 mV）**仍关断但 IREV 1.60→7.16 A、QREV 56→874 nC，恶化 15 倍。
- **0 Ω 救不了 10 A/18 mV**（16.47 < 18 mV，且 Roffset 只能抬高门槛）；0 Ω 最小可关断负载 10.9 A（max 片）/ 6.4 A（typ 片）。
- **降门槛不更安全**：10 A 从 10.5→2 mV，EBD 0.357→1.665 µJ（4.7×）；40 A 5.999→7.992 µJ。最优在内部（`≈0.76–0.91×峰值`）。
- **总判定（限本台架）：没有固定 Roffset 能覆盖本受迫正弦台在规格散布下的 10–40 A**；0 Ω 与 120 Ω 分别在轻载/重载以“完全不关断”失效。这**不构成“固定电阻方案关闭”**，也不排除真实硅片上的 0 Ω Kelvin 基线；0 Ω 仍为默认候选并保留 Roffset 调试焊盘，下一步必须用双 SR 真实谐振换流台验证实际 `di/dt`。
- 边界：min/max 未必同片共存；模型比较器无迟滞/噪声；10 A/18 mV 为解析结论（临界不收敛，未实跑）；仍须用真实 LLC 的 `di/dt` 重算 1.647 mV/A 斜率。手册待机判据不构成故障应力兜底。

---

**状态：** §7 第 5 条中“2–18 mV 关断窗口改为 Roffset 实验”可标为**行为等效已完成且容差角已做（§13）**，结论是**在本受迫正弦台 + 估计寄生 + 未校准 PGD 下，没有固定 Roffset 能覆盖规格散布的 10–40 A**（§11–§13）；这不足以关闭 0 Ω Kelvin 基线，OFFTH 窗口是否需负载相关或 di/dt 相关方案，须由双 SR 真实换流台决定。阻断项 2（PGD 律）、3（off-blank/interlock 刺激）、5 的其余部分（155/275 ns、1.4–1.7 V ARM）、6（温度/漏极开关时间）仍未关闭。数值完成 ≠ 硬件验证。
