czy0126/CZY/design/v2/sr_commutation_results.csv

step | uncalibrated_PGD | off_delay_ns | reverse_peak_A | reverse_charge_per_cycle_uC | gate_overlap_above_2V_ns
1 | 0 | 5.5 | 8.94220924377 | 0.8157012070371666 | 0.0
2 | 1 | 5.5 | 7.49837112427 | 0.5714125109999374 | 0.0
3 | 0 | 23 | 9.79005336761 | 0.9777768485390764 | 0.0
4 | 1 | 23 | 8.33216190338 | 0.7063655945597876 | 0.0
5 | 0 | 40 | 10.6546010971 | 1.1543586048363306 | 0.0
6 | 1 | 40 | 9.16302394867 | 0.8554121146490378 | 0.0
