czy0126/CZY/docs/D1_故障验收与制造证据补漏_2026-11-02.md

# 2026-11-02 增量审核、故障验收修补与 D1 工程交付清单

> 基线 `main@b2c013b1b7d0fdcdc935bb5cc1e2d61d94dc06ad`；本文件只记录新的**可验证代码修补和下一步实际操作**，旧综述不重复。全部电气功率/效率是 LTspice 模型值，不是实物额定。详细热和冷板继续暂缓，不免除过流/绝缘/器件安全审查。

## 1. 本次最新状态与最优先缺口

1. D1 原生原理图已有 **83 个逻辑位号**，但五只磁件没有厂商提供的物理 pad/DOT 图、61 个占位件尚未选完真实 MPN、GUI ERC 和有网 PCB/DRC 仍缺，制造 Gate 仍为 **`NOT_FOR_FAB`**。
2. 已运行的 50 V/120 A 目标电路实际得到 **119.27 A、231.87 W**（仿真）；能量分项相对端口损耗差 **+0.499 W**（133 周期相位对齐窗口复算 **+0.492 W**，sem 0.050 W，已排除短窗伪影），0.2 W 目标未达到。端口效率 93.716% 可作模型计算值追溯，**不能作为已闭合的工程效率**。
3. 48 V/120 A 真冷启动运行到 8 ms，但 8.7 倍过载在 `Vss=3.78 V` 的软启动途中投入；故障仿真只到 **7.5714 ms**，不代表稳态后故障或完整恢复。其跳闸前原边峰值约 **84.83 A**、单只 SR 模型瞬态正向峰值约 **255 A**，需要 SOA/磁件首件核验。
4. Lr 用 1 µH、130 mm² 核心截面及现有峰值计算：2 匝磁通约 **0.326 T** 超过项目 0.279 T 设计限；3 匝约 0.218 T 只是候选，不是物料批准。

**1.1 本地执行结果（2026-11-02，两份 deck 都已实际运行）**

- **48 V/120 A：通过严格日志校验**（`sim/v3/sr_tank_dual_v33_ss_hotfault_48v_120a.validation.json`，状态 `LOG_PRECHECK_PASS_REQUIRES_WAVEFORM_AND_DEVICE_REVIEW`）。554.498 s、1.052 GB、320 µs 跑满；故障前 `V(ss)=5.04484 V`、`V(out)=1.87388 V`、半窗漂移 5.5e-5；trip 40.10 µs、`I(Lr)` 峰 **97.443 A**、SR 正向峰 **292.61 A**、故障支路峰 858.9 A。**合并 PR #21 后基座 deck 增加了 `HOT_VOUT_EARLY/LATE` 两个 `.meas`，旧日志没有它们，因此 2026-11-02 22:15 用当前 deck 重跑（544.086 s）**：raw 与旧文件只差 `Date:` 头 5 字节（`cmp -l`），数值逐位相同；日志现给出双窗均值 **1.873933 / 1.873830 V**（相对漂移 5.505e-5），`..._48v_120a.validation.json` 的 deck/log sha256 已随之更新。50 V 日志没有 `.meas` 块（PID 终止），两个 `*_diag` 日志也早于这两行——它们只影响日志，不影响 raw。
- **50 V/120 A：只有前缀，未通过校验**。求解器在 **296.929 µs** 塌缩（62 min 内保存时间只前进 1 ns，同期写约 10 GB），日志无 `Total elapsed time`，校验器 fail-closed、不产生报告。前缀内 trip 39.92 µs、`I(Lr)` 峰 **101.263 A**、SR 正向峰 303.93 A——**引用必须标注"前缀"，不得写成跑完**。**前缀内的峰值已用 `SOLVER_DIAGNOSTIC` 量化**：同一电路只把 `trtol` 7→1、`abstol` 1e-12→1e-13、保存轴停在 220 µs，重解得 `I(Lr)` 峰 101.099 A（**−0.16 %**）、SR 正向峰 303.937 A（**+0.002 %**）、trip 早 81 ns；见 `hotfault_50v_120a_diag.json` 与 `48V120A_稳态初始化故障_2026-11-02.md` §3.4。塌缩本身仍未解决。48 V 对照组（跑满 320 µs、通过严格日志校验）同窗口移动 −0.42 %（`I(Lr)`）/ −0.41 %（SR 正向）、trip 早 185 ns：两组都因收紧容差而变小（方向保守），但量级说明峰值精度是**亚百分点**。
- **trip 后模型行为需要单独记录**：主桥停振、`V(ss)` 在约 35 µs 内从 5.07 V 跌到 0.088 V，但**有一相 SR 门极被重新拉高并保持**（48 V 为 A 相，50 V 为 B 相，10.89 V）。`sr_timing_v3_3` 用漏源反向偏置关断；锁存后该通道仍是**正向** 1.63 A、VDS≈1.5 mV，没有反向偏置可触发关断。**这不是待机缺失**：datasheet 的 `tSTBY_DET` 是 7.5 ms，比故障后窗口（约 0.1 ms）长两个数量级，补 standby 也不会在窗口内触发。50 V 的塌缩是**数值**问题（死区轨迹平滑 ~3 V/µs，步长却压到 1e-15 s），只能靠 `SOLVER_DIAGNOSTIC` 运行或接受前缀；**本记录已选择接受前缀**（应力事件在 214.9 µs 全部结束，都在可读前缀内）。
- **应力结论**：稳态故障比软启动中的故障高 **15–19 %**，Lr 磁通判据必须按 **101.26 A** 讨论（2 匝 0.3895 T、3 匝 0.2596 T）。详见 `design/v3/power_priority/48V120A_稳态初始化故障_2026-11-02.md`。

## 2. 本次修复：让“成功运行”不再冒充“有效故障证据”

- `tools/validate_hotfault_log.py` 新增严格验证：必须有相应 `Circuit:` 文件名、`Total elapsed time`、有效 RAW 头部、完整 HOT_* `.meas`。检查故障前 `Vss` 在 **4.8–5.1 V**、`Vout` 与同工况现有稳态值相差不超过 max(0.02 V, 2%)、`V(oc)<1V`，并要求控制信号从低电平转为高电平、Rflt 支路确有大于 1 A 的故障电流、`V(oc)` 达到 1 V，首次达到阈值的时间落在故障注入之后。
- **与 deck 实际一致的时间口径**：绝对仿真 `2175 µs` 投入故障，LTspice 保存 `2000–2320 µs`，因此日志/RAW 保存轴的故障时间仍是 `175 µs`；只接受 `175–320 µs` 的过流跳闸。**为什么拉到 2 ms**：`.ic V(ss)=4` 起跑后软启动只有 0.5 mV/µs，1 ms 时仅 4.485 V，达不到 4.8 V 门槛；2 ms 自然到 ~5.0 V，不靠伪造 `.ic`。
- `tools/make_hot_fault_decks.py` 与两个源 deck 已增加 `V(ctl_hot)`、`I(Rflt_hot)` 的真实仿真存储和 `HOT_CTRL_BEFORE / HOT_CTRL_AFTER / HOT_IFLT_AFTER` 检测，避免“OC 恰好抬升但故障开关并未导通”的假阳性。
- `tools/run_dcx_pending_cases.ps1` 默认只处理 48V/50V 120A hot-fault。仍需用户明确指定 `-Execute`；运行前拒绝覆盖已有 RAW、LOG、validation 结果，避免耗时运行后才被拒绝。成功求解后调用严格验证器，只有日志证据有效才产生 `*.validation.json`。
- **重要证据等级**：validator 输出状态为 `LOG_PRECHECK_PASS_REQUIRES_WAVEFORM_AND_DEVICE_REVIEW`，绝非 `PROTECTION_APPROVED`。即使日志门槛通过，也须独立读 RAW 复核 OC 实际栅极关断、换流峰值、短路 I²t、可能的负压/反向恢复以及故障恢复，不批准真实器件 SOA、热稳态或连续额定。

### 本地复现（Windows，真实 LTspice）

```powershell
# 只检查文件，不执行
pwsh -File tools/run_dcx_pending_cases.ps1
# 真正执行两组尚未运行的热初始化后故障模型
pwsh -File tools/run_dcx_pending_cases.ps1 -LTspice "C:\Program Files\ADI\LTspice\LTspice.exe" -Execute
```

若求解器提前终止、故障开关未导通、OC 无越限、故障前不稳定，均应返回**非零退出**并保留原始 LOG/RAW 供排查。历史 48V/120A 真冷故障的 7.571ms 前缀**不得**通过此检查。

## 3. 本次修复：D1 投板证据缓存不得覆盖最新导出

原 `tools/d1_fabrication_gate.py` 使用静态 `netlist_compare.json` 的 `subset_ok`。实际 `gen/netlist_export_raw.json` 更新后，**即使焊盘接错**，也可能继续拿历史缓存的绿色检查作为证据。现在每次执行 D1 Gate 都直接调用 `check_main_board_netlist.compare()` 对导出的真实引脚网络重新比对；同时要求原报告与当前计算**完全一致**。若任一端焊盘或网络发生修改，直接生成差异并阻止放行，不能靠旧缓存过关。

**限制**：这只保证**已提交的导出网表与原始模型/缓存一致**。真正 GUI 保存并重新打开的原生 `.eprj2`、自制磁件 physical-pad、真实封装和原厂引脚仍然必须独立验证；静态导出本身不能证明 PCB 工程制造可行。

## 4. 后续五个工作日：责任角色与验收要求

| 工作日 | EDA/供应商主线（最高优先级） | 仿真/保护主线（完全并行） |
|---|---|---|
| **D1** | 确定厂商返回 T1–T4/CT 的尺寸图、实际焊盘号、DOT 和 CTAP 连接，落实 `vendor_terminal_request.json` 的填表人；将 61 位号划分为关键件和常规 R/C 两组 | 在 Windows 本地运行两份 hotfault deck；无原始 LOG/RAW 时不得上报任何模拟故障峰值 |
| **D2** | 确认变压器 5 端、CT 4 端的真实连接结构；同步提供实际 Lr 三匝小信号及故障电流 `L(I)` 测试方案 | 对 `*.validation.json` 检查前态/故障电流/跳闸，使用 RAW 逐通道复核 OC 动作和 SR 峰值 |
| **D3** | 在原生嘉立创工程中完成已确认的 MPN/footprint，保存、退出、再打开；导出完整全板网表及 ERC 原文 | 对 50V/119.27A 工况同窗追踪 +0.499 W：SR、磁件/Cr、CT 和门极驱动的功率边界，保留 0.2 W 指标 |
| **D4** | 从**已验证原生工程**导入真实网络 PCB，优先四组 SR、Cout 与输出铜回流，标出 CT、Lr、端子、Kelvin 回流及沉槽限制 | 如果 fault prefix/新的 hotfault 不完成，最小化数值故障复现并保存退出前日志，不改为用 100A 峰值推断 |
| **D5** | 运行 GUI ERC/PCB DRC，针对实际 pad 与制造叠层做厂商 DFM；准备 BOM、Gerber、钻孔、坐标、装配与生产版本清单 | 依据真实模型和供应商 L(I)/SOA 资料收敛高输出电气额定，不能免除后续热认证 |

**最短关键路径**：磁件真实端子与封装 + 61 位号第一批真实 MPN → 原生 EDA 保存重开/GUI ERC → PCB 导入真实网络/布线 → DRC/DFM → 条件投板评审。模型热故障与损耗闭合属于保护与额定并行路径，**不应要求 EDA 组无止境等待新的综述或仿真**；但若发现故障电流无法被真实磁件/MOS承受，则必须立即冻结对应硬件设计并 ECO。

## 5. 不允许误关闭的事项

- Issue #9：厂家真实脚号、61 件选型、GUI/ERC、带网 PCB 仍缺；逻辑网表 PASS 不等于投板。
- Issue #6：100 A 门极边界纠正后，**四档**步长 5/2/1/0.5 ns 的周期平均闭合残差是 **+0.108/+0.097/+0.091/+0.304 W**——只有三档在 0.2 W 内，0.5 ns 档在外，四档散布 0.213 W；SR 体二极管正向耗散跨四档变化 **2.334 W**（通道项只动 0.052 W）。所以"后处理后约 0.09 W"不能读成"已定位并修掉 0.09 W 物理耗散"。50 V/120 A 另有 **+0.492 W**（133 周期相位对齐；22 周期为 +0.499 W）未闭合，且 deck 内已无未计入的耗散元件（`tools/test_loss_inventory_is_complete.py` 锁住映射），**目标仍 0.2 W**。**"钉住负载再比"这条建议已经执行**：恒流负载能把 `I_out` 钉在 100 A（5 ns 档复现电阻档到 0.3 %），但 0.5 ns 档仍高 **15.1 mV**、保留 5→0.5 ns 端点损耗差的 **98.9 %**——钉住的是电流，不是 `V(out)`；理想电压源与调节式电流阱都因 SR 控制器"负载触发启动"而不可用。唯一剩下的收敛判法是把 `V(out)` 闭环钉住，那是新 deck，不在现有 100 A 母 deck 内。
- Issue #12：Lr 两匝在最新故障峰值下估算超磁通设计限，三匝/气隙/饱和/接点仍要厂商首件验证；热/冷板详细设计后置。

```bash
python tools/make_hot_fault_decks.py
python tools/d1_unclosed_risks.py
python tools/d1_fabrication_gate.py
python -m pytest tools -q
python tools/ci_check.py
# 正常应失败，直到所有制造验收资料完备：
python tools/d1_fabrication_gate.py --require-release
```

**本次不会生成虚假的 .raw/.log、供应商签名图、真实 MPN、或宣称 PCB 已完成。** 下一次 PR 理应包含至少一组可验证 hotfault 求解、原生 EDA GUI/ERC 证据、或磁件/料号实物文件，而非另一份没有工程推进的计划。
