czy0126/CZY/design/v3/power_priority/PROT02_独立故障锁存候选对照_2026-11-03.md

# PROT-02 独立故障锁存候选对照（48 V/120 A，2026-11-03）

> 证据等级：**SIMULATED_ONLY / NOT_HARDWARE / NOT_A_SAFETY_PROOF**。
> 这是两个行为模型候选的对照，不是保护电路签核，也不是器件 SOA 结论。
> 50 V 覆盖的是 `cshunt=1 fF` 收敛子变体（50 V 基座仍在 296.929 µs 塌缩），
> 且与母 deck 不是配对比较（§5.5）；PROT-03 补跑了两族控制 deck，
> **故障前配对成立的那一族窗口不完整**（§5.6）；重启时序只在**逻辑级子电路**里
> 验证过（§4.5），功率级没有重启动；比较器噪声、门极回路电感、热与 SOA 全部没有建模。

## 1. 这两个候选回答什么

ELE-10 测到：48 V 故障后 A 相四只 SR 门极在 trip 后被重新拉高并保持（末端 10.890 V），
而 50 V 基座在 296.929 µs 塌缩、只有前缀。PROT-02 要的下一件事是
**一个不依赖 UCC25600 的独立锁存，把主桥两只和八只 SR 同时关断**，
并回答"OC 达到 1 V 再动作"是否够用。

因此先做三个 48 V deck（都由同一个 48 V 八探针母 deck 派生，只追加保护块）：

| case | 触发 | 阈值 | 屏蔽 | 作用 |
|---|---|---|---|---|
| `prot_a_oc1v` | 现有滤波后的 `V(oc)` | 1.0 V | 软启动后有 | 只换**执行路径**，保留原 OC 判据 |
| `prot_b_fast10u_1p8v` | `V(ocd)` 经 10 µs 低通 | 1.8 V | 软启动后有 | 测**更快的独立检测**能不能真的减小应力 |
| `prot_b_unarmed` | 同上 | 1.8 V | **无** | 负对照：不做软启动屏蔽会怎样 |

三个 deck 都含：12 V 专用偏置 `Vddp`、UVLO 检测（低于 8 V 直接置 inhibit）、
置位优先的锁存、十个 0.05 Ω 有源下拉（`Sgh gh sw` / `Sgl gl 0` / `Sga1..4` / `Sgb1..4`）。

50 V 上 A/B 用同一个保护块，但父 deck 换成唯一跑满 320 µs 的
`cshunt=1e-15` 八探针子变体（见 §5）。

## 2. deck 是怎么构造的（只加不改）

`tools/make_protection_candidates.py` 只做三件事：加头注、在 `.save` 块尾追加探针、
在 `.end` 前插入保护块。`tools/test_make_protection_candidates.py` 把这三段逐行剥掉后
与母 deck 逐行比对，必须完全相等；另有一条测试锁住"十个钳位一个都不能少"。
所以 base 与 candidate 的差 **只有保护路径**，功率电路、故障支路、`.tran` 逐字节相同。

> 两个已跑完的 deck 在运行后只改过**注释行**（把"锁存只在 UVLO 掉电时清除"改成
> 明确说明本模型**从不清除**）。用去掉 `*` 行的方式与运行时的快照比对：
> A/B 各 183/186 行非注释行 **0 处差异**，因此已产出的 raw 仍然对应当前电路。

## 3. 负结果：不屏蔽的 1.8 V 快速路径在启动时就锁死

第一次跑 PROT-B（当时还没有屏蔽）只用了 54 s，看起来"跑得很快"。读 raw 才发现：

| 量 | 第一个保存采样点（175 µs 保存轴） |
|----|---|
| `V(prot)` | 0.998 V |
| `V(inhib)` | 1 |
| `V(out)` | 1.5e-8 V |
| 窗口内 `I(Lr)` 峰 | 0.0018 A |

锁存在**保存轴之前**（0–2 ms 那段没保存的预历史）就已经置位，主桥被关断，
整个 320 µs 窗口记录的是**一台已经停机的变换器**。
54 s 的运行时长短只是因为电路是静息的，不是求解器变快。

这不是数值问题，是保护逻辑问题：冷启动/软启动的冲击电流会让 `V(ocd)` 越过 1.8 V。
所以三个候选现在都带一个**单向 arming 锁存**：`V(ss) > 4.8 V` 之后才允许置位
（软启动稳态是 5.05 V，留 0.25 V 余量，arming 大约发生在 1.6 ms 绝对时间）。

`prot_b_unarmed` 作为可复现的负对照保留：它现在仍会复现上面的读数，
并且 `checks.the_pre_fault_operating_points_match_within_1_mv` 与
`checks.the_candidate_was_armed_before_the_fault` 都为 **false**——这是**故意**的，
它证明比较工具不会把一个启动就锁死的候选当成"关断很有效"。

## 4. 48 V 实测

母 raw：`sim/v3/sr_tank_dual_v33_ss_hotfault_48v_120a_srprobe.raw`
（320 µs 跑满，trip 215.0967 µs）。两个候选都跑满 320 µs。

### 4.1 触发与锁存

| case | 触发时刻 | 相对母 deck trip | 锁存时刻 | 触发→锁存 |
|---|---|---|---|---|
| A | 215.0944 µs（`V(oc)`=1 V） | **早 2.27 ns** | 215.1637 µs | 69.3 ns |
| B | 185.3510 µs（`V(ocdf)`=1.8 V，故障后 10.35 µs） | **早 29.746 µs** | 185.4203 µs | 69.3 ns |

- A 的触发与母 deck 的 `V(oc)>1 V` 是**同一个判据**（差 2.27 ns 是求解器采样），
  它只证明了"执行路径"能工作。
- 69.3 ns 是模型里 1 nF / 10 V/µs 的置位常数决定的，**不是**比较器或驱动器的传播延迟。
- B 的 `V(ocdf)` 故障前峰值 **1.0412 V**（最低 0.9904 V），距 1.8 V 门槛 **0.759 V**；
  A 的 `V(oc)` 故障前峰值 0.6965 V，距 1.0 V 门槛 0.304 V。

### 4.2 应力

| 量 | 母 deck | A | A 相对 | B | B 相对 |
|----|---|---|---|---|---|
| `I(Lr)` 峰 | 97.4427 A | 97.4368 A | −0.0061 % | **45.9432 A** | **−52.85 %** |
| SR 正向峰 | 292.608 A | 292.581 A | −0.0090 % | **138.247 A** | **−52.75 %** |
| SR 正向 I²t（八只合计） | 4.4561 A²s | 4.4250 A²s | −0.699 % | **0.2155 A²s** | **−95.16 %** |
| 门极导通期间的 I²t | 4.0081 A²s | 3.8572 A²s | −3.77 % | 0.1977 A²s | −95.07 % |
| `V(out)` 最低 | −7.930 mV | +0.679 mV | +8.61 mV | +0.065 mV | +8.00 mV |

**这就是"不得仅凭 OC 达 1 V 放行"的量化依据**：母 deck 的 `I(Lr)` 峰出现在
209.95 µs，而 `V(oc)` 到 1 V 是 215.10 µs —— **OC 判据比峰值晚约 5.1 µs**。
所以 A（保留原判据、只加执行）对峰值的影响是 **0.006 %**，等于零；
它唯一做到的是把 trip 之后的 A 相门极锁存去掉（见 §4.3）。
B 把动作提前到故障后 10.35 µs，才真正把峰值和 I²t 压下来。

### 4.3 十只门极的末态（逐只）

| case | 主桥 `gh`（对 `sw`） | `gl` | SR 1a–4a | SR 1b–4b |
|---|---|---|---|---|
| 母 deck | 未钳位 | 未钳位 | 末端 **10.890 V 高** | 末端低 |
| A | 末端 0.0 V | 0.0 V | 末端 4e-5 V | 末端 −4e-5 V |
| B | 末端 0.191 V | 0.0 V | 末端 −2e-5 V | 末端 2e-5 V |

- 十个钳位从锁存时刻起全部生效；A/B 的八只 SR 在锁存后**没有任何一只再拉高**
  （`last_high` 都等于锁存时刻或更早），逐只延迟在采样分辨率内为 0。
- 主桥关断延迟：A 0.235 ns，B 0.496 ns（同样是采样分辨率，不是驱动器延迟）。
- `gh` 的 0.191 V 残压是 0.05 Ω 钳位对 3.2 Ω 集总门阻的分压（≈10.9×0.05/3.25），
  不是"没关断"；`gh` 是浮动节点，必须用 `V(gh)−V(sw)` 量，用对地电压会在 `sw` 停在高位时读错。
- 逐只正向 I²t（A 相 / B 相）：母 deck 0.5663 / 0.5477 A²s；
  A 0.5650 / 0.5412 A²s；B **0.0330 / 0.0209 A²s**。
- 逐只漏源最低电压：母 deck −4.775 / −4.890 V；A −4.782 / −4.899 V；
  B **−1.900 / −1.817 V**。

> 48/50 V 全部运行（含本节的候选）的逐只 `Vgs`/`Vds`/`Id`/反向峰/I²t 合并表在
> `PROT_SOA表_2026-11-03.md`（D4 筛选清单；没有厂家 SOA，候选对照也不保存反向峰）。

### 4.4 失压默认关断（子电路）

`sim/v3/prot_latch_uvlo_check.cir` 用一个 3.2 Ω 驱动的假门极验证偏置消失：
`Vddp` 在 100 µs 掉到 0，`V(g)` 从 **10.0 V** 降到 **0.154 V**，`inhib` 恒 1，
`arm` 在掉电前已置 1。这只证明锁存与一个钳位，**不证明**整个功率级。

### 4.5 重启安全时序（逻辑级子电路）

功率级做不出完整重启：UCC25600 的软启动是 5 µA 灌 10 nF（**0.5 mV/µs**），
UVLO 掉电后 `V(ss)` 要从 0 重新爬到 4.8 V，需要 **9.6 ms**，比故障窗口（320 µs）
长一个半数量级。所以重启时序单独做一个逻辑级子电路
`sim/v3/prot_latch_restart_check.cir`（由同一个生成器输出，
`tools/protection_candidate_compare.py --restart-raw` 出 JSON）：

| 时刻 | 激励 | 期望与实测 |
|---|---|---|
| 60 µs | `V(oc)` 脉冲越过 1.8 V | 已 arming ⇒ 锁存置位（0.99998），假门极被 0.05 Ω 钳到 **0.154 V** |
| 100–120 µs | `Vddp` 掉到 0 再回 12 V | `inhib` 全程 1；`prot`/`arm` 被 UVLO 分支清零（**1.2e-83**） |
| 2.0 ms | `V(oc)` 脉冲（此时 `V(ss)`≈1.06 V） | **不得**锁存——峰值 **2.2e-87** |
| 9.72 ms | `V(ss)` 越过 4.8 V | arming 锁存重新闭合（**9.72007 ms**，软启动越点 9.72000 ms） |
| 10.3 ms | `V(oc)` 脉冲 | 重新锁存（0.99998），门极再次 **0.1538 V** |

掉电期间 `inhibit_min = 1`、`V(g) = 0.1538 V`（0.05 Ω 钳位对 3.2 Ω 驱动的分压，
不是"没关断"）。`sequence` 十项全真，`restart_sequence_verified = true`
（`design/v3/power_priority/protection_restart_check.json`）。
raw 末端 10.599995 ms：LTspice 停在最后一个内部步，覆盖检查允许 10 ns。

> **这里抓到一个真 bug**：`Bprot` 的清除项原来写成 `-V(prot)*(1n/TAU)`。
> B 源的正电流**离开**节点，所以 `-V` 是正反馈——重启 deck 第一次跑到 **1e86**。
> 正确写法是 `+V(node)*(1n/TAU)`。五个功率级候选与 UVLO 子电路里这一行
> 从未被执行过（`Vddp` 恒 12 V ⇒ `V(uvlo)≡0`，分支恒不选中），所以已发布的
> 数字不受影响；但任何**掉电重启**都会立刻发散。
> 现在由 `test_the_latch_clear_terms_drain_the_capacitor` 锁住，五个候选 deck
> 各改了这一行（净效果为零，分支不可达）。另外 `.tran` 最大步长必须远小于
> τ = 100 ns：100 ns 步长下这个显式积分器同样发散，现在固定 **10 ns**。

这个子电路**只证明逻辑顺序**：理想 PWL 源、没有功率级、没有 UCC25600 的
Level-1 OC、没有真实驱动器。尤其注意：**屏蔽斜坡期间门极仍然被驱动**，
那一段的保护只能靠控制器自己的 OC——本 deck 没有建模。20 µs 掉电与
`TAU_PROT = 100 ns` 都是选定的模型参数，不是器件复位时间。

## 5. 50 V（cshunt=1 fF 收敛子变体）

50 V 基座仍在 296.929 µs 塌缩，唯一跑满 320 µs 的 50 V 解是 `cshunt=1e-15` 的
八探针子变体。两个候选直接建在它上面：`.options`、电路、故障支路、`.tran` 与它逐字节相同
（`strip_insertions` 测试按每个候选**自己的父 deck** 逐行比对），只追加保护块与探针。

| case | 运行时长 | raw | 覆盖 |
|---|---|-----|---|
| A | 1301.714 s | 2.48 GB | 320 µs，日志有 `Total elapsed time` |
| B | 1371.595 s | 2.16 GB | 同上 |

### 5.1 触发与锁存

母 deck 的 `V(oc)=1 V` 在 **215.0144 µs**。

| case | 触发 | 相对母 deck trip | 锁存 | 触发→锁存 |
|---|---|---|---|---|
| A | 215.1704 µs（`V(oc)`=1 V） | **晚 0.156 µs** | 215.2397 µs | 69.3 ns |
| B | 185.2703 µs（故障后 10.27 µs） | 早 29.744 µs | 185.3396 µs | 69.3 ns |

A 在 50 V **不再与母 deck 同一时刻**：它的故障前 `V(out)` 比母 deck 高 13.2 mV（§5.5），
故障电流因此略有不同，OC 越点晚 156 ns。48 V 上这个差是 2.27 ns。
B 的 1.8 V 门槛在 50 V 故障前滤波峰值 **1.0389 V**（35 µs 窗口），余量 0.76 V，
与 48 V 的 0.759 V 相当，所以门槛不需要按电压重调。

### 5.2 应力

| 量 | 母 deck | A | A 相对 | B | B 相对 |
|----|---|---|---|---|---|
| `I(Lr)` 峰 | 101.096 A | 100.988 A | −0.107 % | **45.787 A** | **−54.71 %** |
| SR 正向峰 | 303.496 A | 304.960 A | **+0.482 %** | **139.354 A** | **−54.08 %** |
| SR 正向 I²t（八只合计） | 4.7547 A²s | 4.6558 A²s | −2.08 % | **0.2149 A²s** | **−95.48 %** |
| 门极导通期间的 I²t | 4.2604 A²s | 4.0378 A²s | −5.22 % | 0.1855 A²s | −95.65 % |
| `V(out)` 最低 | 0.743 mV | 0.742 mV | −0.001 mV | 0.071 mV | −0.672 mV |

**A 的 SR 正向峰在 50 V 反而升高 0.48 %**：这不是钳位造成的（钳位到 215.24 µs 才动作），
而是故障前工作点高了 13.2 mV。A 的 I²t 下降 2.08 % 来自 trip 后切断 SR 导通。
B 的结论与 48 V 一致：峰值与 I²t 大幅下降，且降幅（−54.7 % / −95.5 %）与 48 V 的
（−52.9 % / −95.2 %）同量级。

### 5.3 十只门极的末态

- A/B 的十只门极在锁存后全部拉低，末端八只 `V(ga*)`/`V(gb*)` 在 ±0.1 mV 内，
  `V(gl)=0`；`V(gh)−V(sw)`：A 0.0 V、B 0.1917 V（0.05 Ω 钳位对 3.2 Ω 集总门阻的分压，
  与 48 V 的 0.191 V 相同）。
- 50 V 母 deck 的八只 SR **末端本来就是低**（cshunt 解选取的末态与 48 V 不同），
  它 trip 后在 232–237 µs 有两段短暂再导通；候选在 215.24 µs 锁存后把这两段也切掉。
- 逐只 `last_high` 都等于锁存时刻（215.24 / 185.34 µs），逐只延迟在采样分辨率内为 0。
- 主桥关断延迟：A 0.262 ns、B 0.530 ns，同样是采样分辨率，不是驱动器延迟。

### 5.4 50 V 记录的边界

- 这是 **cshunt=1 fF** 记录：不含该选项的 50 V 基座仍在 296.929 µs 塌缩，
  所以"50 V 已覆盖"必须写成"50 V **cshunt 子变体**已覆盖"。
- 候选 raw 在同一 35 µs 窗口里有 141k（A）/ 152k（B）个点，母 deck 只有 61k，
  说明保护节点让求解器压步长；这也是 1300 s 级运行时长的主要来源。

### 5.5 故障前工作点偏移：50 V 的对照不是配对的

同一条 35 µs 故障前窗口上，候选的 `V(out)` 均值比母 deck 高 **13.2 mV（A）/
17.5 mV（B）**（母 deck 1.9438 V）。48 V 的同一检查在 1 mV 内。

偏移在保存轴开始前就形成：t = 140 µs 时已经是 +10.9 mV（A）/ +19.9 mV（B），
到 175 µs 是 +15.5 / +23.0 mV。所以它不是保护动作，而是**保护节点改变了求解器路径**
（cshunt 下的步长选择），也就是 cshunt 记录本身的可复现性边界。

`checks.the_pre_fault_operating_points_match_within_1_mv` 因此为 **false**，
这是有意的诚实报告，不是工具坏了。量级判断：0.7–1.2 % 的工作点偏移不能产生
−54.7 % 的峰值下降；但 50 V 的百分比应读作"不同工作点上的对照"，
不是配对差值。要真正配对，需要一条**节点结构与候选相同、但不动作**的控制 deck——
PROT-03 补了两族，见 §5.6：配对成立的那一族**跑不满 320 µs**。

### 5.6 PROT-03：配对控制与它的边界（2026-11-03 补跑）

给每个 50 V 候选派生了两族控制，都由 `tools/make_protection_candidates.py --write`
从候选**本身**生成（`--no-clamp` / `--threshold-muted`），母 deck 是候选而不是父 deck：

| 控制 | 唯一改动 | 故障前 `V(out)` 差 | 覆盖 |
|---|---|---|---|
| `_thrmute_control` | `Bprot` 常数 1.0/1.8 V → **100 V** | **0.000000 mV** | 停在 **250.151 µs（A）/ 254.980 µs（B）** |
| `_noclamp_control` | 开关模型 `Vt .5` → **10** | 13.2 / 17.5 mV（与母 deck 相同） | 跑满 320 µs |

两族各满足验收的一条、各不满足另一条：

- **thrmute 精确配对**：A 有 961 298 个采样点（到触发 215.1704 µs）与候选**逐点相同**，
  `max|ΔV(out)| = 0.000e+00`；B 有 824 449 个点逐位相同（到触发 185.2703 µs）。
  35 µs 故障前窗口均值两边都是 **1.956990711962 V（A）/ 1.961266668441 V（B）**，
  差 **0.0 mV**，`checks.the_pre_fault_operating_points_match_within_1_mv` 为 **true**。
  但它**塌缩**：日志没有 `Total elapsed time`，raw 停在 250.151/254.980 µs
  （3.01/3.91 GB，末段在压步长），所以"两个 320 µs 窗口均完整"**不成立**。
- **noclamp 完整但不配对**：`Vt=10` 不是"断开"的近似——`sim/v3/prot_switch_leak_probe.cir`
  用两个开关 + 0 V 检测源实测（`prot_switch_leak_probe.log`），`Vt=.5` 与 `Vt=10`
  的漏流都是 **1.001e-9 A**（`Roff = 1 GΩ`），电学上完全开路；它跑满 320 µs，
  但故障前差仍是 **13.2/17.5 mV**。

**结论：PROT-03 的判据没有满足**——配对成立时窗口不完整，窗口完整时配对不成立。
这不是工具故障：`protection_candidate_compare.py` 把比较窗口自动截到较短者，
`coverage.declared_window_fully_covered = false`，`limits` 里写明
"the common slice ends at 250.151 us"。

在**精确配对、截断到 250.151/254.980 µs** 的切片上（这才是可归因于保护的量）：

| 量 | A 相对 | B 相对 |
|----|---|---|
| `I(Lr)` 峰 | **0.000 %** | **−54.67 %** |
| SR 正向峰 | **0.000 %** | **−54.31 %** |
| SR 正向 I²t（八只合计） | **−0.58 %** | **−95.39 %** |
| `V(out)` 最低 | −1.56 mV | −51.78 mV |

A 的峰值差**恰好为零**：两个 deck 在 215.2397 µs 锁存之前是同一条波形，
而 `I(Lr)` 峰在 209.95 µs；它的 I²t 收益只来自锁存后的 35 µs。
B 的动作在 185.34 µs、早于峰值，所以切片上仍保留 −54 % 的峰值收益，
三个量与全窗读数（−54.71 / −54.08 / −95.48 %）几乎相同——应力集中在故障后 50 µs。
候选在 250 µs 之后的 SR 正向 I²t 已经可以忽略（A 4.655756624 对 4.655756691 A²s），
所以截断损失几乎全部落在**控制**一侧：控制的三只/四只 SR 在 250 µs 后重新导通并继续累积。

末态门极相位仍由求解器选择：A 的控制停在 2a/3b/4a 为高，B 的停在 1b/2b/3a/4a 为高，
候选八只全低。这与 §4.3/§5.3 的"锁存相位是求解器选的、不是电路属性"是同一条边界。

## 6. 结论与它不能说明什么

可以说的：

1. 一个**独立于 UCC25600** 的锁存能把十只门极同时拉低，48 V 故障窗口内没有一只 SR 再拉高。
2. **原 OC 判据（1 V）动作太晚**：它在 `I(Lr)` 峰值之后约 5.1 µs 才到，对峰值没有作用。
   30 µs 的提前量来自 10 µs 低通 + 1.8 V 门槛的独立路径，不是来自 OC。
3. 快速路径**必须**软启动屏蔽；否则启动冲击就让锁存置位，整机在故障前已经停机。
4. 50 V 的 `cshunt=1 fF` 子变体上复现了同样的排序：A 对峰值几乎无作用（−0.11 %，
   SR 峰甚至 +0.48 %），B 把峰值压低 54.7 %、I²t 压低 95.5 %。50 V 的母 deck 对照是
   **非配对**的（§5.5，工作点差 13–23 mV）。PROT-03 的精确配对切片（§5.6）把
   A 的峰值变化钉到 **0.000 %**、B 仍是 **−54.7 % / −95.4 %**，但配对控制
   跑不满 320 µs，所以 PROT-03 的判据**未满足**。

不能说的：

- 不是硬件保护设计：钳位是理想开关，没有 SOA、热、比较器噪声、门极回路电感、退饱和。
- **功率级没有重启动**：五个候选 deck 里的锁存**从不清除**（`Vddp` 恒 12 V，
  UVLO 分支不可达）。重启时序只在逻辑级子电路里验证过（§4.5），不证明功率级
  能在 9.6 ms 软启动后安全重新起振，也不覆盖屏蔽斜坡期间的过流。
- 50 V 只有 **cshunt=1 fF** 版本的证据：不含该选项的 50 V 基座仍在 296.929 µs 塌缩。
  而且 50 V 的母 deck 对照**不是配对**的：候选与母 deck 的故障前 `V(out)` 差 13.2/17.5 mV。
  PROT-03 补的配对控制精确到 **0.000 mV**，但它**停在 250.151/254.980 µs**；
  两族控制不能同时满足"配对 ≤1 mV"与"两个 320 µs 窗口完整"（§5.6）。
  验收要求"48 V/50 V 双份原始证据"——原始证据现在两份都有，但 50 V 这两份带着
  cshunt、截断与非配对的限定，**不等于硬件签核**。
- 1.8 V / 10 µs / 4.8 V 都是**选定的设计参数**，不是器件手册值；换料号要重算。
- 母 deck 是 `.ic V(out)=1.89 V` 的**热启动**，不是真冷启动。

## 7. 复现

```bash
# 生成三个候选 deck + UVLO 子电路（只加不改，测试逐行锁住）
python tools/make_protection_candidates.py --write
python -m pytest tools/test_make_protection_candidates.py tools/test_protection_candidate_compare.py -q

# 运行（raw 不进 Git）
/d/ADI/LTspice/LTspice.exe -b -ascii sim/v3/sr_tank_dual_v33_ss_hotfault_48v_120a_srprobe_prot_a_oc1v.cir
/d/ADI/LTspice/LTspice.exe -b -ascii sim/v3/sr_tank_dual_v33_ss_hotfault_48v_120a_srprobe_prot_b_fast10u_1p8v.cir
/d/ADI/LTspice/LTspice.exe -b -ascii sim/v3/sr_tank_dual_v33_ss_hotfault_48v_120a_srprobe_prot_b_unarmed.cir
/d/ADI/LTspice/LTspice.exe -b -ascii sim/v3/prot_latch_uvlo_check.cir
/d/ADI/LTspice/LTspice.exe -b -ascii sim/v3/prot_latch_restart_check.cir

# 重启时序（逻辑级，不读功率级 raw）
python tools/protection_candidate_compare.py \
  --restart-raw sim/v3/prot_latch_restart_check.raw \
  --restart-json design/v3/power_priority/protection_restart_check.json

# 对照（母 raw 320 µs 必须已在本地）
python tools/protection_candidate_compare.py --case prot_a_oc1v \
  --base-raw sim/v3/sr_tank_dual_v33_ss_hotfault_48v_120a_srprobe.raw \
  --candidate-raw sim/v3/sr_tank_dual_v33_ss_hotfault_48v_120a_srprobe_prot_a_oc1v.raw \
  --uvlo-raw sim/v3/prot_latch_uvlo_check.raw \
  --json design/v3/power_priority/protection_candidate_48v_120a_prot_a.json \
  --uvlo-json design/v3/power_priority/protection_uvlo_check.json

python tools/protection_candidate_compare.py --case prot_b_fast10u_1p8v \
  --base-raw sim/v3/sr_tank_dual_v33_ss_hotfault_48v_120a_srprobe.raw \
  --candidate-raw sim/v3/sr_tank_dual_v33_ss_hotfault_48v_120a_srprobe_prot_b_fast10u_1p8v.raw \
  --json design/v3/power_priority/protection_candidate_48v_120a_prot_b.json

python tools/protection_candidate_compare.py --case prot_b_unarmed \
  --base-raw sim/v3/sr_tank_dual_v33_ss_hotfault_48v_120a_srprobe.raw \
  --candidate-raw sim/v3/sr_tank_dual_v33_ss_hotfault_48v_120a_srprobe_prot_b_unarmed.raw \
  --json design/v3/power_priority/protection_candidate_48v_120a_prot_b_unarmed.json
```

```bash
# 50 V：父 deck 是 cshunt=1 fF 子变体（50 V 基座仍在 296.929 µs 塌缩）
/d/ADI/LTspice/LTspice.exe -b -ascii sim/v3/sr_tank_dual_v33_ss_hotfault_50v_120a_cshunt_srprobe_prot_a_oc1v.cir
/d/ADI/LTspice/LTspice.exe -b -ascii sim/v3/sr_tank_dual_v33_ss_hotfault_50v_120a_cshunt_srprobe_prot_b_fast10u_1p8v.cir

python tools/protection_candidate_compare.py --case prot_a_oc1v_50v \
  --base-raw sim/v3/sr_tank_dual_v33_ss_hotfault_50v_120a_cshunt_srprobe.raw \
  --candidate-raw sim/v3/sr_tank_dual_v33_ss_hotfault_50v_120a_cshunt_srprobe_prot_a_oc1v.raw \
  --json design/v3/power_priority/protection_candidate_50v_120a_prot_a.json

python tools/protection_candidate_compare.py --case prot_b_fast10u_1p8v_50v \
  --base-raw sim/v3/sr_tank_dual_v33_ss_hotfault_50v_120a_cshunt_srprobe.raw \
  --candidate-raw sim/v3/sr_tank_dual_v33_ss_hotfault_50v_120a_cshunt_srprobe_prot_b_fast10u_1p8v.raw \
  --json design/v3/power_priority/protection_candidate_50v_120a_prot_b.json
```

```bash
# PROT-03 配对控制（§5.6）：生成 → 运行 → 对照
python tools/make_paired_protection_controls.py --write
/d/ADI/LTspice/LTspice.exe -b -ascii sim/v3/sr_tank_dual_v33_ss_hotfault_50v_120a_cshunt_srprobe_prot_a_oc1v_thrmute_control.cir
/d/ADI/LTspice/LTspice.exe -b -ascii sim/v3/sr_tank_dual_v33_ss_hotfault_50v_120a_cshunt_srprobe_prot_b_fast10u_1p8v_thrmute_control.cir
/d/ADI/LTspice/LTspice.exe -b -ascii sim/v3/sr_tank_dual_v33_ss_hotfault_50v_120a_cshunt_srprobe_prot_a_oc1v_noclamp_control.cir
/d/ADI/LTspice/LTspice.exe -b -ascii sim/v3/sr_tank_dual_v33_ss_hotfault_50v_120a_cshunt_srprobe_prot_b_fast10u_1p8v_noclamp_control.cir

# 基座 = thrmute（精确配对、截断）；declared_parent 仍用于结构检查
python tools/protection_candidate_compare.py --case prot_a_oc1v_50v \
  --base-raw sim/v3/sr_tank_dual_v33_ss_hotfault_50v_120a_cshunt_srprobe_prot_a_oc1v_thrmute_control.raw \
  --base-deck sim/v3/sr_tank_dual_v33_ss_hotfault_50v_120a_cshunt_srprobe_prot_a_oc1v_thrmute_control.cir \
  --candidate-raw sim/v3/sr_tank_dual_v33_ss_hotfault_50v_120a_cshunt_srprobe_prot_a_oc1v.raw \
  --json design/v3/power_priority/protection_candidate_50v_120a_prot_a_paired.json
python tools/protection_candidate_compare.py --case prot_b_fast10u_1p8v_50v \
  --base-raw sim/v3/sr_tank_dual_v33_ss_hotfault_50v_120a_cshunt_srprobe_prot_b_fast10u_1p8v_thrmute_control.raw \
  --base-deck sim/v3/sr_tank_dual_v33_ss_hotfault_50v_120a_cshunt_srprobe_prot_b_fast10u_1p8v_thrmute_control.cir \
  --candidate-raw sim/v3/sr_tank_dual_v33_ss_hotfault_50v_120a_cshunt_srprobe_prot_b_fast10u_1p8v.raw \
  --json design/v3/power_priority/protection_candidate_50v_120a_prot_b_paired.json

# noclamp 的负对照记录（320 µs 完整、13.2/17.5 mV）
python tools/protection_candidate_compare.py --case prot_a_oc1v_50v \
  --base-raw sim/v3/sr_tank_dual_v33_ss_hotfault_50v_120a_cshunt_srprobe_prot_a_oc1v_noclamp_control.raw \
  --base-deck sim/v3/sr_tank_dual_v33_ss_hotfault_50v_120a_cshunt_srprobe_prot_a_oc1v_noclamp_control.cir \
  --candidate-raw sim/v3/sr_tank_dual_v33_ss_hotfault_50v_120a_cshunt_srprobe_prot_a_oc1v.raw \
  --json design/v3/power_priority/protection_candidate_50v_120a_prot_a_noclamp_paired.json
python tools/protection_candidate_compare.py --case prot_b_fast10u_1p8v_50v \
  --base-raw sim/v3/sr_tank_dual_v33_ss_hotfault_50v_120a_cshunt_srprobe_prot_b_fast10u_1p8v_noclamp_control.raw \
  --base-deck sim/v3/sr_tank_dual_v33_ss_hotfault_50v_120a_cshunt_srprobe_prot_b_fast10u_1p8v_noclamp_control.cir \
  --candidate-raw sim/v3/sr_tank_dual_v33_ss_hotfault_50v_120a_cshunt_srprobe_prot_b_fast10u_1p8v.raw \
  --json design/v3/power_priority/protection_candidate_50v_120a_prot_b_noclamp_paired.json

# 开关漏流（§5.6 的"电学开路"证据）
/d/ADI/LTspice/LTspice.exe -b -ascii sim/v3/prot_switch_leak_probe.cir
```

控制运行记录：noclamp A **559.690 s**、B **527.175 s**，两份日志都有
`Total elapsed time`。两个 thrmute 都**按 PID 终止**，日志**没有** `Total elapsed time`
也没有整块 `.meas`（A 8 540 行，B 116 行），覆盖只能从 raw 尾部读——见 §5.6。

这六次运行已填进 `docs/D1_EXECUTION_KIT/templates/simulation_run_register_PROT03_2026-11-03.csv`
（新副本，不是改空白模板）：deck/log/raw 哈希、`last_saved_us`、故障前 Vout 与配对差值
都由记录重新派生，`tools/test_prot03_run_register.py` 逐行回查；两个 thrmute 行的
`full_duration` 写 `KILLED_BY_PID`，端口/账本列一律 `PENDING`（这些故障 deck 没测）。

运行记录：48 V A 576.646 s、B 581.166 s、负对照 58.082 s、UVLO 0.3 s、
重启子电路 12.591 s（raw 236 MB）；50 V A 1301.714 s、B 1371.595 s。
