czy0126/CZY/design/v3/power_priority/48V120A_冷启动与故障_2026-11-02.md

# 48 V / 120 A 目标的真冷启动与 8.7 倍过载故障 — 2026-11-02

> **证据说明：全部数值来自 LTspice 行为模型的波形与端口计算，不是 PCB、样机或器件实测。**
> 文件名沿用本目录既有的“实测”用词以便检索；对外统一称“仿真测量”。
> 冷启动记录：`cold_start_48v_120a_target.json`
> 故障记录：`fault_48v_120a_target.json`
> deck：`sim/v3/sr_tank_dual_v33_cold_vin48_i120_target.cir`、
> `sim/v3/sr_tank_dual_v33_cold_oc_vin48_i120_target.cir`
> 锁死：`tools/test_120a_transients.py`
> 上游：`docs/D1_外部阻塞解除与测试交付_2026-11-02.md` ELE-07

## 1 这次跑的是什么

两份 deck 都由 `tools/make_120a_transients.py` 从**真正的零初态**母本（`cold_phys` /
`cold_oc_phys`）生成，只把 `.param` 里的 `RL=20m` 改成 `RL=15.4m`：

| 项 | 冷启动 | 过载故障 |
|---|---|---|
| 母本 | `cold_phys` | `cold_oc_phys`（含 5.5–5.6 ms 故障支路） |
| `.tran` | `0 8m 0 10n uic` | 同 |
| `.ic` | **没有**（`uic` 即零初态） | **没有** |
| 变量数 | 37 | 37 |
| 运行时长 | **2294.151 s** | **2469 s**（被终止） |
| raw | **13 087 933 540 B**（约 12.2 GiB） | **11 552 302 933 B**（约 10.8 GiB） |
| 时间轴 | 到达 **8 ms** | 到 **7.5714 ms** 后塌缩 |

**“120 A”仍是负载电阻的目标，不是结果。** `RL=15.4 mΩ` 由稳态 121.67 A 那次仿真反推；
冷启动末端的实际电流是 `V(out)/RL`。`test_the_cold_record_keeps_120a_as_the_load_not_the_result`
禁止把 120.0 A 写进结果列。

故障支路是 `Sflt`（`Ron=1m`）串 `Rflt=1m`，在 5.55 ms 并入负载：

```
Vfltctl ctl 0 PWL(0 0 5.5m 0 5.6m 5 8m 5)
Sflt out flt ctl 0 SFLT
Rflt flt 0 1m
```

`15.4 mΩ || 2 mΩ = 1.77011 mΩ`，即 **8.70 倍**过载。母本头注写的
`1.818 mΩ / 11×` 是它自己 20 mΩ 负载的比值；`test_the_fault_record_takes_its_severity_from_the_deck`
锁住本次必须报 8.70×。

2026-11-03 补了一个**只改求解器选项**的收敛诊断子 deck（`..._cold_oc_vin48_i120_target_cshunt.cir`），
用来检验“cshunt 能不能让 8 ms 跑完”。结论是**不能**，而且比基座更早塌缩；详见 §9。
这不是第三条证据 deck，基座记录仍是唯一的已发布故障数据。

## 2 冷启动

| 量 | 值 |
|---|---:|
| 首个采样点 `V(out)` | **0.0 V**（证明没有预充电） |
| 末端 `V(out)`（最后 100 µs 平均） | **1.873786 V** |
| 全程 `V(out)` 最大 | 1.888680 V |
| 末端 `Iout = Vout/RL` | **121.674 A** |
| 末端 `Pout = avg(V(out)²/RL)` | **228.000 W** |
| 到 90 % 终值的时间 | **3.083 ms** |
| `I(Lr)` 峰值 | **24.1338 A @ 1.287 ms** |
| `I(Lr)` RMS（全程） | 11.2345 A |
| SR 正向峰值 / 反向峰值 | **72.604 A** / 5.886 A |
| `V(oc)` 最大 | **0.696786 V @ 6.082 ms** |
| `V(oc)` 超过 1 V / 2 V 的片段 | **0 / 0** |
| 末端 `V(ss)` / `V(reg)` | 4.9855 V / 11.0 V |

**冷启动收敛到稳态工作点**：末端 1.873786 V 与 120 A 稳态候选的 `vout_avg=1.873692 V`
只差 **0.094 mV**。这是两条独立 raw 的末端值，不是同一个窗口的重复读数。

**过流没有动作**：`V(oc)` 峰值 0.697 V 是 Level-1 `VOC=1 V` 的 **69.7 %**，
超过 1 V 与 2 V 的片段数都是 0。冷启动峰值 24.13 A 出现在 1.287 ms 的软启动段，
不是稳态；稳态 `|I(Lr)|` 峰值在 120 A 候选里是 15.59 A。

**与 LTspice 自己的 `.meas` 互校**（`test_the_streamed_records_agree_with_ltspices_own_meas`）：
`vout_max=1.88868003695`、`ipri_pk=24.133753946` 与 JSON 逐位一致（rel=1e-9）。
流式解析器与求解器对同一条 raw 的读数没有分歧。

## 3 过载故障：trip 与关断

**这次运行没有跑完 8 ms。** 求解器在 **7.571410 ms** 处步长塌缩（两分钟内时间只前进
约 1e-11 s，点数仍在增加），按 PID 结束进程，已写出的前缀保留为证据。因此：

- `reached_tstop = false`、`solver_prefix_only = true`；
- 日志里**没有** `Total elapsed time`，也**没有** `.meas` 块——被终止的 LTspice 不写测量结果；
- 故障段可引用的区间是 **5.55–7.5714 ms**，不是 5.55–8 ms。

| 量 | 本次（15.4 mΩ，8.70×） | 母本 `cold_oc_phys`（20 mΩ，11×） |
|---|---:|---:|
| 故障投入时刻 | 5.550 ms | 5.550 ms |
| 投入前 `V(out)`（20 µs 平均） | **1.85335 V** | — |
| 投入前 `V(ss)` | **3.7815 V** | — |
| 投入前 `V(oc)` | 0.6898 V | — |
| **OC 跳闸时刻** | **5.591809 ms** | 5.599825 ms |
| **跳闸延迟（自 5.55 ms）** | **41.81 µs** | 49.83 µs |
| 跳闸前 `I(Lr)` 峰值 | **84.827 A @ 5.58069 ms** | 84.017 A |
| 5.6–5.8 ms 窗口 `|I(Lr)|` 峰值 | **48.446 A** | 73.122 A |
| `V(oc)` 全程最大 | **1.20692 V @ 5.61987 ms** | 1.24079 V |
| 首个持续关驱动时刻 | 5.59353 ms | — |
| 最长低电平（驱动关断） | **193.43 µs** | — |
| `I²t`（5.55 ms→trip） | **0.10305 A²s** | — |
| `I²t`（5.55 ms→7.5714 ms） | **0.48239 A²s** | — |
| 故障后 `V(out)` 最低 | **−4.976 mV** | −43.733 mV |
| 末端 `V(out)` 平均（最后 100 µs） | **−3.645 mV** | 0.3346 V（8 ms 时） |
| 末端 `Pout`（按并联负载） | 0.0096 W | — |
| SR 正向峰值 / 反向峰值 | **255.22 A @ 5.5807 ms** / 11.84 A | 252.04 A / — |

`✶ Insight ─────────────────────────────────────`
- **故障落在软启动途中，不是稳态**：投入时 `V(ss)=3.78 V`（满量程 5 V），`V(out)` 也只有
  1.853 V。母本故障块的头注声称启动“已稳定在 200.6 kHz 设计点”，这两个字段就是为了
  不继承那句话而加的（`vout_at_engage_v` / `ss_at_engage_v`）。引用本组数据时必须写
  “软启动途中投入”，否则会把故障后的跌落归因于“稳态被拉垮”。
- **trip 延迟 41.8 µs 是本 deck 的值，不是保护规格**。它由 `V(oc)` 的 RC/分压链和
  8.70× 的电流斜率共同决定；换负载、换 OC 网络都会变。两个工况的延迟差 8 µs，
  不能外推成“保护足够快”。
`─────────────────────────────────────────────────`

与母本相比，本次过载倍数更低（8.70× 对 11×），投入前负载电流更高（121.7 A 对约 94 A），
于是 trip 早约 8 µs、峰值略高（84.83 A 对 84.02 A）、`V(oc)` 最大值略低、
`V(out)` 没有像母本那样被拉到 −43.7 mV。5.6–5.8 ms 窗口的 48.45 A 明显低于母本的
73.12 A；本文只报数，不解释两者的差异（两次运行的故障前后驱动状态并不相同）。

SR 的 255.22 A 峰值出现在 **5.5807 ms**，即 trip（5.5918 ms）之前、塌缩（7.5714 ms）
之前约 2 ms，**不是塌缩尾部的采样伪影**。四路检测里 `I(VSb1)` 最大，
`I(VSa1)=254.48 A @ 5.5831 ms`，两组几乎对称；它们与 `I(Lr)` 峰值同一时刻，
是故障电流经变压器传到副边的结果。

## 4 磁通：2 匝在故障峰值下仍越过 Bsat

按项目口径 `B = L·I/(N·Ae)`，`L` 取这次运行的 **1.0 µH**（`paired_flux()` 用测量时
配对的电感，不拿别的电感换算），`Ae=1.3e-4 m²`、`Bsat=0.31 T`、判据 `0.9·Bsat=0.279 T`：

| 峰值来源 | `I(Lr)` | 2 匝 B | 3 匝 B | 结论 |
|---|---:|---:|---:|---|
| 冷启动 | 24.134 A | **0.0928 T** | 0.0619 T | 2 匝/3 匝都安全 |
| 过载故障（trip 前） | **84.827 A** | **0.3263 T** | **0.2175 T** | **2 匝 > Bsat（0.310 T）** |

- 2 匝的 `Isat = 80.6 A`，本次峰值 **84.83 A 已超过它**；即使用 0.279 T 判据，
  2 匝也是 1.17 倍，3 匝是 0.78 倍。
- 这与物理 deck 的 84.02 A / 0.323 T 是同一结论，本次峰值再高 1 %。
  **BOM §3.3 里“首件漏感 ≥20 nH 就能把 2 匝救回 0.9 判据”只对冻结 deck 的
  73.68 A 成立**，已被 84–85 A 的故障峰值两次推翻。故障设计应按 3 匝（或更大 Ae）校核，
  且 65/74/85 A 这些数都来自**线性** Lr 模型——真实饱和后 di/dt 更高，
  这里的 B 是下界意义上的设计点，不是器件的失效边界。

## 5 模型边界

1. **故障段是不完整区间**：7.5714 ms 后求解器塌缩，本文所有“末端”量都指 7.5714 ms，
   不是 8 ms。塌缩原因未定位；按项目规则只记录可达前缀与终止原因，不猜。
   **§9 已试过 50 V 上奏效的 `cshunt=1 fF` 补救，对这个 deck 不奏效**：变体在
   5.6141 ms 就塌缩，比基座还早 1.96 ms；公共前缀上的故障峰值只动 0.04–0.07 %。
2. **`V(oc)` / 驱动是行为模型**：trip 延迟和最长关断 193.43 µs 由 deck 里的比较器/
   驱动行为决定；真实 UCC25600 的 Level-1 响应、软启动重试与 SR 驱动时序没有建模。
3. **不是器件 SOA**：84.83 A、255.22 A（SR）都出自线性器件模型；没有结温、没有
   饱和后的电感下降、没有 PCB 寄生。SR 的 255 A 尤其不能当器件电流额定来用。
4. **冷启动的 228.0 W 是端口值**：负载就是 15.4 mΩ，没有输出铜排/接点、没有磁芯损耗、
   没有偏置完整归属。加 0.15 mΩ 外部路径是换算，不是模型结果。
5. **raw 不入 Git**：两份约 12.2 GiB / 10.8 GiB；提交的证据是两份 JSON、deck 与本文。

## 6 不能下的结论

1. **不是 120 A 连续额定**：没有热数据、没有真实均流、没有 SR 结温、没有输出路径。
2. **不是保护认证**：一次 8.70× 过载、一个未跑完的窗口，不能证明短路、重复过载或
   软启动重试下的安全。
3. **不能由本次故障峰值反推 100 A/110 A**：投入前电流、软启动状态与故障倍数都不同。
4. **不能把 7.5714 ms 的末端当成“故障后稳态”**：输出已经跌到 −3.6 mV，变换器处于
   关断/重试过程，没有稳态可言。

## 7 复现

```bash
python tools/make_120a_transients.py --write
/d/ADI/LTspice/LTspice.exe -b -ascii sim/v3/sr_tank_dual_v33_cold_vin48_i120_target.cir
python tools/analyze_v3_transient.py --kind cold \
  --raw sim/v3/sr_tank_dual_v33_cold_vin48_i120_target.raw \
  --deck sim/v3/sr_tank_dual_v33_cold_vin48_i120_target.cir --rl 0.0154 \
  --json design/v3/power_priority/cold_start_48v_120a_target.json
/d/ADI/LTspice/LTspice.exe -b -ascii sim/v3/sr_tank_dual_v33_cold_oc_vin48_i120_target.cir
python tools/analyze_v3_transient.py --kind fault \
  --raw sim/v3/sr_tank_dual_v33_cold_oc_vin48_i120_target.raw \
  --deck sim/v3/sr_tank_dual_v33_cold_oc_vin48_i120_target.cir --rl 0.0154 \
  --json design/v3/power_priority/fault_48v_120a_target.json
```

故障 deck 在 7.5714 ms 处不会自行结束；观察到时间停滞（不是 raw 停止增长）后，
用 `ps -W` 查 PID、`kill <pid>` 结束。**不要用 `taskkill //IM LTspice.exe`。**

## 8 这一节能被证伪吗

`tools/test_120a_transients.py` 锁住：

| 测试 | 它防的是什么 |
|---|---|
| `test_the_target_decks_are_true_cold_starts` | 用带 `.ic` 或预充电的 deck 冒充冷启动 |
| `test_the_load_is_the_120a_target_not_a_result` | 把目标 120 A 写成结果 |
| `test_the_fault_deck_is_the_cold_deck_plus_one_injection` | 故障 deck 漂变成另一个电路 |
| `test_the_fault_engages_after_five_milliseconds` | 改投入时刻或把 1 mΩ 直接当负载 |
| `test_the_cold_record_starts_from_zero_volts_not_a_precharge` | 首个采样点不是 0 V 也叫冷启动 |
| `test_the_cold_record_keeps_120a_as_the_load_not_the_result` | `Iout` 不等于 `Vout/RL` |
| `test_the_fault_record_takes_its_severity_from_the_deck` | 抄母本的 11× 而不是 8.70× |
| `test_the_fault_record_times_the_trip_from_engagement` | 把投入前的事件当跳闸，或延迟算错 |
| `test_a_prefix_only_record_says_so` | 把塌缩前缀报成完整 8 ms |
| `test_the_log_tells_the_same_story_about_completion` | 前缀记录配一份“已完成”外观的日志 |
| `test_the_streamed_records_agree_with_ltspices_own_meas` | 流式解析与 `.meas` 不一致；故障前缀时反过来锁住“日志确实没有 `.meas`” |

## 9 塌缩的收敛诊断：cshunt 不奏效（2026-11-03）

**问题**：50 V 稳态初始化故障在 296.929 µs 塌缩，只加 `cshunt=1 fF`（200 kHz 下
795 kΩ）就让它跑满 320 µs。同一个补救能不能让这条 8 ms 冷启动过载跑完？

**答案：不能，而且更早塌缩。**

记录：`cold_oc_vin48_i120_cshunt.json`；工具：`tools/cold_oc_convergence.py`；
变体 deck：`sim/v3/sr_tank_dual_v33_cold_oc_vin48_i120_target_cshunt.cir`
（`make_120a_transients.py` 从基座派生，**只**在 `.options` 行追加 `cshunt=1e-15`）。
`circuit_differences()` 对两份 deck 返回 **0 条**：电路、故障支路、`.tran`
（`0 8m 0 10n uic`）与全部 `.meas` 逐行相同。

| 项 | 基座 | cshunt 变体 |
|---|---|---|
| 最后保存时刻 | **7.5714 ms** | **5.6141 ms** |
| 是否到 8 ms | 否 | 否 |
| raw 大小 | 11.55 GB | 9.03 GB（被终止前） |
| 日志 `Total elapsed time` | 无 | 无 |
| 日志 `.meas` | 无 | 无 |
| 公共窗口 5.4–5.614 ms 采样点 | 429 100 | 1 343 952 |
| trip | 5.591809 ms | 5.592389 ms |
| 投入→trip | 41.809 µs | 42.389 µs |
| I(Lr) 峰（trip 前） | 84.8268 A @ 5.58069 ms | 84.7927 A @ 5.58311 ms |
| SR 正向峰 | 255.2247 A | 255.0407 A |
| V(oc) 最大 | 1.20019 V | 1.19931 V |
| 窗口内 V(out) 最低 | 0.22362 V | 0.22996 V |

**公共切片上的移动量**：trip **+580 ns**（相对 +1.04e-4）、I(Lr) 峰 **−0.040 %**、
SR 正向峰 **−0.072 %**、V(oc) 最大 −0.074 %。V(out) 最低是“接近零、斜率大”的量，
只报相对值（+2.84 %），不参与判据。

**怎么读这三个事实**：

1. **补救失败**：变体不是“跑得更久”，而是**早塌 1.96 ms**。所以 cshunt 不是一个
   可复用的“让塌缩跑完”的开关；50 V 那次成功不能外推到这条 deck。F02 因此仍
   `blocked`，而且“再试 cshunt”已被排除。
2. **峰值不是这个求解器设置的伪影**：公共切片里所有故障峰值移动都在 0.1 % 以内，
   所以已发布的 84.83 A / 255.22 A 不是“1 fF 会改掉”的量。这不等于峰值有硬件精度
   ——见 §5 的模型边界。
3. **两处塌缩不是同一个事件**：基座在 trip 后约 2 ms，变体在 trip 后约 22 µs。
   变体在同一时间片里用了 **3.1 倍**的采样点，说明它在塌缩前就已经在压步长。
   这与 50 V 的“死区 LTE 判据失控”同型，但触发位置不同；根因仍未定位，不猜。

**共同切片的边界**：声明窗口是 5.4–6.0 ms，但变体只到 5.6141 ms，所以工具把两侧
都截到 **5.400–5.614 ms** 再取最大值，并把 `declared_window_fully_covered` 记为
`false`。如果拿基座的 5.4–6.0 ms 去比，多出的 386 µs 只会让基座的最大值单调变大，
差额会变成“覆盖度”而不是物理。`vout_min_after_engage_v` 也因此**不能**与已发布的
全长前缀 −4.98 mV 直接比较——那个下探发生在 6 ms 之后。

**终止方式**：监测器按 raw 尾部时间判定（不是按文件大小）：时间在 5.6140558 ms
停滞超过 6 min、日志里步长警告只差 1e-15 s，确认塌缩后用 `kill <pid>` 结束；
禁止 `taskkill //IM LTspice.exe`。ASCII raw 是流式追加的，所以 5.614 ms 之前的前缀可读。

复现：

```bash
python tools/make_120a_transients.py --write   # 同时重建 _cshunt 子 deck（只改 .options）
/d/ADI/LTspice/LTspice.exe -b -ascii sim/v3/sr_tank_dual_v33_cold_oc_vin48_i120_target_cshunt.cir
python tools/cold_oc_convergence.py \
  --base-raw sim/v3/sr_tank_dual_v33_cold_oc_vin48_i120_target.raw \
  --base-deck sim/v3/sr_tank_dual_v33_cold_oc_vin48_i120_target.cir \
  --variant-raw sim/v3/sr_tank_dual_v33_cold_oc_vin48_i120_target_cshunt.raw \
  --variant-deck sim/v3/sr_tank_dual_v33_cold_oc_vin48_i120_target_cshunt.cir \
  --base-log sim/v3/sr_tank_dual_v33_cold_oc_vin48_i120_target.log \
  --variant-log sim/v3/sr_tank_dual_v33_cold_oc_vin48_i120_target_cshunt.log \
  --json design/v3/power_priority/cold_oc_vin48_i120_cshunt.json
```

`tools/test_cold_oc_convergence.py` 锁住三件事：塌缩的基座不能报成“跑完”、
改电路的“变体”必须被拒、窗口超出保存终点必须报错；`tools/test_d1_unclosed_risks.py`
再把本节的 F02 数值锁进风险登记表。
