czy0126/CZY/design/v3/power_priority/48V120A_稳态初始化故障_2026-11-02.md

# 48 V / 50 V、120 A 稳态初始化后故障（ELE-08，2026-11-02）

> 状态：**SIMULATED_ONLY / NOT_RATED / NOT_A_COLD_START**。两 deck 的 raw 都在本机，
> 但都不进 Git；证据是本文与同目录 JSON，raw 只用于复算。
> 机器可读记录：`hotfault_48v_120a.json`、`hotfault_50v_120a.json`（均由
> `tools/hot_fault_metrics.py` 从 raw 生成，不得手改）。
> **48 V 通过严格日志校验**（`sim/v3/sr_tank_dual_v33_ss_hotfault_48v_120a.validation.json`，
> 状态 `LOG_PRECHECK_PASS_REQUIRES_WAVEFORM_AND_DEVICE_REVIEW`）；**50 V 未通过**：
> 求解器在 296.929 µs 塌缩，日志没有 `Total elapsed time`，校验器 fail-closed、不写报告。
> 风险登记：`unclosed_risk_register.json` 的 F01/M01 仍为 blocked。
> **48 V 的八只 SR 同窗探针已跑满 320 µs**（§3.5）：
> `sr_fault_probe_48v_120a.json`。**50 V 基座仍只有前缀**；它的八只探针只能建在
> `cshunt=1e-15` 变体上（§3.6/§3.7，`sr_fault_probe_50v_120a_cshunt.json`），
> 是求解器辅助解，引用必须带条件。**同一 1 fF 扰动在 48 V 上把末端锁存从 A 相翻到
> B 相**（§3.8），所以末态门极相位不是电路属性，不能当安全/危害证据。

## 1. 这两个 deck 回答什么

ELE-07 的故障 deck（`sr_tank_dual_v33_cold_oc_*`）把 8.7 倍过载加在**软启动过程中**
（trip 时 `V(ss)=3.78 V`，输出尚未到设计点），因此它不能回答"变换器已在额定点稳定运行后
突然短路"这一情形。ELE-08 的两个 deck 从 `.ic V(out)=1.89 V(ss)=4` 起步，先把状态跑稳，
再在绝对 **2175 µs** 投入故障：

| 项 | 48 V/120 A | 50 V/120 A |
|---|---|---|
| deck | `sim/v3/sr_tank_dual_v33_ss_hotfault_48v_120a.cir` | `..._hotfault_50v_120a.cir` |
| 母 deck | `..._1ms_vin48_i120_cin.cir` | `..._1ms_vin50_i120_cin.cir` |
| `VIN / RL` | 48 V / 15.4 mΩ | 50 V / 16.3 mΩ |
| `.tran` | `0 2320u 2000u 5n uic` | 同左 |
| 故障支路 | `Sflt_hot` Ron 1 mΩ + `Rflt_hot` 1 mΩ = **2 mΩ** | 同左 |
| 过载倍数（RL ∥ 2 mΩ 对 RL） | **8.7×** | **9.15×** |
| 运行开始 | 2026-11-02 17:13:16 | 2026-11-02 17:22:37 |
| 求解时间 / raw | 554.498 s / 1.052 GB（**22:15 重跑 544.086 s**，见下） | **未完成**：18:49 按 PID 终止，前缀 296.929 µs / 320 µs，14.20 GB |
| 严格日志校验 | **通过**（`...validation.json`） | **失败**（无完成行、无 `.meas`，不产报告） |

`Tstart=2000 us` 会把保存时间轴整体平移：PWL 在绝对 **2175 µs** 越过 2.5 V 翻转，
在 raw 里记在 **175 µs**。`hot_fault_metrics.py` 从 deck 的 `.tran` 与 `Vflt` 行算出这两个
数，不手抄；`reached_tstop=true` 也是按 `Tstop − Tstart = 320 µs` 比较的，不是按 2320 µs。

**48 V 基座为什么重跑**：PR #21 给 `PROBES` 加了
`HOT_VOUT_EARLY`（120–145 µs）与 `HOT_VOUT_LATE`（145–170 µs），
`validate_hotfault_log.py` 的 `REQUIRED` 也随之包含它们；旧日志没有这两行，
跑严格校验会报"缺席"而不是"不漂"。用当前 deck 重跑后，**raw 与旧文件的 5 字节差异全部在
`Date:` 头**（`cmp -l`），数值逐位相同，所以表里的 trip/峰值一个都没动；
新增的两窗均值是 **1.873933 / 1.873830 V**（相对漂移 5.505e-5），与
`hotfault_48v_120a.json:pre_fault.vout_first_half_mean_v` 一致到 1e-6 V 量级
（日志按时间平均，JSON 按采样平均）。50 V 日志是按 PID 终止的，没有整块 `.meas` 输出；
两个诊断日志也早于这两行——`.meas` 只影响日志、不影响 raw，所以诊断比较仍然成立。

**为什么是 2 ms 而不是 1 ms**：`.ic V(ss)=4` 只是初值，软启动以 5 µA / 10 nF = 0.5 mV/µs
上升，1 ms 时只到 **4.485 V**，低于严格校验要求的 4.8 V；2 ms 自然到 ~5.045 V。
拉长窗口而不是改 `.ic` 是唯一不伪造前态的做法。

## 2. 故障前是否真的稳定

`.ic` 只是初值，不是"已稳定"的证明。判据同时要求两条（`pre_fault_state()`）：

- 软启动完成：窗口平均 `V(ss) ≥ 5.0 × (1 − 4 %) = 4.8 V`（与 PR #20 严格日志校验同一门槛）；
- 输出平：窗口前后半段均值漂移 ≤ 1 %。

窗口取 raw 的 **120–170 µs**（绝对 2120–2170 µs，故障投入前截止）。

| 量 | 48 V | 50 V |
|---|---|---|
| `V(ss)` 均值 / 峰峰 | 5.04484 V / 24.97 mV | 5.04489 V / 24.97 mV |
| `V(out)` 均值 | **1.87388 V** | **1.94388 V** |
| `V(out)` 峰峰 | 41.31 mV | 41.54 mV |
| `V(out)` 半窗漂移 | **5.51e-5（0.0055 %）** | **2.25e-4（0.0225 %）** |
| `V(oc)` 均值 | 0.69654 V（门槛 1 V 的 69.7 %） | 0.68216 V（68.2 %） |
| `stable_at_design_point` | **true** | **true** |

两条都过，才算"故障落在设计点上"。48 V 的 `V(out)` 与 ELE-07 的稳态候选
（1.873786 V）只差 0.095 mV，说明这个初值确实停在同一个工作点。

## 3. 故障后的实测

| 量 | 48 V/120 A（8.7×） | 50 V/120 A（9.15×，前缀） |
|---|---|---|
| OC 越过 1 V 的时刻（raw 轴） | 215.0967 µs | 214.9153 µs |
| **投入→trip 延迟** | **40.10 µs** | **39.92 µs** |
| `V(oc)` 全程最大 | 1.2562 V | 1.2711 V |
| `I(Lr)` 峰（trip 前） | **97.4427 A** @209.9545 µs | **101.2627 A** @209.9490 µs |
| SR 正向峰（整段 raw） | **292.61 A** | **303.93 A** |
| SR 反向峰（整段 raw） | 13.56 A | 13.75 A |
| `V(out)` 最低 | −7.93 mV | −7.56 mV |
| 故障支路峰值电流（`.meas`） | **858.9 A** | 未测（运行未结束，无 `.meas`） |
| trip 前 I²t | 0.11832 A²s | 0.12582 A²s |
| 门极首次持续拉低 | 220.737 µs（trip 后 5.64 µs） | 220.242 µs（trip 后 5.33 µs） |
| 门极最长连续低电平 | 26.33 µs | 76.69 µs |
| trip 后 `V(ss)` 终值 | **0.088 V（控制器停机）** | **0.088 V（同左）** |
| raw 记录终点 | 320.0 µs（跑满） | **296.929 µs（塌缩，差 23.07 µs）** |
| `V(reg)` 末段 | 11.000 V | 11.000 V |

`.meas` 与 raw 复算交叉校验（48 V）：`hot_oc_trip` 215.096649 µs、`hot_ipri_after` 97.4426639 A、
`hot_vout_min` −7.9303 mV，与 JSON 的 215.096665 µs / 97.4426639 A / −7.9303 mV
在采样分辨率内一致。

**故障不是被"恢复"了**：trip 后 `V(ss)` 在约 35 µs 内从 5.07 V 跌到 0.09 V 并保持，
主桥停振（`V(sw)` 无 >20 V 边沿，`I(Lr)` 衰到 7 mA），输出跌到几十毫伏。这个 deck 只覆盖
投入后约 145 µs（48 V）/ 约 122 µs（50 V），更长的锁存/重启行为不在证据范围内。

### 3.1 trip 之后的门极状态：不是"一直关断"

`hot_fault_metrics.py` 现在逐通道记录 trip 后的门极状态（`sr_a_gate_after_trip`、
`sr_b_gate_after_trip`、`sr_gate_latched_at_end`）。实测：

- **48 V**：A 相门极在 trip 后 **32.0 µs**（247.07 µs）重新拉到 **10.89 V**，并保持到记录结束
  （trip 后 54.8 % 的采样点为高）；
- **50 V**：A 相保持低，**B 相**门极在 trip 后 **29.6 µs**（244.47 µs）拉到 **10.89 V**，
  保持到塌缩点（trip 后 99.7 % 的采样点为高）。

这不是"保护后 SR 已安全关断"，也不是"SR 直通"。`sr_timing_v3_3.lib` 用漏源反向偏置
作为关断判据；主桥停振、副边无换流时没有这个偏置，门极就没有东西把它复位。
**这与 datasheet 不矛盾**：UCC24624 的待机检测要求通道 1 平均开关频率**低于 9 kHz 持续
7.5 ms**（`tSTBY_DET` 5.5/7.5/10 ms）才关断两路驱动；本记录故障后只有约 **0.1 ms**，
无论模型还是真器件都还没资格进待机。实测锁存后的 B 通道是**正向导通**（`V(xsb1:di)−V(xsb1:si)`
≈1.5 mV，`I(Bch)`≈1.63 A），不是反向电流，关断比较器本来就不该动作。
真实器件在同一窗口内是否会因为其它机制（例如下一个开关周期或控制器复位）而关断，
只能上电验证；但**不能把"待机"当作 100 µs 内会发生的补救**。

### 3.2 50 V 为什么没有跑完

50 V 的 raw 在 **296.928094 µs** 停止推进。按字节采样解析记录间隔（`ascii_raw_window`
同款对齐），步长序列是：**295.88 µs 时仍是满步长 5 ns**，296.88 µs 起开始收缩，
296.92 µs 后跌到 **~1e-15 s**；**14.20 GB 里有 13.3 GB 是最后 0.93 µs 写出来的**。
62 分钟里保存时间只前进 **1 ns**，同期文件增长约 10 GB。这是 CLAUDE.md 记录过的求解器
塌缩模式，不是"跑得慢"。

**塌缩点在故障之后 82 µs，不在 trip，也不在门极锁存的那一刻**：

| 时刻（raw 轴） | 事件 | 48 V | 50 V |
|---|---|---|---|
| 214.9–215.1 µs | `V(oc)` 越过 1 V | trip 215.097 µs | trip 214.915 µs |
| ~220 µs | 门极首次持续拉低 | 220.74 µs | 220.24 µs |
| 244–247 µs | 一相 SR 门极重新拉高（锁存） | 247.07 µs（A 相） | 244.47 µs（B 相） |
| ~250 µs | `V(ss)` 跌到 0.09 V，主桥停振 | 0.0875 V | 0.0875 V |
| 250–320 µs | 死区：输出 −7.6/−7.9 mV，`I(Lr)` 毫安级 | **跑到 320 µs** | **296.928 µs 塌缩** |

两个 deck 有**相同的锁存**（trip 后 30–32 µs、同一个 10.89 V 电平），所以锁存本身不足以
解释塌缩。差别在死区的轨迹：48 V 的 `V(sw)` 落到 ~7 V 后基本静止（310→320 µs 只动 0.03 V），
50 V 的 `V(sw)` 在 **13.7–16.2 V** 之间缓慢漂移、`I(Lr)` 在 ±0.07 A 振荡，296.88 µs 附近
（`I(Lr)` 再次过零）步长开始塌缩。也就是说：**一个被判据固定住的门极把副边短接，主桥又
没有源驱动，电路落进一个没有确定工作点的浮空状态；50 V 的死区轨迹在数值上更硬，先塌了。**

ASCII raw 是流式追加的，按 PID 终止后**已写出的前缀仍可读**：故障（175 µs）、trip
（214.92 µs）、锁存（244.47 µs）与 trip 前峰值（209.95 µs）都在前缀内，所以应力数字可用；
缺的是 trip 后最后 23 µs 的死区。`solver_prefix_only=true`，日志里没有 `Total elapsed time`，
**引用 50 V 结果时必须写明"前缀"**，且严格校验器对它返回 `LOG_PRECHECK_FAIL`。

**这是数值问题，不是缺一条物理**。死区里保存的内部量都很平滑：B 通道门极 `V(xsr1:q2)=1`
（导通），`I(xsb1:Bch)` 从 1.656 A 缓慢衰减到 1.625 A，`V(xsb1:di)−V(xsb1:si)` ≈ 1.5 mV，
`V(sw)` 以约 2–3 V/µs 缓慢上升，`V(nr)` 在 296.913 µs 过零——没有任何 >100 V/µs 的快事件。
步长却从 5 ns 一路压到 1e-15 s，说明是**局部截断误差判据在某个内部状态上失控**，而不是
电路里真的发生了快变。

因此**待机模型不是修法**：datasheet 的 `tSTBY_DET` 是 7.5 ms，比整个故障后窗口长两个数量级；
即使把 standby 补进模型，100 µs 内也不会触发。锁存在本窗口内反而是**符合器件逻辑**的
（正向电流、无反向偏置、未满 7.5 ms）。

**本记录采用 (a)：接受前缀**。理由是故障应力事件在 **214.9 µs 已全部结束**（trip、`I(Lr)`
峰 209.95 µs、SR 峰都在前缀内），塌缩点之后只剩主桥停振的死区；再花约一小时换一段
"停振后 23 µs" 的波形，不改变任何应力结论，却会把一条数值不可靠的轨迹混进证据链。
路径 **(b)** 现在已执行（见 §3.4）：只改求解器设置的诊断运行，明确标成
`SOLVER_DIAGNOSTIC`，逐项比较同一窗口的应力峰值。方向是**收紧**（`trtol` 7→1、
`abstol` 1e-12→1e-13）而不是放宽——放宽只能让读数更差，回答不了"发布值是不是精度不够的产物"。
**它不能替代物理证据**，因为换数值设置本身就改变轨迹；它只量化峰值的数值不确定度。
直接原地重跑会再次停在同一位置。**路径 (c) 也已执行**（见 §3.6）：`cshunt=1e-15` 的
求解器辅助变体跑满 320 µs，同一窗口的前缀峰值与基座差 −0.164 %（`I(Lr)`）/ −0.143 %
（SR 正向）。基座 raw 仍是前缀，引用发布值时仍要写基座还是变体。

### 3.3 与 ELE-07 真冷启动故障的对比

| 量 | 冷启动故障（ELE-07） | 稳态故障 48 V | 稳态故障 50 V |
|---|---|---|---|
| trip 时 `V(ss)` | 3.78 V（软启动未完成） | 5.045 V | 5.045 V |
| 投入→trip | 41.81 µs | 40.10 µs | 39.92 µs |
| `I(Lr)` 峰 | 84.83 A | **97.44 A（+14.9 %）** | **101.26 A（+19.4 %）** |
| SR 正向峰 | 255.22 A | **292.61 A（+14.6 %）** | **303.93 A（+19.1 %）** |

结论：**软启动中的故障低估了应力**。OC 延迟几乎相同（约 40 µs，由 CT/比较器时间常数决定），
但故障前电流更高，峰值随之更高。选型与磁通判据必须用稳态故障，不能用冷启动故障。

### 3.4 SOLVER_DIAGNOSTIC：前缀峰值不是单一求解器设置的产物

§3.2 的路径 (b) 已执行。新 deck `sr_tank_dual_v33_ss_hotfault_50v_120a_diag.cir`
与基座 deck 在**去掉注释、`.tran`、`.options` 后逐行相同**（`hotfault_diagnostic.py`
的 `circuit_differences()`，本次为 0 条），只改三处：

- `.options ... trtol=1`（默认 7）、`abstol=1e-13`（默认 1e-12）；
- `.tran 0 2220u 2000u 5n uic`，即保存轴停在 **220 µs**，避开 296.929 µs 的塌缩。

为什么是 220 而不是 215：48 V 对照组的 trip 在 **215.10 µs**，窗口若在 215 µs 结束，
就根本读不到 trip。两次运行都按 `min(两个 deck 的保存终点)` 读取，末点相差 **0.057 ns**，
所以下面每一行都是同一窗口、同一电路的比较。

| 量（0–220 µs 窗口） | 基座（trtol 7 / abstol 1e-12） | 诊断（trtol 1 / abstol 1e-13） | 差 |
|---|---|---|---|
| trip | 214.9153 µs | 214.8342 µs | **−81.2 ns（−0.038 %）** |
| `I(Lr)` 峰 | 101.2627 A @ 209.9490 µs | 101.0992 A @ 209.9491 µs | **−0.1635 A（−0.161 %）** |
| SR 正向峰 | 303.930 A | 303.937 A | **+0.0068 A（+0.002 %）** |
| SR 反向峰 | 13.751 A | 13.522 A | −0.230 A（−1.67 %） |
| `V(oc)` 峰 | 1.09177 V | 1.09216 V | +0.40 mV（+0.036 %） |
| `V(out)` 最低 | 0.94719 V | 0.93813 V | −9.05 mV（−0.96 %） |
| 窗口内采样点 | 423 028 | 695 463 | +64 % |

怎么读：

- **被 M01 引用的那个电流是稳的**：`I(Lr)` 峰只动 **0.16 %**，峰时刻差 0.1 ns。
  代进 §4 的 `B=L·I/(N·Ae)`，3 匝 0.2596 T 的不确定度约 **±0.0004 T**，
  远小于 0.279 T 判据线剩下的 0.0194 T 余量；2 匝超限的结论也不变。
- **最大的应力（SR 正向峰）几乎不动（0.002 %）**：它由故障支路决定，不靠积分精度。
- **会动的都是"接近零、斜率大"的量**：`V(out)` 最低点差 1 %、SR 反向峰差 1.7 %（绝对值只有
  0.23 A）。引用这两个量时给百分比，不要给 mV/10 mA 级的小数。
- 同一窗口内采样点多了 64 %，说明收紧容差确实逼出更小步长——这正是"诊断"与"重跑"的区别：
  轨迹并不相同，比的是峰值是否一致。

**这不解决塌缩**：诊断运行按设计停在 220 µs，296.929 µs 之后的死区仍无数据，
F01 的"前缀"定性不变。它只把"峰值可能只是某个求解器设置的产物"这个疑点变成
**实测的 0.16 %**。JSON：`hotfault_50v_120a_diag.json`（含 `results.base/diagnostic/delta/relative`
与结构性 `checks`；`hotfault_diagnostic.py` 生成）。

**48 V 对照组**（该基座由严格校验器判过 `LOG_PRECHECK_PASS`，跑满 320 µs）用同一工具、
同一 0–220 µs 窗口比对，见 `hotfault_48v_120a_diag.json`：trip 215.0967→214.9112 µs（**−185 ns**）、
`I(Lr)` 峰 97.4427→97.0335 A（**−0.420 %**）、SR 正向峰 292.608→291.404 A（**−0.411 %**）、
`V(oc)` 峰 +0.18 %、采样点 491 875→715 958（+46 %），末点差 0.056 ns，电路差异 0 条。

两组的读法要一致：**收紧容差都让峰值变小**（50 V −0.16 % / −0.002 %，48 V −0.42 % / −0.41 %），
所以"前缀峰值偏高"的方向是保守的——但这只是**同一电路在不同离散化下的散布**，不是误差棒；
48 V 那一组的绝对值 0.4 % 也提醒：`I(Lr)` 峰的可引用精度是**亚百分点**，不是 0.1 %。
两组都在 220 µs 截止，所以两组都没有塌缩之后的数据。

### 3.5 八只 SR 同窗探针：高电平在 A 相四只，但末端锁存只走 1.4 A（ELE-10，48 V）

基座 deck 只存了 pair 1/4 的门极，所以"末端一只 SR 仍高"只知道属于 **A 相**，其余六只
（尤其是 pair 2/3）在证据里是空的。`..._48v_120a_srprobe.cir` 由
`tools/make_sr_fault_probes.py` 从同一 deck 派生：**只增加 12 个 `.save` 变量**（pair 2/3
的门极、漏源电压、感测电流）与 24 条 `.meas`，电路、故障支路、`.tran`、`.options` 逐字节不变
（`test_make_sr_fault_probes.py` 逐行比对）。运行 **500.451 s**、raw **1,205,532,932 B**，
日志有 `Total elapsed time`，保存轴跑满 **320.000 µs**；`tools/sr_fault_probe_report.py`
读出全部八只，`reached_tstop=true`、`solver_prefix_only=false`
（`sr_fault_probe_48v_120a.json`）。

**结论一：末端高电平是 A 相四只同时锁存，B 相四只全关。**

| 器件 | 驱动释放（trip 后） | 门极末值 | 末次抬升 | 锁存时长 | 锁存内 \|I\| 峰 | 锁存内 I²t（每只） |
|---|---|---|---|---|---|---|
| 1A/2A/3A/4A | 220.7368 µs（+5.64 µs） | **10.890 V（高）** | **247.0703 µs** | **72.93 µs** | **1.405 A** | **1.0389e-4 A²s** |
| 1B/2B/3B/4B | 218.1919 µs（+3.10 µs） | 0 V（低） | —（216.6 µs 后再无抬升） | — | — | — |

四对在模型里逐项相同（差异 ~1e-9），**这不构成真实均流或器件分散性证据**——deck 的四组
本就同参数，和 CLAUDE.md 里 x4 缩放的结论一致。A 相锁存时刻与基座 JSON 的 247.07 µs 相同；
探针的 1A 驱动释放时间与基座 `first_sustained_drive_stop_ms` **逐位相等**
（220.736760 µs，两条独立运行的交叉校验）。

**结论二：高电平在末端，但故障电流不在那段时间里。** 必须把 trip 后分成两段：

| 量（每只） | A 相 | B 相 |
|---|---|---|
| trip 后正向峰 | **285.014 A @215.097 µs**（trip 当刻；整段 raw 的 292.61 A 在 **209.94 µs**，即 trip 前） | 132.166 A |
| trip 后正向 I²t | 0.03036 A²s | 0.02277 A²s |
| 其中门极为高的时段 | 0.02316 A²s（**76.3 %**） | 0.02032 A²s（89.2 %） |
| **末端锁存段**（247.07→320 µs） | **1.0389e-4 A²s**（正向仅 1.6e-8） | 无锁存 |

也就是说：几百安的 SR 电流出现在 **trip 后到驱动释放**（A 相 5.64 µs）这一段，此时门极
仍是上一开关周期的导通状态；**末端那 72.93 µs 的 10.89 V 高电平只对应 1.4 A 的反向环流**
（漏源 −0.280…+0.044 V），比同一只器件的 trip 后正向 I²t 小 **约 300 倍**，四只合计
4.156e-4 A²s。锁存本身不是"SR 直通大电流"，但也**不是安全的证明**：模型没有 SOA、热和
UCC24624 standby，1.4 A 的真实器件结温/驱动状态必须上电验证。

**机制与边界**：`sr_timing_v3_3.lib` 只在漏源反向偏置时关断；主桥停振后 A 相漏极浮空并
在 247.07 µs 再次越过开通阈值（`V(a1)≈−0.286 V`），此后没有反向偏置把它复位。B 相没有
越过阈值，所以保持关断。这与 §3.1 的 pair-1 结论一致，但把"某一路"细化成了"整个 A 相四路
同时"。**这段话只描述基座这一条数值轨迹**：同一 48 V 电路加 1 fF 后，锁存的是 B 相四只、
A 相全关（§3.7 的对照），所以"哪一相在死区里越过阈值"不是电路属性。**50 V 的八只探针
只能建在跑满的 cshunt 变体上**（§3.6）：它给出的末端**没有**高电平，而基座前缀在
296.929 µs 时 B 相仍高 —— 这个差别本身是结论，见 §3.7。

### 3.6 CONVERGENCE_DIAGNOSTIC：加 1 fF 节点电容后 50 V 跑满 320 µs

§3.2 把塌缩定性为"死区里的步长限制环、不是物理"。按这个定性，修法只能在求解器层面：
`..._hotfault_50v_120a_cshunt.cir` 只在 `.options` 里加 **`cshunt=1e-15`**（每节点对地
1 fF），电路、故障支路、探针、`.tran` 逐字节相同（`hotfault_convergence.py` 报
`circuit_differences()` **0 条**）。1 fF 在 200 kHz 是 795 kΩ，相对谐振腔与 1 mΩ 故障
支路不可测；它存在的意义是让"只有行为电荷"的节点不再没有常数电容，LTE 判据不再要求
无限小步长。

**它跑完了**（`hotfault_50v_120a_cshunt.json`）：`Total elapsed time 438.604 s`、
raw **941,858,736 B**、`last_time` 的末记录起点 **320.000 µs**；按五项探针齐全读取，
最后完整记录 **319.9956 µs**（末记录未写全，`read_window` 的 NaN 掩码丢掉它）。对照基座：
62 min 只到 296.929 µs、写了 14.20 GB。

先回答"它有没有改变物理"——同一 0–220 µs 窗口、同一峰值定义：

| 量（0–220 µs） | 基座 | cshunt 变体 | 差 |
|---|---|---|---|
| trip | 214.9153 µs | 215.0144 µs | **+99.07 ns（+0.046 %）** |
| `I(Lr)` 峰 | 101.2627 A @209.9490 µs | 101.0965 A @209.9512 µs | **−0.1662 A（−0.164 %）** |
| SR 正向峰 | 303.9300 A | 303.4963 A | **−0.4337 A（−0.143 %）** |
| SR 反向峰 | 13.7512 A | 13.6858 A | −0.0653 A（−0.475 %） |
| `V(oc)` 峰 | 1.09177 V | 1.09025 V | −1.52 mV（−0.139 %） |
| `V(out)` 最低 | 0.94719 V | 0.94466 V | −2.52 mV（−0.266 %） |
| 采样点 | 423 028 | 429 543 | +1.5 % |

读法：

- **头部峰值与 SOLVER_DIAGNOSTIC 同量级**：`I(Lr)` −0.164 %（诊断组 −0.161 %）、
  SR 正向 −0.143 %（诊断组 +0.002 %）。3 匝磁通按 `B ∝ I` 只动 **约 0.0004 T**，
  与 §3.4 的 ±0.0004 T 一致，MAG-02 的 0.0194 T 余量不变。
- **方向不固定**：诊断组 trip 早 81 ns，cshunt 晚 99 ns。这进一步支持"亚百分点移动是
  离散化散布"，不能把它当成误差棒或系统偏差来修正设计值。
- **一次求解器辅助解不等于"50 V 安全"**：它补上的是时间轴，不是保护结论；末端 SR 门极
  状态由 §3.7 的八只探针回答，模型边界（无 standby/SOA/热）一条也没变。

完整 320 µs 上（只有变体有，没有基座对照）`I(Lr)` 峰 101.0965 A @209.951 µs、
SR 正向峰 303.496 A、SR 反向峰 13.686 A、`V(oc)` 峰 1.2717 V、`V(out)` 故障后最低
**0.743 mV**、469 399 点——与 §3.2 的"故障后输出塌到毫伏级"一致。这些数只在
"cshunt 变体、前缀已比对"的口径下引用。

### 3.7 50 V 八只探针（建在 cshunt 变体上）：末端没有门极高电平，而基座前缀有

`make_sr_fault_probes.py` 从 §3.6 的变体派生 `..._50v_120a_cshunt_srprobe.cir`，
只追加 `.save`/`.meas`（电路、故障支路与探针逐字节相同）。运行 **456.395 s**、
raw **1,079,779,478 B / 94 变量 / 469 400 点**，`reached_tstop=true`、
`solver_prefix_only=false`。结果与前缀**定性不同**：

| | 基座前缀（止于 296.929 µs） | cshunt 完整解（320 µs） |
|---|---|---|
| A 相门极 | 全程低 | 235.184–237.577 µs 高（10.923 V），之后低 |
| B 相门极 | 244.47 µs 起高，保持到前缀末端 | 232.104–233.217 µs 高（10.913 V），之后低 |
| `t=320 µs` 门极 | 无数据 | **八只全低**（−0.0077…+0.0030 V） |
| trip 后正向峰 | 303.93 A（整段，含 trip 前） | A 相 300.22 A、B 相 126.73 A（都在释放窗） |

`sr_fault_probe_report.py` 给出 `devices_high_at_end=[]`、`final_latch_devices=[]`。
**独立交叉核对**：`..._50v_120a_cshunt.raw`（同变体基座、只存 pair 1/4、59 变量）给出
**同一组**门极区间（A 235.177–237.577 µs、B 232.098–233.217 µs）与同样的末端低电平，
所以这不是探针 deck 的伪影。

**读法**：1 fF 在 200 kHz 是 795 kΩ，不能用"加了电容"解释这个差别；差别来自**死区里 SR
时序模型的门极判据**——它只在漏源反向偏置时关断，主桥停振后该偏置由数值轨迹决定。
同一个模型因此给出三种末态：48 V 基座是 A 相高、50 V 基座前缀是 B 相高、50 V cshunt
变体是八只全低。**末态门极电平不是电路属性**，既不能当作"锁存危害"证据，也不能当作
"安全关断"证据；它只说明该模型在死区的门极状态对求解器扰动敏感。

**不变的部分**：故障应力（trip 215.0 µs、`I(Lr)` 峰 209.95 µs、SR 正向峰）都落在
209–215 µs，与死区无关，§3.4/§3.6 的前缀比对继续有效。**保护结论也没有变**：模型没有
UCC24624 standby、SOA 与热模型，任何一相在 320 µs 为低都不构成安全关断证明。下一步是
真实器件验证（standby/轻载关断、栅极复位路径），不是在两个求解器轨迹里挑一个"正确的"。

### 3.8 48 V 对照：同一个 1 fF 把锁存从 A 相翻到 B 相（ELE-10）

§3.7 只说"末态对求解器扰动敏感"，但要排除"50 V 的差别来自电压/负载不同"，需要在
**同一 48 V 电路**上做同样的 1 fF 扰动。为此把 §3.6 的做法原样搬到 48 V：
`..._48v_120a_cshunt.cir` 只在 `.options` 加 `cshunt=1e-15`，再按 §3.5 的生成器派生
`..._48v_120a_cshunt_srprobe.cir`（`circuit_differences()` **0 条**，48/50 V 两个变体
都由 `test_make_sr_fault_probes.py` 逐行锁住）。两次运行 **549.607 s / 594.263 s**、
raw **1,055,527,140 B / 1,209,980,429 B**，两者 `reached_tstop=true`。

先确认扰动没有改动物理（0–220 µs 同窗口）：

| 量（0–220 µs） | 48 V 基座 | 48 V cshunt | 相对差 |
|---|---|---|---|
| trip | 215.0966 µs | 215.0986 µs | **+1.90 ns（+8.85e-6）** |
| `I(Lr)` 峰 | 97.4427 A | 97.4792 A | **+0.0375 %** |
| SR 正向峰 | 292.608 A | 292.745 A | **+0.0471 %** |
| SR 反向峰 | 13.5601 A | 13.5382 A | −0.162 % |
| `V(out)` 故障后最低 | 0.90833 V | 0.90819 V | −0.015 % |

全部在 §3.4/§3.6 的亚百分点散布内——**这不是另一场故障**。但末端门极状态完全相反：

| | 48 V 基座（§3.5） | 48 V cshunt |
|---|---|---|
| 末端为高的器件 | **1A/2A/3A/4A** | **1B/2B/3B/4B** |
| 另一相 | 四只全低 | 四只全低 |
| 锁存起点 | 247.0703 µs | 249.3845 µs |
| 锁存时长 | 72.93 µs | 70.62 µs |
| 锁存内 \|I\| 峰（每只） | 1.4053 A | 1.1987 A |
| 锁存内 I²t（每只） | 1.0389e-4 A²s | 7.2768e-5 A²s |
| 锁存内漏源范围 | −0.280…+0.044 V | −0.281…+0.044 V |
| trip 后正向峰 | A 285.014 A / B 132.166 A | A 284.367 A / B 132.265 A |

**读法**：故障电流（A 285.0 → 284.4 A，−0.23 %；B 132.17 → 132.27 A，+0.08 %）与 trip
时间（+1.9 ns）几乎不动，而**"哪一相锁存"整个翻转**。1 fF 在 200 kHz 是 795 kΩ，不可能
参与这个选择；所以死区里 SR 门极的开/关由数值轨迹在越过阈值那一刻的相位决定。四条运行
因此给出四个末态：48 V 基座 A 高、48 V cshunt B 高、50 V 基座前缀 B 高、50 V cshunt 八只
全低。**"高电平在 A 相"是基座轨迹的性质，不是设计性质。**

**能留下的结论只有定性那一条**：无论哪一相锁存，锁存段都是**低电流**（1.2–1.4 A、
每只约 1e-4 A²s、漏源在 −0.28…+0.04 V），比 trip 后正向 I²t 小两个数量级以上；而
trip 后的大电流（284–303 A）发生在**驱动释放前**、与末端门极电平无关。这条不随 1 fF
翻转，但它仍然**不构成**安全关断证据——模型没有 SOA、热与 UCC24624 standby。

## 4. 对 Lr 磁通判据的影响（MAG-02）

按 `lr_design.py` 的同一组常数：`L=1.0 µH`、`Ae=1.30e-4 m²`、
`Bsat=0.310 T`、判据线 `0.9·Bsat=0.279 T`。
`B = L·I/(N·Ae)`：

| 峰值电流 | 2 匝 B | 3 匝 B | 2 匝 Isat=80.6 A | 3 匝 Isat=120.9 A |
|---|---|---|---|---|
| 冷启动故障 84.83 A | 0.3263 T（超判据 16.9 %） | 0.2175 T | 1.05× Isat | 0.70× |
| 稳态 48 V 97.44 A | **0.3748 T（超 34.3 %）** | 0.2499 T | 1.21× Isat | 0.81× |
| 稳态 50 V 101.26 A | **0.3895 T（超 39.6 %）** | **0.2596 T（余量 0.0194 T）** | 1.26× Isat | 0.84× |

三点都要读成"线性模型下的下限"：65 A / 74 A / 97 A / 101 A 都是在**未饱和**的 L 上算的，
真实饱和后 di/dt 更高、峰值更大。因此：

- **2 匝仍不放行**，且稳态故障比此前引用的 84.83 A 更差；
- **3 匝在 50 V 稳态故障下仍低于 0.9·Bsat（0.2596 < 0.279 T）**，但只剩 7 % 余量，
  且这是计算值，不是首件实测。L(I)、气隙、公差与厂商 Bsat 仍是 MAG-02 的未解除阻塞。

## 5. 边界与未验证项

- 两个 deck 都是**稳态初始化**，不是冷启动；不能用于启动保护、冷态浪涌或自举塌陷结论。
- **50 V 基座只有前缀证据**：求解器在 296.929 µs 塌缩，严格校验器拒绝出具报告；不得把
  **基座**写成"跑完"。§3.4 的诊断运行把前缀内峰值的不确定度实测为 0.16 %（`I(Lr)`）/
  0.002 %（SR 正向），但它停在 220 µs。§3.6 的 `cshunt=1e-15` 变体跑满 320 µs，
  与基座同一 0–220 µs 窗口的峰值差 −0.164 % / −0.143 %、trip 晚 99 ns；**它是求解器
  辅助解，引用时两条限定都要带**（`cshunt` 条件 + 前缀比对），不能单独当作"50 V 跑完了"。
- 模型没有热、SOA、真实均流与器件分散性；SR 峰 304 A 不是器件额定值，也不是结温证据。
- **`sr_timing_v3_3` 不实现 UCC24624 的 standby/轻载关断**，trip 后可能有 SR 门极保持导通；
  这是模型边界，不能当作真实器件的"直通"或"已关断"证据。但本窗口内 standby 本来也不会
  触发（`tSTBY_DET` 7.5 ms），所以它**不是** 50 V 塌缩的原因，也不是它的修法。
- **八只 SR 同窗证据有四份，末态互不一致**：48 V 基座是 A 相四只锁存、B 相四只关断
  （§3.5）；**同一 48 V 电路加 1 fF 后变成 B 相四只锁存、A 相全关**（§3.8）；50 V 在
  cshunt 变体上跑满 320 µs，末端八只全低，而基座前缀自 244.47 µs 起 B 相保持高电平
  （§3.7）。1 fF 不能改变电路（`circuit_differences()` 0 条），故障应力只动 0.04 %
  ⇒ **死区门极末态是求解器敏感量，不是电路属性**，四份末态都只能当"模型在死区的行为"，
  不能当作危害或安全关断证据；它们也没有回答真实器件的 SOA/热。能跨变体保留的只有
  "锁存是低电流（1.2–1.4 A、每只约 1e-4 A²s）"这一条。50 V 基座本身仍只有 296.929 µs
  前缀，引用其峰值必须写"前缀"。
- `V(oc)` 是 CT 重建量，不是电流探头；OC 延迟 40 µs 依赖 `sr_timing_v3_3` 的延迟模型，
  未经硬件验证。
- 保存窗口在投入后只有约 145 µs（48 V）/ 约 122 µs（50 V）；更长锁存/重试/恢复不在证据内。
- deck 头注按生成器要求写 `UNRUN, NOT HARDWARE RATED`；运行事实以本文和 JSON 为准
  （`test_make_hot_fault_decks.py` 锁住头注，`test_d1_unclosed_risks.py` 锁住本记录的关键数）。

## 6. 复现

```bash
/d/ADI/LTspice/LTspice.exe -b -ascii sim/v3/sr_tank_dual_v33_ss_hotfault_48v_120a.cir
/d/ADI/LTspice/LTspice.exe -b -ascii sim/v3/sr_tank_dual_v33_ss_hotfault_50v_120a.cir
python tools/validate_hotfault_log.py --case 48v_120a \
  --log sim/v3/sr_tank_dual_v33_ss_hotfault_48v_120a.log \
  --raw sim/v3/sr_tank_dual_v33_ss_hotfault_48v_120a.raw \
  --json sim/v3/sr_tank_dual_v33_ss_hotfault_48v_120a.validation.json
python tools/hot_fault_metrics.py \
  --raw sim/v3/sr_tank_dual_v33_ss_hotfault_48v_120a.raw \
  --log sim/v3/sr_tank_dual_v33_ss_hotfault_48v_120a.log \
  --deck sim/v3/sr_tank_dual_v33_ss_hotfault_48v_120a.cir --rl 15.4m \
  --json design/v3/power_priority/hotfault_48v_120a.json
python tools/hot_fault_metrics.py \
  --raw sim/v3/sr_tank_dual_v33_ss_hotfault_50v_120a.raw \
  --log sim/v3/sr_tank_dual_v33_ss_hotfault_50v_120a.log \
  --deck sim/v3/sr_tank_dual_v33_ss_hotfault_50v_120a.cir --rl 16.3m \
  --json design/v3/power_priority/hotfault_50v_120a.json

# 八只 SR 同窗探针（§3.5）；raw 不进 Git，JSON 是证据
python tools/make_sr_fault_probes.py --write
/d/ADI/LTspice/LTspice.exe -b -ascii sim/v3/sr_tank_dual_v33_ss_hotfault_48v_120a_srprobe.cir
python tools/sr_fault_probe_report.py --case 48v_120a \
  --json design/v3/power_priority/sr_fault_probe_48v_120a.json

# 50 V 的八只探针只能建在跑满的 cshunt 变体上（§3.6）
/d/ADI/LTspice/LTspice.exe -b -ascii sim/v3/sr_tank_dual_v33_ss_hotfault_50v_120a_cshunt.cir
python tools/hotfault_convergence.py \
  --base-raw sim/v3/sr_tank_dual_v33_ss_hotfault_50v_120a.raw \
  --base-deck sim/v3/sr_tank_dual_v33_ss_hotfault_50v_120a.cir \
  --base-log sim/v3/sr_tank_dual_v33_ss_hotfault_50v_120a.log \
  --variant-raw sim/v3/sr_tank_dual_v33_ss_hotfault_50v_120a_cshunt.raw \
  --variant-deck sim/v3/sr_tank_dual_v33_ss_hotfault_50v_120a_cshunt.cir \
  --variant-log sim/v3/sr_tank_dual_v33_ss_hotfault_50v_120a_cshunt.log \
  --json design/v3/power_priority/hotfault_50v_120a_cshunt.json
/d/ADI/LTspice/LTspice.exe -b -ascii sim/v3/sr_tank_dual_v33_ss_hotfault_50v_120a_cshunt_srprobe.cir
python tools/sr_fault_probe_report.py --case 50v_120a_cshunt \
  --json design/v3/power_priority/sr_fault_probe_50v_120a_cshunt.json

# 48 V 对照：同一 1 fF 扰动，用来分辨"末态相位"是不是求解器选的（§3.8）
/d/ADI/LTspice/LTspice.exe -b -ascii sim/v3/sr_tank_dual_v33_ss_hotfault_48v_120a_cshunt.cir
python tools/hotfault_convergence.py \
  --base-raw sim/v3/sr_tank_dual_v33_ss_hotfault_48v_120a.raw \
  --base-deck sim/v3/sr_tank_dual_v33_ss_hotfault_48v_120a.cir \
  --base-log sim/v3/sr_tank_dual_v33_ss_hotfault_48v_120a.log \
  --variant-raw sim/v3/sr_tank_dual_v33_ss_hotfault_48v_120a_cshunt.raw \
  --variant-deck sim/v3/sr_tank_dual_v33_ss_hotfault_48v_120a_cshunt.cir \
  --variant-log sim/v3/sr_tank_dual_v33_ss_hotfault_48v_120a_cshunt.log \
  --json design/v3/power_priority/hotfault_48v_120a_cshunt.json
/d/ADI/LTspice/LTspice.exe -b -ascii sim/v3/sr_tank_dual_v33_ss_hotfault_48v_120a_cshunt_srprobe.cir
python tools/sr_fault_probe_report.py --case 48v_120a_cshunt \
  --json design/v3/power_priority/sr_fault_probe_48v_120a_cshunt.json
```

50 V 重跑前先看 §3.2：原地重跑会再次停在同一位置；要跑满只能改求解器设置并把结果标成
`SOLVER_DIAGNOSTIC` / `CONVERGENCE_DIAGNOSTIC`，或者接受前缀。`cshunt` 变体必须先用
`hotfault_convergence.py` 与基座比前缀，否则"跑完了"没有数值可信度的限定。
