czy0126/CZY/c-012_dc-dc_llc_buck_converter_vo=12v_io=250a_ltspice/DC-DC LLC Buck Converter Vo=12V Io=250A.asc

C1: cap; 50n
C2: cap; 1m
D1: schottky; RB238T-40NZ
D2: schottky; RB238NS-40
D3: schottky; RB238NS-40
D4: schottky; RB238NS-40
D5: schottky; RB238T-40NZ
D6: schottky; RB238NS-40
D7: schottky; RB238NS-40
D8: schottky; RB238NS-40
D9: schottky; RB160MM-40
D10: schottky; RB160MM-40
D11: schottky; RB160MM-40
D12: schottky; RB160MM-40
L1: ind; 100µ
L2: ind2; 500µ
L3: ind2; 1.25µ
L4: ind2; 1.25µ
R3: res2; {Vout/Io}
R4: res; {Rg_off}
R5: res; {Rg_on}
R6: res; {Rg_off}
R7: res; {Rg_on}
U1: PFM-LLC-CONVERTER
U2: SCT4090KE_L3
U3: SCT4090KE_L3
V1: voltage; {Vin}
Named nets: OUT, 0, IN, FB, U2_G, U3_G, Q1_S, Q1_G, Q2_G
.param
+Vin=800
+Vout=12 
+Io=250
+Rg_on=2
+Rg_off=1
+fmin=50k 
+fmax=100k
+Vg_H=18 
+Vg_L=0
.tran 0 5m 0
.temp 100
Default Condition:
Vin=800V  Vout=12V  Io=250A
fsw=50kHz~100kHz  Tj=100degC
K1 L2 L3 L4 1.
