czy0126/CZY/sim/smoke.cir

* Toolchain smoke
V1 in 0 1
R1 in out 1k
C1 out 0 1u
.tran 1m
.end
