czy0126/CZY/pcb/control_validation/control_validation.kicad_sch

## KiCad design pcb/control_validation/control_validation.kicad_sch (2026-11-01)

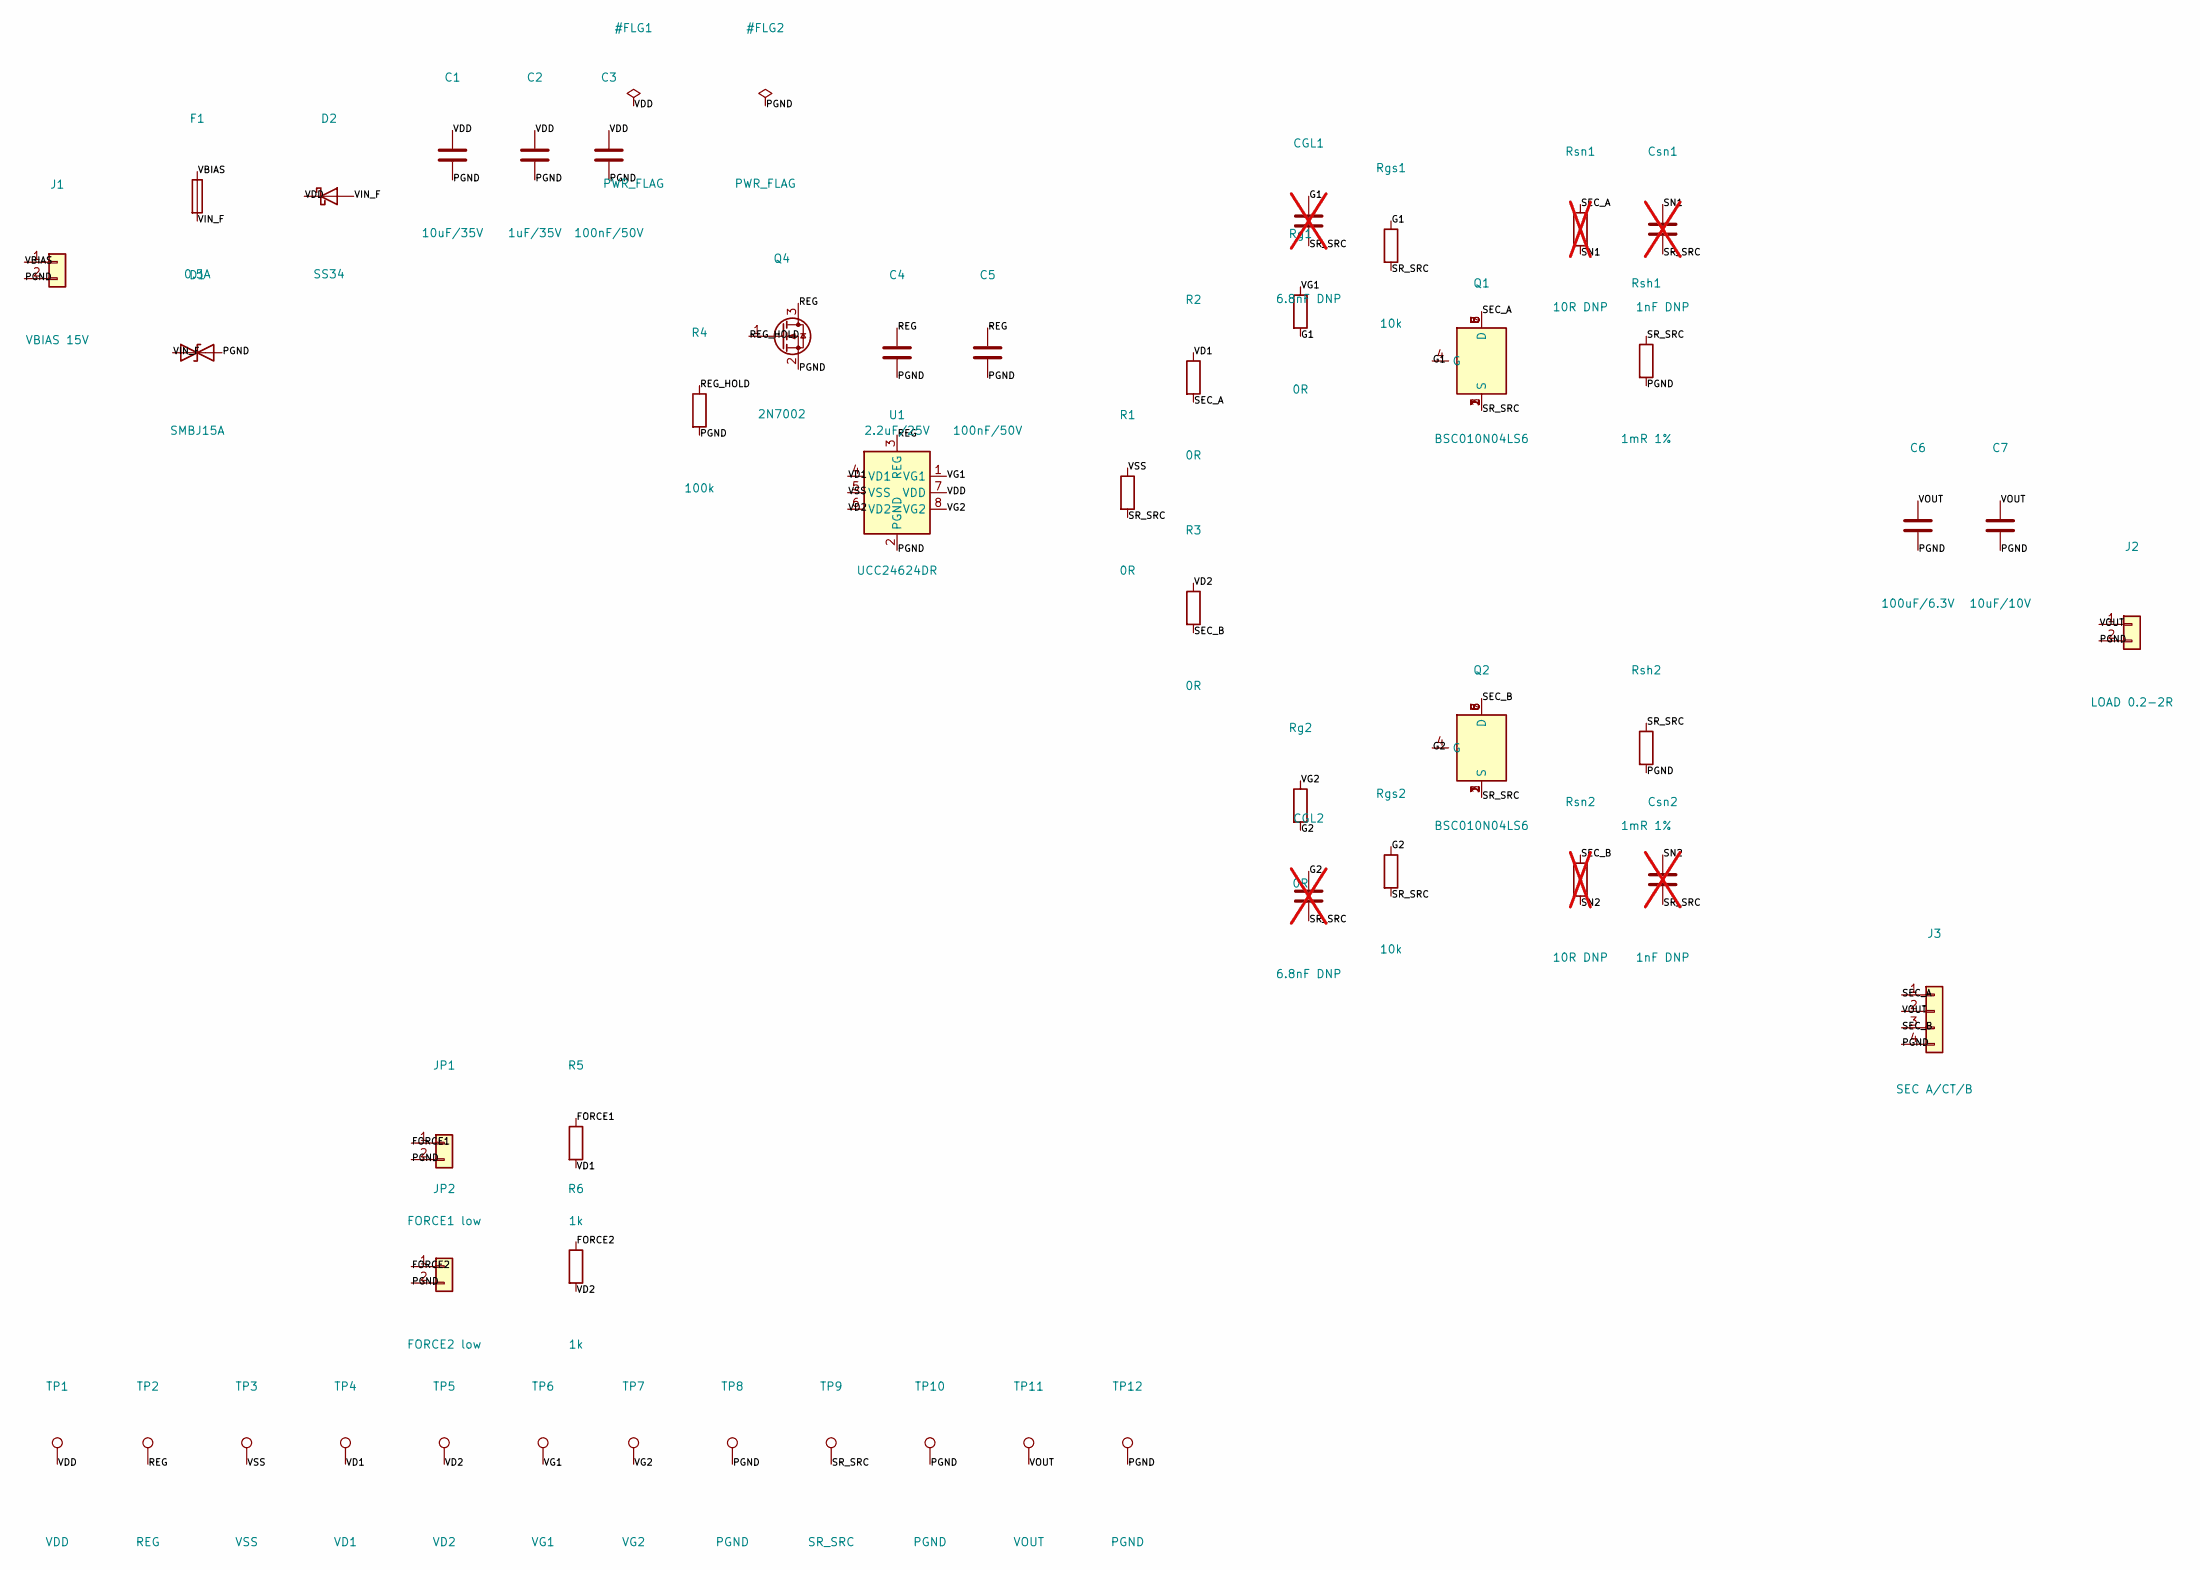
[picture p14: schematic control_validation.kicad_sch]

Parts:
C1: 10uF/35V; C_1210_3225Metric
C2: 1uF/35V; C_0805_2012Metric
C3, C5: 100nF/50V; C_0603_1608Metric
C4: 2.2uF/25V; C_1206_3216Metric
C6: 100uF/6.3V; C_1210_3225Metric
C7: 10uF/10V; C_0805_2012Metric
CGL1, CGL2: 6.8nF DNP; C_0603_1608Metric; not fitted
Csn1, Csn2: 1nF DNP; C_0603_1608Metric; not fitted
D1: SMBJ15A; D_SMB
D2: SS34; D_SMA
F1: 0.5A; Fuse_1206_3216Metric
J1: VBIAS 15V; TerminalBlock_MaiXu_MX126-5.0-02P_1x02_P5.00mm
J2: LOAD 0.2-2R; TerminalBlock_MaiXu_MX126-5.0-02P_1x02_P5.00mm
J3: SEC A/CT/B; TerminalBlock_MaiXu_MX126-5.0-04P_1x04_P5.00mm
JP1: FORCE1 low; PinHeader_1x02_P2.54mm_Vertical
JP2: FORCE2 low; PinHeader_1x02_P2.54mm_Vertical
Q1, Q2: BSC010N04LS6; Infineon_PG-TDSON-8_6.15x5.15mm
Q4: 2N7002; SOT-23
R1: 0R; R_0805_2012Metric
R2, R3: 0R; R_0603_1608Metric
R4: 100k; R_0603_1608Metric
R5, R6: 1k; R_0603_1608Metric
Rg1, Rg2: 0R; R_0805_2012Metric
Rgs1, Rgs2: 10k; R_0603_1608Metric
Rsh1, Rsh2: 1mR 1%; R_2512_6332Metric
Rsn1, Rsn2: 10R DNP; R_0603_1608Metric; not fitted
TP1: VDD; TestPoint_Pad_D1.0mm
TP2: REG; TestPoint_Pad_D1.0mm
TP3: VSS; TestPoint_Pad_D1.0mm
TP4: VD1; TestPoint_Pad_D1.0mm
TP5: VD2; TestPoint_Pad_D1.0mm
TP6: VG1; TestPoint_Pad_D1.0mm
TP7: VG2; TestPoint_Pad_D1.0mm
TP8, TP10, TP12: PGND; TestPoint_Pad_D1.0mm
TP9: SR_SRC; TestPoint_Pad_D1.0mm
TP11: VOUT; TestPoint_Pad_D1.0mm
U1: UCC24624DR; SOIC-8_3.9x4.9mm_P1.27mm

Connections:
FORCE1: JP1.1, R5.1
FORCE2: JP2.1, R6.1
G1: CGL1.1, Q1.4 (G), Rg1.2, Rgs1.1
G2: CGL2.1, Q2.4 (G), Rg2.2, Rgs2.1
PGND: C1.2, C2.2, C3.2, C4.2, C5.2, C6.2, C7.2, D1.2 (A2), J1.2, J2.2, J3.4, JP1.2, JP2.2, Q4.2 (S), R4.2, Rsh1.2, Rsh2.2, TP8.1, TP10.1, TP12.1, U1.2 (PGND)
REG: C4.1, C5.1, Q4.3 (D), TP2.1, U1.3 (REG)
REG_HOLD: Q4.1 (G), R4.1
SEC_A: J3.1, Q1.5 (D), Q1.6 (D), Q1.7 (D), Q1.8 (D), R2.2, Rsn1.1
SEC_B: J3.3, Q2.5 (D), Q2.6 (D), Q2.7 (D), Q2.8 (D), R3.2, Rsn2.1
SN1: Csn1.1, Rsn1.2
SN2: Csn2.1, Rsn2.2
SR_SRC: CGL1.2, CGL2.2, Csn1.2, Csn2.2, Q1.1 (S), Q1.2 (S), Q1.3 (S), Q2.1 (S), Q2.2 (S), Q2.3 (S), R1.2, Rgs1.2, Rgs2.2, Rsh1.1, Rsh2.1, TP9.1
VBIAS: F1.1, J1.1
VD1: R2.1, R5.2, TP4.1, U1.4 (VD1)
VD2: R3.1, R6.2, TP5.1, U1.6 (VD2)
VDD: C1.1, C2.1, C3.1, D2.1 (K), TP1.1, U1.7 (VDD)
VG1: Rg1.1, TP6.1, U1.1 (VG1)
VG2: Rg2.1, TP7.1, U1.8 (VG2)
VIN_F: D1.1 (A1), D2.2 (A), F1.2
VOUT: C6.1, C7.1, J2.1, J3.2, TP11.1
VSS: R1.1, TP3.1, U1.5 (VSS)
