czy0126/CZY/pcb/d0_protection/d0_protection.kicad_sch

## KiCad design pcb/d0_protection/d0_protection.kicad_sch (2026-11-05)

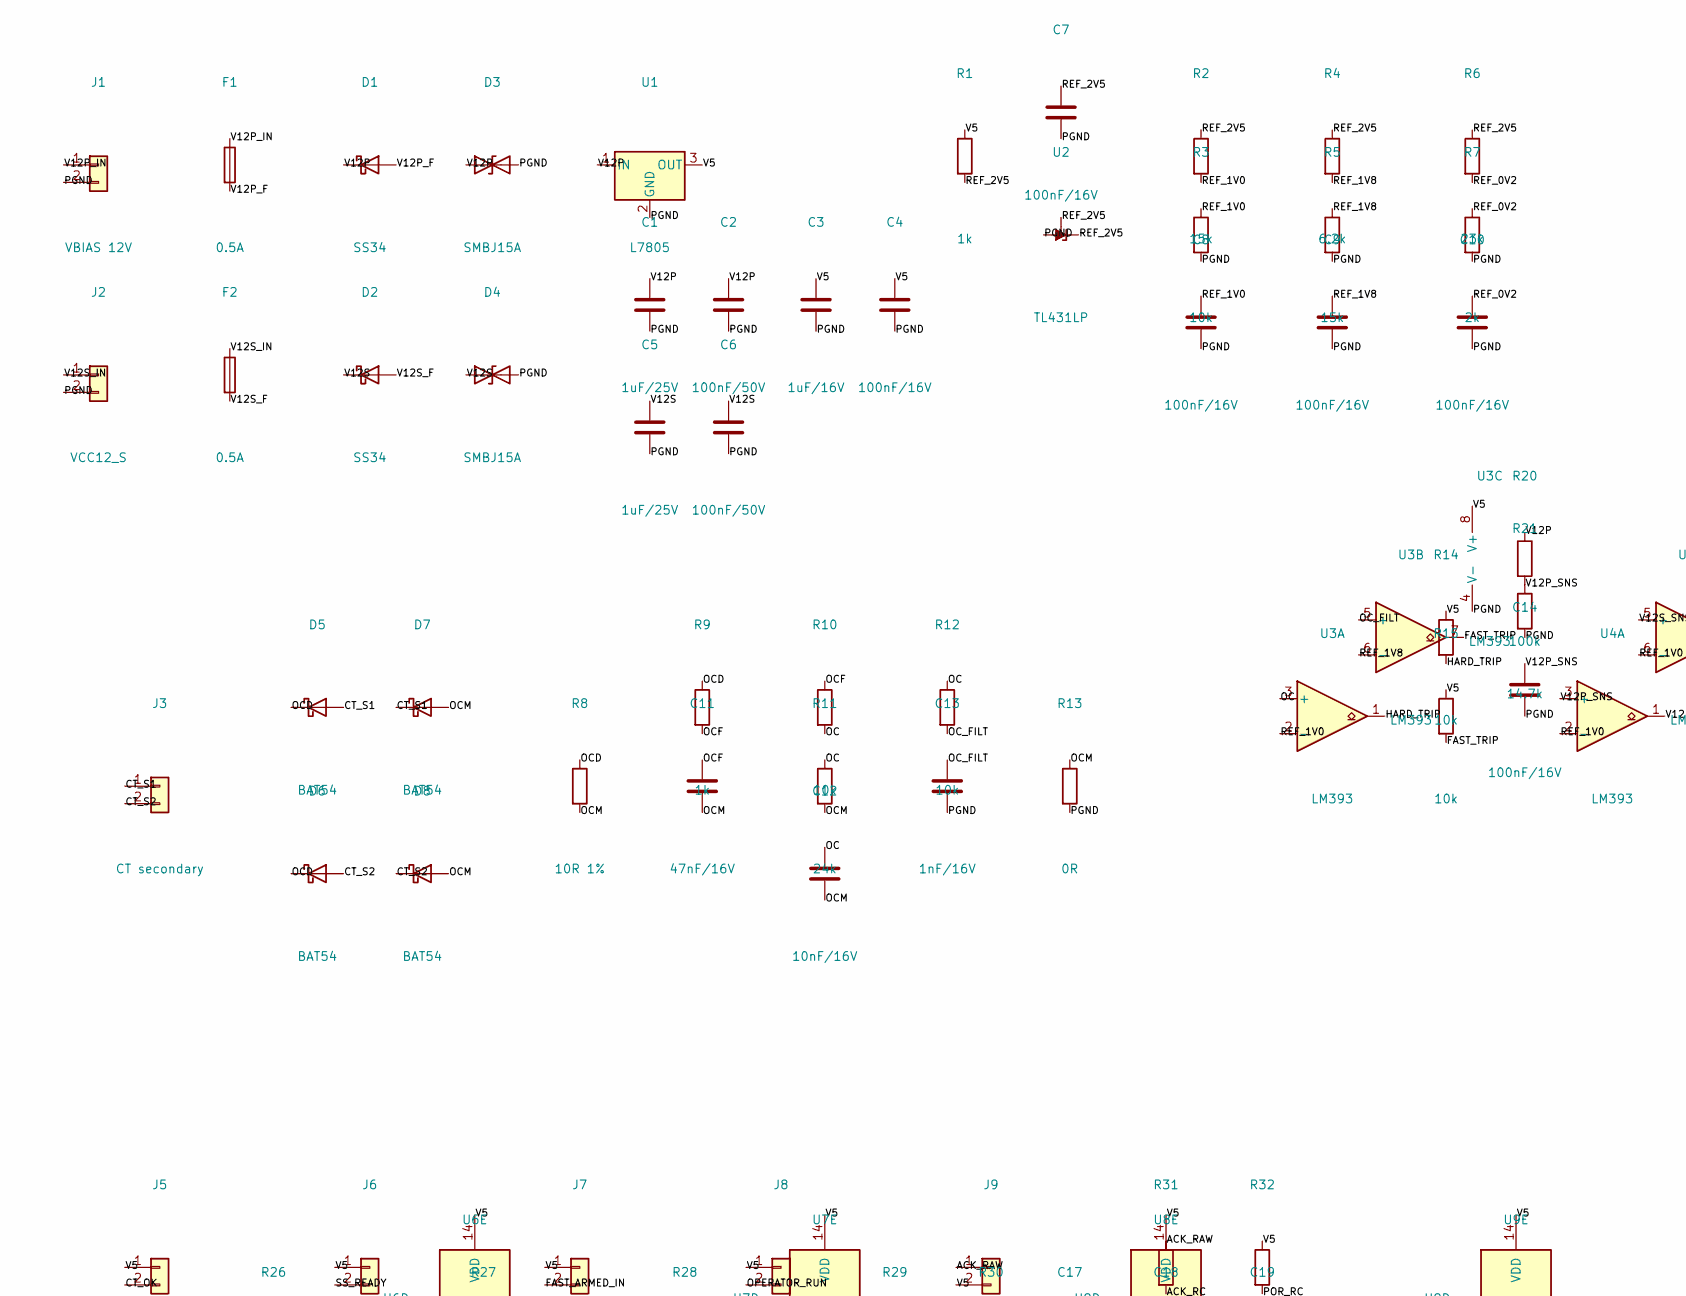
[picture p15: schematic d0_protection.kicad_sch, part in row 1, column 1]

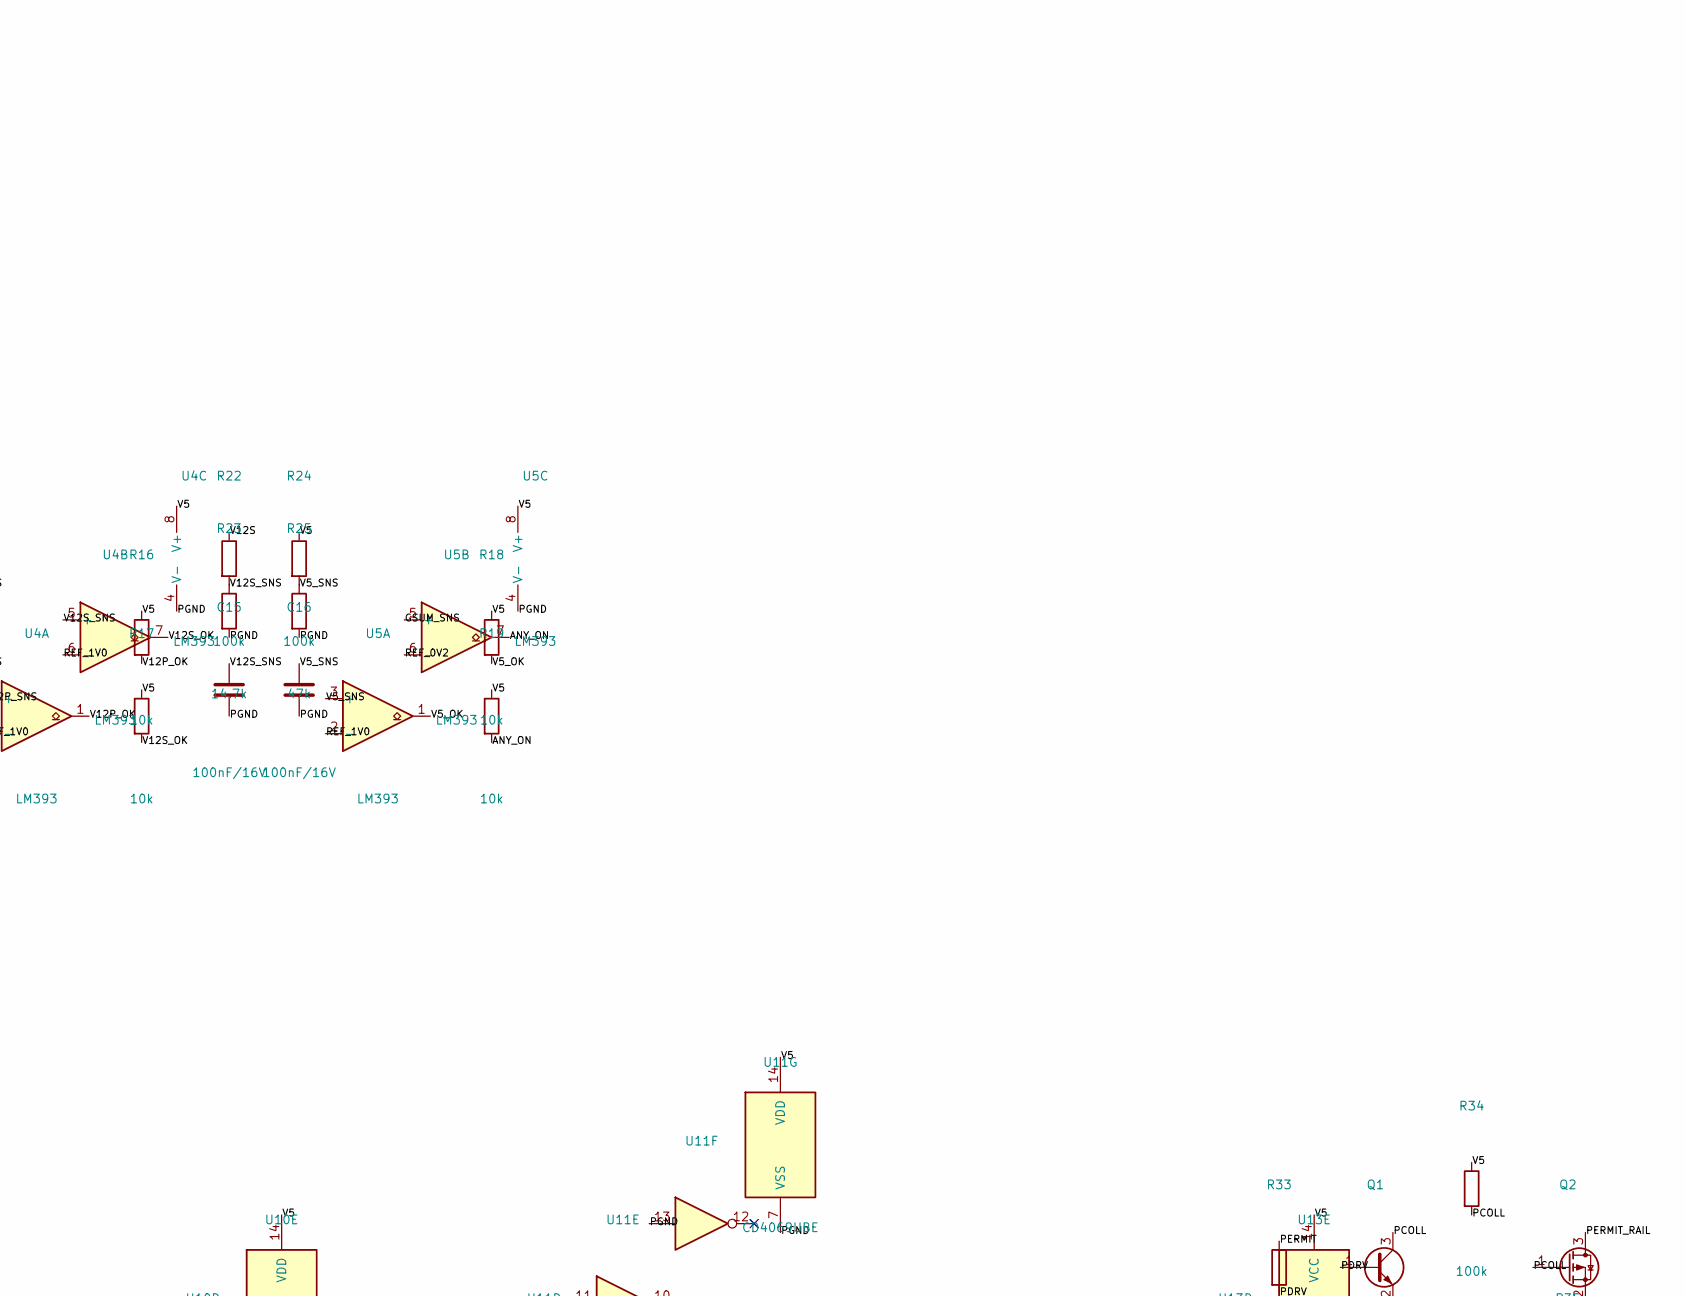
[picture p16: schematic d0_protection.kicad_sch, part in row 1, column 2]

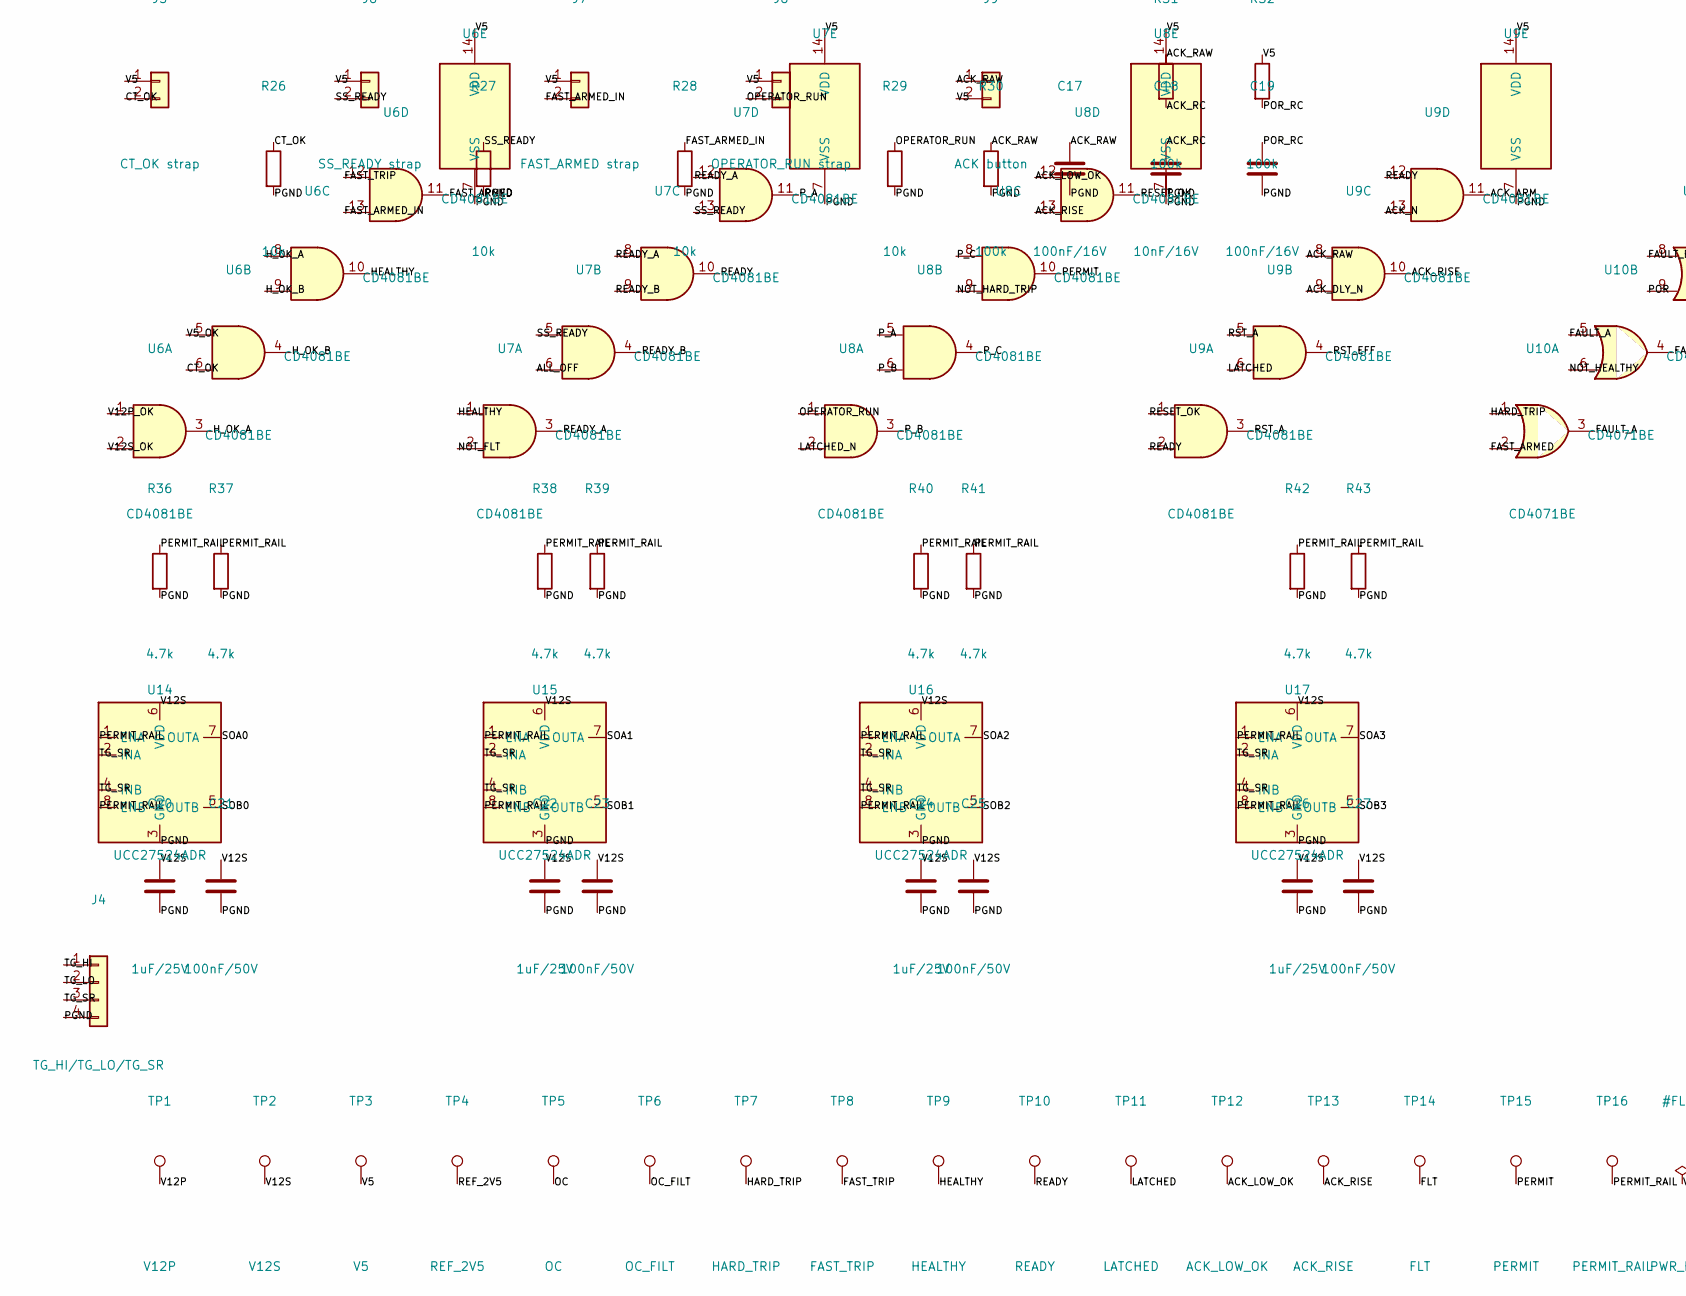
[picture p17: schematic d0_protection.kicad_sch, part in row 2, column 1]

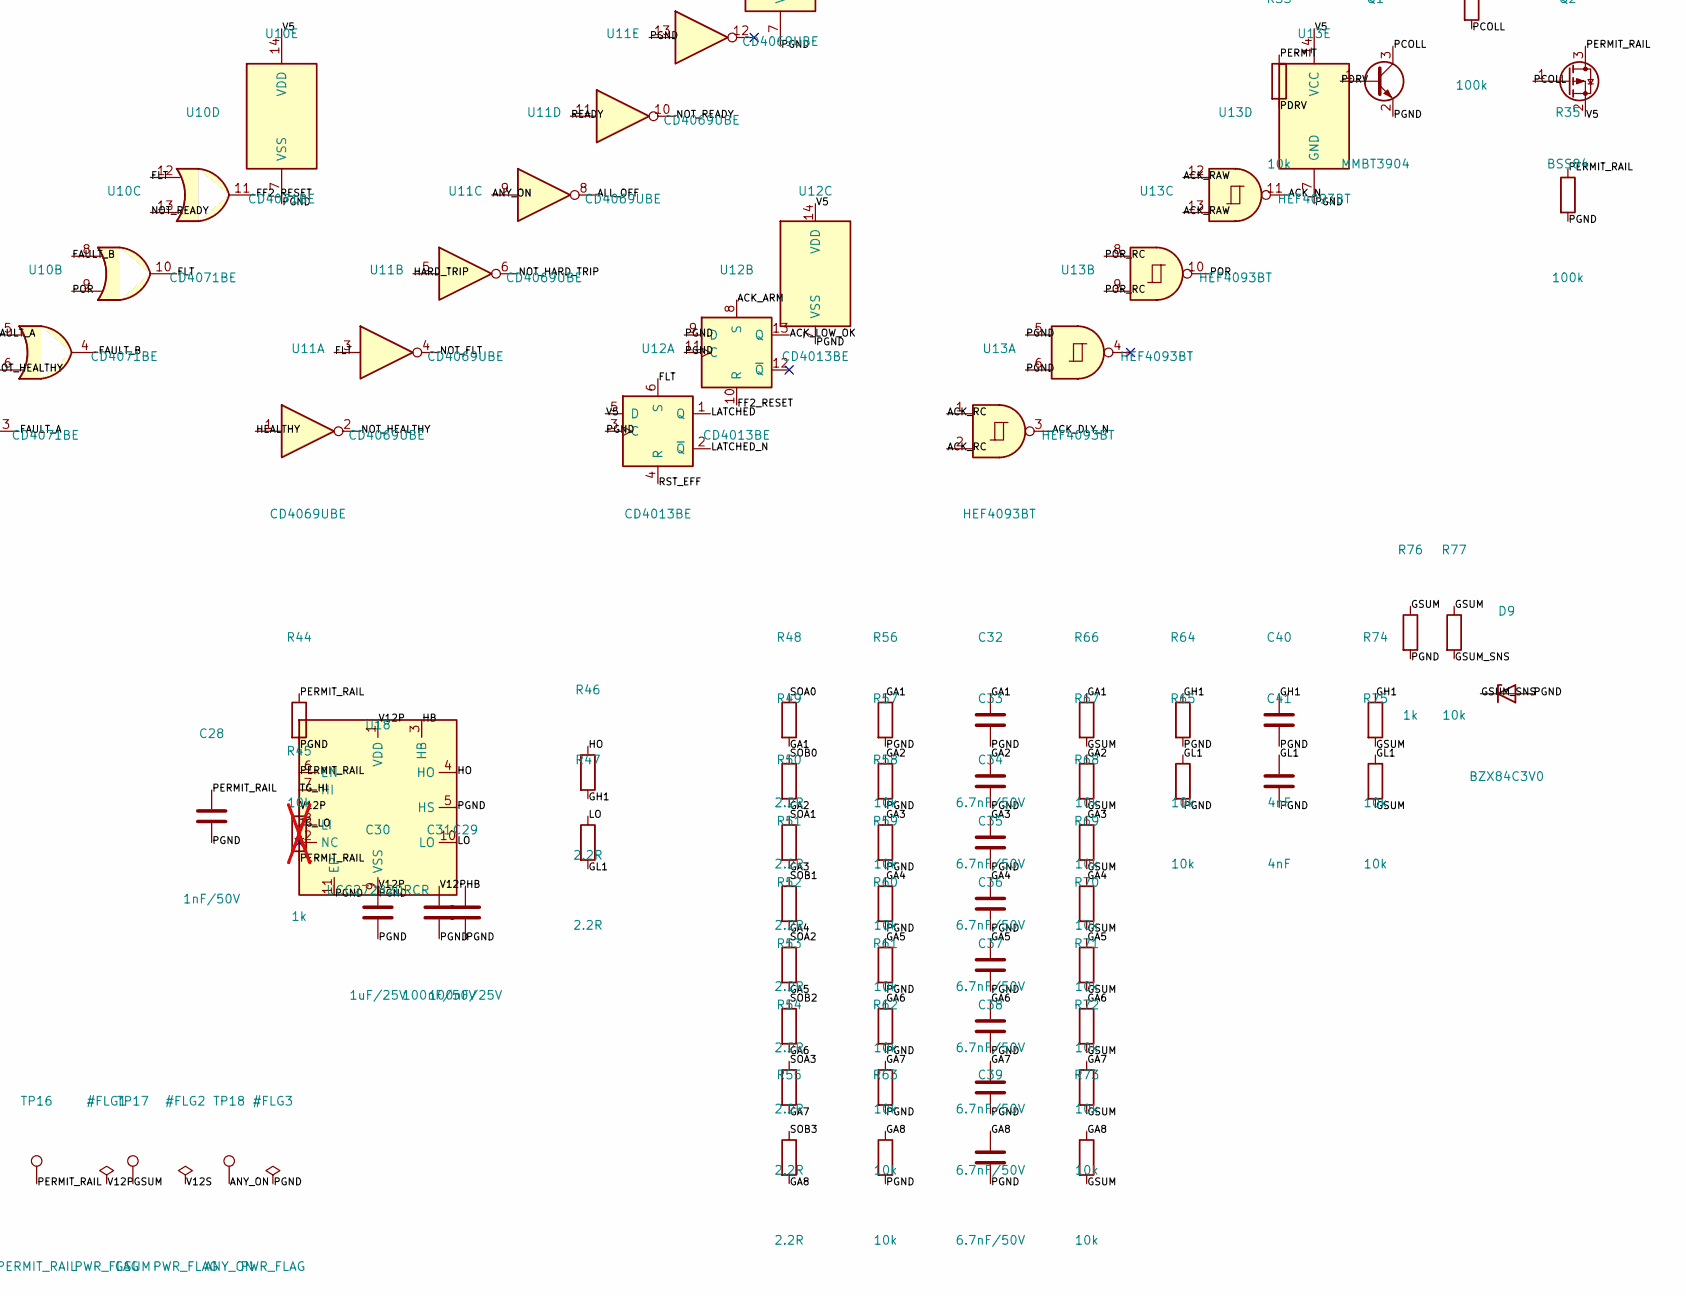
[picture p18: schematic d0_protection.kicad_sch, part in row 2, column 2]

Parts:
C1, C5, C20, C22, C24, C26, C30: 1uF/25V; C_1206_3216Metric
C2, C6, C21, C23, C25, C27, C31: 100nF/50V; C_0603_1608Metric
C3: 1uF/16V; C_1206_3216Metric
C4, C7, C8, C9, C10, C14, C15, C16, C17, C19: 100nF/16V; C_0603_1608Metric
C11: 47nF/16V; C_0603_1608Metric
C12, C18: 10nF/16V; C_0603_1608Metric
C13: 1nF/16V; C_0603_1608Metric
C28: 1nF/50V; C_0603_1608Metric
C29: 100nF/25V; C_0603_1608Metric
C32, C33, C34, C35, C36, C37, C38, C39: 6.7nF/50V; C_0603_1608Metric
C40, C41: 4nF; C_0603_1608Metric
D1, D2: SS34; D_SMA
D3, D4: SMBJ15A; D_SMB
D5, D6, D7, D8: BAT54; D_SOD-123
D9: BZX84C3V0; SOT-23
F1, F2: 0.5A; Fuse_1206_3216Metric
J1: VBIAS 12V; TerminalBlock_MaiXu_MX126-5.0-02P_1x02_P5.00mm
J2: VCC12_S; TerminalBlock_MaiXu_MX126-5.0-02P_1x02_P5.00mm
J3: CT secondary; TerminalBlock_MaiXu_MX126-5.0-02P_1x02_P5.00mm
J4: TG_HI/TG_LO/TG_SR; TerminalBlock_MaiXu_MX126-5.0-04P_1x04_P5.00mm
J5: CT_OK strap; PinHeader_1x02_P2.54mm_Vertical
J6: SS_READY strap; PinHeader_1x02_P2.54mm_Vertical
J7: FAST_ARMED strap; PinHeader_1x02_P2.54mm_Vertical
J8: OPERATOR_RUN strap; PinHeader_1x02_P2.54mm_Vertical
J9: ACK button; PinHeader_1x02_P2.54mm_Vertical
Q1: MMBT3904; SOT-23
Q2: BSS84; SOT-23
R1, R9, R76: 1k; R_0603_1608Metric
R2, R5: 15k; R_0603_1608Metric
R3, R10, R12, R14, R15, R16, R17, R18, R19, R26, R27, R28, R29, R33, R44, R56, R57, R58, R59, R60, R61, R62, R63, R64, R65, R66, R67, R68, R69, R70, R71, R72, R73, R74, R75, R77: 10k; R_0603_1608Metric
R4: 6.2k; R_0603_1608Metric
R6: 23k; R_0603_1608Metric
R7: 2k; R_0603_1608Metric
R8: 10R 1%; R_0805_2012Metric
R11: 24k; R_0603_1608Metric
R13: 0R; R_0603_1608Metric
R20, R22, R24, R30, R31, R32, R34, R35: 100k; R_0603_1608Metric
R21, R23: 14.7k; R_0603_1608Metric
R25: 47k; R_0603_1608Metric
R36, R37, R38, R39, R40, R41, R42, R43: 4.7k; R_0603_1608Metric
R45: 1k; R_0603_1608Metric; not fitted
R46, R47, R48, R49, R50, R51, R52, R53, R54, R55: 2.2R; R_0603_1608Metric
TP1: V12P; TestPoint_Pad_D1.0mm
TP2: V12S; TestPoint_Pad_D1.0mm
TP3: V5; TestPoint_Pad_D1.0mm
TP4: REF_2V5; TestPoint_Pad_D1.0mm
TP5: OC; TestPoint_Pad_D1.0mm
TP6: OC_FILT; TestPoint_Pad_D1.0mm
TP7: HARD_TRIP; TestPoint_Pad_D1.0mm
TP8: FAST_TRIP; TestPoint_Pad_D1.0mm
TP9: HEALTHY; TestPoint_Pad_D1.0mm
TP10: READY; TestPoint_Pad_D1.0mm
TP11: LATCHED; TestPoint_Pad_D1.0mm
TP12: ACK_LOW_OK; TestPoint_Pad_D1.0mm
TP13: ACK_RISE; TestPoint_Pad_D1.0mm
TP14: FLT; TestPoint_Pad_D1.0mm
TP15: PERMIT; TestPoint_Pad_D1.0mm
TP16: PERMIT_RAIL; TestPoint_Pad_D1.0mm
TP17: GSUM; TestPoint_Pad_D1.0mm
TP18: ANY_ON; TestPoint_Pad_D1.0mm
U1: L7805; TO-252-2
U2: TL431LP; TO-92_Inline
U3, U4, U5: LM393; SOIC-8_3.9x4.9mm_P1.27mm
U6, U7, U8, U9: CD4081BE; DIP-14_W7.62mm
U10: CD4071BE; DIP-14_W7.62mm
U11: CD4069UBE; DIP-14_W7.62mm
U12: CD4013BE; DIP-14_W7.62mm
U13: HEF4093BT; DIP-14_W7.62mm
U14, U15, U16, U17: UCC27524ADR; SOIC-8_3.9x4.9mm_P1.27mm
U18: UCC27282DRCR; Texas_S-PVSON-N10

Connections:
ACK_ARM: U9.11, U12.8 (S)
ACK_DLY_N: U9.9, U13.3
ACK_LOW_OK: TP12.1, U8.12, U12.13 (Q)
ACK_N: U9.13, U13.11
ACK_RAW: C17.1, J9.1, R30.1, R31.1, U9.8, U13.12, U13.13
ACK_RC: C18.1, R31.2, U13.1, U13.2
ACK_RISE: TP13.1, U8.13, U9.10
ALL_OFF: U7.6, U11.8
ANY_ON: R19.2, TP18.1, U5.7, U11.9
CT_OK: J5.2, R26.1, U6.6
CT_S1: D5.2 (A), D7.1 (K), J3.1
CT_S2: D6.2 (A), D8.1 (K), J3.2
FAST_ARMED: U6.11, U10.2
FAST_ARMED_IN: J7.2, R28.1, U6.13
FAST_TRIP: R15.2, TP8.1, U3.7, U6.12
FAULT_A: U10.3, U10.5
FAULT_B: U10.4, U10.8
FF2_RESET: U10.11, U12.10 (R)
FLT: TP14.1, U10.10, U10.12, U11.3, U12.6 (S)
GA1: C32.1, R48.2, R56.1, R66.1
GA2: C33.1, R49.2, R57.1, R67.1
GA3: C34.1, R50.2, R58.1, R68.1
GA4: C35.1, R51.2, R59.1, R69.1
GA5: C36.1, R52.2, R60.1, R70.1
GA6: C37.1, R53.2, R61.1, R71.1
GA7: C38.1, R54.2, R62.1, R72.1
GA8: C39.1, R55.2, R63.1, R73.1
GH1: C40.1, R46.2, R64.1, R74.1
GL1: C41.1, R47.2, R65.1, R75.1
GSUM: R66.2, R67.2, R68.2, R69.2, R70.2, R71.2, R72.2, R73.2, R74.2, R75.2, R76.1, R77.1, TP17.1
GSUM_SNS: D9.1 (K), R77.2, U5.5 (+)
HARD_TRIP: R14.2, TP7.1, U3.1, U10.1, U11.5
HB: C29.1, U18.3 (HB)
HEALTHY: TP9.1, U6.10, U7.1, U11.1
HO: R46.1, U18.4 (HO)
H_OK_A: U6.3, U6.8
H_OK_B: U6.4, U6.9
LATCHED: TP11.1, U9.6, U12.1 (Q)
LATCHED_N: U8.2, U12.2 (~Q)
LO: R47.1, U18.10 (LO)
NOT_FLT: U7.2, U11.4
NOT_HARD_TRIP: U8.9, U11.6
NOT_HEALTHY: U10.6, U11.2
NOT_READY: U10.13, U11.10
OC: C12.1, R10.2, R11.1, R12.1, TP5.1, U3.3 (+)
OCD: D5.1 (K), D6.1 (K), R8.1, R9.1
OCF: C11.1, R9.2, R10.1
OCM: C11.2, C12.2, D7.2 (A), D8.2 (A), R8.2, R11.2, R13.1
OC_FILT: C13.1, R12.2, TP6.1, U3.5 (+)
OPERATOR_RUN: J8.2, R29.1, U8.1
PCOLL: Q1.3 (C), Q2.1 (G), R34.2
PDRV: Q1.1 (B), R33.2
PERMIT: R33.1, TP15.1, U8.10
PERMIT_RAIL: C28.1, Q2.3 (D), R35.1, R36.1, R37.1, R38.1, R39.1, R40.1, R41.1, R42.1, R43.1, R44.1, R45.2, TP16.1, U14.1 (ENA), U14.8 (ENB), U15.1 (ENA), U15.8 (ENB), U16.1 (ENA), U16.8 (ENB), U17.1 (ENA), U17.8 (ENB), U18.6 (EN)
PGND: C1.2, C2.2, C3.2, C4.2, C5.2, C6.2, C7.2, C8.2, C9.2, C10.2, C13.2, C14.2, C15.2, C16.2, C17.2, C18.2, C19.2, C20.2, C21.2, C22.2, C23.2, C24.2, C25.2, C26.2, C27.2, C28.2, C29.2, C30.2, C31.2, C32.2, C33.2, C34.2, C35.2, C36.2, C37.2, C38.2, C39.2, C40.2, C41.2, D3.2 (A2), D4.2 (A2), D9.2 (A), J1.2, J2.2, J4.4, Q1.2 (E), R3.2, R5.2, R7.2, R13.2, R21.2, R23.2, R25.2, R26.2, R27.2, R28.2, R29.2, R30.2, R35.2, R36.2, R37.2, R38.2, R39.2, R40.2, R41.2, R42.2, R43.2, R44.2, R56.2, R57.2, R58.2, R59.2, R60.2, R61.2, R62.2, R63.2, R64.2, R65.2, R76.2, U1.2 (GND), U2.2 (A), U3.4 (V-), U4.4 (V-), U5.4 (V-), U6.7 (VSS), U7.7 (VSS), U8.7 (VSS), U9.7 (VSS), U10.7 (VSS), U11.7 (VSS), U11.13, U12.3 (C), U12.7 (VSS), U12.9 (D), U12.11 (C), U13.5, U13.6, U13.7 (GND), U14.3 (GND), U15.3 (GND), U16.3 (GND), U17.3 (GND), U18.5 (HS), U18.9 (VSS), U18.11 (EP)
POR: U10.9, U13.10
POR_RC: C19.1, R32.2, U13.8, U13.9
P_A: U7.11, U8.5
P_B: U8.3, U8.6
P_C: U8.4, U8.8
READY: TP10.1, U7.10, U9.2, U9.12, U11.11
READY_A: U7.3, U7.8, U7.12
READY_B: U7.4, U7.9
REF_0V2: C10.1, R6.2, R7.1, U5.6 (-)
REF_1V0: C8.1, R2.2, R3.1, U3.2 (-), U4.2 (-), U4.6 (-), U5.2 (-)
REF_1V8: C9.1, R4.2, R5.1, U3.6 (-)
REF_2V5: C7.1, R1.2, R2.1, R4.1, R6.1, TP4.1, U2.1 (REF), U2.3 (K)
RESET_OK: U8.11, U9.1
RST_A: U9.3, U9.5
RST_EFF: U9.4, U12.4 (R)
SOA0: R48.1, U14.7 (OUTA)
SOA1: R50.1, U15.7 (OUTA)
SOA2: R52.1, U16.7 (OUTA)
SOA3: R54.1, U17.7 (OUTA)
SOB0: R49.1, U14.5 (OUTB)
SOB1: R51.1, U15.5 (OUTB)
SOB2: R53.1, U16.5 (OUTB)
SOB3: R55.1, U17.5 (OUTB)
SS_READY: J6.2, R27.1, U7.5, U7.13
TG_HI: J4.1, U18.7 (HI)
TG_LO: J4.2, U18.8 (LI)
TG_SR: J4.3, U14.2 (INA), U14.4 (INB), U15.2 (INA), U15.4 (INB), U16.2 (INA), U16.4 (INB), U17.2 (INA), U17.4 (INB)
V5: C3.1, C4.1, J5.1, J6.1, J7.1, J8.1, J9.2, Q2.2 (S), R1.1, R14.1, R15.1, R16.1, R17.1, R18.1, R19.1, R24.1, R32.1, R34.1, TP3.1, U1.3 (OUT), U3.8 (V+), U4.8 (V+), U5.8 (V+), U6.14 (VDD), U7.14 (VDD), U8.14 (VDD), U9.14 (VDD), U10.14 (VDD), U11.14 (VDD), U12.5 (D), U12.14 (VDD), U13.14 (VCC)
V5_OK: R18.2, U5.1, U6.5
V5_SNS: C16.1, R24.2, R25.1, U5.3 (+)
V12P: C1.1, C2.1, C30.1, C31.1, D1.1 (K), D3.1 (A1), R20.1, R45.1, TP1.1, U1.1 (IN), U18.1 (VDD)
V12P_F: D1.2 (A), F1.2
V12P_IN: F1.1, J1.1
V12P_OK: R16.2, U4.1, U6.1
V12P_SNS: C14.1, R20.2, R21.1, U4.3 (+)
V12S: C5.1, C6.1, C20.1, C21.1, C22.1, C23.1, C24.1, C25.1, C26.1, C27.1, D2.1 (K), D4.1 (A1), R22.1, TP2.1, U14.6 (VDD), U15.6 (VDD), U16.6 (VDD), U17.6 (VDD)
V12S_F: D2.2 (A), F2.2
V12S_IN: F2.1, J2.1
V12S_OK: R17.2, U4.7, U6.2
V12S_SNS: C15.1, R22.2, R23.1, U4.5 (+)
