czy0126/CZY/tools/hot_fault_metrics.py

"""Extract ELE-08 steady-state-initialized hot-fault metrics.

These decks start from ``.ic V(out)=1.89 V(ss)=4``, so the fault lands on a
precharged operating point instead of the soft-start ramp that the original
cold-start fault caught at ``V(ss)=3.78 V``.  That difference is the whole
point, and it is also the trap: **a precharge is not a proof of settling**.
The record therefore reports the pre-fault window (120..170 us on the rebased
axis) with its ripple and drift, and the post-fault window (175..320 us).

``Tstart`` rebases the stored timestamps: the 2175 us PWL crossing is saved at
175 us.  The 2 ms pre-fault window is deliberate: with ``.ic V(ss)=4`` the SS
pin only reaches ~4.485 V at 1 ms, below the strict 4.8 V settled floor.
Those offsets are derived from the deck text, never typed in.

Usage:
    python tools/hot_fault_metrics.py \
        --raw sim/v3/sr_tank_dual_v33_ss_hotfault_48v_120a.raw \
        --log sim/v3/sr_tank_dual_v33_ss_hotfault_48v_120a.log \
        --deck sim/v3/sr_tank_dual_v33_ss_hotfault_48v_120a.cir \
        --rl 15.4m --json design/v3/power_priority/hotfault_48v_120a.json
"""
from __future__ import annotations

import argparse
import json
import re
from pathlib import Path

import numpy as np

from analyze_v3_transient import (first_cross, low_runs, mean_window,
                                  parallel_load_ohm, peak_after)
from ascii_raw_window import read_window
from current_manifest import spice_seconds
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
