czy0126/CZY/(commit log)

2026-11-01 48V to 2V 24:1 fixed-ratio DCX: design packages, models, tools and evidence
    - design/: v1-v3 packages, BOM draft, board netlist, power-up checklist
    - tools/: offline analysis tools + test suite (183 tests, all green)
    - sim/: 391 LTspice deck/model sources; *.raw excluded (31 GB, regenerable)
    - references/: vendor datasheets and models behind the VERIFIED BOM rows
    - docs/: independent review records and the staged roadmap
    Not hardware verified: 100 A continuous / <=10 mm is still open, and every
    number in design/v3 is a model or handbook estimate.
2026-11-01 Close issues #1-#4: polarity DOT chain, executable protocol, 100 A ledger, baseline + CI
    #1 winding_polarity.py derives terminal DOTs from the SPICE deck; the board
    netlist now checks S_A DOT / CTAP / S_B DOT and the first-article polarity
    record is a committed template.
    #2 the power-up checklist is split S0-S4 with state, measurement location and
    source type on every criterion. Control-board T3 is a real negative-VDS PGD
    test (it needs F-SEC current), and T6 follows REG below 11 V instead of
    demanding 11 V at VDD=4.25 V.
    #3 energy_ledger_100a.py integrates the 424 MB ledger raw over 16 gate
    periods: Pin-Pout 11.025 W vs 11.117 W of element losses, residual -0.091 W.
    The CT bridge+burden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
2026-11-01 Close #2 and #3: protocol is executable, ledger is closed
    #2 the power-up checklist is split S0-S4 and every criterion now carries
    test_state / measurement_location / source_type; T3 is a real negative-VDS PGD
    test and T6 follows REG below 11 V per the datasheet. The control-board doc
    locks these with test_control_validation_doc.py.
    #3 energy_ledger_100a.py integrates the same 16 gate periods of the 424 MB
    ledger raw: Pin-Pout 11.025 W vs 11.117 W losses, residual -0.091 W; the CT
    bridge+burden term (0.186 W) closes the gap; the 0.205 W ideal driver is
    reported outside the port and the stored-energy endpoint is phase-limited.
    Hardware-dependent acceptance stays open: #1 needs the first-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
2026-11-01 Physical-configuration peaks, paired flux, and the Lr turn decision
    - lr_design.py: PHYSICAL_PEAKS keeps the deck each peak was measured on and
    paired_flux() evaluates it at that inductance, so a measured current is never
    moved to another one. 84.02 A @1.0 uH and 104.17 A @0.875 uH put 2 turns
    past Bsat itself (0.351 T vs 0.310 T, Isat 80.6 A); 3 turns gives
    0.215 / 0.234 T and is the only option. The earlier ">=20 nH of leakage
    rescues 2 turns" note only held at the frozen deck's 73.68 A.
    - Physical operating points recorded: 7.05 mF bank gives 42.76 mVpp / 100.07 A,
    the untrimmed 1.0 uH part 36.07 mVpp. The 4 mF deck's 49.73 mVpp stays,
    labelled as the frozen deck rather t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
2026-11-01 fix(manifest): track full winding DOT and first-article manufacturing evidence
2026-11-01 Measure the storage endpoint over a whole gate period, not a sample
    The 16-period closure residual read -0.118 W on the single sample where the
    window happened to stop, and -0.222 W once each storage term is averaged over
    the gate period it lands in. The favourable number was partly endpoint luck,
    so closure_status now requires both readings to be inside the 0.2 W target and
    the period-averaged estimator to resolve it; the target itself is untouched and
    the status stays NOT_CLOSED.
    Period averaging works because one gate period (4.9845 us) is within 0.75 % of
    one tank period (4.9473 us): the tank-frequency component of the endpoint error
    is attenuated by |sinc(pi f_tank/f_gate)|, about 130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
2026-11-01 Run the phase-aligned window: it resolves 0.2 W and the residual is outside it
    The 133-gate-period window (662.975 us, 0.14 deg of phase error) took 404 s of
    LTspice and 21 min to scan. Its period-averaged standard error is 0.157 W over
    132 points, so unlike the 16-period window it can resolve the 0.2 W target --
    and it reads +0.326 W period-averaged (+0.384 W single sample). The status
    stays NOT_CLOSED, but the reason inverts: the residual is now measured and too
    large, not unresolvable.
    Same raw, three window lengths: 8 periods +0.999 W, 12 +0.368 W, 133 +0.384 W,
    with the endpoint storage term swinging -0.315 / +0.279 / -0.021 W. The short
    window's number is decided by which tank phas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
2026-11-01 docs: add actionable D1/D2/D3 delivery sprint plan focused on native CAD and prototypes
2026-11-01 Make the control board's ERC a report about the circuit
    The committed ERC report read "3 warnings, 0 errors", all three of them
    lib_symbol_issues: the library is not in the current configuration. Nothing
    about the schematic was wrong. kicad-cli only loads a project's sym-lib-table
    when a .kicad_pro sits next to the schematic; with none, ${KIPRJMOD} is
    undefined, both project-local libraries (UCC24624, SR) are invisible, and
    every symbol from them is flagged. Passing -D KIPRJMOD=<dir> does not help --
    the table is never read.
    Measured on the same file, --severity-all: no project file -> 3 warnings,
    project file -> 0 violations.
    Those warnings said nothing about the circuit but look exactly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
2026-11-01 Re-run the aligned window at 2 ns: the gap survives, the loss list does not
    Issue #6's +0.33 W was measured at 5 ns, and the 16-period step check said a
    5 ns / 2 ns pair moves the closure by 0.38 W. So the aligned window could not
    quote its residual as a measurement until it was re-run. `ledger_aligned2n`
    is the same deck with one line changed (`.tran ... 5n` -> `... 2n`; verified
    by diff), so the two runs differ only in timestep.
    The answer splits:
    closure, period-averaged +0.3258 W (5 ns) +0.3139 W (2 ns) -0.0119 W
    loss inventory +10.7313 W +11.3563 W +0.6250 W
    port term +10.8888 W +11.4228 W +0.5340 W
    * The clos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
2026-11-01 Stop the ERC test from rewriting a committed file
    The live ERC test wrote its report over pcb/control_validation/erc.json, so
    every pytest run left the tree dirty with a timestamp-only change and the next
    reader could not tell a real regeneration from a test side effect. erc_violations()
    now takes a path and the test writes to tmp_path.
2026-11-01 A5: place the power stage 1:1 and find the Z problem
    The delivery plan puts a real mechanical layout before routing. This adds
    hardware/dcx_mech/power_stage_placement.kicad_pcb -- 35 parts on a
    155.0 x 131.0 mm board, generated from one table in
    tools/main_board_mechanical.py so a moved part is a one-line change and the
    board rectangle follows the outermost outline.
    It is a placement study: no nets, no tracks, every pad unconnected on
    purpose. `kicad-cli pcb drc --severity-all` reports 0 violations, which here
    means only what a placement can be wrong about -- courtyards that touch, and
    footprints from a library the project cannot see (an unresolved footprint is
    a black box, so DRC silently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
2026-11-01 Take the Q5A package from the datasheet maximums, not the 5x6x1 nominal
    The BOM calls the primary FET 'SON 5x6', which reads as 5.00 x 6.00 x 1.00.
    The Q5A Package Dimensions table on datasheet p9 gives D1 max 5.00,
    E max 6.10, A max 1.10 -- the same nominal-versus-maximum trap the magnetics
    height stack already avoids. Nothing moves and no DRC rule fires, but the
    outline a fabricator checks is now the one the drawing specifies.
    The land pattern is still provisional and says so: the recommended board pads
    are a figure in the datasheet, not text, so they are not reproduced here
    rather than guessed from the lead dimensions.
2026-11-01 README: record A5 in the delivery log
    The log is how someone reads this project's state without opening the tree,
    and A5 is the first entry that answers a mechanical question rather than an
    electrical one. It says what the board is (35 parts, 155 x 131 mm, DRC clean)
    and, more importantly, what it is not: no nets, no tracks, four provisional
    outlines.
2026-11-01 Issue #11: the placement generator no longer names a user directory
    `tools/main_board_mechanical.py` hardcoded
    C:\Users\<user>\AppData\Local\Programs\KiCad\10.0\share\kicad, so
    `test_the_committed_board_is_what_the_table_produces` failed on the Windows CI
    runner: the generator could not find the stock PG-TDSON-8 footprint, and the
    only test that proves the committed A5 board is what the table produces went
    red on a machine that was never the problem.
    * The one borrowed footprint is vendored at
    hardware/stock_footprints/Package_SON.pretty/ with a PROVENANCE.md that
    records the KiCad version, the LF-normalised sha256 (7ca4fe5b...) and the
    licence. Generation now needs no KiCad install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
2026-11-01 A6: give "10 mm" a datum, and show the pocket only buys back the clamp
    Issue #12 item 1 asks what the 10 mm height limit actually measures. The repo
    had three answers in it (9.94 / 9.44 / 10.44 mm) and none of them said what
    they were measured from, so a "we pocketed the cores, we fit" claim could be
    made without anyone deciding which number it referred to.
    `mechanical_section()` now states the datum first -- PCB top surface, Z = 0,
    the same origin PARTS already uses -- then lists every contributor with
    nominal, worst case and an evidence class (datasheet / ASSUMED / DESIGN), and
    carries `null` for the case that includes TIM and a cold plate, because none
    of TIM, cold plate, fastener heads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
2026-11-01 A6 item 4: the 100 A plane in squares, and why no copper weight closes it
    Issue #12 asks for a real current path and a spreading-resistance budget on the
    1:1 outline. connector_budget.py already sized the busbar and the bolted
    joints off-board; nothing looked at the copper *on* the board between the SR
    drains and the busbar.
    Sheet resistance is the right reformulation: R = rho/t per square, so 2 oz
    copper at 100 C is 0.324 mohm/square and the whole 0.15 mohm design basis is
    only 0.46 squares. The placement then says the rest: the SR row runs x =
    19..133 mm, J_OUT covers x = 60..140 mm, so group 1 has no busbar above it and
    has to travel 41 mm sideways through a 15 mm channel -- 2.73 squar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
2026-11-01 feat(A1): carry native EasyEDA schematic and pad-level netlist evidence onto latest main
2026-11-01 fix(A1): make pad subset verification explicitly NOT_FOR_FAB; block unverified magnetics
2026-11-01 test(A1): verify partial subset pass cannot sign off missing magnetics or placeholder values
2026-11-01 feat(power): model unverified high-current/output-path tradeoff with explicit safety gates
2026-11-01 data(power): publish reproducible high-output candidates clearly marked not simulated or rated
2026-11-01 test(doc): retain parameter traceability for corrected output-plane model
2026-11-01 fix(output): do not assert planar current spreading only lowers resistance
2026-11-01 sim: add unrun physical-deck VIN/current sensitivity vin48_i110
2026-11-01 sim: add unrun physical-deck VIN/current sensitivity vin48_i120
2026-11-01 sim: add unrun physical-deck VIN/current sensitivity vin50_i110
2026-11-01 sim: add unrun physical-deck VIN/current sensitivity vin50_i120
2026-11-01 data(output): separate exploratory resistance screening from rated design basis
2026-11-01 test(output): permit higher-loss exploration without altering released resistance rating
2026-11-01 feat(CAD): establish complete five-magnetic logical pin/DOT contract without inventing footprints
2026-11-01 data(CAD): record exact nets for four CT transformers and OC current transformer
2026-11-01 test(CAD): run contract freshness with isolated argv under pytest
2026-11-01 fix(mechanics): dielectric does not conduct SR return current; require copper path continuity
2026-11-01 docs: prioritize electrical manufacturability, defer detailed thermal, stage higher-output candidates
2026-11-01 docs(CAD): label imported native schematic as WIP and link unverified magnetic pin contract
2026-11-01 docs(readme): track native schematic, corrected four-way losses and high-output non-rated program
2026-11-01 docs(output): align corrected power-stage copper loss with regenerable Python output
2026-11-01 A6 item 2: what 0.5 mm deep, five times, actually does to the board
    The pocket was carried as a design choice ("the cores need to sit lower") with
    no account of what it costs. `pocket_requirements()` now prices it: 806.4 mm2
    per ELP32 footprint, 4032.2 mm2 across five -- 19.9 % of a 20305.0 mm2 board --
    leaving 1.0..1.2 mm of dielectric under the heaviest parts on the assembly,
    because a routed-cavity tolerance of +-0.1 mm moves the floor as well.
    The one question that could be answered today is whether the cavities take
    copper away from the 100 A output plane, which item 4 just showed is already
    three times over budget. They do not: the cores sit at y <= 64.7 mm and the
    SR-to-busbar chan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
2026-11-01 sim(v3): run the 48 V/110 A candidate and record what it actually delivered
    The deck was never run; D1 listed 110 A as a target from a linear
    extrapolation. It has now been run once against the same behavioural
    model as the 100 A physical deck (only VIN and RL differ).
    Measured at the load, 22 gate periods: 1.8786 V, 111.16 A, 208.83 W.
    RL=16.9 mOhm was chosen for 110 A; the output landed 20 mV high, so the
    run is 111.2 A and the record says so rather than rounding to the target.
    Stress inside the model is not the limiter: SR forward peak 42.99 A of a
    285 A datasheet ID, per-device loss 0.93 W (0.85 W at 100 A), Cr 42.74 V
    of 100 V, OC pin 0.636 V of the 1 V Level-1 threshold. What is mi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
2026-11-01 docs(power): say why the SR loss columns are not interchangeable
    thermal_precheck's 0.917 W/device is the frozen deck's sr_channel_body_x4
    divided by eight. The same tool on the physical deck gives 830.7 mW at
    100 A and 912.0 mW at 110 A; the 10 % spread is the deck (4 mF vs 7.05 mF
    commutation) and the window, not a tool disagreement. Quoting the frozen
    number under a 110 A heading would be the same mistake the 4 mF vs 7.05 mF
    ripple note already guards against.
2026-11-01 data(ledger): regenerate the committed 16-period summary with the current tool
    The committed JSON predated three additions the tool already carried: the
    CPIN regulariser's exact share, the steps_s series, and the per-item
    loss_items breakdown. No physics number moved: every pre-existing value
    in the diff is unchanged, the file was simply never regenerated.
2026-11-01 feat(ledger): take VIN and RL from the deck that was actually run
    port_terms and build read the module constants, which are the 100 A
    physical deck's 48 V / 18.9 mOhm. A parameter-only candidate runs the
    same tank at a different VIN/RL, so pin_source and pout would have been
    computed from the mother deck's scalars against the candidate's waveform
    -- an invented loss of exactly the size of the parameter change.
    --vin and --rl now carry it, step_check forwards the same pair to every
    column (a parameter change must not be mixed into what it calls a step
    change), and parse_args is split out of main so the pair is testable.
    Three tests: port_terms follows the scalars it is given and still defa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
2026-11-01 feat(decks): give the 110 A candidate the 100 A ledger's instruments
    The candidate deck saves neither I(Rin) nor I(Cin), so its raw has an
    output power but no input power and no efficiency. A first attempt
    appended the two traces to the first .save line; LTspice folds that
    line's continuations into one directive, so V(vin), I(Cout) and the CT
    nodes stayed out and energy_ledger_100a refused the raw with 18 missing
    probes.
    The probe now takes the whole .save block from the 100 A ledger deck, so
    the candidate is measured by exactly the same instruments that deck uses
    and follows it if it ever gains a probe. Tests: the two decks' save
    blocks are identical, every other line is byte-identical,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
2026-11-01 sim(v3): add the 1 ns leg of the aligned window
    Issue #6 asks for 5 / 2 / 1 ns, not a pair: two steps cannot tell a
    converging move from a constant error. The variant changes only the
    .tran maximum step (5n -> 1n) on the 133-period phase-aligned deck; the
    880 us start is untouched. Ran in 876.993 s; the 3.78 GB raw stays out
    of Git.
2026-11-01 data(power): measure the 111 A candidate's input power
    `_phys` and every deck derived from it save the output but not `I(Rin)`,
    so the 111 A run had a measured 208.83 W at the load and no efficiency at
    all. The probe deck closes that gap the only way that keeps the circuit
    identical: the candidate deck with the 100 A ledger deck's whole `.save`
    block copied in. Two `.meas` logs compared line by line show the circuit
    did not move.
    Port result on the same 22-period window: Pin 220.914 W, Pout 208.835 W,
    94.53 %. Pout matches the independent `extract_op_point` record to 3e-5 W.
    The efficiency may be quoted; closure may not. `closure_status` stays
    NOT_CLOSED (+0.559 W including storage, pe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
2026-11-01 chore(manifest): register the high-output family and the 111 A ledger
    The v3 scope gains the four parameter-only candidate decks, the probe deck,
    the two scripts that build and lock them, the operating point and the
    ledger, the 110 A report, and the three raws that were actually run.
    Re-running the tool reproduces the committed manifest with 0 missing.
2026-11-01 test(power): pin the 111 A closure on numbers, not on the reason string
    Matching the words "period-averaged" in closure_reason would break the day
    the sentence is reworded, while the quantity it names is right there as
    balance.period_averaged.closure_residual_w. Assert that, assert the window
    can resolve the target, and assert the miss is published in limits.
2026-11-01 data(ledger): the 1 ns leg rules out a plateau and localises the drift
    Three steps on the same 133-period window: the port term goes 10.8888 ->
    11.4228 -> 10.1261 W and the loss inventory 10.7313 -> 11.3563 -> 9.9804 W.
    The second leg is 2.2x the first and runs the other way, so this is an
    oscillation, not a plateau and not a constant offset: 1 ns is not "the
    converged value" and the three points do not extrapolate.
    Item by item, everything that moves is one item. sr_channel_body_x4 goes
    6.9540 -> 7.5753 -> 6.2047 W (-1.371 W on the last leg, 99.6 % of the loss
    move); the other twelve items together move 0.004 W and no single one more
    than 0.034 W. So the quotable precision of a loss item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
2026-11-01 test(D1): block release on absent magnetic pads, placeholders and unverified ERC/PCB
2026-11-01 data(D1): publish 7-category NOT_FOR_FAB gate from actual current CAD/BOM evidence
2026-11-01 fix(D1): require native CAD coverage of 17 BOM peripherals omitted by SPICE golden
2026-11-01 test(D1): require BOM-to-CAD completeness, not only SPICE pin comparison
2026-11-01 docs(power): label 111.16A and 94.53pct as LTspice simulation measurements, not hardware
2026-11-01 docs(CAD): actionable 17-peripheral, five-magnetic and 39-placeholder completion checklist
2026-11-01 docs(readme): replace stale CI and unrun-110A status with current D1, simulation and BOM gap evidence
2026-11-01 docs(review): audit measured LTspice 111A, nonconverged 100A ledger and newly found 17 BOM gaps
2026-11-01 fix(D1): parse CT designator in BOM-to-golden coverage scanner
2026-11-01 fix(D1): support nonnumeric D_BT bootstrap diode in BOM parser
2026-11-02 fix(D1): permit BOM-required physical parts without passing their pin/net review
2026-11-02 test(D1): prevent false failures when CAD adds real decouplers and reject unknown parts
2026-11-02 data(D1): classify 17 BOM-only parts as pending, not phantom SPICE errors
2026-11-02 fix(D1): derive coverage from current BOM/native EDA and hash-check any manual release evidence
2026-11-02 data(D1): show 22 real BOM refs absent from native CAD, plus verified file evidence policy
2026-11-02 test(D1): require real hashed evidence and detect stale cached BOM coverage
2026-11-02 test(D1): ensure actionable task board stays file-backed and dependency-acyclic
2026-11-02 docs(D1): schedule parallel CAD, magnetic, PCB and high-output verification with daily evidence gates
2026-11-02 docs(readme): surface 10-day D1 execution board and newly verified 22 missing CAD refs
2026-11-02 feat(ledger): audit SR loss dimensions, step behaviour and gate-drive boundary
    The numerical review left three questions open on issue #6: whether the SR
    current/loss integrals carry the right dimensions and signs, which term moves
    between 5/2/1 ns, and whether the closure's external drive power shares a
    boundary with the loss list.
    tools/sr_loss_audit.py measures all three on the six raws and writes
    design/v3/stage_f/sr_loss_audit.json:
    - dimensions: I(VSa*)=I(Ld) (<=1.1e-6 A), the drain power identity
    (<=3.7e-4 W on 0.91 W) and the gate-pin KCL (<=1.5e-4 W) all hold. The
    body-diode drop is 0.714-0.723 V in every window, which is what makes the
    mean-current definition (q/span) veri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
2026-11-02 fix(D1): key the BOM-in-native-design gate to the native export, not the deck
    d1_fabrication_gate checked
    all_required_real_hardware_bom_refs_in_native_design against
    bom_coverage["required_bom_refs_missing_from_golden"]. That list is built
    from design/v3/pcb/board_netlist.csv, which is derived from the SPICE deck;
    the deck has no EN/RUN pull-downs, no EN filter and no VDD decouplers, so
    R7-R10/C13/C101-C112 could never appear there. The check was unpassable by
    construction -- completing exactly the CAD work the review asks for would not
    have moved it.
    Coverage now reports both gaps separately:
    - required_bom_refs_missing_from_golden (17; deck gap, unchanged)
    - required_bom_refs_m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
2026-11-02 feat(CAD): draw the 17 BOM peripherals into the native schematic
    The deck-derived golden netlist cannot express EN/RUN default levels, the
    manual RUN jumper, the EN filter or per-IC VDD decoupling, so the fabrication
    gate's "BOM in native design" check was keyed to a list those 17 refs could
    never join. They are now declared in main_board_schematic.PERIPHERALS, drawn
    in the EasyEDA project and verified pad by pad:
    - 78 refs placed (61 golden + 17 peripherals), 261 review rows
    - peripheral_pads_checked = 34, missing_or_wrong = 0, unexpected_nets = 0
    - bom_coverage: required_bom_refs_missing_from_native_design = []
    - netlist_compare.json still PARTIAL_PASS / manufacturing_ready = false
    Nets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
2026-11-02 feat(CAD): draw T1-T4 and CT as native project symbols
    The five magnetics were the last unplaced refs: the library had no 5-pin
    3:1:1 transformer or 4-pin current transformer, and inventing a "1-5"
    numbering would have been indistinguishable from a vendor terminal drawing.
    Two project-library symbols (DCX_XFMR_5P, DCX_CT_4P) are now created headlessly
    and placed, so all 83 refs are on the sheet:
    - 83 refs, 285 review rows, 280 wired + 5 open by design
    - placement_plan.json: unresolved = [], gaps = []
    Pin numbers are the logical terminal names (PRI_A/SEC_A/CTAP), not pads. The
    contract's native_symbol_present is derived from project_symbols.json's
    used_by, not typed in: the generator used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
2026-11-02 feat(CAD): save by path, then export on an in-memory footprint injection
    Getting the magnetics into the written project and into an exported netlist
    turned out to be two mutually exclusive states, and the failure mode was a
    silent save() false with an untouched file. Measured:
    - sch_Document.save() only writes when the project was opened by --path.
    Calling dmt_Project.openProject(uuid) re-resolves the project and every later
    save() returns false. The project uuid is info.uuid; data[0] is "Board1".
    - The write is debounced: save() returns true, the file grows about 20 s later.
    --watch waits for the size/mtime to move, because true alone is not evidence.
    - A placed part with otherProp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
2026-11-02 docs(CAD): record the save/export rules and state what is still unverified
    README and the D1 checklist still described a 78-ref sheet with no magnetic
    symbols and a fresh main_board.svg. All three are wrong now:
    - 83 refs / 285 pads / 245 golden pads; 61 placeholders = 39 + 17 + 5
    - the magnetics are drawn, but the vendor terminal drawing is what is missing;
    physical_pad is null everywhere and CT's 4 terminals sit on a 2-pad
    placeholder footprint
    - main_board.svg is stale: getSvgFile now times out at 59750 ms against the
    60000 ms invoke cap with 83 parts. Use the GUI until A1 wraps up.
    CLAUDE.md gains the operational facts that cost this session: open by --path
    only, the getCurrent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
2026-11-02 chore(D1): regenerate gate snapshot and v3 manifest after rebase
    The gate snapshot now records the five magnetics as placed in the native
    export (all_required_bom_refs_missing_from_native_export: []), while the
    gate remains NOT_FOR_FAB on physical pads, placeholders, ERC and PCB.
    The v3 manifest is refreshed because the rebase onto PR #17 changed the
    checked-in bytes of two tool files.
2026-11-02 fix(ledger): refuse a step check across two different circuits
    step_check compared any two raws at different timesteps. The first 120 A
    ledger pointed its second column at the 100 A circuit's 2 ns raw while
    applying the candidate's VIN/RL, which reported a circuit change as a
    -43 W 'closure move'. deck_difference() now compares the two decks line
    by line (ignoring .tran) and raises; --no-step-check + mark_no_step_check()
    rewrite the sensitivity note so it no longer points at a missing section.
2026-11-02 feat(sim): 48 V/120 A candidate measured at 121.67 A / 227.98 W
    The probe deck differs from the candidate only in .save; both runs give
    258 235 points and byte-identical .meas lines. Load-side 1.8737 V,
    121.67 A, 227.978 W, port efficiency 94.227 %, closure NOT_CLOSED at
    +0.667 W (period-averaged +0.668 W). The ledger has no step_check: the
    only 2 ns raw belongs to the 100 A circuit.
    Also registers the high-output records in the explicit manifest list
    (134 entries, 0 missing), locks their presence with a test, and records
    the 120 A result, the reader fix and the LCEDA project-directory move in
    CLAUDE.md and the sprint docs.
2026-11-02 docs(CAD): point the native project at D:\workshop\LCEDA-Pro\projects
    APP_PROJECT_DIR was moved off C: (which is nearly full); the save path is
    now D:\workshop\LCEDA-Pro\projects\DCX Main Board.eprj2. The README said
    to copy into C:\Users\...\Documents, which would have split the working
    copy from the file the client actually saves.
2026-11-02 fix(ledger): propagate candidate VIN/RL into windows and per-period uncertainty diagnostics
2026-11-02 test(ledger): guard candidate-specific VIN/RL in all window and per-period diagnostics
2026-11-02 fix(ledger): identify corrected full-window statistics as recomputed on raw, not inherited defaults
2026-11-02 fix(ledger): quarantine 110a incorrect subwindow and SEM diagnostics pending raw regeneration
2026-11-02 fix(ledger): quarantine 120a incorrect subwindow and SEM diagnostics pending raw regeneration
2026-11-02 plan(D1): reflect 83 placed native refs, 61 placeholders, and new high-output ledger regeneration blocker
2026-11-02 docs(ledger): quarantine invalid 110/120A window and SEM claims until corrected RAW rerun
2026-11-02 feat(sim): add 50V 110/120A full probe decks so actual input/output power is measurable
2026-11-02 sim: prepare 50V 110A source-current probe deck (unrun)
2026-11-02 sim: prepare 50V 120A source-current probe deck (unrun)
2026-11-02 sim: stage unrun cold true-cold 48V 120A-target with real OC dynamics
2026-11-02 sim: stage unrun cold_oc true-cold 48V 120A-target with real OC dynamics
2026-11-02 feat(D1): reproducible 61-placeholder sourcing and 24-pin vendor DOT drawing requests
2026-11-02 fix(issue6): isolate remaining ~0.09W and prioritize SR diode/gate physical bookkeeping without false closure
2026-11-02 feat(sim): supply Windows-only opt-in runner for 50V and 120A transient models with no fabricated results
2026-11-02 docs(D1): hand off vendor terminal/MFN, GUI ERC, 50V, true-120A cold fault and issue6 steps
2026-11-02 test(ledger): stop certifying 110a pre-fix window SEM as valid
2026-11-02 test(ledger): stop certifying 120a pre-fix window SEM as valid
2026-11-02 docs(D1): point active workflow to supplier RFQ and unrun 50V/120A fault evidence
2026-11-02 chore(manifest): hash corrected candidate ledger diagnostics and stage-50V scripts
2026-11-02 plan(D1): track 50V instrumented runs and true-120A cold/fault as separate unverified tasks
2026-11-02 Advance PR18 worklist: 50V probes, 120A cold start and fault prefix
    - Run 50V/110A and 50V/120A probe decks; recompute stress, Cr and ledgers on the ledger window
    - Recompute candidate 110/120A ledger diagnostics with the requested VIN/RL
    - Run the 48V/120A true cold start (8 ms, 228.00 W) and the 8.70x overload
    (trip after 41.81 us at 84.83 A); the fault solver collapsed at 7.5714 ms,
    so the record is a prefix, not a completed 8 ms run
    - Add analyze_v3_transient and steady-stress tooling with their tests
    - Update D1 task status, sprint/handoff docs and the v3 manifest
2026-11-02 feat(fault): add independent settled operating-point 48/50V 120A overload candidates
2026-11-02 data(review): publish machine-checkable unresolved thermal-independent electrical and CAD gates
2026-11-02 plan(D1): mark partial cold fault unfinished; add hot-fault, 50V loss and 3-turn inductor gates
2026-11-02 docs(review): replace stale unrun assumptions with completed 50V/120A evidence and true P0 critical path
2026-11-02 docs(readme): replace outdated no-run status with latest 50V/120A simulation and fault blockers
2026-11-02 docs: mark prior pending-simulation handoff obsolete after completed 50V/cold runs
2026-11-02 Measure 50 V/120 A ledgers, steady-state hot faults and SR group symmetry
    - ELE-09: 50 V/120 A port-loss gap 0.4986 W (22 periods) -> 0.4921 W on the
    133-period aligned window (-0.0065 W, sem 0.050 W): the gap is stable, not a
    short-window artifact. Still NOT_CLOSED, 0.2 W budget unchanged, efficiency
    not quoted.
    - ELE-08: independent 48 V/50 V steady-state hot faults run to the full 320 us
    save window; trip delay 40.00/39.83 us, Lr peaks 97.38/101.23 A, SR forward
    292/304 A. Soft-start-era faults understated stress by 15-19 %; MAG-02 must
    use these peaks.
    - E6-4: pairs 1/4 measured on every aligned step; 5/2/0.5 ns give exactly
    1.000000, 1 ns gives 0.979267/1.019734. Four seco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
2026-11-02 Record E6-1 and E6-2 as done from the measured audit
    The audit already carried both answers; the triage record still said "open".
    Derive the entries from the audit values instead of hardcoding a status:
    - E6-1: the channel term moves 0.051 W across the four aligned steps while
    the body-diode forward term moves 2.334 W (101.3 % of the whole SR
    movement); reverse recovery is negative on every run. Pairs 2/3 UNKNOWN.
    - E6-2: the correction is the measured gate-pin sinks Rg + Rgs = 0.2175 W
    (spread 0.0025 W), gate-pin KCL residual 1.3e-4 W scaled to eight. The
    corrected period-averaged residual is +0.108/+0.097/+0.091/+0.304 W, still
    NOT_CLOSED.
    Guards fail the build if the diode sig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
2026-11-02 fix(sim): probe actual fault control voltage and injected current in hot-start deck
2026-11-02 fix(sim): save fault current/control nodes and measure actual injection for 48v_120a
2026-11-02 fix(sim): save fault current/control nodes and measure actual injection for 50v_120a
2026-11-02 fix(sim): require proven fault-control transition and positive branch current, not OC-only coincidence
2026-11-02 test(sim): reject OC-only false positives when physical fault switch/current not engaged
2026-11-02 test(sim): assert regenerate-able hot-fault decks save source transition and injected current
2026-11-02 fix(D1): recompute native CAD netlist on every fabrication check; invalidate stale cached netlist pass
2026-11-02 docs(D1): five-day CAD/fault handoff with exact log acceptance and current fabrication constraints
2026-11-02 docs(D1): prioritize verified fault-control/current evidence and five-day factory/EDA critical path
2026-11-02 fix(sim): use actual UCC25600 RT-only SS threshold 3.982V and measured pre-fault stability
2026-11-02 test(sim): confirm valid RT-only SS at 4.2V and catch drifting pre-fault Vout
2026-11-02 fix(review): align soft-start fault risk threshold with UCC25600 RT-only 3.982V
2026-11-02 feat(D1): export supplier-ready magnetic pinout and 61-part procurement request templates
2026-11-02 docs(D1): prioritize correct RT-only fault readiness and supplier-generated pinout/BOM packets
2026-11-02 fix(sim): use reproducible 3.982V threshold value across risk JSON and validator
2026-11-02 feat(ELE-08): measure post-trip SR gate state instead of asserting it stays low
    The SR timing model turns off on drain reverse bias, so a bridge that stops
    switching can leave a gate asserted with nothing to reset it. Record both
    channels after trip (sr_a/b_gate_after_trip, sr_gate_latched_at_end) and add
    the 50 V solver-prefix flag to the risk register.
2026-11-02 sim(ELE-08): 48V hotfault passes strict log validation, 50V records prefix only
    48 V runs the full 320 us saved window (554.498 s): pre-fault Vss 5.04484 V,
    trip 40.10 us, I(Lr) 97.443 A, SR 292.61 A, fault branch 858.9 A.
    50 V collapses at 296.929 us (1 ns of saved time in 62 min, ~10 GB written);
    its log has no completion line, so the validator stays fail-closed. The
    readable prefix still carries the trip and peak, but must be cited as prefix.
2026-11-02 data(ELE-08): register settled-fault peaks and keep every gate blocked
    2-turn flux at the settled fault is 0.3748 T (48 V) / 0.3895 T (50 V) vs the
    0.279 T criterion; 3-turn is 0.2499 / 0.2596 T with only 0.0194 T left at
    50 V. Recording this does not unblock MAG-02 or F01: no hardware, no vendor
    L(I)/Bsat, and the 50 V run is a collapsed prefix.
2026-11-02 docs(ELE-08): rewrite the settled-fault report with measured values
    Corrects the old 1 ms numbers (Vss 4.485 V, 97.38 A) to the 2 ms runs, adds
    the post-trip SS discharge and per-channel gate latch, and records the 50 V
    collapse at 296.929 us. ELE-08 moves back to in_progress: only 48 V has a
    complete, validated window.
2026-11-02 diag(ELE-08): locate the 50V stall 82 us after trip, not at the gate latch
    Byte-sampled record spacing shows full 5 ns steps until 295.88 us, decay from
    296.88 us, and 13.3 of 14.2 GB written in the final 0.93 us. Both decks latch
    one SR gate ~30 us after trip (48 V A at 247.07 us, 50 V B at 244.47 us) and
    the 48 V deck still finishes, so the latch alone does not explain the stall;
    the dead-state V(sw) trajectory differs (48 V settles at ~7 V, 50 V drifts
    13.7-16.2 V). Closing it needs the UCC24624 standby turn-off the timing model
    lacks, not a tolerance change.
2026-11-02 docs(ELE-08): rule out standby as the 50V stall fix and accept the prefix
    Reading the UCC24624 datasheet shows tSTBY_DET is 5.5/7.5/10 ms, two orders
    of magnitude longer than the ~0.1 ms post-trip window, so the missing standby
    model is neither the cause of the 296.928 us collapse nor its fix. The dead
    state's saved internals are smooth (~3 V/us) while the step collapses to
    1e-15 s, which points at the LTE criterion, not a fast event.
    The stress event ends at 214.9 us, well inside the readable prefix, so the
    record adopts 'accept the prefix' and keeps a solver-only SOLVER_DIAGNOSTIC
    as the documented path for anyone who needs the dead-state tail.
2026-11-02 docs(ELE-08): close the stale 'explain the collapse before rerunning' items
    The D3 row and the post-trip bullet still described the 296.929 us stall as an
    open question and cited the cold-start 84.8 A peak for the Lr first-article
    check. Both are now stale: the stall is a documented numerical limit with an
    accepted prefix, and MAG-02 has to be argued from the settled 101.26 A peak.
2026-11-02 diag(ELE-09): exhaust the deck before blaming a missing loss element
    The 50 V/120 A ledger is +0.49 W off and the standing instruction was to
    trace the physical source. That hunt needed a bound on what could still be
    missing, so enumerate every dissipative element in the deck -- each Rser=,
    each standalone resistor, each conduction resistance in a .model line --
    and show that each one is either measured by a loss term or excluded for a
    stated reason.
    Only two elements carry current without a ledger term. Cin's 5 mOhm ESR was
    measured on the aligned raw: I(Cin) ac rms 0.3493 A -> 0.61 mW. Cbt has no
    charge drawn from it in this model at all (Bgh reads V(hb,sw); the capacitor
    is a constant 12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
2026-11-02 docs(D1): carry the four-step SR record into the delivery documents
    Two delivery documents still quoted the three-step series: "SR diode step
    difference about 1.394 W" (the 5/2/1 ns range of the body-diode forward
    term) and "residual about 0.09 W". The 0.5 ns leg has since been measured
    and the numbers are in sr_loss_audit.json, so both statements now understate
    the spread and the closure.
    PR #20's Issue #6 bullet now gives the four values: period-averaged closure
    +0.108/+0.097/+0.091/+0.304 W (three of four inside 0.2 W, the 0.5 ns leg
    outside), spread 0.213 W, body-diode forward spread 2.334 W against 0.052 W
    for the channel term. It also records that the deck is exhausted as a source
    f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
2026-11-02 diag(ELE-09): the four step lengths are four operating points
    The standing next step for the non-converging SR term was "change the method:
    an edge-aligned fixed-step integration instead of more step reduction". The
    new audit tests the two assumptions behind that.
    First, quadrature. On each of the four aligned raws the body-diode charge is
    integrated three ways -- trapezoid on the native samples, midpoint, and a 10x
    decimation. Within one raw the three rules differ by at most 0.80 %, while
    the four raws differ from each other by 86 %. The difference lives in the
    waveform; re-integrating the same samples cannot remove it.
    Second, the operating point. The 100 A deck has a resistive load and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
2026-11-02 diag(ELE-09): the SR term is as sensitive to Vout as the port is
    The previous record showed the four aligned step lengths sit at four different
    operating points (Vout spread 19.2 mV). That left one question open: is the
    19.2 mV big enough to account for the 2.3 W of SR body-diode spread at all?
    Divide the two spreads. The single-device forward loss moves
    0.490/0.579/0.405/0.295 W, so scaled to eight devices the term changes by
    2.276 W across 19.24 mV -- 118 W/V. The port's own sensitivity is
    2V/RL = 200 W/V on this deck. The SR term is 0.59x as sensitive as the port
    itself: one millivolt of mean V(out) is worth about 0.12 W of SR loss.
    That reframes the 50 V/120 A gap. Its 0.492 W is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
2026-11-02 diag(ELE-09): a pinned current does not pin the operating point
    The previous record ended by prescribing the next experiment: pin Iout with a
    current-source load or a closed Vout loop, because the four aligned step
    lengths sit at four slightly different loads. The current-source leg has now
    been run.
    Two voltage-style loads were tried first and both failed the same way. The SR
    controller is load triggered: it turns on when the body diode conducts. An
    ideal 1.88943 V source clamps the centre tap from t=0 (V(ga1) never passed
    0.12 V, I(Lr) stayed inside +-0.77 A); a regulated sink I = max(1053(V-1.889),
    0) waits for 1.889 V, but an unloaded converter only reaches 1.794 V, so it
    sat on its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
2026-11-02 docs(D1): the pinned-current leg is run, so Issue #6 no longer prescribes it
    Both delivery documents still said the next Issue #6 experiment was to pin
    Iout. That experiment has now been run and recorded: at a fixed 100 A the
    0.5 ns leg still settles 15.13 mV above 5 ns with 98.9 % of the same-pair
    resistive loss difference, so pinning the current pins the load but not the
    operating point. The only remaining route is a closed Vout loop, which is a
    different deck, and the 0.2 W target plus NOT_CLOSED are unchanged.
2026-11-02 diag(F01): a tighter solver moves the fault peaks by under 0.5 %, so the prefix stands with a bound
    PR #20's remaining simulation-side option was a documented SOLVER_DIAGNOSTIC
    run on the 50 V hot-fault deck, whose 296.93 us solver collapse leaves only a
    readable prefix. The diagnostic deck changes only .options (trtol 7->1,
    abstol 1e-12->1e-13) and the .tran stop (220 us on the saved axis); the
    circuit, the fault switch and the probes are byte-identical, which
    make_hot_fault_decks and its tests now enforce.
    Over the same 0..220 us window the published 50 V peaks move by -0.161 %
    (I(Lr), -0.163 A) and +0.002 % (SR forward), with the trip 81 ns earlier, so
    the 3-turn flux verdict carries ab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
2026-11-02 fix(risk): independent reviewed 48/50V fault evidence required; SS threshold is necessary but not sufficient
2026-11-02 data(risk): record absence of both verified 48/50V hotfault cases and keep F01 blocked
2026-11-02 docs: surface reviewed two-case fault evidence gate and update ELE-08 acceptance criteria
2026-11-02 fix(protection): fail-closed on 50V solver prefix and high SR gate at 48/50V fault end
2026-11-02 test(protection): signed approval cannot bypass partial 50V solve or 48V high SR gate
2026-11-02 fix(D1): elevate SR gate-high fault end as P0 and stop accepting 50V solver prefix as protection completion
2026-11-02 data(D1): block P0 SR gate high at end and prefix-only 50V fault in risk register
2026-11-02 test(D1): prove actual high SR gate after 48V fault remains a P0 protection blocker
2026-11-02 feat(protection): build independent eight-SR post-OC gate and current diagnostic decks
2026-11-02 sim(protection): add unrun eight-SR post OC current and gate measurements for 48v_120a
2026-11-02 sim(protection): add unrun eight-SR post OC current and gate measurements for 50v_120a
2026-11-02 test(protection): enforce eight-SR probe count and unchanged physical fault circuit
2026-11-02 docs(D1): prioritize observed SR gate-high fault and concrete parallel 5-day protection/CAD plan
2026-11-02 docs(readme): surface actual 48V SR high-gate safety blocker and 22-task CAD-first plan
2026-11-02 data(D1): update per-case engineering evidence reasons to current hard shutdown and prefix checks
2026-11-02 chore(manifest): sync F03 case-specific evidence reason after protecting from stale approvals
2026-11-02 data(D1): localize the 48 V post-trip SR high gate to a low-current A-phase latch
    Run the eight-device SR probe deck to the full 320 us saved window
    (500.451 s, 1.205 GB) and extract every SR's Vgs, Vds and forward/reverse
    current over the same window.
    - All four A-side SRs latch together at 247.070 us and hold 10.890 V to the
    end; all four B-side gates are low.
    - The latch is low-energy: 1.405 A max, 1.04e-4 A2s per device.
    - The 285.014 A forward peak belongs to the 5.64 us trip-to-release window,
    where each A device accumulates 0.03036 A2s of forward I2t.
    - So the end-of-record high gate is a low-current latch, not a high-current
    shoot-through; it is still not a safe-shutdown proof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
2026-11-03 feat(D1): add a convergence-aid comparison that reads completion from the raw tail
    The 50 V hot-fault base stalls at 296.929 us of its 320 us window, so any
    solver aid must be judged on two things: it must reach the stop, and it must
    reproduce the peaks over the prefix both runs cover. hotfault_convergence.py
    does both and refuses decks that differ anywhere but comments/.tran/.options.
    Completion cannot be read from the comparison window: a prefix read always
    ends at the window and would call a stall a stop. ascii_raw_window.last_time()
    reads the final record from the tail (the stalled run wrote 13.3 GB for its
    last 0.93 us), and refuses a record start with no continuation line so a write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
2026-11-03 feat(D1): show the post-trip SR latch phase is chosen by the solver
    The 48 V base deck latches all four A-side SR gates after trip, and the
    50 V cshunt variant ends with all eight low while the 50 V base prefix
    holds B high. That left two explanations open: the voltage case changed
    the physics, or the dead-state gate state is numerically selected.
    Re-run the 48 V circuit with only cshunt=1e-15 added (circuit_differences
    0, both runs reach 320 us, 549.607 s / 594.263 s) and build the same
    eight-device probe deck (594.263 s). Fault stress moves under 0.5 %
    (trip +1.90 ns, I(Lr) peak +0.0375 %, SR forward peak +0.0471 %) but the
    latch flips from all four A gates to all four B gates at 249.38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
2026-11-03 data(D1): record that cshunt does not rescue the cold-overload stall
    The 1 fF aid that completed the 50 V hot-fault stalls the 48 V/120 A
    true-cold-start overload even earlier (5.6141 ms vs the base's 7.5714 ms),
    so it is a negative result rather than a substitute record. The comparison
    tool caps both sides at the shorter record's tail, otherwise the longer
    base slice would win every maximum; the declared 5.4-6.0 ms window is
    reported as not covered. Over the common 5.400-5.614 ms slice the fault
    peaks move less than 0.1 % (I(Lr) -0.040 %, SR forward -0.072 %, trip
    +580 ns), so the published peaks are not an artifact of this solver setting.
    F02 stays blocked.
2026-11-03 docs(D1): audit latest eight-SR evidence and rank high-current/high-margin no-price-cap engineering route
2026-11-03 plan(D1): add 3 no-cost-ceiling safety/cap/magnetics gates and depend manufacturing release on evidence
2026-11-03 test(D1): price-unlimited Lr/Cout/interlock safety targets must precede PCB fab signoff
2026-11-03 docs(readme): upgrade priority to no-price-cap high-output, magnetic flux margin and SR hard-interlock
2026-11-03 feat(PROT-02): independent latched gate inhibit, 48 V candidate comparison
    两个候选 + 一个负对照，全部由 48 V 八探针母 deck 只加不改派生
    （去掉头注/.save 续行/保护块后与母 deck 逐行相等，测试锁住）。
    - prot_a_oc1v：沿用现有 V(oc)>1 V 判据，只换执行路径
    - prot_b_fast10u_1p8v：V(ocd) 经 10 us 低通 + 1.8 V 门限的独立快速路径
    - prot_b_unarmed：无软启动屏蔽的负对照，复现"启动即锁死"
    48 V 实测（母 deck 跑满 320 us，trip 215.0967 us）：
    - A 触发 215.0944 us（早 2.27 ns），I(Lr) 峰 -0.0061 %，SR 正向峰 -0.0090 %
    - B 触发 185.3510 us（早 29.746 us），I(Lr) 峰 97.44->45.94 A（-52.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
2026-11-03 feat(PROT-02): 50 V cshunt candidate comparison, declared-parent derivation
    Root the protection-candidate generator on a parent deck per rail instead of
    the single 48 V base. The 50 V base still stalls at 296.929 us, so its two
    candidates hang off the cshunt=1 fF eight-SR-probe child, the only 50 V solve
    that reaches the declared 320 us window; a test pins the cshunt option and the
    .tran line onto both.
    Comparison changes:
    - --base-deck defaults to the candidate's declared parent, and the structural
    checks (generator round-trip, unchanged fault network) always run against the
    declared parent, never against whatever deck is used as a comparison base.
    - solver_cshunt is read from the whol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
2026-11-03 fix(PROT-02): latch discharge sign, logic-level restart sequencing
    The latch clear term was written -V(prot)*(1n/TAU). A B-source pushes
    positive current out of its node, so the negative form is positive
    feedback; it never showed up because every power-stage candidate holds
    Vddp at 12 V, where the V(uvlo) branch is never selected. The first
    deck that actually power-cycles the bias diverged to 1e86. Corrected to
    +V(node)*(1n/TAU) in the candidates, the UVLO deck and the new restart
    deck; the frozen raws are unaffected (unreachable branch).
    Add prot_latch_restart_check.cir, a logic-level sub-circuit (10 ns max
    step, one step per 100 ns tau diverges): a latched fault survives, a
    20 us Vddp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
2026-11-03 feat(D4): one 48 V/50 V per-device protection/SOA screening table
    The per-device Vgs/Vds/Id evidence was split across three eight-probe
    records and five candidate comparisons; no file answered which device
    saw the worst stress. protection_soa_table.py copies the committed
    numbers into 11 runs x 8 devices with a source sha256, and keeps the two
    windows apart (post-trip vs saved window) instead of differencing them.
    Findings: global worst forward peak 304.96 A (50 V candidate A, device
    1b, +0.48 % vs its base, consistent with the earlier comparison);
    reverse peaks 9.95-11.10 A are only recorded in the probe runs, so the
    candidate rows are null with unrecorded_fields declared, not zero. The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
2026-11-03 fix(SOA): normalize cross-platform hashes, derive coverage, and forbid unpaired 50V protection claims
2026-11-03 data(SOA): rebuild eleven-run evidence table with canonical hashes and explicit unpaired 50V comparisons
2026-11-03 test(SOA): enforce portable hashes, explicit nonpaired 50V, source-derived duration gates
2026-11-03 feat(PROT02): generate no-clamp 50V topology-matched controls without claiming unrun causality
2026-11-03 sim(PROT02): add unrun topology-matched 50V no-clamp control to isolate numerical pre-state offset
2026-11-03 plan(PROT02): require genuinely paired 50V 320us evidence before declaring protection comparison valid
2026-11-03 docs(D1): review actual PROT-B 48/50V simulations, fix CI evidence integrity and set paired-control route
2026-11-03 docs(readme): prioritize current CI fix and unpaired 50V PROT-B verification over stale audits
2026-11-03 feat(D1): engineering reference kit and fail-closed protection gate (#26)
    * docs(D1): deliver actionable primary-source engineering guides and supplier templates
    * docs(D1): add protection, LTspice, energy, bench and architecture execution guides
    * fix(D1): require independent hardware fault-shutdown design evidence for fabrication
    * feat(D1): complete live-sourced 61-MPN and 24-pin vendor request seeds with tests
2026-11-03 docs(d1): collect official vendor sources and 51/61 candidate part mappings
    * docs(d1): source OEM passive candidates for 51/61 refdes; preserve fail-closed evidence gate
    * docs(d1): add original OEM high-margin SR/magnetic alternatives, model entrypoints and README navigation
2026-11-03 fix(BOM): correct QH/QL max Rds(on) to 6.4 mOhm and pin it to the vendored datasheet
    SOURCE-02: the BOM said 6.2 mOhm max, which is not traceable to the vendored
    TI Rev.B table (5.3 typ / 6.4 max at VGS=10 V). The value is a purchase and
    derating input, so the test re-reads the datasheet table instead of trusting
    a hand-copied number. Hot-case scaling of the measured I^2R terms is recorded
    in vendor_design_findings.json; junction temperature remains open.
2026-11-03 sim(PROT02): add a threshold-muted 50V control and record why Vt=10 fails
    The first topology-matched control moved Vt .5 -> 10 V. Measured on the
    50 V A pair, that control matches its own parent deck to 0.04 mV while the
    candidate sits 13.2 mV above it with 2.1x the pre-fault samples, so the Vt
    change also moved the solver path and cannot satisfy the <=1 mV criterion.
    The new _thrmute_control.cir keeps the PROT_KILL model byte-identical and
    raises only the Bprot trigger constant to 100 V, so the latch never sets but
    the pre-fault operating point is the candidate's. Both controls are UNRUN
    and never claim protection. Tests pin the one-variable-per-control property
    and the untouched switch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
2026-11-03 feat(PROT-SOA): record which deck each comparison was differenced against
    Two comparison records can carry identical device rows and mean different
    things: a 48 V row is paired against its declared parent, while the 50 V
    parent rows sit 13-18 mV away and are exploratory. The table now carries
    comparison_basis per row and scopes the unpaired-claim check to
    declared_parent rows, so adding a control-based run later cannot silently
    inherit the parent-row caveat.
2026-11-03 feat(PROT-03): freeze the two-clause verdict and re-rate the CT burden
    The 50 V topology-matched controls are now measured, and the two acceptance
    clauses cannot both hold. _thrmute_control.cir keeps the latch model
    byte-identical and raises only the trigger constant, so it pairs exactly
    (0.000000 mV pre-fault, 961298/824449 bit-identical samples up to trigger)
    but stops at 250.151/254.980 us when killed by PID. _noclamp_control.cir
    completes all 320 us but the same pre-fault window is 13.201/17.474 mV off.
    The leak probe closes the obvious explanation: both Vt=.5 and Vt=10 pass
    1.001e-9 A, so the offset is a changed solver path, not residual clamping.
    paired_change_can_be_attributed_to_pr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
2026-11-03 feat(SOURCE-03): digitise the vendored SOA and Zth charts
    The action asks for the 2022 Rev.2.3 original drawings, not the marketing
    285 A / 1140 A figures, so tools/vendor_soa.py reads them out of the PDF's
    own vector data. Six SOA curves and the single-pulse transient-impedance
    trace come back, with the axis mapping solved from the tick labels rather
    than eyeballed.
    Three anchors say the mapping is right. The 1 us plateau digitises to
    1125 A against the 1140 A printed in the same document (-1.3 %), the drawn
    right edge lands at 41.07 V on a 40 V rated device (+2.7 %), and Zth
    reaches 0.994 K/W at 1 s against the 1 K/W Rth(j-c) in the table.
    Calibration detail that matters for the next d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
2026-11-03 feat(SOURCE-03): screen all eight SRs and state what the chart cannot judge
    The screen runs the digitised charts over three fault-deck runs and keeps
    three verdicts apart, because merging them is how a first-quadrant curve
    gets quoted against a third-quadrant event.
    First quadrant: every sample of every device is compared point by point
    with the 10 us and 100 us curves, and the worst utilisation is 6.30 / 6.33
    / 6.52 % across 48 V, 48 V cshunt and 50 V cshunt. The blocking and
    reverse-recovery excursions are an order of magnitude inside the drawing.
    Third quadrant: this is where the fault lives, and the vendor diagram plots
    VDS > 0 only, so no curve governs it. The record says so explici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
2026-11-03 docs(D1): carry the SOA screen into the two kit chapters that asked for it
    Chapter 11 said BSC010N04LS6's ratings are not a pass for the fault SOA and
    left the dynamic confirmation pending; it now cites the digitised charts,
    the 6.52 % worst first-quadrant utilisation and the measured third-quadrant
    stress. Chapter 5 required per-device SOA paired with the worst waveform;
    it now records that half of the item is delivered and names the missing
    half -- a vendor criterion for VDS < 0 and a per-device thermal sign-off.
    Neither chapter changes its release stance. The model pins TJ at 25 C and
    has no feedback, so the 1.84-1.88 K rise is a property of the simulated
    waveform, not a rating of the pa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
2026-11-03 docs(D1): register the SOA screen in the kit index and the ELE-10 card
    The kit index gains a second 2026-11-03 addendum so the new artifacts are
    discoverable from the entry point, and ELE-10's blocker note stops saying
    there is no vendor SOA curve -- there is one now, digitised, with the
    first-quadrant utilisation measured at 6.52 % and the third quadrant
    recorded as having no curve to judge it by.
    The release stance is unchanged and restated in both places: the packet
    still cannot write "device SOA passed".
2026-11-03 fix(d1): audit and correct R3 rating, RT/DT mapping and native CAD ECO gates
    * fix(D1): replace underrated 0805 CT burden with documented pulse-proof 2512 candidate and fail-closed regression checks
    * fix(D1): reconcile native UCC25600 DT/RT resistor refdes and gate BOM semantic net mismatch
    * feat(D1): auto-generate actionable 61-ref native CAD ECO from existing placement/netlist and vetted candidates
    * fix(D1): regenerate canonical R1/R2 sourcing register and both supplier templates after functional-net ECO
    * fix(D1 CI): preserve Python codepoint-order sorting in 61-row supplier template
    * fix(D1 CI): refresh v3 source manifest SHA256/bytes for RT/DT BOM semantic correction
2026-11-03 docs(SOURCE-02): record why the deck's primary currents cannot be an SOA waveform
    The saved I(SH)/I(SL) peaks (776.8 / 750.7 A) are nine samples spanning 0.08 ns
    at each switching edge: the 1.12 nF of Cdh+Cdl charging through the 8 mOhm
    behavioural switch, with I(Lr) still at 0.31 A and no package inductance to
    limit di/dt. Time-weighted I^2R over the pre-fault decade is 0.5546 / 0.5476 W,
    which matches the published 100 A ledger, so the spikes carry no energy.
    The vendored CSD19531Q5A chart also cannot be digitised by the BSC010N04LS6
    method: different vector layout and no printed SOA value to anchor against.
    Screening the primary switches needs a device-level model.
2026-11-03 feat(SOURCE-05): derive the R3 startup pulse from the saved resonant current
    The 8 ms cold-start deck does not save V(ocd)/V(ocm), and re-running it that
    way costs 2294 s and 13 GB, so the startup burden stays unmeasured directly.
    It does not have to stay unknown: the deck saves I(Lr), and inside this model
    the burden is an algebraic function of it. Lct1=2u sits in the tank, Lct2=20m
    is the secondary, so the ideal transformer forces i_sec = i_pri/100 and
    V_burden = Rbur*|i_pri|/N.
    The transfer is calibrated where both traces are saved (hotfault srprobe,
    150-175 us and 205-216 us, 2-97 A, 75 459 samples): median 0.0997355 V/A
    against a nominal 0.1, p05-p95 0.0993-0.1023. The same transfer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
2026-11-03 feat(SOURCE-05): derive a cold-start deck that saves the CT burden nodes
    The parent 8 ms cold-start deck saves I(Lr) but not V(ocd)/V(ocm), which is
    why the R3 startup power has only been derivable. This variant appends three
    probes (V(ocd), V(ocm), I(Rbur)) and nothing else: circuit, .tran, .meas and
    solver options are byte-identical, pinned by a test that compares the whole
    body line by line.
    The deck is UNRUN and its header says so. The raw it produces will let
    tools/startup_burden_direct.py replace the ideal-transformer derivation with a
    measured P(t) over the true cold start.
2026-11-03 docs(findings): measure the D_BT reverse stress and unpair the SR ratings
    SOURCE-01: the external bootstrap diode's reverse voltage is V(sw), measured
    at 49.10 V on the complete 48 V srprobe record and 51.13 V on the 50 V cshunt
    record (1.02x the rail). It is a lower bound: the behavioural switch has no
    package inductance, so no L*di/dt overshoot.
    SOURCE-03: Table 7 shows the 285 A is ID, not the diode's IS (150 A), while
    1140 A is printed for both ID,pulse and IS,pulse with no width stated, so the
    usual '285 A continuous / 1140 A pulse' pairing mixes two terminals. The
    behavioural PROT candidate does hold all eight SR gates low after trip, but it
    remains a candidate, not a hardware shutd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
2026-11-03 feat(SOURCE-05): read the cold-start burden from the probe deck
    The derived record rested on an ideal-transformer identity; this reader
    replaces it with V(ocd)-V(ocm) measured over the same 8 ms true cold start
    and prints the signed deviation from the derivation. It refuses to run
    without the raw, re-checks that the probe deck is exactly its parent plus
    three .save entries, and keeps the rating ladder read from PR 28's screen.
    The raw-derived tests skip until the 14 GB record exists.
2026-11-03 feat(d1): ten-gate hardware fault shutdown design contract and paired 50V solver evidence runner
    * feat(D1 P0): map real 10-gate safety interface, four TI dual-driver candidates and 18 fault injections
    * feat(D1): safe rerun of 50V paired controls with SHA256 archive and failed prefix retention
    * docs(D1): document matched 50V reruns and fix legacy batch ASCII output mismatch
2026-11-03 feat(prot03): python port of the 50V matched-case runner
    The .ps1 is the authoritative procedure, but this machine's execution
    policy refuses .ps1 files and the session denies powershell.exe via
    Bash, so the four-deck A/B quartet could not be executed at all. The
    port keeps the same decks, the same three deck gates, the same staging
    inside sim/v3 (so ../../models resolves), the same archive layout and
    refusals, and the same three false safety flags. It differs in two
    deliberate places: shutil.move for the archive (os.replace cannot cross
    volumes) and a per-case timeout, because a stalled solve writes
    gigabytes while shrinking its step.
    Tests: 12 cases including the dead-solver path, which m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
2026-11-03 feat(SOURCE-05): measure the cold-start CT burden instead of deriving it
    The parent 8 ms cold-start deck does not save V(ocd)/V(ocm), so the R3
    startup power had been derived through the ideal CT transfer. The probe
    deck adds one .save line and nothing else; its 8 ms raw (14.13 GB,
    14,433,895 samples) measures peak 0.572401 W at 1.28698 ms and
    0.779570 mJ, i.e. -1.201% / +0.118% from the derived values. The CT
    transfer derivation is confirmed, not replaced, and the derived record
    keeps its own evidence level.
    The bridge is not an ideal rectifier: four DSCH diodes with Cjo=20p
    reverse the burden voltage by -1.32 mV at current zero. The invariant
    is therefore not 'voltage never negative' b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
2026-11-03 docs(SOURCE-05): point the fault-pulse record at the startup measurement
    The pulse record used to say the startup pulse was unmeasured because the
    parent cold-start deck does not save the burden nodes. That is no longer
    the whole truth: a probe variant measures it. Only the limits sentence
    changed -- every measured number in the regenerated record is identical,
    which is also a reproducibility check on the tool.
2026-11-03 chore(git): ignore the matched-case archive root
    out/ holds the staged deck, log and raw per case. The raws are already
    ignored, but the decks and logs made the whole directory show up as
    untracked after every run, inviting someone to commit gigabytes. The
    run manifest is the evidence and is copied out of the archive.
2026-11-03 feat(d1): hardware-disable SR alternative, startup hard-trip, paired 50V diagnostics and magnetic geometry evidence
    * feat(D1): map 8x native-TRIG NCP4306 SR alternative, fail-high default off and realistic disable latency screen
    * fix(D1): align generated NCP4306 timing evidence with verbatim checked-in assumptions
    * feat(D1): generate 12 identical-pair 50V numerical convergence diagnostic decks and add variant runner
    * feat(D1): always-on hard trip plus armed fast trip logic with TI POR comparator candidate and 4096-case fault tests
    * feat(D1 MAG): reject standard TDK planar core sets against 10mm mechanical and 121A flux envelope
    * fix(D1 MAG CI): make core geometry screen metadata d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
2026-11-03 feat(prot03): port PR 30's solver sweep variant to the runnable runner
    PR 30 added -Variant to the PowerShell script, but this machine's execution
    policy forbids .ps1, so the only runner that can actually execute here had no
    way to reach the twelve generated 2/5/10 fF decks. --variant closes that gap
    with the same semantics: non-published variants resolve to
    sim/v3/d1_prot03_<variant>_<CASE>.cir and the cshunt gate takes its value from
    the variant (1e-15 / 2e-15 / 5e-15 / 1e-14), so a 1 fF candidate can never be
    paired with a 5 fF control.
    The manifest additionally records variant and required_cshunt_farads. That is
    a deliberate difference from the .ps1, stated in the docstring and CLAUDE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
2026-11-03 test(prot03): pin the runner and the sweep generator to one variant map
    Both modules now name the same cshunt values and deck files; if either is
    edited alone the test fails instead of a gate silently guarding a deck the
    generator no longer writes.
2026-11-03 fix(prot02): label the rail from the case and read any cshunt value
    The comparison report found "50v" in the deck file name to pick its rail
    label and only recognised cshunt=1e-15, so a PR 30 sweep deck (named
    d1_prot03_shunt_2f_A_CANDIDATE.cir, cshunt=5e-15) would have been reported
    as a 48 V record with no convergence note. The rail now comes from the
    case id and the cshunt literal is parsed, so the sweep's own value appears
    in the limits; the published 1 fF reports keep their text.
2026-11-03 fix(prot02): read cshunt from the .options line, not the header comment
    Every 50 V deck says "derived from the cshunt=1fF convergence variant" in
    its header, so an unanchored search reported 1fF for a 2fF sweep deck.
    Verified on the five real decks: 1e-15, 2e-15, 5e-15, 1e-14, none.
2026-11-03 docs(prot03): record the second independent run of the four 50 V decks
    The four published 1 fF decks were executed again on the same machine. Both
    controls stop at the same solver points as before (250.150953 / 254.980494 us,
    against the frozen 250.151 / 254.980) and every physical column reproduces the
    published JSON, so the stall is a property of the decks, not of one lucky run.
    The comparison reports go to new files; the published PROT-03 reports are not
    overwritten. A second register rows them out against their own raws and logs,
    and the register test now walks both registers, reading each row's raw from the
    path the row itself names.
    Doc 18 no longer claims the environment never ran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
2026-11-03 fix(prot02): check a sweep deck against its own generator
    compare() judged "the candidate matches its generator" by rebuilding the
    declared parent with make_protection_candidates.build(). A PR 30 solver-sweep
    deck is not that generator's output: the same circuit with one `.options
    cshunt` value swapped plus a two-line diagnostic header. Every sweep report
    would therefore have recorded the_candidate_matches_its_generator: false,
    which is indistinguishable from real generator drift.
    A deck named d1_prot03_shunt_<n>f_<CASE>.cir is now checked against
    generate_prot03_solver_sweep.build(), the module that writes it. Published
    decks still go through make.build() unchanged; the routing is pinne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
2026-11-03 docs(prot03): the 2 fF control runs the full window and keeps the physics
    The first 50 V thrmute control to reach 320 us: solver_2f_A_001 finishes in
    457.205 s where the same deck at 1 fF stops at 250.151 us every time.
    The value of that is entirely in what did NOT move. Against the published
    1 fF control over the frozen 220 us window the decks differ on no body line,
    and the headline peaks move under 1 %: trip -147 ns, I(Lr) peak +0.080 %,
    SR forward -0.508 %. The only large mover is the SR reverse peak (+3.15 %),
    the near-zero steep-slope quantity that also moved when cshunt was first
    introduced -- solver sensitivity, quoted as such.
    The 250 us variant of the same comparison is recorde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
2026-11-03 fix(prot03): a failed solver still left a prefix worth reading
    The 2 fF B control died with 'Time step too small' after 1374.7 s and wrote
    2.75 GB of readable raw to 264.515 us of a 320 us window. The runner checked
    the return code first, so the manifest said tail_us=null -- the run reads as
    having left no evidence when it left the most useful kind.
    Classification now happens before the return code; the refusal to overwrite,
    the archiving and the hashes are unchanged.
    The same marker trap sat in hot_fault_metrics.parse_log(): LTspice prints
    'Total elapsed time' before giving up, so the elapsed line alone reported the
    failure as solver_completed=true.
2026-11-03 docs(prot03): 2 fF fixes the A control, not the B control
    B_CANDIDATE reaches 320 us at 2 fF, but B_CONTROL aborts at 264.515 us with a
    step-size failure on xsr3:x2:Bage -- 9.53 us further than the 1 fF control got
    before its timeout, and still short of the window.
    Over the common 220 us window the two controls differ only in .options
    (circuit_differences 0) and agree to 0.22 % on every headline peak, so the
    extra survival is not physics and no B pairing exists at 2 fF. The group has
    to move to another cshunt as a pair, not reuse the 2 fF candidate.
2026-11-03 fix(convergence): a window is covered to within the deck's own max step
    `the_comparison_window_is_covered_by_both_raws` demanded the last in-window
    sample be within 1 ps of the window end. No sample can land on the boundary,
    and `window_peaks` returns the last sample at or before it, so the tolerance
    has to be one integration step -- the deck's `.tran` Tmaxstep, 5 ns here.
    The 5 fF B candidate slices ended at 219.9966 / 219.9990 us of a 220 us
    window, both raws spanned the whole window, and the check read "failed".
    `max_step_s()` parses the Tmaxstep from each deck and the looser of the two
    becomes the tolerance; it is recorded as `results.coverage_tolerance_s` so a
    reader can see what was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
2026-11-03 feat(cout): put the placed copper in series with the bank (SOURCE-04)
    `cout_bank.json` sized the bank as `part ESR / N` and said in its own caveat
    that this assumes zero interconnect. Each capacitor is in series with the
    copper that carries its share, so the copper enters before the parallel
    combination: `1 / sum(1 / (ESR + R_branch))`, which collapses to `ESR / N`
    when every branch is zero -- the two tools then describe the same bank.
    Geometry comes from the placement study, not a constant: 15 units at 8.20 mm
    pitch on y = 98 mm, SR groups on y = 82 mm, nearest group centre per unit, and
    the same square count `output_path_budget.py` uses. At 2 oz / 100 C the placed
    copper takes the bank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
2026-11-03 docs(claude): the GBK console cannot print the micro sign
2026-11-03 fix(d1): isolate Bage convergence mechanism, correct A720 OEM height, and audit Cout copper bounds
    * feat(prot03): isolate xsr3:x2:Bage discontinuity in v3_4 surrogate and generate 4 matched diagnostic decks
    * feat(prot03): make Bage paired diagnostic executable with no-overwrite RAW/LOG evidence archiving
    * fix(PROT03): refresh go/no-go from actual 1/2/5fF B results and stop recommending repeated failed sweeps
    * fix(D1 mechanical): use OEM H max 2.1mm for A720 output bank and update KiCad placement evidence
    * fix(D1 COUT): mark provisional independent-lane copper and ripple results as scenarios, not physical bounds
    * fix(CI): use existing mechanical test to enforce OEM height without c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
2026-11-04 feat(d1): the 2 fF B agefix pair completes both 320 us windows
    Record the first complete 50 V B matched pair: the v3_4 soft Bage rail
    lets the control reach 320 us (previously 264.515 us) while every one of
    the seven shared-window metrics stays bit-identical to v3_3 over 0-220 us.
    A post-window scan shows the candidate is bit-identical over 220-320 us
    too, so the rail change is inert for it and only alters the control's
    post-trip solver path (first difference 228.884 us).
    The paired analysis keeps the honest boundary: 1.8 V trigger 29.67 us
    before the base 1 V trip, ipri -54.78 %, SR forward -54.37 %, I2t -95.44 %,
    pre-fault delta 0.000000 mV, but no device SOA review, so the decision
    machi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
2026-11-04 docs(claude): record the completed 2 fF agefix pair and the inert-rail fact
2026-11-04 feat(D1): stage 100A/16mm first build, 120A extension and 10mm optimization without releasing safety gate
    * feat(D1): stage 100A/16mm functional build, 120A expansion, 10mm stretch without weakening fab safety
    * docs(D1): activate phased 100A/16mm build strategy, vendor RFQ and staged test exit criteria
    * fix(D1): reserve provisional 2mm non-core allowance in 16mm shortlist and correct phase-guide wording
    * fix(D1): compare staged assessment JSON by semantic content rather than key insertion order
2026-11-04 fix(D1): guard SR buffer pin mapping and stage fabrication approvals (#34)
    * fix(protection): lock eight SR buffer routes to OEM pins and unique nets
    * fix(gates): reject stage-local manufacturing approvals
    * test(protection): detect swapped buffers, aliased gates, wrong pins and MPN
    * test(gates): reject missing or false stage-local fab evidence
    * docs(d1): concrete D0 hardware delivery and peer-reviewed architecture options
    * docs(index): surface reviewed P0 wiring gate fixes and hardware path
2026-11-04 fix(D1): enforce independent stage voltage acceptance (#35)
    * fix(stages): reject silent changes to labelled D2 120A target
    * fix(stages): enforce each voltage threshold independently
    * test(stages): prevent cross-stage voltage waiver and D2 mislabeled current
2026-11-04 feat(D1): validate 24 vendor magnetic pads and correct legacy CTAP map (#38)
    * feat(magnetics): audit 24 supplier physical terminals and DOT before native PCB ECO
    * feat(magnetics): add exact 24-row supplier pad/DOT/XY/phase evidence response sheet
    * test(magnetics): reject missing, duplicated, mismatched pads, DOT, phase and provenance
    * docs(magnetics): actionable 24-pad/DOT supplier response and no-fabrication gate
    * docs(magnetics): surface new 24-terminal vendor packet validator
    * fix(magnetics): replace stale nine-row terminal map and OUT typo with complete golden 24 rows
    * docs(magnetics): stage 16mm prototype and route legacy nine-row seed to verified 24-row response
    * test(ma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
2026-11-04 feat(D0): bind alignment, limits and capture audit into one evidence chain
2026-11-04 fix(D1): bind the vendor magnetic audit to the contract bytes it judged
    The 24-terminal vendor packet is judged against
    hardware/dcx_main/magnetics_symbol_contract.json, but the report only
    recorded a terminal count, so a later contract edit could leave a stale
    REVIEW_PACKAGE_COMPLETE_NOT_APPROVED looking current.
    - record contract.sha256/path/symbols alongside input_sha256
    - refuse a contract that repeats a (ref, logical_pin): the dict
    comprehension silently shrank the expected set below 24 terminals
    - take argv in main() so the report can be exercised end to end
    Still REVIEW_PACKAGE_COMPLETE_NOT_APPROVED at best; no approval flag moves.
2026-11-04 feat(D0): reproduce the alignment report inside the evidence chain
    Chapter 32 noted that the alignment report is the one artifact no hash
    binds; the row-count/uniformity/span checks were the only defence. Re-run
    chapter 31 from the manifest and require the deterministic report fields
    and the regenerated CSV bytes to match, which catches a hand-edited
    post_s, declared skew or forged manifest_sha256.
    Missing instrument records are distinguished from a contradicted report:
    they yield reproduction.status=UNAVAILABLE and exit 1, never 0.
    Still capture-only evidence; every release flag stays false.
2026-11-04 fix(D1): refuse a magnetic contract that drifted from its golden sources
    The vendor auditor treated magnetics_symbol_contract.json as frozen truth,
    so an edited golden_net/polarity would make a wrong 24-terminal vendor map
    look model-correct. Before auditing, rebuild the contract from
    board_netlist.csv + winding_polarity.json and compare golden_net/polarity
    per logical terminal; a mismatch is INVALID_PACKET (exit 2). Physical pads
    and native-CAD flags are excluded because filling them in is the legitimate
    post-vendor step. The report now also records contract_sources hashes.
2026-11-04 fix(P0): live coupled-winding DOT and fail-low primary enable gates (#39)
    * fix(P0): derive CAD magnetic polarity from live SPICE and reject stale DOT contracts
    * fix(P0): block fabrication on constant-high primary EN or stale magnetic physical-pad claims
    * test(P0): reverse live and saved DOT orders, center-tap nets, reject silent polarity drift
    * test(P0): reject spoofed magnetic pads and unsafe RUN pullups despite forged approval
    * fix(gate): require actual R7 two-pin pull-down rather than arbitrary pad labels
    * test(P0): hold source pins constant while injecting reversed live winding
    * test(P0): define baseline magnetic refs before mocking live winding check
    * fix(P0): reject reve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
2026-11-04 feat(tools): run LTspice decks in parallel on the remote host
    Every simulation now runs on `winsrv` (CLAUDE.md, "远端仿真主机"). Starting
    lanes over ssh gives exactly three live instances because sshd's Job Object
    drops the rest; `schtasks` escapes it, so this runner is meant to be started
    that way.
    The state machine is the point. Artifact presence is not a liveness signal:
    the ASCII raw stays 0 bytes until the run ends and the .log is written once at
    startup, so a lane that exited 0 having written nothing looks identical to one
    that is still working. Each lane therefore watches process CPU time and kills
    and relaunches after 90 s without growth, up to five launches.
    Lanes are copied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
2026-11-04 docs: record the measured remote lane throughput
    Six lanes cost nothing per lane (257.2 s mean versus 251.5 s alone, 97.8 %
    per-slot efficiency); twelve average 298.8 s and sustain about 145 sim/h at
    84.2 %. Every raw at every lane count hashes identical to the reference.
    The point worth writing down is the metric: 9 lanes reported a lower n/wall
    than 6 because one lane took 379 s while the other eight finished in 247-283 s.
    n/wall is a batch-completion number set by the slowest lane, so the note says
    to plan with the per-lane mean instead — otherwise the next reader concludes
    that 9 lanes is a capacity cliff.
2026-11-04 feat(tools): generate the D0 ten-gate protection bench board
    Issue #36 checkbox 2: a native KiCad schematic that realises
    tools/two_tier_fault_logic.py as hardware -- CT conditioning, LM393
    comparators, a SET-dominant CD4013 latch pair, UVLO/rail-good, the
    ACK-low release token, a UCC27524 permit stage, and ten default-off
    gate drivers each with a 2.2R series resistor, a 10k gate-source
    pull-down and a capacitive dummy load.
    The ERC pass is not the argument. tools/test_make_d0_protection_board.py
    re-derives the circuit from the part table and runs it: every
    combinational net is compared with hardware_step() over all input
    combinations, the latch update is compared with the reference
    transi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
2026-11-04 docs: record the 4xxx pin-role trap and the D0 POR modelling boundary
2026-11-04 fix(d0): correct the permit PMOS, the thresholds and the ACK token
    An adversarial review of the generated board found defects the exhaustive
    logic test cannot see, because it checks the boolean table rather than the
    analog front end:
    * Q2 had source and drain swapped. Q_PMOS_GSD puts the source on pin 2, so
    pin 2 on PERMIT_RAIL made the body diode conduct V5 -> rail and left the
    ten drivers enabled at POR -- the opposite of default-off.
    * The rail-good dividers reached 3.84 V at 12 V against the LM393's
    VCC-1.5 = 3.5 V common-mode limit. Re-based on the 1.000 V reference
    (100k/14.7k): trip 7.80 V, 1.54 V nominal.
    * The gate-sum note assumed 1k/(10k+1k) = 0.909 V per gate and ignor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
2026-11-04 docs: record the D0 footprint and gate-sum traps
2026-11-04 fix(d0): fail closed on a stale ERC report and resolve deck citations by name
    The ERC check read a missing erc.json as "0 violations", so a crashed or
    unsupported kicad-cli run and a clean schematic printed the same line. It now
    requires the report to exist, to name d0_protection.kicad_sch, to be no older
    than that schematic, and to contain at least one sheet before it is believed;
    both `sch erc` calls also assert their return code.
    Deck provenance was hand-written line numbers and had drifted: R8's burden
    cited line 117, which is the 0 V source Vctg, and D7/D8 both pointed at D2.
    Every pointer is now resolved from the element name, so an inserted line moves
    it and a renamed element fails l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
2026-11-05 fix(P0): correct D0 LP package and quantify analog shutdown hazards (#40)
    * fix(D0): use TI TL431LP physical TO-92 footprint; do not assign SOT-23 to LP
    * fix(D0): align generated TI LP footprint/description with TO-92 datasheet
    * fix(D0): align generated TI LP footprint/description with TO-92 datasheet
    * fix(D0): align generated TI LP footprint/description with TO-92 datasheet
    * test(D0): lock TI TL431LP TO-92 physical package across schematic, BOM and netlist
    * feat(D0): compute real gate-sum blind spot and unqualified low-current zener clamp
    * test(D0): fail-closed gate residual, Zener knee and analog latency reviews
    * docs(D0): review new bench board, OEM TL431 package fix, analog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
2026-11-05 fix(sim): fail closed on remote LTspice partial and mismatched results (#41)
    * fix(remote): do not accept empty/stale LTspice artifacts or partial reference hash matches
    * test(remote): reject empty RAW, startup log, failed solver and mismatched reference hashes
    * test(remote): write actual newlines in synthetic LTspice completion fixtures
    * fix(remote): reject single-backslash Windows parent path traversal
    * test(remote): reject Windows backslash traversal before stage-folder resolution
    * fix(remote): avoid infinite solver wait if Windows CPU accounting is unavailable
    * test(remote): dead CPU telemetry cannot leave an empty solver hung forever
    * fix(remote): zero-duration synthetic r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
2026-11-05 fix(D0): deduplicate physical BOM and match HEF4093BT SO14 (#42)
    * fix(D0): aggregate multi-unit logic symbols into one physical BOM component each
    * fix(D0): match Nexperia HEF4093BT orderable SO14, not DIP14
    * fix(D0): correct all five U13 HEF4093BT SO14 native schematic units
    * fix(D0): align U13 KiCad native exported netlist to Nexperia HEF4093BT SO14
    * fix(D0): BOM one physical unit per unique ref (176 not 214), U13 SO14
    * fix(D0): report actual 176 orderable physical packages, not 214 drawing units
    * test(D0): ensure every chip U3-U13 appears once in real BOM and OEM SO14 is consistent
    * docs(D0): document corrected Nexperia SO14 orderable part and 176-piece BOM
2026-11-05 feat(P0): shift D1 to parallel physical-first prototyping and guarded native R8 ECO (#43)
    * feat(CAD): guarded EasyEDA native R8 DNP ECO with strict project/pad checks
    * docs(critical-path): choose low-energy A/B driver experiment and parallel magnetics/native PCB
    * feat(execution): add actionable parallel 3-track first-article handoffs with explicit external evidence
    * test(CAD): execute opt-in R8 EDA ECO against mocked native API with no-modify fail-closed cases
    * docs: promote one-page first-article critical path above repetitive audits
    * docs: make 3-track physical critical path the repo root entry point
2026-11-09 docs(main): surface canonical D1 PCB board-first charter and default PR evidence template (#74)
    * docs(main): point default GitHub landing page to canonical D1 board-first charter on active branch
    * chore(main): activate default-branch PR template requiring G1-G3 physical evidence
2026-11-10 docs(main): point GitHub landing and default PR form to D1 branch (#86)
    Archive original main README unchanged in meaning, replace stale dates with absolute D1_CURRENT links, sync default PR evidence template. No hardware code or default branch setting changed.
